hisp2k/parameters/README.md

# Параметрические изделия

Собранные разработки по параметрическим изделиям: модели SolidWorks, интерфейсы, расчётные модули, чертежи, спецификации, исходные данные, протоколы проверок и история доработок. Перенос материалов выполнен 6 октября 2026 года.

| Направление | Материалы и точка продолжения |
|---|---|
| Шнековый транспортёр «Шнек 1», 01.PT.SHT | [Рабочая параметрическая модель и интерфейс](screw-conveyors/01-PT-SHT/deliverables/Шнек%201%20—%20параметрическая%20модель/README.md), исходная сборка, восстановленный CAD, снимки изменений, аудит производственного комплекта |
| Шнековый транспортёр 25.SHT.G | [Контекст и согласованные параметры](screw-conveyors/25-SHT-G/deliverables/Параметризовать%20шнековый%20транспортер%202%20—%20контекст.md), опросный лист, программа, параметризованная копия CAD и исходные модели |
| Плоский ленточный транспортёр ЛТ500 | [Комплект и статус R11](belt-conveyors/flat-LT500/deliverables/Ленточный_транспортер/СТАТУС_КОМПЛЕКТА_ПЛОСКИЙ_R11.txt), расчёты, модели узлов, документы, история R00–R10 и программы построения |
| Желобчатый ленточный транспортёр ЛТ500 | [Точка продолжения R10](belt-conveyors/trough-LT500/deliverables/СТАТУС_ПРОЕКТА_ЖЕЛОБ.txt), отдельная ветка проекта, модель станции, расчёты и архив переноса |
| Параметрическая песколовка | [Техническое задание и журнал проектирования](grit-chambers/parametric/deliverables/Песколовка/GRIT_CHAMBER_CODEX_TASK.md), MASTER-модели, проверки и сценарии SolidWorks |
| Песколовка PT-SHT-10 | [Материалы гидравлики и Flow Simulation](grit-chambers/PT-SHT-10/deliverables), результаты, сценарии осаждения, изображения, модели и архивы |
| Решётки ГР | [Документы и сверки 58.GR](screens/58-GR/README.md), BOM, STEP/BOM-аудит, регламенты и доступные исходники серии ГР |
| Контейнеры | [Проекты 0,75 и 0,22 м³](containers/deliverables), SolidWorks, чертежи PDF, DXF раскроя и программы генерации |
| Общее расчётное ядро | [Программа проверки входов для разных сред](engineering/screw-preflight/README.md), [калькуляторы транспортёров](engineering/transporter-calculators), [SolidWorksCodex и калькулятор](engineering/SolidWorksCodex/README_RU.md) |
| Промпты и регламенты | [Материалы проектирования](docs/prompts-and-regulations), [исходные промпты задач](docs/original-prompts) |

## Как пользоваться

Для каждого изделия сначала прочитайте его README, контекст или файл статуса. В папках `deliverables` находятся сохранённые результаты, в `development` — программы построения, исправления и диагностики. Снимки `snapshots`, архивы и документы прежних ревизий сохраняют историю; актуальное исполнение указано в статусе проекта.

Интерфейс «Шнека 1» запускается командным файлом `Запустить интерфейс.cmd` рядом с его README. Нужны Windows, SolidWorks и Python с `pywin32`. Требования остальных программ указаны в их документации. Пути в исходных скриптах и старых протоколах сохранены: при работе на другом компьютере проверьте настройки путей и ссылки сборок SolidWorks.

В репозиторий перенесены фактически существующие материалы с их текущими инженерными статусами. Некоторые узлы, расчёты и чертежи являются предварительными; ограничения и следующие шаги записаны в исходных документах соответствующего изделия. Импорт не меняет статус готовности к изготовлению и не подтверждает результаты новым расчётом CAD/CFD.

## Большие архивы

Восемь крупных ZIP/RAR сохранены без изменения в папках `.parts`, частями по 16 МиБ. Такое разбиение позволяет обходить ошибки хранилища крупных объектов при загрузке. Для восстановления исходных архивов выполните из корня репозитория:

```powershell
python tools/restore_large_files.py
```

Программа проверяет размеры и SHA-256 частей и готового архива. Восстановленные архивы не нужно повторно добавлять в Git.

## Реестр переноса

[Реестр файлов](docs/import-2026-10-06/files.csv) содержит исходный путь, путь в репозитории, размер и SHA-256 каждого перенесённого файла. [Сводка](docs/import-2026-10-06/summary.json), [описание больших архивов](docs/import-2026-10-06/large-files.json) и [перечень исключённых временных файлов](docs/import-2026-10-06/excluded.json) позволяют проверить состав переноса. Подробности охвата: [примечания к импорту](docs/import-2026-10-06/NOTES.md).
