hisp2k/parameters/screens/58-GR/README.md

# 58.GR — решётка грабельная, заказ №2410 — СМП

**Состояние на 02.10.2026:** исходники и регламент собраны для передачи. Полный комплект КД и производственных документов не выпущен; разрешение к производству не оформлено.

## Навигация

- [Инструкция для следующего чата](ИНСТРУКЦИЯ_ДЛЯ_НОВОГО_ЧАТА.md)
- [Исходники, принятые решения и статус](ИСХОДНИКИ_И_СТАТУС.md)
- [Регламент чертежей и производства, редакция 2.0](Документы/Регламент_чертежи_производство_v2.md)
- [Промт по размерам, базам и сварке](Документы/Промт_размеры_базы_сварка.md)
- [Рабочий промпт STEP + BOM](Документы/Prompt_Chertezhi_STEP_BOM_ESKD.md)
- [Общий регламент ЕСКД от 25.09.2026](Документы/Drawing_AI_Base_Context_RU_20260925.md)
- [BOM(6), исходная таблица](Исходники/58.GR%20BOM%286%29.xlsx)
- [Сверка структуры STEP КТ/ТТ с BOM(6)](Проверки/СВЕРКА_STEP_BOM6_2026-10-02.md)
- [Построчная матрица сопоставления](Проверки/МАТРИЦА_BOM6_STEP_2026-10-02.csv)
- [Предварительный реестр документов](Проверки/РЕЕСТР_ДОКУМЕНТОВ_2026-10-02.csv)
- [Кандидаты для ведомости деталей без чертежей](Проверки/КАНДИДАТЫ_БЕЗ_ЧЕРТЕЖЕЙ_2026-10-02.csv)

STEP КТ, STEP ТТ и исходный RAR перечислены с идентификаторами и ссылками в реестре. Доступные локальные STEP прочитаны для структурной сверки с BOM; геометрия в CAD не проверена. Исходный RAR пока не исследован.

## Правило статуса

Каждый документ учитывать отдельно: требуется, создан, проверен, блокирован или не требуется с основанием. Служебный отчёт, ссылка на исходник и коммит репозитория не заменяют рабочий чертёж, DXF, техпроцесс или утверждение предприятия.
