hisp2k/parameters/engineering/SolidWorksCodex/CLAUDE_HANDOFF.md

# Передача Claude после аудита коннектора

## Актуальная Синхронизация, 16.09.2026

Codex получил шесть коммитов Claude до `503808f` включительно; рабочая ветка та же,
PR #1 открыт в main: https://github.com/hisp2k/SolidWorksCodex/pull/1.
Новое: `sw_set_global_variable`, исправленные Transform2/позиции компонентов,
отчёт Stage 13, шаблон опросного листа/BOM, инженерный черновик и список вопросов.
Начать с актуального раздела PROJECT_STATE.md и TASK.md, а не старых передач ниже.
Повторная автономная проверка полученного EXE: 282 + 88 (Interop) + 78 + 26 PASS.
Живые результаты новых функций взяты из отчётов Claude; здесь CAD не изменялся.
Repo EXE 4470C9A0..., установленный MCP B9570CC9...; установка не обновлялась.
Не переносить автоматически пути G:\Mine из чужого отчёта в локальное разрешение.
Инженерные формулы остаются черновиком; подтверждение и реальные входные данные нужны.

## Последняя Передача: Черновик инженерного ядра для шнекового транспортера (Stage 12)

По прямой просьбе пользователя («начать формализовать самому») составлен ЧЕРНОВОЙ,
НЕ ПРОВЕРЕННЫЙ инженером Тех-Аэро набор формул инженерного ядра для шнекового транспортера
(опросный лист → диаметр/шаг/частота вращения/мощность), поскольку Stage 11 показал, что
готового ядра нигде на связанном компьютере не найдено. Подробности:
`STAGE12_ENGINEERING_CORE_DRAFT_RU.md` в этом репозитории, полный текст с таблицами —
`status-director-pilot-stage12-screw-conveyor-engineering-core-draft.md` в claude.ai Project
`SolidWoksConnetctor`, реализация — `screw_conveyor_core_draft.py` в корне этого репозитория.
Формулы взяты из открытых инженерных источников (не собственность Тех-Аэро), со ссылками в
документе. Проверка на правдоподобие: для типового среднеабразивного случая (5 т/ч) черновик
самостоятельно выбирает диаметр 200 мм — совпадает с фактическим диаметром шнека линейки
25.SHT (реальный заказ №2377). Явно НЕ покрыто: толщина витка/корпуса (нужен прочностной
расчёт), двухвальное исполнение, угол наклона свыше 20°. Требуется подтверждение/калибровка
коэффициентов инженером Тех-Аэро, прежде чем это может стать рабочим ядром.

## Последняя Передача: Найден шаблон опросного листа (Stage 11)

На связанном компьютере в `Downloads` найдены `BOM_модели_и_опросные_листы_транспортеров.xlsx`
и одноимённый zip (созданы позже всех прежних материалов). Подробности:
`STAGE11_QUESTIONNAIRE_TEMPLATE_FOUND_RU.md` в этом репозитории и документ
`status-director-pilot-stage11-questionnaire-template-found.md` в claude.ai Project
`SolidWoksConnetctor`. Коротко: впервые найден именно «опросный лист» для шнекового
транспортера (50 полей, шаблон без заполненных значений) и обобщённая BOM-модель (20 позиций,
без ссылок на `25.SHT.G.*`), а также карта связи опросный лист → инженерное ядро → BOM →
себестоимость. Диаметр/шаг шнека в листе помечены необязательными («пусто = подобрать») —
это подтверждает, что они считаются инженерным ядром, а не задаются заказчиком напрямую.
Сами формулы инженерного ядра НЕ найдены: отдельный калькулятор `transporter_calculator.py`
на этом же компьютере целиком про ленточные/роликовые транспортеры (ГОСТ 22644-77 и др.),
упоминаний шнека там нет. Блокер «нет опросного листа» сузился до «нет формул инженерного
ядра для шнекового транспортера» — это другая по объёму задача.

## Последняя Передача: Обзор реального заказа №2377 (Stage 10)

Пользователь прислал `комплект_подготовки_производства_P1.zip` — реальный производственный
комплект чертежей, включая фактически исполненный заказ `25.SHT - Заказ №2377 Промстрой`.
Подробности: `STAGE10_ORDER_2377_PACKAGE_REVIEW_RU.md` в этом репозитории и документ
`status-director-pilot-stage10-order-2377-package-review.md` в claude.ai Project
`SolidWoksConnetctor`. Коротко: получена полная спецификация (BOM, 42 позиции) сборки
25.SHT.G.00.00.00.00 СБ; закрыты два открытых вопроса Stage 9 (вал — ступенчатый 76/65 мм,
не альтернатива; крышка — ширина 335 мм для обеих модификаций); найдена прямая зависимость
длины резиновой проставки под крышкой от общей длины транспортера (1:1); подтверждено
существование многосекционных сборок (`05.SHT.TR.00.00.00.00`, ~10.9 м) — полная
параметризация по длине потребует работы на уровне сборки (паттерн/массив), не только правки
одного размера в детали. Математическая модель/опросный лист по-прежнему не получены — это
не изменилось.

## Последняя Передача: Полный Параметрический Эксперимент

Начать с SCOPED_PARAMETRIC_EXPERIMENT.md. Сценарий
RUN_SCOPED_PARAMETRIC_EXPERIMENT.ps1 прошёл непрерывно: 4 -> 5 мм, save/reopen,
геометрия двух пластин и 6 сопряжений проверены в копии нативной подсборки.
Финальная перепроверка тем же вариантом: SCOPED_EXPERIMENT_FINAL.json.
Новые команды доступны в EXE репозитория (A7BAA31F...), но не в прежней MCP-установке.
Не перезапускать SolidWorks: коннектор подключается к существующему процессу.
Обычные запреты записи сборок сохраняются. Новое разрешение пользователя покрывает
только зарегистрированную тестовую папку; scoped-команды проверяют все зависимости.
116 исходных CAD-файлов неизменны. Варианты и бэкапы не удалять.
BUILD.cmd: 276 + 81 + 74 + 26; с Interop чтение/STDIO даёт 88 вместо 81.
Следующий шаг определяется реальным опросным листом/формулами. Чертежи, прочность,
коллизии и корневой транспортёр не считать проверенными. Ниже история передач.

## Обновление После Живого Теста Нативной Детали

Сначала читать NATIVE_PART_PILOT.md, TASK.md и PROJECT_STATE.md.
Исправлены IDimension.GetType (swDimensionParamType_e) и JSON Schema Extrusion.
Не возвращать эвристику AI_*/D1 для неизвестных типов. Углы/целые/unknown не длины.
Тесты этой итерации: 263 основных, 81 без Interop / 88 с Interop, 74 write-safety.
Пластина 09.00.00.02 в рабочей копии на Desktop прошла 4 → 5 → 4 мм с двумя save.
Итоговая конфигурация По умолчанию, 4 мм, документ чистый. Другие конфигурации
и чертежи не проверены. Отчёты сохраняют точные инструменты, пути, хэши и бэкапы.
Repo и установленный EXE теперь совпадают (B9570CC9...); старые указания ниже
о разных бинарниках относятся к предыдущей передаче. При Transport closed
переподключить MCP, прочитать новый tools/list; не запускать второй SOLIDWORKS.
Следующий шаг: реальный контракт расчёта/опросного листа, а не ещё один общий аудит.
Бэкап до правок и перед commit/push остаётся обязательным.

Дата: 15.09.2026. Ветка: claude/director-parametric-pilot.
База аудита: cb5c28cb2477e3cf5e089c5d58f8a4247317d4b1.
Точный коммит передачи определяется через git log: этот файл включён в него.

## Перед Работой

1. Прочитай CLAUDE.md, TASK.md, PROJECT_STATE.md, README_RU.md, VALIDATION.md.
2. Проверь git status и fetch. Не перезаписывай чужие изменения.
3. До изменений создай полный проверенный бэкап; перед коммитом/push ещё один.
4. Запусти BUILD.cmd. Ожидаются 262 + 79 + 47 проверок.
   TEST_ASSEMBLY_READ_REGRESSIONS.ps1 с -InteropPath даёт 82 вместо 79.
5. Используй репозиторный SolidWorksLocal.exe. Установленный в
   %LOCALAPPDATA%/SolidWorksCodex EXE остался от cb5c28c.
   Перед обновлением установки нужны её бэкап, отсутствие работающего
   worker и переподключение MCP. Одинаковая версия 2.5.0 не гарантирует
   одинаковый код.

## Закрытые Ошибки

- Неизвестный GetSaveFlag/read-only больше не допускает запись.
- Save3 после изменения не подменяет проверенный документ новым активным.
- Смена документа/конфигурации останавливает изменение и опасный откат.
- Даже явное сохранение чистого документа защищено проверенным бэкапом.
- Ошибка rebuild после изменения свойств блокирует сохранение.
- Размер эскиза/другого элемента не редактируется через выбранный boss.
- Известный угловой AI_* не принимается за миллиметры. Поддержка старого
  code=0 сохранена только для известной линейной схемы коннектора.
- Скрытые параметры варианта ищутся через общий inventory; неполный
  inventory отклоняется. Копия варианта сверяется по SHA-256.
- Таймауты включают mutex ожидание; feature edit и открытие сборки получают
  длинный бюджет. 45/75 секунд меньше текущего MCP tool_timeout_sec=90.

## Проверки

- .NET Framework x64: 262 основных assertions.
- PORTABLE_TEST: 262.
- Чтение сборок, зависимости, STDIO, установленная Interop DLL: 82.
- Write-safety: 47, включая реальные методы workflow на managed doubles:
  бэкап, изменение, сохранение и отказ при смене документа/конфигурации.
- Репозиторный EXE: SHA-256
  3063C60B39670A2D4CFE25058150FB9D00DA4067884836A535464154D2B4BFF7.
- Live нового EXE: status/document/equations, только чтение, API ошибок нет.

## Ограничения

Живое изменение/создание варианта новой сборкой ещё не проверено.
Проверять на отдельной тестовой детали/копии с бэкапом, не на транспортёре.
Проверять значения, конфигурацию, rebuild, тела, объём, файл и бэкап.
Не превращать автономный PASS в утверждение о живом результате.

Не расширять разрешения на сборки, сеть, PDM или произвольные COM-вызовы.
При GUI-смене документа/конфигурации после первого изменения исходная
модель может остаться изменённой в памяти, но не сохраняется и не
переключается обратно. Бэкап остаётся; требуется ручная проверка.
Коннектор не даёт транзакции против параллельного GUI-редактирования.

Полный read-only тест предыдущего cb5c28c: 516 экземпляров, 41 прямая
зависимость, 4 отсутствующих файла по сохранённым путям в «СБ Изм.5».
read_only=true вместе с errors=2 означает частичную, не чистую загрузку.
Не подменять ссылки одноимёнными файлами и не считать их ошибкой кода.

Воспроизведённые этим аудитом ошибки закрыты. Это не доказательство
отсутствия любых дефектов геометрического движка или внешних CAD-файлов.
