hisp2k/parameters/engineering/SolidWorksCodex/STAGE12_ENGINEERING_CORE_DRAFT_RU.md

# Stage 12 — черновик инженерного ядра для шнекового транспортера (D/S/n/N)

Дата: 16.09.2026 (ночь). Ветка: `claude/director-parametric-pilot`. Продолжение Stage 11.
Полный текст с таблицами и обоснованием — в
`status-director-pilot-stage12-screw-conveyor-engineering-core-draft.md` в claude.ai Project
`SolidWoksConnetctor`.

**Статус: черновик, НЕ проверено инженером Тех-Аэро.** Составлено по прямой просьбе
пользователя («начать формализовать самому»), поскольку Stage 11 установил, что готового
инженерного ядра для шнекового транспортера нигде на связанном компьютере не найдено, хотя
карта связи опросный лист → себестоимость помечает этот этап статусом «Готово».

## Источники

Формулы взяты из открытых, общеинженерных источников по расчёту шнековых/винтовых
конвейеров (не собственность Тех-Аэро, публикуются в отраслевых методичках и калькуляторах):

- [Расчёт шнекового транспортера: производительность и мощность](https://bigspiral.ru/raschet-shnekovogo-transportera-proizvoditelnost-diametr-moshhnost/)
- [Расчёт шнекового конвейера — методичка (studfile.net)](https://studfile.net/preview/17025552/page:3/)

## Что реализовано

Файл `screw_conveyor_core_draft.py` (в этом репозитории, без внешних зависимостей). Вход —
поля опросного листа (Stage 11): производительность+единица, насыпная плотность, макс.
размер куска, сортированность, абразивность, рабочая длина, угол наклона, опционально
принудительные диаметр/шаг. Выход — диаметр и шаг шнека (по стандартному ряду 100…800 мм),
частота вращения, мощность на валу и мощность двигателя (округлённая до стандартного
номинала), плюс явные предупреждения при выходе за границы методики (угол наклона >20° и т.п.).

Проверка на правдоподобие: для среднеабразивного продукта, 5 т/ч, без ограничения по
крупности куска, черновик самостоятельно выбирает диаметр 200 мм — совпадает с фактическим
диаметром шнека изделий линейки 25.SHT (Stage 6–10, реальный заказ №2377). Это не доказательство
точности расчёта (проверочные входные данные не взяты из реального опросного листа — он для
заказа №2377 не сохранился), но разумный признак правильного порядка величин.

## Явно НЕ покрыто

- Толщина витка и толщина корпуса (нужен прочностной расчёт: крутящий момент, материал, запас
  прочности — простой публичной формулы не найдено).
- Двухвальное исполнение.
- Угол наклона свыше 20°.
- Стоимость/масса — епархия BOM/справочника цен (Stage 11), не этого ядра.

## Что нужно от Тех-Аэро

1. Подтвердить/скорректировать коэффициенты (ψ, E, ω, A, K) — они общеотраслевые, не
   калиброваны под материалы Тех-Аэро.
2. Дать методику или проверенные значения толщины витка/корпуса.
3. Подтвердить, не существует ли уже настоящее инженерное ядро в другом месте — этот
   черновик не должен его подменять, если оно найдётся.
