hisp2k/parameters/engineering/SolidWorksCodex/calculator/STAGE14_REVIEW_RU.md

# Проверка этапа 14 — продолжение Issue #3

Проверен diff a3a85ca относительно 166221c. Исходные 243 теста проходят,
но они не проверяли связь нового списка прочностных проверок с допуском.

Исправлено корректировщиком:
- item_is_closed/release gate учитывают каждую обязательную проверку узла;
  одна старая verification не закрывает все проверки. Неопределённый каталог,
  плейсхолдер BOM и пустой реестр не считаются подтверждённой прочностью.
- BOM с отсутствующим обозначением/классом или источником «план» отклоняется
  целиком, вместо молчаливого исключения непроверенных позиций.
- VerificationRecord отклоняет NaN, бесконечность, строки и bool как числа.
- resolved=True у методики проверяется по числовым результатам и выполнению
  требований. Незавершённая методика не публикует числа. Это проверка
  программного контракта, а не подтверждение инженерной методики.
- При изменении анкеты/CAD аннулируется новый список verifications.
- Заглушка BOM сообщает «чтение не реализовано» и не заявляет, что модель
  отсутствует: она не проверяла наличие модели.

## Следующее ограниченное задание Claude

В этой же ветке связать TubeMethodology с реальным конвейером приложения.
Сейчас параметр methodology существует только у функции ядра; create_project /
recompute_and_save его не передают, Project переносит лишь часть результатов,
а release_gate безусловно пишет BLOCKED для любого трубного результата.
Отдельный опросный лист вызывается только тестами, не пользовательским потоком.

1. Добавить явное подключение методики через конфигурацию приложения и Python API;
   по умолчанию сохранить UnconfirmedTubeMethodology и девять блокеров эскиза.
2. Передавать результаты с источником/версией в Project и видимый лист/экспорт.
   Учитывать действительный статус расчёта в gate, сохранив независимые блокировки
   CAD, BOM, прочности, привода, технологии и согласований.
3. Проверить весь путь тестовой методикой: валидный результат, незавершённый,
   невалидный и изменение анкеты. Тестовые числа не сохранять в TUBE-SAND-001.

Дальнейшая очередь: фактический reader BOM вместо заглушки; привязка реестра
к конфигурации/ревизии BOM; разделение вида проверки (изгиб, ресурс и т.п.)
и режима нагружения (работа, пуск, перегрузка, транспортировка). Дополнить
каталог для креплений привода и остальных применимых узлов. Для ресурса L10
нужен явный критерий «не менее» либо документированная нормировка: нынешний
VerificationRecord поддерживает только result <= limit. Это пока открытый пункт.

Данные заказчика и подтверждённая методика нужны для реального расчёта;
они не мешают выполнить следующий программный шаг. CAD из этой среды
не проверялся. Действующая методика 35° не добавлялась. main и исходные
CAD-документы не изменять; существующий TUBE-SAND-001 не перезаписывать.
