hisp2k/parameters/grit-chambers/parametric/deliverables/Песколовка/GRIT_CHAMBER_CODEX_TASK.md

# GRIT_CHAMBER_CODEX_TASK.md

## Параметрическое проектирование песколовки через Codex + SolidWorks + Flow Simulation

---

# 0. НАЗНАЧЕНИЕ ЭТОГО ФАЙЛА

Этот Markdown-файл является одновременно:

1. техническим заданием для Codex;
2. исполняемым чек-листом;
3. журналом фактически выполненных операций;
4. журналом перестроений SolidWorks;
5. журналом Flow Simulation;
6. журналом Particle Study;
7. итоговым расчётным отчётом;
8. реестром созданных файлов;
9. реестром ошибок и ограничений;
10. точкой продолжения работы в следующих сессиях Codex.

**Codex обязан обновлять именно этот файл по мере выполнения работы.**

Не создавать отдельный текстовый отчёт вместо заполнения этого файла.

После каждого законченного этапа:

- обновлять статус этапа;
- записывать фактический результат;
- сохранять пути созданных файлов;
- фиксировать ошибки;
- фиксировать UNKNOWN;
- фиксировать CAPABILITY_GAP;
- фиксировать фактические результаты расчётов.

Сам файл должен оставаться пригодным для повторного запуска Codex.

---

# 1. ГЛАВНАЯ КОМАНДА CODEX

Используя подключённый SolidWorks-коннектор:

**фактически построить новую параметрическую модель компактной песколовки, выполнить доступные инженерные проверки и SOLIDWORKS Flow Simulation, сохранить созданные модели и результаты симуляции, а затем записать фактические результаты выполнения в этот же Markdown-файл.**

Не ограничиваться:

- рекомендациями;
- описанием действий;
- созданием нового промпта;
- созданием ещё одного TASK.md;
- псевдокодом;
- расчётом без построения модели.

Если операция поддерживается коннектором — выполнить её.

---

# 2. РАБОЧИЙ РЕЖИМ

Использовать:

`Codex -> SolidWorks Connector -> New Workspace Files`

Существующие пользовательские файлы не изменять.

Не изменять:

- существующие SLDPRT;
- существующие SLDASM;
- существующие SLDDRW;
- PDM;
- производственные проекты;
- активный пользовательский документ.

Создавать только новые файлы в отдельной рабочей папке проекта песколовки.

---

# 3. СТАТУС ПРОЕКТА

Текущий статус:

`DESIGN / PILOT`

Производственный статус:

`manufacturing_approved = false`

Не менять на `true` без отдельной команды пользователя.

---

# 4. ИСХОДНЫЕ ДАННЫЕ

## 4.1 Расход

Пиковый расход:

`Q_PEAK = 0.006 m3/s`

или:

`Q_PEAK = 6 l/s`

Исходное условие:

`60 литров за 10 секунд`

Суточное поступление:

`до 10 m3/day`

---

## 4.2 Среда

Базовая среда:

`сточная вода`

Для первого расчёта свойств жидкости принять:

`вода 20 °C`

Если фактические свойства сточной воды неизвестны:

`WASTEWATER_PROPERTIES = UNKNOWN`

---

## 4.3 Песок

Расчётная плотность минеральной частицы:

`RHO_PARTICLE = 2650 kg/m3`

Целевая фракция:

`D_TARGET = 0.20 mm`

Дополнительно проверить:

- 0.10 мм;
- 0.15 мм;
- 0.20 мм;
- 0.30 мм;
- 0.50 мм.

Целевая расчётная эффективность:

`ETA_0_20 >= 70 %`

---

# 5. БАЗОВАЯ ГЕОМЕТРИЯ

Базовая конфигурация:

`BASE_700x900`

Параметры:

`B_BATH = 700 mm`

`L_SETTLE = 900 mm`

`L_INLET = 250 mm`

`L_OUTLET = 200 mm`

`L_BATH = 1350 mm`

`H_WATER = 550 mm`

`H_FREEBOARD = 200 mm`

`H_BATH = 750 mm`

`W_WEIR = 600 mm`

Вход:

`DN100`

---

# 6. КОНТРОЛЬНЫЕ ЗНАЧЕНИЯ

Площадь осаждения:

`A_SETTLE = 0.700 x 0.900 = 0.630 m2`

Рабочий объём:

`V_SETTLE = 0.630 x 0.550 = 0.3465 m3`

Расчётное время пребывания при пиковом расходе:

`T_PEAK ~= 57.8 s`

После построения модели сравнить фактические расчётные параметры с этими значениями.

---

# 7. ТРИ ОБЯЗАТЕЛЬНЫЕ КОНФИГУРАЦИИ

## CONFIG_01

`BASE_700x900`

- B = 700 мм
- L_SETTLE = 900 мм
- A ~= 0.630 м²

## CONFIG_02

`NARROW_600x1050`

- B = 600 мм
- L_SETTLE = 1050 мм
- A ~= 0.630 м²

## CONFIG_03

`SHORT_WIDE_800x800`

- B = 800 мм
- L_SETTLE = 800 мм
- A ~= 0.640 м²

Все три конфигурации должны использовать один MASTER/Skeleton.

---

# 8. АРХИТЕКТУРА ПАРАМЕТРИЧЕСКОЙ МОДЕЛИ

Использовать:

`INPUTS`

→ `CALC`

→ `MASTER/SKELETON`

→ `BATH`

→ `INLET`

→ `HYDRAULIC BAFFLES`

→ `SEDIMENT ZONE`

→ `SCREW TROUGH`

→ `SCREW`

→ `DISCHARGE`

→ `FRAME`

→ `CONFIGURATIONS`

→ `VALIDATION`

→ `FLOW SIMULATION`

Не допускать циклических зависимостей.

Локальная геометрия не должна управлять MASTER.

---

# 9. ГЛОБАЛЬНЫЕ ПЕРЕМЕННЫЕ

Создать минимум:

`AI_Q_Peak`

`AI_B_Bath`

`AI_L_Settle`

`AI_L_Inlet`

`AI_L_Outlet`

`AI_L_Bath`

`AI_H_Water`

`AI_H_Freeboard`

`AI_H_Bath`

`AI_Shell_Thickness`

`AI_Inlet_DN`

`AI_Weir_Width`

`AI_Inlet_Baffle_Offset`

`AI_Distributor_Open_Area`

`AI_Distributor_Hole_Dia`

`AI_Distributor_Blind_Zone`

`AI_Outlet_Baffle_Depth`

`AI_Screw_Diameter`

`AI_Screw_Pitch`

`AI_Screw_Angle`

`AI_Screw_Rpm`

`AI_Screw_Clearance`

`AI_Liner_Thickness`

`AI_Discharge_Height`

`AI_Frame_Height`

При необходимости добавлять другие параметры с понятными именами.

---

# 10. МАТЕРИАЛ

Базовый корпус:

`AISI 304`

Толщина корпуса:

`2.0 mm`

Крышки:

`1.5-2.0 mm`

Толщина должна оставаться параметром.

---

# 11. ВХОД

Вход:

`DN100`

Струя не должна быть направлена:

- непосредственно в пескосборную зону;
- непосредственно на шнек;
- вдоль дна;
- прямо на перелив.

---

# 12. ВХОДНОЙ ГАСИТЕЛЬ

Создать экран/гаситель после входного патрубка.

Исходный диапазон:

`100-150 mm`

от входа.

Положение параметризовать.

---

# 13. РАСПРЕДЕЛИТЕЛЬНЫЙ ЭКРАН

Исходное положение:

приблизительно после входной зоны.

Начальный ориентир:

`X ~= 250 mm`

Экран на всю рабочую ширину.

Диаметр отверстий:

`20-25 mm`

Свободное сечение:

`25-30 %`

Нижняя неперфорированная зона:

`100-120 mm`

Рассчитывать автоматически:

- количество отверстий;
- шаг;
- свободное сечение;
- число рядов;
- число колонок.

---

# 14. ВЫХОДНАЯ ПЕРЕГОРОДКА

Перед переливом создать погружную перегородку.

Цель:

- уменьшить короткое замыкание потока;
- уменьшить вынос песка;
- сформировать равномерный выходной поток.

Глубина:

`AI_Outlet_Baffle_Depth`

---

# 15. ПЕСКОСБОРНАЯ ЗОНА

Днище должно направлять осадок к шнеку.

Не создавать:

- обратных уклонов;
- закрытых карманов;
- горизонтальных зон накопления;
- зон, недоступных для очистки.

---

# 16. ШНЕК

Использовать:

`D_SCREW = 100 mm`

`P_SCREW = 100 mm`

`ALPHA_SCREW = 30 deg`

Допустимый диапазон:

`28-32 deg`

Номинальная скорость:

`N_SCREW = 15 rpm`

Рабочий диапазон:

`10-20 rpm`

Базовый привод:

`0.75 kW`

с частотным регулированием.

Основная версия:

`shaftless screw`

Привод:

`верхний`

---

# 17. БЕЗВАЛЬНЫЙ ШНЕК

Не устанавливать нижний погружной подшипник.

Создать:

- желоб;
- сменный износостойкий вкладыш;
- рабочий зазор;
- зону демонтажа;
- переход к сухой части;
- выгрузочную горловину.

---

# 18. ГЕОМЕТРИЯ ШНЕКА

Если коннектор поддерживает:

- Helix/Spiral;
- Sweep;
- управляемую винтовую геометрию;

создать реальный шнек.

Если нет:

зафиксировать:

`CAPABILITY_GAP_SCREW_GEOMETRY`

и создать минимум:

- ось;
- наружную огибающую;
- желоб;
- технологический зазор;
- интерфейс привода;
- выгрузку.

---

# 19. ВЫГРУЗКА

Создать:

`AI_Discharge_Height`

Выгрузка должна находиться выше уровня воды.

Предусмотреть:

- дренирование;
- переход мокрой части в сухую;
- выгрузочную горловину;
- сервисный доступ.

---

# 20. РАМА

Создать параметрическую опорную раму.

Нагрузка не должна передаваться только через тонкий лист корпуса.

Предусмотреть:

- основные опоры;
- усиления;
- опору привода;
- точки крепления к основанию.

---

# 21. PHASE A — ПРОВЕРКА SOLIDWORKS

Codex обязан сначала записать ниже фактический результат.

## RESULT — SOLIDWORKS CONNECTION

`STATUS = CONNECTED`

`SOLIDWORKS_CONNECTED = true`

`ACTIVE_DOCUMENT = NONE_OBSERVED`

`WRITE_TOOLS = VERIFIED_TYPED_COM_API`

`FLOW_SIMULATION_AVAILABLE = ADDIN_AND_COM_API_VERIFIED_PROJECT_NOT_CREATED`

`PARTICLE_STUDY_AVAILABLE = API_INTERFACE_FOUND_STUDY_NOT_RUN`

Проверка 2026-10-03: среди доступных инструментов текущей сессии нет SolidWorks-коннектора. Локально установлен `C:\Program Files\SOLIDWORKS Corp\SOLIDWORKS\sldworks.exe` и зарегистрирован COM ProgID `SldWorks.Application` (SOLIDWORKS 2026). Первоначальный динамический вызов COM в PowerShell завершался `TYPE_E_ELEMENTNOTFOUND (0x8002802B)`. Повторное подключение 2026-10-03 выполнено через типизированный интерфейс `SolidWorks.Interop.sldworks.ISldWorks`: фактически получены `RevisionNumber() = 34.3.2`, `ActiveDoc = NONE`, путь шаблона детали `~BLANK_PART_TEMPLATE.prtdot`. Окно SOLIDWORKS Design Premium 2026 SP3.2 запущено. Методы создания, сохранения, построения элементов и полного перестроения проверены на новых файлах проекта. Надстройка Flow Simulation загружена (`LoadAddIn = 2`, уже загружена), но создание CFD-проекта и Particle Study не проверены. Пользовательский документ не открывался и не изменялся.

После проверки заменить UNKNOWN фактическими значениями.

---

# 22. PHASE B — СОЗДАНИЕ CAD

Выполнено в новых файлах пилотной модели:

- [x] создать новый проект;
- [x] создать MASTER/Skeleton: 25 глобальных переменных и три конфигурации;
- [x] построить ванну 2 мм;
- [x] построить два поперечных уклона пескосборной зоны;
- [x] создать входное отверстие Ø100 мм;
- [x] создать входной гаситель;
- [x] создать распределительный экран Ø22 мм с проверенным числом отверстий;
- [x] создать выходную погружную перегородку;
- [x] создать переливную стенку и выходной проём шириной 600 мм;
- [ ] создать полноценный сменный желоб шнека;
- [x] создать ось 30°, винтовой круглый профиль Ø100 мм по наружному размеру с шагом 100 мм и трубчатый кожух ID110/OD120 мм;
- [ ] создать реальную винтовую лопасть безвального шнека;
- [ ] создать разгрузочную горловину, уплотнения, привод и сервисный доступ;
- [x] создать пилотную раму: 4 стойки, продольные и поперечные балки, 4 опорные площадки;
- [x] создать три конфигурации MASTER; детальная геометрия сохранена в отдельных производных файлах для каждого выбранного размера.

Внутренние элементы производных файлов построены по размерам соответствующей конфигурации, но не связаны уравнениями с переменными MASTER. Переключение конфигурации внутри одного производного файла не является проверенным способом получить другой детальный вариант. Полноценная параметрическая сборка остаётся `NOT_CREATED`.
---

# 23. REBUILD

По каждой конфигурации выполнить полный rebuild.

Заполнить:

| Configuration | Rebuild | Errors | Warnings |
|---|---|---|---|
| BASE_700x900 | PASS для выбранной конфигурации пилотного CAD | 0 | 0 |
| NARROW_600x1050 | PASS для выбранной конфигурации пилотного CAD | 0 | 0 |
| SHORT_WIDE_800x800 | PASS для выбранной конфигурации пилотного CAD | 0 | 0 |

Допустимые статусы:

`PASS`

`FAIL`

Нельзя записывать PASS без фактического rebuild.

---

# 24. ГЕОМЕТРИЧЕСКИЕ ПРОВЕРКИ

## GEOMETRY VALIDATION RESULTS — 2026-10-03

`STATUS = PARTIAL_PASS_PILOT_GEOMETRY`

Каждый из трёх итоговых производных файлов открыт повторно, перестроен и сохранён с `Save3`: коды ошибок и предупреждений элементов равны 0. Экран имеет соответственно 255, 210 и 285 отверстий Ø22 мм; подтверждено количеством сегментов эскиза 259/214/289 и количеством граней экранного тела 261/216/291. Поперечные экраны находятся при X=0.125 и 0.250 м, выходная перегородка при X=L_BATH−0.22 м. Два уклона направлены к центральной зоне шириной 140 мм.

Объёмные пересечения наружной огибающей шнека с остальными телами проверены операцией `IBody2.Operations2(SWBODYINTERSECT)` в каждой выбранной конфигурации: 0 пересечений, суммарный объём 0 м³. Проход Ø120 мм вырезан через выходную перегородку и переливную стенку; установлен отдельный трубчатый кожух ID110/OD120 мм. Это не подтверждает герметичность стыков, зазоры при вращении, прочность, доступность демонтажа и работу реального винтового пера.

Незакрытые проверки: фактический свободный борт при течении, геометрия и доступность желоба, уплотнения и привод, анкеровка рамы, нагрузка на листовой корпус, внешние присоединения, коллизии реальной винтовой лопасти, герметичность для CFD. Производственные чертежи и сборка не создавались.
---

# 25. АНАЛИТИЧЕСКАЯ ГИДРАВЛИКА

Для каждой конфигурации рассчитать:

`A_SETTLE`

`V_WORK`

`T_THEORETICAL`

`Q/A`

Среднюю скорость в основной зоне.

Скорость:

- на входе;
- через распределительный экран;
- под выходной перегородкой;
- на переливе.

---

## ANALYTICAL HYDRAULICS — фактически рассчитано 2026-10-03

Принято: `Q = 0.006 m³/s`, прямоугольная зона шириной `B` и глубиной `H_WATER = 0.55 m`; указанные значения относятся только к идеализированной основной зоне. Для полной ванны с днищем, экранами и шнеком рабочий объём пока неизвестен.

| Конфигурация | A_SETTLE, m² | V_WORK, m³ | T_THEORETICAL, s | Q/A, m/s | Q/(B·H), m/s |
|---|---:|---:|---:|---:|---:|
| BASE_700x900 | 0.630 | 0.3465 | 57.75 | 0.009524 | 0.01558 |
| NARROW_600x1050 | 0.630 | 0.3465 | 57.75 | 0.009524 | 0.01818 |
| SHORT_WIDE_800x800 | 0.640 | 0.3520 | 58.67 | 0.009375 | 0.01364 |

При условном внутреннем диаметре входа ровно 100 мм: `V_INLET = 4Q/(πD²) = 0.764 m/s`. Обозначение DN100 не задаёт фактический внутренний диаметр, поэтому это только ориентир. Удельный расход через перелив шириной 0.6 м: `Q/W = 0.0100 m²/s`; скорость воды на переливе без глубины потока вычислить нельзя. Скорости через распределительный экран и под выходной перегородкой `UNKNOWN`, поскольку их фактические площади и нижний просвет не заданы и CAD не построен.

Контроль исходных значений раздела 6 пройден **только арифметически**: `A = 0.630 m²`, `V = 0.3465 m³`, `T = 57.75 s ≈ 57.8 s`.

### Геометрия распределительного экрана пилотного CAD

Отверстия имеют диаметр 22 мм, 15 рядов. Доля свободного сечения рассчитана относительно погруженной части экрана шириной `B−0.06` и высотой `0.55−0.002` м; это **геометрическая**, а не гидродинамическая величина.

| Конфигурация | Отверстий | Открытая площадь, м² | Доля, % | Q/открытая площадь, м/с |
|---|---:|---:|---:|---:|
| BASE_700x900 | 255 | 0.096934 | 27.64 | 0.06190 |
| NARROW_600x1050 | 210 | 0.079828 | 26.98 | 0.07516 |
| SHORT_WIDE_800x800 | 285 | 0.108338 | 26.72 | 0.05538 |

Переливной проём имеет геометрическую ширину 0.600 м и нижнюю кромку на высоте 0.550 м. Без решения свободной поверхности нельзя определить действительную скорость через него, уровень воды, время пребывания и эффективность улавливания. Пилотные уклоны занимают часть номинального объёма, поэтому значения `V_WORK` и `T_THEORETICAL` выше остаются расчётом **исходной прямоугольной зоны**, а не измерением готовой модели.

---

# 26. ПРЕДВАРИТЕЛЬНОЕ ОСАЖДЕНИЕ

Рассчитать скорость осаждения для:

- 0.10 мм;
- 0.15 мм;
- 0.20 мм;
- 0.30 мм;
- 0.50 мм.

Не применять закон Стокса за пределами его области применимости без проверки Reynolds.

Записать:

| d, mm | Re particle | Settling velocity | Analytical eta |
|---:|---:|---:|---:|
| 0.10 | | | |
| 0.15 | | | |
| 0.20 | | | |
| 0.30 | | | |
| 0.50 | | | |

---

## SETTLING CALCULATION — фактически рассчитано 2026-10-03

Исходные свойства **чистой воды 20 °C**: `ρ = 998.2 kg/m³`, `μ = 0.001002 Pa·s`; частица принята сферической, `ρp = 2650 kg/m³`, `g = 9.81 m/s²`. Скорость найдена итерационно из баланса веса с учётом плавучести и сопротивления, `Re = ρvd/μ`, `Cd = 24/Re · (1 + 0.15 Re^0.687)` при `Re < 1000`. Формула Стокса без поправки не применялась. Источники модели и свойств: [NIST — свойства жидкостей](https://webbook.nist.gov/chemistry/fluid/), [IAPWS — вязкость воды](https://www.iapws.org/relguide/viscosity.html), [публикация с корреляцией Schiller–Naumann](https://www.cambridge.org/core/journals/journal-of-fluid-mechanics/article/new-paradigm-for-computing-hydrodynamic-forces-on-particles-in-eulerlagrange-pointparticle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).

`Analytical eta = min(100%, v_settle/(Q/A)·100%)` — предельная оценка идеального отстойника по площади, **не прогноз реальной эффективности песколовки**. Турбулентность, короткий путь, форма зерна, промывка и вторичный вынос не учтены.

| d, mm | Re particle | Settling velocity, m/s | Ideal eta BASE/NARROW | Ideal eta SHORT_WIDE |
|---:|---:|---:|---:|---:|
| 0.10 | 0.793 | 0.00797 | 83.6% | 85.0% |
| 0.15 | 2.375 | 0.01590 | 100% | 100% |
| 0.20 | 4.940 | 0.02479 | 100% | 100% |
| 0.30 | 12.922 | 0.04324 | 100% | 100% |
| 0.50 | 39.096 | 0.07849 | 100% | 100% |

`ETA_0_20 >= 70%` фактически **не подтверждена**: Particle Study и CFD не запускались.

---

# 27. PHASE C — SOLIDWORKS FLOW SIMULATION

После успешного CAD выполнить реальную Flow Simulation, если модуль доступен через коннектор.

Если недоступен:

`CAPABILITY_GAP_FLOW_SIMULATION`

и не выдавать аналитический расчёт за CFD.

---

# 28. CFD ТИП РАСЧЁТА

Использовать, если технически поддерживается:

- internal flow;
- water;
- air;
- gravity;
- free surface;
- transient calculation.

Расчёт должен учитывать заполнение ванны водой с газовой зоной над поверхностью.

---

# 29. ГРАВИТАЦИЯ

Использовать:

`g = 9.81 m/s2`

Направление проверить относительно системы координат модели.

---

# 30. НАЧАЛЬНЫЙ УРОВЕНЬ

Исходно:

`H_WATER = 550 mm`

Над водой:

`air`

Начальная свободная поверхность:

горизонтальная.

---

# 31. CFD CASE 01

Постоянный расчётный расход:

`Q_IN = 6 l/s`

Выполнить нестационарный расчёт до устойчивого или квазистационарного режима.

---

# 32. CFD CASE 02

Отдельный импульсный сценарий:

`6 l/s`

продолжительностью:

`10 s`

Общий объём:

`60 l`

Если фоновый поток неизвестен:

`Q_BACKGROUND = UNKNOWN`

Не выдумывать его.

---

# 33. ВЫХОД

Использовать физически корректную открытую/атмосферную выходную границу через перелив.

Если требуется downstream level и он неизвестен:

`REQUIRED_DOWNSTREAM_LEVEL`

---

# 34. CFD MESH

Создать минимум:

`MESH_COARSE`

`MESH_MEDIUM`

`MESH_FINE`

Сгущение сетки выполнить около:

- входа;
- гасителя;
- отверстий распределительного экрана;
- днища;
- желоба;
- выходной перегородки;
- перелива.

---

# 35. СЕТОЧНАЯ НЕЗАВИСИМОСТЬ

Сравнить MEDIUM и FINE.

По возможности контролировать:

- уровень воды;
- Q_out;
- среднюю скорость;
- Vmax около днища;
- потерю напора.

Ориентировочный критерий:

`delta <= 5 %`

Если нет:

`MESH_NOT_CONVERGED`

---

# 36. МАССОВЫЙ БАЛАНС

Сравнить:

`Q_IN`

и:

`Q_OUT`

Ориентировочный критерий:

`difference <= 2 %`

Если выше:

`MASS_BALANCE_WARNING`

---

# 37. КОНТРОЛЬНЫЕ СЕЧЕНИЯ

Создать:

`S1_INLET`

`S2_AFTER_INLET_BAFFLE`

`S3_AFTER_DISTRIBUTOR`

`S4_SETTLING_ZONE`

`S5_BEFORE_OUTLET_BAFFLE`

`S6_UNDER_OUTLET_BAFFLE`

`S7_WEIR`

Для каждого записать:

- Area;
- Q;
- Vavg;
- Vmax;
- Pressure.

---

# 38. РЕЗУЛЬТАТЫ CFD

Получить:

- поле скоростей;
- векторное поле;
- давление;
- свободную поверхность;
- зоны рециркуляции;
- области высокой скорости возле днища;
- зоны малого времени пребывания;
- Flow Trajectories.

---

# 39. ПРОВЕРКА КОРОТКОГО ПУТИ

Проверить прямой путь:

`INLET -> OUTLET`

Если выражен:

`HYDRAULIC_SHORT_CIRCUIT_WARNING`

Записать описание и конфигурацию.

---

# 40. PARTICLE STUDY

Если доступно через текущий SolidWorks-коннектор — выполнить.

Плотность:

`2650 kg/m3`

Размеры:

- 0.10 мм
- 0.15 мм
- 0.20 мм
- 0.30 мм
- 0.50 мм

Частицы вводить через входное сечение распределённо.

Не выпускать все частицы из одной точки.

---

# 41. КОЛИЧЕСТВО ЧАСТИЦ

Исходно стремиться использовать:

`N >= 1000`

частиц на фракцию, если вычислительные возможности позволяют.

Для 0.20 мм проверить чувствительность результата к числу частиц.

---

# 42. КЛАССИФИКАЦИЯ PARTICLE RESULTS

Использовать:

`CAPTURED`

`ESCAPED`

`REMAINING`

Не считать любое столкновение со стенкой автоматически успешным улавливанием.

---

# 43. РАСЧЁТ CFD ЭФФЕКТИВНОСТИ

Для каждой фракции:

`ETA = N_CAPTURED / N_INJECTED * 100 %`

Целевой критерий:

`ETA_0_20 >= 70 %`

Результат обозначать:

`CFD_PARTICLE_ESTIMATE`

а не:

`PHYSICAL_TEST_CONFIRMED`

---

# 44. ОБЯЗАТЕЛЬНАЯ СИМУЛЯЦИЯ ВСЕХ КОНФИГУРАЦИЙ

Выполнить одинаковую методологию для:

- BASE_700x900
- NARROW_600x1050
- SHORT_WIDE_800x800

---

# 45. СРАВНИТЕЛЬНАЯ ТАБЛИЦА

Заполнить после расчёта:

| Parameter | BASE | NARROW | SHORT_WIDE |
|---|---:|---:|---:|
| A_settle, m2 | 0.630 analytical | 0.630 analytical | 0.640 analytical |
| V, m3 | 0.3465 analytical | 0.3465 analytical | 0.3520 analytical |
| T theoretical, s | 57.75 | 57.75 | 58.67 |
| Q/A, m/s | 0.009524 | 0.009524 | 0.009375 |
| Vavg settling zone, m/s | 0.01558 analytical | 0.01818 analytical | 0.01364 analytical |
| Vmax bottom | NOT_RUN | NOT_RUN | NOT_RUN |
| Max water level | NOT_RUN | NOT_RUN | NOT_RUN |
| Min freeboard | NOT_RUN | NOT_RUN | NOT_RUN |
| Pressure loss | NOT_RUN | NOT_RUN | NOT_RUN |
| eta 0.10 | NOT_RUN | NOT_RUN | NOT_RUN |
| eta 0.15 | NOT_RUN | NOT_RUN | NOT_RUN |
| eta 0.20 | NOT_RUN | NOT_RUN | NOT_RUN |
| eta 0.30 | NOT_RUN | NOT_RUN | NOT_RUN |
| eta 0.50 | NOT_RUN | NOT_RUN | NOT_RUN |
| Short circuit | NOT_RUN | NOT_RUN | NOT_RUN |
| Mesh convergence | NOT_RUN | NOT_RUN | NOT_RUN |
| Mass balance | NOT_RUN | NOT_RUN | NOT_RUN |

---

# 46. ОПТИМИЗАЦИЯ

Если:

`ETA_0_20 < 70 %`

или:

`HYDRAULIC_SHORT_CIRCUIT_WARNING`

проводить итерации в порядке:

1. L_SETTLE;
2. B_BATH;
3. положение входного гасителя;
4. положение распределительного экрана;
5. свободное сечение экрана;
6. диаметр отверстий;
7. глубина выходной перегородки;
8. ширина перелива;
9. форма пескосборной зоны;
10. общий объём.

После каждой итерации:

`REBUILD -> CFD -> PARTICLE STUDY -> COMPARE`

---

# 47. СОХРАНЕНИЕ СИМУЛЯЦИИ

Сохранить физические файлы проекта Flow Simulation в папке проекта.

Создать структуру, например:

`/Песколовка/01_CAD/`

`/Песколовка/02_FlowSimulation/BASE_700x900/`

`/Песколовка/02_FlowSimulation/NARROW_600x1050/`

`/Песколовка/02_FlowSimulation/SHORT_WIDE_800x800/`

`/Песколовка/03_Результаты/`

`/Песколовка/04_Анимации/`

`/Песколовка/05_Отчеты/`

---

# 48. СОХРАНЕНИЕ СИМУЛЯЦИИ В ЭТОМ MD

Бинарные файлы SOLIDWORKS/Flow Simulation физически не встраивать в Markdown.

Но **в этот файл обязательно записать полное состояние симуляции, достаточное для аудита и повторного запуска**.

Для каждой конфигурации записать:

- имя проекта;
- путь к CAD;
- путь к CFD-проекту;
- дату/версию расчёта;
- тип анализа;
- выбранные жидкости;
- гравитацию;
- начальный уровень воды;
- граничные условия;
- параметры входа;
- параметры выхода;
- mesh settings;
- local mesh settings;
- solver settings;
- физические модели;
- расчётное время;
- convergence status;
- Q_in;
- Q_out;
- mass balance;
- основные результаты;
- particle settings;
- particle count;
- particle efficiency;
- предупреждения;
- пути к изображениям;
- пути к анимациям;
- пути к экспортированным данным.

Таким образом этот `.md` является текстовым слепком симуляции.

---

# 49. CFD RECORD — BASE_700x900

Codex должен заполнить:

`STATUS = NOT_RUN_PILOT_CAD_AND_BC_INCOMPLETE`

`CAD_FILE = C:\Users\adm\Documents\Codex\2026-10-03\new-chat\outputs\grit_chamber\01_CAD\GRIT_PILOT_BASE_CAD_20261003.SLDPRT`

`CFD_PROJECT = NOT_AVAILABLE_NO_CFD_RUN`

`FLOW_TYPE = NOT_AVAILABLE_NO_CFD_RUN`

`FLUIDS = NOT_AVAILABLE_NO_CFD_RUN`

`GRAVITY = NOT_AVAILABLE_NO_CFD_RUN`

`FREE_SURFACE = NOT_AVAILABLE_NO_CFD_RUN`

`TRANSIENT = NOT_AVAILABLE_NO_CFD_RUN`

`Q_IN = NOT_AVAILABLE_NO_CFD_RUN`

`OUTLET_BC = NOT_AVAILABLE_NO_CFD_RUN`

`INITIAL_WATER_LEVEL = NOT_AVAILABLE_NO_CFD_RUN`

`MESH = NOT_AVAILABLE_NO_CFD_RUN`

`LOCAL_MESH = NOT_AVAILABLE_NO_CFD_RUN`

`SOLVER_STATUS = NOT_AVAILABLE_NO_CFD_RUN`

`Q_OUT = NOT_AVAILABLE_NO_CFD_RUN`

`MASS_BALANCE = NOT_AVAILABLE_NO_CFD_RUN`

`VAVG_SETTLING = NOT_AVAILABLE_NO_CFD_RUN`

`VMAX_BOTTOM = NOT_AVAILABLE_NO_CFD_RUN`

`MAX_WATER_LEVEL = NOT_AVAILABLE_NO_CFD_RUN`

`MIN_FREEBOARD = NOT_AVAILABLE_NO_CFD_RUN`

`PRESSURE_LOSS = NOT_AVAILABLE_NO_CFD_RUN`

`SHORT_CIRCUIT = NOT_AVAILABLE_NO_CFD_RUN`

`ETA_0_20 = NOT_AVAILABLE_NO_CFD_RUN`

`IMAGE_PATHS = NOT_AVAILABLE_NO_CFD_RUN`

`ANIMATION_PATHS = NOT_AVAILABLE_NO_CFD_RUN`

---

# 50. CFD RECORD — NARROW_600x1050

`STATUS = NOT_RUN_PILOT_CAD_AND_BC_INCOMPLETE`

`CAD_FILE = C:\Users\adm\Documents\Codex\2026-10-03\new-chat\outputs\grit_chamber\01_CAD\GRIT_PILOT_NARROW_CAD_20261003.SLDPRT`

`CFD_PROJECT = NOT_AVAILABLE_NO_CFD_RUN`

`FLOW_TYPE = NOT_AVAILABLE_NO_CFD_RUN`

`FLUIDS = NOT_AVAILABLE_NO_CFD_RUN`

`GRAVITY = NOT_AVAILABLE_NO_CFD_RUN`

`FREE_SURFACE = NOT_AVAILABLE_NO_CFD_RUN`

`TRANSIENT = NOT_AVAILABLE_NO_CFD_RUN`

`Q_IN = NOT_AVAILABLE_NO_CFD_RUN`

`OUTLET_BC = NOT_AVAILABLE_NO_CFD_RUN`

`INITIAL_WATER_LEVEL = NOT_AVAILABLE_NO_CFD_RUN`

`MESH = NOT_AVAILABLE_NO_CFD_RUN`

`LOCAL_MESH = NOT_AVAILABLE_NO_CFD_RUN`

`SOLVER_STATUS = NOT_AVAILABLE_NO_CFD_RUN`

`Q_OUT = NOT_AVAILABLE_NO_CFD_RUN`

`MASS_BALANCE = NOT_AVAILABLE_NO_CFD_RUN`

`VAVG_SETTLING = NOT_AVAILABLE_NO_CFD_RUN`

`VMAX_BOTTOM = NOT_AVAILABLE_NO_CFD_RUN`

`MAX_WATER_LEVEL = NOT_AVAILABLE_NO_CFD_RUN`

`MIN_FREEBOARD = NOT_AVAILABLE_NO_CFD_RUN`

`PRESSURE_LOSS = NOT_AVAILABLE_NO_CFD_RUN`

`SHORT_CIRCUIT = NOT_AVAILABLE_NO_CFD_RUN`

`ETA_0_20 = NOT_AVAILABLE_NO_CFD_RUN`

`IMAGE_PATHS = NOT_AVAILABLE_NO_CFD_RUN`

`ANIMATION_PATHS = NOT_AVAILABLE_NO_CFD_RUN`

---

# 51. CFD RECORD — SHORT_WIDE_800x800

`STATUS = NOT_RUN_PILOT_CAD_AND_BC_INCOMPLETE`

`CAD_FILE = C:\Users\adm\Documents\Codex\2026-10-03\new-chat\outputs\grit_chamber\01_CAD\GRIT_PILOT_SHORT_WIDE_CAD_20261003.SLDPRT`

`CFD_PROJECT = NOT_AVAILABLE_NO_CFD_RUN`

`FLOW_TYPE = NOT_AVAILABLE_NO_CFD_RUN`

`FLUIDS = NOT_AVAILABLE_NO_CFD_RUN`

`GRAVITY = NOT_AVAILABLE_NO_CFD_RUN`

`FREE_SURFACE = NOT_AVAILABLE_NO_CFD_RUN`

`TRANSIENT = NOT_AVAILABLE_NO_CFD_RUN`

`Q_IN = NOT_AVAILABLE_NO_CFD_RUN`

`OUTLET_BC = NOT_AVAILABLE_NO_CFD_RUN`

`INITIAL_WATER_LEVEL = NOT_AVAILABLE_NO_CFD_RUN`

`MESH = NOT_AVAILABLE_NO_CFD_RUN`

`LOCAL_MESH = NOT_AVAILABLE_NO_CFD_RUN`

`SOLVER_STATUS = NOT_AVAILABLE_NO_CFD_RUN`

`Q_OUT = NOT_AVAILABLE_NO_CFD_RUN`

`MASS_BALANCE = NOT_AVAILABLE_NO_CFD_RUN`

`VAVG_SETTLING = NOT_AVAILABLE_NO_CFD_RUN`

`VMAX_BOTTOM = NOT_AVAILABLE_NO_CFD_RUN`

`MAX_WATER_LEVEL = NOT_AVAILABLE_NO_CFD_RUN`

`MIN_FREEBOARD = NOT_AVAILABLE_NO_CFD_RUN`

`PRESSURE_LOSS = NOT_AVAILABLE_NO_CFD_RUN`

`SHORT_CIRCUIT = NOT_AVAILABLE_NO_CFD_RUN`

`ETA_0_20 = NOT_AVAILABLE_NO_CFD_RUN`

`IMAGE_PATHS = NOT_AVAILABLE_NO_CFD_RUN`

`ANIMATION_PATHS = NOT_AVAILABLE_NO_CFD_RUN`

---

# 52. СОХРАНЕНИЕ ИЗОБРАЖЕНИЙ

Если доступно, сохранить:

- продольный Velocity Cut Plot;
- горизонтальный Velocity Cut Plot;
- Bottom Velocity Plot;
- Flow Trajectories;
- Free Surface;
- Pressure Plot;
- Particle Trajectories 0.20 мм.

В этот MD вставить относительные Markdown-ссылки, например:

`![BASE Velocity](./03_Результаты/BASE_velocity.png)`

---

# 53. СОХРАНЕНИЕ АНИМАЦИЙ

Если Flow Simulation позволяет экспортировать анимацию через доступный инструмент:

сохранить минимум:

- free surface;
- velocity;
- flow trajectories;
- particle trajectories 0.20 мм.

В MD сохранить путь:

`ANIMATION_FLOW = ...`

`ANIMATION_PARTICLES_020 = ...`

---

# 54. UNKNOWN

Не угадывать данные.

Записывать сюда всё отсутствующее:

## UNKNOWN LIST

- `Q_BACKGROUND`
- `ACTUAL_WASTEWATER_VISCOSITY`
- `SAND_CONCENTRATION`
- `ACTUAL_GRAIN_DISTRIBUTION`
- `DOWNSTREAM_WATER_LEVEL`
- `WALL_ROUGHNESS`
- `PARTICLE_WALL_INTERACTION`
- `ACTUAL_DN100_INTERNAL_DIAMETER`
- `SOLIDWORKS_LICENSE_AND_API_HEALTH`
- `FLOW_SIMULATION_SOLVER_LICENSE`
- `DOWNSTREAM_BOUNDARY_CONDITION`
- `SCREW_FLIGHT_THICKNESS_AND_FORM`
- `SCREW_CASING_END_SEALS`
- `FRAME_ANCHOR_DETAILS`
- `REAL_WASTEWATER_PROPERTIES`
- `FLOW_SIMULATION_LICENSE_AND_API_ACCESS`

Дополнять при необходимости.

---

# 55. CAPABILITY GAP

Заполнить фактический список.

## CAPABILITY_GAP LIST

Пока:

- `CAPABILITY_GAP_SOLIDWORKS_CONNECTOR`: инструмент SolidWorks отсутствует в текущем перечне доступных инструментов.
- `WORKAROUND_SOLIDWORKS_COM`: динамический COM-вызов PowerShell даёт `0x8002802B`; типизированный C# interop успешно обращается к API.
- `FLOW_SIMULATION_ACCESS = ADDIN_AND_COM_API_VERIFIED`: `FloWorks.App.GetAPI()` вернул `IAppApi`, активный документ доступен как `IDocumentApi`; создание CFD-проекта и расчётная лицензия не проверены.
- `PARTICLE_STUDY_ACCESS = API_INTERFACE_FOUND_NOT_RUN`: установленная типобиблиотека содержит `ITracerStudyAPI`; исследование и Solver не запускались.

Если функция недоступна, записывать сюда.

---

# 56. НЕ ВЫПОЛНЯТЬ ПОКА

Без отдельной команды пользователя не создавать:

- производственные чертежи;
- DXF;
- развёртки;
- сварочные чертежи;
- EBOM;
- MBOM;
- CAM;
- программы лазерной резки;
- программы мехобработки;
- полный технологический процесс.

---

# 57. ФИНАЛЬНЫЙ РЕЕСТР ФАЙЛОВ

| Type | File | Full path | Status |
|---|---|---|---|
| MASTER | GRIT_MASTER_V10_20261003.SLDPRT | C:\Users\adm\Documents\Codex\2026-10-03\new-chat\outputs\grit_chamber\01_CAD\GRIT_MASTER_V10_20261003.SLDPRT | SAVED; 3 CONFIGURATIONS; PARAMETRIC BATH |
| Pilot BASE | GRIT_PILOT_BASE_CAD_20261003.SLDPRT | C:\Users\adm\Documents\Codex\2026-10-03\new-chat\outputs\grit_chamber\01_CAD\GRIT_PILOT_BASE_CAD_20261003.SLDPRT | SAVED; SELECTED CONFIG REBUILD PASS; PARTIAL CAD |
| Pilot NARROW | GRIT_PILOT_NARROW_CAD_20261003.SLDPRT | C:\Users\adm\Documents\Codex\2026-10-03\new-chat\outputs\grit_chamber\01_CAD\GRIT_PILOT_NARROW_CAD_20261003.SLDPRT | SAVED; SELECTED CONFIG REBUILD PASS; PARTIAL CAD |
| Pilot SHORT_WIDE | GRIT_PILOT_SHORT_WIDE_CAD_20261003.SLDPRT | C:\Users\adm\Documents\Codex\2026-10-03\new-chat\outputs\grit_chamber\01_CAD\GRIT_PILOT_SHORT_WIDE_CAD_20261003.SLDPRT | SAVED; SELECTED CONFIG REBUILD PASS; PARTIAL CAD |
| Assembly | NOT_CREATED | — | NOT_STARTED |
| BASE/NARROW/SHORT_WIDE CFD | NOT_CREATED | — | NOT_RUN |
| Particle Study | NOT_CREATED | — | NOT_RUN |
| Preview | GRIT_PILOT_BASE_preview.png | C:\Users\adm\Documents\Codex\2026-10-03\new-chat\outputs\grit_chamber\03_Результаты\GRIT_PILOT_BASE_preview.png | SAVED SOLIDWORKS VIEW; NOT CFD RESULT |
| Report | GRIT_CHAMBER_CODEX_TASK.md | C:\Users\adm\Documents\Codex\2026-10-03\new-chat\outputs\Песколовка\GRIT_CHAMBER_CODEX_TASK.md | UPDATED |
---

# 58. ФИНАЛЬНЫЙ СТАТУС

`CAD_STATUS = PILOT_PARTIAL_BATH_INTERNALS_FRAME_CASING_HELICAL_COIL`

`CONFIGURATION_STATUS = MASTER_3_CONFIGS_DERIVATIVE_CAD_PER_SELECTED_CONFIG`

`REBUILD_STATUS = PASS_SELECTED_CONFIG_OF_3_PILOT_FILES`

`GEOMETRY_INTERFERENCE_STATUS = PASS_HELICAL_COIL_VS_OTHER_BODIES_ONLY`

`ANALYTICAL_CALC_STATUS = COMPLETED_PRELIMINARY`

`FLOW_SIMULATION_STATUS = NOT_RUN_NO_VALID_CFD_PROJECT_IN_DELIVERABLE`

`PARTICLE_STUDY_STATUS = NOT_RUN_NO_CFD`

`OPTIMIZATION_STATUS = NOT_RUN_NO_CFD_RESULT`

`manufacturing_approved = false`
---

# 59. ПРАВИЛО ДОСТОВЕРНОСТИ

Не писать:

`PASS`

без фактического выполнения соответствующей операции.

Не писать:

`CFD COMPLETED`

если Solver не запускался.

Не писать:

`PARTICLE STUDY COMPLETED`

если Particle Study не запускался.

Не писать:

`ETA >= 70 %`

если значение не получено расчётом.

Не выдавать:

- аналитический расчёт за CFD;
- Flow Trajectories воды за траектории песка;
- геометрическую модель за проверенную конструкцию;
- CFD за натурное испытание.

---

# 59A. ЖУРНАЛ ПОВТОРНОГО ЗАПУСКА — 2026-10-03

- SOLIDWORKS Design Premium 2026 SP3.2 подключён через типизированный C# COM interop (`RevisionNumber = 34.3.2`).
- Новый рабочий файл: `C:\Users\adm\Documents\Codex\2026-10-03\new-chat\outputs\grit_chamber\01_CAD\GRIT_MASTER_V10_20261003.SLDPRT`. Существующие пользовательские SLDPRT/SLDASM/SLDDRW не изменялись.
- Созданы 25 глобальных переменных `AI_*` по разделу 9. Числовые значения длин заданы в единицах документа — мм; эскиз и оболочка используют внутренние метры API.
- Созданы конфигурации `BASE_700x900`, `NARROW_600x1050`, `SHORT_WIDE_800x800` в одном мастер-файле.
- `MASTER_FOOTPRINT`: прямоугольник с уравнениями `D1 = AI_L_Bath`, `D2 = AI_B_Bath`. `BATH_BASE_PLATE` вытянут на `AI_H_Bath`; `BATH_SHELL_2MM` удаляет верхнюю грань и создаёт стенки толщиной 2 мм.

| Configuration | AI_B_Bath, mm | AI_L_Settle, mm | AI_L_Bath, mm | Actual footprint B × L, m | Actual H, m | Rebuild | Feature errors | Feature warnings |
|---|---:|---:|---:|---|---:|---|---:|---:|
| BASE_700x900 | 700 | 900 | 1350 | 0.70 × 1.35 | 0.75 | PASS | 0 | 0 |
| NARROW_600x1050 | 600 | 1050 | 1500 | 0.60 × 1.50 | 0.75 | PASS | 0 | 0 |
| SHORT_WIDE_800x800 | 800 | 800 | 1250 | 0.80 × 1.25 | 0.75 | PASS | 0 | 0 |

Текущий файл содержит **только открытый прямоугольный корпус**. Вход, гаситель, распределительный экран, выходная перегородка, перелив, пескосборное днище, шнек, выгрузка, рама и сборка не созданы. `CAD_STATUS = PARTIAL_BATH_ONLY`.

Надстройка Flow Simulation зарегистрирована в SOLIDWORKS и уже загружена (`LoadAddIn = 2`, [коды API](https://help.solidworks.com/2026/english/api/swconst/SolidWorks.Interop.swconst~SolidWorks.Interop.swconst.swLoadAddinError_e.html)). CFD-проект, сетка, Solver и Particle Study **не запускались**.

Ошибки повторного запуска: первый файл в каталоге с кириллическим именем не удалось повторно сохранить (`swGenericSaveError = 1`); он не выбран итоговым. При попытке изменить несколько конфигураций через устаревшую ссылку EquationMgr возник `RPC_E_SERVERFAULT`, после чего SOLIDWORKS был повторно запущен. Значения конфигураций затем изменены последовательно с новым объектом EquationMgr и проверены перестроением. Промежуточные версии `V2`–`V9` не являются итоговыми CAD-моделями.

---

# 59B. ЖУРНАЛ ПРОДОЛЖЕНИЯ ПРОЕКТИРОВАНИЯ — 2026-10-03

Источник: исходный `GRIT_MASTER_V10_20261003.SLDPRT`; существующие пользовательские CAD/PDM не изменялись. SOLIDWORKS Design Premium 2026 SP3.2, типизированный C# COM interop.

**Важная исправленная ошибка.** В первых производных пробах оси модели были интерпретированы неправильно, а при добавлении окружностей через `SketchManager.CreateCircleByRadius` без `AddToDB=true` фактически создавалась только часть отверстий. Пробные файлы `GRIT_DETAIL_*`, `GRIT_PILOT_*_V2/V5/V6`, `GRIT_*_TEST` не считать результатом. Оси проверены по `IBody2.GetBodyBox` с инвариантным десятичным форматом: X — длина ванны, Y — высота, Z — ширина от −B до 0. Итоговые файлы построены заново от MASTER, включено `AddToDB=true`, количество отверстий проверено после сохранения.

Итоговые выбранные конфигурации:

| CAD-файл | B×L, м | Отверстий Ø22 | Открытая площадь, м² | Rebuild | Ошибки элементов | Предупреждения | Твёрдых тел | Пересечения огибающей шнека |
|---|---|---:|---:|---|---:|---:|---:|---:|
| `GRIT_PILOT_BASE_CAD_20261003.SLDPRT` | 0.70×1.35 | 255 | 0.096934 | PASS | 0 | 0 | 7 | 0 |
| `GRIT_PILOT_NARROW_CAD_20261003.SLDPRT` | 0.60×1.50 | 210 | 0.079828 | PASS | 0 | 0 | 7 | 0 |
| `GRIT_PILOT_SHORT_WIDE_CAD_20261003.SLDPRT` | 0.80×1.25 | 285 | 0.108338 | PASS | 0 | 0 | 7 | 0 |

В каждом производном файле: корпус 2 мм; входное отверстие Ø100 мм на высоте 0.42 м; входной экран X=0.125 м; распределительный экран X=0.250 м с неперфорированной нижней зоной 114 мм; выходная погружная перегородка; переливная стенка высотой 0.55 м и выходной проём 600 мм; два пескосборных уклона в поперечном сечении; опорная рама высотой 0.50 м со стойками 40×40 мм, продольными и поперечными балками и площадками 100×100 мм; ось под 30°; отверстия прохода Ø120 мм; отдельный трубчатый кожух ID110/OD120 мм; твёрдая огибающая шнека Ø100 мм. Винтовое перо шнека, разгрузочная горловина, привод, уплотнения, сервисный доступ и отдельная сборка **не выполнены**. Твёрдая огибающая является только проверочным объёмом, не работающим шнеком.

Проверка `Operations2(SWBODYINTERSECT)` по всем трём выбранным конфигурациям: пересечение тела огибающей шнека с корпусом, экранами, перегородкой, переливом и кожухом равно 0 м³. Герметичность соединения кожуха с перегородками этим не доказана. Прочность корпуса и рамы не рассчитывалась.

Flow Simulation: надстройка загружена, COM-объект `FloWorks.App.GetAPI()` вернул `IAppApi`, `IActiveDoc` вернул `IDocumentApi`, `IsDemoVersion() = false`; в установленной `floworks.tlb` присутствуют `IProjectApiHandler`, `ITracerStudyAPI`, методы создания проекта и запуска Solver. Это подтверждает доступность API, **не** подтверждает наличие расчётной лицензии или пригодность текущей геометрии/граничных условий. CFD-проект не создан; Solver, сетка и Particle Study не запускались. Тест API выполнен только на копии `work/CFD_API_TEST.SLDPRT`: `CreateTemplateProject` перенёс базовые двухфазные настройки из установленного учебного примера свободной поверхности; `AddProject2` создал проект `GRIT_PILOT_BASE_FREE_SURFACE`. Ссылки граничных условий учебного примера к геометрии песколовки неприменимы, поэтому они удалены; после задания расчётной области `Rebuild3` вернул `false`. Этот тестовый проект не является пригодным CFD-проектом песколовки и не включён в выдаваемые CAD-файлы.

Эффективность `ETA_0_20` остаётся `UNKNOWN`, целевой критерий 70% не подтверждён.

Оставшиеся инженерные задачи перед CFD: выбрать схему отвода и нижний уровень воды; закрыть/описать границы свободной поверхности; согласовать действительный проход DN100 и сброс; задать уплотнения кожуха, реальную винтовую геометрию и желоб; проверить прочность и технологичность. Затем настроить Flow Simulation, выполнить MEDIUM/FINE, массовый баланс и Particle Study для всех трёх размеров.

`manufacturing_approved = false`

---

# 59C. ВИНТОВАЯ ГЕОМЕТРИЯ — 2026-10-03

После этапа 59B во всех трёх итоговых пилотных файлах построен трёхмерный винтовой путь и круглый безвальный виток: наружный диаметр 100 мм, осевой шаг 100 мм, круглый профиль диаметром 30 мм, наклон оси 30°. Это **геометрическая пилотная аппроксимация**, не плоское винтовое перо и не рассчитанный транспортёр песка. Проверочная сплошная огибающая `SCREW_OUTER_ENVELOPE_D100` подавлена в выбранной конфигурации каждого файла. Активные новые элементы: `SHAFTLESS_HELIX_PATH_P100` и `SHAFTLESS_ROUND_COIL_D100_P100`.

| Конфигурация | Точек винтового пути | Rebuild | Ошибки/предупреждения элементов | Твёрдых тел | Пересечения витка с остальными телами |
|---|---:|---|---|---:|---:|
| BASE_700x900 | 195 | PASS | 0 / 0 | 7 | 0 м³ |
| NARROW_600x1050 | 223 | PASS | 0 / 0 | 7 | 0 м³ |
| SHORT_WIDE_800x800 | 177 | PASS | 0 / 0 | 7 | 0 м³ |

Проверено `IBody2.Operations2(SWBODYINTERSECT)` для витка против корпуса/рамы, экрана, перегородок и кожуха. Остаются `UNKNOWN`: способность такого круглого витка транспортировать расчётную массу песка, момент/мощность привода, износ и конструкция выемного вкладыша. Плоское рабочее перо, привод, разгрузочная горловина и герметизация не созданы.

`manufacturing_approved = false`

---

# 59D. ПРОДОЛЖЕНИЕ — ПОДГОТОВКА CFD, 2026-10-04

Созданы отдельные копии трёх пилотных деталей в `C:\Users\adm\Documents\Codex\2026-10-03\new-chat\outputs\grit_chamber\02_CFD`:

| Конфигурация | Файл | Входная крышка | Выходная крышка | Rebuild | Ошибки элементов | Твёрдых тел |
|---|---|---|---|---|---:|---:|
| BASE_700x900 | `GRIT_CFD_BASE_PREP_20261004.SLDPRT` | Ø100 мм | 600×170 мм | PASS | 0 | 9 |
| NARROW_600x1050 | `GRIT_CFD_NARROW_PREP_20261004.SLDPRT` | Ø100 мм | 600×170 мм | PASS | 0 | 9 |
| SHORT_WIDE_800x800 | `GRIT_CFD_SHORT_WIDE_PREP_20261004.SLDPRT` | Ø100 мм | 600×170 мм | PASS | 0 | 9 |

Крышки `CFD_INLET_LID_D100` и `CFD_OUTLET_LID_W600` создают плоские поверхности для граничных условий. Это **только подготовка геометрии**. Проход воды, герметичность всех стыков, корректность жидкостной области и сетка ещё не подтверждены. Исходные три `GRIT_PILOT_*_CAD_20261003.SLDPRT` не изменились (время изменения осталось 2026-10-03 13:56:51–55, UTC+4). Пользовательский открытый документ `ЛТ500_MASTER_исходная_геометрия_R01.SLDPRT` не сохранялся и не редактировался.

На BASE-копии создан пробный проект Flow Simulation на основе установленного учебного примера свободной поверхности `spillway.sldprt`: две среды, гравитация включена. Шесть унаследованных условий и целей удалены, так как их ссылки на грани примера неприменимы к песколовке. Расчётная область задана X=−0.15…1.65 м, Y=−0.02…0.95 м, Z=−0.80…0.10 м. `Rebuild3` вернул `false`; сообщение Flow Simulation: «Невозможно применить изменения, так как соседние ячейки в пределах контрольного интервала … существенно различаются. Пожалуйста, измените настройки на этом интервале» (внутри сообщения присутствует техническая строка `ERROR: use c_str()`). Повтор с автоматическим построением сетки и сбросом сетки также вернул `false`. Этот импортированный проект **непригоден для расчёта**; на NARROW и SHORT_WIDE проект Flow не создавался.

После попытки создать чистый проект через `CreateTemplateProject(None)` / `AddProject2` SOLIDWORKS завершил работу и запустился заново. Причинная связь не установлена; этот API-путь повторно не запускался. Сетка, Solver, проверка лицензии расчётным запуском, Particle Study и эффективность пескоулавливания **не выполнены**. `ETA_0_20 = UNKNOWN`; `REQUIRED_DOWNSTREAM_LEVEL = UNKNOWN`; действительный внутренний диаметр DN100 и свойства сточной воды также неизвестны. Для продолжения нужен устойчивый проект Flow с корректными граничными условиями и проверенной жидкостной областью.

`manufacturing_approved = false`

---

# 59E. ПРОВЕРКА ЭФФЕКТИВНОСТИ УЛАВЛИВАНИЯ — 2026-10-04

По запросу пользователя повторно рассчитан **аналитический скрининг**, включая чувствительность к характеру течения. Расчётная таблица для пяти фракций и трёх конфигураций: `C:\Users\adm\Documents\Codex\2026-10-03\new-chat\outputs\grit_chamber\03_Результаты\GRIT_CAPTURE_SCREENING_20261004.csv`; воспроизводимый скрипт: `C:\Users\adm\Documents\Codex\2026-10-03\new-chat\work\grit_capture_screening_20261004.py`. Исходные допущения: Q=0.006 м³/с; чистая вода 20 °C, ρ=998.2 кг/м³, μ=0.001002 Па·с; сферический минеральный песок ρp=2650 кг/м³. Вязкость согласуется с [IAPWS R12-08](https://www.iapws.org/relguide/viscosity.html). Скорость осаждения найдена балансом сил с поправкой Schiller–Naumann; для 0.20 мм v=0.02479 м/с, Re=4.94. Это расчёт **одиночной частицы в неподвижной воде**, не траектория в аппарате.

Сравнены две упрощённые гидравлические модели: (1) равномерный поршневой поток с идеальным осаждением `η=min(1,vₛA/Q)`; (2) одна полностью перемешанная ёмкость с необратимым захватом осевших частиц `η=vₛA/(Q+vₛA)`. Обе используют номинальную площадь A=B×L_SETTLE и не учитывают турбулентность, повторный вынос, форму реального зерна и обход потока. Они **не являются гарантированными верхней и нижней границами** реальной эффективности.

| Фракция, мм | Скорость осаждения, м/с | Поршневой поток, BASE | Полное перемешивание, BASE |
|---:|---:|---:|---:|
| 0.10 | 0.00797 | 83.6% | 45.5% |
| 0.15 | 0.01590 | 100% | 62.5% |
| 0.20 | 0.02479 | 100% | 72.2% |
| 0.30 | 0.04324 | 100% | 81.9% |
| 0.50 | 0.07849 | 100% | 89.2% |

Для целевой фракции 0.20 мм:

| Конфигурация | Номинальное время, с | Время осаждения через 0.55 м, с | Поршневая модель | Модель полного перемешивания | Доля номинальной площади для 70% при полном перемешивании |
|---|---:|---:|---:|---:|---:|
| BASE_700x900 | 57.75 | 22.18 | 100% | 72.2% | 89.6% |
| NARROW_600x1050 | 57.75 | 22.18 | 100% | 72.2% | 89.6% |
| SHORT_WIDE_800x800 | 58.67 | 22.18 | 100% | 72.6% | 88.2% |

В модели полного перемешивания запас над целевыми 70% составляет лишь 2.2–2.6 процентного пункта. Если допустить дополнительный прямой обход долей `b` без захвата, `η=(1−b)η_mixed`; уже `b > 3.1%` для BASE/NARROW или `b > 3.5%` для SHORT_WIDE опускает эту *сценарную* оценку ниже 70%. Это **не оценка фактического обходного расхода**. В CAD у распределительного экрана есть боковые просветы по 30 мм: их суммарное геометрическое сечение при уровне 0.55 м равно 0.033 м². Оно составляет 25.4%, 29.2% и 23.3% от суммы сечения боковых просветов и отверстий соответственно; доля расхода через просветы неизвестна. Требуется проверить обход и повторный вынос у днища расчётом течения.

**Итог проверки:** аналитически цель 70% для 0.20 мм достижима в указанных идеализированных сценариях, но **фактическая эффективность текущей геометрии не установлена**. `ETA_0_20 = UNKNOWN`; `ETA_0_20 >= 70% = NOT_VERIFIED`. Проект Flow Simulation BASE из 59D не перестраивается, для остальных вариантов расчётного проекта нет. Результаты Solver, сеточной независимости, массового баланса и Particle Study отсутствуют. Для доказательства критерия нужны устойчивый расчёт двухфазного течения с границами входа/перелива и распределённый ввод ≥1000 частиц фракции 0.20 мм с подсчётом `N_CAPTURED/N_INJECTED`, а затем проверка остальных фракций и размеров.

`manufacturing_approved = false`

---

# 59F. ПРЯМАЯ ПОПЫТКА ПРОВЕРКИ В SOLIDWORKS — 2026-10-04

По прямому запросу на проверку именно в SOLIDWORKS открыта **отдельная рабочая копия** `C:\Users\adm\Documents\Codex\2026-10-03\new-chat\work\GRIT_CFD_BASE_CLEAN_TEST_20261004.SLDPRT` без унаследованного проекта Flow. В SOLIDWORKS Design Premium 2026 SP3.2 выбрана конфигурация `BASE_700x900`; документ содержит 9 твёрдых тел с расчётными крышками входа и выхода. `GetAddInObject("FloWorks.App")` и `GetAPI()` доступны, `IsDemoVersion() = false`. Прямой опрос `GetDocument(own_file).Projects` вернул **0 проектов Flow Simulation**. Машиночитаемый журнал проверки: `C:\Users\adm\Documents\Codex\2026-10-03\new-chat\outputs\grit_chamber\03_Результаты\GRIT_SOLIDWORKS_EFFICIENCY_STATUS_20261004.json`.

Команды надстройки `TB_NewProject()` и `TB_MakeNewProject_WIZARD()` вызваны на этой копии; после вызовов диалог настройки не появился и число проектов осталось 0. Одновременно активный документ общего сеанса SOLIDWORKS переключился на другие пользовательские модели, поэтому дальнейшее управление интерфейсом этого сеанса остановлено. Пользовательские документы не сохранялись. Проект с входом 6 л/с, атмосферным переливом и начальными водой/воздухом **не создан**; отсутствуют сетка, решение течения, исследование частиц и таблица `N_CAPTURED/N_INJECTED`. `FLOW_SOLVER_STATUS = NOT_RUN`, `PARTICLE_STUDY_STATUS = NOT_RUN`, `ETA_0_20_SOLIDWORKS = UNKNOWN`, `ETA_0_20 >= 70% = NOT_VERIFIED`. Состояние надстройки не доказывает наличие расчётной лицензии до фактического запуска Solver.

Следующая техническая операция: в непрерывном доступе к сеансу SOLIDWORKS создать новый проект Flow через интерфейс надстройки на чистой копии, подтвердить жидкостную область и граничные условия, построить сетку, получить сходящееся поле течения и только затем запустить распределённый ввод частиц. Без этих результатов аналитические оценки раздела 59E нельзя выдавать за эффективность текущей конструкции.

`manufacturing_approved = false`

---

# 60. ТОЧКА ЗАВЕРШЕНИЯ ТЕКУЩЕЙ РАБОТЫ

Работа считается выполненной на этом этапе, если:

- создана новая CAD-модель;
- существует MASTER/Skeleton;
- созданы три конфигурации;
- выполнен rebuild;
- выполнены геометрические проверки;
- выполнена аналитическая гидравлика;
- Flow Simulation либо фактически выполнена, либо доказан конкретный CAPABILITY_GAP;
- Particle Study либо выполнен, либо доказан конкретный CAPABILITY_GAP;
- файлы симуляции сохранены;
- изображения и анимации сохранены при наличии соответствующей функции;
- этот Markdown обновлён фактическими результатами;
- все UNKNOWN перечислены;
- все ошибки перечислены;
- все пути к результатам записаны.

Финальная обязательная строка:

`manufacturing_approved = false`
