hisp2k/parameters/screw-conveyors/01-PT-SHT/deliverables/Шнек 1 — аудит производственного комплекта/00_Статус и паспорт.md

# Аудит производственного комплекта «Шнек 1»

> Дополнение от 02.10.2026: 14 отсутствовавших файлов восстановлены из твердотельного STEP, создана отдельная нативная сборка с 205/205 разрешёнными компонентами и без отсутствующих путей. После перестроения обнаружены 48 ошибочных сопряжений и 3 ошибки других элементов. Исторические числа отсутствующих ссылок ниже относятся к состоянию до восстановления. Подробности — в `11_Восстановление CAD.md`. Разрешения к производству по-прежнему нет.

**Дата:** 02.10.2026 08:29 МСК+1. **Состояние:** проектный аудит; разрешения к производству нет. Основание: приложенный пользователем регламент «Требования к чертежам и производственному комплекту», версия 2.0 от 02.10.2026. Частные приложения по изделиям 881 и 58.GR к «Шнек 1» не применялись.

## Паспорт и источники

- Изделие: шнек 1, главная сборка `PT.SHT.01.20.00.00`. Заказ, утверждённая ревизия, исполнение и количество на заказ: **не определены**. Учётный объём BOM — одно изделие; это не заказ на производство.
- Исходники: рабочая копия `CAD/`, исходная ведомость `01.PT.SHT BOM.xlsx` (58 строк), проектная правка `05_BOM — проектная правка.xlsx` (59 строк), прежние отчёты проверки и три автоматически созданных чертежа. Контрольные суммы доступных исходных файлов — в `04_Манифест исходников.csv`.
- Единицы CAD, конфигурации, точные свойства материалов, производственный парк, инструмент, технология сварки, условия работы и контролируемая ревизия: **не подтверждены данным аудитом**.
- Форматы предполагаемой выдачи по регламенту: нативные CAD и чертежи, DXF при наличии соответствующих деталей, технология, закупка, манифест и протоколы.

## Проверенный объём

- Из BOM извлечено **59 позиций**; верхняя сборка учтена отдельно. Автоматически классифицированы **33 позиции деталей** и **7 сборок**. Классификация по обозначению предварительна.
- Повторная сверка активной конфигурации «По умолчанию» показала **0 построчных расхождений** между 59 строками проектной BOM и 205 вхождениями дерева CAD после явно описанной нормализации имён. Метод и 15 неразрешённых путей — в `08_Сверка BOM и CAD.md`.
- Для 87 строк минимального реестра документов определены вид и состояние. Из 40 объектов, требующих рабочего чертежа, **3 имеют хотя бы один файл**; всего обнаружено 4 физических файла чертежей, включая дубль верхней сборки. **0** проверены как рабочие чертежи. Отсутствие файлов не закрыто объяснением.
- У 2 позиций с обозначением PT.SHT нативная модель не найдена по обозначению в каталоге CAD. Это отдельный файловый поиск; повторное открытие SolidWorks 02.10.2026 установило **87 вхождений со ссылками на 15 отсутствующих путей**. Среди них «Сбрасыватель», файл которого есть в `CAD/`, но ссылка ведёт на прежний абсолютный путь.
- `03_Детали без чертежей.csv` включает детали без найденного чертежа и стандартные/покупные позиции. Последние оставлены в составе BOM; нормативное основание исключения индивидуального чертежа требует проверки.
- Проверены существование и SHA-256 132 доступных файлов. Открываемость и содержание каждого CAD/DXF в этой проверке не оценивались.
- Сформирован предварительный перечень закупки из 20 позиций (`09_Плановая закупка.md`); он не является заказом. DXF, карты гибки, адресные сварочные схемы, управляющие программы, маршрутные карты и нормы времени **не созданы и не проверены**. Их применимость и требуемое количество определяются после проверки геометрии и маршрутов; число 87 не является числом всех документов полного комплекта.

## Блокеры и расхождения

| ID | Класс | Область | Требуемое действие |
|---|---|---|---|
| B-01 | Б1/Б2 | Главная сборка, её рабочий чертёж, спецификация и зависимые расчёты | Устранить 15 неразрешённых путей / 87 вхождений, разрешить компоненты, проверить конфигурацию, сопряжения и коллизии. Файл «Сбрасыватель» есть в CAD, но ссылка ведёт на старый путь; ещё 14 файлов в указанной папке не найдены. |
| B-02 | Б3 | BOM и состав сборки | Решение пользователя учтено в проектной правке BOM: кольцо D80 — 2 шт., «Сбрасыватель» — 1 шт., М8 — DIN 127 B A2 по имеющейся CAD-детали. Количества 59 строк сверены с деревом; видимая форма B проверена по CAD, размеры, материал и пригодность соединения ещё требуют контроля. |
| B-03 | Б2 | Рабочие чертежи деталей и сборок | Сверить геометрию, назначить определяющие размеры, допуски, базы и контроль; проверить чертежи в масштабе печати. |
| B-04 | Б1/Б2 | Шнековый вал, привод и связанные расчёты | Подтвердить физические свойства груза, нагрузки, крутящий момент и фактическую подачу при 55°; не выводить их из одного каталога. |
| B-05 | Б2 | Сварка, резка, гибка, механическая обработка, время и закупка | Установить маршруты и оборудование по каждой позиции; затем определить применимые DXF, карты гибки, сварочные требования и нормы времени. |
| B-06 | Б3 | Ревизии и выпуск | Зафиксировать согласованную ревизию, нормативный профиль и ответственного выпускающего; выполнить повторную проверку всех зависимых документов. |

Отдельно: прежняя проверка выявила сумму количеств исходной BOM **203** и число вхождений модели **205**, включая подсборки. После проектных правок BOM сумма стала **205**. Совпадение общих чисел не подтверждает построчное соответствие и не устраняет неразрешённые ссылки.

## Дальнейшая последовательность

1. Закрыть B-01 и повторить построчную сверку модели с проектной правкой BOM для текущей конфигурации; подтвердить геометрию шайбы DIN 127 B.
2. Для каждой изготовляемой детали установить материал, исходную ревизию, определяющую геометрию и маршрут. Выпускать рабочие чертежи и технологию по проверенным ветвям.
3. Проверить фактическую применимость нормативных документов и их редакций; карточки ГОСТ в этом аудите не проверялись, соответствие ЕСКД не заявлено.
4. По геометрии и маршрутам установить применимость DXF, развёрток, сварочных схем, CAM и закупочных ведомостей, затем создать и проверить каждый применимый документ.
5. После повторного открытия сохранённых файлов и проверки комплекта создать новый манифест и оформить отдельное решение уполномоченного лица о выпуске.

**Протокол фактически выполненных проверок:** чтение 59 строк проектной BOM; поиск нативных файлов по обозначению в CAD; поиск существующих чертежей; вычисление SHA-256 доступных файлов; повторное открытие верхней сборки через SolidWorks API. Это автоматическая самопроверка файлов и учёта, без независимого нормоконтроля и без нового перестроения SolidWorks.
