hisp2k/parameters/screw-conveyors/01-PT-SHT/deliverables/Шнек 1 — аудит производственного комплекта/06_Решения и проверка расчёта.md

# Уточнения по изделию «Шнек 1» и предварительный расчёт

**Дата:** 02.10.2026. **Статус:** проектное решение; производительность, комплектность CAD и пригодность к производству не подтверждены.

## Зафиксировано со слов пользователя

| Параметр | Значение | Состояние |
|---|---:|---|
| Груз | Песок с очистных сооружений | ЗАДАНО; влажность, насыпная плотность и крупность не определены |
| Требуемая объёмная подача | 10 м³/ч | ЗАДАНО; требуется подтвердить условия измерения |
| Режим | Прерывный | ЗАДАНО; длительность включения и число пусков не определены |
| Угол установки | 55° | ПОДТВЕРЖДЕНО пользователем |
| Стопорное кольцо D80 DIN 472 А2 | 2 шт. | ЗАДАНО пользователем; внесено в проектную правку BOM |
| Сбрасыватель PT.SHT.01.21.00.07 | 1 шт. | ЗАДАНО пользователем; добавлен в проектную правку BOM |
| Шайба пружинная М8 | DIN 127 B А2, 40 шт. | ПРЕДЛОЖЕНО по имеющейся CAD-детали; видимая форма B проверена, размеры и материал требуют проверки |

Исходная BOM сохранена без изменения. Проектная правка — `05_BOM — проектная правка.xlsx`: изменены только количество кольца D80, обозначение шайбы М8 и добавлена строка «Сбрасыватель» с неизвестным материалом и массой.

## Основание выбора шайбы

В рабочем каталоге имеется файл `Шайба пружинная М8 DIN127 А2.SLDPRT`; строка BOM указывала DIN 128. Эти стандарты описывают разные формы шайб: [DIN Media — DIN 127](https://www.dinmedia.de/en/standard/din-127/1787533) и [DIN Media — DIN 128](https://www.dinmedia.de/en/standard/din-128/1787811). [Bossard выпускает исполнение DIN 127 B из A2](https://www.bossard.com/sg-en/eshop/split-spring-lock-washers/split-spring-lock-washers-with-flat-end/p/672/); в каталоге стандарт отмечен как отменённый. Выбор сохраняет идентичность имеющейся детали и не означает автоматической замены на DIN 128 A. [Изометрический вид нативной модели](10_Шайба%20М8%20—%20вид%20CAD.png) показывает разрезное кольцо с плоскими торцами, что соответствует видимой форме B. Это визуальная проверка формы; размеры, упругие свойства, материал и пригодность соединения ещё требуют контроля перед закупкой.

## Частота вращения и проверка предела

Текущая сохранённая геометрия: наружный диаметр винта **130 мм**, диаметр вала **36 мм**, шаг **105 мм**, угол **55°**. Геометрический объём за оборот по кольцевому сечению:

`V₁ = π/4 × (0,130² − 0,036²) × 0,105 = 0,00128681 м³/об`.

Даже при невозможном идеальном переносе всего геометрического объёма для 10 м³/ч потребовалось бы **не менее 129,52 об/мин**. В качестве **частоты для проверки** выбрано **190 об/мин** из ряда, используемого в расчётном модуле для [ГОСТ 2037-82](https://files.stroyinf.ru/Data2/1/4294751/4294751811.pdf). При 190 об/мин геометрический предел составляет **14,67 м³/ч**. Для фактической подачи 10 м³/ч доля переноса должна быть не менее **68,17%**. Это требование к неизвестной фактической характеристике, а не прогноз производительности.

Угол 55° выходит за область наклонных конвейеров ГОСТ 2037-82 (до 20°), поэтому соответствие частоты ряду ГОСТ не подтверждает пригодность всей машины. [KWS относит установки свыше 45° к вертикальной схеме проектирования](https://www.kwsmfg.com/engineering-guides/screw-conveyor/types-of-screw-conveyors/); уменьшение подачи и рост требуемой мощности зависят от груза и угла. [Таблица KWS для вертикальных шнеков](https://www.kwsmfg.com/engineering-guides/vertical-conveyor/capacity-table-horsepower-calculation/) относится к другому типоразмеру и не может быть непосредственно принята за характеристику данного винта Ø130 мм. [Справочник KWS по песку](https://www.kwsmfg.com/engineering-guides/screw-conveyor/bulk-material-table/) приводит свойства сухого и влажного карьерного песка, но они не являются измеренными свойствами песка с этих очистных сооружений.

**Решение:** 190 об/мин оставить в интерфейсе как предварительный кандидат для проверки. Не выпускать привод, вал и утверждение о достижении 10 м³/ч по одному геометрическому расчёту. Требуются характеристики реального груза, испытание подачи при 55° и проверка момента/мощности, пусков, износа и креплений.

## Проверка исходной папки и сборки

Указанная пользователем папка содержит файл «Сбрасыватель» и кольцо D80. Повторное открытие рабочей верхней сборки через SolidWorks API показало **87 вхождений с неразрешёнными ссылками по 15 путям**. Из этих 15 файлов в указанной папке по точному имени найден только «Сбрасыватель»; его компонент в сборке всё ещё указывает на старый абсолютный путь. Остальные 14 уникальных файлов в переданной папке не найдены. Следовательно, добавление строки в BOM не восстанавливает связь компонента CAD и не делает сборку полной.

Перед попыткой перепривязки сохранена копия подсборки «Труба в сборе» в `snapshots/relink-20261002-083056/`. Операция замены ссылки остановлена до изменения CAD: SolidWorks продолжал держать подсборку открытой, а метод замены ссылки требует закрытого документа. Повторное открытие верхней сборки подтвердило прежние **87/15**; перепривязка не заявляется как выполненная.

## Данные, необходимые для следующего расчёта

1. Насыпная плотность, влажность, максимальный размер частиц и доля примесей именно транспортируемого песка; желательно по нескольким характерным состояниям.
2. Длительность одного включения, число пусков в час/сутки, условия пуска с загруженным шнеком, возможность заклинивания, требуемая температура и степень промывки.
3. Паспорт установленного мотор-редуктора либо допустимость его замены: фактическая выходная частота, момент, мощность, передаточное число и защита.
4. Отсутствующие 14 файлов компонентов либо утверждённые замены с обозначениями и геометрией.

Проверки: арифметика геометрического предела повторена отдельно от серверного модуля; API расчёта при 190 об/мин вернул статус `BLOCK` по углу, паре диаметра/шага и зазору, а фактическая подача 10 м³/ч помечена как требующая подтверждения. Чертежи и CAD-геометрия этим расчётом не перестраивались.
