hisp2k/parameters/screw-conveyors/01-PT-SHT/deliverables/Шнек 1 — аудит производственного комплекта/07_Манифест выдачи.md

# Манифест проектного аудита «Шнек 1»

Контрольные суммы относятся к байтам перечисленных файлов. Они не подтверждают пригодность CAD к производству.

| Файл | Байт | SHA-256 |
|---|---:|---|
| 00_Статус и паспорт.md | 11251 | `63119ffc38c12ced7a4dad80e5e622c17f4f118317c6ca7aeece8e4d2c16344e` |
| 01_Объекты.csv | 19863 | `5010a357b637804c71dd80953635c6c827b838970d5a440710b005bb14bddb08` |
| 02_Документы.csv | 20195 | `d77e952725745a618afdd90e0f1066ec057010f52a9a27124b242920490e7f30` |
| 03_Детали без чертежей.csv | 16038 | `3a5f72863c8c06480e72ffc342ee04d1aab79c332b36f1b4c55c36c106d4b227` |
| 04_Манифест исходников.csv | 31448 | `0a998525a04e6199f215f22dc4cc3f26adad689b0b73e67c39aa44e4d5d92c5d` |
| 05_BOM — проектная правка.xlsx | 12465 | `1919686d0b61f4a740943aad11f7a2500f1a87b166456d861d1264d6952d8549` |
| 06_Решения и проверка расчёта.md | 9893 | `aed1deba6fdacfac114a8d4495012ad92a0150ed25ef6dd73197f8fcab397808` |
| 08_Сверка BOM и CAD.md | 2853 | `00dae45d30f01ad0177dabb44eb03af98b0dddc561e22b02898127290e3ada7f` |
| 09_Плановая закупка.md | 2759 | `f44e694058dee07e75c31a5c77d80de3f78a711f5b2ea86b47c745d27c72ebca` |
| 10_Шайба М8 — вид CAD.png | 302878 | `05d8c37bf4fa324f3b3149e79c3575355c6d449cde2bb353af821366634c6a38` |
| 11_Восстановление CAD.md | 3217 | `190d89d88e5b7eebc2b5a9cd3d4790e71f1db9d861a97dd3df74804b4699a31f` |
| 12_Исходные данные песка.md | 3575 | `76ffe44a134acd88dcd32e62a0f0a37397d96f9e01c4a48780d5105b1a6a7561` |
| 13_Параметризация рабочих узлов.md | 1339 | `15dfc41f3528c0fcf461fe9a7a5228c8da35e48f1971aac2e6a85b2199717235` |

Файлов: 13.
