hisp2k/parameters/screw-conveyors/25-SHT-G/deliverables/25.SHT.G_parameterized/ПАСПОРТ_МОДЕЛИ.md

# 25.SHT.G.00.00.00.00 — параметризация шнекового транспортёра

## Статус

Создана отдельная копия исходной сборки SolidWorks и её деталей. В детали `25.SHT.G.02.00.00.01  Шнек 200 мм.SLDPRT` пять геометрических размеров связаны с именованными глобальными переменными. Проверено перестроение шнека при шаге 180, 200 и 220 мм. Для остальных узлов сохранена исходная геометрия. Полная параметризация всей сборки, BOM и чертежей ещё не выполнена.

Вставленный пользователем текст рассмотрен как техническое задание и методика. Его примеры параметров и диапазонов **не** приняты за фактические размеры изделия. Факты ниже взяты из CAD, чертежей и CSV.

## Аудит исходного комплекта

| Показатель | Установлено | Источник |
|---|---:|---|
| Файлы SolidWorks | 13 сборок, 73 детали | каталог исходного проекта |
| Компоненты первого уровня | 393 | открытая сборка SolidWorks |
| Подавленные компоненты первого уровня | 16 | открытая сборка SolidWorks |
| Внешние ссылки на файлы вне переданной папки | 4, все подавлены | открытая сборка SolidWorks |
| Исходные уравнения сборки и шнека | 0 | Equation Manager |
| Габарит по сборочному чертежу | 3861 × 500 × 1029 мм, справочные размеры | чертёж `25.SHT.G.00.00.00.00 СБ` |
| Масса по чертежу | 455,17 кг | тот же чертёж; не пересчитана CAD |
| Масса шнека с осями по чертежу | 63,16 кг | чертёж `25.SHT.G.02.00.00.00 СБ` |

Основные узлы: отсек с желобом и опорами, шнек с осями, фланцы, крышки, дополнительные опоры, съёмные перекладины, мотор-редуктор, подшипники и крепёж. Названия покупных узлов и типоразмеры взяты из исходных файлов; подбор новых покупных компонентов не выполнялся.

Четыре внешние ссылки в исходной сборке указывают на прежние рабочие места. Это подавленные компоненты: фланец наружный, резиновая прокладка к фланцам, болт М16×80 и втулка. Первые два одноимённых файла присутствуют в копии, но связь на уровне компонента сохранила старый путь; два последних файла в переданном комплекте не найдены. Для текущей конфигурации подавление сохранено.

## Реализованные параметры шнека

| ID | Глобальная переменная SolidWorks | Номинал | Связанный размер | Факт/ограничение |
|---|---|---:|---|---|
| P01 | `SCREW_PITCH` | 200 мм | `D4@HELIX_MASTER` | шаг винтовой линии; проверено 180/200/220 мм |
| P02 | `SCREW_FLIGHT_LENGTH` | 2885 мм | `D3@HELIX_MASTER` | длина винтовой линии по CAD |
| P03 | `SCREW_OD` | 200 мм | `D2@FLIGHT_SECTION` | наружный диаметр по CAD и чертежу |
| P04 | `SCREW_CORE_OD` | 76 мм | `D1@FLIGHT_SECTION` | внутренний диаметр профиля по CAD |
| P05 | `FLIGHT_THK` | 12 мм | `D3@FLIGHT_SECTION` | толщина витка по CAD |

В чертеже шнека с осями указаны: общая длина 3165,5 мм, шаг 200 мм, наружный диаметр 200 мм и размер 2873 мм между торцами. Размер винтовой линии 2885 мм получен из параметра CAD; он отличается от чертёжного размера 2873 мм, поскольку это разные размерные привязки. Точное соответствие торцов при изменении длины требует отдельной проверки.

`HELIX_MASTER` и `FLIGHT_SECTION` — переименованные элементы исходной детали. Геометрия при номинальных параметрах сохранена. Управляющие переменные находятся в **Сервис → Уравнения** детали шнека. Скрипт `set_pitch.py` меняет `SCREW_PITCH`, перестраивает модель, сверяет фактический размер и сохраняет деталь.

## Архитектура полной системы

Планируемая цепочка: параметры изделия → общая геометрия оси, габаритов и опор → правила выбора сечений и покупных компонентов → отсек/шнек/опоры/крышки/привод → сопряжения → BOM и чертежи. Источник геометрического размера должен быть один; зависимость в обратную сторону запрещена.

| Параметр верхнего уровня | Зависимые узлы | Текущее состояние |
|---|---|---|
| Длина транспортирования | отсек, шнек, валы, футеровка, крышки, опоры, крепёж | не связаны |
| Диаметр шнека | шнек, желоб, зазор, торцы, фланцы | связан только со шнеком |
| Шаг шнека | винтовая линия, число витков | связан со шнеком; геометрически проверен |
| Высота установки | опоры, положение оси, загрузка/выгрузка | не связаны |
| Производительность и материал | частота вращения, мощность, вал, подшипники, привод | исходных расчётных данных нет |

Изменяемые изготовляемые детали: шнек, валы, желоба, крышки, футеровка, опоры, перекладины и часть фланцев. Покупные мотор-редуктор, подшипники, муфта, манжеты и крепёж должны выбираться из каталога как дискретные типоразмеры после расчёта. Для текущей копии они сохранены как в исходной сборке.

## Проверка и границы применимости

| Шаг | Перестроение детали | Измеренный `D4@HELIX_MASTER` |
|---:|---|---:|
| 180 мм | успешно | 180 мм |
| 200 мм | успешно | 200 мм |
| 220 мм | успешно | 220 мм |

Эти три значения — испытания перестроения, **не** согласованный допустимый инженерный диапазон. Не проверялись производительность, момент, мощность, прочность, зазоры при ином диаметре, столкновения полной сборки, развёртки листовых деталей, обновление BOM и привязки чертежей. Для этих задач нужны свойства перемещаемого материала, требуемая производительность, допустимые размеры и правила выбора привода/опор. Менять длину и диаметр через параметры шнека до параметризации соседних узлов нельзя считать проверенным исполнением всего транспортёра.

## Открытие и изменение шага

1. Распаковать каталог целиком с сохранением вложенной папки `Покупное`.
2. Открыть файл `25.SHT.G.00.00.00.00 СБ  Транспортер.SLDASM` в SolidWorks.
3. Для изменения шага открыть деталь `25.SHT.G.02.00.00.01  Шнек 200 мм.SLDPRT` и изменить `SCREW_PITCH` в уравнениях либо запустить `python set_pitch.py 220` из этого каталога. Скрипт требует установленный SolidWorks и пакет `pywin32`. Если рядом лежит папка `transport_questionnaire`, можно заполнить анкету и нажать в программе **Связать с моделью**. Программа передаст числовой шаг только для D=200 мм, проверит фактический размер и запишет `СВЯЗЬ_С_ОПРОСНЫМ_ЛИСТОМ.json` с полным набором данных и перечнем параметров без геометрической связи.
4. Перестроить сборку и проверить зазоры, BOM и чертежи перед использованием нового исполнения.

## Предварительный расчёт Simulation

Программа в соседней папке `transport_questionnaire` содержит вкладку **6. Прочность**. После ввода расчётного момента, осевой силы и свойств материала она создаёт статическое исследование в детали `25.SHT.G.02.00.00.03  Вал.SLDPRT`, сохраняет результаты в её пользовательских свойствах `FEA_*` и рядом с моделью — в файле `РАСЧЁТ_ПРОЧНОСТИ_ВАЛА.json`. Одновременно числовой шаг передаётся в параметр шнека `SCREW_PITCH`.

Условная схема расчёта вала: торец z=0 закреплён, на торце z=−363 мм действуют осевая сила и крутящий момент. Эти условия должны быть проверены инженером по реальному узлу. Расчёт одного вала не подтверждает прочность шнека в сборе, желоба, опор, сварных швов и других компонентов. Значения в модели по умолчанию не являются результатами пользовательского расчёта: исследование создаётся только после ввода нагрузок и команды запуска.
