hisp2k/parameters/engineering/SolidWorksCodex/README_RU.md

# SolidWorks ↔ Codex: локальный коннектор 2.5.0

## Текущая Сборка, 16.09.2026

Получены обновления Claude до `503808f`, контракт содержит 35 инструментов.
Новый EXE репозитория (SHA-256 `4470C9A0...`) проверен автономно:
282 + 88 с Interop + 78 + 26 = 474 PASS. PR: https://github.com/hisp2k/SolidWorksCodex/pull/1.
Установленный MCP остаётся прежним (`B9570CC9...`), новые инструменты пока доступны
через EXE репозитория, а не автоматически через старое подключение чата.
Сводка возможностей, источников живых результатов и ограничений: PROJECT_STATE.md.
Расчётное ядро шнекового транспортёра в Python является неподтверждённым черновиком.

## Именованные Параметрические Переменные (sw_set_global_variable)

По прямой формулировке Дмитрия Александровича («подменить числовые значения на
параметрические... не будет 2, а будет переменная») добавлен `sw_set_global_variable`:
берёт тот же точно выбранный элемент/размер, что и `sw_set_feature_dimensions`
(`sw_features` → `feature_name`/`expected_feature_type`/`full_name`/`expected_current_mm`),
и вместо прямой записи числа через `IDimension.SetSystemValue3` добавляет через
`IEquationMgr.Add3` два уравнения: именованную глобальную переменную
(`"variable_name" = value_mm`) и уравнение самого размера, ссылающееся на неё
(`"D1@Элемент@Файл" = "variable_name"`). Значение может совпадать с текущим —
смысл не обязательно менять число, а сделать его именованной переменной.
Новое имя переменной не должно совпадать с уже существующим уравнением;
уже управляемый уравнением размер этим инструментом не перезаписывается.
После перестроения обе добавленные записи и итоговое значение размера
перечитываются заново из `IEquationMgr`/`IDimension`, как отдельная проверка,
а не только предполагаются успешными по факту отсутствия ошибки. При любом
сбое после добавления обе записи удаляются и размеру возвращается прежнее
буквальное значение перед повторным перестроением. Обычные ограничения
(только локальный фиксированный диск, только `SLDPRT`, резервная копия,
неподдерживаемые типы элементов и подавленные элементы запрещены) сохранены
без изменений. Офлайн-покрытие: валидация аргументов в `Tests.cs` и те же
generic-проверки "неизвестное состояние сохранения"/"только для чтения", что и
у `sw_set_feature_dimensions`, в `TEST_WRITE_SAFETY_REGRESSIONS.ps1`.

Проверено вживую на реальной установке SOLIDWORKS (узел 09, тестовая копия
`Experiment_ebc977a34242`): размер 228.8 мм успешно превращён в именованную
глобальную переменную `crossbar_length_mm` с полным подтверждением через
повторное чтение `IEquationMgr`, неизменной геометрией/объёмом и сохранением
файла (SHA-256 изменился). Также подтверждён безопасный отказ при повторном
вызове на уже управляемом уравнением размере (`FEATURE_DIMENSION_NOT_DRIVING`,
без побочных эффектов) и чистая перестройка/сохранение родительской сборки.
Практический нюанс `Add3`: рабочее значение `WhichConfigurations` —
`swInConfigurationOpts_e.swAllConfiguration` (в единственном числе); на
документе с одной конфигурацией `swThisConfiguration` приводит к молчаливому
отказу (`Add3` возвращает `-1` без исключения).

## Проверенный Параметрический Эксперимент

В разрешённой тестовой папке создан штатный вариант узла 09: пластина 4 -> 5 мм,
перестроение, сохранение и реальное повторное открытие. Проверены один solid,
рост объёма на 25%, оба экземпляра пластины и 6 сопряжений нативной подсборки.
Сценарий и границы: SCOPED_PARAMETRIC_EXPERIMENT.md.
Добавлены sw_test_pack_and_go/sw_test_document с локальным opt-in TestScope.local.json;
обычные инструменты по-прежнему не сохраняют сборки. Внешняя запись, PDM и сеть запрещены.
Новые команды и сценарий проверены EXE репозитория; MCP-установка автоматически не заменялась.
Исходные файлы транспортёра не изменены; производственный допуск не выдан.

## Нативный Параметрический Пилот

Первое управляемое изменение существующей детали подтверждено live:
Пластина узла 09, толщина вытягивания 4 → 5 → 4 мм, с перестроением,
проверкой одного тела, объёма, бэкапа и сохранения. См. NATIVE_PART_PILOT.md.
Исправлены типы IDimension.GetType (swDimensionParamType_e) и JSON Schema
для Extrusion. Размеры эскизов читаются в миллиметрах, но не разрешены к записи.
Формулы опросного листа ещё не заданы; испытание не означает готовность к производству.

## Что добавлено в 2.5.0

- `ProfilePartPlan` v3 добавляет продольные овальные пазы на плоских гранях
  уголка и прямоугольной/квадратной трубы.
- Паз задаётся общей длиной, шириной, отступом центра от края и осевыми
  позициями: явным списком либо линейным массивом с шагом.
- На уголке паз вырезает одну полку; на `face_a`/`face_b` трубы — обе
  противоположные стенки. Это учитывается в независимом расчёте объёма.
- До SOLIDWORKS отклоняются пазы за границей детали, пазы без прямого участка,
  пересечения пазов друг с другом и пересечения с круглыми отверстиями.
- После построения проверяются объём, одно твёрдое тело и цилиндрические
  поверхности всех полукруглых концов пазов.
- Живой контроль: `CREATE_TEST_PROFILE_PARTS_2_5.cmd` создаёт три новые детали:
  квадратную трубу с отверстиями, круглую трубу и квадратную трубу с пазами.
- Пока не поддержаны косые торцы, торцевые фаски и боковые вырезы круглой трубы.

## Что добавлено в 2.4.0

- `ProfilePartPlan` v2 расширяет построение деталей по размерам из PDF:
  кроме равнополочного уголка поддержаны `rectangular_tube` и `round_tube`.
- Прямоугольная/квадратная труба задаётся шириной, высотой и толщиной стенки.
  Допускаются либо острые углы, либо явно указанные радиусы постоянной стенки:
  `inner_corner_radius_mm = outer_corner_radius_mm - wall_thickness_mm`.
- Для прямоугольной трубы отверстия на `face_a` или `face_b` выполняются
  сразу через две противоположные стенки. В аналитическом объёме и проверке
  цилиндрических граней учитываются обе стенки.
- Круглая труба задаётся наружным диаметром и толщиной стенки; внутренний
  диаметр и объём рассчитываются и проверяются коннектором.
- Plan v1 уголка полностью сохранён. Новые типы требуют `plan_version: "2"`.
- В 2.4.0 ещё не поддерживались пазы; они добавлены в Plan v3 версии 2.5.0.

## Что добавлено в 2.2.2

- Объединены наш контурный движок 2.1 и полезные изменения из архива Claude.
- Prismatic Plan v6 поддерживает выборочные фаски и истинные радиусные
  скругления на выпуклых вершинах многоугольного наружного профиля.
- Добавлен `CREATE_TEST_POLYGON_CORNERS.cmd` для живой проверки Plan v6.
- Добавлен необязательный файловый `ClaudeBridge` 1.1. Он не обходит защиту
  коннектора и не содержит активного запроса на создание модели.

- Новый `sw_create_sheet_from_contours` строит одну новую плоскую деталь
  постоянной толщины по строгому замкнутому контуру из настоящих отрезков и дуг.
- Поддержаны внутренние фигурные вырезы, отдельные отверстия и линейные массивы.
- До создания проверяются связность, замкнутость, самопересечения, вложенность и
  наложения; после создания — объём, одно твёрдое тело и цилиндрическая B-rep
  топология дуг и отверстий.
- Плоская схема по-прежнему отклоняет уголки, трубы, профили и гнутые детали:
  для уголка и труб теперь используется отдельный `ProfilePartPlan`.
- `CREATE_TEST_SHEET_CONTOUR.cmd` — живой тест нового класса геометрии.
- `PROMPT_PDF_TO_SOLIDWORKS_RU.txt` — готовый запрос для Codex, который сначала
  читает и классифицирует PDF, а потом создаёт модель только при полной
  определённости размеров.

- Исправлено расхождение между `sw_parameters` и `sw_features`: обе команды
  теперь используют один и тот же список размеров модели.
- Живой тест после создания повторно открывает именно созданную SLDPRT по
  возвращённому полному пути, поэтому не зависит от активного окна SOLIDWORKS.

- `sw_features` читает дерево элементов активной SLDPRT: точное имя, тип API,
  подавление и непосредственно принадлежащие элементу размеры.
- `sw_set_feature_dimensions` меняет до 16 линейных управляющих размеров одного
  точно выбранного элемента `Extrusion`, `Boss`, `Cut`, `HoleWzd`, `Chamfer` или `Fillet`.
- Перед изменением создаётся проверенная резервная копия. После изменения
  проверяются точное имя и тип элемента, отсутствие подавления, значения всех
  размеров, перестроение, количество твёрдых тел, объём и сохранение.
- Эскизы, угловые размеры, справочные размеры, подавленные элементы,
  неподдерживаемые типы и неоднозначные имена изменять запрещено.
- Добавлен живой тест `CREATE_TEST_FEATURE_EDIT.cmd`: он создаёт тестовую
  пластину и через дерево элемента меняет толщину вытягивания с 6 до 9 мм.

Сохранены исправления 1.8.2: SHA-256 открытого SLDPRT читается с совместным
доступом, даже когда файл удерживается SOLIDWORKS.

- Существующие SLDPRT и SLDDRW теперь можно изменять не только в Workspace, но
  и на любом готовом локальном фиксированном диске компьютера: `C:`, `D:`, `E:`
  и т. п.
- Добавлен `sw_open_local_file`: Codex может сам открыть SLDPRT или SLDDRW по
  точному абсолютному локальному пути.
- UNC-пути, подключённые сетевые диски, съёмные/оптические/RAM-диски,
  символические ссылки и переходы жёстко блокируются. Если установленный PDM API
  распознаёт путь как локальное представление хранилища, этот путь также блокируется.
- Перед сохранением грязного документа, изменением свойств или изменением
  `AI_*` создаётся проверенная SHA-256 резервная копия рядом с исходным файлом.
- `sw_create_parameter_variant`, `sw_create_drawing` и
  `sw_export_workspace_pdf` создают уникальные файлы рядом с локальным
  источником. Исходный файл проверяется по SHA-256 до и после операций, которые
  не должны его менять.
- Новые детали по Plan v1-v6, Contour Plan v1 и токарным Plan v2/v3 создаются в
  защищённой Workspace. Произвольные макросы и COM-команды не разрешены.
- Добавлен живой тест `CREATE_TEST_LOCAL_DISK_EDIT.cmd`, который проверяет весь
  новый путь вне Workspace на локальном диске.

## Что добавлено в 1.7.0

- Добавлен `sw_create_parameter_variant`: Codex сам открывает указанную исходную
  SLDPRT из Workspace, проверяет точные текущие значения `AI_*` и создаёт рядом
  новую деталь с уникальным именем.
- Исходная деталь не изменяется и не сохраняется. Новые размеры применяются
  только к созданному варианту; SHA-256 исходного файла проверяется до и после.
- В скопированной детали параметры находятся заново по уникальным именам
  `AI_*`; старые полные имена из исходного документа не используются вслепую.
- Вариант сохраняется только после одного перестроения, проверки всех новых
  значений, одного твёрдого тела и положительного объёма. При ошибке
  незавершённый вариант закрывается и удаляется.
- Контрольный тест теперь создаёт исходную пластину 120×80×6, затем отдельный
  вариант 140×90×8 и строит чертёж именно для варианта.

## Что исправлено в 1.6.1

- Исправлен живой вызов `IModelDoc2.Parameter`: SOLIDWORKS 2026 предоставляет
  его как метод API, а не как индексируемое свойство .NET.
- Устранена ошибка `API_PROPERTY_MISSING: IModelDoc2.Parameter` при выполнении
  `sw_set_parameter` и `sw_set_parameters`.

## Что добавлено в 1.6

- Добавлен `sw_set_parameters`: Codex может изменить за один вызов от одного до
  шестнадцати управляющих размеров `AI_*`.
- Для всей группы создаётся одна резервная копия SLDPRT, значения проверяются до
  изменения, затем выполняется одно перестроение и одна итоговая проверка.
- При любой ошибке коннектор пытается вернуть все исходные значения в активной
  модели; резервная копия остаётся в Workspace.
- Контрольный тест явно повторно активирует созданную деталь. Ранее открытый
  чертёж больше не должен становиться случайной целью команды изменения.
- Сообщение об ошибке теста теперь содержит точные `code` и `message` в последней
  строке, а не только общее `Connector worker failed`.
- Одиночное изменение через `sw_set_parameter`, аудит SLDDRW и экспорт PDF
  сохранены.
- Допуски, технические требования и отсутствующие размеры по-прежнему не
  додумываются.

Версия 2.2.2 сохраняет защищённую локальную рабочую папку
`%LOCALAPPDATA%\SolidWorksCodex\Workspace` для создания новых моделей. Кроме
того, она разрешает проверяемые изменения уже сохранённых SLDPRT и SLDDRW на
обычном локальном фиксированном диске. Сеть и съёмные диски не разрешены.

Призматические Plan v1-v6, Contour Plan v1 и токарные Plan v2/v3 сохранены. Plan v5 собирает
фасонные выступы из простых объединяемых областей и проверяет объём, одно
цельное тело и аналитические цилиндрические поверхности. Plan v6 добавляет
обработку отдельных выпуклых вершин многоугольника. Произвольные макросы,
команды оболочки, COM-вызовы, сетевые пути, сборки и PDM не разрешены.

**ВНИМАНИЕ. Комплект предназначен только для локального пилота. Не устанавливать
его на сервер, PDM-сервер или производственную рабочую станцию без отдельного
решения ответственного специалиста. Любая модель и любой чертёж требуют проверки
конструктором до изготовления.**

## Быстрая установка

1. Сохраните архив на рабочий стол или в «Загрузки» на диске C и выберите «Извлечь всё». Другой диск не требуется.
2. Запустите `INSTALL.cmd` двойным щелчком. Он сам закроет Codex/ChatGPT и их служебные процессы; повторно запускать установщик не потребуется. Права администратора не нужны.
3. Установщик скопирует рабочие файлы в `%LOCALAPPDATA%\SolidWorksCodex`, сохранит резервную копию `%USERPROFILE%\.codex\config.toml` и добавит сервер `solidworks-local`.
4. Запустите один SOLIDWORKS 2026 от того же пользователя, откройте небольшую сохранённую деталь и запустите установленный `CHECK.cmd`.
5. Запустите `CREATE_TEST_SHEET_CONTOUR.cmd`: он проверит истинные дуги, внутренний контур, массив отверстий, объём и топологию.
6. При необходимости запустите `CREATE_TEST_WORKSPACE_DRAWING.cmd`: он проверит безопасный вариант внутри Workspace.
7. При необходимости запустите `CREATE_TEST_LOCAL_DISK_EDIT.cmd`: он проверит открытие, резервную копию, изменение детали, свойства, чертёж и PDF вне Workspace, но на локальном диске.
8. Запустите Codex заново и проверьте `/mcp`: сервер `solidworks-local` должен быть включён.

Установщик не требует STEP-файл для теста. Нужна работающая SOLIDWORKS 2026 с
доступными шаблонами детали `*.prtdot` и чертежа `*.drwdot`. Если шаблоны по
умолчанию не настроены, коннектор ищет установленные шаблоны автоматически.

Если Codex после установки не открывает новые чаты, полностью закройте его и
пришлите `%LOCALAPPDATA%\SolidWorksCodex\Reports\mcp_transport.log` и текст окна
`CHECK.cmd`. Не запускайте несколько экземпляров коннектора вручную.

Целевая среда: Windows 11/10 x64, SOLIDWORKS 2026 SP03.2, Codex desktop.
Поставляемый `SolidWorksLocal.exe` собран под .NET Framework 4.8; Python, Node.js,
Visual Studio и .NET SDK для обычного запуска не требуются.

## Проверка подключения

Откройте SOLIDWORKS и оставьте одну небольшую тестовую деталь активной. Запустите
`CHECK.cmd` из установленной папки. Успешное окно содержит две строки:

```text
PASS: ... offline protocol assertions. Live SOLIDWORKS COM is NOT tested by this command.
PASS: connection and active document read successfully.
```

Первая строка проверяет протокол без CAD. Вторая подтверждает живое подключение,
загрузку SOLIDWORKS Interop и чтение активного документа. В `Reports` создаётся
новый JSON; исходная модель не изменяется.

## Запрос в Codex для чтения детали

```text
Используй solidworks-local. Сначала вызови sw_status, затем sw_document,
sw_properties и sw_part. Покажи имя файла, конфигурацию, материал, массу в кг,
объём, приблизительные габариты в мм и пользовательские свойства. Для каждого
значения укажи статус VERIFIED, CALCULATED или UNKNOWN. Модель не изменяй.
```

## Безопасная работа с копией

Откройте сохранённую SLDPRT и попросите Codex:

```text
Используй solidworks-local. Вызови sw_status и sw_document. Исходный файл не
изменяй. Вызови sw_copy_active_to_workspace и покажи путь созданной копии.
Дальше работай только с активной копией в Workspace.
```

Чтобы изменить обозначение, наименование или назначить AISI 304:

```text
Убедись через sw_document, что активная сохранённая SLDPRT находится на локальном
фиксированном диске, connector_write_allowed=true и документ не имеет
несохранённых изменений. Затем вызови sw_set_workspace_properties: обозначение
TEST.001, наименование Контрольная деталь, материал AISI 304. Покажи путь
автоматической резервной копии и результат сохранения. Сетевые пути не используй.
```

Чтобы создать новую версию детали с другими размерами, не меняя исходник:

```text
Используй solidworks-local. Сначала вызови sw_document и sw_parameters. Ничего
не делай, если исходная деталь не находится на локальном фиксированном диске,
имеет несохранённые изменения или нужный размер не помечен
editable_by_connector=true. Покажи
текущие значения нужных AI_* размеров. После моего подтверждения вызови
sw_create_parameter_variant: для Workspace передай имя исходного SLDPRT без
пути, а для другого локального диска передай точный source_path из sw_document.
Для каждого размера передай точный full_name, текущий expected_current_mm и
новый new_value_mm. Исходную деталь не изменяй. Покажи путь нового варианта,
совпадение SHA-256 исходника и результат проверки.
```

`sw_set_parameter` и `sw_set_parameters` изменяют существующий локальный файл на
месте и создают резервную копию рядом. Используйте их только по явному
требованию; для обычной работы безопаснее `sw_create_parameter_variant`.

Чтобы создать чертёж-заготовку:

```text
Убедись через sw_document, что активна сохранённая SLDPRT на локальном
фиксированном диске и connector_write_allowed=true. Вызови sw_create_drawing с
projection=first_angle. Новый SLDDRW должен появиться рядом с деталью. Покажи
путь и число проверенных видов. Не утверждай, что чертёж готов к изготовлению.
```

Чтобы проверить активный чертёж и получить PDF:

```text
Используй solidworks-local. Вызови sw_document и sw_drawing. Если активный
SLDDRW чистый, находится на локальном фиксированном диске и аудит обнаружил связанные виды модели,
вызови sw_export_workspace_pdf. Покажи путь к PDF и результаты проверки.
Не утверждай, что чертёж готов к изготовлению.
```

Для сборки добавьте `sw_components`. Это перечень экземпляров, а не готовая
спецификация: выгружаются первые 50 компонентов, подавленные и облегчённые
компоненты отдельно не раскрываются.

## Инструменты

| Инструмент | Назначение |
|---|---|
| `sw_status` | Подключение, версия API, Interop и список разрешённых операций |
| `sw_workspace_status` | Путь и содержимое защищённой локальной Workspace |
| `sw_document` | Имя, путь, тип, конфигурация и признак несохранённых изменений |
| `sw_properties` | Свойства документа и активной конфигурации раздельно |
| `sw_part` | Материал, CAD-масса, объём, площадь и приблизительный габарит детали |
| `sw_parameters` | Размеры активной SLDPRT; точные имена и отметка изменяемых `AI_*` параметров |
| `sw_features` | Дерево элементов, их типы, подавление и непосредственно принадлежащие размеры |
| `sw_set_feature_dimensions` | Защищённое изменение линейных размеров одного точного элемента с резервной копией |
| `sw_set_global_variable` | Замена числового значения одного размера новой именованной глобальной переменной (IEquationMgr), а не просто новым числом |
| `sw_components` | Страницы компонентов верхнего уровня сборки |
| `sw_drawing` | Листы, связанные виды, модели и число отображаемых размеров активного SLDDRW |
| `sw_export_snapshot` | Новый JSON-снимок текущего документа в папке `Reports` |
| `sw_copy_active_to_workspace` | Копия чистой активной SLDPRT в Workspace и её открытие |
| `sw_open_workspace_file` | Открытие SLDPRT или SLDDRW по одному имени файла в Workspace |
| `sw_open_local_file` | Открытие SLDPRT или SLDDRW по полному пути только на локальном фиксированном диске |
| `sw_save_workspace_document` | Сохранение активной локальной SLDPRT/SLDDRW с резервной копией; старое имя команды сохранено для совместимости |
| `sw_set_workspace_properties` | Обозначение, наименование и AISI 304 для локальной SLDPRT с резервной копией |
| `sw_set_parameter` | Изменение одного локального `AI_*` с резервной копией и проверкой |
| `sw_set_parameters` | Групповое изменение 1–16 локальных `AI_*` с одной копией и одним перестроением |
| `sw_create_parameter_variant` | Новая уникальная SLDPRT рядом с локальным источником; исходник остаётся неизменным |
| `sw_create_plate` | Новая тестовая пластина 100×60×5 с четырьмя D8 |
| `sw_create_part_from_plan` | Новая призматическая деталь по Plan v1-v6 с пооперационной проверкой геометрии |
| `sw_create_turned_part_from_plan` | Новая токарная деталь по Plan v2 или v3 |
| `sw_create_drawing` | Новый уникальный SLDDRW рядом с активной локальной деталью |
| `sw_export_workspace_pdf` | Новый проверенный PDF рядом с активным локальным SLDDRW; старое имя команды сохранено для совместимости |

Через MCP доступны только эти двадцать пять имён. Полный путь принимается только
командой `sw_open_local_file` и локальным режимом `sw_create_parameter_variant`;
он обязательно проверяется как путь на фиксированном диске. Нельзя передавать
скрипты, макросы, COM-методы или команды оболочки.

## Что создаёт Plan v1

`sw_create_part_from_plan` принимает числовой план с одним внешним прямоугольным,
круглым или простым многоугольным контуром, толщиной и максимум 32 круглыми
сквозными отверстиями. Коннектор проверяет диапазоны, замкнутость,
самопересечения, пересечения отверстий, объём CAD и цилиндрические поверхности
B-rep до сохранения. Для круглого наружного профиля подтверждается его точный
радиус; для каждого отверстия — наличие точной цилиндрической поверхности.

При успехе результат содержит `verification.topology.status=PASS`, список
`verification.topology.actual_diameters_mm` и для круглой детали
`verification.topology.outer_circle.analytic_cylindrical_surface_confirmed=true`.
При несовпадении возвращается `GEOMETRY_TOPOLOGY_MISMATCH`, а файл не
сохраняется.

Карманы, глухие пазы, резьба, материал, произвольные фаски и скругления в Plan v1
не поддерживаются.

## Что добавляет призматический Plan v2

Plan v2 принимает те же внешние профили и явные отверстия, а также один
равномерный круговой ряд:

```json
{
  "plan_version": "2",
  "outer_profile": { "type": "circle", "diameter_mm": 220 },
  "thickness_mm": 3,
  "circular_hole_pattern": {
    "pitch_circle_diameter_mm": 178,
    "hole_diameter_mm": 17,
    "hole_count": 3,
    "start_angle_deg": 90
  },
  "properties": {
    "designation": "25.SHT.G.00.00.00.05",
    "name": "Фланец наружний"
  },
  "material": "AISI 304"
}
```

Угол считается против часовой стрелки от оси `+X`; `90` ставит первое отверстие
сверху. Для примера коннектор получает центры `(0; 89)`,
`(-77,076260937; -44,5)` и `(77,076260937; -44,5)` мм. Он проверяет, что все
отверстия помещаются в контур и не пересекаются, затем проверяет итоговый объём,
один цилиндр Ø220 и три цилиндра Ø17.

Материал в этой версии ограничен значением `AISI 304`. Коннектор назначает его
через API SOLIDWORKS и сразу читает обратно; без подтверждения файл не
сохраняется. В активную конфигурацию нового файла записываются `Обозначение`,
`Наименование` и свойства `AI_*` с исходными параметрами. Эти свойства позволяют
проверить, по каким числам построена деталь; они не означают, что эскиз полностью
определён управляющими размерами.

`CREATE_TEST_PARAMETRIC_FLANGE.cmd` проверяет весь этот путь автоматически.

## Что добавляет призматический Plan v3

Plan v3 сохраняет все возможности v2 и принимает три списка дополнительных
вырезов:

```json
{
  "plan_version": "3",
  "outer_profile": { "type": "rectangle", "width_mm": 160, "height_mm": 100 },
  "thickness_mm": 12,
  "rectangular_pockets": [
    { "x_mm": -45, "y_mm": 22, "width_mm": 36, "height_mm": 22, "depth_mm": 4 }
  ],
  "circular_pockets": [
    { "x_mm": 45, "y_mm": 22, "diameter_mm": 24, "depth_mm": 6 }
  ],
  "straight_slots": [
    { "x1_mm": -25, "y1_mm": -25, "x2_mm": 25, "y2_mm": -25,
      "width_mm": 12, "cut_type": "through" }
  ],
  "properties": {
    "designation": "AI.TEST.070",
    "name": "Контрольная плита с карманами"
  },
  "material": "AISI 304"
}
```

`x_mm/y_mm` у кармана задают его центр. У паза две точки задают центры
полукруглых торцов, `width_mm` — полную ширину. Для `cut_type=blind` требуется
`depth_mm`; для `through` глубина не передаётся. Все вырезы выполняются с той
стороны базовой плоскости, от которой вытянуто тело.

В одном плане разрешено до восьми вырезов каждого вида и до шестнадцати всего.
Сейчас они должны находиться на прямоугольной или круглой основе, полностью
помещаться внутри и не пересекаться между собой или со сквозными отверстиями.
Коннектор сверяет снятый объём после каждого выреза с аналитическим расчётом с
допуском 0,1%. Затем он отдельно сверяет итоговый объём и цилиндрические стенки
круглого кармана и торцов паза. При расхождении новый файл не сохраняется.

`CREATE_TEST_POCKETS_SLOTS.cmd` проверяет Plan v3 на плите 160×100×12 мм:
прямоугольный карман 36×22 глубиной 4 мм, круглый карман Ø24 глубиной 6 мм и
сквозной прямой паз длиной между центрами 50 мм, шириной 12 мм.

## Что добавляет призматический Plan v4

Plan v4 сохраняет отверстия, свойства, материал, карманы и пазы предыдущих
версий и добавляет два списка выступов:

```json
{
  "plan_version": "4",
  "outer_profile": { "type": "rectangle", "width_mm": 180, "height_mm": 110 },
  "thickness_mm": 12,
  "rectangular_bosses": [
    { "x_mm": 45, "y_mm": 25, "width_mm": 46, "height_mm": 24,
      "extrusion_mm": 10 }
  ],
  "circular_bosses": [
    { "x_mm": -50, "y_mm": 25, "diameter_mm": 36,
      "extrusion_mm": 18 }
  ]
}
```

`x_mm/y_mm` задают центр выступа, `extrusion_mm` — его высоту наружу от
базовой плоскости. В одном плане разрешено до восьми выступов каждого вида и до
двенадцати всего. Сейчас выступы одноуровневые: каждый начинается на поверхности
основы, полностью находится внутри неё и не пересекается с отверстиями,
карманами, пазами или другим выступом. Вложенные и установленные друг на друга
выступы пока запрещены, чтобы объём и слияние тел проверялись однозначно.

Коннектор сверяет объём после каждого выступа с аналитическим расчётом с
допуском 0,1%, затем проверяет общий объём после всех выступов. Перед сохранением
он требует ровно одно твёрдое тело и подтверждает цилиндрическую стенку каждого
круглого выступа.

`CREATE_TEST_STEPPED_PART.cmd` создаёт основу 180×110×12 мм, прямоугольный
выступ 46×24×10, круглый выступ Ø36×18, два глухих кармана и один сквозной паз.
Это единый контроль совместной работы Plan v3 и Plan v4.

## Что добавляет призматический Plan v5

Plan v5 сохраняет все возможности v4 и разрешает задать обработку четырёх
вертикальных углов прямоугольного выступа:

```json
{
  "plan_version": "5",
  "outer_profile": { "type": "rectangle", "width_mm": 200, "height_mm": 120 },
  "thickness_mm": 12,
  "rectangular_bosses": [
    { "x_mm": -55, "y_mm": 25, "width_mm": 54, "height_mm": 34,
      "extrusion_mm": 12, "corner_style": "chamfer", "corner_size_mm": 5 },
    { "x_mm": 55, "y_mm": 25, "width_mm": 54, "height_mm": 34,
      "extrusion_mm": 16, "corner_style": "round", "corner_size_mm": 7 }
  ]
}
```

`corner_style=chamfer` задаёт четыре одинаковых прямых фаски в плане;
`corner_style=round` — четыре точные дуги заданного радиуса. `corner_size_mm` —
длина катета фаски либо радиус скругления. Размер должен быть меньше половины
меньшей стороны выступа. Это обработка вертикальных углов профиля, а не скос
верхней кромки. Верхние и нижние кромки, произвольный выбор рёбер и разные
размеры четырёх углов пока не поддерживаются.

`CREATE_TEST_FINISHED_BOSSES.cmd` создаёт основу 200×120×12 мм, левый выступ
54×34×12 с четырьмя фасками 5 мм, правый выступ 54×34×16 со скруглениями R7,
глухой карман Ø20 и сквозной паз шириной 10 мм.

## Что создаёт токарный Plan v2

Plan v2 сохраняет прежнюю совместимость и принимает:

- монотонный внешний профиль `x_mm + diameter_mm`;
- необязательный глухой ступенчатый осевой канал, открытый с правого торца;
- до 16 радиальных сквозных отверстий;
- до 8 поперечных плоских выборок;
- необязательный контрольный объём `reference_volume_mm3`.

Профиль сначала проверяется аналитически, затем создаётся тело вращения и
выполняются вырезы. Эталонный объём допускает расхождение не более 0,05%.

## Что добавляет токарный Plan v3

Plan v3 сохраняет все поля v2 и обязательно содержит один объект `spline_zone`:

```json
{
  "start_x_mm": 197,
  "tip_end_x_mm": 384,
  "end_x_mm": 390,
  "root_diameter_mm": 180,
  "tip_diameter_mm": 192,
  "tooth_count": 12,
  "tooth_width_mm": 25,
  "phase_angle_deg": 0
}
```

Зона задаёт прямые продольные зубья: постоянный наружный диаметр до
`tip_end_x_mm`, затем осевое сужение к корневому диаметру до `end_x_mm`.
Ширина зуба тангенциальная, число зубьев — от 2 до 64. Коннектор создаёт
внешний профиль вращением и вырезает валидированные продольные канавки.

Дополнительно можно передать только безопасные текстовые свойства новой детали:

```json
"properties": {
  "designation": "WRM.02.02.00.003",
  "name": "Конец вала"
}
```

Они записываются только в активную конфигурацию **нового** файла. Материал,
резьба, посадки, допуски, шероховатость и произвольные операции выбора граней
Plan v3 пока не задаёт.

### Контрольный пример из STEP

`CREATE_TEST_SHAFT_END.cmd` создаёт новую деталь по числовому описанию
`WRM.02.02.00.003 «Конец вала»`:

- длина 560 мм, максимальный диаметр 200 мм;
- ступени и фаски внешнего профиля;
- внешняя шлицевая зона 12 зубьев, Ø192/Ø180, x=197…390 мм;
- осевой профиль шлицев с переходом к корню;
- свойства `Обозначение=WRM.02.02.00.003`, `Наименование=Конец вала`;
- контрольный объём STEP `13 312 804,6798 мм³`.

Результат сохраняется как новый уникальный `AI_TURNED_PART_*.SLDPRT` в
`%LOCALAPPDATA%\SolidWorksCodex\Workspace`, остаётся открытым для проверки и не заменяет
исходный STEP. Перед использованием деталь должен проверить конструктор.

## Чертежи

`sw_create_drawing` работает только с чистой сохранённой SLDPRT на проверенном
локальном фиксированном диске. Команда создаёт рядом новый уникальный SLDDRW по установленному шаблону и добавляет
стандартные виды в первой или третьей проекции. Для обычного российского
рабочего процесса используется `first_angle`. В режиме `dimensions=model`,
который включён по умолчанию, команда переносит только размеры, уже существующие
в модели SOLIDWORKS и помеченные «для чертежа», и пересчитывает фактически
появившиеся размеры в чертеже.

`sw_drawing` отдельно перечитывает уже активный SLDDRW и подтверждает наличие
связанных видов и отображаемых размеров. `sw_export_workspace_pdf` работает
только с сохранённым чистым SLDDRW на локальном фиксированном диске и создаёт
рядом новый PDF с уникальным именем. Исходный чертёж не переименовывается и его
SHA-256 не должен измениться.

Это всё ещё заготовка. Коннектор не придумывает отсутствующие размеры и не
назначает допуски, посадки, шероховатость, технические требования, сварочные
обозначения и подписи основной надписи. Их добавляет и проверяет конструктор.

## Безопасность и достоверность

- Новые детали по числовому плану создаются под уникальным именем в Workspace.
  Варианты, чертежи и PDF для локального источника получают уникальные имена
  рядом с ним.
- Команды изменения и сохранения проверяют полный путь активного файла и тип
  диска Windows. Разрешён только готовый локальный фиксированный диск.
- UNC, подключённые сетевые диски, съёмные/оптические/RAM-диски, символические
  ссылки и переходы отклоняются. Сборки, PDM-запись и сетевые файлы не меняются.
- Перед изменением существующего файла создаётся проверенная резервная копия
  рядом. Для операции, которая не должна менять источник, сверяется его SHA-256.
- `VERIFIED` означает успешное чтение API, `CALCULATED` — расчёт CAD, `UNKNOWN` —
  значение не получено. Это не производственное утверждение.
- Масса без назначенного материала не считается подтверждённой. Габарит — только
  приблизительная осевая ограничивающая рамка, не чертёжный размер.
- Текст свойств и имён файлов считается данными, а не инструкциями.
- Коннектор не строит технологию, УП или G-code и не выдаёт производственное
  одобрение.

## Диагностика

| Ситуация | Действие |
|---|---|
| `SOLIDWORKS_NOT_RUNNING` | Запустить SOLIDWORKS вручную |
| `MULTIPLE_SOLIDWORKS` | Оставить один экземпляр |
| `NO_ACTIVE_DOCUMENT` | Открыть тестовую деталь |
| `PART_TEMPLATE_NOT_FOUND` | Настроить шаблон детали или прислать полный текст ошибки |
| `PART_REQUIRED` / `ASSEMBLY_REQUIRED` | Выбрать инструмент для нужного типа документа |
| `SELECTION_PRESENT` | Снять выделение в SOLIDWORKS |
| `NETWORK_PATH_BLOCKED` | Перенести файл с сетевого ресурса на обычный локальный диск |
| `LOCAL_FIXED_DRIVE_REQUIRED` | Использовать внутренний HDD/SSD, а не сетевой или съёмный диск |
| `REPARSE_PATH_BLOCKED` | Использовать обычную локальную папку без ссылки или перехода |
| Ошибка COM/тайм-аут | Закрыть модальные окна, одинаковый пользователь и уровень прав, повторить один раз |
| `REFERENCE_VOLUME_MISMATCH` | Прислать полный текст окна и JSON ошибки; файл не считается проверенным |
| `GEOMETRY_TOPOLOGY_MISMATCH` | Прислать полный текст окна; коннектор сам отменил сохранение неверной геометрии |
| `BOSS_FAILED` / `BOSS_VERIFICATION_FAILED` | Прислать полный текст окна; неверный выступ не сохраняется |
| `MATERIAL_ASSIGNMENT_FAILED` | Прислать полный текст окна; файл без подтверждённого материала не сохранён |

При сбое `CREATE_TEST_FINISHED_BOSSES.cmd` пришлите скриншот и полный текст окна.
Не повторяйте создание много раз подряд, пока не разобрана первая ошибка.

## Разработка и тесты

Главный новый живой тест версии 2.2.2 — `CREATE_TEST_SHEET_CONTOUR.cmd`. Он
создаёт листовую деталь с истинными дугами, внутренним фигурным вырезом и линейным
массивом отверстий, затем проверяет объём и B-rep топологию. Подтверждённый тест
`CREATE_TEST_GROUPED_PARAMETERS.cmd` сохранён: он меняет 15 управляющих параметров,
проверяет резервную копию, габариты, объём, чертёж и PDF.

Исходники находятся в `src`. `BUILD.cmd` пересобирает Windows x64 EXE и запускает
офлайн-тесты. Перед сборкой закройте подключение коннектора в Codex.

В версии 2.2.2 проверено 208 офлайн-утверждений и реальный STDIO-процесс: двадцать пять
схемы инструментов, проверка фиксированного локального диска, отказ UNC и
сетевым/съёмным дискам, открытие локального файла, создание параметрического варианта,
одиночная и групповая схема изменения `AI_*`, аудит
чертежа, проверка PDF-сигнатуры, ограничения локальных путей и Workspace,
призматические Plan v1-v6, Contour Plan v1, токарные Plan v2/v3 со шлицами,
точные площади фасонных выступов, карманы и пазы, строгие правила пересечений,
безопасные свойства, ограничение материала, проверка полного набора радиусов
аналитических цилиндров, отказ от путей/лишних полей и восстановление после
плохого JSON. Живой путь контурных линий и дуг должен быть подтверждён запуском
`CREATE_TEST_SHEET_CONTOUR.cmd` на целевом компьютере.

Исправление 2.2.2: размеры `AI_*`, которые SOLIDWORKS перестаёт перечислять через
`IFeature.GetFirstDisplayDimension` после сохранения и повторного открытия, дополнительно
читаются напрямую через `IFeature.Parameter`. Учтено, что после переименования
`AI_Thickness` внутренний ключ Boss может остаться `D1`; проверяется ограниченный набор
`D1`–`D16`. Изменение по-прежнему разрешается только
после точного совпадения полного имени размера, владельца-элемента, текущего значения,
типа размера и состояния Driving/ReadOnly.

По живому отчёту SOLIDWORKS 2026 обычный Boss имеет API-тип `Extrusion`, а
`IDimension.GetType` возвращает `swDimensionTypeUnknown` даже для созданных коннектором
линейных размеров. Поэтому `Extrusion` включён в разрешённые типы, а линейность
`AI_Thickness`, `AI_Length`, `AI_Width` и размеров отверстий подтверждается их известной
схемой создания; произвольные неизвестные размеры линейными не считаются.

Если живой тест изменения элемента не находит глубину Boss, версия 2.2.2 сохраняет
`%LOCALAPPDATA%\SolidWorksCodex\Reports\feature_edit_diagnostic_*.json`. Отчёт содержит
точное имя созданного размера, ожидаемый элемент, полный ответ `sw_features` и результаты
диагностических запросов `IFeature.Parameter("D1")`/`("AI_Thickness")` и
`IModelDoc2.Parameter("D1@элемент")`/`("AI_Thickness@элемент")`.

Производственная готовность не заявляется: созданную деталь требуется открыть и
проверить в SOLIDWORKS человеком.
