hisp2k/parameters/containers/deliverables/0_22/README.txt

КМ.022 — открытый контейнер для мусора с сужением к днищу
Дата: 30.09.2026

Исходные требования
  Наружные габариты корпуса: 600 × 600 × 620 мм (Д × Ш × В).
  Высота 620 мм не включает колеса.
  Материал металлических деталей: 09Г2С.
  Два неповоротных и два поворотных колеса.
  Номинальная емкость: 0,22 м³.

Принятые параметры
  Верх корпуса: 600 × 600 мм; низ: 590 × 590 мм.
  Корпус и днище: лист 1,5 мм. Пластины колес: лист 4 мм.
  Колеса: Ø125 мм, ширина в модели 35 мм, показаны упрощенно.
  Монтажные пластины: 100 × 100 × 4 мм, 4 отверстия Ø11 мм
  с шагом 70 × 70 мм. Перед изготовлением сверить с фланцем
  выбранной модели колес.
  Расчетный внутренний геометрический объем: 0,2168 м³.
  Обозначение 0,22 м³ является номинальным округлением.

Состав комплекта
  bin_022m3.SLDASM — сборка SolidWorks 2026.
  bin_022_body.SLDPRT — корпус.
  wheel_fixed_D125.SLDPRT — упрощенное неповоротное колесо.
  wheel_swivel_D125.SLDPRT — упрощенное поворотное колесо.
  mount_plate_100x100x4.SLDPRT — пластина крепления.
  *.SLDDRW — три редактируемых чертежа SolidWorks с видами.
  Комплект_чертежей_КМ022_ЕСКД.pdf — семь размерных листов А3:
    сборка, корпус, две стенки, днище, пластина, состав изделия.
  01_front_back_t1p5.dxf — передняя и задняя стенка, по 2 шт.
  02_left_right_t1p5.dxf — левая и правая стенка, по 2 шт.
  03_bottom_t1p5.dxf — днище, 1 шт.
  04_wheel_mount_t4.dxf — пластина, 4 шт.
  nest_*.dxf — пример размещения на листе 1500 × 1000 мм.
  model_preview.png — изображение сборки.
  build_*.py — программы построения SolidWorks, PDF и DXF.

DXF
  Единицы — миллиметры. Слой CUT — контуры реза.
  В файлах размещения: SHEET — граница листа, INFO — надписи.
  Контуры не содержат припусков на сварку, компенсации ширины реза
  и технологических перемычек. Параметры станка задаются в CAM.

Статус
  Комплект предназначен для согласования и нормоконтроля.
  Тип колес, допустимая нагрузка, исполнение вилок, схема сварных
  швов и антикоррозионное покрытие уточняются перед производством.
  Модель колес упрощена, вилки и подшипники не моделировались.
