hisp2k/parameters/screw-conveyors/01-PT-SHT/deliverables/Шнек 1 — параметрическая модель/README.md

# Шнек 1 — параметрическая модель

Сохранена копия существующей сборки SolidWorks. Веб-панель управляет 18 геометрическими параметрами трубы, шнекового вала и двух балок опоры. Исходная папка на рабочем столе не изменена.

## Последняя проверка — 05.10.2026

Сохранена и проверена рабочая сборка: **длина 2510 мм, труба Ø133×4 мм, винт Ø121 мм, наклон 55° от горизонтали**. 204 компонента, 0 подавленных компонентов, 0 ошибок элементов и сопряжений, 0 объёмных пересечений более 0,001 мм³ в представлении с условной резьбой. Целевой угол проекта достигнут. Исходная CAD-переменная задаёт угол от вертикали; интерфейс записывает `90° − угол формы`.

Высота ушей и их седло зависят от диаметра трубы; ось верхнего патрубка, его базовая плоскость и профиль выреза — от длины и угла корпуса. Нижний шарнир опоры связан с углом корпуса. По указанию пользователя оба подкоса возвращены к исходной прямой полой трубе: операции обхода корпуса и местной выборки подавлены. Зеркальный подкос следует исходному; каждый имеет одно тело. Сопряжения со втулкой и ушами 3/4 сохранены. Геометрия проверена при 35° и 55°; полный диапазон параметров и прочность конструкции не подтверждены.

| Параметр | Проверенный цикл | Результат |
|---|---|---|
| Рабочая длина | 2510 → 2610 → 2510 мм | Ошибок и пересечений нет |
| Диаметр трубы | 133 → 141 → 133 мм | Ошибок и пересечений нет |
| Наклон | 55 → 35 → 55° | Ошибок и пересечений нет |

Испытание длины и диаметра, включая одновременное изменение до 2610 мм, Ø141 мм и 35°, проведено до возврата подкосов к прямой форме. После восстановления прямых подкосов повторно проверен угол 35° → 55° с сохранением всех пользовательских параметров. Сопоставлены 18 параметров операций и 55 связанных размеров. Отверстие Ø110 мм сохранено, деталь сбрасывателя отсутствует. M8 задаёт отверстия Ø8,8 мм. Длина вытягивания патрубка и его физический габарит проверяются отдельно.

Текущие протоколы: `straight_brace_restore_20261005.json`, `pin_joint_angle_test_20261005.json`, `parameter_correspondence_20261005.json`. Протоколы `brace_clearance_fix_20261005.json`, `brace_transition_fix_20261005.json`, `pin_joint_angle_test_before_straight_20261005.json` и `geometry_rebuild_latest.json` относятся к прежней форме подкосов с обходом. Подробности восстановления: [Прямые подкосы — восстановление 05.10.2026](Прямые%20подкосы%20—%20восстановление%2005.10.2026.md).

Результат кнопки **Применить к модели** показан постоянно: фактически сохранённые размеры, запрошенные размеры при отказе, ошибки операций или пересечения и результат проверенного отката. Сообщение сохраняется после обновления страницы. При недоступной кнопке рядом показана причина: пустое поле, несовместимые размеры или ограничение угла. Во время применения повторный запуск блокируется.

## Запуск

1. Запустите SolidWorks.
2. Дважды щёлкните `Запустить интерфейс.cmd` в этой папке. Нужен установленный Python с модулем `pywin32`.
3. Измените размеры в панели и нажмите **Применить к модели**.

## Выбор по ГОСТ

- **Труба:** небольшой набор размеров из сортамента электросварных прямошовных труб [ГОСТ 10704-91](https://protect.gost.ru/gost/details/9d92e82e-d057-436a-abd4-5a56a7e07e96). Выбор одновременно меняет наружный диаметр и толщину стенки.
- **Шаг винта:** пары диаметра и шага из таблицы 1 [ГОСТ 2037-82](https://files.stroyinf.ru/Data2/1/4294751/4294751811.pdf). Выбор одновременно меняет оба размера. Стандарт относится к наклонным конвейерам с углом до 20°; текущие 55° выходят за эту область. Поэтому совпадение размерной пары не является подтверждением соответствия всей машины ГОСТ.
- **Угол наклона:** отдельный блок «Угол наклона» содержит ручной ввод от горизонтали, включая дробные значения. Рядом постоянно показаны диапазон **0–20°** и ссылка на п. 1.1 ГОСТ 2037-82; подсказка меняется сразу при вводе. «По ГОСТ · 0–20°» блокирует применение значения выше 20°, а сервер независимо повторяет эту проверку перед обращением к SolidWorks. «Ручной ввод» для специального исполнения допускает угол от 0° до значения меньше 90° и предупреждает при превышении 20°; специальные конвейеры исключены из области применения этого ГОСТ. Пустое поле, отрицательные значения и угол 90° или больше блокируют применение в обоих режимах. Переключение режима сохраняет введённое число, схема и сводка параметров обновляются сразу. Режим и значение записываются в `state.json` после успешного применения; изменения отражаются в журнале. Проверка диапазона угла сама по себе не подтверждает соответствие изделия всему стандарту или возможность перестроения CAD. Фактический угол 55° теперь совпадает с целевым. Допустимый ввод не означает, что весь диапазон геометрии проверен. Проверка интерфейса: 19 вариантов, результаты в `ui_angle_check_20261005.json`.
- **Материал:** марки стали из [ГОСТ 5632-2014](https://protect.gost.ru/gost/details/d6ac3954-d07e-4a10-a038-f3ab9b1d5b7b). Выбранная марка сохраняется в `state.json` как проектная спецификация. Физический материал детали в SolidWorks пока не назначается: библиотека свойств и соответствие существующим материалам модели не проверены.

Исходные Ø141×5 трубы и Ø130/шаг 105 винта сохранены в архивных протоколах. Текущие пользовательские размеры — труба Ø133×4, винт Ø121/шаг 105 мм. Каталог намеренно ограничен типоразмерами, близкими к текущей модели. При ручном изменении размера соответствующий переключатель возвращается в режим «Свой размер». Сервер повторно проверяет выбранную позицию перед записью в CAD.

## Расчётный модуль

Для текущего проектного сценария сохранены: песок с очистных сооружений, 10 м³/ч, прерывный режим и целевой угол 55°; сохранённая CAD-сборка имеет 55° от горизонтали. В поле частоты установлен **190 об/мин как кандидат для испытаний**. Модуль теперь дополнительно показывает теоретический минимум частоты и долю фактической подачи, необходимую для достижения заявки. Текущий геометрический предел и требуемая доля фактической подачи рассчитываются в интерфейсе при изменении геометрии; фактическая подача не подтверждена. Решения по составу и ограничения приведены в соседнем каталоге `Шнек 1 — аудит производственного комплекта/06_Решения и проверка расчёта.md`.

Уточнение от 03.10.2026: крупность песка 0,2–2 мм, максимум 2 мм внесён в расчёт. Пользователь сообщил влажность 90% и периодические пуски; число пусков и возможность пуска с загруженным винтом пока не определены. Плотность и мощность из этих сведений не выводятся. Подробности — в `12_Исходные данные песка.md` соседнего каталога аудита.

Последующее уточнение: **вода составляет 90% общей массы смеси**. В разделе «Опросные данные для подбора привода» запрашиваются пуски в час, длительность включения, пуск с заполненным винтом и измеренная плотность смеси. Ответы сохраняются в `operation_questionnaire.json` и журнале, но пока не используются для автоматического назначения мотор-редуктора. Справочник сыпучих грузов и проверки ГОСТ 2037-82 не подтверждают работу с такой водной смесью при 55°.

Раздел **Расчёт и подбор** отправляет текущую геометрию и введённые данные в `POST /api/calculate`; расчёт выполняется серверным модулем `calculation.py`. Входные данные расчёта сохраняются в `calculation_inputs.json`. Модуль проверяет область применения [ГОСТ 2037-82](https://files.stroyinf.ru/Data2/1/4294751/4294751811.pdf), пару диаметра и шага (п. 2.1), ряд частот (п. 2.2), ряд заявленной подачи (п. 2.3), номинальный зазор (п. 3.5), а также ограничения по плотности, крупности и температуре груза. По массе и времени контрольного испытания определяет массовую подачу; объёмную подачу выводит только при наличии измеренной насыпной плотности (п. 7.4). Все результаты и проверки возвращаются с единицами измерения и ссылкой на пункт стандарта.

Справочник грузов содержит 27 позиций в группах «Зерно и семена», «Пищевые порошки и корма», «Минеральные и строительные», «Древесные и полимерные», «Химические продукты». Есть поиск и фильтр по группе. Диапазоны плотности, исходное обозначение крупности и отметка `V` перенесены из [KWS Screw Conveyor Bulk Material Table](https://www.kwsmfg.com/engineering-guides/screw-conveyor/bulk-material-table/). `V` означает возможность вертикальной подачи в справочнике, а не пригодность данной модели. Если отметки нет, программа сообщает именно об отсутствии отметки, не делая вывода о непригодности. Справочные величины не подставляются как свойства конкретной партии и не считаются требованиями ГОСТ. Для угла 55° данную модель следует рассматривать как специальное крутонаклонное исполнение: [KWS относит углы выше 45° к вертикальной схеме проектирования](https://www.kwsmfg.com/wp-content/uploads/Screw-Conveyor-Engineering-Guide.pdf). При этом ГОСТ 2037-82 допускает наклон до 20°.

Условный геометрический объём вычисляется из кольцевого сечения, шага и частоты вращения; он **не является прогнозом подачи** и не используется для выбора привода. Модуль не подставляет непроверенные коэффициенты заполнения, снижения подачи на наклоне, трения или КПД. Статус `BLOCK` показывает нарушения проверенных требований, `REQUIRED` — недостающие данные; итоговое соответствие всей машины стандарту не устанавливается автоматически. Расчёт не меняет CAD-файлы.

Панель работает только на `127.0.0.1`. Она записывает значения в связанные глобальные переменные и размеры операций SolidWorks, перестраивает изменённые узлы и общую сборку, проверяет реальные размеры, сопряжения и пересечения, затем сохраняет подсборки и детали. Неудачный вариант откатывается и проверяется повторно. Перед каждым изменением связанные CAD-файлы копируются в `snapshots/`.

Кнопка **Открыть CAD** открывает восстановленную общую сборку из `CAD_восстановленный/` через SolidWorks API и проверяет её состояние. Все ранее найденные ошибочные сопряжения исправлены. Последняя проверка от 05.10.2026: 204 компонента, без потерянных файлов, ошибок элементов и сопряжений, без объёмных пересечений более 0,001 мм³ в условном резьбовом представлении.

Раздел **Проверки модели** показывает последний сохранённый результат CAD и протокол изменения длины, диаметра и угла. Список узлов содержит архивный аудит от 04.10.2026; дата контрольной проверки указана отдельно. Это результаты сохранённых проверок, а не непрерывный контроль SolidWorks.

## Чертежи и журнал

В верхней части формы указано наименование проекта из `project.json`. Кнопка **Построить чертежи** создаёт три связанных с моделями файла `.SLDDRW`: общую сборку, трубу в сборе и шнековый вал. Для каждого файла SolidWorks строит три ортогональных вида в проекции первого угла на установленном шаблоне `gost-assly drw.drwdot`. Каждый запуск помещает новый набор в отдельную папку `Чертежи/` и не перезаписывает исходный чертёж в `CAD/`.

Это предварительные чертежи с автоматическими видами. Нанесение размеров, оформление основной надписи и проверка комплектности требуются перед выпуском. Программа отмечает набор как неполный при ошибках модели, включая ошибочные сопряжения.

Журнал в нижней части формы показывает наименование проекта, число применений модели, число изменённых полей и число построенных чертежей. Каждая успешная правка параметров сохраняется с прежним и новым значением в `journal.json`; создание чертежей записывается отдельным событием. Повторное применение тех же значений не увеличивает счётчик изменений. Журнал начинается с момента добавления этой функции; предыдущая история правок не восстановлена.

## Что управляется

Результаты проверки записи и ограничения описаны в [«Параметризации рабочих узлов»](Параметризация%20рабочих%20узлов.md).

- Общая рабочая длина трубы и вала, диаметр и стенка трубы, угол наклона.
- Схема на главном экране поворачивается сразу при вводе угла и показывает его значение у линии отсчёта. Это предварительный двумерный эскиз; изменение CAD происходит после нажатия «Применить к модели».
- На схеме указаны рабочая и полная длина, наружный диаметр корпуса, угол наклона, диаметр и количество входов и выходов. По уточнению пользователя нижний боковой патрубок — один вход, верхний боковой патрубок — один выход; оба выполнены одинаковой деталью «Патрубок шнека» с параметром диаметра входного патрубка. Стрелки показывают направление движения груза. В текущей CAD-сборке оси этих патрубков при наклоне 55° образуют с осью корпуса острый угол 35°; при вертикальных патрубках схема показывает угол `90° − наклон корпуса`. Два патрубка промывки не являются входами груза. Деталь «Сбрасыватель» удалена по указанию пользователя; отверстие Ø110 мм в корпусе сохранено. Прокручиваемая панель рядом со схемой повторяет все 18 геометрических параметров, выбранные позиции по стандартам, груз, исходные данные расчёта и ответы опроса. Значения обновляются по мере ввода; несохранённые изменения остаются только в форме до применения к модели или сохранения опроса.
- Диаметр, длина и стенка входного патрубка.
- Диаметр винта, шаг, толщина лопасти, диаметр и стенка вала, число витков.
- Толщина фланца, размер отверстия крепления, диаметр проёма сбрасывателя и его положение в подсборке трубы.
- Полные длины двух балок опоры: размеры вытягивания изменяются симметрично в обе стороны.

Полная длина трубы и вала в исходных уравнениях равна рабочей длине плюс 270 мм. Номинальный радиальный зазор в панели вычисляется как `(диаметр трубы − 2 × стенка трубы − диаметр винта) / 2`. Эти зависимости описывают исходную геометрию модели, а не расчётный норматив.

## Ограничение

Это геометрическая параметризация существующего осевого шнека. Производительность, прочность, привод, ресурс и соответствие нормативам не подтверждены. Автоматические чертежи не являются конструкторской документацией, готовой к выпуску. Перед производством нужно проверить полный диапазон параметров, рассчитать прямые подкосы и их соединения, проверить точные размеры и стандарты восстановленных деталей, провести расчёт привода и испытать подачу влажного песка при 55°.

## Нижний шарнир — 05.10.2026

Втулка №2 сопряжена с ушами 3/4; подкос соосен втулке. Нижняя ось опоры следует углу корпуса. Проверены 35° → 55° с восстановлением исходного задания; ошибки и пересечения отсутствуют. Подробности: [отчёт](Втулка%20и%20подкос%20—%20сопряжения%2005.10.2026.md).

## Стыки труб опоры — 05.10.2026

Оба прямых подкоса соединены со стойками. Шесть стыков труб проверяются по фактическим зазорам перед сохранением. Проверены 35° → 55°, повторное открытие сборки, 18 параметров и 57 связанных размеров. Ошибок и объёмных пересечений более 0,001 мм³ не выявлено. [Отчёт](Стыки%20труб%20опоры%20—%20восстановление%2005.10.2026.md).
