hisp2k/parameters/docs/import-2026-10-06/NOTES.md

# Охват переноса — 06.10.2026

Перенесены доступные на этом компьютере результаты работ по шнековым транспортёрам 01.PT.SHT и 25.SHT.G, плоской и желобчатой веткам ЛТ500, песколовкам, решёткам ГР и контейнерам. Добавлены связанные расчётные модули, исходный код SolidWorksCodex, калькуляторы, технические задания и промпты из локальных материалов.

Доступные исходные модели с рабочего стола сохранены отдельно от результатов параметризации. Файлы серии ГР находятся в `screens/original-GR-series`; принадлежность к 57.GR, 58.GR и 59.GR сохраняется в их исходных названиях. Они не считаются автоматически согласованными с BOM(6) изделия 58.GR. Ссылки Library и прежние исходные пути в исторических документах сохранены.

Все обычные импортированные файлы скопированы побайтно и проверены по SHA-256. Резервные снимки модели «Шнек 1», протоколы промежуточных исправлений и архивы ревизий сохранены. Информация в старых статусах может относиться к прежней версии: для стыков труб опоры «Шнека 1» последняя завершённая работа описана в документе `Стыки труб опоры — восстановление 05.10.2026.md` и протоколе `support_pipe_joint_saved_verification_20261005.json`. Запрос об исправлении патрубков в следующем ходе чата был прерван; перенос не означает завершения этой новой работы.

Восемь крупных ZIP/RAR сохранены частями по 16 МиБ после отказа GitHub принять крупные объекты. Их исходные имена, размеры и SHA-256 записаны в `large-files.json`; программа `tools/restore_large_files.py` восстанавливает и проверяет исходные архивы.

Не включены Python-кэш, файлы блокировок SolidWorks, временные файлы, установленные сторонние зависимости, локальная конфигурация TestScope и промежуточные бинарные эксперименты из папок `work`. Программы, текстовые протоколы и результаты из папок `outputs` перенесены. Причины исключения отдельных файлов указаны в `excluded.json`. Сохранены действующий `SolidWorksLocal.exe` и его конфигурация; коннектор также собирается из перенесённых исходников согласно `BUILD.cmd`. Старые резервные EXE и бинарные экспериментальные сборки не копировались.

Перенос охватывает найденные локальные файлы и сохранённые контексты. Полная история облачных разговоров ChatGPT не экспортировалась: при попытке её загрузки сервис вернул тайм-аут. Файлы, существующие только в облачной Library и отсутствующие локально, представлены прежними ссылками в документах. Поэтому реестр фиксирует проверяемый состав, а не утверждает наличие каждой облачной вложенной версии.

После переноса заново не выполнялись инженерные расчёты, перестроение сборок и CFD. Инженерные ограничения и статусы исходных проектов сохранены.
