hisp2k/parameters/screens/58-GR/ИНСТРУКЦИЯ_ДЛЯ_НОВОГО_ЧАТА.md

# Инструкция для следующего чата: выполнить проект 58.GR

Дата передачи: 02.10.2026. Изделие: решётка грабельная 58.GR, заказ №2410 — СМП.

## Команда исполнителю

Продолжи проект 58.GR по актуальным STEP КТ, STEP ТТ и BOM(6), используя документы этой папки. Сначала прочитай регламент версии 2.0 полностью, затем рабочий промпт STEP/BOM и модуль размеров, баз и сварки. Проверь открываемость исходников, их единицы, ревизии, конфигурации, структуру и соответствие BOM. Заполни паспорт задания и реестр обязательных документов. Выполняй полный производственный комплект по группам, сохраняй проверяемое состояние и переходи к следующей незавершённой операции. Не объявляй частичный пакет готовым к производству.

## Полный объём

1. Сверка модели, 3D-тел, структуры сборок, обозначений, материалов и количеств с BOM(6); фиксация расхождений и неизвестных данных.
2. Рабочие чертежи всех изготовляемых деталей и сборочные чертежи со спецификациями всех требуемых сборок.
3. Размерные схемы, реальные функциональные базы, разрезы и сечения, применимые допуски, посадки, шероховатости, адресные сварные соединения и контроль их полноты.
4. DXF для резки по материалам и толщинам; для гнутых деталей — фактические развёртки, DXF, чертежи и карты гибки.
5. Технологические маршруты, операции, оборудование, наладка и плановое время по каждой детали и сборке без двойного учёта.
6. Ведомости материалов, покупных изделий и расходников; перечень деталей без чертежей с основаниями.
7. Реестры элементов и размеров, баз, швов, обязательных документов, замечаний, проверок и открытых вопросов.
8. Проверенный на открываемость итоговый архив с манифестом, версиями и итоговой сводкой.

## Первые действия

1. Открой [реестр исходников](ИСХОДНИКИ_И_СТАТУС.md). Используй BOM из `Исходники/58.GR BOM(6).xlsx` и два STEP из Library. Архив RAR является дополнительным исходником; его ревизию и состав нужно проверить.
2. Не принимай исторические цифры и решения за свойства текущей модели. Сначала сопоставь КТ, ТТ, BOM(6) и архив; установи, что означают КТ и ТТ по содержимому или сопровождающим данным.
3. Зафиксируй состояние AS-IS как отдельный неизменяемый снимок с источником и датой. Храни отдельно требования TARGET, ограничения, нормативный профиль, расчёты, справочные покупные компоненты, производственные ограничения и проектную модель. Для неизвестного используй явный статус, не ноль.
4. Составь дерево сборки и матрицу сопоставления позиций. Для каждого расхождения укажи источник, влияние и требуемое решение. Сформируй счётчики документов: требуется / создано / проверено / блокировано / осталось.
5. Подтверди на рабочей копии операции CAD и их результат до массового выпуска. Если SolidWorks или импорт недоступны, продолжай независимую сверку BOM, реестры и анализ STEP; точно обозначай технический блокер.

## Контроль выпуска

- H12/f12 назначай только установленным сопряжениям решётки; k6 — только соответствующим шейкам валов под подшипники.
- Не переносить материалы, швы, геометрию и правила изделия 881 или других решёток на 58.GR.
- Развёртки включать. Расчёт K-фактора сам по себе не подтверждает SolidWorks Flat-Pattern и применимость к инструменту.
- Для сварки адресовать каждое соединение и сторону. Не считать любой контакт тел швом.
- Проверять DXF повторным открытием, а чертежи — визуально при масштабе печати.
- Не объявлять собственную проверку нормоконтролем предприятия и не имитировать подписи или разрешение к производству.

## Итоговый ответ по каждой группе

Укажи фактически созданные и проверенные файлы, исходники и ревизии, количество требуемых/созданных/проверенных/блокированных документов, незакрытые решения и первую следующую операцию. Если часть работы заблокирована, оставь остальную выполненную часть и реестр в репозитории с ясным статусом.
