hisp2k/parameters/screens/58-GR/ИСХОДНИКИ_И_СТАТУС.md

# Исходники, решения и состояние 58.GR

Снимок на 02.10.2026. Источники перечислены без утверждения об их взаимном соответствии. Ссылки на Library сохраняют доступ к крупным файлам вне Git.

## Исходники

| Роль | Файл / идентификатор | Ссылка | Проверка в этой передаче |
|---|---|---|---|
| STEP КТ | `.58.GR.00.00.00.00 СБ  Решетка грабельная (STEP 214 КТ)(2).STEP`; `libfile_44402bbeebc48191ab04056e4f70f126` | [Получить](https://chatgpt.com/api/library/files/libfile_44402bbeebc48191ab04056e4f70f126/download) | Найден в Library, 16 770 533 байт; геометрия не проверена |
| STEP ТТ | `.58.GR.00.00.00.00 СБ  Решетка грабельная (STEP 214 ТТ)(2).STEP`; `libfile_061f4a9b2d6881919e327113cf8de9db` | [Получить](https://chatgpt.com/api/library/files/libfile_061f4a9b2d6881919e327113cf8de9db/download) | Найден в Library, 33 185 838 байт; геометрия не проверена |
| BOM(6) | `Исходники/58.GR BOM(6).xlsx`; оригинал `libfile_4840805f6e088191b40cd8d29fc72c2e` | [Оригинал](https://chatgpt.com/api/library/files/libfile_4840805f6e088191b40cd8d29fc72c2e/download) | Файл открыт; лист «Лист1», 179 строк × 7 столбцов, включая заголовок. Полная сверка не выполнена |
| Архив | `58.GR (Заказ №2410 - СМП) бом(2).rar`; `libfile_0bdcc2e214b88191a530f7cfbf7497c7` | [Получить](https://chatgpt.com/api/library/files/libfile_0bdcc2e214b88191a530f7cfbf7497c7/download) | Локально найден RAR v5, 76 550 852 байта; содержимое не распаковано и не сопоставлено |
| Регламент v2 | `Документы/Регламент_чертежи_производство_v2.md`; `libfile_2d2f5f2cce248191badb42fe032d56fc` | [Оригинал](https://chatgpt.com/api/library/files/libfile_2d2f5f2cce248191badb42fe032d56fc/download) | Текст помещён в репозиторий |
| Промт по размерам, базам и сварке | `Документы/Промт_размеры_базы_сварка.md`; `libfile_5c754f385c7081918e273e025d7e7dc6` | [Оригинал](https://chatgpt.com/api/library/files/libfile_5c754f385c7081918e273e025d7e7dc6/download) | Текст помещён в репозиторий |

BOM(6) загружена последней из известных таблиц, но актуальность по отношению к STEP определяется сверкой ревизий и состава. Повторные имена STEP с суффиксами `(1)`, `(2)` сами по себе не доказывают различие или тождество геометрии.

## Исторические решения, требующие проверки применимости

- Привод ранее принят 1,5 кВт; крутящий момент по восстановленной истории не определён.
- Ламель, позиция 105, ранее указывалась в количестве 33 шт. из AISI 316. Размеры, толщина и масса по одной истории не подтверждаются.
- Детали из Ст3 ранее назначено покрывать серой грунт-эмалью «Престиж»; точный состав и расход требуют подтверждения.
- Развёртки включать; прежнее решение «без развёрток» отменено.
- Для отдельных профилей в прежнем расчёте: S = 5 мм, внутренний R = 2 мм, K = 0,290, два гиба 90°, заготовки 432,838 × 1300 и 432,838 × 1335 мм. Косой торец нижнего профиля предполагалось обрезать после гибки. Фактический Flat-Pattern тогда не подтверждён.
- Ранее встречались резка 3 ч 12 мин, наладка 1 ч и снятие заусенцев 1 м за 1 мин 30 с. Область и ревизия этих норм не установлены.
- Исторический этап A-005: 17 составов, BOM на 178 строк, 118 индивидуальных совпадений, четыре строки в двух зеркальных группах, 56 несопоставленных строк. Это не сверка BOM(6).
- Исторический снимок нативной сборки SolidWorks: 394 вхождения, 51 уникальный файл, в том числе 16 SLDASM и 35 SLDPRT. Это не установленный состав текущих STEP.
- H12/f12 для установленных сопряжений; k6 исключительно для соответствующих шеек вала под подшипники. Не назначать по шаблону всем деталям.
- Материал «стакана» ранее уточнялся как Ст3; ТМКЩ сохранялась; твёрдость без основания не указывать. Установить позиции и ревизию.
- Согласования О01–О24 переносить только после установления конкретного изделия, ревизии и проверенного требования.

## Фактический статус передачи

| Направление | Статус |
|---|---|
| Доступ к GitHub и создание документации | Подтверждён |
| Чтение BOM(6) | Открыта, структура листа проверена; предметная сверка не проведена |
| STEP КТ и ТТ | Локальные файлы прочитаны: КТ содержит контурные представления, ТТ — объёмные BREP; единица длины мм, дерево сборки структурно разобрано. CAD-импорт, валидность геометрии и применимость не проверены; см. [сверку](Проверки/СВЕРКА_STEP_BOM6_2026-10-02.md) |
| RAR | Найден локально; состав не извлечён |
| SolidWorks | API версии 2026 доступен, но отдельная COM-проба присоединилась к пользовательской сессии с 54 открытыми документами другого проекта; STEP в ней не импортировался |
| Чертежи, DXF, развёртки, технология, времена, ведомости закупки | В этой передаче не создавались |
| Допуск к производству | Не оформлен |

Не переносить сведения изделия 881, 57.GR или 59.GR в 58.GR без явного подтверждённого основания.
