hisp2k/parameters/engineering/SolidWorksCodex/CLAUDE_MERGE_ANALYSIS_RU.md

# Анализ и объединение архива Claude с SolidWorksCodex 2.1

## Что было в архиве Claude

Архив основан на SolidWorksCodex 2.0.0 и содержит два самостоятельных изменения:

1. Prismatic Plan v6 — фаска или радиус на выбранных выпуклых вершинах
   многоугольного наружного профиля.
2. ClaudeBridge — файловый вызов существующего режима `--worker` через
   `ClaudeBridge/request.json` и `response.json`.

В архиве также находились старые вложенные исходники 2.0.0, три PDF, PNG,
рабочие логи, сохранённый ответ моста и резервный EXE. Это не код новой функции
и в объединённую поставку не включено.

## Что принято

| Изменение | Решение |
|---|---|
| Фаски/скругления вершин многоугольника | Перенесено как Prismatic Plan v6 |
| Расчёт касательных точек, центра дуги и снятой площади | Перенесён и покрыт тестами |
| Построение настоящей дуги через `ISketchManager.CreateArc` | Перенесено |
| ClaudeBridge | Включён как необязательный локальный мост версии 1.1 |
| Защита основного worker | Сохранена без ослабления |

## Что пришлось исправить

- Код Claude был сделан поверх 2.0.0 и не содержал контурный инструмент 2.1;
  выполнено ручное объединение, а не замена файлов.
- В архиве не было офлайн-тестов Plan v6.
- Радиусы наружных скруглений учитывались в базовой B-rep проверке, но не
  передавались в финальную проверку после всех операций.
- Отверстия в Plan v6 проверялись по исходному острому многоугольнику. Теперь
  проверка выполняется по фактической границе после фасок и скруглений.
- `response.json` создавался PowerShell 5.1 с BOM. Версия 1.1 пишет UTF-8 без BOM.
- В архиве лежал активный `request.json` на создание детали. В поставке есть
  только безопасный `request.example.json` с вызовом `sw_status`.

## Итоговая версия 2.2.2

- 25 MCP-инструментов.
- Prismatic Plan v1–v6.
- Contour Plan v1: наружные/внутренние контуры из линий и истинных дуг,
  отверстия и линейные массивы.
- Turned Plan v2/v3.
- 208 офлайн-проверок и реальный STDIO smoke-test.
- Два новых живых теста: `CREATE_TEST_SHEET_CONTOUR.cmd` и
  `CREATE_TEST_POLYGON_CORNERS.cmd`.

ClaudeBridge не является прямым облачным подключением к компьютеру и не
«объединяет нейросети». Это ручной файловый транспорт: модель записывает JSON,
пользователь или компьютерное управление запускает CMD, затем модель читает
ответ. Все реальные ограничения остаются внутри `SolidWorksLocal.exe`.

Живой COM-путь Plan v6 и Contour Plan необходимо подтвердить на SOLIDWORKS 2026.
`manufacturing_approved=false`.
