hisp2k/parameters/engineering/SolidWorksCodex/DRAWING_DATASET_ANALYSIS_RU.md

# Анализ архива «Детали.zip» для SolidWorksCodex 2.2

## Результат

Просмотрено 60 одностраничных PDF. Это не один универсальный тип геометрии,
поэтому безопасное построение разбито на классы. Версия 2.2 закрывает первый
класс — плоские детали постоянной толщины с произвольным контуром из отрезков и
дуг, внутренними вырезами и отверстиями.

| Класс | Что найдено | Действие версии 2.2 |
|---|---|---|
| Карты лазерной резки | 3 сводных листа раскладки | Не строить как отдельную деталь |
| Плоские листовые детали | панели, пластины, щиты, косынки, рёбра, уши, листы, ламель, расчёска, рычаг, звезда, стенка и другие | Строить через `sw_create_sheet_from_contours`, если все размеры однозначны |
| Уголки | серия деталей с названием «Уголок» | Остановиться: нужен отдельный план профиля |
| Трубы и профильная труба | несколько труб и одна профильная труба | Остановиться: нужен отдельный план труб/профилей |
| Гнутые/формованные детали | бортик и детали, форма которых зависит от гибов | Остановиться: нужен отдельный sheet-metal план |

## Что добавлено в коннектор

- Строгие упорядоченные контуры из настоящих линий и дуг.
- До 32 внутренних контуров.
- До 256 отверстий, включая линейные массивы.
- Контроль замкнутости, связности, самопересечений, вложенности и наложений.
- Аналитический расчёт площади дуговых контуров и ожидаемого объёма.
- После построения: одно твёрдое тело, объём и цилиндрические поверхности.
- Назначение поддерживаемого материала и заполнение обозначения/наименования.
- Явный отказ вместо приблизительной модели неподдерживаемого класса.

## Контрольные сложные плоские детали из архива

На следующих чертежах особенно важна поддержка настоящих дуг и топологии:

- `03-04.GR.V.02.00.00.01 Клык.pdf`
- `03-04.GR.V.02.01.00.02 Боковина.pdf`
- `03-04.GR.V.04.00.00.01 Расчёска.pdf`
- `03-04.GR.V.04.01.00.01 Рычаг.pdf`
- `03-04.GR.V.05.00.00.03 Звезда.pdf`
- `03-04.GR.V.05.03.00.02 Стенка.pdf`

Они не должны строиться по пикселям или приближённым вершинам. Codex обязан
получить из PDF полный набор размеров и связей; при нехватке данных создание
останавливается с перечнем конкретных недостающих привязок.

## Конвейер PDF → SolidWorks

1. Codex визуально читает PDF и классифицирует деталь.
2. Размеры и топология переводятся в строгий числовой план.
3. Коннектор проверяет план без вызова SOLIDWORKS.
4. Создаётся новая SLDPRT только в локальной Workspace.
5. Объём и B-rep топология сверяются с планом.
6. Только после PASS разрешено создавать отдельный SLDDRW/PDF.

Полный текст запроса для Codex находится в `PROMPT_PDF_TO_SOLIDWORKS_RU.txt`.

## Что делать в следующей версии

Следующий независимый класс — прямые уголки и трубы: профиль поперечного сечения,
длина, торцевые резы и отверстия на выбранных гранях. После него — гнутый лист с
линиями гиба, радиусами, направлением и развёрткой. Эти классы нельзя смешивать
с плоским контурным планом.

`manufacturing_approved=false`: любая созданная модель требует проверки конструктора.
