hisp2k/parameters/engineering/SolidWorksCodex/NATIVE_PART_PILOT.md

# Нативная деталь: первый живой параметрический тест

15.09.2026. База e6a607f, ветка claude/director-parametric-pilot.
Пользователь разрешил менять отдельную рабочую копию на рабочем столе.
Старое ограничение исследования без изменений относится к исходному каталогу.

## Подтверждённая Карта

Рабочий каталог: `C:\Users\adm\Desktop\25.SHT.G.00.00.00.00 СБ`.
Узел: `25.SHT.G.09.00.00.00 СБ  Перекладина съемная.SLDASM`.
Деталь: `25.SHT.G.09.00.00.02  Пластина.SLDPRT`.
Конфигурация испытания: `По умолчанию`.

| Звено | Подтверждено |
| --- | --- |
| Опросный лист / расчётная формула | Не предоставлены; связь с CAD ещё не определена |
| CAD-параметр | Толщина, точный FullName: `D1@Бобышка-Вытянуть1@25.SHT.G.09.00.00.02  Пластина.Part` |
| Элемент | `Бобышка-Вытянуть1`, тип `Extrusion`, не подавлен |
| API / единицы | IDimension.GetType: swDimensionParamTypeDoubleLinear=0; GetSystemValue3: метры; 0.004 м = 4 мм |
| Право изменения | driving=true, read_only=false, editable_by_feature_tool=true; sw_set_feature_dimensions |
| Геометрическое действие | Габарит X 4 → 5 → 4 мм, Y/Z остались примерно 30/80 мм; объём +25%, затем исходный |
| Ограничения | Инженерный диапазон не определён; эскизы не редактируются; остальные конфигурации не испытаны |

sw_open_local_file: OPENED_CLEAN, errors=0, warnings=0. Прочитаны 21 элемент,
11 линейных размеров, 0 уравнений/глобальных переменных, 3 конфигурации:
`По умолчанию`, `Упрощен`, `Чертеж`. Порядок дерева не доказывает причинную
зависимость всех вырезов/сопряжений. Новые пути ссылок сборки не переоценивались.
Это карта первого проверенного параметра, не автоматический каталог деталей.

## Исправления Коннектора

- IDimension.GetType ошибочно расшифровывался через swDimensionType_e.
  Теперь используется swDimensionParamType_e: 0=линейный, 1=угловой,
  2=целочисленный, -1=неизвестный. Удалена подмена типа по имени AI_*/D1.
  Неизвестные и угловые параметры не допускаются к записи в миллиметрах.
- Extrusion добавлен в опубликованную JSON Schema sw_set_feature_dimensions;
  исполнитель уже поддерживал его, но клиентский контракт скрывал этот тип.
- Двойники API и регрессии исправлены; проверяются также реальные enum DLL.

Основание: [IDimension.GetType](https://help.solidworks.com/2020/English/api/sldworksapi/SolidWorks.Interop.sldworks~SolidWorks.Interop.sldworks.IDimension~GetType.html),
[swDimensionParamType_e](https://help.solidworks.com/2025/english/api/swconst/SolidWorks.Interop.swconst~SolidWorks.Interop.swconst.swDimensionParamType_e.html).

## Результаты

OFFLINE_PASS: 263 основных + 81 чтение/STDIO + 74 write-safety.
С установленной Interop DLL: 88 вместо 81. Переносимая сборка этой итерацией NOT_RUN.

LIVE_PASS: 4 → 5 мм, затем 5 → 4 мм, обе операции через штатный STDIO коннектора.
Оба перестроения успешны; 1 тело до/после; Save3 errors=0/warnings=0;
повторное чтение подтверждает размер и чистый документ. Это не проверка
сохранения через закрытие/повторное открытие: такой тест NOT_RUN.
Сырые ответы: NATIVE_PART_LIVE_RESULT.json и NATIVE_PART_LIVE_RETURN.json.
Итоговая толщина 4 мм; объём 8.55623013704666e-6 м3, исходный геометрический объём.
Побайтово файл после двух сохранений не равен исходному; исходные байты в бэкапе.
Сверены 114 существовавших CAD-файлов рабочей копии: изменён только файл пластины.
Сборки не сохранялись, документы не закрывались, чертежи не создавались.
Допуск к производству отсутствует. Контракт опросного листа остаётся следующим шагом.

## Бинарники И Бэкапы

Первый live write: EXE 3641E5C883C2238F5E0D5DF2E6FB899A391C05D9BF1B8A1DEF1EFB1965AC2681.
Обратный live write и окончательный EXE:
`B9570CC918CB5D4D341C85BCE8328037A84D3D43F78BBBE372FAEE9AF2C93425`.
Этот же EXE установлен в `%LOCALAPPDATA%\SolidWorksCodex`, SHA-256 совпадает,
self-test и прямой STDIO tools/list + sw_document прошли.
Старый MCP-процесс остановлен; канал текущего чата вернул Transport closed.
Для инструментов чата нужно переподключить MCP и перечитать tools/list.
SOLIDWORKS PID 24564 не закрывался; случайно запущенный второй PID 8496 убран.

Бэкапы под `C:\Users\adm\Documents\ChatGPT\Коннекторы\_backups\SolidWorksCodex`:
- `pilot-copy-before-live-20260915-062915`: 172 файла рабочей копии, SHA-256 проверены.
- `before-native-dimension-fix-20260915-063223`: 387 файлов repo, проверены SHA-256 и git bundle.
- `before-installed-native-dimension-fix-20260915-064154`: 39 файлов установки, SHA-256 проверены.
Каждая запись CAD дополнительно создала проверенный sibling-бэкап; точные пути в JSON.
