hisp2k/parameters/engineering/SolidWorksCodex/PARAMETRIC_PILOT_RESEARCH.md

# Параметрический пилот: исследование 15.09.2026

**Исторический снимок до открытия детали.** Блокер снят в последующей сессии:
см. NATIVE_PART_PILOT.md. Пользователь разрешил изменения отдельной рабочей копии;
подтверждён точный размер и выполнен живой цикл 4 → 5 → 4 мм. Данные ниже
относятся к прежнему каталогу и не заменяют новые доказательства.

Статус на момент снимка: **кандидат предварительный; точный управляющий размер NOT_RUN**.
База: 6730e03, ветка claude/director-parametric-pilot; status чистый, fetch успешен,
origin совпадал. Код/EXE не менялись, main/merge/PR/релиз не затронуты.
Машинные доказательства, полные пути, SHA-256 и связи: [JSON](PARAMETRIC_PILOT_RESEARCH.json).

## Фактический Пилот

Каталог:
`C:\Users\adm\Desktop\25.SHT.G.00.00.00.00\25.SHT - Заказ №2377 Промстрой\25.SHT.G.00.00.00.00 СБ Изм.5\25.SHT.G.00.00.00.00 СБ`.
Корень: `25.SHT.G.00.00.00.00 СБ  Транспортер.SLDASM`.
Конфигурация: `По умолчанию`.
SHA-256: `39C1A499FCE24D5AE5BC9E0EA287EAC65F6CE0C950041EE6D7A94A60CD017393`.

LIVE_PASS: sw_status, sw_document, sw_equations, sw_configurations:
API 34.3.2, активна сборка, has_unsaved_changes=true, запись сборки запрещена,
0 корневых уравнений и 1 конфигурация. Дерево сообщает total=516; прочитаны
только целевые страницы 0/50/100, 150 строк, не полный обход этого запуска.
Файл совпадает по SHA с известным снимком «СБ Изм.5», не со снимком 495/38.

Свежий OpenDoc6 для корня не выполнялся. errors=2/read_only=true относятся
к предыдущему live-отчёту, не выдаются за повторное измерение этого запуска.
Текущие 41 уникальная прямая зависимость и 4 отсутствующих пути проверены
заново через sw_document_dependencies и файловую систему.

## Сравнение Узлов

Источник прямых связей: ISldWorks.GetDocumentDependencies2(false,false,false),
пары имя/полный путь; совпадения проверены по полным путям, не по названиям.

| Узел | Уникальных прямых файлов | Не найдены по сохранённым путям |
| --- | ---: | ---: |
| 01 Отсек | 12 | 0 |
| 02 Шнек с осями | 4 | 0 |
| 03 Фланец | 4 | 2 |
| 06 Крышка | 5 | 0 |
| 09 Перекладина съёмная | 2 | 0 |

Все пять sw_open_assembly_readonly дали ASSEMBLY_ALREADY_OPEN_NOT_READONLY.
Их уравнения, глобальные переменные и список конфигураций **NOT_RUN**.
Документы не закрывались/переоткрывались. Отсутствующие 2 ссылки узла 03
дополняют 4 отсутствующие прямые ссылки корня; это не один и тот же список.

## Предварительный Выбор

Узел `25.SHT.G.09.00.00.00 СБ  Перекладина съемная.SLDASM`.
Деталь `25.SHT.G.09.00.00.02  Пластина.SLDPRT`, конфигурация `По умолчанию`.
SHA-256 детали: `5837DE9047414F187B0E47407816147C33A915FBD3A08230AAE3FF679B5313B9`.

LIVE_PASS, sw_assembly_tree: 4 верхнеуровневых экземпляра узла, в каждом
1 перекладина и 2 пластины. Все выбранные экземпляры несупрессированы.
parent_instance_id подтверждает принадлежность; файловый API независимо
подтверждает ссылки корень → узел 09 → обе детали. Это связи файлов/экземпляров,
не доказанная причинная зависимость размеров, сопряжений или геометрии.

LIVE_PASS, sw_component_details: обе детали загружены, AISI 304.
Пластина: масса 0.06844984109637328 кг; свойство Материал_Таблица =
«Лист 4 304 ASTM 240 M-15». Перекладина: 0.5005694747404823 кг,
свойство материала «Труба 30х30х3». Это свойства, не измеренные driving dimensions.
Для обеих деталей исходящие зависимости вернулись UNKNOWN, raw_count=0,
issues=[]; отсутствие внешних ссылок **не доказано**.

## Карта Параметра

| Звено | Доказанное состояние |
| --- | --- |
| Вход опросного листа → формула | Опросный лист и контракт формул не предоставлены; целевой поиск в repo их не нашёл |
| CAD-кандидат | Возможная толщина пластины узла 09; пока гипотеза по свойству материала |
| Файл/конфигурация | Пластина выше / По умолчанию, подтверждено деревом и component_details |
| Точное имя размера/переменной | NOT_RUN; не присваивать выдуманное D1 или AI_Thickness |
| Зависимые элементы | NOT_RUN; дерево файла и сопряжения не прочитаны |
| Единицы размера и новое значение | Не подтверждены; «Лист 4» не заменяет API-чтение единиц/значения |
| Ожидаемое изменение | Только гипотеза: изменение толщины; направление вытягивания и связи ещё неизвестны |
| Изменение текущим коннектором | Для этой детали NOT_VERIFIED; нужно editable_by_feature_tool=true и точное FullName |

Теоретически текущий sw_set_feature_dimensions поддерживает проверенные
линейные размеры Extrusion/Boss/Cut/HoleWzd/Chamfer/Fillet, но не произвольные
размеры эскизов, уравнения или параметры сборки. sw_create_parameter_variant
принимает AI_*; принадлежность этой детали к такой схеме не подтверждена.

## Блокер И Продолжение

На актуальном репозиторном EXE sw_features и sw_parameters реально вернули
PART_REQUIRED: активна сборка. sw_component_details читает свойства/массу,
но не размеры и элементы вложенного документа. Автоматическое открытие
детали не использовано: OpenLocalPath вызывает ActivateDoc2 с
UseUserPreferences=true, то есть код не гарантирует режим без перестроения
при активации. При текущем запрете перестроения этого недостаточно.

Запрошено одно ручное действие: активировать Пластину отдельным окном,
не в режиме редактирования сборки, без сохранения/перестроения/закрытия.
После этого штатными sw_features/sw_parameters/sw_equations/sw_configurations
можно завершить выбор точного размера. До этого испытание изменения на копии
преждевременно. Следующее испытание: на отдельной копии подтвердить точный
редактируемый размер и его геометрическое действие; новое значение сначала
согласовать с расчётным контрактом, не придумывать из названия детали.

Если ручная активация недоступна, минимальное расширение: read-only inventory
одного уже загруженного компонента по instance_id через GetModelDoc2, без
открытия/активации/перестроения, с проверкой referenced/loaded configuration.
Нужны размеры, элементы и уравнения этого документа; не общий рефакторинг.

OFFLINE_PASS: 262 self-test репозиторного EXE. Новый live write **NOT_RUN**.
MCP использовал EXE B9A5DB07... от cb5c28c; проверка PART_REQUIRED выполнена
новым EXE 3063C60B... от 6730e03. Полные хэши в JSON. MCP не переустанавливался.
Исходные CAD не изменялись, не сохранялись, не перестраивались и не закрывались.
