hisp2k/parameters/engineering/SolidWorksCodex/PROJECT_STATE.md

# SolidWorksCodex 2.5.0 — состояние для совместной разработки

## Актуально: Обновления Claude Получены, 16.09.2026

Рабочая копия синхронизирована fast-forward с `503808f`: получены шесть коммитов
после `0aafc74`. Открытый PR: https://github.com/hisp2k/SolidWorksCodex/pull/1.
Ниже результаты старых этапов; приоритет имеют этот раздел и начало TASK.md.

- Контракт содержит 35 инструментов, включая новый `sw_set_global_variable`:
  создание именованной переменной и привязка ранее буквального линейного размера.
- Исправлено чтение Transform2; аудит возвращает позиции компонентов и issues.
- По отчёту Claude, перекладина изменена 208 -> 228.8 мм, обе пластины сдвинулись
  на 10.4 мм к новым торцам; проверены сохранение/reopen, 6 сопряжений и новый
  проверочный чертёж/PDF. См. STAGE13_CROSSBAR_LENGTH_EXPERIMENT_RU.md.
- По TASK.md Claude проверил привязку размера к `crossbar_length_mm=228.8`
  на своём варианте Experiment_ebc977a34242; это не новая CAD-проверка этой сессии.
- Найден шаблон опросного листа/BOM. `screw_conveyor_core_draft.py` является
  инженерным черновиком без подтверждения инженера, не готовым расчётным ядром.
  Открытые вопросы: QUESTIONS_FOR_DMITRY_ALEXANDROVICH_RU.md.

В этой сессии повторены только автономные тесты полученного EXE:
282 core + 88 assembly/STDIO/Interop + 78 write-safety + 26 scoped = 474 PASS.
CAD не открывался и не изменялся. Новый общий аудит кода не выполнялся.

Репозиторный EXE: `4470C9A0E1A63623C50D8FB212853155CE6FEE1D6877F1DBA6297B997E295F20`.
Установленный MCP: `B9570CC918CB5D4D341C85BCE8328037A84D3D43F78BBBE372FAEE9AF2C93425`.
Установка не обновлялась; новые возможности использовать через EXE репозитория.
Пути G:\Mine из отчётов Claude относятся к его окружению: локальный разрешённый
комплект на C:\Users\adm\Desktop не переносился, TestScope.local.json не подменялся.
Перед обновлением проверен полный бэкап 508 файлов и Git bundle:
`..\_backups\SolidWorksCodex\before-claude-update-20260916-140745`.

## Параметрический Эксперимент Завершён, 15.09.2026

SCOPED_PARAMETRIC_EXPERIMENT.md и три SCOPED_*.json фиксируют полный живой цикл:
штатная копия узла 09, толщина 4 -> 5 мм, rebuild/save, реальная выгрузка/reopen,
один solid, +25% объёма, две пластины в подсборке, 6 чистых сопряжений.
Итоговый вариант Experiment_26333854d6ac; исходные 116 CAD-файлов не изменены.
Новое разрешение пользователя действует только внутри тестовой папки; не для внешних ссылок.
Расширение: sw_test_pack_and_go, sw_test_document, локальный opt-in TestScope.local.json.
Обычные команды сборки не сохраняют; PDM/сеть/произвольный COM не добавлены.
OFFLINE_PASS: 276 + 81/88 + 74 + 26; полный LIVE_PASS и финальная перепроверка записаны.
EXE repo A7BAA31F...; установленный MCP остался B9570CC9..., не обновлялся автоматически.
Корневой транспортёр, другие конфигурации, коллизии и чертежи не валидированы этим тестом.
Следующий этап: заданный пользователем расчётный контракт, не выдуманные формулы.
Исторические результаты ниже не заменяют актуальный отчёт.

## Нативная Пластина, 15.09.2026

Первый реальный параметр проверен: Пластина узла 09, Extrusion,
`D1@Бобышка-Вытянуть1@25.SHT.G.09.00.00.02  Пластина.Part`.
Рабочая копия `C:\Users\adm\Desktop\25.SHT.G.00.00.00.00 СБ` разрешена к изменению.
LIVE_PASS: толщина 4 → 5 → 4 мм, два rebuild/save, проверенные бэкапы,
одно тело, восстановленный исходный объём. Итог 4 мм, документ чистый.
Исправлены enum параметров и JSON Schema Extrusion. OFFLINE_PASS: 263 + 81/88 + 74.
EXE repo и установки: B9570CC918CB5D4D341C85BCE8328037A84D3D43F78BBBE372FAEE9AF2C93425.
Прямой STDIO установки работает; старое подключение MCP чата закрыто при обновлении,
нужно переподключение. Подробности и границы: NATIVE_PART_PILOT.md.
Связь с опросным листом пока не задана. Сведения ниже исторические.

## Исследование существующей модели, 15.09.2026

Текущий приоритет: опросный лист → расчёт → параметры существующей
нативной модели → вариант → чертежи и технологические данные.
PDF-to-CAD временно не является приоритетом.

Сохранены PARAMETRIC_PILOT_RESEARCH.md и .json. Предварительный кандидат:
узел 09 «Перекладина съёмная», деталь 09.00.00.02 «Пластина».
Файловые связи и свойства подтверждены live; точный driving dimension
не подтверждён: все пять подсборок отказали ASSEMBLY_ALREADY_OPEN_NOT_READONLY,
а sw_features/sw_parameters на активной сборке вернули PART_REQUIRED.
Запрошена ручная активация Пластины без перестроения; CAD не изменять.
Не выдавать свойство «Лист 4» за управляющий размер и не изобретать формулу.

## Аудит перед продолжением Claude, 15.09.2026

- Закрыты воспроизведённые ошибки записи: неизвестный dirty/read-only,
  смена цели сохранения/отката, чужой размер элемента, угловой AI_*,
  потеря скрытых параметров при создании варианта.
- Явное сохранение всегда делает проверенный бэкап. Ошибка rebuild свойств
  останавливает Save3. Копия варианта проверяется по SHA-256.
- Таймаут worker учитывает ожидание mutex; пределы 45/75 секунд ниже MCP 90 секунд.
- PASS: 262 Framework + 82 assembly/STDIO/Interop + 47 write-safety.
  PORTABLE_TEST: 262. BUILD.cmd запускает обе группы регрессий
  (без Interop: 79 вместо 82).
- Новый EXE в репозитории: SHA-256
  `3063C60B39670A2D4CFE25058150FB9D00DA4067884836A535464154D2B4BFF7`.
  Установленный MCP EXE остался от cb5c28c: одинаковый номер 2.5.0
  не означает одинаковую сборку.
- Новый EXE прошёл live status/document/equations, только чтение.
  Новые операции записи проверены на автономных двойниках, не живым изменением CAD.
- Перед правками выполнен полный бэкап: 353 файла и Git проверены.
  Перед коммитом выполняется дополнительный бэкап.
- Перед продолжением читать CLAUDE_HANDOFF.md. Исторические результаты
  ниже не заменяют этот статус.

## Ветка claude/director-parametric-pilot: ревью чтения сборок (OpenDoc6 + Stage 3)

- Исправлен `OpenDoc6` в `sw_open_assembly_readonly` (`src/SolidWorksReader.cs`):
  отсутствие документа (`OPEN_FAILED`) больше не путается со случаем, когда
  документ реально открылся, но SOLIDWORKS вернул `errors != 0`. Второй случай
  разрешен только при подтвержденном read-only. Обычное открытие детали
  с ошибками останавливается. Предупреждения получают отдельный статус
  `OPENED_WITH_WARNINGS`; чистая загрузка требует errors=0 и warnings=0.
  Создание варианта требует чистой загрузки исходника и копии, иначе
  изменение параметров не начинается. Фактический тип документа проверяется
  через `GetType`, неподтвержденный read-only приводит к ошибке.
- Проверки: 258 assertions на .NET Framework x64, 258 в PORTABLE_TEST;
  `TEST_ASSEMBLY_READ_REGRESSIONS.ps1`: 79 без `-InteropPath`, 82 с ним.
  Проверен настоящий STDIO-процесс. EXE в репозитории пересобран;
  установленный коннектор не заменялся. Нового live-запуска в этом исправлении
  не было. До правок выполнен полный бэкап файлов и истории Git с SHA-256.
- Живая read-only проверка на пилотной сборке `25.SHT.G.00.00.00.00 СБ`
  (без изменения/сохранения/закрытия документов): полное дерево 495
  компонентов без `IsVirtual=true`; 0 уравнений на корневой сборке; 38
  уникальных прямых зависимостей корня — все присутствуют на диске (сырой
  `dependency_count=76` — это те же 38 файлов, каждый дважды: неразрешённое
  имя + разрешённый путь). Проверка 5 кандидатов-подсборок на
  уравнения/конфигурации осталась LIVE_NOT_RUN — они уже открыты не-readonly
  в текущей сессии SOLIDWORKS, и коннектор корректно отказался их трогать
  (`ASSEMBLY_ALREADY_OPEN_NOT_READONLY`), не закрывая чужие документы.
- Этот live-отчет Claude не заменяет отдельный отчет Codex по каталогу
  «СБ Изм.5»: там 516 экземпляров, 41 зависимость и 4 отсутствующих файла.
  Для сравнения нужны совпадающие полный путь, конфигурация и SHA-256.
- `truncated` описывает неполноту отдельного ответа относительно всего
  списка; это не признак наличия следующей страницы. Конец обхода:
  `next_offset == null`. Поведение сохранено.
- Подробности: `TASK.md`, раздел «Исправления после ревью директорского
  пилота» и «Живая проверка на пилотной сборке».

## Новое в 2.5.0 (продольные пазы профилей)

- `ProfilePartPlan` v3 добавляет осевые овальные пазы на `leg_a`, `leg_b`,
  `face_a` и `face_b`.
- Пазы поддерживают явные позиции и линейные массивы. Значения — общая длина,
  ширина, отступ от края и осевая позиция центра.
- Пазы уголка проходят через одну стенку, пазы прямоугольной трубы — через две
  противоположные стенки. Круглая труба по-прежнему отклоняется без угловой базы.
- Добавлены проверки границ, перекрытий, аналитического объёма, одного тела и
  цилиндрической топологии полукруглых концов.
- Исходники и MCP-схема обновлены. Windows-бинарник ещё нужно пересобрать;
  живой тест `CREATE_TEST_PROFILE_PARTS_2_5.cmd` ещё не выполнен.
- Следующий приоритет: косые торцы и торцевые фаски профилей.

## Новое в 2.4.0 (профильные трубы)

- `ProfilePartPlan` v2 поддерживает три сечения: `equal_angle`,
  `rectangular_tube`, `round_tube`; v1 уголка остаётся совместимым.
- Прямоугольная труба строится одним вытягиванием наружного и внутреннего
  контура. Доступны острые углы либо явно заданные постоянные радиусы стенки.
- `face_a` и `face_b` означают круглый вырез через обе противоположные стенки
  прямоугольной трубы. Объём выреза и две цилиндрические поверхности на каждое
  отверстие учитываются независимо.
- Круглая труба строится двумя концентрическими окружностями; внутренний диаметр
  вычисляется из наружного диаметра и толщины стенки.
- После создания проверяются аналитический объём, одно твёрдое тело и полный
  набор цилиндрических поверхностей сечения и отверстий.
- Исходники и MCP-схема обновлены. Windows-бинарник должен быть пересобран
  `BUILD.cmd`; живой тест SOLIDWORKS 2026 для двух новых сечений ещё не выполнен.
- Ограничения: обычные перпендикулярные торцы; нет торцевых фасок, косых резов,
  пазов и боковых отверстий круглой трубы без угловой базы.

## Назначение

Локальный MCP-коннектор Codex ↔ SOLIDWORKS 2026 SP03.2. Работает в пользовательской
Windows-сессии через официальный COM API и runtime-loaded Interop установленного
SOLIDWORKS. Это пилотный стенд, не производственный выпуск.

## Проверенный базовый уровень

- 25 MCP-инструментов со строгими схемами.
- Чтение документа, детали, свойств, параметров, элементов, сборки и чертежа.
- Создание деталей по Prismatic Plan v1–v6, Contour Plan v1 и Turned Plan v2/v3.
- Изменение `AI_*` группой до 16 значений с одной резервной копией.
- Защищённое изменение размеров выбранного `Extrusion`/поддерживаемого элемента.
- Создание SLDDRW, аудит и экспорт PDF.
- Запись только на локальный фиксированный диск; сеть, PDM-write и сборки запрещены.
- 208 офлайн-проверок и STDIO smoke-test.
- Пользователем подтверждён живой тест 15 параметров + backup + rebuild + volume + drawing + PDF.

## Новое в 2.2

- `sw_create_sheet_from_contours` создаёт новую листовую деталь постоянной толщины.
- Наружный и внутренние контуры задаются упорядоченными отрезками и истинными дугами.
- Поддержаны отдельные круглые отверстия и линейные массивы отверстий.
- До запуска SOLIDWORKS отклоняются незамкнутые, несвязные, самопересекающиеся
  и накладывающиеся контуры. После построения проверяются объём и B-rep топология.
- Уголки, трубы, профили, гибы, резьбы и зенковки этой схемой не создаются.
- Живой тест: `CREATE_TEST_SHEET_CONTOUR.cmd`.
- Анализ исходной подборки: `DRAWING_DATASET_ANALYSIS_RU.md`.
- Рабочий промпт PDF → SLDPRT: `PROMPT_PDF_TO_SOLIDWORKS_RU.txt`.
- Plan v6 добавляет фаски и скругления на отдельных выпуклых вершинах
  многоугольного профиля; проверяются площадь, отверстия и цилиндрические грани.
- Необязательный `ClaudeBridge` вызывает тот же защищённый worker через JSON-файл.
- Подробности объединения: `CLAUDE_MERGE_ANALYSIS_RU.md`.

## Новое в 2.3.0 (профильная деталь / равнополочный уголок)

- Анализ производственного комплекта чертежей (`drawing-dataset/`) выявил, что
  наиболее часто повторяющийся неподдерживаемый класс — профильная деталь
  (уголок постоянного сечения с осевыми отверстиями на полках).
- Добавлен `ProfilePartPlan` v1 (`src/ProfilePartPlan.cs`) и
  `sw_create_profile_part_from_plan` (`src/SolidWorksReader.cs`): равнополочный
  уголок (leg_a × leg_b × thickness, острый внутренний угол), сквозные отверстия
  на одной из полок — явным списком позиций или линейным массивом.
- Построение: базовое вытягивание по многоугольнику сечения на первой плоскости,
  затем эскиз-вырез на боковой плоскости каждой полки (`BeginCutSketchOnPlane`).
- **Важная находка**: `swEndCondThroughAll` на очень длинной тонкой детали
  (например 4000×50×50×4 мм, соотношение 80:1) нестабилен и может расколоть
  тело на два. Исправлено переходом на `swEndCondBlind` с глубиной, равной
  проверенной толщине полки (`thicknessMm`) — переиспользует уже проверенный
  путь `FinishCutSketch(..., through=false, depthMm, ...)`.
- **Вторая находка**: направление глухого выреза (`Dir`) зависит от того, с какой
  стороны опорной плоскости лежит тело, и не всегда совпадает с ожидаемым по
  умолчанию. Добавлен параметр `allowDirectionFallback` в `FinishCutSketch`:
  при `cut == null` для `Dir=true` выполняется одна повторная попытка с
  `Dir=false` перед тем, как вернуть `CUT_FAILED`.
- После каждого выреза добавлена постоянная проверка `IPartDoc.GetBodies2`
  (ровно 1 тело), иначе `Fault("CUT_SPLIT_BODY", ...)` и файл не сохраняется.
- Проверка объёма, количества и диаметров цилиндрических граней переиспользует
  уже проверенный `VerifyPrismaticCylinders` (поле `expected_cylindrical_face_count`,
  а не отдельное `expected_hole_count`).
- Живые тесты: `CREATE_TEST_PROFILE_PART_CAPTURE.cmd` (контрольный уголок
  40×40×3×200 мм) — **PASS**, все проверки без исключений (объём, топология,
  1 тело, диаметры, конверт, материал, свойства, сохранение).
- `CREATE_TEST_PROFILE_PART_REALPDF_CAPTURE.cmd` (реальный уголок
  05.SHT.TR.11.00.00.05, 50×50×4×4000 мм, 28 отверстий Ø9) — **FAIL**:
  `CUT_FAILED` на первом же отверстии полки leg_a, несмотря на исправление
  направления выреза. Диагностический тест (`DIAG_PROFILE_LENGTH_TEST.ps1`,
  тот же профиль/толщина/диаметр/отступ кромки, но длина 500 мм вместо
  4000 мм) прошёл полностью успешно — значит, проблема не в параметрах
  отверстия, а именно в экстремальном соотношении длины к сечению (≥80:1).
  При этом после неудачной попытки на реальном плане (4000 мм) сам процесс
  SOLIDWORKS 2026 закрылся (краш) и потребовал повторного запуска — реального
  открытого документа пользователя при этом не было, риска потери данных не
  возникло, но это значит, что построение очень длинных тонких профилей в
  текущем виде **небезопасно повторять** без дальнейшего расследования.
  `manufacturing_approved` для этого плана остаётся `false`, статус плана —
  требует дополнительной инженерной работы перед повторной живой попыткой.
- **Инцидент с потерей несохранённого кода**: в одной из предыдущих сессий
  вся реализация `sw_create_profile_part_from_plan` в `src/SolidWorksReader.cs`
  была случайно стёрта (вероятно, `git checkout --`/`git restore` по одному
  файлу) до того, как была закоммичена — код не был потерян в истории git,
  потому что там его никогда не было. Обнаружено через `sw_status` (инструмент
  пропал из `write_tools_available`) и `git status`/`git diff --stat HEAD`.
  Код полностью восстановлен по образцу проверенных соседних методов
  (`CreateTurnedPartFromPlan`, `VerifyPrismaticCylinders`, `ApplyAndVerifyMaterial`
  и др.) с сохранением точных формул привязки осей и исправления направления
  выреза. **Вывод на будущее**: коммитить каждое существенное изменение сразу
  после успешной автономной сборки, не дожидаясь завершения всей функции.

## Важные особенности SOLIDWORKS 2026

- «Бобышка-Вытянуть» возвращается как `IFeature.GetTypeName2() = Extrusion`.
- `IDimension.GetType()` может вернуть `swDimensionTypeUnknown` для реального
  линейного управляющего размера. Исключение разрешено только известным `AI_*`,
  созданным коннектором по фиксированной схеме.
- Полное имя размера содержит имя документа и после повторного открытия должно
  читаться заново; старое имя не используется вслепую.

## Ключевые исходники

- `src/Protocol.cs` — MCP-протокол и строгие схемы.
- `src/SolidWorksReader.cs` — COM-чтение, запись, проверки и безопасность.
- `src/PartPlan.cs` — призматические планы.
- `src/TurnedPartPlan.cs` — токарные планы.
- `src/Tests.cs` — автономные проверки.
- `CREATE_TEST_GROUPED_PARAMETERS.ps1` — главный живой регрессионный тест.
- `CREATE_TEST_SHEET_CONTOUR.ps1` и `CREATE_TEST_POLYGON_CORNERS.ps1` — новые
  живые геометрические тесты 2.2.
- `src/ProfilePartPlan.cs` — план профильной детали (равнополочный уголок).
- `CREATE_TEST_PROFILE_PART_CAPTURE.ps1` — живой контрольный тест 2.3.0 (PASS).
- `CREATE_TEST_PROFILE_PART_REALPDF_CAPTURE.ps1` — живой тест по реальному PDF
  (пока FAIL на экстремальной длине 4000 мм, см. раздел «Новое в 2.3.0»).
- `DIAG_PROFILE_LENGTH_TEST.ps1` — диагностический скрипт, изолировавший причину
  сбоя (длина/соотношение сторон, а не параметры отверстия).

## Правило работы двух моделей после 2.0

- Claude: крупная реализация, рефакторинг, PowerShell, тесты и документация.
- GPT/Sol High: архитектура, сложные COM/PDM-блокеры, безопасность и компактный review.
- Перед передачей задачи читать этот файл и `VALIDATION.md`; не пересылать всю историю чата.
- Каждое изменение Claude перед живым запуском должно пройти сборку .NET Framework x64,
  portable self-test и STDIO smoke-test. GPT проверяет diff и границы записи.

## Следующая отдельная ветка после 2.0

Рекурсивное дерево сборки: группировка по файл + конфигурация + обозначение,
количество экземпляров, свойства/материал/масса уникальных позиций, статусы
«покупное», «изготавливаемое», «путь отсутствует», «подавлено» и сводная спецификация.
Запись в PDM в эту ветку не добавлять.
