hisp2k/parameters/engineering/SolidWorksCodex/QUESTIONS_FOR_DMITRY_ALEXANDROVICH_RU.md

# Вопросы к Дмитрию Александровичу по параметризации 25.SHT (шнековый транспортёр)

Дата: 16.09.2026. Собрано по всем стадиям `claude/director-parametric-pilot` (Stage 3–13).
Каждый пункт — то, что честно нельзя ни подтвердить, ни продвинуть дальше без ответа
самого Дмитрия Александровича (правило проекта: не изобретать и не додумывать
отсутствующие данные). Технически параметризация уже доказана рабочей (Stage 7/8/13:
живое изменение размера на копии узла 09, включая связанный чертёж, — подтверждено).
Дальше упирается именно в эти вопросы.

## Блок A — критично блокирует переход от «карты параметров» к рабочей автоматической параметризации

1. **Опросный лист + математическая модель (Excel-расчёт) по 25-му Транспортёру** —
   по словам Дмитрия Александровича (см. стратегический брифинг), они уже существуют,
   но файл(ы) пока не переданы/не найдены. Без них связка «поле опросного листа →
   размер в CAD» (Stage 9) остаётся только ручной справочной таблицей, а не рабочим
   автоматическим пайплайном.
2. **«Правильная BOM-версия» сборки Транспортёра** — по словам Дмитрия Александровича,
   существует отдельная версия сборки, пересобранная с явной пометкой, какие детали
   покупные, а какие изготавливаемые. Сейчас доступна только обычная (не BOM-размеченная)
   версия. Где физически находится эта версия?
3. **Инженерное ядро для шнекового транспортера** (опросный лист → диаметр шнека, шаг,
   частота вращения, мощность). В карте связи себестоимости этот этап отмечен «Готово»,
   но нигде на связанном компьютере/в архивах реальный файл/скрипт с этой математикой не
   найден (Stage 11). Как временную меру я сам формализовал черновик по открытым
   инженерным источникам (Stage 12, `screw_conveyor_core_draft.py`) — на контрольном
   примере он даёт диаметр 200 мм, что совпадает с пилотом, но это не доказательство
   точности, а лишь правдоподобный порядок величин. Три под-вопроса:
   - Существует ли всё же готовое инженерное ядро (Excel/скрипт/таблица) отдельно от
     калькулятора ленточных/роликовых транспортеров (тот найден, он не про шнеки)?
   - Если ядра ещё нет — подтвердить или скорректировать коэффициенты черновика
     (заполнение жёлоба ψ, отношение шага к диаметру E, сопротивление ω, ограничение по
     частоте вращения A, коэффициент крупности куска K) под реальные грузы Тех-Аэро,
     а не общеотраслевые.
   - Дать методику или проверенные значения для толщины витка шнека и толщины корпуса —
     это обычно прочностной расчёт (момент, материал, запас), публичной простой формулы
     для него нет, черновик его не покрывает.
4. **Алгоритм «ИИ-технолог»** (трудоёмкость по лазеру/сварке/зачистке/сборке) — по словам
   Дмитрия Александровича уже существует отдельно, но не привязан к параметризированной
   модели. В каком виде он сейчас существует (Excel, отдельная программа, что-то ещё)?
   Это нужно, чтобы понять формат интеграции с коннектором.

## Блок B — точечные уточнения по CAD (не блокируют старт, но нужны для точности карты параметров)

5. **Диаметр вала шнека** — на валу два характерных диаметра: 76 мм (основной) и 65 мм
   (посадочная ступень под подшипник). По реальному чертежу и стандартному размеру
   подшипника похоже, что это просто ступенчатый вал, а не выбор «какой из двух» —
   но финальное подтверждение у Дмитрия Александровича имеет смысл: правильно ли понята
   эта ступенчатая геометрия?
6. **Расшифровка кода `PV2`** в обозначении `SHT-PV2-L3000` (лист согласования заказа
   №2377, где `L3000` явно кодирует длину 3000 мм). Предположительно `PV2` — серия или
   диаметр шнека, либо код комплектации — не гадать, спросить напрямую.

## Блок C — вопросы масштаба и объёма дальнейшей работы (влияют на планирование, не на текущий пилот)

7. **Многосекционные сборки.** Найдена отдельная сборка `05.SHT.TR.00.00.00.00`
   (трёхсекционный вариант, ≈10897 мм, три «Отсека» через муфты) — то есть линейка Тех-Аэро
   определённо не сводится к односекционному пилоту. Полная параметризация длины
   потребует управления количеством экземпляров «Отсек+Шнек+Опора» на уровне сборки
   (паттерн/массив), а не только правки размера внутри одной детали, как в уже
   проведённом пилоте (Stage 7/13). Нужно ли это делать сейчас, в рамках текущего этапа,
   или это следующий этап после того, как заработает односекционный случай?
8. **Двухвальное исполнение** — в структуре опросного листа есть поле «Исполнение
   (одновальный/двухвальный)», но ни один из просмотренных CAD-файлов и заказов не
   двухвальный. Есть ли готовая модель двухвального исполнения, и стоит ли сейчас
   расширять карту параметров на него, или пока рано?
9. **Представительность пилота.** Пилотная модель 25.SHT (1 секция, найденные реальные
   заказы №2377 и №20214/№20210) — насколько это типичный случай для всей линейки
   Тех-Аэро, или есть существенно другие конфигурации, которые стоит сразу учитывать
   в архитектуре параметризации, чтобы не переделывать её потом?

## Для справки — что уже закрыто и спрашивать не нужно

Чтобы не тратить время Дмитрия Александровича на уже решённые пункты:
- Диаметр шнека 200 мм — подтверждён тремя независимыми источниками (пилот, заказ
  №2377, заказ №20214), это типовой размер стандартного ряда.
- Ширина крышки — раньше выглядело как открытый выбор между 268 и 323 мм; по реальным
  чертежам заказа №2377 обе величины оказались не шириной, а внутренними размерами
  эскиза (положение отверстий); настоящая ширина — 335 мм, одна и та же для обеих
  крышек. Вопрос закрыт.
- Толщина пластины перекладины (узел 09) — 4 мм по реальному чертежу заказа №2377,
  совпадает с базой уже проведённого параметрического эксперимента.
- Связь «резиновая проставка под крышкой = длина транспортера» (позиция 12 спецификации,
  3000×40×2 мм при заказанной длине 3000 мм) — первый подтверждённый образец связи
  «длина транспортера → длина конкретной детали» 1:1.
