hisp2k/parameters/engineering/SolidWorksCodex/TASK.md

# Текущая задача

## Синхронизация Codex После Обновлений Claude, 16.09.2026

Получены все шесть коммитов до `503808f` без конфликтов и перезаписи локальных файлов.
Изучены актуальный контракт переменных, Stage 13 и документы Stage 10-12.
На полученном EXE повторены 282 + 88 (с Interop) + 78 + 26 автономных проверок: PASS.
Живые CAD-операции в этой сессии NOT_RUN; результаты ниже принадлежат отчётам Claude.
Обновлена только информация: PROJECT_STATE.md, CLAUDE_HANDOFF.md, README_RU.md,
VALIDATION.md, TASK.md и описание существующего PR #1. Код и EXE не изменялись.
MCP-установка не заменялась. Бэкапы перед обновлением и перед commit/push обязательны.

## Актуально: Новый Инструмент sw_set_global_variable (Именованные Переменные)

По прямому указанию пользователя («продолжай дорабатывать задания Дмитрия Александровича»,
после свода вопросов ниже) начата реализация САМОЙ явной прямой формулировки Дмитрия
Александровича из стратегического брифинга: «нам нужно подменить числовые значения на
параметрические значения... не будет 2 стоять, а будет переменная». Это не эксперимент на
конкретном заказе, а системное расширение коннектора, работающее независимо от блока A
свода вопросов (не требует опросного листа/матмодели/BOM-версии/техно-калькулятора —
это инфраструктура, которая понадобится, когда те данные придут).

Добавлен новый write-инструмент `sw_set_global_variable` (`src/Protocol.cs`,
`src/SolidWorksReader.cs`): берёт тот же явно выбранный элемент/размер, что и уже
проверенный `sw_set_feature_dimensions` (`feature_name`/`expected_feature_type` из
`sw_features`, точный `full_name`/`expected_current_mm`), но вместо прямой записи числа
через `IDimension.SetSystemValue3` добавляет через `IEquationMgr.Add3` два уравнения:
именованную глобальную переменную (`"variable_name" = value_mm`, новое имя) и уравнение
самого размера, ссылающееся на неё (`"D1@Элемент@Файл" = "variable_name"`). Значение может
совпадать с текущим — смысл не обязательно менять число, а сделать его именованной
переменной, как прямо сказал Дмитрий Александрович. Уже управляемый уравнением размер и
уже занятое имя переменной — отклоняются явно (не перезаписываются молча). После
перестроения обе добавленные записи и итоговое значение размера перечитываются заново из
`IEquationMgr`/`IDimension` как отдельная проверка. При любом сбое после добавления обе
записи удаляются и размеру возвращается прежнее буквальное значение перед повторным
перестроением (тот же принцип отката, что и у `sw_set_feature_dimensions`). Подробности
и обоснование выбора API — см. новый раздел README_RU.md «Именованные Параметрические
Переменные (sw_set_global_variable)».

Офлайн-покрытие уже обновлено и находится в исходниках (числа тестов в файлах ещё не
пересчитаны сборкой на устройстве в этой сессии): валидация аргументов добавлена в
`src/Tests.cs` (нестандартный тип элемента, имя переменной с цифры/пробелом, лишний
аргумент, счётчик инструментов 34→35), `sw_set_global_variable` добавлен в обе generic-
проверки «неизвестное состояние сохранения»/«только для чтения» в
`TEST_WRITE_SAFETY_REGRESSIONS.ps1` (та же логика гейтинга, что у `sw_set_feature_dimensions`,
поэтому пустые аргументы там допустимы — ошибка выбрасывается раньше разбора аргументов),
и счётчик схем 34→35 в `TEST_ASSEMBLY_READ_REGRESSIONS.ps1`. `WorkerTimeoutMilliseconds`
получил тот же расширенный таймаут, что и `sw_set_feature_dimensions`.

**Обновление — живая проверка пройдена (этот шаг)**: код пересобран на Windows-устройстве
(`_claude_build_v4.cmd`, реальный `csc.exe`) и `sw_set_global_variable` проверен вживую на
реальной установке SOLIDWORKS, на уже существующей тестовой копии узла 09
(`Experiment_ebc977a34242`). Размер `D1@Бобышка-Вытянуть1@...01 Перекладина.Part` (228.8 мм)
превращён в настоящую именованную глобальную переменную SolidWorks `crossbar_length_mm`:
результат `ADDED_GLOBAL_VARIABLE_AND_LINKED_DIMENSION`, обе добавленные записи уравнений
перечитаны заново из `IEquationMgr` и подтверждены, тип/подавление элемента не изменились,
значение размера сохранилось (228.8 мм), число тел и объём геометрии не изменились, файл
сохранён с подтверждённым изменением SHA-256 (резервная копия создана заранее). Также
проверен безопасный путь отказа: повторный вызов на уже управляемом уравнением размере
корректно и безопасно отклоняется с `FEATURE_DIMENSION_NOT_DRIVING` ещё до создания
резервной копии/какой-либо мутации (без побочных эффектов при повторе). Дополнительно
родительская сборка (`...09.00.00.00 СБ  Перекладина съемная.SLDASM`) перестроена и
сохранена через `sw_test_document operation:"rebuild_save"`: `has_unsaved_changes:false`,
здоровье PASS (0 ошибок, 0 предупреждений, 6 сопряжений), объёмы и позиции обеих пластин
(`z=±0.1184 м`) не изменились — превращение буквального числа в переменную полностью
прозрачно для сборки.

В процессе живой проверки найдены и исправлены три реальных технических дефекта:
1. **`Protocol.cs`**: массив `Names` в `Catalog.Tools()` — новый инструмент был вставлен
   не в конец, что при позиционном сопоставлении с массивом `descriptions` вызывало
   `IndexOutOfRangeException` при любом запуске самотеста. Исправлено переупорядочиванием
   массива (`sw_set_global_variable` теперь стоит перед двумя специально обрабатываемыми
   завершающими инструментами `sw_test_pack_and_go`/`sw_test_document`).
2. **`SolidWorksReader.cs`**: реальная сигнатура `IEquationMgr.Add3` — 5 параметров
   (`Int32 Index, String Equation, Boolean Solve, Int32 WhichConfigurations, Object ConfigNames`),
   а не 3, как предполагалось по устаревшей памяти документации API. Найдено через
   диагностическое улучшение `Call()` (теперь при `TargetParameterCountException` сообщает
   реальный список параметров метода) — полезно для любых будущих reflection-вызовов COM.
3. **`SolidWorksReader.cs`**: `Add3` молча возвращал `-1` (отказ без исключения) при
   `WhichConfigurations = swThisConfiguration` на документе с одной конфигурацией; правильное
   значение для этого случая — `swAllConfiguration` (в единственном числе; `swAllConfigurations`
   во множественном не существует в этом enum и выбрасывает `API_ENUM_VALUE_MISSING`).

Офлайн-тесты пересчитаны и пройдены на пересобранном коннекторе: PASS 282+81+78+26
(protocol/assembly-read/write-safety/scoped-experiment), exit code 0.

**Статус**: `sw_set_global_variable` — рабочий, проверенный вживую write-инструмент.
Следующий системный шаг по-прежнему упирается в блок A свода вопросов (см. ниже) — без
реальных данных заказчика (опросный лист/матмодель/BOM) дальше переводить конкретные
числа сборок в переменные означает либо ждать ответа Дмитрия Александровича, либо
самостоятельно изобретать данные, что запрещено правилами проекта.

## Свод Вопросов К Дмитрию Александровичу (предыдущий шаг)

По прямому указанию пользователя («продолжай с учётом желаний Дмитрия Александровича»)
собран единый список открытых вопросов по всем стадиям Stage 3–13 — см.
`QUESTIONS_FOR_DMITRY_ALEXANDROVICH_RU.md`. Это не новое CAD-исследование, а свод уже
накопленных, ранее разрозненных по разным статус-файлам открытых пунктов, готовый к
пересылке Дмитрию Александровичу. Технически параметризация уже доказана рабочей
(Stage 7/8/13); дальнейшее системное продвижение (по формулировке Дмитрия Александровича
— «заменить числа на именованные переменные») упирается именно в блок A этого списка
(опросный лист+матмодель, BOM-версия сборки, инженерное ядро шнекового расчёта,
алгоритм «ИИ-технолог») — без реальных данных это либо ожидание ответа, либо
самостоятельное изобретение того, что явно запрещено правилами проекта.

## Изменение Длины Перекладины Узла 09 И Проверочный Чертёж (предыдущий шаг, исторический)

См. STAGE13_CROSSBAR_LENGTH_EXPERIMENT_RU.md. Тестовый комплект на этой машине
физически находится по адресу `G:\Mine\Desktop\SolidWorksCodex-Git\25.SHT.G.00.00.00.00 СБ`
(старый путь `C:\Users\adm\...` из более ранних сессий на этой машине не существует).
`TestScope.local.json` пересоздан с верным `test_root`.

Управляющий размер `D1@Бобышка-Вытянуть1@...Перекладина.Part` изменён 208 -> 228.8 мм
(+10%, тестовое значение; вход эксперимента назван `crossbar_length_mm`, НЕ равен
длине транспортёра из опросного листа D25). После rebuild_save обе пластины сдвинулись
симметрично на ±10.4 мм (ровно половина прироста длины) — существующая геометрическая
зависимость подтверждена корректной, отдельно чинить её не потребовалось. 6 сопряжений,
0 ошибок/предупреждений, до и после. Изменение подтверждено после закрытия и чистой
перезагрузки сборки с диска (`fresh_open: OPENED_CLEAN`).

Критичное исправление коннектора в этой сессии: `assembly_position_xyz_m` в `TestAudit`
раньше ВСЕГДА возвращал null (баг Call/Get для COM-свойства `Transform2`) — без этой
правки проверить позицию пластин, как того явно требовало задание, было невозможно.
Добавлено поле `issues` в ответ `TestAudit` для видимости будущих подобных сбоев.

Оригинальный чертёж `Чертежи\Детали\25.SHT.G.09.00.00.01  Перекладина.SLDDRW` найден,
но Pack and Go с `include_drawings=true` не скопировал чертёж дочернего компонента
(похоже, копирует чертёж только самого пакуемого верхнеуровневого документа).
Применён предусмотренный заданием запасной путь: создан новый проверочный чертёж
через `sw_create_drawing` на изменённой копии детали (3 вида, 5 размеров, среди них
228.80 мм), экспортирован в PDF и визуально проверен — размер виден верно, наложений
и обрывов выносных линий нет.

OFFLINE_PASS после пересборки: 276 + 81 + 74 + 26 = 457, exit code 0.
Не выдавать этот эксперимент за допуск к производству и не путать
`crossbar_length_mm` с длиной транспортёра. Ниже — предыдущий актуальный статус
(эксперимент по толщине пластины), теперь исторический.

## Полный Эксперимент На Копии Узла 09 (Толщина Пластины, Исторический)

Новое явное разрешение пользователя отменило режим «только исследование» внутри
Desktop\25.SHT.G.00.00.00.00 СБ, не для внешних ссылок. См. SCOPED_PARAMETRIC_EXPERIMENT.md.
Вариант Experiment_26333854d6ac: пластина 4 -> 5 мм, один solid, объём +25%,
оба экземпляра в нативной подсборке обновлены; 6 сопряжений без ошибок/предупреждений.
Сохранение и настоящая выгрузка/повторная загрузка подтверждены LIVE_PASS.
Корневой транспортёр не перестраивался; 116 исходных CAD-файлов не изменены.
Добавлены только scoped Pack and Go и lifecycle/audit для разрешённого комплекта.
Обычные запреты записи сборок/сети/PDM сохранены; исключение требует TestScope.local.json.
OFFLINE_PASS: 276 + 81/88 + 74 + 26. Использовать EXE репозитория, не старую MCP-установку.
Доказательства: SCOPED_EXPERIMENT_FULL_RUN.json, SCOPED_EXPERIMENT_FINAL.json,
SCOPED_ORIGINAL_FILES_VERIFIED.json. Сценарий: RUN_SCOPED_PARAMETRIC_EXPERIMENT.ps1.
Изменены .gitignore, BUILD.cmd, src/{Protocol,Program,SolidWorksReader,TestExperiment,Tests}.cs,
tests/AssemblyReadFixtures.cs, TEST_ASSEMBLY_READ_REGRESSIONS.ps1,
TEST_SCOPED_EXPERIMENT.ps1, сценарий, EXE, отчёт и документы передачи.
Следующая содержательная задача требует реальных входных данных/формул опросного листа;
не выдумывать их и не начинать сторонний аудит. Ниже исторические сведения.

## Первый Нативный Параметр Проверен

См. NATIVE_PART_PILOT.md и NATIVE_PART_LIVE_RESULT.json / NATIVE_PART_LIVE_RETURN.json.
На разрешённой пользователем копии `Desktop\25.SHT.G.00.00.00.00 СБ` выполнен
живой цикл толщины Пластины узла 09: 4 → 5 → 4 мм, перестроение, бэкап и сохранение.
Итог 4 мм, 1 тело, исходный объём; остальные 113 проверенных CAD-файлов не изменены.
Исправлены enum IDimension.GetType и отсутствие Extrusion в MCP JSON Schema.
OFFLINE_PASS: 263 + 81 (88 с Interop) + 74. LIVE_PASS: обе записи; reopen NOT_RUN.
Установленный EXE обновлён, SHA совпадает с repo. MCP чата требует переподключения.
Следующий шаг: определить контракт опросного листа/расчёта для найденного CAD-параметра.
Не выдумывать формулы и не разрешать запись сборок, PDM, сети или эскизов.
Изменены: src/Protocol.cs, src/SolidWorksReader.cs, src/Tests.cs,
tests/AssemblyReadFixtures.cs, TEST_ASSEMBLY_READ_REGRESSIONS.ps1,
TEST_WRITE_SAFETY_REGRESSIONS.ps1, SolidWorksLocal.exe, NATIVE_PART_PILOT.md,
NATIVE_PART_LIVE_RESULT.json, NATIVE_PART_LIVE_RETURN.json, TASK.md,
PROJECT_STATE.md, CLAUDE_HANDOFF.md, CHANGELOG.md, VALIDATION.md, README_RU.md,
PARAMETRIC_PILOT_RESEARCH.md. Исторические сведения ниже не заменяют этот статус.

## Исследование существующей модели, 15.09.2026

Текущий приоритет: опросный лист → расчёт → параметры существующей
нативной модели → вариант → чертежи и технологические данные.
PDF-to-CAD временно не является приоритетом.

Сохранены PARAMETRIC_PILOT_RESEARCH.md и .json. Предварительный кандидат:
узел 09 «Перекладина съёмная», деталь 09.00.00.02 «Пластина».
Файловые связи и свойства подтверждены live; точный driving dimension
не подтверждён: все пять подсборок отказали ASSEMBLY_ALREADY_OPEN_NOT_READONLY,
а sw_features/sw_parameters на активной сборке вернули PART_REQUIRED.
Запрошена ручная активация Пластины без перестроения; CAD не изменять.
Не выдавать свойство «Лист 4» за управляющий размер и не изобретать формулу.

## Аудит перед передачей Claude, 15.09.2026

Исправлены ошибки коннектора, не CAD-ссылки. Подробности: CLAUDE_HANDOFF.md.
Первый запуск новых регрессий на cb5c28c воспроизвёл 23 нарушения.
Итог: 262 основных + 82 чтение/STDIO/Interop + 47 write-safety, PASS.
Переносимая сборка: 262 PASS. BUILD.cmd включает обе группы регрессий.

Основные исправления:
- UNKNOWN dirty/read-only/подавление не разрешает изменение.
- Внутреннее сохранение не выбирает новый IActiveDoc2; объект, путь, имя,
  тип и конфигурация проверяются. Смена цели блокирует и опасный откат.
- Явное сохранение всегда с бэкапом; failed rebuild свойств не сохраняется.
- Размер по FullName должен принадлежать выбранному элементу.
- Известный угловой AI_* отклоняется; fallback известной линейной схемы
  допускается только при dimension_type_code=0.
- Варианты используют общий inventory скрытых размеров и SHA-256 копии.
- Ожидание mutex не сокращает COM-бюджет; feature edit получает длинный лимит.

Новый EXE проверен live только на status/document/equations.
Живое изменение деталей этой итерацией не подтверждено.
Установленный MCP EXE не заменялся; Claude должен использовать EXE репозитория.

Изменённые файлы: BUILD.cmd, src/Program.cs, src/SolidWorksReader.cs,
src/Tests.cs, tests/AssemblyReadFixtures.cs, TEST_WRITE_SAFETY_REGRESSIONS.ps1,
SolidWorksLocal.exe, TASK.md, PROJECT_STATE.md, CHANGELOG.md, CLAUDE_HANDOFF.md.

Версия исходников: 2.5.0
Ветка разработки: claude/director-parametric-pilot
Цель: связать опросный лист и расчёт с управляющими параметрами существующей
нативной модели, вариантами, чертежами и технологическими данными.

## Исправления после ревью директорского пилота

- `sw_component_details`: масса, объём и площадь возвращаются только при
  совпадении активной конфигурации документа с конфигурацией экземпляра до и
  после чтения. Иначе `mass_properties=null`, статус `UNKNOWN`, причина в
  `issues`; переключения конфигураций нет.
- `sw_component_details` и `sw_assembly_tree`: `IsVirtual` читается как свойство.
- `sw_equations`: область действия читается методом `GetConfigurationOption`.
  Имена конфигураций остаются явно `UNKNOWN`: соответствующего getter в API нет.
- Проверка корня сборки сопоставляет полные нормализованные пути из пар
  имя/путь API. Одноимённые файлы из других каталогов не создают ложных связей.
  Неполные ответы отклоняются; сценарий использует собственный каталог и
  возвращает ненулевой exit code при FAIL.
- **`OpenDoc6` (открытие read-only, `sw_open_assembly_readonly`)**: разделены
  два разных исхода. Если `OpenDoc6` не вернул документ — это настоящий
  `OPEN_FAILED`. Если документ реально открылся, но SOLIDWORKS сообщил
  `errors != 0`, результат доступен только при подтвержденном read-only:
  `OPENED_WITH_LOAD_ERRORS`, сырые `errors`/`warnings` сохранены. Обычное
  открытие детали с ошибками останавливается с `OPEN_LOAD_ERRORS`.
  При `errors=0`, `warnings!=0` чтение возвращает `OPENED_WITH_WARNINGS`;
  `OPENED_CLEAN` означает строго оба нулевых кода.
- Создание варианта требует чистой загрузки как исходника, так и копии:
  ошибки и предупреждения блокируют продолжение до изменения параметров.
  Проверяется фактический тип через `IModelDoc2.GetType`; read-only операция
  завершается ошибкой, если `IsOpenedReadOnly` вернул false или недоступен.
- Проверено: сборка .NET Framework x64 и 258 offline-проверок; portable-сборка
  `PORTABLE_TEST` через встроенный Roslyn PowerShell и те же 258 проверок;
  79 проверок чтения сборки, зависимостей, исхода `OpenDoc6`, блокировки
  создания варианта и реального STDIO-процесса; с `-InteropPath` выполняются
  ещё 3 проверки установленной DLL, всего 82
  (`TEST_ASSEMBLY_READ_REGRESSIONS.ps1`).
- Регрессионный сценарий принимает `-ConnectorPath` и необязательный
  `-InteropPath`. Без параметров проверяет `SolidWorksLocal.exe` рядом со скриптом.
- LIVE_NOT_RUN (сборка/юнит-тесты): реальные документы SOLIDWORKS не
  открывались и не изменялись в рамках `BUILD.cmd` /
  `TEST_ASSEMBLY_READ_REGRESSIONS.ps1`. Тестовые сборки находятся в
  `bin/load-safety`; EXE в репозитории пересобран и проверен. Установленный
  коннектор Codex не заменялся. Новые ограничения проверены offline;
  создание геометрии этим запуском не подтверждено. Полный локальный бэкап
  файлов и Git выполнен и проверен до правок.

### Живая проверка на пилотной сборке (`25.SHT.G.00.00.00.00 СБ  Транспортер.SLDASM`)

Только чтение, без изменения документов; ничего не сохранялось и не закрывалось.

Ниже сохранены результаты сессии Claude (495 экземпляров, 38 зависимостей).
Отдельный локальный отчет Codex по сборке из каталога «СБ Изм.5» содержит
516 экземпляров, 41 прямую зависимость и 4 отсутствующих файла по полным
путям. Эти снимки нельзя объединять или считать опровержением друг друга
без совпадающих полного пути, конфигурации и SHA-256 файла.

- **LIVE_PASS** — полное рекурсивное дерево компонентов активной корневой
  сборки (`sw_assembly_tree`, постранично, 495 экземпляров всего): ни одного
  `IsVirtual=true` компонента не найдено.
- **LIVE_PASS** — уравнения корневой сборки (`sw_equations`): count=0
  (реальный результат, не ошибка).
- **LIVE_PASS** — прямые зависимости корневой сборки (`sw_document_dependencies`,
  `GetDocumentDependencies2`): сырой `dependency_count=76`, но это **не** 76
  разных файлов — API возвращает каждую зависимость дважды подряд (сначала
  как короткое неразрешённое имя ссылки без пути и расширения, затем как
  полностью разрешённый путь), т.е. **38 уникальных прямых зависимостей**.
  Все 38 подтверждены присутствующими на диске (`Test-Path`) — **пропавших
  файлов нет**. (Предыдущая формулировка «38 отсутствующих файлов» неверна —
  это дубликаты тех же 38 присутствующих файлов в неразрешённом виде.)
- **LIVE_NOT_RUN** (честно не выполнено, не «PASS» и не «FAIL») — проверка
  уравнений/конфигураций для 5 кандидатов-подсборок
  (`25.SHT.G.02.00.00.00 СБ`, `01`, `03`, `06`, `09`): все 5 уже открыты в
  текущей сессии SOLIDWORKS как часть дерева корневой сборки, но не
  подтверждены read-only, поэтому `sw_open_assembly_readonly` корректно и
  безопасно отказал (`ASSEMBLY_ALREADY_OPEN_NOT_READONLY`) вместо того чтобы
  закрывать/переоткрывать чужой документ — это ожидаемое, правильное
  поведение по правилу «не закрывать документы пользователя», а не дефект.
- Семантика пагинации сохранена: `truncated` означает, что отдельный ответ
  не содержит весь список, поэтому допустим true и на последней странице.
  Окончание обхода определяется только `next_offset == null`.

## Выполнено в геометрической итерации

- Добавлен ProfilePartPlan v2 для прямоугольной/квадратной и круглой трубы.
- Сохранена обратная совместимость ProfilePartPlan v1 для уголка.
- Для прямоугольной трубы добавлены явные радиусы с постоянной толщиной стенки.
- Добавлены отверстия через две противоположные стенки face_a/face_b.
- Добавлены аналитические проверки площади сечения, объёма вырезов и цилиндров.
- Добавлен ProfilePartPlan v3: продольные овальные пазы на полках уголка и
  плоских гранях прямоугольной трубы, явным списком либо линейным массивом.
- Добавлены проверки границ и пересечений отверстий/пазов, объёма и
  цилиндрических поверхностей концов пазов.
- Обновлены MCP JSON Schema, offline-тесты, версия исходников и документация.

## Что проверить на Windows

1. Выполнить BUILD.cmd.
2. При одном открытом SOLIDWORKS 2026 выполнить offline self-test.
3. Выполнить CREATE_TEST_PROFILE_PARTS_2_5.cmd: создать rectangular_tube
   40x40x4x260 с двумя D18, round_tube D33.7x3x262 и rectangular_tube
   40x40x4x500 с двумя пазами 90x13.
4. Сверить объём, одно тело, цилиндрические грани и внешний вид.
5. Только после PASS заменить устанавливаемый SolidWorksLocal.exe.

## Следующий геометрический приоритет

- косой/угловой рез торца;
- торцевые фаски круглой и прямоугольной трубы;
- поперечные пазы и боковые отверстия круглой трубы с угловой базой;
- затем швеллер и гнутые листовые детали.

Нельзя считать созданную модель производственно одобренной без проверки
человеком. manufacturing_approved=false.
