hisp2k/parameters/engineering/transporter-calculators/SCREW_SOURCE_NOTES.md

# Шнековый транспортер — сведения для интеграции

Источник: чат «Шнековый транспортер проектирование», ID 6a8820ac-e80c-83eb-af11-73a94230d785. Извлечено 06.09.2026.

**Статус: сведения из переписки. Вложения, формулы Excel, чертежи и STEP в этой задаче не получены и независимо не проверены. Эти данные не включены в действующий расчёт.**

## Два самостоятельных семейства

| Показатель | 25.SHT.G | 24.SHT.G |
|---|---:|---:|
| Диаметр шнека | 200 мм | 300 мм |
| Шаг | 200 мм | 300 мм |
| Длина | винтовая часть 2873 мм; шнек с осями 3165,5 мм | изделие около 6100 мм; трубчатый вал около 5994 мм |
| Конструкция | модуль корпуса 3000 мм | отдельное длинномерное семейство; вал Ø121×8 |
| Витки | требуется исходная деталировка | 20 полных + 1 подрезанный, толщина 4 мм |
| Строк состава | 85 = 12 сборок + 46 MAKE + 27 BUY | 118 = 1 изделие + 11 сборок + 74 MAKE + 32 BUY |
| Трудоёмкость, чел·ч | 143,233 | 312,907 |
| Работа оборудования, станко-ч | 80,648 | 152,74 |

Все числа выше сообщены в чате; для активного эталона нужны исходные таблицы. У типа 24 указаны 23 уникальные закупочные позиции при 32 BUY-строках. Тип 05 (~10000 мм) упомянут как следующий эталон, но не как завершённая модель.

## Что уже было проработано

В переписке описаны опросный лист, инженерные зависимости, параметрический состав, материалы и закупки, операционный труд, работа оборудования, себестоимость и калибровка. Последняя описанная версия — v11, с импортом КД/ERP, проверкой материалов и масс и использованием утверждённых ставок.

Для 24.SHT.G перечислены 12 групп операций: лазер, лентопил, зачистка, сварка, РТИ, сверление/резьбы, сборка, токарная, фрезерная, формирование витков, подготовка к окраске, окраска. Полной построчной таблицы времён в доступных сообщениях нет.

Норма формования 0,084 ч/перо относится только к D300 / P300 / S4 / AISI 316. При иной геометрии или материале она не становится автоматически производственной нормой.

## Расхождения и ограничения

- 24 нельзя считать одним коэффициентом длины от 25: конструкция и распределение труда различаются.
- Для 25 в чате перечислены пять расхождений крепежа между BOM и STEP. Подробности сохранены в JSON; автоматически исправлять спецификацию по модели нельзя.
- 63,16 кг относится к сборке шнека 25, а не ко всему транспортеру; 62,76 кг — оценка STEP при плотности стали 7850 кг/м³.
- Для 24 значения 294,087 кг, 338,200 кг с отходами и около 111 916 ₽ относятся к известной части массы/материалов из v10. Это не полная масса и не себестоимость готового изделия.
- В последнем сообщении v11 заявлены 2/10 пройденных проверок, то есть готовность промышленного эталона не подтверждена.
- AISI 316, 316L и 316Ti не взаимозаменяются автоматически. Подтверждение материала должно относиться к конкретной детали и ревизии КД.
- Историческое правило цен «Металлсервис ×1,25» не подтверждает актуальность старых цен и налоговый базис. Его нельзя складывать с повторной наценкой на тот же источник.
- Необходимо разделять подачу с контролируемым расходом и работу шнека-питателя под бункером.
- Нормативные ссылки переписки требуют отдельной проверки до использования как актуальных требований.

## Следующий шаг интеграции

Получить XLSX v11 (или фактическую последнюю редакцию) и исходный состав. Сначала восстановить два эталона и воспроизвести построчные затраты, затем добавлять параметрический пересчёт в веб-приложение. Человеко-часы и станко-часы учитывать отдельно, проверив, не входит ли труд оператора уже в машинную ставку.

Вложения чата инструмент чтения не предоставил. В локальной папке sources/ файлов нет; в D:/CodexProjects найден только пакет ленточного/роликового калькулятора и калькуляция ЛК 7000×500. Шнековый XLSX/BOM/STEP там не найдены.

Машиночитаемая запись: screw_reference_profiles.json. История сообщений сама по себе не заменяет 85/118 строк исходного состава и формул v11.
