hisp2k/parameters/grit-chambers/PT-SHT-10/deliverables/PT-SHT-10_актуальный_гидравлический_режим.md

# PT-SHT-10 — актуальный гидравлический режим

3 октября 2026 г. Актуальные исходные данные пользователя: **10 м³/сут**, равномерный приток в расчётный пиковый час **2,09 м³/ч**, максимальный расход за отдельную секунду **2 л/с**, целевая средняя скорость на входе Ø51 мм **около 1,36 м/с во время работы песколовки**. Ранее обсуждавшийся 40-минутный режим исключён из расчёта. Пиковый секундный расход трактуется как кратковременное отклонение от ровной подачи в часе; длительность и частота таких отклонений не заданы.

## Проверка входа Ø51 мм

Площадь сечения `A = π × 0,051² / 4 = 0,00204282 м²`; скорость `v = Q/A`.

| Режим | Расход | Скорость в Ø51 мм при прямой подаче |
|---|---:|---:|
| Средний за сутки | 0,4167 м³/ч = 0,1157 л/с | 0,0567 м/с |
| Равномерный приток в пиковый час | 2,09 м³/ч = 0,5806 л/с | 0,2842 м/с |
| Максимум за одну секунду | 7,2 м³/ч = 2 л/с | 0,9790 м/с |
| Требуемая регулируемая подача в существующий вход | 10 м³/ч = 2,7778 л/с | 1,3598 м/с |

Прямой приток во всех трёх режимах ниже заданной скорости. Чтобы сохранять около 1,36 м/с на существующем входе во время работы, нужен **приёмный буфер и регулируемая подача около 10 м³/ч**. Насос должен обеспечивать этот расход при фактическом напоре, включая потери в трубопроводе и песколовке. При суточном объёме 10 м³ суммарное идеальное время такой подачи равно **1 часу в сутки**; в расчётный пиковый час с 2,09 м³ — **12,54 минуты**, если уровень буфера в начале и конце часа одинаков.

Подача 2,7778 л/с больше заданного секундного максимума входа 2 л/с. Поэтому при работающем насосе объём буфера уменьшается даже в секунду максимального притока: разница составляет **0,7778 л/с**. Во время остановки он наполняется; автоматика и свободный борт должны учитывать задержку включения и кратковременные пики.

## Рабочий объём буфера и число пусков

Окончательный рабочий объём **не определяется** только по суточному и часовому расходам: нужны допустимое число пусков насоса за час, минимальное время включения и задержка автоматики. При демонстрационной схеме «включить на верхнем уровне, выключить на нижнем», непрерывном притоке 2,09 м³/ч и подаче насоса 10 м³/ч расчётная частота пусков зависит от рабочего перепада объёма `V`:

`N = 1 / [V/2,09 + V/(10−2,09)]`, где `V` в м³, `N` в пусках/ч.

| Рабочий перепад уровня | Расчётная частота при ровных 2,09 м³/ч |
|---:|---:|
| 0,20 м³ | 8,27 пуска/ч |
| 0,30 м³ | 5,51 пуска/ч |
| 0,50 м³ | 3,31 пуска/ч |

Это **полезный перепад между уставками**, а не геометрический объём бака: к нему добавляют недоступный остаток, объём осадка и свободный борт. Таблица не учитывает секундные пики из-за отсутствия их длительности и расписания. Число допустимых пусков и рабочий напор нужно взять из характеристик выбранного насоса.

### Предварительный выбор объёма ёмкости

Паспорт насоса пока отсутствует. Для предварительной компоновки принято **не более 4 пусков за расчётный пиковый час** при непрерывном притоке 2,09 м³/ч. По формуле выше требуемый рабочий перепад между уставками `V ≥ 2,09 × (10−2,09) / (10 × 4) = 0,4133 м³`. Рабочий перепад округлён до **0,50 м³**, что даёт 3,31 пуска/ч в установившемся цикле. Наполнение от нижней уставки до верхней занимает 14,35 мин, откачка при продолжающемся притоке — 3,79 мин. При полном прекращении притока 0,50 м³ обеспечивают 3,00 мин работы насоса 10 м³/ч.

Предлагаемый **предварительный геометрический объём отдельной приёмной ёмкости — 0,70 м³ (700 л)**:

| Зона | Принятый объём |
|---|---:|
| Нижний остаток ниже уровня выключения, включая резерв для всасывания и осадка | 0,10 м³ |
| Рабочий перепад между включением и выключением | 0,50 м³ |
| Верхний запас над уровнем включения | 0,10 м³ |
| **Итого до конструктивного верха ёмкости** | **0,70 м³** |

При верхнем запасе 100 л и притоке 2 л/с без откачки остаётся **50 с до заполнения этого запаса** после достижения уровня включения. Это проверка реакции автоматики, а не запас на отключение электричества. Если требуется удерживать стоки при аварии насоса, нужен отдельный расчёт по допустимому времени простоя и притоку. Нижние и верхние 100 л являются принятыми компоновочными резервами, а не измеренными объёмами существующего бункера.

После выбора насоса проверить допустимое число пусков, минимальный уровень для устойчивого всасывания, фактическую подачу **10 м³/ч при рабочем напоре** и объём осадка. Если паспортные ограничения строже принятых, ёмкость увеличить. Для пескосодержащих стоков предусмотреть очистку или перемешивание приёмной ёмкости, иначе частицы могут осесть до песколовки. Подход к расчёту полезного объёма через частоту пусков и отделение объёма ниже нижнего уровня описан в [руководстве Grundfos по насосным станциям](https://api.grundfos.com/literature/Grundfosliterature-5564777.pdf); учёт отложений и перемешивания в усреднителе описан в [руководстве EPA](https://nepis.epa.gov/Exe/ZyPURL.cgi?Dockey=9400AA3C.TXT).

## Связь с CAD и CFD

Вход Ø51 мм существующего бункерного узла можно оставить для исследования с подачей 10 м³/ч. Приёмный буфер находится **перед песколовкой**; объём жидкостной полости CAD-модели 0,162543 м³ нельзя считать его полезным объёмом. [Привязка существующего расчёта к CAD](PT-SHT-10_привязка_расчёта_к_модели.md).

Это пересчёт расходов и скоростей, **не результат нового решения Flow Simulation**. Сохранение входной скорости не подтверждает удержание песка или цель 60% для частиц до 0,25 мм. Для проверки нужны расчёт воды и частиц на рабочей точке 10 м³/ч, анализ пусков/остановов и сеточная сходимость.
