hisp2k/parameters/grit-chambers/PT-SHT-10/deliverables/PT-SHT-10_аудит_и_карта_расчёта.md

# PT-SHT-10, заказ № 2418: аудит модели и карта гидравлического расчёта

**Статус на 29.09.2026:** расчёт в SOLIDWORKS Flow Simulation не выполнен. Представленные ниже размеры сняты с рабочей копии сборки через SOLIDWORKS API; скорости в таблице вычислены только как расход, делённый на геометрическое сечение. Полей скорости и давления, сетки, траекторий песка и подтверждённой эффективности нет.

## 1. Источники и целостность модели

- Из заказа № 2418.1 от 15.09.2026: один аппарат, 10 м³/ч, DN50 на входе, DN65 на выходе, корпус и шнек AISI 304, двигатель 1,1 кВт, габариты 4000 × 1500 × 3000 мм. Частота вращения шнека отсутствует.
- Лист согласования «ЛС.pdf» содержит справочные размеры 2265 × 750 × 2720 мм и высоту выгрузки 1500 мм. Это изображение полной установки со шнеком и приводом, а не рабочие размеры камеры. Расхождение с заказом требует уточнения актуальной ревизии.
- Доступная главная модель — только сборка «Бункер в сборе», без полной сборки шнека, мотор-редуктора и подводящей/отводящей сети.
- Создана отдельная рабочая копия модели и двух документов. В сборке разрешены все 85 вхождений компонентов: 0 отсутствующих и 0 подавленных. Активная конфигурация — «По умолчанию»; все найденные компоненты ссылаются на файлы рабочей копии. Проверены 33 файла SOLIDWORKS: ошибок открытия и перестроения верхнеуровневых элементов не выявлено. Предупреждение открытия 128 при повторном вызове означает, что файл уже открыт, согласно перечислению SOLIDWORKS API.
- Габаритный параллелепипед доступной сборки: **913 × 1379 × 913 мм** по осям X × Y × Z, включая крышку и опоры. Он не сопоставим напрямую с габаритами всей установки.

## 2. Измеренная геометрия, не заменяемая пустой ёмкостью

Координаты Y ниже даны в системе главной сборки, мм. Это модельные отметки, а не высоты над уровнем пола. Диаметры внутренних проходов сняты с цилиндрических поверхностей деталей; номинальные DN сами по себе для расчёта не использовались.

| Узел | Геометрия по модели | Площадь прохода / замечание |
|---|---:|---:|
| Входная труба | наружный Ø57, внутренний **Ø51**; ось примерно Y=720; диапазон детали X=223…280, Z=99…330 | **0,002043 м²** |
| Внешний цилиндр камеры | наружный Ø600, внутренний **Ø594**; Y=383…833 | Площадь круга 0,2771 м², до вычета внутренних тел |
| Внутренний цилиндр | наружный **Ø400**, внутренний Ø394; Y=383…813 | Кольцо между радиусами 297 и 200 мм: **0,15145 м²**, лишь номинальное поперечное сечение |
| Верхняя область внутреннего цилиндра | верх Y=813; низ крышки примерно Y=836 | 23 мм вертикального разнесения; гидравлический проход требуется проверить с прокладкой и соседними деталями |
| Обратный конус | габарит Ø300 × 140 мм; Y=243…383 | Внутреннее препятствие/направляющий элемент; форму и действующий зазор нельзя заменить конусом идеальной формы |
| Нижний конус | габарит до Ø600; Y≈33…385 | Сложная фактическая поверхность, объём приёмка и минимальные проходы ещё не измерены |
| Нижний отвод | наружный Ø108, внутренний **Ø102**; Y=3…33 | **0,008171 м²**; связь со шнеком не представлена |
| Выходной патрубок | наружный Ø76, внутренний **Ø70**; вертикальная внутренняя труба Y=558…788, затем колено и внешняя труба до Z≈350 | **0,003848 м²**; выпуск погружён внутрь цилиндра, а не просто отверстие в стенке |

Внешний цилиндр, внутренний цилиндр, обратный конус, входная труба и два участка выходной трубы присутствуют в сборке. Расположение задаёт кольцевое движение и возможность короткого пути к погружённому выпуску. Герметичность жидкостной области, изолированные полости, объёмы воды и пескового приёмка пока **не проверены** средствами Flow Simulation. Отметки не доказывают, что все видимые зазоры реально открыты потоку.

## 3. Проверяемые арифметические величины, не CFD

В таблице использованы Ø51 и Ø70 мм, измеренные на деталях, и неизменные проходы. Средняя скорость Q/A не показывает локальные скорости, закрутку, подпор или потери напора. Масса песка вычислена **только для демонстрационного сценария** 100 мг/л.

| Q, м³/ч | Q, л/с | Q/A входа, м/с | Q/A выхода, м/с | Q/A номинального кольца, м/с | Песок на входе, кг/ч |
|---:|---:|---:|---:|---:|---:|
| 2 | 0,556 | 0,272 | 0,144 | 0,00367 | 0,2 |
| 5 | 1,389 | 0,680 | 0,361 | 0,00917 | 0,5 |
| 10 | 2,778 | 1,360 | 0,722 | 0,01834 | 1,0 |
| 15 | 4,167 | 2,040 | 1,083 | 0,02751 | 1,5 |

Для демонстрации при 10 м³/ч и долях фракций 0,15/0,30/0,60 мм = 20/50/30 % входные массы составляют соответственно 0,2/0,5/0,3 кг/ч. Плотность частиц 2650 кг/м³ также является допущением, а не характеристикой стока.

## 4. Причина остановки вычислительного этапа

На компьютере установлены SOLIDWORKS 2026 и Flow Simulation. Главная сборка открывается через API без ошибки. Загрузка зарегистрированной `FW03.dll` **после открытия сборки** дважды дала COM HRESULT **0x80010105** («ошибка на сервере»). Журнал Windows `Application Error`, событие 1000 от 29.09.2026 19:49:33, зафиксировал сбой `sldworks.exe` в `FW03.dll` с кодом **0xC0000005** и смещением `0x2385D6`. Путь регистрации DLL существует, цифровые подписи `sldworks.exe` и `FW03.dll` действительны.

Повторная проверка в новом экземпляре установила зависимость от последовательности действий: **сначала загрузить Flow Simulation, затем открыть рабочую копию сборки** — `LoadAddIn` вернул 0 (успех), модель открылась с кодом ошибки 0, надстройка сохранила активность. Она также успешно загрузилась в пустом экземпляре без модели. Следовательно, Windows 10 нельзя считать установленной причиной именно этого COM-сбоя. Загрузка после открытой сборки или состояние прежнего сеанса остаются возможными факторами; точный дефект внутри `FW03.dll` не установлен.

Система — **Windows 10 Pro 22H2, build 19045**, SOLIDWORKS — **2026, 34.3.2.3**. По [официальным системным требованиям SOLIDWORKS](https://www.solidworks.com/support/system-requirements) последняя версия с поддержкой Windows 10 — SOLIDWORKS 2025 SP5. Это отдельный риск поддержки и воспроизводимости, но успешная загрузка Flow в той же системе показывает, что он не является достаточным объяснением наблюдённой ошибки.

В открытой сборке API Flow Simulation вернул `Projects = None`: сохранённого проекта исследования нет. Проект, сетка и решение в ходе проверки не создавались и не запускались. Для новой физически обоснованной постановки требуются условия подпора/уровня на выходе и режим заполнения. Доступность лицензии для полного вычисления и совместимость свободной поверхности, нестационарного режима и Particle Study остаются непроверенными.

## 5. Карта настройки исследования после восстановления Flow Simulation

1. **Проверка области.** Открыть рабочую копию. Создать конфигурацию для CFD, сохранив все контактирующие с жидкостью внутренние элементы. Закрыть только реальные присоединительные плоскости крышками Flow Simulation. Проверить клапанные/вентиляционные отверстия, прокладку крышки, контакт нижнего отвода со шнеком и изолированные полости через проверку герметичности. Назначить материалы и исключить из сетки лишь внешние крепежи и опоры, не влияющие на жидкость. Измерить объём жидкости и объём нижнего приёмка.
2. **Режим заполнения.** По схеме фактического подключения выяснить, есть ли вентиляция, открытая нижняя ветвь и гарантированный подпор. При свободной поверхности — двухфазная постановка вода/воздух с гравитацией по −Y, фактическим начальным уровнем и физической границей воздуха. Если аппарат всегда полностью затоплен, обосновать однофазную напорную постановку. Одна лишь глухая крышка не доказывает напорный режим.
3. **Границы.** Вода 20 °C для первого приближения; реальные температура, плотность и вязкость стока должны быть получены отдельно. На входе задавать 2, 5, 10, 15 м³/ч по отдельным исследованиям. На выходе задавать давление/гидравлический уровень из условия отводящей сети. Не задавать атмосферное давление всем отверстиям. Нижнюю границу сначала закрыть для режима накопления; отдельный вариант с отводом пульпы допускается только при известном расходе, давлении и геометрии узла. Вращение всему бункеру не назначать.
4. **Течение.** Включить гравитацию и модель турбулентности, доступную в Flow Simulation; зафиксировать её параметры. Проверить стационарное установление и, если требуется свободная поверхность или колебания закрутки, нестационарный расчёт. При несовместимости функций выполнить гидравлику с расчётом уровня отдельно и Particle Study на выбранном поле потока, указав, что односторонний перенос не учитывает обратное влияние частиц и изменение уровня.
5. **Сетка.** Построить минимум три сетки M1/M2/M3 с усилением в зоне входа, около обоих цилиндров и обратного конуса, в минимальных зазорах, в погружённом выпуске и в нижнем приёмке. Размер ячейки в каждом зазоре выбирать по фактической минимальной ширине, сначала не менее 5/8/12 ячеек поперёк для M1/M2/M3; подтвердить фактическое число ячеек и разрешение поверхностей. Проверить наличие всех сообщающихся объёмов до запуска.
6. **Цели и контроль.** Сохранять Qвх, Qвых, поток через нижнюю границу, массовый дисбаланс воды, средние полные давления на входе/выходе, разность полных напоров, объёмные и поверхностные цели в кольце и приёмке. Предложенный критерий: водный баланс не хуже 1 %, устойчивость целевых величин на конце расчёта, различие потерь полного напора между M2/M3 менее 5 %, изменение фракционного удержания менее 5 процентных пунктов. Эти допуски нужно пересмотреть по требуемой точности проекта; достигнутых значений пока нет. В нестационарном варианте отдельно проверить уменьшение шага времени вдвое и длительность не менее нескольких измеренных времён пребывания.
7. **Частицы.** Запустить отдельные серии для 0,15/0,30/0,60 мм с равномерным по **потоку массы** вводом на входной плоскости. Задать плотность 2650 кг/м³ и доли 20/50/30 % только как сценарий. Зафиксировать модель сопротивления, турбулентное рассеивание и отскок/захват на каждой группе стенок. Залипание разрешать лишь на обоснованных улавливающих поверхностях. Удваивать число стартовых частиц, пока фракционные доли исходов перестанут существенно меняться.
8. **Баланс песка.** Для каждой фракции записывать массу: выход через DN65, вход в приёмок, удаление через заданную нижнюю границу, осаждение на прочих стенках и незавершённые траектории. Сумма должна совпадать с введённой массой с явной численной погрешностью. Отдельно считать удержание в приёмке и реальное удаление через нижнюю границу. Вход частицы в соединение со шнеком не подтверждает её механическую выгрузку. Неизвестные исходы дают диапазон эффективности: нижняя граница = подтверждённо удалённая масса / входная масса, верхняя = (подтверждённо удалённая + масса с неизвестным исходом) / входная масса. Для общей величины суммировать массы фракций с весами 20/50/30 %.
9. **Выдача после решения.** Для каждого расхода сохранить результаты сеток, разрезы скорости и давления, траектории по фракциям, анимацию, таблицу масс и показателей, карту коротких путей и застойных зон. Остаточная концентрация песка: масса песка через DN65, делённая на фактический расход воды через DN65. Этот показатель не характеризует БПК, ХПК или все взвешенные вещества. Варианты внутренних элементов сравнивать при одинаковых граничных условиях.

## 6. Данные, необходимые для завершения

- Подтвердить актуальную ревизию полной установки и расхождение габаритов заказа и листа согласования.
- Схема подводящей и отводящей сети: отметки осей, уровни воды и подпора для четырёх расходов, вентиляция, режим пуска и остановки.
- Анализ стока: температура, вязкость, плотность, концентрация и гранулометрия минеральных частиц, формы зёрен, возможные органические включения.
- Полная 3D-сборка шнека и кожуха, положение открытой зоны приёмка, шаг/диаметр шнека, зазор, частота вращения, режим работы, расход удаляемой пульпы.
- Исправная надстройка и доступная лицензия Flow Simulation. После этого проверить её фактическую поддержку требуемого сочетания свободной поверхности, нестационарности и Particle Study.

## Источники по возможностям ПО

- [SOLIDWORKS: возможности Flow Simulation, включая граничные условия, сетку и Particle Study](https://help.solidworks.com/2020/english/SolidWorks/floxpress/r_what_do_flow_simulation.htm).
- [SOLIDWORKS: свободная поверхность и метод VOF](https://help.solidworks.com/2018/english/WhatsNew/c_free_surface.htm).
- [SOLIDWORKS API: код предупреждения 128 означает повторное открытие файла](https://help.solidworks.com/2024/english/api/swconst/SolidWorks.Interop.swconst~SolidWorks.Interop.swconst.swFileLoadWarning_e.html).
