hisp2k/parameters/grit-chambers/PT-SHT-10/deliverables/PT-SHT-10_гидравлика_тангенциальной_емкости.md

# PT-SHT-10 — гидравлика тангенциальной ёмкости

3 октября 2026 г. Предварительный расчёт рабочего режима на основе заданных расходов, размеров присоединений CAD-модели и ранее решённой задачи воды. Предлагаемый объём 210 л ещё не построен и не рассчитан в Flow Simulation.

## Расчётный режим

| Параметр | Значение |
|---|---:|
| Суточный объём стоков | 10 м³/сут |
| Максимальный средний приток в течение часа | 2,09 м³/ч |
| Максимальный секундный приток перед приёмной ёмкостью | 2 л/с |
| Подача насоса из отдельной приёмной ёмкости через песколовку | 10 м³/ч = 2,778 л/с |
| Внутренний диаметр входа по расчётной крышке | 51 мм |
| Диаметр основного выхода по расчётной крышке | 78 мм |
| Нижнее отверстие в режиме накопления осадка | Ø102 мм, закрыто; расход воды 0 |

Расход 10 м³/ч через песколовку выбран для сохранения требуемых примерно 1,36 м/с во входе. При суточном объёме 10 м³ это соответствует суммарно **1 ч работы насоса в сутки**. Реальное распределение пусков зависит от автоматики и приёмной ёмкости; 700 л для неё были назначены предварительно, до выбора насоса. Пиковые 2 л/с относятся к притоку в систему, а не к постоянному расходу через песколовку.

## Скорости и режим течения

Использованы `A = πD²/4`, `v = Q/A`, `Q = 10/3600 м³/с`. Для оценок свойств воды при 20 °C взяты `ρ = 997,574 кг/м³` из предыдущего решения Flow и `μ = 0,001002 Па·с` как расчётное допущение.

| Сечение | Площадь | Расход в рабочем цикле | Средняя скорость | Число Рейнольдса по диаметру |
|---|---:|---:|---:|---:|
| Тангенциальный вход Ø51 мм | 0,002043 м² | 10 м³/ч | **1,360 м/с** | ≈69 000 |
| Основной выход Ø78 мм | 0,004778 м² | 10 м³/ч | **0,581 м/с** | ≈45 000 |
| Нижний Ø102 мм | 0,008171 м² | 0 | **0** | — |

Скорости — средние по круглым сечениям крышек. Они не являются скоростями внутри кольцевой камеры: внутренний цилиндр и обратный конус уменьшают живое сечение и изменяют распределение потока. Числа Рейнольдса характеризуют присоединения; картину вихря определяет геометрия и расчёт поля течения.

Скоростной напор на входе `v²/(2g) = 0,0942 м`, на основном выходе `0,0172 м`; соответствующие динамические давления — около 922 и 169 Па. Это не потери напора: вычитать их и принимать разность за сопротивление аппарата нельзя.

Если подать воду **напрямую, без выравнивания и насоса**, при 2,09 м³/ч входная скорость составит 0,284 м/с, а при секундном пике 2 л/с — 0,979 м/с. Поэтому заданная скорость 1,36 м/с достигается именно при регулируемой подаче 10 м³/ч из приёмной ёмкости. Для неё нужны известные уровни включения и отключения после выбора насоса.

## Объём и номинальное пребывание

| Состояние | Объём воды, участвующий в делении `V/Q` | `V/Q` при 10 м³/ч |
|---|---:|---:|
| Существующая герметизированная CAD-полость, пустой накопитель | 162,543 л | 58,5 с |
| Та же полость при вытеснении 10 л воды осадком | не более 152,543 л | не более 54,9 с |
| Предлагаемая активная проточная зона | 200 л | **72,0 с** |

Исследовательский вариант аппарата предполагает **210 л общей пустой полости: 200 л проточной зоны и 10 л резерва под осадок**. Требуемое увеличение пустой полости относительно проверенной CAD-копии — **47,457 л**. Разделение объёма на проточную и накопительную зоны пока проектное допущение: новая геометрия должна подтвердить, что 200 л действительно работают в потоке, а нижний резерв не промывается вихрем. `V/Q` — номинальное время, не фактическое время пребывания каждой частицы и не показатель эффективности осаждения.

## Сопротивление существующей CAD-геометрии

Ранее SOLIDWORKS Flow Simulation решил **другой демонстрационный режим** для существующей полости 162,543 л: вход 10 м³/ч, основной выход 9,900045 м³/ч и непрерывный нижний отток 0,10 м³/ч. На подробной сетке 274 398 жидкостных ячеек получена потеря **полного напора с учётом разности отметок 0,184125 м вод. ст.**, что эквивалентно около **1,80 кПа энергетических потерь** при принятой плотности. Невязка расходов составила 0,000451% входа; изменение этого показателя потерь между двумя последними сетками — 1,766%.

Эти 0,184 м — **контрольное значение существующей модели с открытым нижним оттоком**, а не вычисленное сопротивление предлагаемой ёмкости 210 л. В режиме накопления нижний выход должен быть закрыт и вся вода должна выходить через основной Ø78 мм. Изменение объёма, внутренних зазоров и нижнего граничного условия может изменить потерю напора и локальные скорости. Масштабировать 0,184 м пропорционально объёму нельзя.

Для подбора насоса нужно определить полный требуемый напор как сумму разности уровней, противодавления в отводящей сети, потерь в трубопроводах и **нового** сопротивления аппарата. Уровни, подпор, трасса труб и характеристика насоса пока неизвестны; по одному значению 0,184 м насос выбирать нельзя.

## Следующая проверка на модели

1. Перестроить герметизированную CAD-копию до измеренной полости 210 л, отдельно проверить объём и форму 10-литрового накопителя. Сохранить тангенциальный вход и присоединения либо заново пересчитать скорости при изменении диаметров.
2. В Flow проверить жидкостную полость и контакт с внутренними гранями входной, основной выходной и нижней крышек. Уточнить фактическое заполнение, вентиляцию и подпор; при полностью затопленной постановке нижний выход закрыть, задать 10 м³/ч на входе и реальное давление на основном выходе.
3. Получить водяной баланс, потерю полного напора и поля скоростей в кольце, у обратного конуса и у нижнего накопителя. Проверить сходимость по сетке и отсутствие устойчивого промывания зоны осадка.
4. После водяного расчёта оценить траектории частиц по размерам и массовый баланс. Цель 60% для частиц `d ≤ 0,25 мм` данным гидравлическим расчётом **не подтверждается**.

Основание: [предыдущий расчёт воды](PT-SHT-10_повторный_расчёт_воды.md), [объём и накопление осадка](PT-SHT-10_объём_песколовки_и_осадок.md), [привязка расчёта к CAD-модели](PT-SHT-10_привязка_расчёта_к_модели.md).
