hisp2k/parameters/grit-chambers/PT-SHT-10/deliverables/PT-SHT-10_демонстрационный_сценарий_Flow.md

> **Обновлено после повторного запуска 30.09.2026:** вода решена на трёх сетках, финальные потери напора 0,1841 м. Particle Study не выполнен. Ниже сохранён предыдущий протокол/план; прежние сообщения об отсутствии сетки и решения устарели. Актуальные результаты и ограничения: [повторный расчёт воды](PT-SHT-10_повторный_расчёт_воды.md).

# PT-SHT-10 — демонстрационная постановка гидравлики и осаждения песка

**Статус на 30.09.2026:** в отдельной копии исправлены открытые продольные швы, зазоры врезок патрубков, контакт нижнего отвода с конусом и отверстия креплений верхней крышки. Геометрическое ядро SOLIDWORKS выделило одну замкнутую внутреннюю полость **0,1625431054 м³**. Подтверждено её соприкосновение со всеми тремя активными крышками; ошибки тел и булевых операций отсутствуют.

**Штатная проверка Check Geometry в Flow пока не завершена из-за ошибки управления интерфейсом. Сетка, решение воды и Particle Study не получены.** Подробности, исправления и точный следующий шаг приведены в [протоколе исправления геометрии](PT-SHT-10_исправление_геометрии.md). Число 60% остаётся целевым показателем.

Активный проект: `PT-SHT-10-demo-Q10-sealed`. Однофазная вода 20 °C, гравитация (0; −9,81; 0) м/с². Исходная модель заказа на рабочем столе не изменялась. В архиве находятся обновлённая демонстрационная сборка, её зависимости и файлы постановки, без результатов решателя.

## Цель и показатель

Для реальной геометрии бункера проверить расходы 2, 5, 10 и 15 м³/ч. При 10 м³/ч целевой показатель — не менее **60% массы поступающего песка с диаметром d ≤ 0,25 мм** должно пересечь нижнюю выходную границу. Расчётный показатель:

`η≤0,25 = Σ m(частицы d≤0,25, пересекшие нижний выход) / Σ m(введённые частицы d≤0,25) × 100%`.

Процент от объёма загрязнённых стоков для эффективности осаждения физически некорректен: вода и песок имеют разные потоки. Пересечение нижней границы означает выведение из расчётной области; оно не подтверждает работу шнека, поскольку шнек отсутствует в модели.

## Пробные условия для параметризации после проверки геометрии

| Параметр | Значение | Происхождение |
|---|---|---|
| Геометрия | Отдельная копия фактической сборки с внутренним цилиндром, обратным конусом и внутренней выходной трубой | Из CAD |
| Заполнение | Полностью затопленная камера, без свободной поверхности | Демонстрационное допущение |
| Вода | 20 °C | Демонстрационное допущение |
| Гравитация | (0; −9,81; 0) м/с² | Ориентация CAD |
| Вход Ø51 мм | 10 м³/ч; дополнительно 2, 5 и 15 м³/ч | 10 м³/ч по заказу; остальные проверочные |
| Основной выход Ø70 мм | 0 Па избыточного статического давления | Условная опора, реальный подпор неизвестен |
| Нижний выход Ø102 мм | Отток пульпы 0,10 м³/ч при входе 10 м³/ч; отдельно 0,05 и 0,20 м³/ч | Демонстрационное допущение, не характеристика шнека |
| Стенки | Непроницаемые, неподвижные | Демонстрационное допущение |
| Концентрация песка | 100 мг/л; при 10 м³/ч это 1,0 кг/ч на входе | Демонстрационное допущение |
| Плотность песка | 2650 кг/м³ | Демонстрационное допущение |
| Диаметры частиц | 0,10; 0,15; 0,20; 0,25; 0,30; 0,60 мм | Проверочные фракции; действительный состав неизвестен |

Неизвестные массовые доли фракций не заменять вымышленным анализом стока. Сначала выдавать эффективность по каждой фракции. Для одного суммарного показателя нужны реальные доли. Отдельный иллюстративный вариант допускает доли 10/15/15/20/20/20% соответственно, но вывод о фактической установке по нему делать нельзя. Тогда входная масса фракций d≤0,25 составляет 0,60 кг/ч, а порог 60% равен **0,36 кг/ч через нижний выход**. Это целевой порог, а не полученный результат.

## Что необходимо выполнить в Flow Simulation

1. Проверить добавленные виртуальные крышки и кольца в демонстрационной копии, устранить обнаруженную ошибку границы жидкостной области. Затем выбрать внутренние поверхности отверстий и подтвердить связность всех трёх сечений со внутренней проточной областью.
2. Назначить входной расход, выходное давление и нижний расход на соответствующих трёх границах. При 10 м³/ч ожидаемый водный баланс: вход 10,0, основной выход около 9,9, нижний выход 0,1 м³/ч. Для остальных расходов сохранять один явно описанный закон нижнего отвода, например 1% входного расхода.
3. Проверить герметичность, общую связность жидкостной области и направление нормалей. Построить минимум три сетки с локальным сгущением у входа, внутреннего цилиндра, обратного конуса, узких зазоров и двух выходов.
4. Решить воду. Критерии принятия: дисбаланс воды <1%, установившиеся цели, изменение потери полного напора между двумя наиболее подробными сетками <5%. Зафиксировать фактически достигнутые значения.
5. По рассчитанному полю воды запустить Particle Study для каждого диаметра. Распределить начальные позиции по массовому потоку; проверить число траекторий, модель сопротивления, турбулентное рассеивание и взаимодействие со стенками. Не назначать автоматическое прилипание ко всем стенкам.
6. Для каждой фракции отчитаться отдельно: нижний выход, основной выход, удержание в песковом приёмке, осаждение на прочих стенках, незавершённые траектории. Проверить массовый баланс. Незавершённые траектории не прибавлять к уловленным. Сравнить η≤0,25 с 60% только после расчёта.

## Ограничения демонстрационного сценария

Уровень и подпор отводящей сети, вентиляция, фактическое заполнение, характеристики песка и режим шнека неизвестны. Выбранные 0 Па и 0,10 м³/ч имеют статус пробных граничных условий. Если геометрия открыта к воздуху или работает со свободной поверхностью, эта однофазная постановка не описывает реальную работу. Даже при выполнении целевого показателя в пробной модели потребуется уточнение граничных условий и проверка полного узла выгрузки.
