hisp2k/parameters/grit-chambers/PT-SHT-10/deliverables/PT-SHT-10_исправление_геометрии.md

> **Обновлено после повторного запуска 30.09.2026:** вода решена на трёх сетках, финальные потери напора 0,1841 м. Particle Study не выполнен. Ниже сохранён предыдущий протокол/план; прежние сообщения об отсутствии сетки и решения устарели. Актуальные результаты и ограничения: [повторный расчёт воды](PT-SHT-10_повторный_расчёт_воды.md).

# PT-SHT-10 — исправление геометрии, 30.09.2026

## Фактический результат

В демонстрационной копии создана замкнутая проточная полость объёмом **0,1625431054 м³ (162,543 л)**. Результат получен булевым вычитанием действительных тел сборки средствами геометрического ядра SOLIDWORKS. Все 21 активное тело и выделенная полость прошли проверку `IBody2.Check3`: 0 ошибок. Булево вычитание после исправления завершилось без ошибок.

Это независимая геометрическая проверка. Штатная проверка **Flow Simulation → Check Geometry → Check** пока не завершена. **Сетка, решение воды и Particle Study не получены; эффективность 60% не подтверждена.**

## Обнаруженные дефекты и исправления

| Узел | Подтверждённая проблема | Исправление в демонстрационной копии |
|---|---|---|
| Наружный цилиндр | Открытый продольный шов около 0,5 мм | Добавлен узкий замыкающий объём сварного шва |
| Нижний конус | Открытый продольный шов от 0,5 до примерно 2,8 мм | Замкнут шов по конической поверхности |
| Нижний отвод и конус | Булева операция возвращала 547, non-manifold; торец отвода соприкасается с наружной кромкой конуса | Верх отвода продлён с Y=0,033 до 0,036 м, с сохранением внутреннего диаметра 102 мм; создано объёмное перекрытие |
| Врезки входа и основного выхода | После закрытия продольных швов сечения на высоте патрубков оставались связаны с внешним объёмом; отверстия оболочки больше наружных поверхностей труб | Локальные участки оболочки замкнуты до наружной поверхности каждой трубы, внутренние диаметры труб сохранены |
| Верхняя крышка | Четыре сквозных отверстия Ø6,8 мм внутри уплотняемого контура | Принято демонстрационное допущение герметичного крепления ручек; отверстия закрыты |
| Внешний крепёж и опоры | Множество касательных контактов деталей, не образующих проточный тракт | Детали подавлены в расчётной копии |

Для замены четырёх исходных деталей добавлены `CFD_cylinder_welded`, `CFD_cone_welded`, `CFD_bottom_pipe_extended`, `CFD_top_cover_sealed`. Они зафиксированы в исходной системе координат сборки. Исходные четыре компонента подавлены только в копии. Внутренний цилиндр, обратный конус и погружённая выходная труба сохранены.

Ранее добавленные три активные расчётные крышки и уплотнения фланцев сохранены. Эти изменения описывают условно герметично сваренное и собранное изделие. Это не подтверждение фактического качества сварки, герметичности креплений или технологии изготовления.

## Проверка трёх граничных сечений

У выделенной связной полости найдены плоские грани, совпадающие с внутренними поверхностями трёх крышек. Расстояние от контрольной точки до соответствующей грани во всех случаях равно 0 м.

| Сечение | Центр в координатах сборки, м | Площадь контакта жидкости, м² | Эквивалентный диаметр |
|---|---|---|---|
| Вход | (0,2515; 0,7195; 0,329) | 0,002042820623 | 51 мм |
| Основной выход | (0; 0,458; 0,353) | 0,004778362426 | 78 мм |
| Нижний выход | (0; 0,004; 0) | 0,008171282492 | 102 мм |

Основная выходная крышка находится в расточке фланца Ø78 мм; примыкающая труба имеет внутренний диаметр 70 мм. Это разные сечения. Полный машинный протокол: `PT-SHT-10_проверка_полости.json`.

## Что блокирует решение

Открыта страница «Проверка геометрии». SOLIDWORKS показал запрос: «Геометрия модели или настройки проекта были изменены. Вы хотите сбросить размеры расчетной области к автоматическим?». Автоматическое нажатие кнопок не выполняется: интерфейс управления возвращает `coordinate input geometry is unavailable` или недоступный индекс элемента. Отдельная ошибка снимка окна — `SetIsBorderRequired`, код 0x80004002.

В соответствии с заданной пользователем последовательностью граничные условия и решатель после исправления ещё не запускались. Открытие команды через COM и её возврат `None` не засчитаны как проверка. Отсутствие ошибок ядра не заменяет отчёт Flow об Invalid Contacts.

## Продолжение

1. В запросе сброса области выбрать «Нет». На странице «Проверка геометрии» снять «Исключить полости без условий», если флажок установлен, поскольку граничные условия ещё не назначены.
2. Нажать «Проверить», записать Fluid Volume, Solid Volume и Invalid Contacts. Нажать «Показать проточную область». Сопоставить её с независимым объёмом 0,1625431054 м³. Если объём нулевой, разобрать именно сообщение Flow.
3. После положительной проверки прочитать расчётную область обратно и проверить, что она охватывает все крышки: плановые границы X [−0,38; 0,38], Y [−0,02; 0,90], Z [−0,38; 0,40] м.
4. В демонстрационном проекте `PT-SHT-10-demo-Q10-sealed` назначить 10 м³/ч на входе, 0 Па избыточного давления на основном выходе, отток 0,10 м³/ч на нижнем выходе. Проверить тип давления: при абсолютном вводе использовать согласованную опору, а не 0 Па абсолютного давления.
5. Получить решение воды, проверить фактический баланс расходов и сеточную сходимость. Только затем рассчитывать частицы 0,10; 0,15; 0,20; 0,25; 0,30; 0,60 мм.
6. Процент удаления определять по массе песка, пересёкшего нижнюю границу, относительно введённой массы соответствующей фракции. Целевые 60% для d≤0,25 мм не подставлять в результат. Без гранулометрического состава суммарный процент неизвестен.

Методический порядок проверки подтверждён руководствами [SOLIDWORKS Fundamentals 2023](https://files.solidworks.com/education/curriculum/subscription-curriculum/Fundamentals3DDesign_SIM_ENG_LV_2023_final.pdf) и [Flow Simulation Instructor Workbook](https://www.solidworks.com/sw/docs/flow_sim_instructorwb_2011_eng.pdf).
