hisp2k/parameters/grit-chambers/PT-SHT-10/deliverables/PT-SHT-10_повторный_расчёт_воды.md

# PT-SHT-10 — повторный расчёт воды

30 сентября 2026 г. SOLIDWORKS Flow Simulation 2026.

## Полученный результат

**Три расчёта воды завершены решателем. Последний: 315 итераций, 274 398 жидкостных ячеек, потери полного напора вход → основной выход 0,1841 м.** Последний журнал содержит `Execution succeeded`. В файле предупреждений на последней итерации сообщений нет. Файл решения `2.fld` загружен обратно в Flow; поля ниже получены из этого файла через штатный интерполятор постпроцессора.

**Эффективность удаления песка пока не рассчитана. Требование 60% для d ≤ 0,25 мм не подтверждено.**

## Постановка и исправления

Расчёт выполнен в отдельной копии сборки, проект `PT-SHT-10-demo-Q10-sealed`, конфигурация `По умолчанию`, каталог проекта `Модель/2`. Исходная сборка заказа на рабочем столе не изменялась.

Ранее в копии заделаны продольные разрывы корпуса и конуса, зазоры врезок, исправлено соединение нижнего отвода и закрыты четыре отверстия крепления верхней крышки. Геометрическое ядро выделило одну полость **0,1625431054 м³** и подтвердило контакт со всеми тремя внутренними гранями крышек; проверка 21 смоченного тела и извлечённой полости не показала ошибок. Эти изменения — допущения демонстрационной модели, их соответствие изготовленной конструкции требует проверки.

В этом запуске устранена отдельная ошибка привязки граничных условий: ручные UUID-ссылки заменены ссылками, полученными после выбора реальной грани через `UpdateFeatureTopolReferenciesFromSelection` и сохранения шаблона Flow. После этого препроцессор принял условия, построил сетки и запустил решатель.

**Оговорка по Check Geometry:** кнопка Check и визуализация Fluid Volume в интерфейсе не были подтверждены из-за неисправности управления окнами. Выполнены проверка геометрическим ядром, проверка контактов крышек и построение жидкостной сетки Flow. Поэтому запрошенный протокол штатной проверки интерфейсом остаётся незакрытым; численный результат не заменяет этот протокол. Возврат `None` нигде не используется как доказательство проверки.

| Параметр | Принято |
|---|---|
| Заполнение | Полностью затопленный бункер, однофазная вода, без свободной поверхности |
| Температура | 293,15 К ≈ 20 °C |
| Гравитация | (0; −9,81; 0) м/с² |
| Течение | Ламинарное и турбулентное |
| Вход | 10 м³/ч, внутренняя грань крышки Ø51 мм |
| Основной выход | Около 0 Па избыточного статического давления на отметке y=0,458 м |
| Нижний выход | Заданный отток 0,10 м³/ч, Ø102 мм |
| Сетка | Три последовательных уровня глобального разрешения: 2, 3, 4 |

Давление в Flow задаётся с гидростатической опорой. Для сеток 2 и 3 параметр опорного абсолютного давления равен **105806,7805 Па**, чтобы на основном выходе получить около 101325 Па абсолютного. Получено 101324,8609 Па, то есть −0,1391 Па относительно 101325 Па. На первой сетке опора была 101325 Па; затем изменена только опора давления. Для данной жидкостной постановки это учитывается при сравнении потерь напора.

## Баланс воды на подробной сетке

| Поток | Значение, м³/ч |
|---|---:|
| Вход | 10,000000 |
| Основной выход | 9,900045 |
| Нижний выход | 0,100000 |
| Абсолютная невязка | 0,0000451 |

Относительная невязка: **0,0004511%** входного расхода. Отток через нижнее отверстие составляет 1% воды и задан граничным условием; он не является результатом расчёта осаждения песка или подтверждением производительности шнека.

## Сетки и сходимость

| Сетка | Жидкостные ячейки | Итерации | Потери напора, м | Невязка расходов, % |
|---|---:|---:|---:|---:|
| 1 | 51,323 | 211 | 0.190598 | 0.00075499 |
| 2 | 109,088 | 268 | 0.180873 | 0.00003362 |
| 3 | 274,398 | 315 | 0.184125 | 0.00045113 |

Изменение потерь между второй и третьей сетками: **1.766%** относительно третьей. Условие демонстрационного сравнения <5% выполнено для этого интегрального показателя. Сходимость немонотонна; оценка GCI и независимость локальных скоростей/траекторий частиц от сетки не установлены.

Активные цели остановки — максимальная скорость и полное давление на входе — достигли заданных критериев. На подробной сетке диапазон изменения давления на входе 21,990 Па при критерии 22,083 Па; максимальной скорости — 0,00672 м/с при критерии 0,03231 м/с. Это выполнение численных критериев, а не «100% точности».

Цели давления на основном и нижнем выходах сохранялись для наблюдения, но не участвовали в остановке; некоторые их собственные критерии не выполнены. Для окончательного инженерного подтверждения и чувствительных расчётов частиц рекомендуется включить в остановку потерю полного напора и давление нижнего выхода и проверить более строгую сходимость. Максимальная скорость текущего решения — **1,5792 м/с**.

Полные давления, усреднённые по массовому потоку: вход 100798,2284 Па, основной выход 101555,4314 Па. Учитывалась разность отметок 0,7195−0,458=0,2615 м:

`ΔH = (Pt_in − Pt_out)/(ρg) + y_in − y_out = 0,184125 м`,

где плотность из решения ρ=997,574425 кг/м³. Разность только давлений без высотной поправки не является потерей напора этого узла.

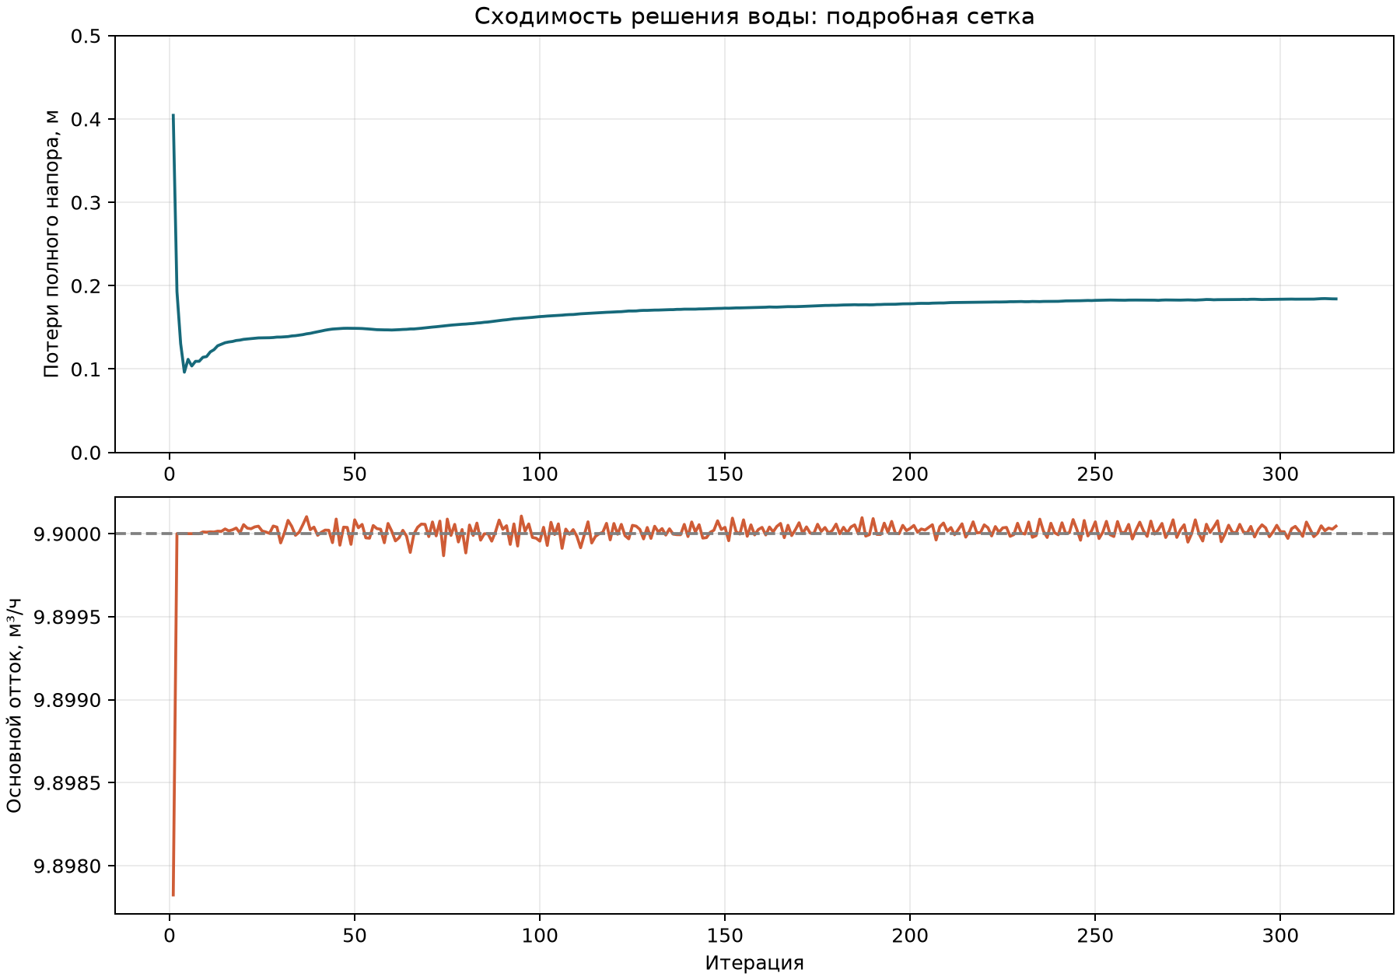
[picture p6: grit-chambers/PT-SHT-10/deliverables/PT-SHT-10_сходимость.png]
Сходимость


## Поля течения

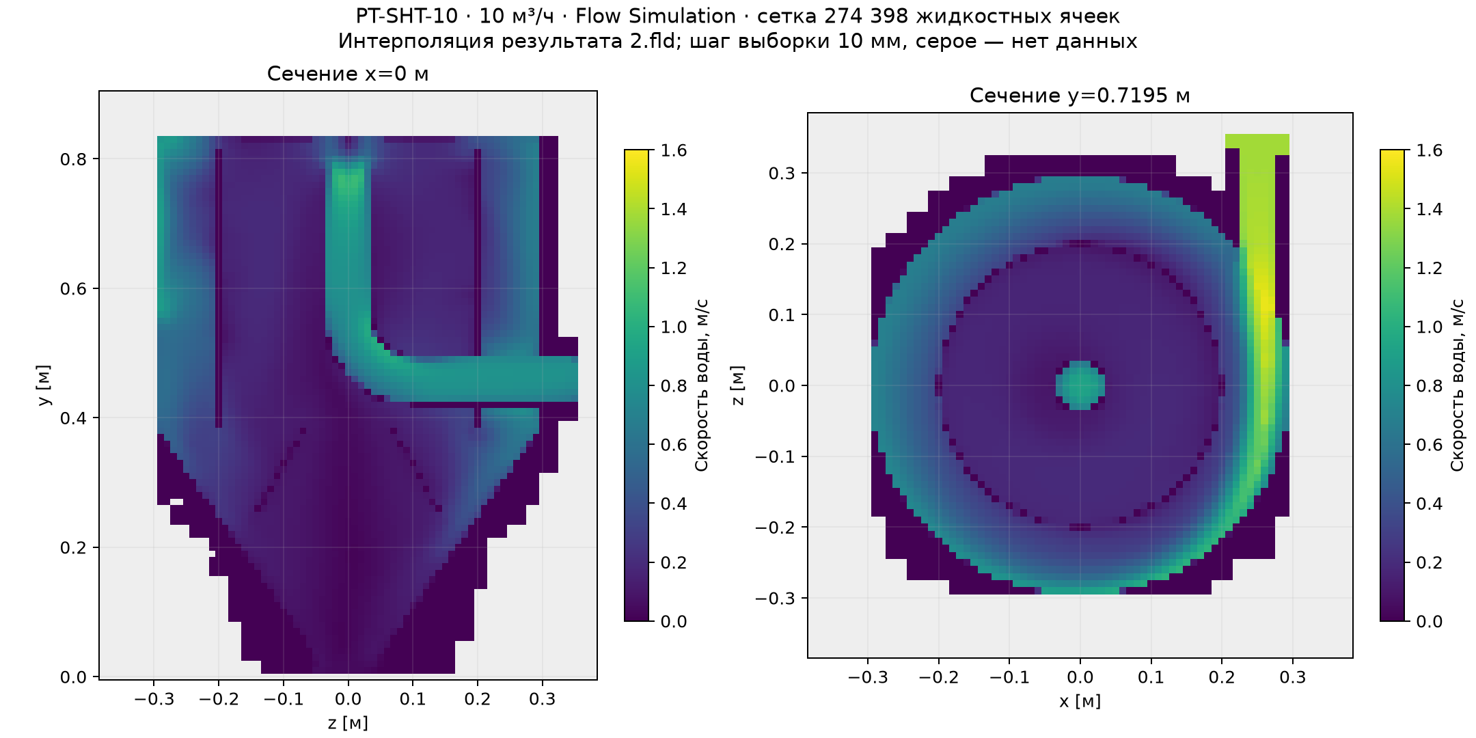
[picture p7: grit-chambers/PT-SHT-10/deliverables/PT-SHT-10_скорость_воды.png]
Скорость воды


Сечения x=0 и y=0,7195 м, выборка с шагом 10 мм: 12 936 запросов, 8 053 успешные интерполяции. CSV содержит скорость, три её компоненты и абсолютное давление. Серые участки означают отсутствие результата интерполяции; они не являются самостоятельной классификацией твёрдых тел. Нулевая/малая интерполированная скорость у стенок не доказывает наличие жидкой полости. Изображение не заменяет штатную Fluid Volume. Шаг изображения отличается от размера расчётных ячеек.

Внешнее кольцо и основной отвод имеют заметные скорости, в нижней части они существенно меньше. По такому изображению нельзя определить процент удаления песка: для этого нужны траектории, взаимодействие со стенками и массовый баланс частиц.

## Что блокирует песок

При создании Particle Study API выдаёт объект инжекции, но после `AddInjection` и повторного `AddUpdateFeature` список `GetInjections(True)` остаётся пустым. Доступные интерфейсы инжекции не предоставили точки запуска. Пустое исследование удалено из передаваемой модели. Попытка дополнительного XML-экспорта дала ошибку загрузки `xtxmla_converter.dll`, Error 126; это не помешало решателю воды, но не позволило использовать экспорт для диагностики источника.

Для завершения: восстановить доступ к интерфейсу Particle Study/компоненту экспорта, создать источник на внутренней входной грани, проверить сохранение его точек и весов и только затем запускать частицы. Начальный демонстрационный состав: плотность 2650 кг/м³, диаметры 0,10; 0,15; 0,20; 0,25; 0,30; 0,60 мм. Реальные массовые доли неизвестны. Для каждого размера отдельно учитывать нижний выход, основной выход, осаждение на стенках и незавершённые траектории, проверить баланс и чувствительность к числу траекторий.

Целевой показатель: `η≤0,25 = масса песка d≤0,25 через нижний выход / введённая масса песка d≤0,25 × 100%`. Для суммарного результата нужны массовые доли фракций. Ни одна эффективность пескоудаления в этом отчёте не рассчитана.

## Файлы и воспроизведение

- `PT-SHT-10_демо_проект_Flow.zip`: демонстрационная сборка с зависимостями, проект `Модель/2`, финальные `2.fld`, `2.cpt`, геометрия, сетка, журналы и история целей. Каталог `verification` содержит сводки трёх сеток и диагностические материалы.
- `PT-SHT-10_результаты_воды.json`: значения целей и сравнительная сводка.
- `PT-SHT-10_поля_воды.csv`: выборка полей окончательного решения.
- PNG: поле скорости и сходимость, построенные из фактических данных Flow.

Распаковать архив целиком, открыть сборку из каталога `Модель`, выбрать проект `PT-SHT-10-demo-Q10-sealed` и загрузить результаты из `Модель/2/2.fld`. Другой, ранний проект не использовать для этих результатов.

Фактические уровень/подпор, вентиляция, заполнение и режим удаления осадка неизвестны. Результат относится к принятому демонстрационному режиму 10 м³/ч. Расходы 2, 5 и 15 м³/ч в этом повторном запуске не решались. Полное подтверждение конструкции и требуемой эффективности остаётся незавершённым.
