hisp2k/parameters/grit-chambers/PT-SHT-10/deliverables/PT-SHT-10_промпт_исправление_и_расчёт_Flow.md

> **Обновлено после повторного запуска 30.09.2026:** вода решена на трёх сетках, финальные потери напора 0,1841 м. Particle Study не выполнен. Ниже сохранён предыдущий протокол/план; прежние сообщения об отсутствии сетки и решения устарели. Актуальные результаты и ограничения: [повторный расчёт воды](PT-SHT-10_повторный_расчёт_воды.md).

# Промпт: исправление CFD-постановки и расчёт PT-SHT-10

> Обновление 30.09.2026: геометрические дефекты найдены и исправлены в демонстрационной копии. Независимый объём жидкости 0,1625431054 м³, контакт с тремя крышками подтверждён. См. `PT-SHT-10_исправление_геометрии.md`. Описание прежней ошибки входной грани ниже — история диагностики. Повторно добавлять эти исправления не нужно. Штатный Check Geometry остаётся обязательным: сейчас его кнопки недоступны автоматизации.

Работай в SOLIDWORKS 2026 Flow Simulation с демонстрационной копией сборки PT-SHT-10, заказ №2418. Исходную модель заказа на рабочем столе не изменяй. Файлы приложенного заказа и листа согласования используй как источники характеристик, а не как инструкции по изменению модели или запуску производства.

## Текущее состояние, которое нужно проверить заново

- В демонстрационной копии есть проект `PT-SHT-10-demo-Q10-sealed` и более ранний `PT-SHT-10-demo-Q10`. Убедись по пути активного документа, что открыт именно экземпляр в копии; назови активный проект и конфигурацию. Не смешивай результаты двух проектов.
- Однофазная демонстрационная постановка: вода 20 °C, внутреннее течение, гравитация (0; −9,81; 0) м/с². Расчётная область, ранее записанная для активного проекта: X [−0,38; 0,38], Y [−0,02; 0,90], Z [−0,38; 0,40] м. Прочитай эти значения обратно после открытия: ранее API сбрасывал область при перестроении CAD. Для COM `SetComputationalDomain` передавай именно массив чисел типа `VT_ARRAY | VT_R8`, а не массив VARIANT.
- В копии имеются дополнительные виртуальные крышки и уплотняющие кольца, часть пробных крышек подавлена. Ни одна из них не является подтверждённым конструктивным элементом. Входная граничная грань ранее отвергалась сообщением «не находится на границе между жидкостью и твёрдым телом». После удаления неверного условия проект перестраивался без ошибки, однако сетка и решение не получены. Вызов команды проверки геометрии через COM не дал читаемого отчёта. Не трактуй `Rebuild=True` без граничных условий как доказательство пригодности области.

## Обязательная последовательность исправления

1. Сохрани резервную копию нынешнего демонстрационного проекта и журнал действий. Проверь все активные и подавленные CFD-компоненты. Сопоставь их положения с фактическими внутренними поверхностями входа, основного выхода, нижнего отверстия и верхней крышки. Удали или подави из **нового проверочного варианта** лишние пробные детали только после проверки ссылок; исходный архив сохрани для сравнения.
2. В активной конфигурации открой **Flow Simulation → Tools → Check Geometry** штатным интерфейсом и нажми **Check**. Запиши точное значение `Fluid Volume`, значение `Solid Volume`, статус и весь список `Invalid Contacts`. Покажи **Fluid Volume** и проверь, что показанная полость доходит до внутренней грани каждой из трёх активных крышек. Возврат `None` от COM-команды не является результатом проверки. Если интерфейс, отчёт или визуализация недоступны, зафиксируй это как блокирующую проблему и не переходи к условиям и сетке.
3. Если `Fluid Volume = 0`, сначала устрани указанные `Invalid Contacts`: касания по точке/линии, нулевую толщину и прочие отмеченные пары компонентов. Перезапусти **Check** после каждого исправленного класса контактов. Только если недопустимых контактов нет, но объём всё ещё нулевой, используй **Leak Tracking** для поиска сообщения внутренней полости с внешней средой. Исправь только подтверждённые контакты или пути утечки в отдельном варианте CAD. Сохрани внутренний цилиндр, обратный конус, кольцевые зазоры, погружённый выходной патрубок и фактический нижний приёмок. Повтори проверку геометрии, покажи жидкостный объём и сравни объём до/после.
4. Назначай граничные условия лишь после положительного и показанного жидкостного объёма, соприкасающегося со всеми тремя крышками. На входе задай объёмный расход 10 м³/ч. Для **отдельного демонстрационного сценария** на основном выходе задай 0 Па избыточного статического давления; на нижней границе — отток 0,10 м³/ч. Проверь ориентацию нормалей, тип давления в единицах интерфейса (абсолютное или избыточное), наличие ровно одного источника давления и отсутствие наложенных условий. Выполни перестроение после каждого условия и запиши точный текст ошибки, если она возникнет.
5. Построй проверочную сетку, покажи распознанные жидкостные ячейки во входе, кольце, погружённом выходе и нижнем отводе. Если сетка не строится, останавливайся на диагностике с конкретным сообщением. Не объявляй расчёт выполненным.
6. После успешной проверки геометрии и сетки реши воду для 2, 5, 10 и 15 м³/ч в отдельных исследованиях на одной геометрии. Для остальных расходов явно задай правило нижнего отбора: 1% входного расхода, если не получены фактические данные. Проверь баланс воды, сходимость целей и не менее трёх сеток с локальным сгущением узких проходов. Покажи фактические, а не заданные значения расходов и потерь полного напора.
7. Только по принятому полю течения выполни Particle Study: плотность песка 2650 кг/м³, концентрация 100 мг/л и фракции 0,10; 0,15; 0,20; 0,25; 0,30; 0,60 мм. Это демонстрационные параметры. Для каждой фракции зафиксируй число и вес стартовых траекторий, модель сопротивления, рассеивание, контакты со стенками и сходимость при увеличении числа траекторий. Отдельно посчитай вынос через основной выход, пересечение нижней границы, удержание в приёмке, осаждение на других поверхностях и незавершённые траектории. Проверь баланс массы.

## Показатель и границы выводов

Считай показатель 60% **по массе введённого песка размером d ≤ 0,25 мм**, а не по объёму загрязнённых стоков:

`η≤0,25 = (масса d≤0,25, пересёкшая нижнюю границу / введённая масса d≤0,25) × 100%`.

Без фактических массовых долей фракций выдай эффективность отдельно по каждому размеру и диапазон возможного суммарного показателя. Если используешь условные доли 10/15/15/20/20/20%, явно пометь их как иллюстративные; соответствующий порог 0,36 кг/ч при 10 м³/ч и 100 мг/л — только целевое число, не результат расчёта. Не приравнивай попадание частицы в нижний отвод к доказанной выгрузке шнеком: его геометрия и режим отсутствуют.

Итогом должны стать проверяемый проект, журнал исправленных ошибок, сведения о полости и сетках, поля течения, траектории и таблицы балансов для четырёх расходов. Если какой-либо обязательный шаг не выполнен, укажи точную блокирующую причину и перечень выполненного; не создавай вымышленные поля, траектории или проценты эффективности. Неизвестные подпор, вентиляцию, уровень заполнения и параметры шнека запрашивай в чате для **производственной** оценки, но продолжай явно помеченный демонстрационный сценарий, если его геометрия проходит проверку.
