hisp2k/parameters/grit-chambers/PT-SHT-10/deliverables/PT-SHT-10_протокол_подтверждения_60процентов.md

# PT-SHT-10 — протокол подтверждения 60% улавливания песка

3 октября 2026 г. Этот документ задаёт проверку **массовой доли песка**, а не доли объёма воды. Для данной установки 60% пока является целью; существующий CFD-расчёт частиц зависит от сетки и не подтверждает её.

## 1. Зафиксировать, что означает «до 0,25 мм»

До испытаний выбрать и записать один основной критерий:

- **Вариант A — класс около 0,25 мм**, например 0,20–0,25 мм: `ηA = Mудержано,A / Mвход,A`.
- **Вариант B — вся измеряемая фракция ≤0,25 мм**: `ηB = ΣMудержано,i / ΣMвход,i` для всех классов от заданного лабораторного нижнего предела до 0,25 мм. Нужны реальные массовые доли классов; высокий результат для 0,25 мм не доказывает результат для 0,05 или 0,10 мм.
- Если требование относится к **каждому** классу ≤0,25 мм, проверять `ηi ≥60%` отдельно для каждого класса. Это существенно более строгое условие.

Критерий записывать как «не менее 60% **массы минерального песка выбранной фракции**», а не «60% объёма загрязнённых стоков».

## 2. Проверить расчётную модель до вывода об эффективности

1. Подтвердить связанную жидкостную полость в Flow Simulation (`Check Geometry`, её объём, `Fluid Volume`, отсутствие паразитных контактов и утечек). Сверить модель с фактическим уровнем воды, внутренними деталями, нижним выпуском и отводящей сетью. Доступная сборка — узел бункера, не полная установка со шнеком.
2. Решить воду при **10 м³/ч через Ø51 мм** на минимум трёх последовательно сгущаемых сетках. Основной отвод задать по измеренному давлению/уровню; нижний выпуск закрыть в режиме накопления, а выгрузку считать отдельным режимом. Предлагаемый технический критерий: дисбаланс расходов ≤1%, изменение потери напора и характерных скоростей между двумя последними сетками ≤5%.
3. Для 0,05/0,10/0,15/0,20/0,25/0,30 мм ввести частицы по площади и расходу входного сечения с фактической плотностью, формой и распределением. Учесть гравитацию, сопротивление, турбулентное рассеивание, отражение/отскок и возможный повторный унос. Не объявлять прилипание к любой стенке «уловленным песком».
4. Раздельно учитывать массы: `Mвход = Mосновной выход + Mнакопитель + Mфактическая выгрузка + Mпрочие поверхности + Mнезавершённые/неучтённые`. Для доказательства **удаления** считать только фактически выгруженную массу и устойчивый остаток в накопителе после испытания пуском/остановом. Попадание частицы в отверстие Ø102 само по себе не доказывает удаление шнеком.
5. Удваивать число траекторий и сгущать сетку до устойчивости результата. Предлагаемый критерий: между двумя последними сетками и двумя последними наборами траекторий изменение `η` не более **5 процентных пунктов** для целевой фракции, неизвестная масса не более 5% и полное замыкание песчаного баланса не хуже 95%. Это заранее выбранные критерии приёмки расчёта, не опубликованные паспортные допуски изделия.
6. Повторить проверку при пустом накопителе и заполнении **5 и 10 л**, после пуска и перед остановом. Подача в песколовку во время работы — 10 м³/ч; изменчивый приток 2,09 м³/ч в пиковый час и секундный максимум 2 л/с относятся к **приёмной ёмкости** до насоса. Проверить, что она поддерживает заданный режим песколовки без перелива и подсоса воздуха.

Ранее показанный диапазон 77,20–99,22% прохода через нижнюю границу при смене шага выборки результатов **не проходит** критерий сходимости и не является доказанной `η`.

## 3. Провести натурные или пилотные испытания

1. Установить измерение расхода до и после аппарата, исключить обходные потоки. На входе и основном выходе отбирать синхронизированные **пропорциональные объёму** пробы на протяжении полного цикла наполнения, работы, остановки и выгрузки. Время доставки воды от входа до выхода учитывать задержкой проб или испытывать на достаточно длинном интегральном интервале.
2. Определить в пробах **массу минерального песка по ситовым/размерным классам**, отдельно от органики и общей взвеси. Схема отбора должна учитывать распределение песка по глубине и сечению потока: точечная проба из верхней части трубы может не представить тяжёлые частицы. Рекомендации по представительной пробе и размерному анализу изложены в [факте WEF о grit removal](https://www.wef.org/globalassets/assets-wef/direct-download-library/public/03---resources/wsec-2017-fs-021-mrrdc-lsf-grit-removal_final.pdf). При малой естественной нагрузке допускается контролируемое внесение **заранее взвешенного кварцевого песка заданной фракции**; подобные испытания 0,25 мм описаны в [исследовании EPA](https://nepis.epa.gov/Exe/ZyPURL.cgi?Dockey=20006DMD.TXT).
3. Взвесить сухую минеральную массу из шнека/нижней выгрузки и измерить изменение массы в накопителе. Проверить песок на прочих поверхностях, а также возврат промывной воды. Повторить испытания при накопителе пустом и у отметок 5/10 л; включить пуски и остановы. Записывать частоту и длительность выгрузки. [Руководство EPA для инспекции](https://nepis.epa.gov/Exe/ZyPURL.cgi?Dockey=00000J8X.TXT) предусматривает учёт расхода, количества собранного песка, влажности и содержания органики.
4. Для каждого прогона и размерного класса считать `Mвход = ∫Qвход Cпесок,вход dt`, `Mвыход = ∫Qвыход Cпесок,выход dt`; `ηудаления = (Mвыгружено + ΔMустойчиво_в_накопителе)/Mвход`. Параллельно проверять `ηпо_выходу = 1 − Mвыход/Mвход`; расхождение с первым показателем должно объясняться измеренным изменением запаса песка в аппарате и на стенках. При известном начальном и конечном пустом накопителе формула упрощается до `ηудаления = Mвыгружено/Mвход`.
5. Выполнить повторные независимые прогоны при рабочем расходе. **Принимать требование только если нижняя односторонняя 95% доверительная граница для заранее выбранного показателя не ниже 60%**, а водный и песчаный балансы замкнуты в заранее установленной погрешности. Число повторов назначить по пилотной вариации результатов, а не произвольно по числу траекторий CFD.

## 4. Пример баланса для проверки протокола

Для предварительного сценария **мойки грязных автомобилей** принята, но не измерена, концентрация всего минерального песка **1,0 г/л**. При 10 м³ обработанной воды за сутки это **10 кг/сут всего песка на входе**. Если доля выбранной фракции ≤0,25 мм по лабораторному анализу окажется `f`, то её входная масса равна `10f кг/сут`, а для 60% её удаления потребуется подтвердить не менее `6f кг/сут` удержанной/выгруженной сухой минеральной массы этой фракции и около `4f кг/сут` на выходе с поправкой на накопление. До измерения `f` нельзя писать «6 кг/сут фракции ≤0,25 мм». Для объёма накопителя отдельно проверяется верхний случай до 100% удержания **всего** песка, поскольку крупные частицы могут задерживаться лучше целевой мелкой фракции.

Для дополнительной проверки по предоставленной декларации берётся **190 мг/л общей взвеси** как *условный аналог*, а не измеренная концентрация песка на входе этой автомойки. Если искусственно считать всю такую взвесь песком, при 10 м³/сут получится 1,90 кг/сут всего песка. При неизвестной доле выбранной фракции `f` её масса на входе не более `1,90f кг/сут` при этом допущении, а целевые 60% соответствовали бы `1,14f кг/сут` удержанной массы. Анализ размера частиц и отдельная проба перед песколовкой всё равно обязательны.

## Критерий результата

**CFD** даёт обоснованный прогноз при подтверждённых границах, сеточной и статистической сходимости. **Фактическое «не менее 60%»** подтверждают представительные испытания по массе выбранной фракции с полным учётом входа, выхода, накопления и выгрузки. Пока этих данных нет, в документации указывать «целевая эффективность 60%; не подтверждена испытаниями».
