hisp2k/parameters/screw-conveyors/01-PT-SHT/deliverables/Переписка — Шнек 1.md

# Переписка по проекту «Шнек 1»

Экспорт видимых сообщений этого чата в хронологическом порядке. Время указано для Самары.
Автоматические блоки состояния приложения, служебные вызовы инструментов и скрытые инструкции не входят в переписку.

## 1. Пользователь — 01.10.2026 23:39:17

> # Files mentioned by the user:
>
> ## 01.PT.SHT.01.20.00.00 СБ 'Шнек 1': C:/Users/adm/Desktop/РАЗРАБОТКА/01.PT.SHT.01.20.00.00 СБ 'Шнек 1'/
>
>
> # Files pasted by the user:
>
> ## "# ИСПОЛНЯЕМЫЙ ПРОМТ ДЛЯ CODEX Ты работаешь с **существующей SolidWorks-моделью …": C:\Users\adm\.codex/attachments/3934b4eb-94ee-44f4-aa66-f44491236a24/Вставленный текст.txt
>
> параметризировать модель, сделать красивый интерфейс

---

## 2. Ассистент · ход работы — 01.10.2026 23:39:21

Сначала изучу структуру модели и приложенный текст, затем внесу параметризацию и подготовлю удобный интерфейс управления. Отдельно проверю, какие действия текст предлагает выполнять автоматически, чтобы не принять его за прямую команду от вас.

---

## 3. Ассистент · ход работы — 01.10.2026 23:39:38

В папке есть исходная сборка SolidWorks, детали, узлы привода и спецификация; SolidWorks сейчас запущен. Проверяю дерево сборки и текущие зависимости, чтобы определить, какие размеры можно безопасно вынести в параметры без перестройки геометрии с нуля.

---

## 4. Ассистент · ход работы — 01.10.2026 23:40:44

Предварительно видно, что это осевой шнек с готовыми подсборками трубы, вала, опор и привода. Дальше извлекаю из SolidWorks реальные компоненты, конфигурации, уравнения и управляющие элементы — по одним именам файлов нельзя надёжно выбрать параметры.

---

## 5. Ассистент · ход работы — 01.10.2026 23:42:12

Аудит всех деталей через API SolidWorks ещё выполняется. Уже подтверждено, что исходную сборку удалось открыть только для чтения; изменения буду делать в отдельной копии проекта, чтобы оригинал остался доступен для сравнения.

---

## 6. Ассистент · ход работы — 01.10.2026 23:43:57

Аудит выявил важную вещь: часть параметризации уже заложена в двух подсборках — у трубы и шнекового вала есть глобальные переменные и уравнения. Я сохраню эту логику и сделаю единый интерфейс для согласованного изменения размеров. В сборке также есть 88 экземпляров ссылок на отсутствующие файлы (16 уникальных путей), поэтому проверка всей сборки после изменения сейчас ограничена.

---

## 7. Ассистент · ход работы — 01.10.2026 23:45:51

Копия CAD подготовлена. При закрытии документов аудита SolidWorks завершил текущий процесс; исходные файлы не изменялись. Запускаю отдельный экземпляр для проверки копии и продолжу работу только с ней.

---

## 8. Ассистент · ход работы — 01.10.2026 23:49:00

Основные подсборки в копии открываются с локальными ссылками на их детали. Проверил запись уравнений через API: значения можно менять и возвращать обратно. Сейчас объединяю эти переменные в панель с проверками геометрии и сохранением в CAD.

---

## 9. Ассистент · ход работы — 01.10.2026 23:53:21

Интерфейс готов и запущен локально: он показывает геометрию, вычисляет зазор, проверяет ввод и применяет значения к двум подсборкам. Начальные значения уже записаны в копию и проверены: обе подсборки перестроились и сохранились без ошибок. Сейчас проверяю отображение панели и сценарий повторного открытия.

---

## 10. Ассистент · ход работы — 01.10.2026 23:53:22

Для визуальной проверки интерфейса использую навык computer-use.

---

## 11. Ассистент · ход работы — 01.10.2026 23:54:27

Проверка выявила ошибку передачи ответа между сервером и браузером на русской кодировке: SolidWorks сохранил изменённый диаметр и успешно перестроил подсборки, но кнопка в панели не получила сообщение об успехе. Исправляю кодировку, затем повторно проверю интерфейс и верну тестовый размер к исходным 140 мм.

---

## 12. Ассистент · ход работы — 01.10.2026 23:56:17

Повторная проверка прошла через саму панель: тестовое изменение диаметра записалось в SolidWorks, затем я вернул 140 мм; обе подсборки перестроились и сохранились без ошибок. Осталось проверить, что общая сборка в копии ссылается на скопированные детали, и оформить краткий аудит с ограничениями.

---

## 13. Ассистент · ход работы — 02.10.2026 00:00:48

Проверка общей копии завершена: 117 вхождений теперь разрешаются внутри пакета, 88 по 16 путям остаются без файлов. Я также добавил найденную шайбу в пакет, чтобы копия не зависела от сторонней рабочей папки. Оформил аудит и инструкцию запуска.

---

## 14. Ассистент · итоговый ответ — 02.10.2026 00:01:20

Сделал параметризацию **существующей модели осевого шнека** в отдельной копии. Исходная папка на рабочем столе не изменена. Локальная панель управления открыта; позже её можно запустить через [Запустить интерфейс.cmd](<C:\Users\adm\Documents\Codex\2026-10-01\x20\outputs\Шнек 1 — параметрическая модель\Запустить интерфейс.cmd>).

Панель управляет 13 размерами трубы, патрубка, винта и вала. Проверил изменение диаметра трубы с 140 до 141 мм и возврат к 140 мм: обе подсборки перестроились и сохранились без ошибок.

[Копия сборки SolidWorks](<C:\Users\adm\Documents\Codex\2026-10-01\x20\outputs\Шнек 1 — параметрическая модель\CAD\PT.SHT.01.20.00.00 СБ 'Шнек 1'.SLDASM>) · [Инструкция](<C:\Users\adm\Documents\Codex\2026-10-01\x20\outputs\Шнек 1 — параметрическая модель\README.md>) · [Аудит модели](<C:\Users\adm\Documents\Codex\2026-10-01\x20\outputs\Шнек 1 — параметрическая модель\Аудит модели.md>)

**Ограничение:** у общей сборки остаются 88 вхождений с отсутствующими файлами по 16 путям. Поэтому полная сборка и производственные чертежи пока не подтверждены; расчёты производительности и прочности в эту геометрическую панель не включены.

Автоматическая проверка заблокировала удаление лишних тестовых снимков по политике операций удаления. Они оставлены в `snapshots/` и не влияют на текущие CAD-файлы.

---

## 15. Пользователь — 02.10.2026 00:37:11

> проверить модель на изменение параметров и правильность работы калькулятора

---

## 16. Ассистент · ход работы — 02.10.2026 00:37:19

Проверю весь путь от ввода в панели до сохранённого размера в SolidWorks. Отдельно проверю вычисляемые значения и ограничения ввода. Под «калькулятором» в текущей версии понимаю расчёт геометрии в панели: зазор и полную длину.

---

## 17. Ассистент · ход работы — 02.10.2026 00:37:45

Нашёл вероятную ошибку в показателе зазора: панель вычитает диаметр винта из «диаметра трубы», но не учитывает стенку 5 мм. Проверю по геометрии детали, какой именно диаметр хранит переменная, и исправлю расчёт при подтверждении. Текущее значение диаметра трубы в рабочей копии — 141 мм; сохраню его после испытаний.

---

## 18. Ассистент · ход работы — 02.10.2026 00:39:27

Геометрия подтвердила ошибку: у трубы наружный радиус 70 мм, внутренний 65 мм. Значит исходный зазор при диаметре винта 125 мм равен **2,5 мм**, а не 7,5 мм. Нашёл и второй дефект: после перестроения подсборки SolidWorks меняет дочерние детали в памяти, но прежняя кнопка сохраняла только файл подсборки. Исправлю оба пункта и проверю сохранение после повторного открытия файлов.

---

## 19. Ассистент · ход работы — 02.10.2026 00:42:49

Сохранение дочерних деталей теперь проверено на изменённых значениях: после изменения длины, диаметра трубы, диаметра винта и шага я открыл файлы в отдельном экземпляре SolidWorks и увидел новые размеры на диске. Тестовые значения возвращены к тем, что были в рабочей копии перед проверкой. Теперь прогоняю остальные поля на отдельной испытательной копии и проверяю отклонение недопустимых сочетаний.

---

## 20. Ассистент · ход работы — 02.10.2026 00:45:19

Остальные 13 параметров проверены на отдельной копии: оба набора изменений перестроились, а уравнения и геометрия сохранились после закрытия и повторного открытия SolidWorks. Проверки ввода также отклоняют пересечение винта с трубой, недопустимые толщины, нецелое число витков и другие ошибочные значения. Завершаю проверку самой формулы в коде панели и зафиксирую результаты.

---

## 21. Ассистент · итоговый ответ — 02.10.2026 00:48:40

Проверил изменение всех **13 параметров** на отдельной копии модели. Обе подсборки перестроились; после закрытия и повторного открытия SolidWorks новые уравнения и геометрия сохранились в деталях.

Исправил две ошибки:

- Зазор теперь считается по **внутреннему** диаметру трубы, с учётом толщины стенки. При текущих размерах он составляет **0,5 мм**, полная длина — **2780 мм**.
- При применении параметров теперь сохраняются изменённые детали вместе с подсборками.

Проверки ввода отклоняют пересечение винта с трубой и другие недопустимые значения. Рабочие размеры, бывшие в модели до испытаний, восстановлены. Подробности — в [отчёте о проверке](<C:\Users\adm\Documents\Codex\2026-10-01\x20\outputs\Шнек 1 — параметрическая модель\Проверка параметров.md>).

Открытая вкладка на порту `59374` относится к старому запуску; используйте [запуск интерфейса](<C:\Users\adm\Documents\Codex\2026-10-01\x20\outputs\Шнек 1 — параметрическая модель\Запустить интерфейс.cmd>). Калькулятор пока считает геометрию. Рабочий зазор под нагрузкой, производительность и прочность не рассчитаны; общая сборка всё ещё имеет 88 вхождений с отсутствующими ссылками.

---

## 22. Пользователь — 02.10.2026 00:49:45

> Добавить в программе выбор трубы по ГОСТ, выбор шага по ГОСТ, выбор материала по ГОСТ

---

## 23. Ассистент · ход работы — 02.10.2026 00:49:56

Добавлю справочники в интерфейс и свяжу выбор с моделью. Сначала проверю применимые ГОСТ и доступные типоразмеры: для трубы, материала и шага могут действовать разные документы, поэтому выбор будет показывать источник и не подменять непроверенные данные «стандартными».

---

## 24. Ассистент · ход работы — 02.10.2026 00:51:29

Нашёл таблицу пар «диаметр винта — шаг» в ГОСТ 2037-82. Текущий винт Ø130 мм в этот ряд не входит, поэтому сохраню существующий размер как пользовательский; при выборе стандартного шага программа предложит соответствующий стандартный диаметр и проверит зазор с трубой.

---

## 25. Ассистент · ход работы — 02.10.2026 00:54:29

Сверил область применения ГОСТ 2037-82: для наклонного конвейера он указывает угол до 20°, а в текущей модели 55°. Поэтому список будет обозначен как выбор **размерной пары из таблицы ГОСТ**, без заявления, что вся сборка соответствует стандарту. Для материала добавлю выбор марки с сохранением в проекте; назначение физических свойств в SolidWorks требует отдельной проверенной библиотеки материалов.

---

## 26. Ассистент · ход работы — 02.10.2026 00:55:51

Справочники и проверку соответствия выбранных размеров уже связал с формой. Сейчас проверяю два уровня: корректность данных на сервере и реальное перестроение копии SolidWorks при выборе пары Ø140×5 / Ø125, шаг 100, после чего верну исходные параметры модели.

---

## 27. Ассистент · итоговый ответ — 02.10.2026 00:57:06

Добавил в программу выбор трубы по ГОСТ 10704-91, пары «диаметр винта — шаг» по таблице ГОСТ 2037-82 и марки стали по ГОСТ 5632-2014. Выбранные размеры переходят в параметры модели; сервер проверяет, что они совпадают с позицией каталога. Исходные размеры сохранены как пользовательские.

Проверил выбор Ø140×5 и винта Ø125 с шагом 100: обе подсборки SolidWorks перестроились и сохранились. Затем вернул исходные параметры. Обновлённый интерфейс можно открыть через [Запустить интерфейс.cmd](<C:/Users/adm/Documents/Codex/2026-10-01/x20/outputs/Шнек 1 — параметрическая модель/Запустить интерфейс.cmd>).

**Ограничения:** марка стали пока сохраняется как выбор проекта, но физический материал детали в SolidWorks не назначается. Кроме того, угол исходной модели 55° превышает предел 20° для наклонных конвейеров по ГОСТ 2037-82; выбор пары размеров не подтверждает соответствие всей сборки стандарту. Это пояснено в [README.md](<C:/Users/adm/Documents/Codex/2026-10-01/x20/outputs/Шнек 1 — параметрическая модель/README.md>). Источники: [ГОСТ 10704-91](https://protect.gost.ru/gost/details/9d92e82e-d057-436a-abd4-5a56a7e07e96), [текст ГОСТ 2037-82](https://files.stroyinf.ru/Data2/1/4294751/4294751811.pdf), [ГОСТ 5632-2014](https://protect.gost.ru/gost/details/d6ac3954-d07e-4a10-a038-f3ab9b1d5b7b).

---

## 28. Пользователь — 02.10.2026 00:59:42

> проверить соединение прог8раммы расчета и расчетного модуля

---

## 29. Ассистент · ход работы — 02.10.2026 00:59:48

Проверю, как интерфейс передаёт данные расчётному модулю, какие результаты получает обратно и сохраняются ли они при применении параметров. Сначала найду точку подключения и сам модуль в файлах проекта.

---

## 30. Ассистент · ход работы — 02.10.2026 01:00:20

В текущем проекте отдельного расчётного модуля пока не обнаружил: интерфейс считает только геометрические показатели в браузере, а сервер передаёт параметры в мост SolidWorks. Проверю этот фактический маршрут по API и отдельно зафиксирую, какие расчётные функции к нему не подключены.

---

## 31. Ассистент · итоговый ответ — 02.10.2026 01:01:28

Проверил соединение. **Интерфейс ↔ сервер ↔ SolidWorks работает:** запрос с текущими параметрами прошёл, обе подсборки перестроились; ошибочный выбор типоразмера сервер отклонил. Исходные параметры сохранены. Проверка геометрических показателей в интерфейсе тоже прошла: зазор 0,5 мм, полная длина 2780 мм.

**Отдельный расчётный модуль сейчас не подключён.** В [программе](<C:/Users/adm/Documents/Codex/2026-10-01/x20/outputs/Шнек 1 — параметрическая модель/index.html>) раздел «Расчёт и подбор» отключён; расчёта производительности, мощности и нагрузок в доступных файлах нет. Поэтому соединение именно с ним подтвердить нельзя.

Открытая вкладка на порту `59374` устарела — сервер там не работает. Текущий интерфейс: [открыть программу](http://127.0.0.1:64489/). Если расчётный модуль существует отдельно, укажите его файл или папку, и я проверю подключение к нему.

---

## 32. Пользователь — 02.10.2026 01:04:51

> сделать и подключить расчетный модуль, расчеты производить в соответсвии с ГОСТ

---

## 33. Ассистент · ход работы — 02.10.2026 01:05:04

Сделаю отдельный расчётный модуль и подключу его к интерфейсу. Сначала сверю нормативные формулы и область применения: у исходной модели угол 55°, а ГОСТ 2037-82 для наклонных конвейеров охватывает угол до 20°, поэтому расчёт не должен выдавать ложное «соответствует ГОСТ» для текущего исполнения.

---

## 34. Ассистент · ход работы — 02.10.2026 01:05:59

Нормативная часть определилась: ГОСТ 2037-82 задаёт ряд диаметров и шагов, частоты вращения, ряд расчётной объёмной производительности, зазор 8–10 мм и способ стендовой проверки подачи. Он не даёт универсальной формулы, по которой можно достоверно предсказать подачу этой 55° модели без свойств груза и испытаний. Модуль разделит нормативные проверки, геометрический расчёт и результат по измеренной подаче.

---

## 35. Пользователь — 02.10.2026 01:06:35

> Вопрос: Какой груз транспортирует шнек и каковы его насыпная плотность (кг/м³), требуемая производительность (м³/ч или т/ч) и частота вращения винта (об/мин), если они известны?
>
> Ответ: взять из справочников и предложить область применения транспортеров

---

## 36. Ассистент · ход работы — 02.10.2026 01:07:56

Из справочника производителя подобрал возможную область применения: перегрузка сухого зерна и семян. Добавлю в модуль справочные диапазоны плотности для пшеницы, льняного семени и пшеничной муки с указанием источника. Эти диапазоны будут подсказкой для предварительной оценки, а фактическую плотность и режим работы программа оставит отдельными входными данными.

---

## 37. Ассистент · ход работы — 02.10.2026 01:11:40

Расчётный API и раздел интерфейса подключены. Сейчас запускаю обновлённый сервер на постоянном адресе `127.0.0.1:59374`, который уже открыт у вас во вкладке, и проверяю полный путь «форма → модуль → результат», включая отказ при некорректных данных.

---

## 38. Ассистент · итоговый ответ — 02.10.2026 01:12:29

Сделал и подключил [расчётный модуль](<C:/Users/adm/Documents/Codex/2026-10-01/x20/outputs/Шнек 1 — параметрическая модель/calculation.py>) к [интерфейсу](http://127.0.0.1:59374/). Он получает текущие размеры модели, проверяет параметры по [ГОСТ 2037-82](https://files.stroyinf.ru/Data2/1/4294751/4294751811.pdf), подбирает значение из нормативного ряда заявленной подачи и рассчитывает фактическую подачу по массе и времени испытания. Соединение проверено через API: расчёт возвращает результат, ошибочные данные отклоняются, введённые данные сохраняются.

По просьбе использовать справочники предложил применение для **перегрузки сухого зерна и семян**. В программе доступны справочные диапазоны плотности пшеницы, льняного семени и пшеничной муки из [руководства KWS](https://www.kwsmfg.com/engineering-guides/screw-conveyor/bulk-material-table/); они не подменяют измерение конкретного груза.

Для **текущей модели результат — `BLOCK`**: угол 55° превышает предел 20° по ГОСТ, зазор 0,5 мм меньше требуемых 8–10 мм, а пара Ø130/шаг 105 отсутствует в таблице стандарта. При таком угле [KWS рекомендует рассматривать вертикальную схему проектирования](https://www.kwsmfg.com/wp-content/uploads/Screw-Conveyor-Engineering-Guide.pdf). Достоверную производительность и мощность привода модуль пока не выдаёт без данных о грузе, режиме и испытаниях; условный геометрический объём в интерфейсе явно отделён от фактической подачи. Подробности — в [README.md](<C:/Users/adm/Documents/Codex/2026-10-01/x20/outputs/Шнек 1 — параметрическая модель/README.md>).

---

## 39. Пользователь — 02.10.2026 01:17:06

> добавить расширенный список материала для транспортировки

---

## 40. Ассистент · ход работы — 02.10.2026 01:17:11

Расширю справочник грузов в расчётном разделе и добавлю поиск по нему. Для каждой позиции сверю диапазон насыпной плотности и крупность с источником, а для угла 55° отдельно покажу, где справочник допускает применение в вертикальном шнеке.

---

## 41. Пользователь — 02.10.2026 01:18:10

> проверить правильность и комплектность изделий в модели сборки и её отображение

---

## 42. Ассистент · ход работы — 02.10.2026 01:18:19

Добавляю расширенный справочник грузов. Одновременно проверю главную сборку: состав деталей и подсборок, отсутствующие ссылки, подавленные и скрытые компоненты, а затем то, что SolidWorks действительно может отобразить. Сопоставлю результаты с имеющейся ведомостью и отмечу расхождения.

---

## 43. Ассистент · ход работы — 02.10.2026 01:21:53

Сверю состав сборки со спецификацией и проверю, какие компоненты SolidWorks реально находит и отображает. Параллельно завершу проверку расширенного справочника грузов в калькуляторе.

---

## 44. Ассистент · ход работы — 02.10.2026 01:22:08

Для сверки с `BOM.xlsx` применю навык Spreadsheets. Сначала прочитаю ведомость и дерево сборки, затем сравню позиции и количество без изменения исходной таблицы.

---

## 45. Ассистент · ход работы — 02.10.2026 01:22:47

По предварительной сверке нашёл расхождения между ведомостью и составом сборки: отдельная деталь отсутствует в BOM, а для части крепежа и стопорного кольца обозначения или количество отличаются. Проверю их на текущей копии сборки и отдельно зафиксирую, какие файлы доступны для отображения.

---

## 46. Ассистент · ход работы — 02.10.2026 01:25:08

Текущая сборка открывается и общий вид шнека отображается, но проверка дерева показывает 88 подавленных вхождений с отсутствующими файлами. Это в основном крепёж, а также несколько деталей. В ведомости 58 позиций; по количествам есть одно лишнее стопорное кольцо в модели, плюс несовпадение стандарта шайб и одна деталь вне BOM. Сейчас оформлю точный перечень и проверю, что новый справочник доступен через сервер и расчёт.

---

## 47. Ассистент · итоговый ответ — 02.10.2026 01:27:00

Проверил рабочую сборку SolidWorks и сравнил её с BOM. **Сборка отображается, но комплектность не подтверждена:** из 205 вхождений 117 разрешены, а 88 подавлены и ссылаются на 16 отсутствующих файлов. Внешний вид корпуса, опоры и привода выводится; по нему нельзя проверить подавленные детали.

Обнаружены три расхождения с BOM: в модели два кольца D80 вместо одного, 40 шайб М8 обозначены DIN 127 вместо DIN 128, а «Сбрасыватель» присутствует в дереве, но отсутствует в ведомости. [Полный отчёт и перечень файлов](</C:/Users/adm/Documents/Codex/2026-10-01/x20/outputs/Шнек 1 — параметрическая модель/Проверка комплектности и отображения.md>).

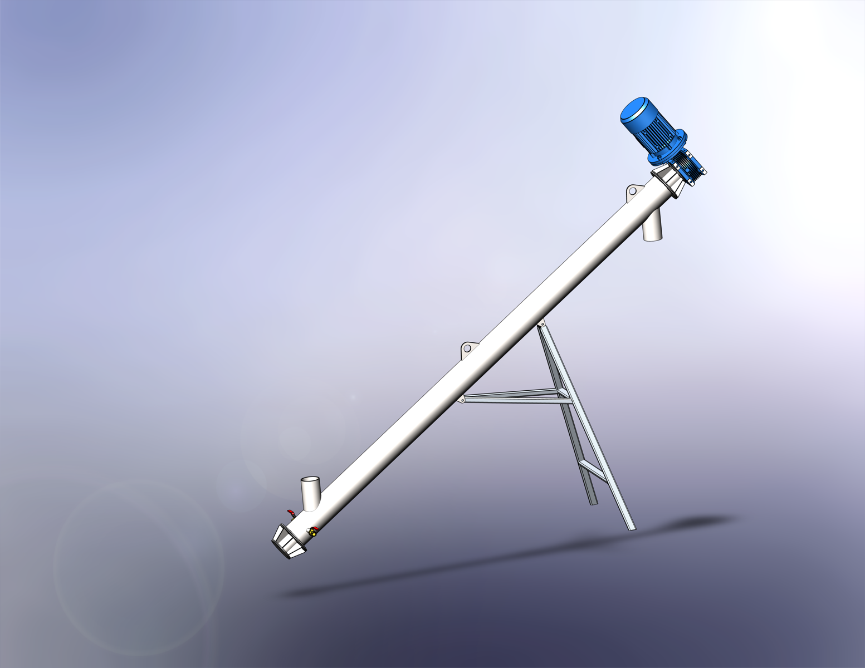
[picture p16: screw-conveyors/01-PT-SHT/deliverables/Шнек 1 — параметрическая модель/Вид сборки.png]
Текущий вид сборки


Расширенный справочник содержит **27 грузов** с поиском и группами. Все 27 позиций проходят вызов расчётного модуля; обновлённый сервер выдаёт их через интерфейс. Справочные свойства грузов взяты из [таблицы KWS](https://www.kwsmfg.com/engineering-guides/screw-conveyor/bulk-material-table/), а не обозначены как значения ГОСТ.

---

## 48. Пользователь — 02.10.2026 05:16:15

> исправить ошибку при открытии

---

## 49. Ассистент · ход работы — 02.10.2026 05:16:21

Проверю запуск интерфейса и открытие сборки по текущим файлам и журналам, затем воспроизведу ошибку и исправлю её причину.

---

## 50. Пользователь — 02.10.2026 05:16:56

> Вопрос: Что именно не открывается: кнопка «Открыть сборку» в интерфейсе, файл SolidWorks или сам интерфейс? Пришлите текст ошибки либо снимок экрана.
>
> Ответ: Кнопка «Открыть сборку»

---

## 51. Ассистент · ход работы — 02.10.2026 05:17:10

Кнопка сейчас использует Windows `os.startfile()` и сразу сообщает об успехе, не проверяя, открыл ли SolidWorks сборку. Заменю это на открытие через SolidWorks API с проверкой результата и понятным сообщением о недостающих ссылках.

---

## 52. Ассистент · ход работы — 02.10.2026 05:19:08

Причину удалось воспроизвести: SolidWorks открывает саму сборку, но сообщает код загрузки `2` из-за отсутствующих файлов компонентов. Кнопка теперь проверяет открытие через SolidWorks и показывает, что сборка открыта частично, вместо молчаливого «успеха». Проверяю обновлённый маршрут интерфейса.

---

## 53. Ассистент · итоговый ответ — 02.10.2026 05:20:07

Исправил кнопку **«Открыть CAD»**: она теперь открывает сборку через SolidWorks, проверяет результат и показывает причину неполной загрузки. Проверил вызов из интерфейса — сборка открывается.

Остаётся проблема исходной модели: **88 вхождений ссылаются на 16 отсутствующих файлов**. SolidWorks сообщает о таких ссылках при загрузке; их перечень есть в [отчёте о комплектности](</C:/Users/adm/Documents/Codex/2026-10-01/x20/outputs/Шнек 1 — параметрическая модель/Проверка комплектности и отображения.md>). Обновите страницу интерфейса и нажмите кнопку ещё раз.

---

## 54. Пользователь — 02.10.2026 05:54:32

> добавить кнопку построение чертежей с модели, Вести журнал учета и наименований и количества изменений в проектов, данные сведения отображать в журнале, добавить в визуальную форму наименование проекта.

---

## 55. Ассистент · ход работы — 02.10.2026 05:54:44

Добавлю в форму название проекта, кнопку создания чертежей и журнал применённых изменений. Сначала проверю текущую запись параметров в CAD и доступные шаблоны SolidWorks, чтобы чертежи создавались из сохранённой модели и журнал отражал реальные изменения.

---

## 56. Ассистент · ход работы — 02.10.2026 05:55:29

Нашёл установленный шаблон чертежа ГОСТ и существующий исходный чертёж сборки. Новые чертежи буду сохранять отдельно, чтобы не перезаписать исходник. В журнал внесу успешные применения параметров с именами полей и количеством изменений; создание чертежей запишу отдельным событием.

---

## 57. Ассистент · ход работы — 02.10.2026 06:00:37

Пробный чертёж строится из сборки: SolidWorks создал три ортогональных вида, связал их с моделью и сохранил `.SLDDRW`. Перехожу к кнопке и журналу в интерфейсе. Для повторного построения будет создаваться отдельный набор файлов, чтобы прежние версии сохранялись.

---

## 58. Ассистент · ход работы — 02.10.2026 06:03:08

Журнал готов: он записывает только успешные изменения CAD и показывает прежнее и новое значение каждого поля. Повторное применение без новых значений не увеличивает счётчик. Генератор создал три чертежа на пробном запуске; теперь проверю запуск кнопкой через сервер и запись набора в журнал.

---

## 59. Ассистент · ход работы — 02.10.2026 06:07:49

Кнопка через сервер построила и сохранила три чертежа; журнал отобразил один набор из трёх файлов. Просмотрел чертёж сборки: все три вида присутствуют. Он остаётся предварительным — в сборке есть отсутствующие ссылки, а размеры и оформление для выпуска требуют проверки.

---

## 60. Ассистент · итоговый ответ — 02.10.2026 06:08:29

В форме появилось **наименование проекта «Шнек 1»**, кнопка **«Построить чертежи»** и журнал. Журнал показывает количество применений, изменённых параметров и чертежей, а для каждой правки — прежнее и новое значение. Более ранняя история правок в него не перенесена.

Кнопку проверил: SolidWorks создал по три связанных с моделью вида в каждом из трёх файлов — [сборка шнека](<C:/Users/adm/Documents/Codex/2026-10-01/x20/outputs/Шнек 1 — параметрическая модель/Чертежи/20261002-060318-973921/Сборка шнека.SLDDRW>), [труба в сборе](<C:/Users/adm/Documents/Codex/2026-10-01/x20/outputs/Шнек 1 — параметрическая модель/Чертежи/20261002-060318-973921/Труба в сборе.SLDDRW>) и [шнековый вал](<C:/Users/adm/Documents/Codex/2026-10-01/x20/outputs/Шнек 1 — параметрическая модель/Чертежи/20261002-060318-973921/Шнековый вал.SLDDRW>). Создание записано в [журнал](<C:/Users/adm/Documents/Codex/2026-10-01/x20/outputs/Шнек 1 — параметрическая модель/journal.json>).

Чертежи **предварительные**: в сборке остаются отсутствующие ссылки; размеры и оформление нужно проверить перед выпуском. Обновите страницу интерфейса, чтобы увидеть новые элементы.

---

## 61. Пользователь — 02.10.2026 06:17:16

> выгрузить в Md всю конву разговора

---

## 62. Ассистент · ход работы — 02.10.2026 06:17:24

Сохраню разговор в Markdown. Проверю доступную историю чата и отмечу в файле любые фрагменты, которые нельзя восстановить дословно.

---

## 63. Ассистент · ход работы — 02.10.2026 06:18:48

Нашёл локальную историю чата. В выгрузку войдут все доступные сообщения пользователя и видимые ответы ассистента, включая промежуточные обновления. Автоматические блоки состояния интерфейса и служебные вызовы инструментов исключу; ответы на уточняющие вопросы сохраню с текстом вопроса.

---

Всего сообщений: 63. Сообщений пользователя: 12; ассистента: 51.
