hisp2k/parameters/screw-conveyors/01-PT-SHT/development/tube_trial_info.txt

0 "Толщина стенки трубы"= 5мм
1 "Диаметр трубы"= 141мм
2 "Длина трубы"= 2510мм + 270
3 "Угол наклона"= 55градусов
4 "Диаметр патрубка"= 100мм
5 "Длина патрубка"= 200мм
6 "Толщина стенки патрубка"= 3мм
7 "D1@Вытянуть-Тонкостенный1@PT.SHT.01.21.00.05 'Патрубок шнека'_TCR04<1>.Part" = "Длина патрубка"
8 "D5@Вытянуть-Тонкостенный1@PT.SHT.01.21.00.05 'Патрубок шнека'_TCR04<1>.Part" = "Толщина стенки патрубка"
9 "D1@Эскиз1@PT.SHT.01.21.00.05 'Патрубок шнека'_TCR04<1>.Part" = "Диаметр патрубка"
10 "D1@Эскиз2@PT.SHT.01.21.00.05 'Патрубок шнека'_TCR04<1>.Part" = "Диаметр трубы" - "Толщина стенки трубы" * 2
11 "Толщина фланца"= 5мм
12 "D1@Эскиз1@PT.SHT.01.21.00.13 'Фланец трубы шнека'_TCR04<1>.Part" = "Диаметр трубы"
13 "D3@Эскиз1@PT.SHT.01.21.00.13 'Фланец трубы шнека'_TCR04<1>.Part" = "Диаметр трубы" + 60мм
14 "D2@Эскиз1@PT.SHT.01.21.00.13 'Фланец трубы шнека'_TCR04<1>.Part" = "Диаметр трубы" + 30мм
15 "D1@Бобышка-Вытянуть1@PT.SHT.01.21.00.13 'Фланец трубы шнека'_TCR04<1>.Part" = "Толщина фланца"
16 "Отверстие М8"= 8мм
17 "D4@Эскиз1@PT.SHT.01.21.00.13 'Фланец трубы шнека'_TCR04<1>.Part" = "Отверстие М8" + 0.8мм
18 "D1@Эскиз2@PT.SHT.01.21.00.09 'Труба шнека'_TCR04<1>.Part" = "Диаметр трубы"
19 "D5@Вытянуть-Тонкостенный1@PT.SHT.01.21.00.09 'Труба шнека'_TCR04<1>.Part" = "Толщина стенки трубы"
20 "D1@Вытянуть-Тонкостенный1@PT.SHT.01.21.00.09 'Труба шнека'_TCR04<1>.Part" = "Длина трубы"
21 "D1@Эскиз7@PT.SHT.01.21.00.09 'Труба шнека'_TCR04<1>.Part" = "Диаметр патрубка"
22 "D1@Расстояние7"="Длина трубы" - "Толщина фланца"
23 "Диаметр сбрасывателя"= 110мм
24 "Толщина стенки сбрасывателя"= 3мм
25 "D1@Эскиз10@PT.SHT.01.21.00.09 'Труба шнека'_TCR04<1>.Part" = "Диаметр сбрасывателя"
26 "D2@Эскиз10@PT.SHT.01.21.00.09 'Труба шнека'_TCR04<1>.Part" = "Длина трубы" - 150мм
27 "D1@Расстояние27" = "Длина трубы" - 150мм - 280мм
28 "Длина сбрасывателя"= 200мм
29 "D1@Расстояние26"="Длина сбрасывателя" + 180мм
30 "D1@Плоскость1@PT.SHT.01.21.00.05 'Патрубок шнека'_TCR04<1>.Part" = "Угол наклона"
31 "D1@Плоскость5@PT.SHT.01.21.00.09 'Труба шнека'_TCR04<1>.Part" = "Угол наклона" + 90градусов
32 "D1@ПЛОСКОСТЬ1"="Угол наклона"
33 "D1@ПЛОСКОСТЬ3"="Угол наклона" + 90градусов
34 "D1@Эскиз2@PT.SHT.01.21.00.03 'Патрубок промывки'_TCR04<1>.Part" = "Диаметр трубы" - "Толщина стенки трубы" * 2
35 "D2@Эскиз2@PT.SHT.01.21.00.03 'Патрубок промывки'_TCR04<1>.Part" = "Диаметр трубы" / 2 + 66мм
36 "D1@Расстояние22"="Диаметр трубы"/2 + 66мм
37 "D1@Расстояние24"="Диаметр трубы"/2 + 66мм
38 "D1@Угол1"=90градусов - "Угол наклона"
39 "D1@Угол2"="Угол наклона"
40 "D1@Расстояние21"="Длина трубы"/2 - 280мм
41 "D1@Расстояние20"=180мм - "Диаметр трубы"/2
42 "D1@Расстояние28"=180мм - "Диаметр трубы"/2
43 "D1@Расстояние29"="Длина трубы" - 150мм - 280мм
COMP PT.SHT.01.21.00.05 'Патрубок шнека'_TCR04-1 C:\Users\adm\Documents\Codex\2026-10-01\x20\work\tube_collision_trial\PT.SHT.01.21.00.05 'Патрубок шнека'_TCR04.SLDPRT [-1.0000000000000002, 0.0, 0.0, 0.0, -1.0, 0.0, 0.0, 0.0, 1.0000000000000002, 0.0, 0.0, 0.0, 1.0, 0.0, 0.0, 0.0]
COMP PT.SHT.01.21.00.05 'Патрубок шнека'_TCR04-2 C:\Users\adm\Documents\Codex\2026-10-01\x20\work\tube_collision_trial\PT.SHT.01.21.00.05 'Патрубок шнека'_TCR04.SLDPRT [-1.0000000000000002, 0.0, 0.0, 0.0, 1.0, 0.0, 0.0, 0.0, -1.0000000000000002, 0.0, 1.0, -2.06, 1.0, 0.0, 0.0, 0.0]
COMP PT.SHT.01.21.00.09 'Труба шнека'_TCR04-1 C:\Users\adm\Documents\Codex\2026-10-01\x20\work\tube_collision_trial\PT.SHT.01.21.00.09 'Труба шнека'_TCR04.SLDPRT [1.0, 0.0, 0.0, 0.0, 0.5735764363510446, -0.8191520442889929, 0.0, 0.8191520442889929, 0.5735764363510446, 0.0, -0.3080487701503116, 0.12611881385773058, 1.0, 0.0, 0.0, 0.0]
COMP PT.SHT.01.21.00.11 'Ухо'_TCR04-1 C:\Users\adm\Documents\Codex\2026-10-01\x20\work\tube_collision_trial\PT.SHT.01.21.00.11 'Ухо'_TCR04.SLDPRT [0.0, -0.5735764363510446, 0.8191520442889929, 0.0, 0.8191520442889929, 0.5735764363510446, -1.0, 0.0, 0.0, -0.03, 0.6424702107456941, -1.381299398502866, 1.0, 0.0, 0.0, 0.0]
COMP PT.SHT.01.21.00.11 'Ухо'_TCR04-2 C:\Users\adm\Documents\Codex\2026-10-01\x20\work\tube_collision_trial\PT.SHT.01.21.00.11 'Ухо'_TCR04.SLDPRT [1.9278820503002185e-17, 0.5735764363510445, -0.8191520442889929, -1.0933562422235106e-16, 0.8191520442889929, 0.5735764363510445, 1.0, 7.850462293418855e-17, 7.850462293418785e-17, 0.029999999999999947, 0.6424702107456941, -1.381299398502866, 1.0, 0.0, 0.0, 0.0]
COMP PT.SHT.01.21.00.07 'Сбрасыватель'_TCR04-1 C:\Users\adm\Documents\Codex\2026-10-01\x20\work\tube_collision_trial\PT.SHT.01.21.00.07 'Сбрасыватель'_TCR04.SLDPRT [1.0, 0.0, 0.0, 0.0, 0.819152044288993, 0.5735764363510446, 0.0, -0.5735764363510446, 0.819152044288993, 0.0, 1.0366268485951364, -2.1429663498925295, 1.0, 0.0, 0.0, 0.0]
COMP PT.SHT.01.21.00.11 'Ухо'_TCR04-4 C:\Users\adm\Documents\Codex\2026-10-01\x20\work\tube_collision_trial\PT.SHT.01.21.00.11 'Ухо'_TCR04.SLDPRT [0.0, 0.5735764363510446, -0.8191520442889929, 0.0, 0.8191520442889929, 0.5735764363510446, 1.0, 0.0, 0.0, 0.03, 0.2983243489350676, -0.8898081719294706, 1.0, 0.0, 0.0, 0.0]
COMP PT.SHT.01.21.00.11 'Ухо'_TCR04-3 C:\Users\adm\Documents\Codex\2026-10-01\x20\work\tube_collision_trial\PT.SHT.01.21.00.11 'Ухо'_TCR04.SLDPRT [0.0, -0.5735764363510446, 0.8191520442889929, 0.0, 0.8191520442889929, 0.5735764363510446, -1.0, 0.0, 0.0, -0.03, 0.2983243489350676, -0.8898081719294706, 1.0, 0.0, 0.0, 0.0]
