hisp2k/parameters/screw-conveyors/25-SHT-G/deliverables/Опросный_лист_шнекового_транспортера.md

# Опросный лист: параметрический шнековый транспортёр

Заполняются только основные поля. Вопросы о материале, нескольких загрузках и нестандартном шнеке появляются по условию. Размеры — в миллиметрах, если не указана другая единица. Разделы 1–4 достаточны для постановки задачи и предварительной компоновки; перед окончательным расчётом прочности нужны данные разделов 5–7 либо подтверждённые справочные карточки и расчётные допущения.

## 1. Основные параметры

| № | Вопрос | Ответ |
|---|---|---|
| 1 | Длина **рабочей части желоба**, 500–25 000 мм | ______ мм |
| 2 | Угол наклона к горизонту, 0–20° | ______ ° |
| 3 | Требуемая суммарная производительность | ______ м³/ч |
| 4 | Общий объём одной загрузки | ______ м³ |
| 5 | Транспортируемый материал: название или код из справочника | ______ |

Объём разовой загрузки общий для транспортёра. Производительность вводится отдельно; время перемещения объёма можно рассчитать как `V / Q`, если режим работы это допускает.

## 2. Шнек

| Вопрос | Ответ |
|---|---|
| Наружный диаметр, допустимый диапазон 50–600 мм | ☐ подобрать автоматически  ☐ задать ______ мм |
| Шаг винта | ☐ выбрать из пары по ГОСТ для стандартного диаметра  ☐ задать ______ мм |

Для стандартных диаметров в заданном диапазоне [ГОСТ 2037-82, табл. 1](https://files.stroyinf.ru/Data2/1/4294751/4294751811.pdf) задаёт пары `D/S`: 100/80 или 100; 125/100 или 125; 160/125 или 160; 200/160 или 200; 250/200 или 250; 320/250 или 320; 400/320 или 400; 500/400 или 500. Диаметры вне этого ряда оформляются как нестандартные исполнения; для них шаг указывается отдельно в миллиметрах. Выбор диаметра и шага должен пройти расчёт и проверку применимости для материала.

## 3. Загрузка

**Количество загрузочных горловин:** ______ шт. (1–7).

После ввода количества заполнить по одной строке на каждую горловину:

| № | Центр от начала рабочей части желоба, мм | Форма | Размер, мм |
|---:|---:|---|---|
| 1 | ______ | ☐ круглая ☐ прямоугольная | Ø______ или длина ______ × ширина ______ |
| 2 | ______ | ☐ круглая ☐ прямоугольная | Ø______ или длина ______ × ширина ______ |
| 3 | ______ | ☐ круглая ☐ прямоугольная | Ø______ или длина ______ × ширина ______ |
| 4 | ______ | ☐ круглая ☐ прямоугольная | Ø______ или длина ______ × ширина ______ |
| 5 | ______ | ☐ круглая ☐ прямоугольная | Ø______ или длина ______ × ширина ______ |
| 6 | ______ | ☐ круглая ☐ прямоугольная | Ø______ или длина ______ × ширина ______ |
| 7 | ______ | ☐ круглая ☐ прямоугольная | Ø______ или длина ______ × ширина ______ |

**Если горловин больше одной:** могут ли они подавать материал одновременно? ☐ да ☐ нет. Если да, укажите расход по каждой действующей горловине, м³/ч: ______. Сумма расходов должна соответствовать требуемой суммарной производительности.

## 4. Выгрузка

**Количество точек выгрузки:** ______ шт. (1–2).

| № | Центр от начала рабочей части желоба, мм | Направление | Форма | Размер, мм |
|---:|---:|---|---|---|
| 1 | ______ | ☐ вниз ☐ вбок: ☐ влево ☐ вправо | ☐ круглая ☐ прямоугольная | Ø______ или длина ______ × ширина ______ |
| 2 | заполнить при наличии | ☐ вниз ☐ вбок: ☐ влево ☐ вправо | ☐ круглая ☐ прямоугольная | Ø______ или длина ______ × ширина ______ |

«Влево» и «вправо» определяются при взгляде **по направлению движения материала**. Торцевая выгрузка не предусмотрена.

## 5. Свойства материала — если нет проверенной карточки в справочнике

Эти свойства нужны для расчёта и выбора конструкции; их нельзя надёжно получить из одного названия материала.

| Свойство | Ответ |
|---|---|
| Насыпная плотность | ______ кг/м³ |
| Максимальный размер частицы или куска | ______ мм |
| Абразивность | ☐ низкая ☐ средняя ☐ высокая |
| Сыпучесть/склонность к налипанию | ☐ свободносыпучий ☐ слёживается/налипает |
| Рабочая температура материала | ______ °C |
| Коррозионное воздействие на контактные детали | ☐ нет ☐ есть, указать ______ |

Если справочника с проверенными свойствами нет, этот раздел обязателен. Для материала с меняющимися свойствами указываются наиболее тяжёлые рабочие состояния, в том числе наибольшая насыпная плотность и влажность. При отсутствии этих данных подбор привода, вала, футеровки и контактных материалов остаётся предварительным.

## 6. Монтаж и условия площадки

| Вопрос | Ответ |
|---|---|
| Высота оси шнека у начала желоба от опорной поверхности | ______ мм; ☐ принять существующую установку после обмера |
| Можно ли располагать промежуточные опоры по расчёту? | ☐ да ☐ нет, разрешённые места ______ |
| Размещение и среда | ☐ в помещении ☐ снаружи; особые требования к мойке, взрывозащите, агрессивной среде ______ |

## 7. Расчётные режимы — для окончательного расчёта прочности

| Вопрос | Ответ |
|---|---|
| Режим работы | ☐ непрерывный ☐ периодический; ______ ч/сутки; ______ пусков/час |
| Пуск с заполненным желобом | ☐ возможен ☐ исключён технологией |
| Реверс вращения | ☐ нужен ☐ не нужен |
| Возможна закупорка выгрузки | ☐ да ☐ нет; предусмотрена ли защита привода от перегрузки ______ |
| Загрузка непосредственно из бункера | ☐ нет ☐ да; если да — максимальная высота столба материала над входом ______ мм |
| Две точки выгрузки | ☐ работают одновременно ☐ поочерёдно; распределение расхода при одновременной работе ______ м³/ч |
| Требуемый ресурс | ______ ч; ☐ принять требование применимого стандарта после проверки области его действия |

Инженер дополнительно назначает и документирует материал и толщины деталей, характеристики сварных соединений, расчётные коэффициенты, расположение и тип подшипников, параметры привода, допускаемые прогибы и нагрузки на опоры/крепления. Для расчёта нужны проверяемые источники свойств материала и каталогов; эти решения нельзя вывести только из геометрии.

[ГОСТ 2037-82](https://files.stroyinf.ru/Data2/1/4294751/4294751811.pdf) относится к стационарным конвейерам общего назначения с насыпной плотностью груза до 2600 кг/м³, размером куска до 20 мм и температурой до 80 °C; он исключает указанные в документе специальные и агрессивные условия. При выходе за область действия требуется отдельное техническое задание и проверка применимых норм.

## Вычисляется системой и не запрашивается как вход

После заполнения исходных данных и утверждения инженерных правил система должна вычислять число секций винта и желоба, координаты опор, длины валов и крышек, число витков, габариты, массу, спецификацию, зазоры, требуемую скорость и мощность, выбирать привод и подшипники, обновлять чертежи. Для секций винта учитывать ограничение длины не более 4 м по [ГОСТ 2037-82, п. 3.6](https://files.stroyinf.ru/Data2/1/4294751/4294751811.pdf). Эти функции описывают требуемую будущую модель; в текущей копии SolidWorks реализована параметризация только шнека.
