hisp2k/parameters/screw-conveyors/25-SHT-G/deliverables/Сведения_по_шнековому_транспортеру_из_чата.md

# Шнековый транспортёр — сведения и решения из чата

Дата сводки: 29.09.2026. Исходный чат: «Параметризовать шнековый транспортер».

## 1. Назначение и статус

Пользователь запросил параметрическую модель шнекового транспортёра на основе переданной сборки SolidWorks, минимальный опросный лист, Python-программу ввода, связь анкеты с CAD, расчёт в SolidWorks Simulation, подбор привода и подшипников по нагрузкам, перестроение сопряжённых деталей и перечень покупных изделий для спецификации. Просил задавать проверочные вопросы по частям и показывать их при запущенной программе.

**Текущее состояние:** реализованы анкета, выбор покупных изделий, подсчёт числа опор корпуса по длине, передача шага шнека D=200 мм в CAD и предварительный статический расчёт одного вала. Полная параметризация сборки, расчёт всего транспортёра, подбор привода и подшипников, перестроение вала/обойм и автоматический пересчёт всего покупного крепежа не завершены.

Переданный пользователем файл «Вставленный текст.txt» содержит техническое задание и предлагаемые инженерные инструкции. Он использовался как источник требований, **не как подтверждение фактических размеров**. Фактические данные ниже отделены от пожеланий пользователя, справочных данных и программных допущений.

## 2. Источники и рабочие файлы

| Объект | Путь / источник | Содержание |
|---|---|---|
| Исходная CAD-модель | `C:\Users\adm\Desktop\25.SHT.G.00.00.00.00\` | Переданные файлы SolidWorks, чертежи, CSV-спецификация |
| Вставленное ТЗ | `C:\Users\adm\.codex\attachments\0a1200b3-2f07-4240-9d88-77489ac8a8f7\Вставленный текст.txt` | Пожелания к параметрической системе |
| Копия CAD | `C:\Users\adm\Documents\Codex\2026-09-28\new-chat\outputs\25.SHT.G_parameterized\` | Копия для параметризации, паспорт модели и `set_pitch.py` |
| Python-программа | `C:\Users\adm\Documents\Codex\2026-09-28\new-chat\outputs\transport_questionnaire\` | Tkinter-интерфейс, проверка, связь с CAD, Simulation, каталоги |
| Архив программы | `C:\Users\adm\Documents\Codex\2026-09-28\new-chat\outputs\transport_questionnaire.zip` | Упакованная версия программы |
| Архив копии CAD | `C:\Users\adm\Documents\Codex\2026-09-28\new-chat\outputs\25.SHT.G_parameterized.zip` | Упакованная копия модели |
| Исходный черновик | `outputs\transport_questionnaire\исходный_транспортер_черновик.json` | Подтверждённые значения и незаполненные поля |
| Опросный лист | `outputs\Опросный_лист_шнекового_транспортера.md` | Подробная версия вопросов |

## 3. Последние действующие решения пользователя

| Тема | Решение | Основание / статус |
|---|---|---|
| Длина | **2885 мм** — длина рабочей части желоба исходного транспортёра | Прямое исправление пользователя; прежние 3004 мм отменены |
| Диаметр/шаг исходного шнека | D=200 мм, S=200 мм | Исходная CAD-модель и чертёж |
| Диапазон рабочей длины новых исполнений | 500–25 000 мм | Ответы пользователя |
| Диаметр новых исполнений | 50–600 мм, размеры в миллиметрах | Ответы пользователя |
| Нестандартные диаметры | Оформлять как нестандартные исполнения | Ответ пользователя |
| Стандартные пары D/S | По ГОСТ для шнеков; стандартная пара выбирается из таблицы, для нестандартного диаметра шаг вводится вручную | Требование пользователя; реализовано в проверке анкеты |
| Наклон | Наклонные исполнения допустимы | Ответ пользователя; диапазон 0–20° установлен текущей программой, но конкретный угол исходной сборки не подтверждён |
| Загрузки | Сначала количество, максимум 7; параметры каждой задаются отдельно | Ответы пользователя |
| Выгрузки | Может быть несколько, максимум 2; форма круглая или прямоугольная; направление вниз или вбок, для бокового — влево/вправо | Ответы пользователя и текущая анкета |
| Материал | Разный для разных исполнений; выбор материала вынесен в анкету; в одной конфигурации один материал | Ответы пользователя |
| Покупные изделия | Позиции 63–85 исходной спецификации — **редактируемый начальный перечень**, а не обязательный неизменный состав | Ответ пользователя |
| Количество покупных изделий | Должно пересчитываться автоматически при изменении длины и числа опор | Требование пользователя; **реализовано частично**, см. раздел 7 |
| Опоры вала | Промежуточные опоры вала применяются только для трубных транспортёров | Ответ пользователя; текущая модель желобная |
| Опоры корпуса | Обе исходные позиции опор относятся к корпусу и должны учитываться; количества обоих исполнений равны | Ответы пользователя |
| Правило опор корпуса | **Не более 3000 мм между соседними опорами**. Число опор каждого исполнения: `ceil(L / 3000) + 1` | Последнее решение пользователя, заменившее подбор по прогибу |

### Следствия правила 3000 мм

| Рабочая длина L | Интервалов | Опор `01.01` | Опор `08.00` |
|---:|---:|---:|---:|
| 2885 мм | 1 | 2 | 2 |
| 3000 мм | 1 | 2 | 2 |
| 3001 мм | 2 | 3 | 3 |
| 6000 мм | 2 | 3 | 3 |
| 25 000 мм | 9 | 10 | 10 |

Формула рассчитывает **количество** по длине рабочей части желоба. Фактические координаты опор в сборке и их соединения с корпусом ещё не параметризованы.

## 4. Решения, которые были заменены или отложены

- Значение длины **3004 мм** отменено и заменено **2885 мм**.
- Во время проверки обсуждался подбор числа опор по прогибу при полном весе конструкции и материала, с пределом 0,25 толщины самого тонкого металлического элемента. Пользователь остановил эту ветку словами «мы ушли не туда» и установил правило шага **каждые 3 м**. Подбор по прогибу **не является действующим правилом количества опор**.
- Для пробной проверки тяжёлого материала обсуждалась мелкая свинцовая руда. Эти данные сохранены в черновике, но дальнейшие вопросы о материале пользователь прервал, вернув разговор к шагу опор. Их нельзя считать согласованным расчётным заданием для всего транспортёра.
- По просьбе пользователя создавался новый чат с суффиксом «2», затем пользователь попросил отменить действие. Работа продолжена в исходном чате. Это не изменило CAD или программу.

## 5. Опросный лист и Python-программа

Программа `app.py` использует Tkinter и содержит вкладки: основные параметры/шнек, загрузки, выгрузки, материал, монтаж/режим, прочность и покупные изделия. Есть сохранение черновика JSON, проверка и сохранение проверенных данных, открытие JSON, связь с CAD и запуск предварительного исследования Simulation. Программа запускается через `Запустить.bat` или `python app.py`; для открытия подготовленного файла поддерживается `python app.py --open <файл.json>`.

Проверка включает диапазоны размеров, число отверстий, положение отверстий внутри рабочей длины, пары диаметра/шага, согласованность расходов при одновременной работе точек и отдельные предупреждения о неполных инженерных данных. Общий объём разовой загрузки задаётся один раз для транспортёра; расход через каждую точку вводится отдельно, когда требуется проверить одновременную работу.

В исходном черновике заполнены L=2885 мм, D=200 мм, S=200 мм, справочная карточка тестового материала и каталог покупных изделий. **Угол, производительность, объём партии, положения и размеры горловин, режим работы и расчётные нагрузки остаются незаполненными.** Черновик не является полностью проверенным проектом.

## 6. Исходная модель и связь с SolidWorks

По выполненному аудиту переданного комплекта: 13 сборок, 73 детали; в верхней сборке 393 компонента первого уровня, 16 подавленных. Четыре внешние ссылки указывают на прежние места хранения; они относятся к подавленным компонентам. На сборочном чертеже указан справочный габарит 3861 × 500 × 1029 мм и масса 455,17 кг; это не подменяет подтверждённую рабочую длину желоба 2885 мм.

В детали `25.SHT.G.02.00.00.01  Шнек 200 мм.SLDPRT` создано пять управляющих переменных:

| Переменная | Номинал CAD | Смысл |
|---|---:|---|
| `SCREW_PITCH` | 200 мм | Шаг |
| `SCREW_FLIGHT_LENGTH` | 2885 мм | Длина винтовой линии CAD |
| `SCREW_OD` | 200 мм | Наружный диаметр |
| `SCREW_CORE_OD` | 76 мм | Внутренний диаметр профиля |
| `FLIGHT_THK` | 12 мм | Толщина витка |

Изменение шага проверено на 180, 200 и 220 мм в отдельной копии детали. `cad_bridge.py` передаёт из анкеты в CAD **только шаг** шнека D=200 мм, выполняет перестроение и пишет отчёт. Длина желоба, диаметр всего транспортёра, наклон, патрубки, опоры, привод, BOM и чертежи геометрически ещё не связаны. Упоминание длины 2885 мм как параметра винтовой линии CAD и как подтверждённой рабочей длины желоба не доказывает, что соответствующие торцы автоматически совпадают при изменении длины.

## 7. Покупные изделия и спецификация

В переданном CSV-списке обнаружены покупные позиции **41–44 и 63–85**, всего 27. Позиции 41–44 относятся к узлу крышки; первоначально были просмотрены только 63–85, затем перечень расширен. Текущая программа позволяет включать/исключать строки, менять обозначение, группу, количество и примечание, добавлять свои строки, сохранять выбор в JSON и выгружать выбранные позиции в CSV (UTF-8 BOM, разделитель `;`). Повторяющиеся строки исходной спецификации не объединяются автоматически.

| Поз. | Группа | Обозначение исходной спецификации | Количество исходное |
|---:|---|---|---:|
| 41 | Ручки | Ручка скоба с втулками пластиковая-12 | 4 |
| 42 | Крепёж и стандартные изделия | DIN 7984 - M6 x 20 --- 17C | 8 |
| 43 | Крепёж и стандартные изделия | Шайба М6 DIN 125 А2 | 44 |
| 44 | Крепёж и стандартные изделия | Гайка М6 DIN 934 | 44 |
| 63 | Крепёж и стандартные изделия | Стопорное кольцо D65 ГОСТ 13942-86 | 2 |
| 64 | Подшипники | Подшипник NSK 7213BEA | 4 |
| 65 | Крепёж и стандартные изделия | Стопорное кольцо D100 ГОСТ 13943-86 | 2 |
| 66 | Крепёж и стандартные изделия | Стопорное кольцо D120 ГОСТ 13943-86 | 2 |
| 67 | Привод | Мотор-редуктор UD-FA87-88.01 (PAM60) М1 3Кв | 1 |
| 68 | Уплотнения | Манжета 2 -75х100-5 ГОСТ 8752-79 | 2 |
| 69 | Крепёж и стандартные изделия | Шпонка 18х11х110 ГОСТ 23360-78 | 1 |
| 70 | Крепёж и стандартные изделия | Шпонка 16х10х40 ГОСТ 23360-78 | 1 |
| 71 | Крепёж и стандартные изделия | Шпонка 14х9х40 ГОСТ 23360-78 | 1 |
| 72 | Крепёж и стандартные изделия | Шайба М16 DIN 125 ОЦ | 33 |
| 73 | Крепёж и стандартные изделия | M16x50 | 20 |
| 74 | Крепёж и стандартные изделия | Шайба М16 DIN 127 А2 | 34 |
| 75 | Крепёж и стандартные изделия | M16x45 | 7 |
| 76 | Крепёж и стандартные изделия | DIN 7984 - M16 x 40 --- 34C | 6 |
| 77 | Крепёж и стандартные изделия | Болт М8 DIN 931 A2 | 16 |
| 78 | Крепёж и стандартные изделия | Шайба М8 DIN125 А2 | 32 |
| 79 | Крепёж и стандартные изделия | DIN 7991 - M6 x 20 --- 13.7C | 36 |
| 80 | Муфты | Муфта BM 42-55 B-B Red (Сталь 45) | 1 |
| 81 | Крепёж и стандартные изделия | Болт М16x35 DIN 933 ОЦ | 1 |
| 82 | Крепёж и стандартные изделия | Болт М8 DIN 931 A2 | 16 |
| 83 | Крепёж и стандартные изделия | Шайба М8 DIN 127 А2 | 16 |
| 84 | Крепёж и стандартные изделия | Hexagon Flange Nut DIN 6923 - M8 - C | 32 |
| 85 | Крепёж и стандартные изделия | Hexagon Flange Nut DIN 6923 - M16 - C | 27 |

Исходная сборка содержит 4 подшипника NSK 7213BEA, один мотор-редуктор UD-FA87-88.01 (PAM60) 3 кВт и муфту BM 42-55 B-B Red. По предварительному осмотру посадка вала под подшипник Ø65 мм, посадка обоймы Ø120 мм. Программа предупреждает, если выбранный подшипник/количество расходятся с исходной CAD-сборкой.

**Граница автоматизации спецификации:** число опор корпуса теперь пересчитывается по L/3000. Покупные крепёж, манжеты, кольца и другие строки пока сохраняют отредактированные количества; их привязка к числу опор и длине по структуре сборки ещё не выполнена. Поэтому автоматически пересчитанная полная спецификация **пока не готова**.

## 8. Материал как отложенный расчётный пример

Пользователь предложил для проверки «максимально тяжёлый» материал и согласился на **мелкую свинцовую руду**. Таблица [KWS Screw Conveyor Bulk Material Table](https://www.kwsmfg.com/engineering-guides/screw-conveyor/bulk-material-table/) даёт для Lead Ore с частицей менее 1/8 дюйма диапазон насыпной плотности **200–270 lb/ft³**. В карточку `KWS_LEAD_ORE_FINE` записана верхняя граница приблизительно **4325 кг/м³**, расчётная крупность **3,2 мм**. Это **справочная насыпная плотность руды**, не измеренная плотность фактической партии.

Позднее пользователь указал влажность **80 % по массе влажной смеси**. Для такой смеси справочная плотность руды не подтверждена. Программа ставит статус `requires_wet_material_confirmation` и не выводит массу партии/массовый расход по этому значению в предварительном отчёте. Состояние смеси, её фактическая плотность, абразивность, сыпучесть и температура не установлены. После решения о шаге опор 3 м эти данные **не используются для подсчёта опор** и дальнейшие вопросы о них не требуются для текущего правила.

Программа предупреждает, что введённая плотность 4325 кг/м³ выходит за область применения заложенной проверки по [ГОСТ 2037-82](https://files.stroyinf.ru/Data2/1/4294751/4294751811.pdf); проектирование с таким материалом потребует отдельной проверки условий применимости и нагрузок.

## 9. Расчёт прочности и привод

SolidWorks Simulation на компьютере был обнаружен и загружен. `strength.py` создаёт **предварительное линейное статическое исследование одной детали вала** `25.SHT.G.02.00.00.03  Вал.SLDPRT`: торец z=0 мм жёстко закреплён, на торце z=−363 мм заданы введённые пользователем осевая сила и крутящий момент. Материал берётся из библиотеки SolidWorks; результатом служат максимальные напряжение Мизеса, перемещение и коэффициент по пределу текучести. Данные записываются в отчёт и свойства `FEA_*` детали в расчётной копии.

Пробный расчёт на отдельной копии с **искусственными** нагрузками 100 Н·м и 1000 Н дал: при элементе сетки 11,34 мм — 8,572 МПа и 0,00643 мм; при 5,7 мм — 9,0845 МПа и 0,00612 мм. Это проверка работоспособности блока, **не результат для подтверждённого режима транспортёра**. Контакты сборки, сварка, желоб, опоры, реальные реакции подшипников, динамика, усталость и достаточная сходимость сетки этим исследованием не подтверждены.

`load_cases.py` создаёт документированный паспорт нормальной работы, пуска, закупорки и реверса при наличии соответствующих входных данных. Момент двигателя вычисляется из мощности и выходной частоты: `T = 60000·P/(2πn)` Н·м (P в кВт, n в об/мин). Осевые/радиальные силы, защита, опирание и источники нагрузок вводятся отдельно. Этот блок не запускает FEA и не перестраивает вал.

Желаемый пользователем автоматический подбор усилий/момента двигателя и подшипника по прочности, а также перестроение вала и «стакана» (в исходной модели обнаружены детали с названием «обойма») **не реализованы**. Для достоверного подбора нужны выходная частота и характеристика редуктора, действительные нагрузки/реакции опор, схема установки пары угловых подшипников и преднатяг, ресурс, статическая проверка, посадки и совместимость стопорных колец/манжет/муфты. Исходный `NSK 7213BEA` имеет по [каталогу NSK](https://www.nsk.com/content/dam/nsk/am/en_us/documents/bearings-americas/HCapacity_%20ACBB.pdf) d=65 мм, D=120 мм, B=23 мм, C=70 кН, C₀=53,5 кН; это исходная позиция, а не подтверждённый подбор.

## 10. Что ещё не подтверждено и не связано

- Исходные технологические данные: фактический угол, производительность, объём загрузки, координаты/размеры горловин и патрубков, режимы пуска, реверса и закупорки.
- Свойства рабочего материала каждого исполнения и действительные расчётные нагрузки. Тестовая карточка руды с 80 % воды не даёт плотности смеси.
- Геометрическое перестроение полной сборки по длине, диаметру и наклону, размещение опор и проверка зазоров.
- Полный прочностной расчёт сборки, ресурс/статика подшипников, привод, вал, обоймы и сопряжённые стандартные изделия.
- Правила количества покупного крепежа и других компонентов при изменении длины/числа опор, автоматическое обновление полной BOM и чертежей.

## 11. Порядок продолжения работы

Сохранять последнее решение пользователя о **шаге опор корпуса не более 3 м**. Не возвращаться к отменённому подбору числа опор по прогибу и не продолжать вопросы о тестовой руде без отдельного запроса. При дальнейшей автоматизации отделять подтверждённые входные данные, справочные значения, инженерные расчёты и фактически связанные параметры CAD. Перед заявлением о готовности параметрической системы проверять сборку, спецификацию и чертежи для каждого типоразмера.
