hisp2k/parameters/engineering/screw-preflight/outputs/01_CALCULATION_PASSPORT_v0.1.md

# Паспорт расчёта горизонтального трубного шнекового транспортёра v0.1

**Идентификатор:** CP-SCREW-TUBE-H-001  
**Статус:** DRAFT — постановка задачи; инженерные формулы и коэффициенты не утверждены.  
**Назначение:** подготовить проверяемую расчётную модель первого семейства для дальнейшей реализации независимого расчётного ядра.

## 1. Область задачи

Профиль `SCREW_TUBE_H_BULK_V1`: горизонтальный трубный шнековый транспортёр с одним приводом, одним валом, постоянным шагом, контролируемой подачей на входе и одним базовым типом корпуса. Среда — конкретный сыпучий материал, для которого утверждены паспорт свойств и применимость расчётной методики. Шнековый питатель под затопленным входом, наклонное/вертикальное исполнение, безвальный шнек, свободная жидкость и осадок с неподтверждённой реологией требуют отдельных профилей.

Первый выпуск должен **генерировать несколько допустимых кандидатов**, показывать результаты проверок и причины отклонения. Критерий единственного «оптимального» варианта пока не задан.

## 2. Входные сущности

| Сущность | Обязательные данные | Примечание |
|---|---|---|
| TARGET | требуемая массовая или объёмная производительность с единицей; режим работы; ресурс; требуемые точки загрузки и выгрузки | При массовой подаче преобразование в объёмную выполняется по диапазону насыпной плотности |
| AS-IS | расстояние между входом и выходом; существующие патрубки и отметки; присоединительные размеры; доступное место | Каждое фактическое значение хранит источник, дату, погрешность и статус подтверждения |
| CONSTRAINTS | предельные габариты, питание, температура, запреты по материалам, ограничения эксплуатации | Твёрдые ограничения нельзя обходить предупреждением |
| MATERIAL PROFILE | идентификатор материала и состояния; диапазон насыпной плотности; размер и доля крупных включений; сыпучесть; абразивность; коррозионность; влажность; температура; склонность к налипанию/слеживанию | Значения и коэффициенты имеют источник, диапазон, достоверность и версию |
| DUTY | часов в сутки, пусков в час, пуск с заполненным корпусом, возможная перегрузка, режим заклинивания | Отсутствующий режим не означает, что его можно исключить из проверок |
| NORMATIVE PROFILE | допускаемые напряжения, коэффициенты запаса, принятые методы расчёта и стандартные ряды | Версионируется отдельно от расчётной модели |
| REFERENCE COMPONENTS | приводы, опоры, муфты, уплотнения с паспортными пределами | Каталожный компонент выбирается только после расчёта требуемых параметров |
| PRODUCTION PROFILE | доступные трубы, листы, валы, процессы и допуски | Производственная замена фиксируется как отдельное решение |
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
