hisp2k/parameters/belt-conveyors/flat-LT500/deliverables/Ленточный_транспортер/03_Модели_SolidWorks/ЛТ500_Желобчатый_узел_вид_R10.png

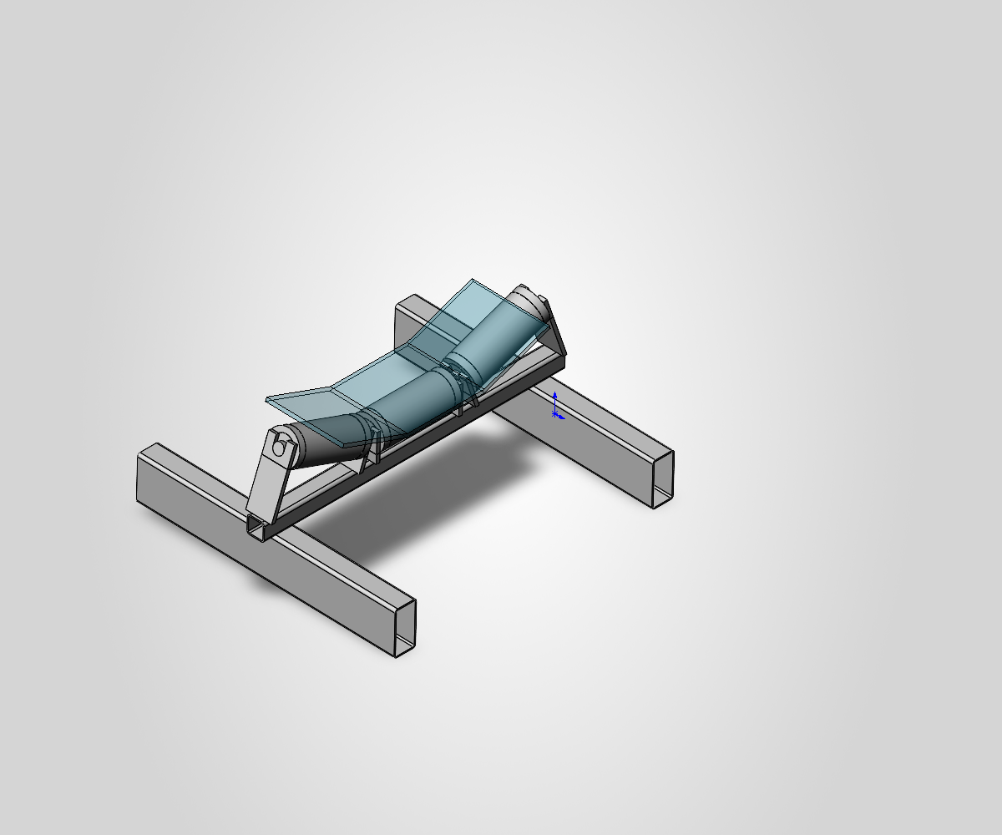
belt-conveyors/flat-LT500/deliverables/Ленточный_транспортер/03_Модели_SolidWorks/ЛТ500_Желобчатый_узел_вид_R10.png
