hisp2k/parameters/belt-conveyors/flat-LT500/deliverables/Ленточный_транспортер/03_Модели_SolidWorks/ЛТ500_Крепление_и_стык_вид_R07.png

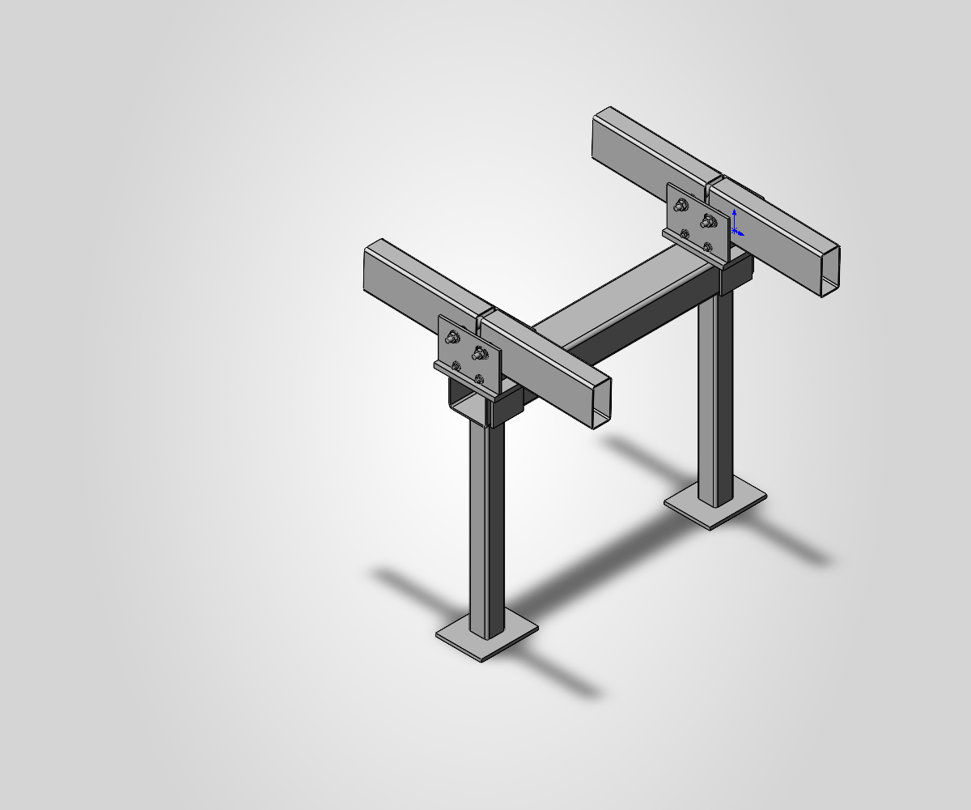
belt-conveyors/flat-LT500/deliverables/Ленточный_транспортер/03_Модели_SolidWorks/ЛТ500_Крепление_и_стык_вид_R07.png
