hisp2k/parameters/belt-conveyors/flat-LT500/deliverables/Ленточный_транспортер/03_Модели_SolidWorks/ЛТ500_Плоский_ролик_вид_R11.png

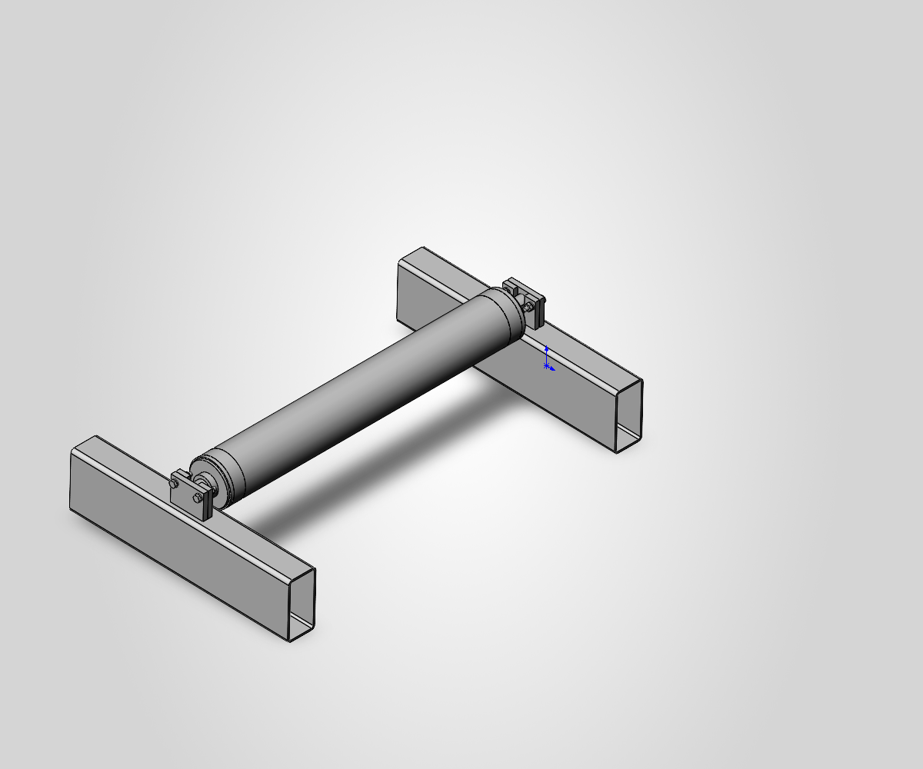
belt-conveyors/flat-LT500/deliverables/Ленточный_транспортер/03_Модели_SolidWorks/ЛТ500_Плоский_ролик_вид_R11.png
