hisp2k/parameters/belt-conveyors/flat-LT500/deliverables/Ленточный_транспортер/03_Модели_SolidWorks/ЛТ500_Поперечная_опора_вид_R04.png

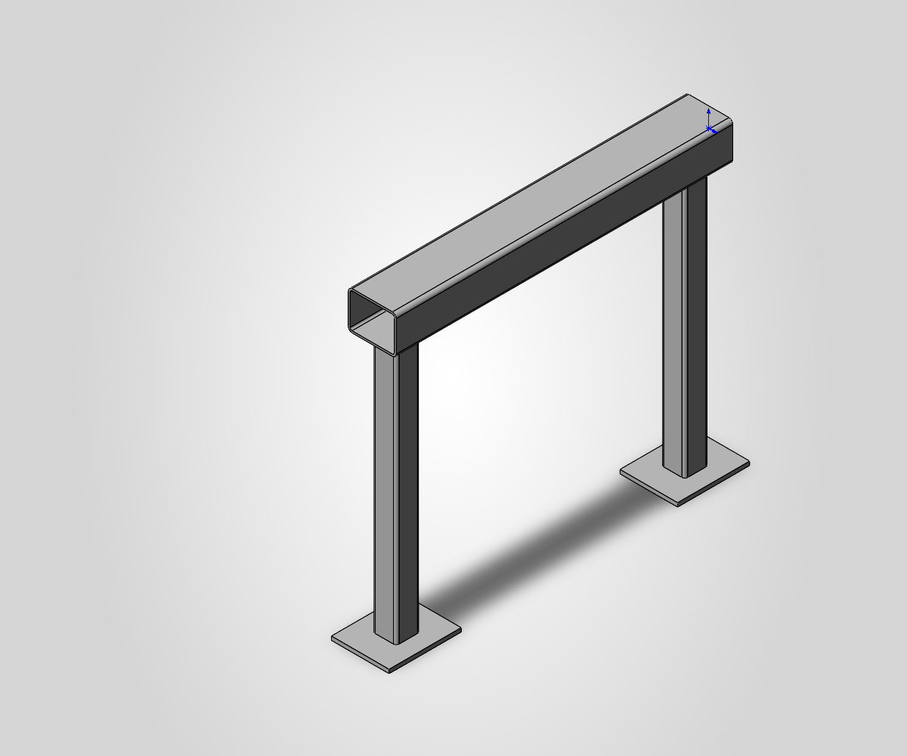
belt-conveyors/flat-LT500/deliverables/Ленточный_транспортер/03_Модели_SolidWorks/ЛТ500_Поперечная_опора_вид_R04.png
