hisp2k/parameters/belt-conveyors/flat-LT500/deliverables/Ленточный_транспортер/03_Модели_SolidWorks/ЛТ500_Ролики_загрузки_вид_R09.png

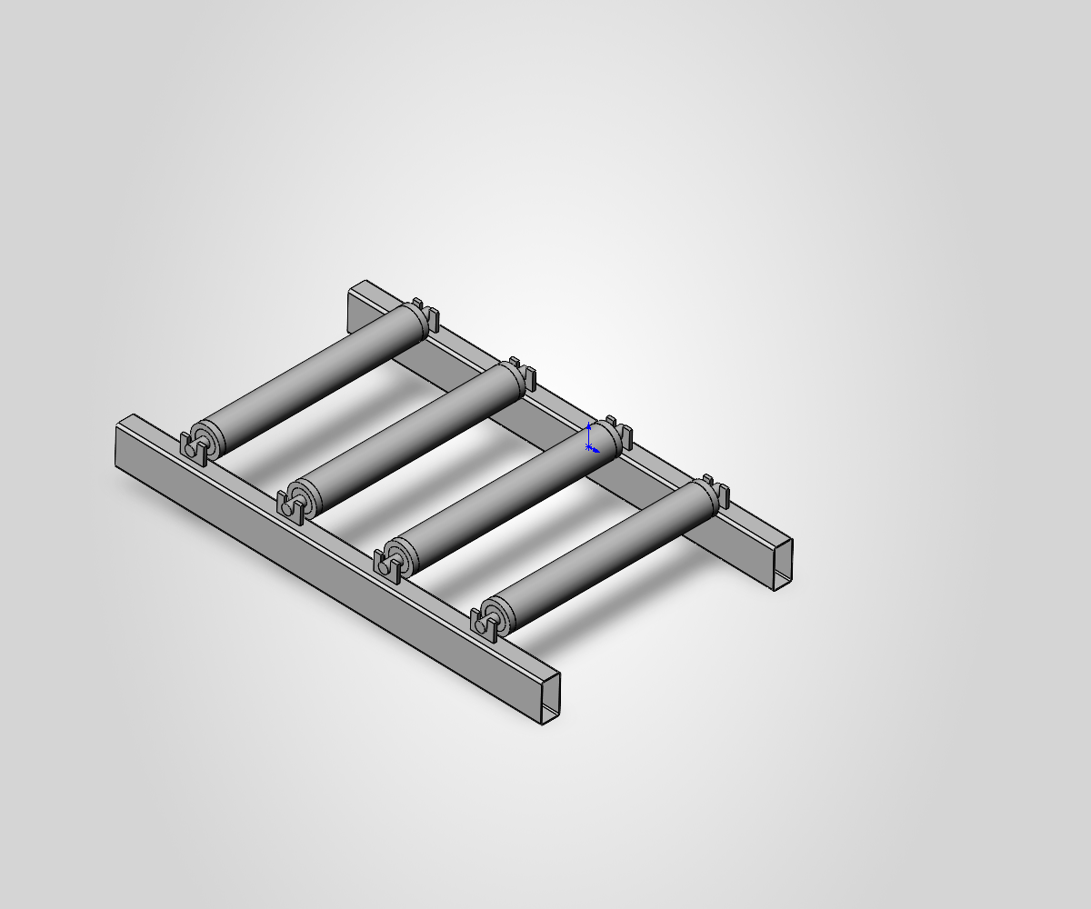
belt-conveyors/flat-LT500/deliverables/Ленточный_транспортер/03_Модели_SolidWorks/ЛТ500_Ролики_загрузки_вид_R09.png
