hisp2k/parameters/containers/deliverables/0_22/model_preview.png

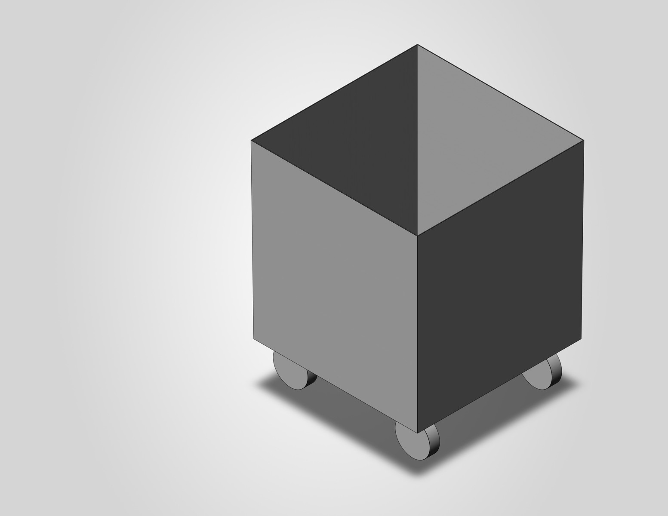
containers/deliverables/0_22/model_preview.png
