hisp2k/parameters/engineering/transporter-calculators/chain_28m_20tph/spec_image1.png

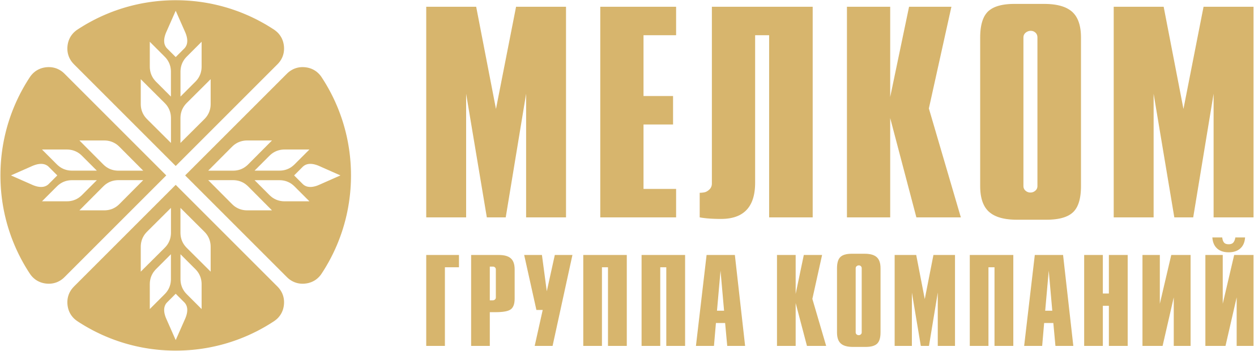
engineering/transporter-calculators/chain_28m_20tph/spec_image1.png
