hisp2k/parameters/grit-chambers/PT-SHT-10/deliverables/PT-SHT-10_210л_частицы_Q10.png

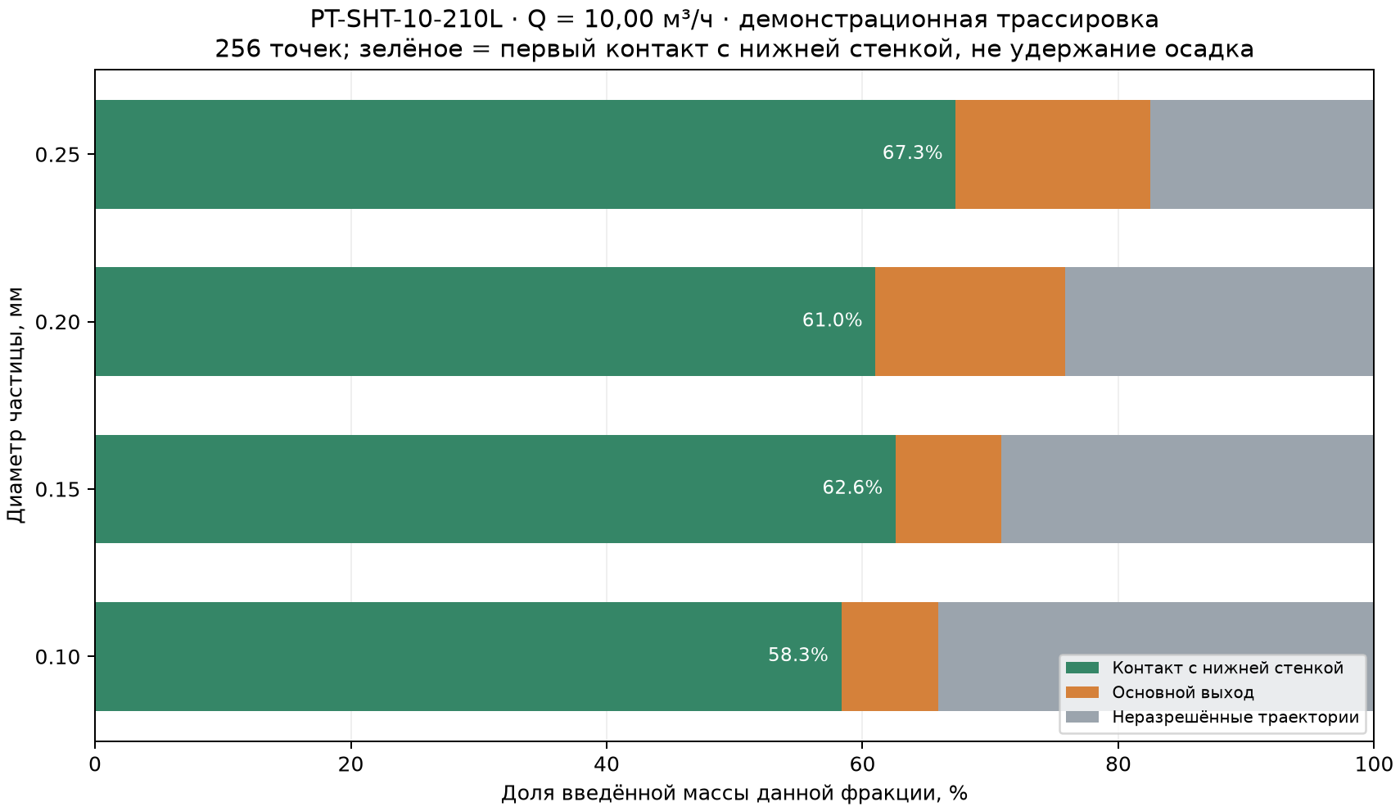
grit-chambers/PT-SHT-10/deliverables/PT-SHT-10_210л_частицы_Q10.png
