hisp2k/parameters/grit-chambers/PT-SHT-10/deliverables/PT-SHT-10_полость_210л.png

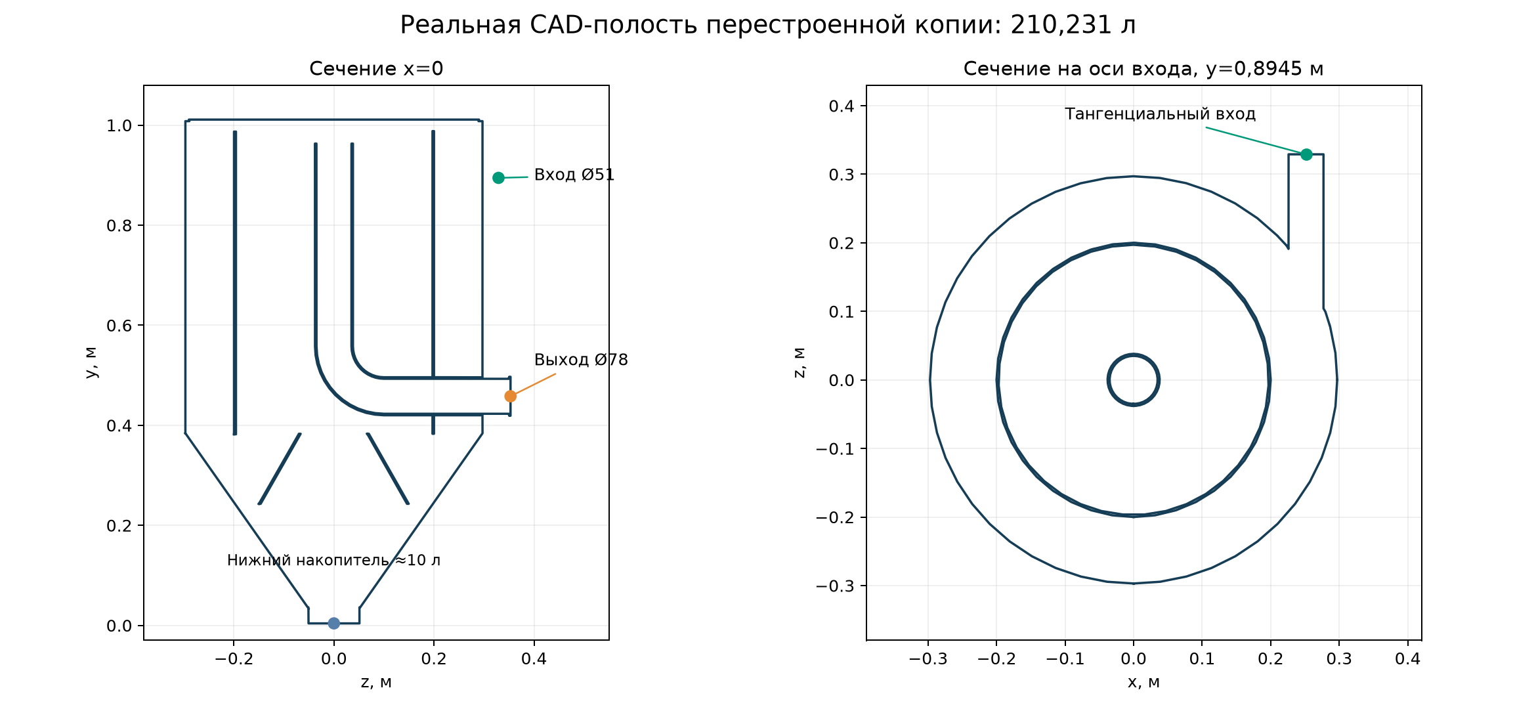
grit-chambers/PT-SHT-10/deliverables/PT-SHT-10_полость_210л.png
