hisp2k/parameters/screw-conveyors/01-PT-SHT/deliverables/Шнек 1 — аудит производственного комплекта/10_Шайба М8 — вид CAD.png

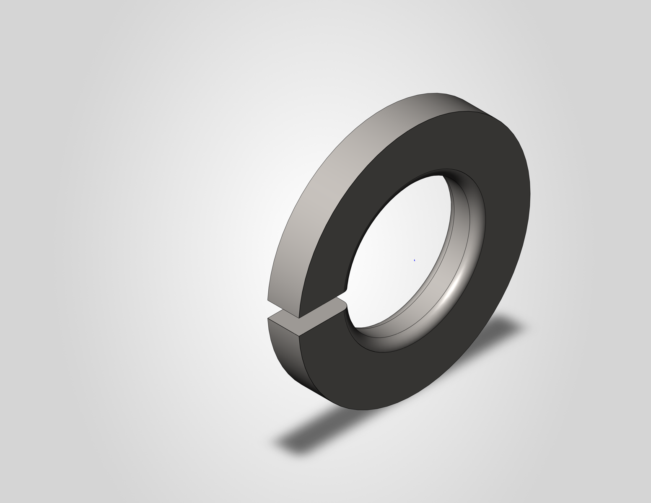
screw-conveyors/01-PT-SHT/deliverables/Шнек 1 — аудит производственного комплекта/10_Шайба М8 — вид CAD.png
