hisp2k/parameters/screw-conveyors/01-PT-SHT/deliverables/Шнек 1 — параметрическая модель/angle-preview.png

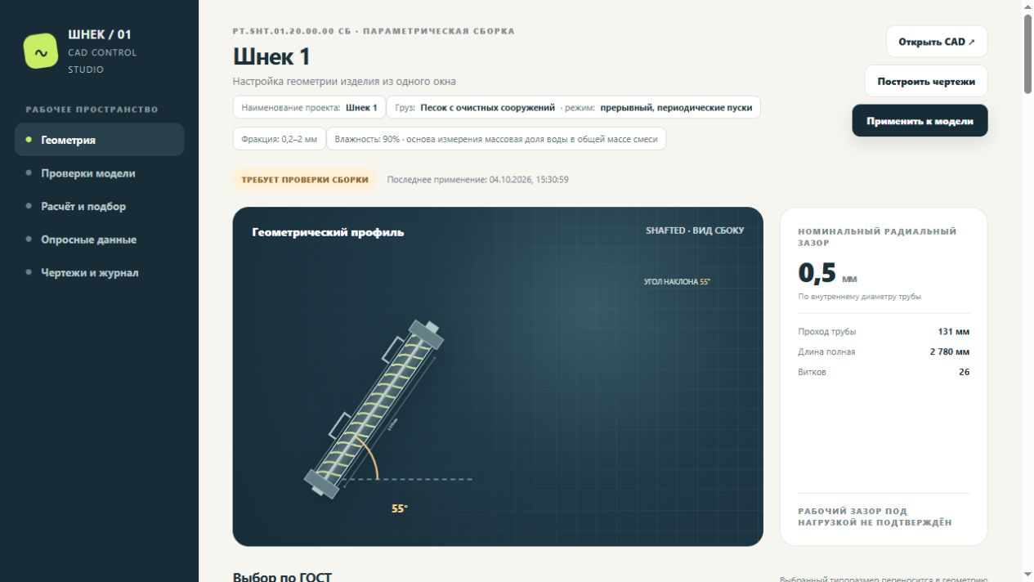
screw-conveyors/01-PT-SHT/deliverables/Шнек 1 — параметрическая модель/angle-preview.png
