hisp2k/parameters/screw-conveyors/01-PT-SHT/deliverables/Шнек 1 — параметрическая модель/Втулка и подкос — проверка 05.10.2026.png

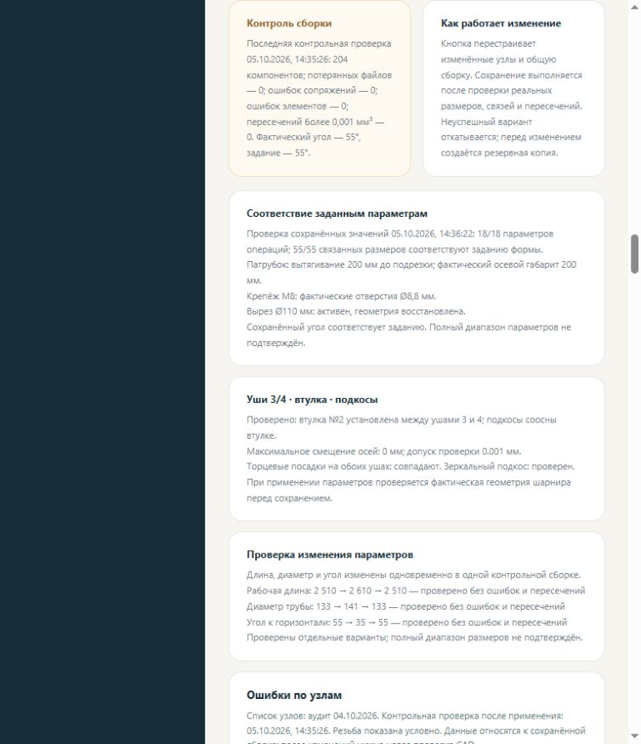
screw-conveyors/01-PT-SHT/deliverables/Шнек 1 — параметрическая модель/Втулка и подкос — проверка 05.10.2026.png
