hisp2k/parameters/screw-conveyors/01-PT-SHT/deliverables/Шнек 1 — параметрическая модель/Параметрические уши — проверка.png

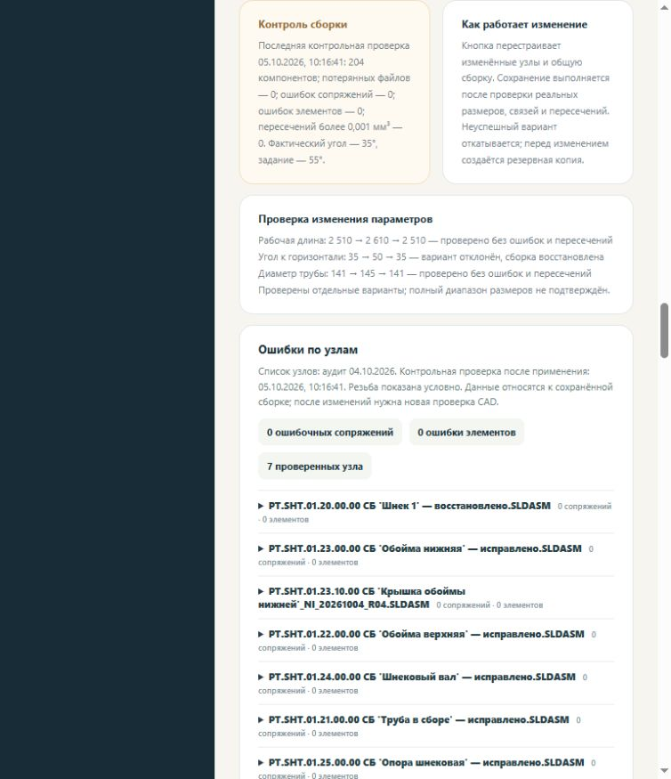
screw-conveyors/01-PT-SHT/deliverables/Шнек 1 — параметрическая модель/Параметрические уши — проверка.png
