hisp2k/parameters/screw-conveyors/01-PT-SHT/deliverables/Шнек 1 — параметрическая модель/Проверка CAD — интерфейс.png

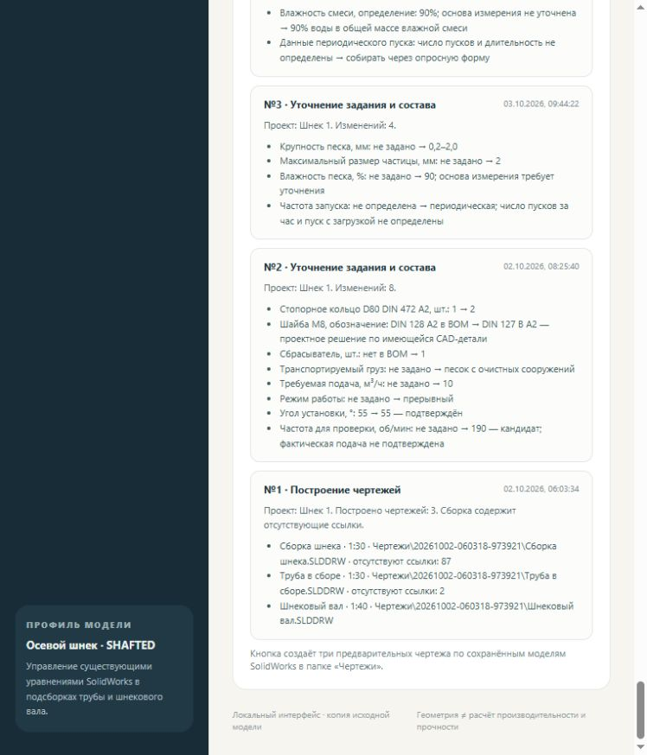
screw-conveyors/01-PT-SHT/deliverables/Шнек 1 — параметрическая модель/Проверка CAD — интерфейс.png
