hisp2k/parameters/screw-conveyors/01-PT-SHT/deliverables/Шнек 1 — параметрическая модель/Соответствие параметрам — интерфейс.png

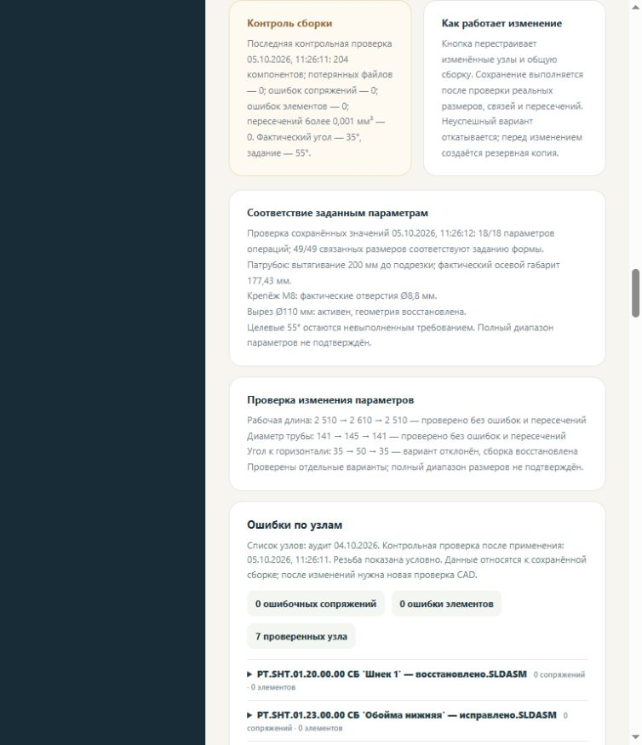
screw-conveyors/01-PT-SHT/deliverables/Шнек 1 — параметрическая модель/Соответствие параметрам — интерфейс.png
