hisp2k/parameters/screw-conveyors/01-PT-SHT/deliverables/Шнек 1 — параметрическая модель/Стыки труб — опора 05.10.2026 — просмотр.png

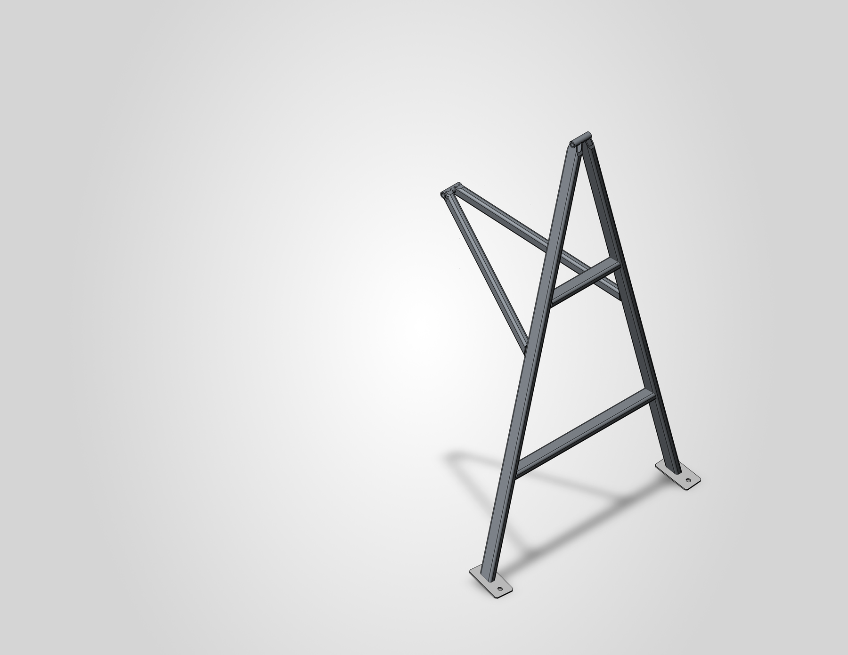
screw-conveyors/01-PT-SHT/deliverables/Шнек 1 — параметрическая модель/Стыки труб — опора 05.10.2026 — просмотр.png
