hisp2k/parameters/screens/58-GR/СВЕРКА_BOM6_2026-10-02.md

# 58.GR — первичная сверка BOM(6) с регламентом v2

Дата проверки: 02.10.2026. Статус: промежуточный аналитический результат, не выпуск КД и не разрешение к производству.

## Проверенные источники

- [BOM(6)](Исходники/58.GR%20BOM%286%29.xlsx), Git blob `e0f2b195c09c0557554601aba563af3b52287308`, SHA-256 скачанной копии `FD38E2BBC840E8360C724B6AF6394699F0A30EE3B65C77D41CFC0B89F2D91A6F`.
- [Регламент v2](Документы/Регламент_чертежи_производство_v2.md), Git blob `82ca893808bd969015e7f69b943fe9827171f818`, редакция 02.10.2026.
- [Реестр исходников и исторических решений](ИСХОДНИКИ_И_СТАТУС.md).

STEP КТ, STEP ТТ и RAR отсутствуют в репозитории; геометрия и структура сборки не проверены. Ссылки Library из реестра не дали доступной локальной копии в этой среде.

## Фактическая арифметика BOM

Лист «Лист1»: 179 строк × 7 столбцов, из них 1 строка заголовка и 178 строк позиций. В свойствах файла: создание 17.09.2026, изменение 21.09.2026; явная редакция изделия в таблице не указана. Формул нет.

| Показатель | Результат | Ограничение |
|---|---:|---|
| Строки позиций | 178 | Строки, не уникальные детали |
| Позиции с пометой «СБ» | 31 | 40 шт. по колонке К-ВО; дерево сборки не подтверждено |
| Прочие строки | 147 | 651 шт. по колонке К-ВО; включают детали и покупные изделия |
| Сумма К-ВО всех строк | 691 | Нельзя считать количеством деталей изделия: сборки и компоненты вложены |
| Позиции от 1 до 189 | 178 заняты | 124–134 отсутствуют; причина неизвестна |
| Дубли полного обозначения | 2 пары | Поз. 1/2: `00.GR.01.00.00.09`; поз. 109/110: `58.GR.01.00.00.06`. Одинаковость геометрии не проверена |
| Строки без материала | 35 | 29 сборок и 6 прочих строк |
| Пустая «Заготовка» | 178 | Нет сортамента, толщин и размеров заготовок |
| Пустое «Производство ДСЕ» | 178 | Маршрут изготовления из BOM не определён |
| Нулевая масса | 7 строк | Поз. 163, 169, 176, 177, 180, 181, 182; нуль нельзя считать подтверждённой массой |
| Сумма «Масса × К-ВО» всех строк | 1214,31 | Только арифметика поля без указанной единицы, содержит двойной учёт сборок |
| Та же сумма по строкам «СБ» | 725,37 | Включена в предыдущую сумму |
| Та же сумма без строк «СБ» | 488,94 | Не подтверждена как масса изделия: состав и смысл количеств не сверены со STEP |

По материалам среди 147 строк без пометы «СБ»: AISI 316 — 110 строк, 545 шт., арифметическая масса 372,361; PE1000 — 11 строк, 21 шт., 6,21; Сталь 3 — 4 строки, 10 шт., 41,96; остальные материалы и покупные позиции требуют отдельной классификации. Все массы здесь в неуказанных единицах колонки BOM, это не ведомость закупки.

## Сверка конкретных решений

- Поз. 105 «Ламель» `58.GR.00.00.00.02`: BOM указывает 33 шт., AISI 316, масса 2 на штуку. Арифметически 33 × 2 = 66 в единицах колонки «Масса». Толщина, габариты и геометрия не проверены. Количество и материал совпадают с исторической записью регламента; это не подтверждает соответствие STEP.
- Поз. 170: мотор-редуктор `PCRV090.130-121-7.4-1,1кВт-6P-380-50`, 1 шт. В историческом решении указан привод 1,5 кВт. Требуется определить действующую спецификацию привода и ревизию, а затем момент и зависящие расчёты. Нельзя подменять 1,1 на 1,5 без решения.
- Поз. 29 «Стакан» обозначена как сборка без материала. Поз. 21, 30–33, относящиеся по обозначениям к этой группе, в BOM указаны из AISI 316. Историческое указание «стакан — Ст3» не подтверждается данной BOM; требуется проверить состав и назначение материала по модели и КД.
- Поз. 115/121 и 116/122, 117/123 показывают варианты боковых профилей с суффиксом `-01`. Их геометрическая идентичность и взаимозаменяемость не определены.
- Четыре строки покупных цепных звеньев имеют AISI 304; это не основание менять материал ламели AISI 316.

## Что требуется для расчёта и выпуска

1. Доступные STEP КТ и ТТ (либо нативная CAD-сборка) с единицами, конфигурациями и ревизиями — для дерева вхождений, проверки BOM, размеров, развёрток и DXF.
2. Определение действующей ревизии BOM и того, что означает К-ВО: на изделие, на подсборку или на заказ. Список позиций 124–134 и причина пропуска.
3. Решение по мощности и конкретному мотор-редуктору: BOM 1,1 кВт против исторических 1,5 кВт; нагрузки, режим, передаточное число/КПД для расчёта момента.
4. Материалы, толщины, сортамент и заготовки; в BOM колонка «Заготовка» пустая полностью. Уточнить материал и состав «стакана».
5. Производственный профиль: станки, инструмент, гибочный инструмент, параметры лазера, оснастка и подтверждённые нормы времени. Нельзя вычислить время всего изделия из исторических норм без маршрутов и геометрии.
6. Функциональные сопряжения, требования к точности, базы, сварные соединения, покрытие и контроль — с источником для каждого назначения.
7. Исходный RAR, если в нём находятся чертежи, параметры или ревизии, нужные для закрытия вопросов.

Согласно регламенту, точное количество обязательных рабочих чертежей, DXF, карт гибки и операций определяется после сверки дерева сборки и маршрутов. По одной BOM это число не подтверждено. Выполнена только проверка структуры и арифметики BOM; рабочие документы не созданы и к производству не разрешены.
