hisp2k/parameters/engineering/SolidWorksCodex/STAGE10_ORDER_2377_PACKAGE_REVIEW_RU.md

# Stage 10 — обзор комплекта_подготовки_производства_P1.zip (реальный заказ №2377)

Дата: 15.09.2026. Ветка: `claude/director-parametric-pilot`. Продолжение Stage 8/9
(мат-часть остаётся в переписке Claude ↔ пользователь / claude.ai Project
`SolidWoksConnetctor`, документ `status-director-pilot-stage10-order-2377-package-review.md`
— там же полный текст с таблицами и путями внутри архива).

## Источник и что это

`комплект_подготовки_производства_P1.zip` (109 МБ) — реальный производственный комплект
чертежей ООО "Тех-Аэро", НЕ математическая модель и не опросный лист. Внутри — эталонный
комплект чертежей `25.SHT.G.00.00.00.00 СБ` (полностью совпадает со структурой, уже изученной
в Stage 4-9) и фактически исполненный заказ `25.SHT - Заказ №2377 Промстрой` с реальными
значениями. Отдельно найдена сборка `05.SHT.TR.00.00.00.00` — трёхсекционный вариант
транспортера (~10.9 м), подтверждающий, что линейка не ограничена односекционной моделью.

## Ключевые находки (подробности — в документе Stage 10 в claude.ai Project)

1. Лист согласования `SHT-PV2-L3000 изм 1.pdf` — компактный чертёж для утверждения клиентом
   до расчёта. Код `L3000` = длина в мм (уже используемая у Тех-Аэро мини-нотация параметра
   длины). Шнек D200, корпус — материал заказной (в этом случае AISI 304), мотор-редуктор —
   тоже заказная опция.
2. Впервые получена полная спецификация (BOM) сборки `25.SHT.G.00.00.00.00 СБ` — 42 позиции,
   покупные (подшипник NSK 7213BEA, мотор-редуктор, крепёж ГОСТ/DIN) и непокупные
   (все `25.SHT.G.*`).
3. Вал шнека: подтверждено, что 65 мм и 76 мм — не альтернативные кандидаты, а ступенчатый
   вал (76 мм основной диаметр, 65 мм — посадка под подшипник 7213, это его стандартный
   посадочный диаметр). Открытый вопрос Stage 9 закрыт с высокой уверенностью.
4. Крышка: ширина 335 мм подтверждена для обеих модификаций (`06.01.00.01` и `07.01.00.01`);
   размеры 268/323 мм из дампа CAD — это внутренние размеры отверстий, а не ширина. Открытый
   вопрос Stage 9 по ширине снят.
5. Пластина `09.00.00.02`: реальная толщина S=4 мм подтверждена — совпадает с исходным
   значением уже проведённого параметрического эксперимента (4→5 мм).
6. Новая параметрическая связь: резиновая проставка под крышкой = 3000×40×2 мм — длина
   точно равна длине заказа (L3000). Первая найденная прямая зависимость «длина
   транспортера → длина конкретной детали» 1:1.
7. Многосекционные варианты подтверждены (см. `05.SHT.TR.00.00.00.00`) — полная
   параметризация по длине потребует работы на уровне сборки (массив/паттерн
   «Отсек+Шнек+Опора»), не только правки одного размера в детали.

## Что не изменилось

Формулы/математическая модель, связывающая опросный лист с размерами, в этом архиве
отсутствуют — по-прежнему главный блокер для автоматической параметризации.
