hisp2k/parameters/screens/58-GR/Проверки/СВЕРКА_STEP_BOM6_2026-10-02.md

# 58.GR — сверка структуры STEP КТ/ТТ с BOM(6)

**Дата:** 02.10.2026. **Статус:** промежуточная проверка состава; не рабочий выпуск КД и не разрешение к производству.

## Исходники и метод

| Источник | SHA-256 | Проверено |
|---|---|---|
| `58.GR BOM(6).xlsx` | `FD38E2BBC840E8360C724B6AF6394699F0A30EE3B65C77D41CFC0B89F2D91A6F` | Открыта таблица, разобраны 178 строк позиций |
| `58.GR.00.00.00.00 СБ  Решетка грабельная (STEP 214 КТ)(2).STEP` | `18470407768FB87A66DD818DF710B058CE9211CE95BDA041C3329F09D970B082` | Прочитана текстовая структура AP214 |
| `58.GR.00.00.00.00 СБ  Решетка грабельная (STEP 214 КТ)(2) (1).STEP` | тот же | Побайтно идентичен предыдущему; не отдельная ревизия |
| `58.GR.00.00.00.00 СБ  Решетка грабельная (STEP 214 ТТ)(2).STEP` | `3F0D679C15C2D81972175AE59EAC016CED285BEDD0CE722E65929B211817D16D` | Прочитана текстовая структура AP214 |

Разобраны записи `PRODUCT`, `PRODUCT_DEFINITION`, `NEXT_ASSEMBLY_USAGE_OCCURRENCE`, единицы и типы геометрических сущностей. Дерево посчитано рекурсивно от корневого изделия. Это **не** CAD-импорт: замкнутость и валидность тел, реальные размеры, объёмы, интерференции, развёртки, сварные соединения и пригодность DXF не проверены. Совпадение текста обозначения не доказывает тождество геометрии и конфигурации.

SOLIDWORKS 2026 доступен через API, но проба отдельного COM-экземпляра подключилась к уже открытой пользовательской сессии с 54 документами другого проекта. Импорт ТТ в эту сессию не выполнялся, чтобы не изменять её состояние. Это техническое ограничение текущей CAD-проверки, а не признак неисправности STEP.

## Факты по STEP

| Показатель | КТ | ТТ |
|---|---:|---:|
| Продуктов `PRODUCT` | 190 | 190 |
| Узлов сборки по связям | 33, включая корень и покупные узлы | 33, включая корень и покупные узлы |
| Конечных продуктов | 157 | 157 |
| Связей `NEXT_ASSEMBLY_USAGE_OCCURRENCE` | 929 | 929 |
| Вхождений конечных продуктов от корня | 949 | 949 |
| `GEOMETRIC_CURVE_SET` | 157 | 0 |
| `MANIFOLD_SOLID_BREP` / `CLOSED_SHELL` | 0 / 0 | 169 / 169 |
| `ADVANCED_FACE` | 0 | 8718 |

В обоих STEP указана единица длины `SI_UNIT(.MILLI., .METRE.)`, то есть миллиметр. По 121 различимому кодовому обозначению множества и суммарные количества в КТ и ТТ совпадают. ТТ содержит дополнительные суффиксы имён конфигураций; одинаковая структура не доказывает одинаковую геометрию.

КТ содержит 157 наборов геометрических кривых и не содержит объёмных BREP. Использовать его как источник объёмной геометрии или действительной развёртки нельзя. ТТ содержит объёмные BREP, но их топологическая валидность и привязка к каждому изделию не проверены CAD-ядром.

## Сопоставление с BOM

Полная построчная [матрица сопоставления](МАТРИЦА_BOM6_STEP_2026-10-02.csv) содержит позиции, обозначения, материалы и количества BOM, соответствующие имена STEP и числа вхождений от корня. Сопоставление выполнено по точному обозначению либо по нормализованному имени для строк без обозначения; без геометрического доказательства.

| Исход из 178 строк BOM | Строк |
|---|---:|
| Единственное текстовое соответствие и совпадающее количество | 170 |
| Несколько возможных продуктов STEP | 6 |
| Единственное соответствие, но разное количество | 2 |
| Нет текстового соответствия | 0 |

**Неоднозначные позиции:** 1/2 (`00.GR.01.00.00.09`) и 109/110 (`58.GR.01.00.00.06`) — в STEP по два отдельных узла `PRODUCT` с одинаковым обозначением и по одному вхождению каждого. BOM также содержит по две строки. Нельзя определить, это зеркальные исполнения или ошибочные дубли, пока не сопоставлена геометрия. Поз. 180/181 — две записи шайбы М8 DIN 125 А4, которые после нормализации имени неразличимы; в STEP два продукта с 1 и 14 вхождениями. Количества двух строк BOM тоже 1 и 14, но адресное соответствие и необходимость двух позиций не доказаны.

**Расхождение количества:** поз. 165 «Звено 1 HP38.1F10» и 166 «Звено 2 HP38.1F10» — BOM указывает по 1, дерево STEP — по 126 вхождений каждого. Возможно, BOM использует иное правило учёта цепи, но это требует явного подтверждения. Суммы по столбцу BOM и по дереву STEP из-за этого и вложенных сборок нельзя прямо сравнивать как количество деталей изделия.

**Конфигурации ТТ:** в имени `Шайба М10 DIN 127 А4_Шайба М10 DIN 125 А2` сочетаются разные стандарты и материалы; в имени `Гайка М8 ГОСТ 5916-70 А4_Hexagon Flange Nut DIN 6923 - M10 - C` — разные размеры и стандарты. Необходимо проверить фактически выбранные конфигурации и геометрию крепежа в CAD. Текст после подчёркивания может быть экспортным именем конфигурации; он сам по себе не устанавливает характеристику изделия.

**Статус сборки:** среди 31 строки BOM с пометой «СБ» две позиции представлены в STEP конечным продуктом без дочерних связей: поз. 58 `00.GR.12.00.00.02-01` «Втулка вварная», 3 вхождения, и поз. 104 `58-59.GR.12.00.00.01-01` «Проф труба», 1 вхождение. Нужно установить, являются ли это многотельные сварные единицы, единые детали или результат уплощения экспорта. Напротив, поз. 171–173 «Подшипник 208 2Z», «Подшипник UCF 308», «Подшипник UCP 204» имеют дочерние связи в STEP, хотя в BOM не обозначены «СБ». Их закупочный статус не следует определять только по структуре STEP.

**Привод:** BOM поз. 170 и ТТ называют мотор-редуктор `PCRV090.130-121-7.4-1,1кВт-6P-380-50`, 1 шт. Историческое решение из реестра указывает 1,5 кВт. Действующую комплектацию нужно определить по ревизии заказа; момент и связанные расчёты пока не подтверждены.

## Состояние выпуска и следующая операция

- Аналитические документы данной проверки: 2 созданы и проверены на читаемость (этот протокол и CSV-матрица). Производственных чертежей, DXF, карт гибки и технологических документов по этой проверке: 0 создано и 0 проверено.
- В BOM 31 строка с пометой «СБ» и 92 строки с индивидуальными обозначениями деталей. [Предварительный реестр](РЕЕСТР_ДОКУМЕНТОВ_2026-10-02.csv) содержит 154 документных слота: 31 сборочный чертёж, 31 спецификацию и 92 чертежа деталей, все пока блокированы. Это учёт по строкам BOM, не окончательное число разных файлов: две «СБ» не имеют дочерних связей в STEP, а две пары обозначений деталей повторяются. Чертёж и спецификация корневого изделия, DXF, карты гибки, технология и закупочные ведомости в эти 154 слота не включены. Их точное число определяется после классификации всех 178 позиций и проверки геометрии ТТ в CAD.
- [Перечень 55 позиций без индивидуального обозначения](КАНДИДАТЫ_БЕЗ_ЧЕРТЕЖЕЙ_2026-10-02.csv) выделяет 45 предположительно стандартных, 5 предположительно покупных и 5 неклассифицированных строк. Это кандидаты для ведомости «Детали без чертежей», а не окончательное освобождение от чертежей: закупочный статус, доработки и наличие исходных КД не проверены.
- Следующая операция: открыть ТТ в CAD-ядре, проверить импорт и 169 BREP, установить связь каждого тела с продуктом, конфигурацией и материалом; затем разрешить восемь строк матрицы со статусом, отличным от «quantity matches», и составить реестр обязательных документов.
- Недостающие исходные решения: действующая ревизия, правило количества цепных звеньев, конфигурации дублированных и противоречивых крепёжных позиций, мощность привода, технологические параметры и нормы времени. Исходный RAR в этой проверке не исследован.

Проверку выполнил автоматизированный текстовый разбор STEP и BOM. Нормоконтроль предприятия и допуск к производству не проводились.
