hisp2k/parameters/engineering/SolidWorksCodex/drawing-dataset/inventory.csv

rel_path | sha256 | page_count | has_text_layer | designation | name | material | material_status | scale | mass_kg | document_type | provisional_class | class_confidence | class_reason | processing_status
1) ААА Тех.отдел/1. ДЛЯ ДИРЕКТОРА (18.08)/В работу/05.SHT.TR.00.00.00.00/05.SHT.TR.00.00.00.00 чертежи/00.SHU.P.05.00.001 'Ось'.pdf | 932a3dd81fda51b973bda1a30e30f723fbb72a547ebf1d798c8aff06c3617412 | 1 | True | 00.SHU.P.05.00.001 | Ось | 09Г2С | CONFIRMED_IN_TEXT |  |  | part_drawing_candidate | вал | MEDIUM | name_keyword:ось | INVENTORIED_TEXT_ONLY
1) ААА Тех.отдел/1. ДЛЯ ДИРЕКТОРА (18.08)/В работу/05.SHT.TR.00.00.00.00/05.SHT.TR.00.00.00.00 чертежи/05.SHT.TR.00.00.00.00 СБ Транспортер Изм1.PDF | fc6873a6f299cb9650674ebe787a4b165a3a9eaa6edceb9872e93be0b0876c1d | 3 | True | 05.SHT.TR.00.00.00.00 | СБ Транспортер Изм1 | Сталь 45 | CONFIRMED_IN_TEXT |  |  | assembly_drawing | сборочная единица | MEDIUM | doc_type:assembly | INVENTORIED_TEXT_ONLY
1) ААА Тех.отдел/1. ДЛЯ ДИРЕКТОРА (18.08)/В работу/05.SHT.TR.00.00.00.00/05.SHT.TR.00.00.00.00 чертежи/05.SHT.TR.00.00.00.00 СБ Транспортер.pdf | 3c15e36076e95bae5929f6e15cee34202929fd0a7735df7bcd762be01918b600 | 3 | True | 05.SHT.TR.00.00.00.00 | СБ Транспортер | Сталь 45 | CONFIRMED_IN_TEXT |  |  | assembly_drawing | сборочная единица | MEDIUM | doc_type:assembly | INVENTORIED_TEXT_ONLY
1) ААА Тех.отдел/1. ДЛЯ ДИРЕКТОРА (18.08)/В работу/05.SHT.TR.00.00.00.00/05.SHT.TR.00.00.00.00 чертежи/05.SHT.TR.00.00.00.04 Резина проставка под крышкой.pdf | 23e24adfaa46d60cf16ba1852514d1f71eeb05da2c9ce8ce8970e7c6761362f2 | 1 | True | 05.SHT.TR.00.00.00.04 | Резина проставка под крышкой | Резина | CONFIRMED_IN_TEXT |  |  | part_drawing_candidate | покупное изделие | MEDIUM | name_keyword:резина | INVENTORIED_TEXT_ONLY
1) ААА Тех.отдел/1. ДЛЯ ДИРЕКТОРА (18.08)/В работу/05.SHT.TR.00.00.00.00/05.SHT.TR.00.00.00.00 чертежи/05.SHT.TR.01.00.00.01 Желоб выгрузки.pdf | 425a0d7927e68a25f91b4a046cec1f107bd4fe75ec63d3331af164de809869aa | 1 | True | 05.SHT.TR.01.00.00.01 | Желоб выгрузки | AISI 304 | CONFIRMED_IN_TEXT |  |  | part_drawing_candidate | гнутая листовая деталь | MEDIUM | bent_sheet_signal | INVENTORIED_TEXT_ONLY
1) ААА Тех.отдел/1. ДЛЯ ДИРЕКТОРА (18.08)/В работу/05.SHT.TR.00.00.00.00/05.SHT.TR.00.00.00.00 чертежи/05.SHT.TR.01.00.00.02 Желоб.pdf | 0ff0ffc7e4d2f4941d49a177a2b850d1bf6213456f26d52230b5c9321cbbf9d8 | 1 | True | 05.SHT.TR.01.00.00.02 | Желоб | AISI 304 | CONFIRMED_IN_TEXT |  |  | part_drawing_candidate | гнутая листовая деталь | MEDIUM | bent_sheet_signal | INVENTORIED_TEXT_ONLY
1) ААА Тех.отдел/1. ДЛЯ ДИРЕКТОРА (18.08)/В работу/05.SHT.TR.00.00.00.00/05.SHT.TR.00.00.00.00 чертежи/05.SHT.TR.01.00.00.03 Желоб.pdf | 22d379957332086f92c37acc4894550cc14f5322cc0498a72ca81b3226fdba47 | 1 | True | 05.SHT.TR.01.00.00.03 | Желоб | AISI 304 | CONFIRMED_IN_TEXT |  |  | part_drawing_candidate | гнутая листовая деталь | MEDIUM | bent_sheet_signal | INVENTORIED_TEXT_ONLY
1) ААА Тех.отдел/1. ДЛЯ ДИРЕКТОРА (18.08)/В работу/05.SHT.TR.00.00.00.00/05.SHT.TR.00.00.00.00 чертежи/05.SHT.TR.02.00.00.00 СБ Шнек с осями.pdf | e8996284c166570da92aa53920ec673631be7d47a33e2e48422c9a17d06494c0 | 1 | True | 05.SHT.TR.02.00.00.00 | СБ Шнек с осями |  | UNKNOWN |  |  | assembly_drawing | сборочная единица | MEDIUM | doc_type:assembly | INVENTORIED_TEXT_ONLY
1) ААА Тех.отдел/1. ДЛЯ ДИРЕКТОРА (18.08)/В работу/05.SHT.TR.00.00.00.00/05.SHT.TR.00.00.00.00 чертежи/05.SHT.TR.02.00.00.01 Шнек 200 мм.pdf | df68c4326558f4837aa4be45150dc14c0ec972c2ead3a51a16dcf34758e8c010 | 1 | True | 05.SHT.TR.02.00.00.01 | Шнек 200 мм | 09Г2С | CONFIRMED_IN_TEXT |  |  | part_drawing_candidate | плоская листовая деталь | MEDIUM | text_keyword:лист | INVENTORIED_TEXT_ONLY
1) ААА Тех.отдел/1. ДЛЯ ДИРЕКТОРА (18.08)/В работу/05.SHT.TR.00.00.00.00/05.SHT.TR.00.00.00.00 чертежи/05.SHT.TR.03.00.00.01 Желоб.pdf | ed4b20f410aec1ab63ffb27cebc5f21ebb2d6e11260bcfaa6f4c0fe96b25e97a | 1 | True | 05.SHT.TR.03.00.00.01 | Желоб | AISI 304 | CONFIRMED_IN_TEXT |  |  | part_drawing_candidate | гнутая листовая деталь | MEDIUM | bent_sheet_signal | INVENTORIED_TEXT_ONLY
1) ААА Тех.отдел/1. ДЛЯ ДИРЕКТОРА (18.08)/В работу/05.SHT.TR.00.00.00.00/05.SHT.TR.00.00.00.00 чертежи/05.SHT.TR.03.00.00.02 Желоб.pdf | a3410bf73e2a2f9f19a167bbecaa8dd2a68bc99f2312dc3c8366be424a5ea3b0 | 1 | True | 05.SHT.TR.03.00.00.02 | Желоб | AISI 304 | CONFIRMED_IN_TEXT |  |  | part_drawing_candidate | гнутая листовая деталь | MEDIUM | bent_sheet_signal | INVENTORIED_TEXT_ONLY
1) ААА Тех.отдел/1. ДЛЯ ДИРЕКТОРА (18.08)/В работу/05.SHT.TR.00.00.00.00/05.SHT.TR.00.00.00.00 чертежи/05.SHT.TR.03.00.00.03 Желоб.pdf | 2ed134f2fb9427692a5873f746d05682092481653175e806dec2e80d0e0fe447 | 1 | True | 05.SHT.TR.03.00.00.03 | Желоб | AISI 304 | CONFIRMED_IN_TEXT |  |  | part_drawing_candidate | гнутая листовая деталь | MEDIUM | bent_sheet_signal | INVENTORIED_TEXT_ONLY
1) ААА Тех.отдел/1. ДЛЯ ДИРЕКТОРА (18.08)/В работу/05.SHT.TR.00.00.00.00/05.SHT.TR.00.00.00.00 чертежи/05.SHT.TR.06.01.00.00 СБ Крышка с горловиной.pdf | e5926af9062145025b8add9453107279545d2d172afcb072818c055b67043f01 | 1 | True | 05.SHT.TR.06.01.00.00 | СБ Крышка с горловиной | AISI 304 | CONFIRMED_IN_TEXT |  |  | assembly_drawing | сборочная единица | MEDIUM | doc_type:assembly | INVENTORIED_TEXT_ONLY
1) ААА Тех.отдел/1. ДЛЯ ДИРЕКТОРА (18.08)/В работу/05.SHT.TR.00.00.00.00/05.SHT.TR.00.00.00.00 чертежи/05.SHT.TR.06.01.00.01 Пластина.pdf | 633b97940b55b673059948b10947aaebf878e2561f69fad73fc88a275bb73015 | 1 | True | 05.SHT.TR.06.01.00.01 | Пластина | AISI 304 | CONFIRMED_IN_TEXT |  |  | part_drawing_candidate | гнутая листовая деталь | MEDIUM | bent_sheet_signal | INVENTORIED_TEXT_ONLY
1) ААА Тех.отдел/1. ДЛЯ ДИРЕКТОРА (18.08)/В работу/05.SHT.TR.00.00.00.00/05.SHT.TR.00.00.00.00 чертежи/05.SHT.TR.07.00.00.00 СБ Крышка.pdf | 3cf18a605ce68c1ce1f5688ba83ba76d97dd520e19d63045a06b4e9885303f6c | 1 | True | 05.SHT.TR.07.00.00.00 | СБ Крышка |  | UNKNOWN |  |  | assembly_drawing | сборочная единица | MEDIUM | doc_type:assembly | INVENTORIED_TEXT_ONLY
1) ААА Тех.отдел/1. ДЛЯ ДИРЕКТОРА (18.08)/В работу/05.SHT.TR.00.00.00.00/05.SHT.TR.00.00.00.00 чертежи/05.SHT.TR.07.00.00.01 Пластина крышки.pdf | 572d65a702c0c7456881d617d0a6dcade0308d391d37052c59fe28e036269e60 | 1 | True | 05.SHT.TR.07.00.00.01 | Пластина крышки | AISI 304 | CONFIRMED_IN_TEXT |  |  | part_drawing_candidate | гнутая листовая деталь | MEDIUM | bent_sheet_signal | INVENTORIED_TEXT_ONLY
1) ААА Тех.отдел/1. ДЛЯ ДИРЕКТОРА (18.08)/В работу/05.SHT.TR.00.00.00.00/05.SHT.TR.00.00.00.00 чертежи/05.SHT.TR.11.00.00.00 СБ Отсек.pdf | d117b03fbfddc5a444e6d53f00694b5834d51ec1798c5be086358896e9928c05 | 2 | True | 05.SHT.TR.11.00.00.00 | СБ Отсек | AISI 304 | CONFIRMED_IN_TEXT |  |  | assembly_drawing | сборочная единица | MEDIUM | doc_type:assembly | INVENTORIED_TEXT_ONLY
1) ААА Тех.отдел/1. ДЛЯ ДИРЕКТОРА (18.08)/В работу/05.SHT.TR.00.00.00.00/05.SHT.TR.00.00.00.00 чертежи/05.SHT.TR.11.00.00.01 Желоб.pdf | 1916c55fb3721d8d07c408b9f78b4133fb87c8d27e81dd787e8e64b8f76f7c6f | 1 | True | 05.SHT.TR.11.00.00.01 | Желоб | AISI 304 | CONFIRMED_IN_TEXT |  |  | part_drawing_candidate | гнутая листовая деталь | MEDIUM | bent_sheet_signal | INVENTORIED_TEXT_ONLY
1) ААА Тех.отдел/1. ДЛЯ ДИРЕКТОРА (18.08)/В работу/05.SHT.TR.00.00.00.00/05.SHT.TR.00.00.00.00 чертежи/05.SHT.TR.11.00.00.02 Желоб.pdf | 51e64e061be40384d348fbd778fcd1dde25dbf6bc9587c0672e4b9ff5a8e1d29 | 1 | True | 05.SHT.TR.11.00.00.02 | Желоб | AISI 304 | CONFIRMED_IN_TEXT |  |  | part_drawing_candidate | гнутая листовая деталь | MEDIUM | bent_sheet_signal | INVENTORIED_TEXT_ONLY
1) ААА Тех.отдел/1. ДЛЯ ДИРЕКТОРА (18.08)/В работу/05.SHT.TR.00.00.00.00/05.SHT.TR.00.00.00.00 чертежи/05.SHT.TR.11.00.00.03 Желоб.pdf | 7c30e78094eca44da464a199c86f25b34da8729643a2f6032c80a48d02cba4b9 | 1 | True | 05.SHT.TR.11.00.00.03 | Желоб | AISI 304 | CONFIRMED_IN_TEXT |  |  | part_drawing_candidate | гнутая листовая деталь | MEDIUM | bent_sheet_signal | INVENTORIED_TEXT_ONLY
1) ААА Тех.отдел/1. ДЛЯ ДИРЕКТОРА (18.08)/В работу/05.SHT.TR.00.00.00.00/05.SHT.TR.00.00.00.00 чертежи/05.SHT.TR.11.00.00.04 Желоб.pdf | 7a2e8249b210a386109062f2395e5cd373749b7cb1c16782d8bff38e2eea2cbd | 1 | True | 05.SHT.TR.11.00.00.04 | Желоб | AISI 304 | CONFIRMED_IN_TEXT |  |  | part_drawing_candidate | гнутая листовая деталь | MEDIUM | bent_sheet_signal | INVENTORIED_TEXT_ONLY
1) ААА Тех.отдел/1. ДЛЯ ДИРЕКТОРА (18.08)/В работу/05.SHT.TR.00.00.00.00/05.SHT.TR.00.00.00.00 чертежи/05.SHT.TR.11.00.00.05 Уголок.pdf | 4b9ea093c3275dec6d1eab9275eef8e63047ba5848b05308450a8849dd03bb08 | 1 | True | 05.SHT.TR.11.00.00.05 | Уголок | AISI 304 | CONFIRMED_IN_TEXT |  |  | part_drawing_candidate | профильная деталь | MEDIUM | name_keyword:уголок | INVENTORIED_TEXT_ONLY
1) ААА Тех.отдел/1. ДЛЯ ДИРЕКТОРА (18.08)/В работу/05.SHT.TR.00.00.00.00/05.SHT.TR.00.00.00.00 чертежи/05.SHT.TR.12.00.00.00 СБ Крышка.pdf | e1604b185e9f2be3bff5f837cce3928704d1289a9e75af06ae2620da355624d1 | 1 | True | 05.SHT.TR.12.00.00.00 | СБ Крышка |  | UNKNOWN |  |  | assembly_drawing | сборочная единица | MEDIUM | doc_type:assembly | INVENTORIED_TEXT_ONLY
1) ААА Тех.отдел/1. ДЛЯ ДИРЕКТОРА (18.08)/В работу/05.SHT.TR.00.00.00.00/05.SHT.TR.00.00.00.00 чертежи/05.SHT.TR.12.00.00.01 Пластина крышки.pdf | e7b936c6e8e1b6226d40cc76225031414c5eba7538744422fb790f7522617787 | 1 | True | 05.SHT.TR.12.00.00.01 | Пластина крышки | AISI 304 | CONFIRMED_IN_TEXT |  |  | part_drawing_candidate | гнутая листовая деталь | MEDIUM | bent_sheet_signal | INVENTORIED_TEXT_ONLY
1) ААА Тех.отдел/1. ДЛЯ ДИРЕКТОРА (18.08)/В работу/05.SHT.TR.00.00.00.00/05.SHT.TR.00.00.00.00 чертежи/05.SHT.TR.13.01.00.00 СБ Крышка с горловиной.pdf | 3b0bf64b156f08e9ea9ca633aa8335a7f5dff6e91f51c590ab57744d0ffd155a | 1 | True | 05.SHT.TR.13.01.00.00 | СБ Крышка с горловиной | AISI 304 | CONFIRMED_IN_TEXT |  |  | assembly_drawing | сборочная единица | MEDIUM | doc_type:assembly | INVENTORIED_TEXT_ONLY
1) ААА Тех.отдел/1. ДЛЯ ДИРЕКТОРА (18.08)/В работу/05.SHT.TR.00.00.00.00/05.SHT.TR.00.00.00.00 чертежи/05.SHT.TR.13.01.00.01 Пластина.pdf | 1529938f5e2b2897338d26f6df57f07388e620ccc5b38223f669cd9c2b5ce329 | 1 | True | 05.SHT.TR.13.01.00.01 | Пластина | AISI 304 | CONFIRMED_IN_TEXT |  |  | part_drawing_candidate | гнутая листовая деталь | MEDIUM | bent_sheet_signal | INVENTORIED_TEXT_ONLY
1) ААА Тех.отдел/1. ДЛЯ ДИРЕКТОРА (18.08)/В работу/05.SHT.TR.00.00.00.00/05.SHT.TR.00.00.00.00 чертежи/Перо шнека 200 мм.pdf | 58b6818049db306daba310c7f2441bab66f2995c00111ded873f406b3b2dacbd | 1 | True | Перо | шнека 200 мм | 09Г2С | CONFIRMED_IN_TEXT |  |  | part_drawing_candidate | плоская листовая деталь | MEDIUM | text_keyword:лист | INVENTORIED_TEXT_ONLY
1) ААА Тех.отдел/1. ДЛЯ ДИРЕКТОРА (18.08)/В работу/1.0 Проект Шнековый транспортер/25.SHT - Заказ №2377 Промстрой/25.SHT.G.00.00.00.00 СБ Изм.5/25.SHT.G.00.00.00.00 СБ/SHT-PV2-L3000 изм 1.pdf | e579abb4af61838042f2f83e57f7f2d6909da6b248c88dd4a00fa7b7d292dbcc | 1 | True | SHT-PV2-L3000 | изм 1 | 09Г2С | CONFIRMED_IN_TEXT |  |  | assembly_drawing | сборочная единица | MEDIUM | doc_type:assembly | INVENTORIED_TEXT_ONLY
1) ААА Тех.отдел/1. ДЛЯ ДИРЕКТОРА (18.08)/В работу/1.0 Проект Шнековый транспортер/25.SHT - Заказ №2377 Промстрой/25.SHT.G.00.00.00.00 СБ Изм.5/25.SHT.G.00.00.00.00 СБ/Чертежи/25.SHT.G.02.00.00.00 СБ Шнек с осями.pdf | 726ed7b4a8b476a9d6a349f6ab698c8233acf006457a97c9dcd97961c3cb2dcd | 1 | True | 25.SHT.G.02.00.00.00 | СБ Шнек с осями | 09Г2С | CONFIRMED_IN_TEXT |  |  | assembly_drawing | сборочная единица | MEDIUM | doc_type:assembly | INVENTORIED_TEXT_ONLY
1) ААА Тех.отдел/1. ДЛЯ ДИРЕКТОРА (18.08)/В работу/1.0 Проект Шнековый транспортер/25.SHT - Заказ №2377 Промстрой/25.SHT.G.00.00.00.00 СБ Изм.5/25.SHT.G.00.00.00.00 СБ/Чертежи/Вальцовка/25.SHT.G.00.00.00.00/25.SHT.G.00.00.00.01 Футеровка.pdf | 23a0b1c390b7bc06dca77e082a6ac0e56851a7b205f44c5409020c34c6d82441 | 1 | True | 25.SHT.G.00.00.00.01 | Футеровка |  | UNKNOWN |  |  | assembly_drawing | сборочная единица | MEDIUM | doc_type:assembly | INVENTORIED_TEXT_ONLY
1) ААА Тех.отдел/1. ДЛЯ ДИРЕКТОРА (18.08)/В работу/1.0 Проект Шнековый транспортер/25.SHT - Заказ №2377 Промстрой/25.SHT.G.00.00.00.00 СБ Изм.5/25.SHT.G.00.00.00.00 СБ/Чертежи/Вальцовка/25.SHT.G.00.00.00.00/25.SHT.G.00.00.00.02 Футеровка.pdf | 1f84cf13d1aa5e3011e64d9d0b5ab592eaa325c3eb01cf00076076c21ff27d40 | 1 | True | 25.SHT.G.00.00.00.02 | Футеровка |  | UNKNOWN |  |  | assembly_drawing | сборочная единица | MEDIUM | doc_type:assembly | INVENTORIED_TEXT_ONLY
1) ААА Тех.отдел/1. ДЛЯ ДИРЕКТОРА (18.08)/В работу/1.0 Проект Шнековый транспортер/25.SHT - Заказ №2377 Промстрой/25.SHT.G.00.00.00.00 СБ Изм.5/25.SHT.G.00.00.00.00 СБ/Чертежи/Вальцовка/25.SHT.G.00.00.00.00/25.SHT.G.01.00.00.01 Желоб выгрузки.pdf | 1641cb47f1e8be50cc5f3dc156834efbd0de8c153c1bc0e249d65afa3946525c | 1 | True | 25.SHT.G.01.00.00.01 | Желоб выгрузки |  | UNKNOWN |  |  | assembly_drawing | сборочная единица | MEDIUM | doc_type:assembly | INVENTORIED_TEXT_ONLY
1) ААА Тех.отдел/1. ДЛЯ ДИРЕКТОРА (18.08)/В работу/1.0 Проект Шнековый транспортер/25.SHT - Заказ №2377 Промстрой/25.SHT.G.00.00.00.00 СБ Изм.5/25.SHT.G.00.00.00.00 СБ/Чертежи/Вальцовка/25.SHT.G.00.00.00.00/25.SHT.G.01.00.00.02, 25.SHT.G.01.00.00.03 Желоб.pdf | 8f1aba6a774604ab53e534474422c1c3a639b7c813b1a783a37132b7b65f8546 | 1 | True | 25.SHT.G.01.00.00.02, 25.SHT.G.01.00.00.03 Желоб |  |  | UNKNOWN |  |  | assembly_drawing | сборочная единица | MEDIUM | doc_type:assembly | INVENTORIED_TEXT_ONLY
1) ААА Тех.отдел/1. ДЛЯ ДИРЕКТОРА (18.08)/В работу/1.0 Проект Шнековый транспортер/25.SHT - Заказ №2377 Промстрой/25.SHT.G.00.00.00.00 СБ Изм.5/25.SHT.G.00.00.00.00 СБ/Чертежи/Вальцовка/25.SHT.G.00.00.00.01 Футеровка.pdf | 23a0b1c390b7bc06dca77e082a6ac0e56851a7b205f44c5409020c34c6d82441 | 1 | True | 25.SHT.G.00.00.00.01 | Футеровка |  | UNKNOWN |  |  | assembly_drawing | сборочная единица | MEDIUM | doc_type:assembly | INVENTORIED_TEXT_ONLY
1) ААА Тех.отдел/1. ДЛЯ ДИРЕКТОРА (18.08)/В работу/1.0 Проект Шнековый транспортер/25.SHT - Заказ №2377 Промстрой/25.SHT.G.00.00.00.00 СБ Изм.5/25.SHT.G.00.00.00.00 СБ/Чертежи/Вальцовка/25.SHT.G.00.00.00.02 Футеровка.pdf | 1f84cf13d1aa5e3011e64d9d0b5ab592eaa325c3eb01cf00076076c21ff27d40 | 1 | True | 25.SHT.G.00.00.00.02 | Футеровка |  | UNKNOWN |  |  | assembly_drawing | сборочная единица | MEDIUM | doc_type:assembly | INVENTORIED_TEXT_ONLY
1) ААА Тех.отдел/1. ДЛЯ ДИРЕКТОРА (18.08)/В работу/1.0 Проект Шнековый транспортер/25.SHT - Заказ №2377 Промстрой/25.SHT.G.00.00.00.00 СБ Изм.5/25.SHT.G.00.00.00.00 СБ/Чертежи/Вальцовка/25.SHT.G.01.00.00.01 Желоб выгрузки.pdf | 1641cb47f1e8be50cc5f3dc156834efbd0de8c153c1bc0e249d65afa3946525c | 1 | True | 25.SHT.G.01.00.00.01 | Желоб выгрузки |  | UNKNOWN |  |  | assembly_drawing | сборочная единица | MEDIUM | doc_type:assembly | INVENTORIED_TEXT_ONLY
1) ААА Тех.отдел/1. ДЛЯ ДИРЕКТОРА (18.08)/В работу/1.0 Проект Шнековый транспортер/25.SHT - Заказ №2377 Промстрой/25.SHT.G.00.00.00.00 СБ Изм.5/25.SHT.G.00.00.00.00 СБ/Чертежи/Вальцовка/25.SHT.G.01.00.00.02, 25.SHT.G.01.00.00.03 Желоб.pdf | 8f1aba6a774604ab53e534474422c1c3a639b7c813b1a783a37132b7b65f8546 | 1 | True | 25.SHT.G.01.00.00.02, 25.SHT.G.01.00.00.03 Желоб |  |  | UNKNOWN |  |  | assembly_drawing | сборочная единица | MEDIUM | doc_type:assembly | INVENTORIED_TEXT_ONLY
1) ААА Тех.отдел/1. ДЛЯ ДИРЕКТОРА (18.08)/В работу/1.0 Проект Шнековый транспортер/25.SHT - Заказ №2377 Промстрой/25.SHT.G.00.00.00.00 СБ Изм.5/25.SHT.G.00.00.00.00 СБ/Чертежи/Гибка/25.SHT.G.00.00.00.00 Гибка/25.SHT.G.06.01.00.01 Пластина крышки.pdf | 06ad59c3d5793c8ff55cca90501b321961eef5a53be96ce3bec35bd4d002e41d | 1 | True | 25.SHT.G.06.01.00.01 | Пластина крышки |  | UNKNOWN |  |  | assembly_drawing | сборочная единица | MEDIUM | doc_type:assembly | INVENTORIED_TEXT_ONLY
1) ААА Тех.отдел/1. ДЛЯ ДИРЕКТОРА (18.08)/В работу/1.0 Проект Шнековый транспортер/25.SHT - Заказ №2377 Промстрой/25.SHT.G.00.00.00.00 СБ Изм.5/25.SHT.G.00.00.00.00 СБ/Чертежи/Гибка/25.SHT.G.00.00.00.00 Гибка/25.SHT.G.07.01.00.01 Пластина крышки.pdf | 0815eba6f5da7d11b85a95aed28d1c9963cca37e731f6f8a2b8691fd4001a24d | 1 | True | 25.SHT.G.07.01.00.01 | Пластина крышки |  | UNKNOWN |  |  | assembly_drawing | сборочная единица | MEDIUM | doc_type:assembly | INVENTORIED_TEXT_ONLY
1) ААА Тех.отдел/1. ДЛЯ ДИРЕКТОРА (18.08)/В работу/1.0 Проект Шнековый транспортер/25.SHT - Заказ №2377 Промстрой/25.SHT.G.00.00.00.00 СБ Изм.5/25.SHT.G.00.00.00.00 СБ/Чертежи/Гибка/25.SHT.G.06.01.00.01 Пластина крышки.pdf | 06ad59c3d5793c8ff55cca90501b321961eef5a53be96ce3bec35bd4d002e41d | 1 | True | 25.SHT.G.06.01.00.01 | Пластина крышки |  | UNKNOWN |  |  | assembly_drawing | сборочная единица | MEDIUM | doc_type:assembly | INVENTORIED_TEXT_ONLY
1) ААА Тех.отдел/1. ДЛЯ ДИРЕКТОРА (18.08)/В работу/1.0 Проект Шнековый транспортер/25.SHT - Заказ №2377 Промстрой/25.SHT.G.00.00.00.00 СБ Изм.5/25.SHT.G.00.00.00.00 СБ/Чертежи/Гибка/25.SHT.G.07.01.00.01 Пластина крышки.pdf | 0815eba6f5da7d11b85a95aed28d1c9963cca37e731f6f8a2b8691fd4001a24d | 1 | True | 25.SHT.G.07.01.00.01 | Пластина крышки |  | UNKNOWN |  |  | assembly_drawing | сборочная единица | MEDIUM | doc_type:assembly | INVENTORIED_TEXT_ONLY
1) ААА Тех.отдел/1. ДЛЯ ДИРЕКТОРА (18.08)/В работу/1.0 Проект Шнековый транспортер/25.SHT - Заказ №2377 Промстрой/25.SHT.G.00.00.00.00 СБ Изм.5/25.SHT.G.00.00.00.00 СБ/Чертежи/Детали/25.SHT.G.00.00.00.00 Фланцы.pdf | 696efadd6d126a78eb38c7630d00b46b030e3592b66445218e7831a96f2efb4c | 1 | True | 25.SHT.G.00.00.00.00 | Фланцы |  | UNKNOWN |  |  | assembly_drawing | сборочная единица | MEDIUM | doc_type:assembly | INVENTORIED_TEXT_ONLY
1) ААА Тех.отдел/1. ДЛЯ ДИРЕКТОРА (18.08)/В работу/1.0 Проект Шнековый транспортер/25.SHT - Заказ №2377 Промстрой/25.SHT.G.00.00.00.00 СБ Изм.5/25.SHT.G.00.00.00.00 СБ/Чертежи/Детали/25.SHT.G.00.00.00.03 Резиновая прокладка к фланцам.pdf | a3a2423b717d5d99045948faab2a562eb8fe2ef3089f03a8c0cc8d47c8986f05 | 1 | True | 25.SHT.G.00.00.00.03 | Резиновая прокладка к фланцам |  | UNKNOWN |  |  | assembly_drawing | сборочная единица | MEDIUM | doc_type:assembly | INVENTORIED_TEXT_ONLY
1) ААА Тех.отдел/1. ДЛЯ ДИРЕКТОРА (18.08)/В работу/1.0 Проект Шнековый транспортер/25.SHT - Заказ №2377 Промстрой/25.SHT.G.00.00.00.00 СБ Изм.5/25.SHT.G.00.00.00.00 СБ/Чертежи/Детали/25.SHT.G.00.00.00.04 Резина проставка под крышкой.pdf | cda8db95ee453a43373d8eba39d3ee66ae16956bc5ba3619abb8aac0dafc7ed5 | 1 | True | 25.SHT.G.00.00.00.04 | Резина проставка под крышкой | Резина | CONFIRMED_IN_TEXT |  |  | assembly_drawing | сборочная единица | MEDIUM | doc_type:assembly | INVENTORIED_TEXT_ONLY
1) ААА Тех.отдел/1. ДЛЯ ДИРЕКТОРА (18.08)/В работу/1.0 Проект Шнековый транспортер/25.SHT - Заказ №2377 Промстрой/25.SHT.G.00.00.00.00 СБ Изм.5/25.SHT.G.00.00.00.00 СБ/Чертежи/Детали/25.SHT.G.00.00.00.05 Фланец наружний.pdf | 16076c1e44e3c1b0ae032d0a5eb7a7cf30494cdc9d8283eceb298c2a2169adee | 1 | True | 25.SHT.G.00.00.00.05 | Фланец наружний |  | UNKNOWN |  |  | assembly_drawing | сборочная единица | MEDIUM | doc_type:assembly | INVENTORIED_TEXT_ONLY
1) ААА Тех.отдел/1. ДЛЯ ДИРЕКТОРА (18.08)/В работу/1.0 Проект Шнековый транспортер/25.SHT - Заказ №2377 Промстрой/25.SHT.G.00.00.00.00 СБ Изм.5/25.SHT.G.00.00.00.00 СБ/Чертежи/Детали/25.SHT.G.01.00.00.04 Уголок.pdf | d8963b0233cf9a7b729d9b9099c569caca3826e8f8f235978f6b8e24c06d203b | 1 | True | 25.SHT.G.01.00.00.04 | Уголок |  | UNKNOWN |  |  | assembly_drawing | сборочная единица | MEDIUM | doc_type:assembly | INVENTORIED_TEXT_ONLY
1) ААА Тех.отдел/1. ДЛЯ ДИРЕКТОРА (18.08)/В работу/1.0 Проект Шнековый транспортер/25.SHT - Заказ №2377 Промстрой/25.SHT.G.00.00.00.00 СБ Изм.5/25.SHT.G.00.00.00.00 СБ/Чертежи/Детали/25.SHT.G.01.00.00.10 Труба.pdf | e3750a142d9571d5ad1ae990fd110b0b572285c7aab3eefd0e7c9ff0cd3c6665 | 1 | True | 25.SHT.G.01.00.00.10 | Труба |  | UNKNOWN |  |  | assembly_drawing | сборочная единица | MEDIUM | doc_type:assembly | INVENTORIED_TEXT_ONLY
1) ААА Тех.отдел/1. ДЛЯ ДИРЕКТОРА (18.08)/В работу/1.0 Проект Шнековый транспортер/25.SHT - Заказ №2377 Промстрой/25.SHT.G.00.00.00.00 СБ Изм.5/25.SHT.G.00.00.00.00 СБ/Чертежи/Детали/25.SHT.G.01.00.00.11 Труба.pdf | 909fa8dd10d2695da36a72c61a64b3ee130a0795defdce8df60c48577c36f61b | 1 | True | 25.SHT.G.01.00.00.11 | Труба |  | UNKNOWN |  |  | assembly_drawing | сборочная единица | MEDIUM | doc_type:assembly | INVENTORIED_TEXT_ONLY
1) ААА Тех.отдел/1. ДЛЯ ДИРЕКТОРА (18.08)/В работу/1.0 Проект Шнековый транспортер/25.SHT - Заказ №2377 Промстрой/25.SHT.G.00.00.00.00 СБ Изм.5/25.SHT.G.00.00.00.00 СБ/Чертежи/Детали/25.SHT.G.02.00.00.04 Торец.pdf | 47e43877ce12ce5c9d4cc57e6d6bd371fba37160ec946663304760d664d2d0fc | 1 | True | 25.SHT.G.02.00.00.04 | Торец | 09Г2С | CONFIRMED_IN_TEXT |  |  | assembly_drawing | сборочная единица | MEDIUM | doc_type:assembly | INVENTORIED_TEXT_ONLY
1) ААА Тех.отдел/1. ДЛЯ ДИРЕКТОРА (18.08)/В работу/1.0 Проект Шнековый транспортер/25.SHT - Заказ №2377 Промстрой/25.SHT.G.00.00.00.00 СБ Изм.5/25.SHT.G.00.00.00.00 СБ/Чертежи/Детали/25.SHT.G.03.00.00.04 Косынка.pdf | 7c33550c683862bd5fdedf0bdab4bca3bd33e9f623128183e3cfdc5f19c05a95 | 1 | True | 25.SHT.G.03.00.00.04 | Косынка |  | UNKNOWN |  |  | assembly_drawing | сборочная единица | MEDIUM | doc_type:assembly | INVENTORIED_TEXT_ONLY
1) ААА Тех.отдел/1. ДЛЯ ДИРЕКТОРА (18.08)/В работу/1.0 Проект Шнековый транспортер/25.SHT - Заказ №2377 Промстрой/25.SHT.G.00.00.00.00 СБ Изм.5/25.SHT.G.00.00.00.00 СБ/Чертежи/Детали/25.SHT.G.04.00.00.02 Труба фланца.pdf | 8a6d6faa308bb658281cc5c0bad4cc685e883aeef17b444f3b3498b3bfe656d6 | 1 | True | 25.SHT.G.04.00.00.02 | Труба фланца |  | UNKNOWN |  |  | assembly_drawing | сборочная единица | MEDIUM | doc_type:assembly | INVENTORIED_TEXT_ONLY
1) ААА Тех.отдел/1. ДЛЯ ДИРЕКТОРА (18.08)/В работу/1.0 Проект Шнековый транспортер/25.SHT - Заказ №2377 Промстрой/25.SHT.G.00.00.00.00 СБ Изм.5/25.SHT.G.00.00.00.00 СБ/Чертежи/Детали/25.SHT.G.05.00.00.01 Труба фланца.pdf | 5cf2333f7ab354d1aab2de3bb290fef86105cbbb7522923932d2b23527638400 | 1 | True | 25.SHT.G.05.00.00.01 | Труба фланца |  | UNKNOWN |  |  | assembly_drawing | сборочная единица | MEDIUM | doc_type:assembly | INVENTORIED_TEXT_ONLY
1) ААА Тех.отдел/1. ДЛЯ ДИРЕКТОРА (18.08)/В работу/1.0 Проект Шнековый транспортер/25.SHT - Заказ №2377 Промстрой/25.SHT.G.00.00.00.00 СБ Изм.5/25.SHT.G.00.00.00.00 СБ/Чертежи/Детали/25.SHT.G.08.00.00.01 Уголок.pdf | c38b7583aeead0e024bb9a800644a1f471117e77f58c99b7d720a4740abc9e29 | 1 | True | 25.SHT.G.08.00.00.01 | Уголок |  | UNKNOWN |  |  | assembly_drawing | сборочная единица | MEDIUM | doc_type:assembly | INVENTORIED_TEXT_ONLY
1) ААА Тех.отдел/1. ДЛЯ ДИРЕКТОРА (18.08)/В работу/1.0 Проект Шнековый транспортер/25.SHT - Заказ №2377 Промстрой/25.SHT.G.00.00.00.00 СБ Изм.5/25.SHT.G.00.00.00.00 СБ/Чертежи/Детали/25.SHT.G.08.00.00.02 Уголок.pdf | 1faede4f36db5175e2fe17d95e1215e8b93f0c48c1cde15ef84152ce68a31abb | 1 | True | 25.SHT.G.08.00.00.02 | Уголок |  | UNKNOWN |  |  | assembly_drawing | сборочная единица | MEDIUM | doc_type:assembly | INVENTORIED_TEXT_ONLY
1) ААА Тех.отдел/1. ДЛЯ ДИРЕКТОРА (18.08)/В работу/1.0 Проект Шнековый транспортер/25.SHT - Заказ №2377 Промстрой/25.SHT.G.00.00.00.00 СБ Изм.5/25.SHT.G.00.00.00.00 СБ/Чертежи/Детали/25.SHT.G.09.00.00.01 Перекладина.pdf | 31e9f8fed80cf88e1faccd1621cd73513a1a1f620de7c1230dd75b298e5d5eff | 1 | True | 25.SHT.G.09.00.00.01 | Перекладина |  | UNKNOWN |  |  | assembly_drawing | сборочная единица | MEDIUM | doc_type:assembly | INVENTORIED_TEXT_ONLY
1) ААА Тех.отдел/1. ДЛЯ ДИРЕКТОРА (18.08)/В работу/1.0 Проект Шнековый транспортер/25.SHT - Заказ №2377 Промстрой/25.SHT.G.00.00.00.00 СБ Изм.5/25.SHT.G.00.00.00.00 СБ/Чертежи/Детали/25.SHT.G.09.00.00.02 Пластина.pdf | 5ed8dffb443a8c58c3a8a19ed5b116c90ce2b562790bf166ab79caa429b82fc4 | 1 | True | 25.SHT.G.09.00.00.02 | Пластина |  | UNKNOWN |  |  | assembly_drawing | сборочная единица | MEDIUM | doc_type:assembly | INVENTORIED_TEXT_ONLY
1) ААА Тех.отдел/1. ДЛЯ ДИРЕКТОРА (18.08)/В работу/1.0 Проект Шнековый транспортер/25.SHT - Заказ №2377 Промстрой/25.SHT.G.00.00.00.00 СБ Изм.5/25.SHT.G.00.00.00.00 СБ/Чертежи/Детали/Лазерная резка 10 мм..pdf | 7730f92a74c9be8825d43a337555a92f18f86c74c133f4084071e4de05ae2551 | 1 | True | Лазерная | резка 10 мм. |  | UNKNOWN |  |  | assembly_drawing | сборочная единица | MEDIUM | doc_type:assembly | INVENTORIED_TEXT_ONLY
1) ААА Тех.отдел/1. ДЛЯ ДИРЕКТОРА (18.08)/В работу/1.0 Проект Шнековый транспортер/25.SHT - Заказ №2377 Промстрой/25.SHT.G.00.00.00.00 СБ Изм.5/25.SHT.G.00.00.00.00 СБ/Чертежи/Детали/Лазерная резка 3 мм..pdf | 86c701d19c35e1929c125bafe212e420e15b6932e9ea5d895ab672f6a022ec2d | 1 | True | Лазерная | резка 3 мм. | AISI 304 | CONFIRMED_IN_TEXT |  |  | assembly_drawing | сборочная единица | MEDIUM | doc_type:assembly | INVENTORIED_TEXT_ONLY
1) ААА Тех.отдел/1. ДЛЯ ДИРЕКТОРА (18.08)/В работу/1.0 Проект Шнековый транспортер/25.SHT - Заказ №2377 Промстрой/25.SHT.G.00.00.00.00 СБ Изм.5/25.SHT.G.00.00.00.00 СБ/Чертежи/Детали/Лазерная резка 6 мм. 2.pdf | 0c465435ffb2915636cf869e288e51c2ef423364361eb6e93a67885793118478 | 1 | True | Лазерная | резка 6 мм. 2 |  | UNKNOWN |  |  | assembly_drawing | сборочная единица | MEDIUM | doc_type:assembly | INVENTORIED_TEXT_ONLY
1) ААА Тех.отдел/1. ДЛЯ ДИРЕКТОРА (18.08)/В работу/1.0 Проект Шнековый транспортер/25.SHT - Заказ №2377 Промстрой/25.SHT.G.00.00.00.00 СБ Изм.5/25.SHT.G.00.00.00.00 СБ/Чертежи/Детали/Лазерная резка 6 мм. лист1.PDF | 2e34939c87dff80eb59723f41f55524b9cd7f533fe7ad1f2ca25ecc5427eb0e9 | 1 | True | Лазерная | резка 6 мм. лист1 |  | UNKNOWN |  |  | assembly_drawing | сборочная единица | MEDIUM | doc_type:assembly | INVENTORIED_TEXT_ONLY
1) ААА Тех.отдел/1. ДЛЯ ДИРЕКТОРА (18.08)/В работу/1.0 Проект Шнековый транспортер/25.SHT - Заказ №2377 Промстрой/25.SHT.G.00.00.00.00 СБ Изм.5/25.SHT.G.00.00.00.00 СБ/Чертежи/Детали/Лазерная резка 6 мм. лист2.PDF | 30d97e055a6e1c1febe347d650081dba862bfa9c1868b4c34bd13aea24bda7ba | 1 | True | Лазерная | резка 6 мм. лист2 |  | UNKNOWN |  |  | assembly_drawing | сборочная единица | MEDIUM | doc_type:assembly | INVENTORIED_TEXT_ONLY
1) ААА Тех.отдел/1. ДЛЯ ДИРЕКТОРА (18.08)/В работу/1.0 Проект Шнековый транспортер/25.SHT - Заказ №2377 Промстрой/25.SHT.G.00.00.00.00 СБ Изм.5/25.SHT.G.00.00.00.00 СБ/Чертежи/Заглушка.pdf | 4d771ad8e2ded35eb130638af04f172a076e277fb039a7b79c0c9ea55d8da43c | 1 | True | Заглушка |  |  | UNKNOWN |  |  | assembly_drawing | сборочная единица | MEDIUM | doc_type:assembly | INVENTORIED_TEXT_ONLY
1) ААА Тех.отдел/1. ДЛЯ ДИРЕКТОРА (18.08)/В работу/1.0 Проект Шнековый транспортер/25.SHT.G.00.00.00.00 СБ/25.SHT.G.02.00.00.00 СБ Шнек с осями.pdf | 726ed7b4a8b476a9d6a349f6ab698c8233acf006457a97c9dcd97961c3cb2dcd | 1 | True | 25.SHT.G.02.00.00.00 | СБ Шнек с осями | 09Г2С | CONFIRMED_IN_TEXT |  |  | assembly_drawing | сборочная единица | MEDIUM | doc_type:assembly | INVENTORIED_TEXT_ONLY
1) ААА Тех.отдел/1. ДЛЯ ДИРЕКТОРА (18.08)/В работу/1.0 Проект Шнековый транспортер/25.SHT.G.00.00.00.00 СБ/Вальцовка/25.SHT.G.00.00.00.00/25.SHT.G.00.00.00.01 Футеровка.pdf | 23a0b1c390b7bc06dca77e082a6ac0e56851a7b205f44c5409020c34c6d82441 | 1 | True | 25.SHT.G.00.00.00.01 | Футеровка |  | UNKNOWN |  |  | assembly_drawing | сборочная единица | MEDIUM | doc_type:assembly | INVENTORIED_TEXT_ONLY
1) ААА Тех.отдел/1. ДЛЯ ДИРЕКТОРА (18.08)/В работу/1.0 Проект Шнековый транспортер/25.SHT.G.00.00.00.00 СБ/Вальцовка/25.SHT.G.00.00.00.00/25.SHT.G.00.00.00.02 Футеровка.pdf | 1f84cf13d1aa5e3011e64d9d0b5ab592eaa325c3eb01cf00076076c21ff27d40 | 1 | True | 25.SHT.G.00.00.00.02 | Футеровка |  | UNKNOWN |  |  | assembly_drawing | сборочная единица | MEDIUM | doc_type:assembly | INVENTORIED_TEXT_ONLY
1) ААА Тех.отдел/1. ДЛЯ ДИРЕКТОРА (18.08)/В работу/1.0 Проект Шнековый транспортер/25.SHT.G.00.00.00.00 СБ/Вальцовка/25.SHT.G.00.00.00.00/25.SHT.G.01.00.00.01 Желоб выгрузки.pdf | 1641cb47f1e8be50cc5f3dc156834efbd0de8c153c1bc0e249d65afa3946525c | 1 | True | 25.SHT.G.01.00.00.01 | Желоб выгрузки |  | UNKNOWN |  |  | assembly_drawing | сборочная единица | MEDIUM | doc_type:assembly | INVENTORIED_TEXT_ONLY
1) ААА Тех.отдел/1. ДЛЯ ДИРЕКТОРА (18.08)/В работу/1.0 Проект Шнековый транспортер/25.SHT.G.00.00.00.00 СБ/Вальцовка/25.SHT.G.00.00.00.00/25.SHT.G.01.00.00.02, 25.SHT.G.01.00.00.03 Желоб.pdf | 8f1aba6a774604ab53e534474422c1c3a639b7c813b1a783a37132b7b65f8546 | 1 | True | 25.SHT.G.01.00.00.02, 25.SHT.G.01.00.00.03 Желоб |  |  | UNKNOWN |  |  | assembly_drawing | сборочная единица | MEDIUM | doc_type:assembly | INVENTORIED_TEXT_ONLY
1) ААА Тех.отдел/1. ДЛЯ ДИРЕКТОРА (18.08)/В работу/1.0 Проект Шнековый транспортер/25.SHT.G.00.00.00.00 СБ/Вальцовка/25.SHT.G.00.00.00.01 Футеровка.pdf | 23a0b1c390b7bc06dca77e082a6ac0e56851a7b205f44c5409020c34c6d82441 | 1 | True | 25.SHT.G.00.00.00.01 | Футеровка |  | UNKNOWN |  |  | assembly_drawing | сборочная единица | MEDIUM | doc_type:assembly | INVENTORIED_TEXT_ONLY
1) ААА Тех.отдел/1. ДЛЯ ДИРЕКТОРА (18.08)/В работу/1.0 Проект Шнековый транспортер/25.SHT.G.00.00.00.00 СБ/Вальцовка/25.SHT.G.00.00.00.02 Футеровка.pdf | 1f84cf13d1aa5e3011e64d9d0b5ab592eaa325c3eb01cf00076076c21ff27d40 | 1 | True | 25.SHT.G.00.00.00.02 | Футеровка |  | UNKNOWN |  |  | assembly_drawing | сборочная единица | MEDIUM | doc_type:assembly | INVENTORIED_TEXT_ONLY
1) ААА Тех.отдел/1. ДЛЯ ДИРЕКТОРА (18.08)/В работу/1.0 Проект Шнековый транспортер/25.SHT.G.00.00.00.00 СБ/Вальцовка/25.SHT.G.01.00.00.01 Желоб выгрузки.pdf | 1641cb47f1e8be50cc5f3dc156834efbd0de8c153c1bc0e249d65afa3946525c | 1 | True | 25.SHT.G.01.00.00.01 | Желоб выгрузки |  | UNKNOWN |  |  | assembly_drawing | сборочная единица | MEDIUM | doc_type:assembly | INVENTORIED_TEXT_ONLY
1) ААА Тех.отдел/1. ДЛЯ ДИРЕКТОРА (18.08)/В работу/1.0 Проект Шнековый транспортер/25.SHT.G.00.00.00.00 СБ/Вальцовка/25.SHT.G.01.00.00.02, 25.SHT.G.01.00.00.03 Желоб.pdf | 8f1aba6a774604ab53e534474422c1c3a639b7c813b1a783a37132b7b65f8546 | 1 | True | 25.SHT.G.01.00.00.02, 25.SHT.G.01.00.00.03 Желоб |  |  | UNKNOWN |  |  | assembly_drawing | сборочная единица | MEDIUM | doc_type:assembly | INVENTORIED_TEXT_ONLY
1) ААА Тех.отдел/1. ДЛЯ ДИРЕКТОРА (18.08)/В работу/1.0 Проект Шнековый транспортер/25.SHT.G.00.00.00.00 СБ/Гибка/25.SHT.G.00.00.00.00 Гибка/25.SHT.G.06.01.00.01 Пластина крышки.pdf | 06ad59c3d5793c8ff55cca90501b321961eef5a53be96ce3bec35bd4d002e41d | 1 | True | 25.SHT.G.06.01.00.01 | Пластина крышки |  | UNKNOWN |  |  | assembly_drawing | сборочная единица | MEDIUM | doc_type:assembly | INVENTORIED_TEXT_ONLY
1) ААА Тех.отдел/1. ДЛЯ ДИРЕКТОРА (18.08)/В работу/1.0 Проект Шнековый транспортер/25.SHT.G.00.00.00.00 СБ/Гибка/25.SHT.G.00.00.00.00 Гибка/25.SHT.G.07.01.00.01 Пластина крышки.pdf | 0815eba6f5da7d11b85a95aed28d1c9963cca37e731f6f8a2b8691fd4001a24d | 1 | True | 25.SHT.G.07.01.00.01 | Пластина крышки |  | UNKNOWN |  |  | assembly_drawing | сборочная единица | MEDIUM | doc_type:assembly | INVENTORIED_TEXT_ONLY
1) ААА Тех.отдел/1. ДЛЯ ДИРЕКТОРА (18.08)/В работу/1.0 Проект Шнековый транспортер/25.SHT.G.00.00.00.00 СБ/Гибка/25.SHT.G.06.01.00.01 Пластина крышки.pdf | 06ad59c3d5793c8ff55cca90501b321961eef5a53be96ce3bec35bd4d002e41d | 1 | True | 25.SHT.G.06.01.00.01 | Пластина крышки |  | UNKNOWN |  |  | assembly_drawing | сборочная единица | MEDIUM | doc_type:assembly | INVENTORIED_TEXT_ONLY
1) ААА Тех.отдел/1. ДЛЯ ДИРЕКТОРА (18.08)/В работу/1.0 Проект Шнековый транспортер/25.SHT.G.00.00.00.00 СБ/Гибка/25.SHT.G.07.01.00.01 Пластина крышки.pdf | 0815eba6f5da7d11b85a95aed28d1c9963cca37e731f6f8a2b8691fd4001a24d | 1 | True | 25.SHT.G.07.01.00.01 | Пластина крышки |  | UNKNOWN |  |  | assembly_drawing | сборочная единица | MEDIUM | doc_type:assembly | INVENTORIED_TEXT_ONLY
1) ААА Тех.отдел/1. ДЛЯ ДИРЕКТОРА (18.08)/В работу/1.0 Проект Шнековый транспортер/25.SHT.G.00.00.00.00 СБ/Детали/25.SHT.G.00.00.00.00 Фланцы.pdf | 696efadd6d126a78eb38c7630d00b46b030e3592b66445218e7831a96f2efb4c | 1 | True | 25.SHT.G.00.00.00.00 | Фланцы |  | UNKNOWN |  |  | assembly_drawing | сборочная единица | MEDIUM | doc_type:assembly | INVENTORIED_TEXT_ONLY
1) ААА Тех.отдел/1. ДЛЯ ДИРЕКТОРА (18.08)/В работу/1.0 Проект Шнековый транспортер/25.SHT.G.00.00.00.00 СБ/Детали/25.SHT.G.00.00.00.03 Резиновая прокладка к фланцам.pdf | a3a2423b717d5d99045948faab2a562eb8fe2ef3089f03a8c0cc8d47c8986f05 | 1 | True | 25.SHT.G.00.00.00.03 | Резиновая прокладка к фланцам |  | UNKNOWN |  |  | assembly_drawing | сборочная единица | MEDIUM | doc_type:assembly | INVENTORIED_TEXT_ONLY
1) ААА Тех.отдел/1. ДЛЯ ДИРЕКТОРА (18.08)/В работу/1.0 Проект Шнековый транспортер/25.SHT.G.00.00.00.00 СБ/Детали/25.SHT.G.00.00.00.04 Резина проставка под крышкой.pdf | cda8db95ee453a43373d8eba39d3ee66ae16956bc5ba3619abb8aac0dafc7ed5 | 1 | True | 25.SHT.G.00.00.00.04 | Резина проставка под крышкой | Резина | CONFIRMED_IN_TEXT |  |  | assembly_drawing | сборочная единица | MEDIUM | doc_type:assembly | INVENTORIED_TEXT_ONLY
1) ААА Тех.отдел/1. ДЛЯ ДИРЕКТОРА (18.08)/В работу/1.0 Проект Шнековый транспортер/25.SHT.G.00.00.00.00 СБ/Детали/25.SHT.G.00.00.00.05 Фланец наружний.pdf | 16076c1e44e3c1b0ae032d0a5eb7a7cf30494cdc9d8283eceb298c2a2169adee | 1 | True | 25.SHT.G.00.00.00.05 | Фланец наружний |  | UNKNOWN |  |  | assembly_drawing | сборочная единица | MEDIUM | doc_type:assembly | INVENTORIED_TEXT_ONLY
1) ААА Тех.отдел/1. ДЛЯ ДИРЕКТОРА (18.08)/В работу/1.0 Проект Шнековый транспортер/25.SHT.G.00.00.00.00 СБ/Детали/25.SHT.G.00.00.00.09 Резиновая проставка отсеков.pdf | 319d7b9cac83c68393b5997c7687bfd9598d22c8be71be8ee1d0551363f65f00 | 1 | True | 25.SHT.G.00.00.00.09 | Резиновая проставка отсеков | Резина | CONFIRMED_IN_TEXT |  |  | assembly_drawing | сборочная единица | MEDIUM | doc_type:assembly | INVENTORIED_TEXT_ONLY
1) ААА Тех.отдел/1. ДЛЯ ДИРЕКТОРА (18.08)/В работу/1.0 Проект Шнековый транспортер/25.SHT.G.00.00.00.00 СБ/Детали/25.SHT.G.01.00.00.04 Уголок.pdf | d8963b0233cf9a7b729d9b9099c569caca3826e8f8f235978f6b8e24c06d203b | 1 | True | 25.SHT.G.01.00.00.04 | Уголок |  | UNKNOWN |  |  | assembly_drawing | сборочная единица | MEDIUM | doc_type:assembly | INVENTORIED_TEXT_ONLY
1) ААА Тех.отдел/1. ДЛЯ ДИРЕКТОРА (18.08)/В работу/1.0 Проект Шнековый транспортер/25.SHT.G.00.00.00.00 СБ/Детали/25.SHT.G.01.00.00.10 Труба.pdf | e3750a142d9571d5ad1ae990fd110b0b572285c7aab3eefd0e7c9ff0cd3c6665 | 1 | True | 25.SHT.G.01.00.00.10 | Труба |  | UNKNOWN |  |  | assembly_drawing | сборочная единица | MEDIUM | doc_type:assembly | INVENTORIED_TEXT_ONLY
1) ААА Тех.отдел/1. ДЛЯ ДИРЕКТОРА (18.08)/В работу/1.0 Проект Шнековый транспортер/25.SHT.G.00.00.00.00 СБ/Детали/25.SHT.G.01.00.00.11 Труба.pdf | 909fa8dd10d2695da36a72c61a64b3ee130a0795defdce8df60c48577c36f61b | 1 | True | 25.SHT.G.01.00.00.11 | Труба |  | UNKNOWN |  |  | assembly_drawing | сборочная единица | MEDIUM | doc_type:assembly | INVENTORIED_TEXT_ONLY
1) ААА Тех.отдел/1. ДЛЯ ДИРЕКТОРА (18.08)/В работу/1.0 Проект Шнековый транспортер/25.SHT.G.00.00.00.00 СБ/Детали/25.SHT.G.02.00.00.04 Торец.pdf | 47e43877ce12ce5c9d4cc57e6d6bd371fba37160ec946663304760d664d2d0fc | 1 | True | 25.SHT.G.02.00.00.04 | Торец | 09Г2С | CONFIRMED_IN_TEXT |  |  | assembly_drawing | сборочная единица | MEDIUM | doc_type:assembly | INVENTORIED_TEXT_ONLY
1) ААА Тех.отдел/1. ДЛЯ ДИРЕКТОРА (18.08)/В работу/1.0 Проект Шнековый транспортер/25.SHT.G.00.00.00.00 СБ/Детали/25.SHT.G.03.00.00.04 Косынка.pdf | 7c33550c683862bd5fdedf0bdab4bca3bd33e9f623128183e3cfdc5f19c05a95 | 1 | True | 25.SHT.G.03.00.00.04 | Косынка |  | UNKNOWN |  |  | assembly_drawing | сборочная единица | MEDIUM | doc_type:assembly | INVENTORIED_TEXT_ONLY
1) ААА Тех.отдел/1. ДЛЯ ДИРЕКТОРА (18.08)/В работу/1.0 Проект Шнековый транспортер/25.SHT.G.00.00.00.00 СБ/Детали/25.SHT.G.04.00.00.02 Труба фланца.pdf | 8a6d6faa308bb658281cc5c0bad4cc685e883aeef17b444f3b3498b3bfe656d6 | 1 | True | 25.SHT.G.04.00.00.02 | Труба фланца |  | UNKNOWN |  |  | assembly_drawing | сборочная единица | MEDIUM | doc_type:assembly | INVENTORIED_TEXT_ONLY
1) ААА Тех.отдел/1. ДЛЯ ДИРЕКТОРА (18.08)/В работу/1.0 Проект Шнековый транспортер/25.SHT.G.00.00.00.00 СБ/Детали/25.SHT.G.05.00.00.01 Труба фланца.pdf | 5cf2333f7ab354d1aab2de3bb290fef86105cbbb7522923932d2b23527638400 | 1 | True | 25.SHT.G.05.00.00.01 | Труба фланца |  | UNKNOWN |  |  | assembly_drawing | сборочная единица | MEDIUM | doc_type:assembly | INVENTORIED_TEXT_ONLY
1) ААА Тех.отдел/1. ДЛЯ ДИРЕКТОРА (18.08)/В работу/1.0 Проект Шнековый транспортер/25.SHT.G.00.00.00.00 СБ/Детали/25.SHT.G.08.00.00.01 Уголок.pdf | c38b7583aeead0e024bb9a800644a1f471117e77f58c99b7d720a4740abc9e29 | 1 | True | 25.SHT.G.08.00.00.01 | Уголок |  | UNKNOWN |  |  | assembly_drawing | сборочная единица | MEDIUM | doc_type:assembly | INVENTORIED_TEXT_ONLY
1) ААА Тех.отдел/1. ДЛЯ ДИРЕКТОРА (18.08)/В работу/1.0 Проект Шнековый транспортер/25.SHT.G.00.00.00.00 СБ/Детали/25.SHT.G.08.00.00.02 Уголок.pdf | 1faede4f36db5175e2fe17d95e1215e8b93f0c48c1cde15ef84152ce68a31abb | 1 | True | 25.SHT.G.08.00.00.02 | Уголок |  | UNKNOWN |  |  | assembly_drawing | сборочная единица | MEDIUM | doc_type:assembly | INVENTORIED_TEXT_ONLY
1) ААА Тех.отдел/1. ДЛЯ ДИРЕКТОРА (18.08)/В работу/1.0 Проект Шнековый транспортер/25.SHT.G.00.00.00.00 СБ/Детали/25.SHT.G.09.00.00.01 Перекладина.pdf | 31e9f8fed80cf88e1faccd1621cd73513a1a1f620de7c1230dd75b298e5d5eff | 1 | True | 25.SHT.G.09.00.00.01 | Перекладина |  | UNKNOWN |  |  | assembly_drawing | сборочная единица | MEDIUM | doc_type:assembly | INVENTORIED_TEXT_ONLY
1) ААА Тех.отдел/1. ДЛЯ ДИРЕКТОРА (18.08)/В работу/1.0 Проект Шнековый транспортер/25.SHT.G.00.00.00.00 СБ/Детали/25.SHT.G.09.00.00.02 Пластина.pdf | 5ed8dffb443a8c58c3a8a19ed5b116c90ce2b562790bf166ab79caa429b82fc4 | 1 | True | 25.SHT.G.09.00.00.02 | Пластина |  | UNKNOWN |  |  | assembly_drawing | сборочная единица | MEDIUM | doc_type:assembly | INVENTORIED_TEXT_ONLY
1) ААА Тех.отдел/1. ДЛЯ ДИРЕКТОРА (18.08)/В работу/1.0 Проект Шнековый транспортер/25.SHT.G.00.00.00.00 СБ/Детали/Вальцовка/25.SHT.G.00.00.00.01 Футеровка.pdf | 23a0b1c390b7bc06dca77e082a6ac0e56851a7b205f44c5409020c34c6d82441 | 1 | True | 25.SHT.G.00.00.00.01 | Футеровка |  | UNKNOWN |  |  | assembly_drawing | сборочная единица | MEDIUM | doc_type:assembly | INVENTORIED_TEXT_ONLY
1) ААА Тех.отдел/1. ДЛЯ ДИРЕКТОРА (18.08)/В работу/1.0 Проект Шнековый транспортер/25.SHT.G.00.00.00.00 СБ/Детали/Вальцовка/25.SHT.G.00.00.00.02 Футеровка.pdf | 1f84cf13d1aa5e3011e64d9d0b5ab592eaa325c3eb01cf00076076c21ff27d40 | 1 | True | 25.SHT.G.00.00.00.02 | Футеровка |  | UNKNOWN |  |  | assembly_drawing | сборочная единица | MEDIUM | doc_type:assembly | INVENTORIED_TEXT_ONLY
1) ААА Тех.отдел/1. ДЛЯ ДИРЕКТОРА (18.08)/В работу/1.0 Проект Шнековый транспортер/25.SHT.G.00.00.00.00 СБ/Детали/Вальцовка/25.SHT.G.01.00.00.01 Желоб выгрузки.pdf | 1641cb47f1e8be50cc5f3dc156834efbd0de8c153c1bc0e249d65afa3946525c | 1 | True | 25.SHT.G.01.00.00.01 | Желоб выгрузки |  | UNKNOWN |  |  | assembly_drawing | сборочная единица | MEDIUM | doc_type:assembly | INVENTORIED_TEXT_ONLY
1) ААА Тех.отдел/1. ДЛЯ ДИРЕКТОРА (18.08)/В работу/1.0 Проект Шнековый транспортер/25.SHT.G.00.00.00.00 СБ/Детали/Вальцовка/25.SHT.G.01.00.00.02, 25.SHT.G.01.00.00.03 Желоб.pdf | 8f1aba6a774604ab53e534474422c1c3a639b7c813b1a783a37132b7b65f8546 | 1 | True | 25.SHT.G.01.00.00.02, 25.SHT.G.01.00.00.03 Желоб |  |  | UNKNOWN |  |  | assembly_drawing | сборочная единица | MEDIUM | doc_type:assembly | INVENTORIED_TEXT_ONLY
1) ААА Тех.отдел/1. ДЛЯ ДИРЕКТОРА (18.08)/В работу/1.0 Проект Шнековый транспортер/25.SHT.G.00.00.00.00 СБ/Детали/Гибка/25.SHT.G.06.01.00.01 Пластина крышки.pdf | 06ad59c3d5793c8ff55cca90501b321961eef5a53be96ce3bec35bd4d002e41d | 1 | True | 25.SHT.G.06.01.00.01 | Пластина крышки |  | UNKNOWN |  |  | assembly_drawing | сборочная единица | MEDIUM | doc_type:assembly | INVENTORIED_TEXT_ONLY
1) ААА Тех.отдел/1. ДЛЯ ДИРЕКТОРА (18.08)/В работу/1.0 Проект Шнековый транспортер/25.SHT.G.00.00.00.00 СБ/Детали/Гибка/25.SHT.G.07.01.00.01 Пластина крышки.pdf | 0815eba6f5da7d11b85a95aed28d1c9963cca37e731f6f8a2b8691fd4001a24d | 1 | True | 25.SHT.G.07.01.00.01 | Пластина крышки |  | UNKNOWN |  |  | assembly_drawing | сборочная единица | MEDIUM | doc_type:assembly | INVENTORIED_TEXT_ONLY
1) ААА Тех.отдел/1. ДЛЯ ДИРЕКТОРА (18.08)/В работу/1.0 Проект Шнековый транспортер/25.SHT.G.00.00.00.00 СБ/Детали/Лазерная резка 10 мм..pdf | 7730f92a74c9be8825d43a337555a92f18f86c74c133f4084071e4de05ae2551 | 1 | True | Лазерная | резка 10 мм. |  | UNKNOWN |  |  | assembly_drawing | сборочная единица | MEDIUM | doc_type:assembly | INVENTORIED_TEXT_ONLY
1) ААА Тех.отдел/1. ДЛЯ ДИРЕКТОРА (18.08)/В работу/1.0 Проект Шнековый транспортер/25.SHT.G.00.00.00.00 СБ/Детали/Лазерная резка 3 мм..pdf | 86c701d19c35e1929c125bafe212e420e15b6932e9ea5d895ab672f6a022ec2d | 1 | True | Лазерная | резка 3 мм. | AISI 304 | CONFIRMED_IN_TEXT |  |  | assembly_drawing | сборочная единица | MEDIUM | doc_type:assembly | INVENTORIED_TEXT_ONLY
1) ААА Тех.отдел/1. ДЛЯ ДИРЕКТОРА (18.08)/В работу/1.0 Проект Шнековый транспортер/25.SHT.G.00.00.00.00 СБ/Детали/Лазерная резка 6 мм. 2.pdf | 0c465435ffb2915636cf869e288e51c2ef423364361eb6e93a67885793118478 | 1 | True | Лазерная | резка 6 мм. 2 |  | UNKNOWN |  |  | assembly_drawing | сборочная единица | MEDIUM | doc_type:assembly | INVENTORIED_TEXT_ONLY
1) ААА Тех.отдел/1. ДЛЯ ДИРЕКТОРА (18.08)/В работу/1.0 Проект Шнековый транспортер/25.SHT.G.00.00.00.00 СБ/Детали/Лазерная резка 6 мм. лист1.PDF | 2e34939c87dff80eb59723f41f55524b9cd7f533fe7ad1f2ca25ecc5427eb0e9 | 1 | True | Лазерная | резка 6 мм. лист1 |  | UNKNOWN |  |  | assembly_drawing | сборочная единица | MEDIUM | doc_type:assembly | INVENTORIED_TEXT_ONLY
1) ААА Тех.отдел/1. ДЛЯ ДИРЕКТОРА (18.08)/В работу/1.0 Проект Шнековый транспортер/25.SHT.G.00.00.00.00 СБ/Детали/Лазерная резка 6 мм. лист2.PDF | 30d97e055a6e1c1febe347d650081dba862bfa9c1868b4c34bd13aea24bda7ba | 1 | True | Лазерная | резка 6 мм. лист2 |  | UNKNOWN |  |  | assembly_drawing | сборочная единица | MEDIUM | doc_type:assembly | INVENTORIED_TEXT_ONLY
1) ААА Тех.отдел/1. ДЛЯ ДИРЕКТОРА (18.08)/В работу/1.0 Проект Шнековый транспортер/25.SHT.G.00.00.00.00 СБ/Заглушка.pdf | 4d771ad8e2ded35eb130638af04f172a076e277fb039a7b79c0c9ea55d8da43c | 1 | True | Заглушка |  |  | UNKNOWN |  |  | assembly_drawing | сборочная единица | MEDIUM | doc_type:assembly | INVENTORIED_TEXT_ONLY
1) ААА Тех.отдел/1. ДЛЯ ДИРЕКТОРА (18.08)/В работу/1.0 Проект Шнековый транспортер/25.SHT.G.00.00.00.00 СБ/Сборки/25.SHT.G.00.00.00.00 СБ Транспортер.pdf | e846591cb097e4049e33366c3bb24fa612e88654e606288638fc15a6cbe9eec0 | 3 | True | 25.SHT.G.00.00.00.00 | СБ Транспортер | Сталь 45 | CONFIRMED_IN_TEXT |  |  | assembly_drawing | сборочная единица | MEDIUM | doc_type:assembly | INVENTORIED_TEXT_ONLY
1) ААА Тех.отдел/1. ДЛЯ ДИРЕКТОРА (18.08)/В работу/1.0 Проект Шнековый транспортер/25.SHT.G.00.00.00.00 СБ/Сборки/25.SHT.G.01.00.00.00 СБ Отсек (сварка).PDF | 1818ad45865a67531e9a695a133a1fd5b12a700f1f6c94e7b7bc9c0ef7601877 | 2 | True | 25.SHT.G.01.00.00.00 | СБ Отсек (сварка) | AISI 304 | CONFIRMED_IN_TEXT |  |  | assembly_drawing | сборочная единица | MEDIUM | doc_type:assembly | INVENTORIED_TEXT_ONLY
1) ААА Тех.отдел/1. ДЛЯ ДИРЕКТОРА (18.08)/В работу/1.0 Проект Шнековый транспортер/25.SHT.G.00.00.00.00 СБ/Сборки/25.SHT.G.01.00.00.00 СБ Отсек.pdf | d0f227986fac0fb3aaa531463e10e798443dd2e4b82163cbec87fec1df5151be | 1 | True | 25.SHT.G.01.00.00.00 | СБ Отсек | AISI 304 | CONFIRMED_IN_TEXT |  |  | assembly_drawing | сборочная единица | MEDIUM | doc_type:assembly | INVENTORIED_TEXT_ONLY
1) ААА Тех.отдел/1. ДЛЯ ДИРЕКТОРА (18.08)/В работу/1.0 Проект Шнековый транспортер/25.SHT.G.00.00.00.00 СБ/Сборки/25.SHT.G.01.01.00.00 СБ Опора.pdf | a6ffb7bc7fb51eb298decd8a9ce064f50c11c35f08c7706aabc936e51e5e037c | 1 | True | 25.SHT.G.01.01.00.00 | СБ Опора | AISI 304 | CONFIRMED_IN_TEXT |  |  | assembly_drawing | сборочная единица | MEDIUM | doc_type:assembly | INVENTORIED_TEXT_ONLY
1) ААА Тех.отдел/1. ДЛЯ ДИРЕКТОРА (18.08)/В работу/1.0 Проект Шнековый транспортер/25.SHT.G.00.00.00.00 СБ/Сборки/25.SHT.G.02.00.00.00 СБ Шнек с осями.pdf | 726ed7b4a8b476a9d6a349f6ab698c8233acf006457a97c9dcd97961c3cb2dcd | 1 | True | 25.SHT.G.02.00.00.00 | СБ Шнек с осями | 09Г2С | CONFIRMED_IN_TEXT |  |  | assembly_drawing | сборочная единица | MEDIUM | doc_type:assembly | INVENTORIED_TEXT_ONLY
1) ААА Тех.отдел/1. ДЛЯ ДИРЕКТОРА (18.08)/В работу/1.0 Проект Шнековый транспортер/25.SHT.G.00.00.00.00 СБ/Сборки/25.SHT.G.03.00.00.00 СБ Фланец.pdf | 48dc27d7a0ab7a036ce8f2e147e8ac5429f1f4fe4689dd30cf8f0fa4af36b63f | 1 | True | 25.SHT.G.03.00.00.00 | СБ Фланец | AISI 304 | CONFIRMED_IN_TEXT |  |  | assembly_drawing | сборочная единица | MEDIUM | doc_type:assembly | INVENTORIED_TEXT_ONLY
1) ААА Тех.отдел/1. ДЛЯ ДИРЕКТОРА (18.08)/В работу/1.0 Проект Шнековый транспортер/25.SHT.G.00.00.00.00 СБ/Сборки/25.SHT.G.04.00.00.00 СБ Фланец изм.1.pdf | 86f4219e59ff0812acd496aad9b9878668cd72d42afbd81091931f0be3080f7b | 1 | True | 25.SHT.G.04.00.00.00 | СБ Фланец изм.1 | AISI 304 | CONFIRMED_IN_TEXT |  |  | assembly_drawing | сборочная единица | MEDIUM | doc_type:assembly | INVENTORIED_TEXT_ONLY
1) ААА Тех.отдел/1. ДЛЯ ДИРЕКТОРА (18.08)/В работу/1.0 Проект Шнековый транспортер/25.SHT.G.00.00.00.00 СБ/Сборки/25.SHT.G.04.00.00.00 СБ Фланец.pdf | 6dc534ce71966e10c5f043fd5819ae683d69690bb63387612620d521781ace9e | 1 | True | 25.SHT.G.04.00.00.00 | СБ Фланец | AISI 304 | CONFIRMED_IN_TEXT |  |  | assembly_drawing | сборочная единица | MEDIUM | doc_type:assembly | INVENTORIED_TEXT_ONLY
1) ААА Тех.отдел/1. ДЛЯ ДИРЕКТОРА (18.08)/В работу/1.0 Проект Шнековый транспортер/25.SHT.G.00.00.00.00 СБ/Сборки/25.SHT.G.05.00.00.00 СБ Фланец соединительный.pdf | e48c03956c8f8cadc80b2468beab807384b41e286aed6e41717d69849fbd1996 | 1 | True | 25.SHT.G.05.00.00.00 | СБ Фланец соединительный | AISI 304 | CONFIRMED_IN_TEXT |  |  | assembly_drawing | сборочная единица | MEDIUM | doc_type:assembly | INVENTORIED_TEXT_ONLY
1) ААА Тех.отдел/1. ДЛЯ ДИРЕКТОРА (18.08)/В работу/1.0 Проект Шнековый транспортер/25.SHT.G.00.00.00.00 СБ/Сборки/25.SHT.G.06.00.00.00 СБ Крышка.pdf | c5e193ee5119ac25dfd5d6cace872d5654dcecf0059ea807b0e7bb72ed4b4133 | 1 | True | 25.SHT.G.06.00.00.00 | СБ Крышка |  | UNKNOWN |  |  | assembly_drawing | сборочная единица | MEDIUM | doc_type:assembly | INVENTORIED_TEXT_ONLY
1) ААА Тех.отдел/1. ДЛЯ ДИРЕКТОРА (18.08)/В работу/1.0 Проект Шнековый транспортер/25.SHT.G.00.00.00.00 СБ/Сборки/25.SHT.G.06.01.00.00 СБ Крышка.pdf | b7fbcd1f8bce7b14565ef0484b68cf62c96b9c8a45ce355e817692c45314e856 | 1 | True | 25.SHT.G.06.01.00.00 | СБ Крышка | AISI 304 | CONFIRMED_IN_TEXT |  |  | assembly_drawing | сборочная единица | MEDIUM | doc_type:assembly | INVENTORIED_TEXT_ONLY
1) ААА Тех.отдел/1. ДЛЯ ДИРЕКТОРА (18.08)/В работу/1.0 Проект Шнековый транспортер/25.SHT.G.00.00.00.00 СБ/Сборки/25.SHT.G.07.01.00.00 СБ Крышка.pdf | b3f04eead900b75a3e61a53015e075b6beed9fea38383b0cdf06fdbf472e2b21 | 1 | True | 25.SHT.G.07.01.00.00 | СБ Крышка | AISI 304 | CONFIRMED_IN_TEXT |  |  | assembly_drawing | сборочная единица | MEDIUM | doc_type:assembly | INVENTORIED_TEXT_ONLY
1) ААА Тех.отдел/1. ДЛЯ ДИРЕКТОРА (18.08)/В работу/1.0 Проект Шнековый транспортер/25.SHT.G.00.00.00.00 СБ/Сборки/25.SHT.G.08.00.00.00 СБ Опора.pdf | 9520b6a5aeb1859084c7dde19ce8b834dcc2237b9b0b64f74fb4fb58f760aeaf | 1 | True | 25.SHT.G.08.00.00.00 | СБ Опора | AISI 304 | CONFIRMED_IN_TEXT |  |  | assembly_drawing | сборочная единица | MEDIUM | doc_type:assembly | INVENTORIED_TEXT_ONLY
1) ААА Тех.отдел/1. ДЛЯ ДИРЕКТОРА (18.08)/В работу/1.0 Проект Шнековый транспортер/25.SHT.G.00.00.00.00 СБ/Сборки/25.SHT.G.09.00.00.00 СБ Перекладина съемная.pdf | 77f01d126d30745abf3ab121ed63e8fefb707cdd658e46852086a2d84e5252bb | 1 | True | 25.SHT.G.09.00.00.00 | СБ Перекладина съемная | AISI 304 | CONFIRMED_IN_TEXT |  |  | assembly_drawing | сборочная единица | MEDIUM | doc_type:assembly | INVENTORIED_TEXT_ONLY
1) ААА Тех.отдел/1. ДЛЯ ДИРЕКТОРА (18.08)/В работу/24.SHT.G.00.00.00.00/24.SHT.G.00.00.00.00 СБ/24.SHT.G.00.00.00.00 СБ/324011 - 00 - 03-01-1.14-24066-01078-ОТР.А71(SRC-702).pdf | 9222864ae138c92ddf56cf485a91348798ffb115a3deef5fcf3fc1f9aa5b3598 | 7 | True | 324011 | - 00 - 03-01-1.14-24066-01078-ОТР.А71(SRC-702) |  | UNKNOWN |  |  | assembly_drawing | сборочная единица | MEDIUM | doc_type:assembly | INVENTORIED_TEXT_ONLY
1) ААА Тех.отдел/1. ДЛЯ ДИРЕКТОРА (18.08)/В работу/24.SHT.G.00.00.00.00/24.SHT.G.00.00.00.00 СБ/24.SHT.G.00.00.00.00 СБ/SHT-G-12.4-L3710 СБ 'Лист согласования'.pdf | 8621ea646a9c32fdac999f9344fbcccbfb9e7e1b3042779a83122e66121cab4b | 1 | True | SHT-G-12.4-L3710 | СБ 'Лист согласования | Ст3 | CONFIRMED_IN_TEXT |  |  | service_document | служебный документ | MEDIUM | doc_type:service | INVENTORIED_TEXT_ONLY
1) ААА Тех.отдел/1. ДЛЯ ДИРЕКТОРА (18.08)/В работу/24.SHT.G.00.00.00.00/24.SHT.G.00.00.00.00 СБ/24.SHT.G.00.00.00.00 СБ/SHT-G-PV12.4-L4810/SHT-G-12.4-L4810 - 2 СБ.PDF | dd2fdb002876c5121e30a8edbff681f9a6d162d17399f0decba7a175dd6cf40b | 1 | True | SHT-G-12.4-L4810 | - 2 СБ | Ст3 | CONFIRMED_IN_TEXT |  |  | assembly_drawing | сборочная единица | MEDIUM | doc_type:assembly | INVENTORIED_TEXT_ONLY
1) ААА Тех.отдел/1. ДЛЯ ДИРЕКТОРА (18.08)/В работу/24.SHT.G.00.00.00.00/24.SHT.G.00.00.00.00 СБ/24.SHT.G.00.00.00.00 СБ/SHT-G-PV12.4-L4810/SHT-G-12.4-L4810 - 3 СБ.PDF | 6e323299adb1cf718aa0af66f537ab4d47a5e4fadd0f86a7350238d34d26e7c7 | 1 | True | SHT-G-12.4-L4810 | - 3 СБ | Ст3 | CONFIRMED_IN_TEXT |  |  | assembly_drawing | сборочная единица | MEDIUM | doc_type:assembly | INVENTORIED_TEXT_ONLY
1) ААА Тех.отдел/1. ДЛЯ ДИРЕКТОРА (18.08)/В работу/24.SHT.G.00.00.00.00/24.SHT.G.00.00.00.00 СБ/24.SHT.G.00.00.00.00 СБ/SHT-G-PV12.4-L4810/SHT-G-12.4-L4810 СБ 'Лист согласования'.PDF | 90beb236cd3bec8faeef6f9b7c9697d982e4297b8429f2ac355c20746c42704c | 1 | True | SHT-G-12.4-L4810 | СБ 'Лист согласования | Ст3 | CONFIRMED_IN_TEXT |  |  | service_document | служебный документ | MEDIUM | doc_type:service | INVENTORIED_TEXT_ONLY
1) ААА Тех.отдел/1. ДЛЯ ДИРЕКТОРА (18.08)/В работу/24.SHT.G.00.00.00.00/24.SHT.G.00.00.00.00 СБ/24.SHT.G.00.00.00.00 СБ/Доработка 02.07.2025/SHT-G-12.4-L3710 СБ 'Лист согласования'.pdf | d57f62a10685b4338f6877576973dba45832c5fb692a2b2f9a8743a1db10b640 | 1 | True | SHT-G-12.4-L3710 | СБ 'Лист согласования | Ст3 | CONFIRMED_IN_TEXT |  |  | service_document | служебный документ | MEDIUM | doc_type:service | INVENTORIED_TEXT_ONLY
1) ААА Тех.отдел/1. ДЛЯ ДИРЕКТОРА (18.08)/В работу/24.SHT.G.00.00.00.00/24.SHT.G.00.00.00.00 СБ/24.SHT.G.00.00.00.00 СБ/спец/24.SHT.G.00.00.00.00 СБ - 1.pdf | b632d79ee586962374a51991aa1db610f47b4b4a0fcff44ad98b01e08589e59f | 1 | True | 24.SHT.G.00.00.00.00 | СБ - 1 |  | UNKNOWN |  |  | assembly_drawing | сборочная единица | MEDIUM | doc_type:assembly | INVENTORIED_TEXT_ONLY
1) ААА Тех.отдел/1. ДЛЯ ДИРЕКТОРА (18.08)/В работу/24.SHT.G.00.00.00.00/24.SHT.G.00.00.00.00 СБ/24.SHT.G.00.00.00.00 СБ/спец/24.SHT.G.00.00.00.00 СБ - 2.PDF | 32cebc887a9b31884e1a1b06312150067c4bd943ac136c0ec4ffba1bccc7fe4d | 1 | True | 24.SHT.G.00.00.00.00 | СБ - 2 | Ст3 | CONFIRMED_IN_TEXT |  |  | assembly_drawing | сборочная единица | MEDIUM | doc_type:assembly | INVENTORIED_TEXT_ONLY
1) ААА Тех.отдел/1. ДЛЯ ДИРЕКТОРА (18.08)/В работу/24.SHT.G.00.00.00.00/24.SHT.G.00.00.00.00 СБ/324011 - 00 - 03-01-1.14-24066-01078-ОТР.А71(SRC-702).pdf | 9222864ae138c92ddf56cf485a91348798ffb115a3deef5fcf3fc1f9aa5b3598 | 7 | True | 324011 | - 00 - 03-01-1.14-24066-01078-ОТР.А71(SRC-702) |  | UNKNOWN |  |  | assembly_drawing | сборочная единица | MEDIUM | doc_type:assembly | INVENTORIED_TEXT_ONLY
1) ААА Тех.отдел/1. ДЛЯ ДИРЕКТОРА (18.08)/В работу/24.SHT.G.00.00.00.00/24.SHT.G.00.00.00.00 СБ/SHT-G-12.4-L3710 СБ 'Лист согласования'.pdf | 8621ea646a9c32fdac999f9344fbcccbfb9e7e1b3042779a83122e66121cab4b | 1 | True | SHT-G-12.4-L3710 | СБ 'Лист согласования | Ст3 | CONFIRMED_IN_TEXT |  |  | service_document | служебный документ | MEDIUM | doc_type:service | INVENTORIED_TEXT_ONLY
1) ААА Тех.отдел/1. ДЛЯ ДИРЕКТОРА (18.08)/В работу/24.SHT.G.00.00.00.00/24.SHT.G.00.00.00.00 СБ/SHT-G-PV12.4-L4810/SHT-G-12.4-L4810 - 2 СБ.PDF | dd2fdb002876c5121e30a8edbff681f9a6d162d17399f0decba7a175dd6cf40b | 1 | True | SHT-G-12.4-L4810 | - 2 СБ | Ст3 | CONFIRMED_IN_TEXT |  |  | assembly_drawing | сборочная единица | MEDIUM | doc_type:assembly | INVENTORIED_TEXT_ONLY
1) ААА Тех.отдел/1. ДЛЯ ДИРЕКТОРА (18.08)/В работу/24.SHT.G.00.00.00.00/24.SHT.G.00.00.00.00 СБ/SHT-G-PV12.4-L4810/SHT-G-12.4-L4810 - 3 СБ.PDF | 6e323299adb1cf718aa0af66f537ab4d47a5e4fadd0f86a7350238d34d26e7c7 | 1 | True | SHT-G-12.4-L4810 | - 3 СБ | Ст3 | CONFIRMED_IN_TEXT |  |  | assembly_drawing | сборочная единица | MEDIUM | doc_type:assembly | INVENTORIED_TEXT_ONLY
1) ААА Тех.отдел/1. ДЛЯ ДИРЕКТОРА (18.08)/В работу/24.SHT.G.00.00.00.00/24.SHT.G.00.00.00.00 СБ/SHT-G-PV12.4-L4810/SHT-G-12.4-L4810 СБ 'Лист согласования'.PDF | 90beb236cd3bec8faeef6f9b7c9697d982e4297b8429f2ac355c20746c42704c | 1 | True | SHT-G-12.4-L4810 | СБ 'Лист согласования | Ст3 | CONFIRMED_IN_TEXT |  |  | service_document | служебный документ | MEDIUM | doc_type:service | INVENTORIED_TEXT_ONLY
1) ААА Тех.отдел/1. ДЛЯ ДИРЕКТОРА (18.08)/В работу/24.SHT.G.00.00.00.00/24.SHT.G.00.00.00.00 СБ/Доработка 02.07.2025/SHT-G-12.4-L3710 СБ 'Лист согласования'.pdf | d57f62a10685b4338f6877576973dba45832c5fb692a2b2f9a8743a1db10b640 | 1 | True | SHT-G-12.4-L3710 | СБ 'Лист согласования | Ст3 | CONFIRMED_IN_TEXT |  |  | service_document | служебный документ | MEDIUM | doc_type:service | INVENTORIED_TEXT_ONLY
1) ААА Тех.отдел/1. ДЛЯ ДИРЕКТОРА (18.08)/В работу/25.SHT.G.00.00.00.00/25.SHT - Заказ №2377 Промстрой/25.SHT.G.00.00.00.00 СБ Изм.5/25.SHT.G.00.00.00.00 СБ/SHT-PV2-L3000 изм 1.pdf | e579abb4af61838042f2f83e57f7f2d6909da6b248c88dd4a00fa7b7d292dbcc | 1 | True | SHT-PV2-L3000 | изм 1 | 09Г2С | CONFIRMED_IN_TEXT |  |  | assembly_drawing | сборочная единица | MEDIUM | doc_type:assembly | INVENTORIED_TEXT_ONLY
1) ААА Тех.отдел/1. ДЛЯ ДИРЕКТОРА (18.08)/В работу/25.SHT.G.00.00.00.00/25.SHT - Заказ №2377 Промстрой/25.SHT.G.00.00.00.00 СБ Изм.5/25.SHT.G.00.00.00.00 СБ/Чертежи/25.SHT.G.02.00.00.00 СБ Шнек с осями.pdf | 726ed7b4a8b476a9d6a349f6ab698c8233acf006457a97c9dcd97961c3cb2dcd | 1 | True | 25.SHT.G.02.00.00.00 | СБ Шнек с осями | 09Г2С | CONFIRMED_IN_TEXT |  |  | assembly_drawing | сборочная единица | MEDIUM | doc_type:assembly | INVENTORIED_TEXT_ONLY
1) ААА Тех.отдел/1. ДЛЯ ДИРЕКТОРА (18.08)/В работу/25.SHT.G.00.00.00.00/25.SHT - Заказ №2377 Промстрой/25.SHT.G.00.00.00.00 СБ Изм.5/25.SHT.G.00.00.00.00 СБ/Чертежи/Вальцовка/25.SHT.G.00.00.00.00/25.SHT.G.00.00.00.01 Футеровка.pdf | 23a0b1c390b7bc06dca77e082a6ac0e56851a7b205f44c5409020c34c6d82441 | 1 | True | 25.SHT.G.00.00.00.01 | Футеровка |  | UNKNOWN |  |  | assembly_drawing | сборочная единица | MEDIUM | doc_type:assembly | INVENTORIED_TEXT_ONLY
1) ААА Тех.отдел/1. ДЛЯ ДИРЕКТОРА (18.08)/В работу/25.SHT.G.00.00.00.00/25.SHT - Заказ №2377 Промстрой/25.SHT.G.00.00.00.00 СБ Изм.5/25.SHT.G.00.00.00.00 СБ/Чертежи/Вальцовка/25.SHT.G.00.00.00.00/25.SHT.G.00.00.00.02 Футеровка.pdf | 1f84cf13d1aa5e3011e64d9d0b5ab592eaa325c3eb01cf00076076c21ff27d40 | 1 | True | 25.SHT.G.00.00.00.02 | Футеровка |  | UNKNOWN |  |  | assembly_drawing | сборочная единица | MEDIUM | doc_type:assembly | INVENTORIED_TEXT_ONLY
1) ААА Тех.отдел/1. ДЛЯ ДИРЕКТОРА (18.08)/В работу/25.SHT.G.00.00.00.00/25.SHT - Заказ №2377 Промстрой/25.SHT.G.00.00.00.00 СБ Изм.5/25.SHT.G.00.00.00.00 СБ/Чертежи/Вальцовка/25.SHT.G.00.00.00.00/25.SHT.G.01.00.00.01 Желоб выгрузки.pdf | 1641cb47f1e8be50cc5f3dc156834efbd0de8c153c1bc0e249d65afa3946525c | 1 | True | 25.SHT.G.01.00.00.01 | Желоб выгрузки |  | UNKNOWN |  |  | assembly_drawing | сборочная единица | MEDIUM | doc_type:assembly | INVENTORIED_TEXT_ONLY
1) ААА Тех.отдел/1. ДЛЯ ДИРЕКТОРА (18.08)/В работу/25.SHT.G.00.00.00.00/25.SHT - Заказ №2377 Промстрой/25.SHT.G.00.00.00.00 СБ Изм.5/25.SHT.G.00.00.00.00 СБ/Чертежи/Вальцовка/25.SHT.G.00.00.00.00/25.SHT.G.01.00.00.02, 25.SHT.G.01.00.00.03 Желоб.pdf | 8f1aba6a774604ab53e534474422c1c3a639b7c813b1a783a37132b7b65f8546 | 1 | True | 25.SHT.G.01.00.00.02, 25.SHT.G.01.00.00.03 Желоб |  |  | UNKNOWN |  |  | assembly_drawing | сборочная единица | MEDIUM | doc_type:assembly | INVENTORIED_TEXT_ONLY
1) ААА Тех.отдел/1. ДЛЯ ДИРЕКТОРА (18.08)/В работу/25.SHT.G.00.00.00.00/25.SHT - Заказ №2377 Промстрой/25.SHT.G.00.00.00.00 СБ Изм.5/25.SHT.G.00.00.00.00 СБ/Чертежи/Вальцовка/25.SHT.G.00.00.00.01 Футеровка.pdf | 23a0b1c390b7bc06dca77e082a6ac0e56851a7b205f44c5409020c34c6d82441 | 1 | True | 25.SHT.G.00.00.00.01 | Футеровка |  | UNKNOWN |  |  | assembly_drawing | сборочная единица | MEDIUM | doc_type:assembly | INVENTORIED_TEXT_ONLY
1) ААА Тех.отдел/1. ДЛЯ ДИРЕКТОРА (18.08)/В работу/25.SHT.G.00.00.00.00/25.SHT - Заказ №2377 Промстрой/25.SHT.G.00.00.00.00 СБ Изм.5/25.SHT.G.00.00.00.00 СБ/Чертежи/Вальцовка/25.SHT.G.00.00.00.02 Футеровка.pdf | 1f84cf13d1aa5e3011e64d9d0b5ab592eaa325c3eb01cf00076076c21ff27d40 | 1 | True | 25.SHT.G.00.00.00.02 | Футеровка |  | UNKNOWN |  |  | assembly_drawing | сборочная единица | MEDIUM | doc_type:assembly | INVENTORIED_TEXT_ONLY
1) ААА Тех.отдел/1. ДЛЯ ДИРЕКТОРА (18.08)/В работу/25.SHT.G.00.00.00.00/25.SHT - Заказ №2377 Промстрой/25.SHT.G.00.00.00.00 СБ Изм.5/25.SHT.G.00.00.00.00 СБ/Чертежи/Вальцовка/25.SHT.G.01.00.00.01 Желоб выгрузки.pdf | 1641cb47f1e8be50cc5f3dc156834efbd0de8c153c1bc0e249d65afa3946525c | 1 | True | 25.SHT.G.01.00.00.01 | Желоб выгрузки |  | UNKNOWN |  |  | assembly_drawing | сборочная единица | MEDIUM | doc_type:assembly | INVENTORIED_TEXT_ONLY
1) ААА Тех.отдел/1. ДЛЯ ДИРЕКТОРА (18.08)/В работу/25.SHT.G.00.00.00.00/25.SHT - Заказ №2377 Промстрой/25.SHT.G.00.00.00.00 СБ Изм.5/25.SHT.G.00.00.00.00 СБ/Чертежи/Вальцовка/25.SHT.G.01.00.00.02, 25.SHT.G.01.00.00.03 Желоб.pdf | 8f1aba6a774604ab53e534474422c1c3a639b7c813b1a783a37132b7b65f8546 | 1 | True | 25.SHT.G.01.00.00.02, 25.SHT.G.01.00.00.03 Желоб |  |  | UNKNOWN |  |  | assembly_drawing | сборочная единица | MEDIUM | doc_type:assembly | INVENTORIED_TEXT_ONLY
1) ААА Тех.отдел/1. ДЛЯ ДИРЕКТОРА (18.08)/В работу/25.SHT.G.00.00.00.00/25.SHT - Заказ №2377 Промстрой/25.SHT.G.00.00.00.00 СБ Изм.5/25.SHT.G.00.00.00.00 СБ/Чертежи/Гибка/25.SHT.G.00.00.00.00 Гибка/25.SHT.G.06.01.00.01 Пластина крышки.pdf | 06ad59c3d5793c8ff55cca90501b321961eef5a53be96ce3bec35bd4d002e41d | 1 | True | 25.SHT.G.06.01.00.01 | Пластина крышки |  | UNKNOWN |  |  | assembly_drawing | сборочная единица | MEDIUM | doc_type:assembly | INVENTORIED_TEXT_ONLY
1) ААА Тех.отдел/1. ДЛЯ ДИРЕКТОРА (18.08)/В работу/25.SHT.G.00.00.00.00/25.SHT - Заказ №2377 Промстрой/25.SHT.G.00.00.00.00 СБ Изм.5/25.SHT.G.00.00.00.00 СБ/Чертежи/Гибка/25.SHT.G.00.00.00.00 Гибка/25.SHT.G.07.01.00.01 Пластина крышки.pdf | 0815eba6f5da7d11b85a95aed28d1c9963cca37e731f6f8a2b8691fd4001a24d | 1 | True | 25.SHT.G.07.01.00.01 | Пластина крышки |  | UNKNOWN |  |  | assembly_drawing | сборочная единица | MEDIUM | doc_type:assembly | INVENTORIED_TEXT_ONLY
1) ААА Тех.отдел/1. ДЛЯ ДИРЕКТОРА (18.08)/В работу/25.SHT.G.00.00.00.00/25.SHT - Заказ №2377 Промстрой/25.SHT.G.00.00.00.00 СБ Изм.5/25.SHT.G.00.00.00.00 СБ/Чертежи/Гибка/25.SHT.G.06.01.00.01 Пластина крышки.pdf | 06ad59c3d5793c8ff55cca90501b321961eef5a53be96ce3bec35bd4d002e41d | 1 | True | 25.SHT.G.06.01.00.01 | Пластина крышки |  | UNKNOWN |  |  | assembly_drawing | сборочная единица | MEDIUM | doc_type:assembly | INVENTORIED_TEXT_ONLY
1) ААА Тех.отдел/1. ДЛЯ ДИРЕКТОРА (18.08)/В работу/25.SHT.G.00.00.00.00/25.SHT - Заказ №2377 Промстрой/25.SHT.G.00.00.00.00 СБ Изм.5/25.SHT.G.00.00.00.00 СБ/Чертежи/Гибка/25.SHT.G.07.01.00.01 Пластина крышки.pdf | 0815eba6f5da7d11b85a95aed28d1c9963cca37e731f6f8a2b8691fd4001a24d | 1 | True | 25.SHT.G.07.01.00.01 | Пластина крышки |  | UNKNOWN |  |  | assembly_drawing | сборочная единица | MEDIUM | doc_type:assembly | INVENTORIED_TEXT_ONLY
1) ААА Тех.отдел/1. ДЛЯ ДИРЕКТОРА (18.08)/В работу/25.SHT.G.00.00.00.00/25.SHT - Заказ №2377 Промстрой/25.SHT.G.00.00.00.00 СБ Изм.5/25.SHT.G.00.00.00.00 СБ/Чертежи/Детали/25.SHT.G.00.00.00.00 Фланцы.pdf | 696efadd6d126a78eb38c7630d00b46b030e3592b66445218e7831a96f2efb4c | 1 | True | 25.SHT.G.00.00.00.00 | Фланцы |  | UNKNOWN |  |  | assembly_drawing | сборочная единица | MEDIUM | doc_type:assembly | INVENTORIED_TEXT_ONLY
1) ААА Тех.отдел/1. ДЛЯ ДИРЕКТОРА (18.08)/В работу/25.SHT.G.00.00.00.00/25.SHT - Заказ №2377 Промстрой/25.SHT.G.00.00.00.00 СБ Изм.5/25.SHT.G.00.00.00.00 СБ/Чертежи/Детали/25.SHT.G.00.00.00.03 Резиновая прокладка к фланцам.pdf | a3a2423b717d5d99045948faab2a562eb8fe2ef3089f03a8c0cc8d47c8986f05 | 1 | True | 25.SHT.G.00.00.00.03 | Резиновая прокладка к фланцам |  | UNKNOWN |  |  | assembly_drawing | сборочная единица | MEDIUM | doc_type:assembly | INVENTORIED_TEXT_ONLY
1) ААА Тех.отдел/1. ДЛЯ ДИРЕКТОРА (18.08)/В работу/25.SHT.G.00.00.00.00/25.SHT - Заказ №2377 Промстрой/25.SHT.G.00.00.00.00 СБ Изм.5/25.SHT.G.00.00.00.00 СБ/Чертежи/Детали/25.SHT.G.00.00.00.04 Резина проставка под крышкой.pdf | cda8db95ee453a43373d8eba39d3ee66ae16956bc5ba3619abb8aac0dafc7ed5 | 1 | True | 25.SHT.G.00.00.00.04 | Резина проставка под крышкой | Резина | CONFIRMED_IN_TEXT |  |  | assembly_drawing | сборочная единица | MEDIUM | doc_type:assembly | INVENTORIED_TEXT_ONLY
1) ААА Тех.отдел/1. ДЛЯ ДИРЕКТОРА (18.08)/В работу/25.SHT.G.00.00.00.00/25.SHT - Заказ №2377 Промстрой/25.SHT.G.00.00.00.00 СБ Изм.5/25.SHT.G.00.00.00.00 СБ/Чертежи/Детали/25.SHT.G.00.00.00.05 Фланец наружний.pdf | 16076c1e44e3c1b0ae032d0a5eb7a7cf30494cdc9d8283eceb298c2a2169adee | 1 | True | 25.SHT.G.00.00.00.05 | Фланец наружний |  | UNKNOWN |  |  | assembly_drawing | сборочная единица | MEDIUM | doc_type:assembly | INVENTORIED_TEXT_ONLY
1) ААА Тех.отдел/1. ДЛЯ ДИРЕКТОРА (18.08)/В работу/25.SHT.G.00.00.00.00/25.SHT - Заказ №2377 Промстрой/25.SHT.G.00.00.00.00 СБ Изм.5/25.SHT.G.00.00.00.00 СБ/Чертежи/Детали/25.SHT.G.01.00.00.04 Уголок.pdf | d8963b0233cf9a7b729d9b9099c569caca3826e8f8f235978f6b8e24c06d203b | 1 | True | 25.SHT.G.01.00.00.04 | Уголок |  | UNKNOWN |  |  | assembly_drawing | сборочная единица | MEDIUM | doc_type:assembly | INVENTORIED_TEXT_ONLY
1) ААА Тех.отдел/1. ДЛЯ ДИРЕКТОРА (18.08)/В работу/25.SHT.G.00.00.00.00/25.SHT - Заказ №2377 Промстрой/25.SHT.G.00.00.00.00 СБ Изм.5/25.SHT.G.00.00.00.00 СБ/Чертежи/Детали/25.SHT.G.01.00.00.10 Труба.pdf | e3750a142d9571d5ad1ae990fd110b0b572285c7aab3eefd0e7c9ff0cd3c6665 | 1 | True | 25.SHT.G.01.00.00.10 | Труба |  | UNKNOWN |  |  | assembly_drawing | сборочная единица | MEDIUM | doc_type:assembly | INVENTORIED_TEXT_ONLY
1) ААА Тех.отдел/1. ДЛЯ ДИРЕКТОРА (18.08)/В работу/25.SHT.G.00.00.00.00/25.SHT - Заказ №2377 Промстрой/25.SHT.G.00.00.00.00 СБ Изм.5/25.SHT.G.00.00.00.00 СБ/Чертежи/Детали/25.SHT.G.01.00.00.11 Труба.pdf | 909fa8dd10d2695da36a72c61a64b3ee130a0795defdce8df60c48577c36f61b | 1 | True | 25.SHT.G.01.00.00.11 | Труба |  | UNKNOWN |  |  | assembly_drawing | сборочная единица | MEDIUM | doc_type:assembly | INVENTORIED_TEXT_ONLY
1) ААА Тех.отдел/1. ДЛЯ ДИРЕКТОРА (18.08)/В работу/25.SHT.G.00.00.00.00/25.SHT - Заказ №2377 Промстрой/25.SHT.G.00.00.00.00 СБ Изм.5/25.SHT.G.00.00.00.00 СБ/Чертежи/Детали/25.SHT.G.02.00.00.04 Торец.pdf | 47e43877ce12ce5c9d4cc57e6d6bd371fba37160ec946663304760d664d2d0fc | 1 | True | 25.SHT.G.02.00.00.04 | Торец | 09Г2С | CONFIRMED_IN_TEXT |  |  | assembly_drawing | сборочная единица | MEDIUM | doc_type:assembly | INVENTORIED_TEXT_ONLY
1) ААА Тех.отдел/1. ДЛЯ ДИРЕКТОРА (18.08)/В работу/25.SHT.G.00.00.00.00/25.SHT - Заказ №2377 Промстрой/25.SHT.G.00.00.00.00 СБ Изм.5/25.SHT.G.00.00.00.00 СБ/Чертежи/Детали/25.SHT.G.03.00.00.04 Косынка.pdf | 7c33550c683862bd5fdedf0bdab4bca3bd33e9f623128183e3cfdc5f19c05a95 | 1 | True | 25.SHT.G.03.00.00.04 | Косынка |  | UNKNOWN |  |  | assembly_drawing | сборочная единица | MEDIUM | doc_type:assembly | INVENTORIED_TEXT_ONLY
1) ААА Тех.отдел/1. ДЛЯ ДИРЕКТОРА (18.08)/В работу/25.SHT.G.00.00.00.00/25.SHT - Заказ №2377 Промстрой/25.SHT.G.00.00.00.00 СБ Изм.5/25.SHT.G.00.00.00.00 СБ/Чертежи/Детали/25.SHT.G.04.00.00.02 Труба фланца.pdf | 8a6d6faa308bb658281cc5c0bad4cc685e883aeef17b444f3b3498b3bfe656d6 | 1 | True | 25.SHT.G.04.00.00.02 | Труба фланца |  | UNKNOWN |  |  | assembly_drawing | сборочная единица | MEDIUM | doc_type:assembly | INVENTORIED_TEXT_ONLY
1) ААА Тех.отдел/1. ДЛЯ ДИРЕКТОРА (18.08)/В работу/25.SHT.G.00.00.00.00/25.SHT - Заказ №2377 Промстрой/25.SHT.G.00.00.00.00 СБ Изм.5/25.SHT.G.00.00.00.00 СБ/Чертежи/Детали/25.SHT.G.05.00.00.01 Труба фланца.pdf | 5cf2333f7ab354d1aab2de3bb290fef86105cbbb7522923932d2b23527638400 | 1 | True | 25.SHT.G.05.00.00.01 | Труба фланца |  | UNKNOWN |  |  | assembly_drawing | сборочная единица | MEDIUM | doc_type:assembly | INVENTORIED_TEXT_ONLY
1) ААА Тех.отдел/1. ДЛЯ ДИРЕКТОРА (18.08)/В работу/25.SHT.G.00.00.00.00/25.SHT - Заказ №2377 Промстрой/25.SHT.G.00.00.00.00 СБ Изм.5/25.SHT.G.00.00.00.00 СБ/Чертежи/Детали/25.SHT.G.08.00.00.01 Уголок.pdf | c38b7583aeead0e024bb9a800644a1f471117e77f58c99b7d720a4740abc9e29 | 1 | True | 25.SHT.G.08.00.00.01 | Уголок |  | UNKNOWN |  |  | assembly_drawing | сборочная единица | MEDIUM | doc_type:assembly | INVENTORIED_TEXT_ONLY
1) ААА Тех.отдел/1. ДЛЯ ДИРЕКТОРА (18.08)/В работу/25.SHT.G.00.00.00.00/25.SHT - Заказ №2377 Промстрой/25.SHT.G.00.00.00.00 СБ Изм.5/25.SHT.G.00.00.00.00 СБ/Чертежи/Детали/25.SHT.G.08.00.00.02 Уголок.pdf | 1faede4f36db5175e2fe17d95e1215e8b93f0c48c1cde15ef84152ce68a31abb | 1 | True | 25.SHT.G.08.00.00.02 | Уголок |  | UNKNOWN |  |  | assembly_drawing | сборочная единица | MEDIUM | doc_type:assembly | INVENTORIED_TEXT_ONLY
1) ААА Тех.отдел/1. ДЛЯ ДИРЕКТОРА (18.08)/В работу/25.SHT.G.00.00.00.00/25.SHT - Заказ №2377 Промстрой/25.SHT.G.00.00.00.00 СБ Изм.5/25.SHT.G.00.00.00.00 СБ/Чертежи/Детали/25.SHT.G.09.00.00.01 Перекладина.pdf | 31e9f8fed80cf88e1faccd1621cd73513a1a1f620de7c1230dd75b298e5d5eff | 1 | True | 25.SHT.G.09.00.00.01 | Перекладина |  | UNKNOWN |  |  | assembly_drawing | сборочная единица | MEDIUM | doc_type:assembly | INVENTORIED_TEXT_ONLY
1) ААА Тех.отдел/1. ДЛЯ ДИРЕКТОРА (18.08)/В работу/25.SHT.G.00.00.00.00/25.SHT - Заказ №2377 Промстрой/25.SHT.G.00.00.00.00 СБ Изм.5/25.SHT.G.00.00.00.00 СБ/Чертежи/Детали/25.SHT.G.09.00.00.02 Пластина.pdf | 5ed8dffb443a8c58c3a8a19ed5b116c90ce2b562790bf166ab79caa429b82fc4 | 1 | True | 25.SHT.G.09.00.00.02 | Пластина |  | UNKNOWN |  |  | assembly_drawing | сборочная единица | MEDIUM | doc_type:assembly | INVENTORIED_TEXT_ONLY
1) ААА Тех.отдел/1. ДЛЯ ДИРЕКТОРА (18.08)/В работу/25.SHT.G.00.00.00.00/25.SHT - Заказ №2377 Промстрой/25.SHT.G.00.00.00.00 СБ Изм.5/25.SHT.G.00.00.00.00 СБ/Чертежи/Детали/Лазерная резка 10 мм..pdf | 7730f92a74c9be8825d43a337555a92f18f86c74c133f4084071e4de05ae2551 | 1 | True | Лазерная | резка 10 мм. |  | UNKNOWN |  |  | assembly_drawing | сборочная единица | MEDIUM | doc_type:assembly | INVENTORIED_TEXT_ONLY
1) ААА Тех.отдел/1. ДЛЯ ДИРЕКТОРА (18.08)/В работу/25.SHT.G.00.00.00.00/25.SHT - Заказ №2377 Промстрой/25.SHT.G.00.00.00.00 СБ Изм.5/25.SHT.G.00.00.00.00 СБ/Чертежи/Детали/Лазерная резка 3 мм..pdf | 86c701d19c35e1929c125bafe212e420e15b6932e9ea5d895ab672f6a022ec2d | 1 | True | Лазерная | резка 3 мм. | AISI 304 | CONFIRMED_IN_TEXT |  |  | assembly_drawing | сборочная единица | MEDIUM | doc_type:assembly | INVENTORIED_TEXT_ONLY
1) ААА Тех.отдел/1. ДЛЯ ДИРЕКТОРА (18.08)/В работу/25.SHT.G.00.00.00.00/25.SHT - Заказ №2377 Промстрой/25.SHT.G.00.00.00.00 СБ Изм.5/25.SHT.G.00.00.00.00 СБ/Чертежи/Детали/Лазерная резка 6 мм. 2.pdf | 0c465435ffb2915636cf869e288e51c2ef423364361eb6e93a67885793118478 | 1 | True | Лазерная | резка 6 мм. 2 |  | UNKNOWN |  |  | assembly_drawing | сборочная единица | MEDIUM | doc_type:assembly | INVENTORIED_TEXT_ONLY
1) ААА Тех.отдел/1. ДЛЯ ДИРЕКТОРА (18.08)/В работу/25.SHT.G.00.00.00.00/25.SHT - Заказ №2377 Промстрой/25.SHT.G.00.00.00.00 СБ Изм.5/25.SHT.G.00.00.00.00 СБ/Чертежи/Детали/Лазерная резка 6 мм. лист1.PDF | 2e34939c87dff80eb59723f41f55524b9cd7f533fe7ad1f2ca25ecc5427eb0e9 | 1 | True | Лазерная | резка 6 мм. лист1 |  | UNKNOWN |  |  | assembly_drawing | сборочная единица | MEDIUM | doc_type:assembly | INVENTORIED_TEXT_ONLY
1) ААА Тех.отдел/1. ДЛЯ ДИРЕКТОРА (18.08)/В работу/25.SHT.G.00.00.00.00/25.SHT - Заказ №2377 Промстрой/25.SHT.G.00.00.00.00 СБ Изм.5/25.SHT.G.00.00.00.00 СБ/Чертежи/Детали/Лазерная резка 6 мм. лист2.PDF | 30d97e055a6e1c1febe347d650081dba862bfa9c1868b4c34bd13aea24bda7ba | 1 | True | Лазерная | резка 6 мм. лист2 |  | UNKNOWN |  |  | assembly_drawing | сборочная единица | MEDIUM | doc_type:assembly | INVENTORIED_TEXT_ONLY
1) ААА Тех.отдел/1. ДЛЯ ДИРЕКТОРА (18.08)/В работу/25.SHT.G.00.00.00.00/25.SHT - Заказ №2377 Промстрой/25.SHT.G.00.00.00.00 СБ Изм.5/25.SHT.G.00.00.00.00 СБ/Чертежи/Заглушка.pdf | 4d771ad8e2ded35eb130638af04f172a076e277fb039a7b79c0c9ea55d8da43c | 1 | True | Заглушка |  |  | UNKNOWN |  |  | assembly_drawing | сборочная единица | MEDIUM | doc_type:assembly | INVENTORIED_TEXT_ONLY
1) ААА Тех.отдел/1. ДЛЯ ДИРЕКТОРА (18.08)/В работу/25.SHT.G.00.00.00.00/25.SHT.G.00.00.00.00 СБ/25.SHT.G.02.00.00.00 СБ Шнек с осями.pdf | 726ed7b4a8b476a9d6a349f6ab698c8233acf006457a97c9dcd97961c3cb2dcd | 1 | True | 25.SHT.G.02.00.00.00 | СБ Шнек с осями | 09Г2С | CONFIRMED_IN_TEXT |  |  | assembly_drawing | сборочная единица | MEDIUM | doc_type:assembly | INVENTORIED_TEXT_ONLY
1) ААА Тех.отдел/1. ДЛЯ ДИРЕКТОРА (18.08)/В работу/25.SHT.G.00.00.00.00/25.SHT.G.00.00.00.00 СБ/SHT-PV2-L3000 изм 1.pdf | e579abb4af61838042f2f83e57f7f2d6909da6b248c88dd4a00fa7b7d292dbcc | 1 | True | SHT-PV2-L3000 | изм 1 | 09Г2С | CONFIRMED_IN_TEXT |  |  | assembly_drawing | сборочная единица | MEDIUM | doc_type:assembly | INVENTORIED_TEXT_ONLY
1) ААА Тех.отдел/1. ДЛЯ ДИРЕКТОРА (18.08)/В работу/25.SHT.G.00.00.00.00/25.SHT.G.00.00.00.00 СБ/Вальцовка/25.SHT.G.00.00.00.00/25.SHT.G.00.00.00.01 Футеровка.pdf | 23a0b1c390b7bc06dca77e082a6ac0e56851a7b205f44c5409020c34c6d82441 | 1 | True | 25.SHT.G.00.00.00.01 | Футеровка |  | UNKNOWN |  |  | assembly_drawing | сборочная единица | MEDIUM | doc_type:assembly | INVENTORIED_TEXT_ONLY
1) ААА Тех.отдел/1. ДЛЯ ДИРЕКТОРА (18.08)/В работу/25.SHT.G.00.00.00.00/25.SHT.G.00.00.00.00 СБ/Вальцовка/25.SHT.G.00.00.00.00/25.SHT.G.00.00.00.02 Футеровка.pdf | 1f84cf13d1aa5e3011e64d9d0b5ab592eaa325c3eb01cf00076076c21ff27d40 | 1 | True | 25.SHT.G.00.00.00.02 | Футеровка |  | UNKNOWN |  |  | assembly_drawing | сборочная единица | MEDIUM | doc_type:assembly | INVENTORIED_TEXT_ONLY
1) ААА Тех.отдел/1. ДЛЯ ДИРЕКТОРА (18.08)/В работу/25.SHT.G.00.00.00.00/25.SHT.G.00.00.00.00 СБ/Вальцовка/25.SHT.G.00.00.00.00/25.SHT.G.01.00.00.01 Желоб выгрузки.pdf | 1641cb47f1e8be50cc5f3dc156834efbd0de8c153c1bc0e249d65afa3946525c | 1 | True | 25.SHT.G.01.00.00.01 | Желоб выгрузки |  | UNKNOWN |  |  | assembly_drawing | сборочная единица | MEDIUM | doc_type:assembly | INVENTORIED_TEXT_ONLY
1) ААА Тех.отдел/1. ДЛЯ ДИРЕКТОРА (18.08)/В работу/25.SHT.G.00.00.00.00/25.SHT.G.00.00.00.00 СБ/Вальцовка/25.SHT.G.00.00.00.00/25.SHT.G.01.00.00.02, 25.SHT.G.01.00.00.03 Желоб.pdf | 8f1aba6a774604ab53e534474422c1c3a639b7c813b1a783a37132b7b65f8546 | 1 | True | 25.SHT.G.01.00.00.02, 25.SHT.G.01.00.00.03 Желоб |  |  | UNKNOWN |  |  | assembly_drawing | сборочная единица | MEDIUM | doc_type:assembly | INVENTORIED_TEXT_ONLY
1) ААА Тех.отдел/1. ДЛЯ ДИРЕКТОРА (18.08)/В работу/25.SHT.G.00.00.00.00/25.SHT.G.00.00.00.00 СБ/Вальцовка/25.SHT.G.00.00.00.01 Футеровка.pdf | 23a0b1c390b7bc06dca77e082a6ac0e56851a7b205f44c5409020c34c6d82441 | 1 | True | 25.SHT.G.00.00.00.01 | Футеровка |  | UNKNOWN |  |  | assembly_drawing | сборочная единица | MEDIUM | doc_type:assembly | INVENTORIED_TEXT_ONLY
1) ААА Тех.отдел/1. ДЛЯ ДИРЕКТОРА (18.08)/В работу/25.SHT.G.00.00.00.00/25.SHT.G.00.00.00.00 СБ/Вальцовка/25.SHT.G.00.00.00.02 Футеровка.pdf | 1f84cf13d1aa5e3011e64d9d0b5ab592eaa325c3eb01cf00076076c21ff27d40 | 1 | True | 25.SHT.G.00.00.00.02 | Футеровка |  | UNKNOWN |  |  | assembly_drawing | сборочная единица | MEDIUM | doc_type:assembly | INVENTORIED_TEXT_ONLY
1) ААА Тех.отдел/1. ДЛЯ ДИРЕКТОРА (18.08)/В работу/25.SHT.G.00.00.00.00/25.SHT.G.00.00.00.00 СБ/Вальцовка/25.SHT.G.01.00.00.01 Желоб выгрузки.pdf | 1641cb47f1e8be50cc5f3dc156834efbd0de8c153c1bc0e249d65afa3946525c | 1 | True | 25.SHT.G.01.00.00.01 | Желоб выгрузки |  | UNKNOWN |  |  | assembly_drawing | сборочная единица | MEDIUM | doc_type:assembly | INVENTORIED_TEXT_ONLY
1) ААА Тех.отдел/1. ДЛЯ ДИРЕКТОРА (18.08)/В работу/25.SHT.G.00.00.00.00/25.SHT.G.00.00.00.00 СБ/Вальцовка/25.SHT.G.01.00.00.02, 25.SHT.G.01.00.00.03 Желоб.pdf | 8f1aba6a774604ab53e534474422c1c3a639b7c813b1a783a37132b7b65f8546 | 1 | True | 25.SHT.G.01.00.00.02, 25.SHT.G.01.00.00.03 Желоб |  |  | UNKNOWN |  |  | assembly_drawing | сборочная единица | MEDIUM | doc_type:assembly | INVENTORIED_TEXT_ONLY
1) ААА Тех.отдел/1. ДЛЯ ДИРЕКТОРА (18.08)/В работу/25.SHT.G.00.00.00.00/25.SHT.G.00.00.00.00 СБ/Гибка/25.SHT.G.00.00.00.00 Гибка/25.SHT.G.06.01.00.01 Пластина крышки.pdf | 06ad59c3d5793c8ff55cca90501b321961eef5a53be96ce3bec35bd4d002e41d | 1 | True | 25.SHT.G.06.01.00.01 | Пластина крышки |  | UNKNOWN |  |  | assembly_drawing | сборочная единица | MEDIUM | doc_type:assembly | INVENTORIED_TEXT_ONLY
1) ААА Тех.отдел/1. ДЛЯ ДИРЕКТОРА (18.08)/В работу/25.SHT.G.00.00.00.00/25.SHT.G.00.00.00.00 СБ/Гибка/25.SHT.G.00.00.00.00 Гибка/25.SHT.G.07.01.00.01 Пластина крышки.pdf | 0815eba6f5da7d11b85a95aed28d1c9963cca37e731f6f8a2b8691fd4001a24d | 1 | True | 25.SHT.G.07.01.00.01 | Пластина крышки |  | UNKNOWN |  |  | assembly_drawing | сборочная единица | MEDIUM | doc_type:assembly | INVENTORIED_TEXT_ONLY
1) ААА Тех.отдел/1. ДЛЯ ДИРЕКТОРА (18.08)/В работу/25.SHT.G.00.00.00.00/25.SHT.G.00.00.00.00 СБ/Гибка/25.SHT.G.06.01.00.01 Пластина крышки.pdf | 06ad59c3d5793c8ff55cca90501b321961eef5a53be96ce3bec35bd4d002e41d | 1 | True | 25.SHT.G.06.01.00.01 | Пластина крышки |  | UNKNOWN |  |  | assembly_drawing | сборочная единица | MEDIUM | doc_type:assembly | INVENTORIED_TEXT_ONLY
1) ААА Тех.отдел/1. ДЛЯ ДИРЕКТОРА (18.08)/В работу/25.SHT.G.00.00.00.00/25.SHT.G.00.00.00.00 СБ/Гибка/25.SHT.G.07.01.00.01 Пластина крышки.pdf | 0815eba6f5da7d11b85a95aed28d1c9963cca37e731f6f8a2b8691fd4001a24d | 1 | True | 25.SHT.G.07.01.00.01 | Пластина крышки |  | UNKNOWN |  |  | assembly_drawing | сборочная единица | MEDIUM | doc_type:assembly | INVENTORIED_TEXT_ONLY
1) ААА Тех.отдел/1. ДЛЯ ДИРЕКТОРА (18.08)/В работу/25.SHT.G.00.00.00.00/25.SHT.G.00.00.00.00 СБ/Детали/25.SHT.G.00.00.00.00 Фланцы.pdf | 696efadd6d126a78eb38c7630d00b46b030e3592b66445218e7831a96f2efb4c | 1 | True | 25.SHT.G.00.00.00.00 | Фланцы |  | UNKNOWN |  |  | assembly_drawing | сборочная единица | MEDIUM | doc_type:assembly | INVENTORIED_TEXT_ONLY
1) ААА Тех.отдел/1. ДЛЯ ДИРЕКТОРА (18.08)/В работу/25.SHT.G.00.00.00.00/25.SHT.G.00.00.00.00 СБ/Детали/25.SHT.G.00.00.00.03 Резиновая прокладка к фланцам.pdf | a3a2423b717d5d99045948faab2a562eb8fe2ef3089f03a8c0cc8d47c8986f05 | 1 | True | 25.SHT.G.00.00.00.03 | Резиновая прокладка к фланцам |  | UNKNOWN |  |  | assembly_drawing | сборочная единица | MEDIUM | doc_type:assembly | INVENTORIED_TEXT_ONLY
1) ААА Тех.отдел/1. ДЛЯ ДИРЕКТОРА (18.08)/В работу/25.SHT.G.00.00.00.00/25.SHT.G.00.00.00.00 СБ/Детали/25.SHT.G.00.00.00.04 Резина проставка под крышкой.pdf | cda8db95ee453a43373d8eba39d3ee66ae16956bc5ba3619abb8aac0dafc7ed5 | 1 | True | 25.SHT.G.00.00.00.04 | Резина проставка под крышкой | Резина | CONFIRMED_IN_TEXT |  |  | assembly_drawing | сборочная единица | MEDIUM | doc_type:assembly | INVENTORIED_TEXT_ONLY
1) ААА Тех.отдел/1. ДЛЯ ДИРЕКТОРА (18.08)/В работу/25.SHT.G.00.00.00.00/25.SHT.G.00.00.00.00 СБ/Детали/25.SHT.G.00.00.00.05 Фланец наружний.pdf | 16076c1e44e3c1b0ae032d0a5eb7a7cf30494cdc9d8283eceb298c2a2169adee | 1 | True | 25.SHT.G.00.00.00.05 | Фланец наружний |  | UNKNOWN |  |  | assembly_drawing | сборочная единица | MEDIUM | doc_type:assembly | INVENTORIED_TEXT_ONLY
1) ААА Тех.отдел/1. ДЛЯ ДИРЕКТОРА (18.08)/В работу/25.SHT.G.00.00.00.00/25.SHT.G.00.00.00.00 СБ/Детали/25.SHT.G.00.00.00.09 Резиновая проставка отсеков.pdf | 319d7b9cac83c68393b5997c7687bfd9598d22c8be71be8ee1d0551363f65f00 | 1 | True | 25.SHT.G.00.00.00.09 | Резиновая проставка отсеков | Резина | CONFIRMED_IN_TEXT |  |  | assembly_drawing | сборочная единица | MEDIUM | doc_type:assembly | INVENTORIED_TEXT_ONLY
1) ААА Тех.отдел/1. ДЛЯ ДИРЕКТОРА (18.08)/В работу/25.SHT.G.00.00.00.00/25.SHT.G.00.00.00.00 СБ/Детали/25.SHT.G.01.00.00.04 Уголок.pdf | d8963b0233cf9a7b729d9b9099c569caca3826e8f8f235978f6b8e24c06d203b | 1 | True | 25.SHT.G.01.00.00.04 | Уголок |  | UNKNOWN |  |  | assembly_drawing | сборочная единица | MEDIUM | doc_type:assembly | INVENTORIED_TEXT_ONLY
1) ААА Тех.отдел/1. ДЛЯ ДИРЕКТОРА (18.08)/В работу/25.SHT.G.00.00.00.00/25.SHT.G.00.00.00.00 СБ/Детали/25.SHT.G.01.00.00.10 Труба.pdf | e3750a142d9571d5ad1ae990fd110b0b572285c7aab3eefd0e7c9ff0cd3c6665 | 1 | True | 25.SHT.G.01.00.00.10 | Труба |  | UNKNOWN |  |  | assembly_drawing | сборочная единица | MEDIUM | doc_type:assembly | INVENTORIED_TEXT_ONLY
1) ААА Тех.отдел/1. ДЛЯ ДИРЕКТОРА (18.08)/В работу/25.SHT.G.00.00.00.00/25.SHT.G.00.00.00.00 СБ/Детали/25.SHT.G.01.00.00.11 Труба.pdf | 909fa8dd10d2695da36a72c61a64b3ee130a0795defdce8df60c48577c36f61b | 1 | True | 25.SHT.G.01.00.00.11 | Труба |  | UNKNOWN |  |  | assembly_drawing | сборочная единица | MEDIUM | doc_type:assembly | INVENTORIED_TEXT_ONLY
1) ААА Тех.отдел/1. ДЛЯ ДИРЕКТОРА (18.08)/В работу/25.SHT.G.00.00.00.00/25.SHT.G.00.00.00.00 СБ/Детали/25.SHT.G.02.00.00.04 Торец.pdf | 47e43877ce12ce5c9d4cc57e6d6bd371fba37160ec946663304760d664d2d0fc | 1 | True | 25.SHT.G.02.00.00.04 | Торец | 09Г2С | CONFIRMED_IN_TEXT |  |  | assembly_drawing | сборочная единица | MEDIUM | doc_type:assembly | INVENTORIED_TEXT_ONLY
1) ААА Тех.отдел/1. ДЛЯ ДИРЕКТОРА (18.08)/В работу/25.SHT.G.00.00.00.00/25.SHT.G.00.00.00.00 СБ/Детали/25.SHT.G.03.00.00.04 Косынка.pdf | 7c33550c683862bd5fdedf0bdab4bca3bd33e9f623128183e3cfdc5f19c05a95 | 1 | True | 25.SHT.G.03.00.00.04 | Косынка |  | UNKNOWN |  |  | assembly_drawing | сборочная единица | MEDIUM | doc_type:assembly | INVENTORIED_TEXT_ONLY
1) ААА Тех.отдел/1. ДЛЯ ДИРЕКТОРА (18.08)/В работу/25.SHT.G.00.00.00.00/25.SHT.G.00.00.00.00 СБ/Детали/25.SHT.G.04.00.00.02 Труба фланца.pdf | 8a6d6faa308bb658281cc5c0bad4cc685e883aeef17b444f3b3498b3bfe656d6 | 1 | True | 25.SHT.G.04.00.00.02 | Труба фланца |  | UNKNOWN |  |  | assembly_drawing | сборочная единица | MEDIUM | doc_type:assembly | INVENTORIED_TEXT_ONLY
1) ААА Тех.отдел/1. ДЛЯ ДИРЕКТОРА (18.08)/В работу/25.SHT.G.00.00.00.00/25.SHT.G.00.00.00.00 СБ/Детали/25.SHT.G.05.00.00.01 Труба фланца.pdf | 5cf2333f7ab354d1aab2de3bb290fef86105cbbb7522923932d2b23527638400 | 1 | True | 25.SHT.G.05.00.00.01 | Труба фланца |  | UNKNOWN |  |  | assembly_drawing | сборочная единица | MEDIUM | doc_type:assembly | INVENTORIED_TEXT_ONLY
1) ААА Тех.отдел/1. ДЛЯ ДИРЕКТОРА (18.08)/В работу/25.SHT.G.00.00.00.00/25.SHT.G.00.00.00.00 СБ/Детали/25.SHT.G.08.00.00.01 Уголок.pdf | c38b7583aeead0e024bb9a800644a1f471117e77f58c99b7d720a4740abc9e29 | 1 | True | 25.SHT.G.08.00.00.01 | Уголок |  | UNKNOWN |  |  | assembly_drawing | сборочная единица | MEDIUM | doc_type:assembly | INVENTORIED_TEXT_ONLY
1) ААА Тех.отдел/1. ДЛЯ ДИРЕКТОРА (18.08)/В работу/25.SHT.G.00.00.00.00/25.SHT.G.00.00.00.00 СБ/Детали/25.SHT.G.08.00.00.02 Уголок.pdf | 1faede4f36db5175e2fe17d95e1215e8b93f0c48c1cde15ef84152ce68a31abb | 1 | True | 25.SHT.G.08.00.00.02 | Уголок |  | UNKNOWN |  |  | assembly_drawing | сборочная единица | MEDIUM | doc_type:assembly | INVENTORIED_TEXT_ONLY
1) ААА Тех.отдел/1. ДЛЯ ДИРЕКТОРА (18.08)/В работу/25.SHT.G.00.00.00.00/25.SHT.G.00.00.00.00 СБ/Детали/25.SHT.G.09.00.00.01 Перекладина.pdf | 31e9f8fed80cf88e1faccd1621cd73513a1a1f620de7c1230dd75b298e5d5eff | 1 | True | 25.SHT.G.09.00.00.01 | Перекладина |  | UNKNOWN |  |  | assembly_drawing | сборочная единица | MEDIUM | doc_type:assembly | INVENTORIED_TEXT_ONLY
1) ААА Тех.отдел/1. ДЛЯ ДИРЕКТОРА (18.08)/В работу/25.SHT.G.00.00.00.00/25.SHT.G.00.00.00.00 СБ/Детали/25.SHT.G.09.00.00.02 Пластина.pdf | 5ed8dffb443a8c58c3a8a19ed5b116c90ce2b562790bf166ab79caa429b82fc4 | 1 | True | 25.SHT.G.09.00.00.02 | Пластина |  | UNKNOWN |  |  | assembly_drawing | сборочная единица | MEDIUM | doc_type:assembly | INVENTORIED_TEXT_ONLY
1) ААА Тех.отдел/1. ДЛЯ ДИРЕКТОРА (18.08)/В работу/25.SHT.G.00.00.00.00/25.SHT.G.00.00.00.00 СБ/Детали/Вальцовка/25.SHT.G.00.00.00.01 Футеровка.pdf | 23a0b1c390b7bc06dca77e082a6ac0e56851a7b205f44c5409020c34c6d82441 | 1 | True | 25.SHT.G.00.00.00.01 | Футеровка |  | UNKNOWN |  |  | assembly_drawing | сборочная единица | MEDIUM | doc_type:assembly | INVENTORIED_TEXT_ONLY
1) ААА Тех.отдел/1. ДЛЯ ДИРЕКТОРА (18.08)/В работу/25.SHT.G.00.00.00.00/25.SHT.G.00.00.00.00 СБ/Детали/Вальцовка/25.SHT.G.00.00.00.02 Футеровка.pdf | 1f84cf13d1aa5e3011e64d9d0b5ab592eaa325c3eb01cf00076076c21ff27d40 | 1 | True | 25.SHT.G.00.00.00.02 | Футеровка |  | UNKNOWN |  |  | assembly_drawing | сборочная единица | MEDIUM | doc_type:assembly | INVENTORIED_TEXT_ONLY
1) ААА Тех.отдел/1. ДЛЯ ДИРЕКТОРА (18.08)/В работу/25.SHT.G.00.00.00.00/25.SHT.G.00.00.00.00 СБ/Детали/Вальцовка/25.SHT.G.01.00.00.01 Желоб выгрузки.pdf | 1641cb47f1e8be50cc5f3dc156834efbd0de8c153c1bc0e249d65afa3946525c | 1 | True | 25.SHT.G.01.00.00.01 | Желоб выгрузки |  | UNKNOWN |  |  | assembly_drawing | сборочная единица | MEDIUM | doc_type:assembly | INVENTORIED_TEXT_ONLY
1) ААА Тех.отдел/1. ДЛЯ ДИРЕКТОРА (18.08)/В работу/25.SHT.G.00.00.00.00/25.SHT.G.00.00.00.00 СБ/Детали/Вальцовка/25.SHT.G.01.00.00.02, 25.SHT.G.01.00.00.03 Желоб.pdf | 8f1aba6a774604ab53e534474422c1c3a639b7c813b1a783a37132b7b65f8546 | 1 | True | 25.SHT.G.01.00.00.02, 25.SHT.G.01.00.00.03 Желоб |  |  | UNKNOWN |  |  | assembly_drawing | сборочная единица | MEDIUM | doc_type:assembly | INVENTORIED_TEXT_ONLY
1) ААА Тех.отдел/1. ДЛЯ ДИРЕКТОРА (18.08)/В работу/25.SHT.G.00.00.00.00/25.SHT.G.00.00.00.00 СБ/Детали/Гибка/25.SHT.G.06.01.00.01 Пластина крышки.pdf | 06ad59c3d5793c8ff55cca90501b321961eef5a53be96ce3bec35bd4d002e41d | 1 | True | 25.SHT.G.06.01.00.01 | Пластина крышки |  | UNKNOWN |  |  | assembly_drawing | сборочная единица | MEDIUM | doc_type:assembly | INVENTORIED_TEXT_ONLY
1) ААА Тех.отдел/1. ДЛЯ ДИРЕКТОРА (18.08)/В работу/25.SHT.G.00.00.00.00/25.SHT.G.00.00.00.00 СБ/Детали/Гибка/25.SHT.G.07.01.00.01 Пластина крышки.pdf | 0815eba6f5da7d11b85a95aed28d1c9963cca37e731f6f8a2b8691fd4001a24d | 1 | True | 25.SHT.G.07.01.00.01 | Пластина крышки |  | UNKNOWN |  |  | assembly_drawing | сборочная единица | MEDIUM | doc_type:assembly | INVENTORIED_TEXT_ONLY
1) ААА Тех.отдел/1. ДЛЯ ДИРЕКТОРА (18.08)/В работу/25.SHT.G.00.00.00.00/25.SHT.G.00.00.00.00 СБ/Детали/Лазерная резка 10 мм..pdf | 7730f92a74c9be8825d43a337555a92f18f86c74c133f4084071e4de05ae2551 | 1 | True | Лазерная | резка 10 мм. |  | UNKNOWN |  |  | assembly_drawing | сборочная единица | MEDIUM | doc_type:assembly | INVENTORIED_TEXT_ONLY
1) ААА Тех.отдел/1. ДЛЯ ДИРЕКТОРА (18.08)/В работу/25.SHT.G.00.00.00.00/25.SHT.G.00.00.00.00 СБ/Детали/Лазерная резка 3 мм..pdf | 86c701d19c35e1929c125bafe212e420e15b6932e9ea5d895ab672f6a022ec2d | 1 | True | Лазерная | резка 3 мм. | AISI 304 | CONFIRMED_IN_TEXT |  |  | assembly_drawing | сборочная единица | MEDIUM | doc_type:assembly | INVENTORIED_TEXT_ONLY
1) ААА Тех.отдел/1. ДЛЯ ДИРЕКТОРА (18.08)/В работу/25.SHT.G.00.00.00.00/25.SHT.G.00.00.00.00 СБ/Детали/Лазерная резка 6 мм. 2.pdf | 0c465435ffb2915636cf869e288e51c2ef423364361eb6e93a67885793118478 | 1 | True | Лазерная | резка 6 мм. 2 |  | UNKNOWN |  |  | assembly_drawing | сборочная единица | MEDIUM | doc_type:assembly | INVENTORIED_TEXT_ONLY
1) ААА Тех.отдел/1. ДЛЯ ДИРЕКТОРА (18.08)/В работу/25.SHT.G.00.00.00.00/25.SHT.G.00.00.00.00 СБ/Детали/Лазерная резка 6 мм. лист1.PDF | 2e34939c87dff80eb59723f41f55524b9cd7f533fe7ad1f2ca25ecc5427eb0e9 | 1 | True | Лазерная | резка 6 мм. лист1 |  | UNKNOWN |  |  | assembly_drawing | сборочная единица | MEDIUM | doc_type:assembly | INVENTORIED_TEXT_ONLY
1) ААА Тех.отдел/1. ДЛЯ ДИРЕКТОРА (18.08)/В работу/25.SHT.G.00.00.00.00/25.SHT.G.00.00.00.00 СБ/Детали/Лазерная резка 6 мм. лист2.PDF | 30d97e055a6e1c1febe347d650081dba862bfa9c1868b4c34bd13aea24bda7ba | 1 | True | Лазерная | резка 6 мм. лист2 |  | UNKNOWN |  |  | assembly_drawing | сборочная единица | MEDIUM | doc_type:assembly | INVENTORIED_TEXT_ONLY
1) ААА Тех.отдел/1. ДЛЯ ДИРЕКТОРА (18.08)/В работу/25.SHT.G.00.00.00.00/25.SHT.G.00.00.00.00 СБ/Заглушка.pdf | 4d771ad8e2ded35eb130638af04f172a076e277fb039a7b79c0c9ea55d8da43c | 1 | True | Заглушка |  |  | UNKNOWN |  |  | assembly_drawing | сборочная единица | MEDIUM | doc_type:assembly | INVENTORIED_TEXT_ONLY
1) ААА Тех.отдел/1. ДЛЯ ДИРЕКТОРА (18.08)/В работу/25.SHT.G.00.00.00.00/25.SHT.G.00.00.00.00 СБ/Сборки/25.SHT.G.00.00.00.00 СБ Транспортер.pdf | e846591cb097e4049e33366c3bb24fa612e88654e606288638fc15a6cbe9eec0 | 3 | True | 25.SHT.G.00.00.00.00 | СБ Транспортер | Сталь 45 | CONFIRMED_IN_TEXT |  |  | assembly_drawing | сборочная единица | MEDIUM | doc_type:assembly | INVENTORIED_TEXT_ONLY
1) ААА Тех.отдел/1. ДЛЯ ДИРЕКТОРА (18.08)/В работу/25.SHT.G.00.00.00.00/25.SHT.G.00.00.00.00 СБ/Сборки/25.SHT.G.01.00.00.00 СБ Отсек (сварка).PDF | 1818ad45865a67531e9a695a133a1fd5b12a700f1f6c94e7b7bc9c0ef7601877 | 2 | True | 25.SHT.G.01.00.00.00 | СБ Отсек (сварка) | AISI 304 | CONFIRMED_IN_TEXT |  |  | assembly_drawing | сборочная единица | MEDIUM | doc_type:assembly | INVENTORIED_TEXT_ONLY
1) ААА Тех.отдел/1. ДЛЯ ДИРЕКТОРА (18.08)/В работу/25.SHT.G.00.00.00.00/25.SHT.G.00.00.00.00 СБ/Сборки/25.SHT.G.01.00.00.00 СБ Отсек.pdf | d0f227986fac0fb3aaa531463e10e798443dd2e4b82163cbec87fec1df5151be | 1 | True | 25.SHT.G.01.00.00.00 | СБ Отсек | AISI 304 | CONFIRMED_IN_TEXT |  |  | assembly_drawing | сборочная единица | MEDIUM | doc_type:assembly | INVENTORIED_TEXT_ONLY
1) ААА Тех.отдел/1. ДЛЯ ДИРЕКТОРА (18.08)/В работу/25.SHT.G.00.00.00.00/25.SHT.G.00.00.00.00 СБ/Сборки/25.SHT.G.01.01.00.00 СБ Опора.pdf | a6ffb7bc7fb51eb298decd8a9ce064f50c11c35f08c7706aabc936e51e5e037c | 1 | True | 25.SHT.G.01.01.00.00 | СБ Опора | AISI 304 | CONFIRMED_IN_TEXT |  |  | assembly_drawing | сборочная единица | MEDIUM | doc_type:assembly | INVENTORIED_TEXT_ONLY
1) ААА Тех.отдел/1. ДЛЯ ДИРЕКТОРА (18.08)/В работу/25.SHT.G.00.00.00.00/25.SHT.G.00.00.00.00 СБ/Сборки/25.SHT.G.02.00.00.00 СБ Шнек с осями.pdf | 726ed7b4a8b476a9d6a349f6ab698c8233acf006457a97c9dcd97961c3cb2dcd | 1 | True | 25.SHT.G.02.00.00.00 | СБ Шнек с осями | 09Г2С | CONFIRMED_IN_TEXT |  |  | assembly_drawing | сборочная единица | MEDIUM | doc_type:assembly | INVENTORIED_TEXT_ONLY
1) ААА Тех.отдел/1. ДЛЯ ДИРЕКТОРА (18.08)/В работу/25.SHT.G.00.00.00.00/25.SHT.G.00.00.00.00 СБ/Сборки/25.SHT.G.03.00.00.00 СБ Фланец.pdf | 48dc27d7a0ab7a036ce8f2e147e8ac5429f1f4fe4689dd30cf8f0fa4af36b63f | 1 | True | 25.SHT.G.03.00.00.00 | СБ Фланец | AISI 304 | CONFIRMED_IN_TEXT |  |  | assembly_drawing | сборочная единица | MEDIUM | doc_type:assembly | INVENTORIED_TEXT_ONLY
1) ААА Тех.отдел/1. ДЛЯ ДИРЕКТОРА (18.08)/В работу/25.SHT.G.00.00.00.00/25.SHT.G.00.00.00.00 СБ/Сборки/25.SHT.G.04.00.00.00 СБ Фланец изм.1.pdf | 86f4219e59ff0812acd496aad9b9878668cd72d42afbd81091931f0be3080f7b | 1 | True | 25.SHT.G.04.00.00.00 | СБ Фланец изм.1 | AISI 304 | CONFIRMED_IN_TEXT |  |  | assembly_drawing | сборочная единица | MEDIUM | doc_type:assembly | INVENTORIED_TEXT_ONLY
1) ААА Тех.отдел/1. ДЛЯ ДИРЕКТОРА (18.08)/В работу/25.SHT.G.00.00.00.00/25.SHT.G.00.00.00.00 СБ/Сборки/25.SHT.G.04.00.00.00 СБ Фланец.pdf | 6dc534ce71966e10c5f043fd5819ae683d69690bb63387612620d521781ace9e | 1 | True | 25.SHT.G.04.00.00.00 | СБ Фланец | AISI 304 | CONFIRMED_IN_TEXT |  |  | assembly_drawing | сборочная единица | MEDIUM | doc_type:assembly | INVENTORIED_TEXT_ONLY
1) ААА Тех.отдел/1. ДЛЯ ДИРЕКТОРА (18.08)/В работу/25.SHT.G.00.00.00.00/25.SHT.G.00.00.00.00 СБ/Сборки/25.SHT.G.05.00.00.00 СБ Фланец соединительный.pdf | e48c03956c8f8cadc80b2468beab807384b41e286aed6e41717d69849fbd1996 | 1 | True | 25.SHT.G.05.00.00.00 | СБ Фланец соединительный | AISI 304 | CONFIRMED_IN_TEXT |  |  | assembly_drawing | сборочная единица | MEDIUM | doc_type:assembly | INVENTORIED_TEXT_ONLY
1) ААА Тех.отдел/1. ДЛЯ ДИРЕКТОРА (18.08)/В работу/25.SHT.G.00.00.00.00/25.SHT.G.00.00.00.00 СБ/Сборки/25.SHT.G.06.00.00.00 СБ Крышка.pdf | c5e193ee5119ac25dfd5d6cace872d5654dcecf0059ea807b0e7bb72ed4b4133 | 1 | True | 25.SHT.G.06.00.00.00 | СБ Крышка |  | UNKNOWN |  |  | assembly_drawing | сборочная единица | MEDIUM | doc_type:assembly | INVENTORIED_TEXT_ONLY
1) ААА Тех.отдел/1. ДЛЯ ДИРЕКТОРА (18.08)/В работу/25.SHT.G.00.00.00.00/25.SHT.G.00.00.00.00 СБ/Сборки/25.SHT.G.06.01.00.00 СБ Крышка.pdf | b7fbcd1f8bce7b14565ef0484b68cf62c96b9c8a45ce355e817692c45314e856 | 1 | True | 25.SHT.G.06.01.00.00 | СБ Крышка | AISI 304 | CONFIRMED_IN_TEXT |  |  | assembly_drawing | сборочная единица | MEDIUM | doc_type:assembly | INVENTORIED_TEXT_ONLY
1) ААА Тех.отдел/1. ДЛЯ ДИРЕКТОРА (18.08)/В работу/25.SHT.G.00.00.00.00/25.SHT.G.00.00.00.00 СБ/Сборки/25.SHT.G.07.01.00.00 СБ Крышка.pdf | b3f04eead900b75a3e61a53015e075b6beed9fea38383b0cdf06fdbf472e2b21 | 1 | True | 25.SHT.G.07.01.00.00 | СБ Крышка | AISI 304 | CONFIRMED_IN_TEXT |  |  | assembly_drawing | сборочная единица | MEDIUM | doc_type:assembly | INVENTORIED_TEXT_ONLY
1) ААА Тех.отдел/1. ДЛЯ ДИРЕКТОРА (18.08)/В работу/25.SHT.G.00.00.00.00/25.SHT.G.00.00.00.00 СБ/Сборки/25.SHT.G.08.00.00.00 СБ Опора.pdf | 9520b6a5aeb1859084c7dde19ce8b834dcc2237b9b0b64f74fb4fb58f760aeaf | 1 | True | 25.SHT.G.08.00.00.00 | СБ Опора | AISI 304 | CONFIRMED_IN_TEXT |  |  | assembly_drawing | сборочная единица | MEDIUM | doc_type:assembly | INVENTORIED_TEXT_ONLY
1) ААА Тех.отдел/1. ДЛЯ ДИРЕКТОРА (18.08)/В работу/25.SHT.G.00.00.00.00/25.SHT.G.00.00.00.00 СБ/Сборки/25.SHT.G.09.00.00.00 СБ Перекладина съемная.pdf | 77f01d126d30745abf3ab121ed63e8fefb707cdd658e46852086a2d84e5252bb | 1 | True | 25.SHT.G.09.00.00.00 | СБ Перекладина съемная | AISI 304 | CONFIRMED_IN_TEXT |  |  | assembly_drawing | сборочная единица | MEDIUM | doc_type:assembly | INVENTORIED_TEXT_ONLY
1) ААА Тех.отдел/1. ДЛЯ ДИРЕКТОРА (18.08)/В работу/25.SHT.G.00.00.00.00/25.SHT.G.00.00.00.00 СБ/Чертежи/25.SHT.G.02.00.00.00 СБ Шнек с осями.pdf | 726ed7b4a8b476a9d6a349f6ab698c8233acf006457a97c9dcd97961c3cb2dcd | 1 | True | 25.SHT.G.02.00.00.00 | СБ Шнек с осями | 09Г2С | CONFIRMED_IN_TEXT |  |  | assembly_drawing | сборочная единица | MEDIUM | doc_type:assembly | INVENTORIED_TEXT_ONLY
1) ААА Тех.отдел/1. ДЛЯ ДИРЕКТОРА (18.08)/В работу/25.SHT.G.00.00.00.00/25.SHT.G.00.00.00.00 СБ/Чертежи/Вальцовка/25.SHT.G.00.00.00.00/25.SHT.G.00.00.00.01 Футеровка.pdf | 23a0b1c390b7bc06dca77e082a6ac0e56851a7b205f44c5409020c34c6d82441 | 1 | True | 25.SHT.G.00.00.00.01 | Футеровка |  | UNKNOWN |  |  | assembly_drawing | сборочная единица | MEDIUM | doc_type:assembly | INVENTORIED_TEXT_ONLY
1) ААА Тех.отдел/1. ДЛЯ ДИРЕКТОРА (18.08)/В работу/25.SHT.G.00.00.00.00/25.SHT.G.00.00.00.00 СБ/Чертежи/Вальцовка/25.SHT.G.00.00.00.00/25.SHT.G.00.00.00.02 Футеровка.pdf | 1f84cf13d1aa5e3011e64d9d0b5ab592eaa325c3eb01cf00076076c21ff27d40 | 1 | True | 25.SHT.G.00.00.00.02 | Футеровка |  | UNKNOWN |  |  | assembly_drawing | сборочная единица | MEDIUM | doc_type:assembly | INVENTORIED_TEXT_ONLY
1) ААА Тех.отдел/1. ДЛЯ ДИРЕКТОРА (18.08)/В работу/25.SHT.G.00.00.00.00/25.SHT.G.00.00.00.00 СБ/Чертежи/Вальцовка/25.SHT.G.00.00.00.00/25.SHT.G.01.00.00.01 Желоб выгрузки.pdf | 1641cb47f1e8be50cc5f3dc156834efbd0de8c153c1bc0e249d65afa3946525c | 1 | True | 25.SHT.G.01.00.00.01 | Желоб выгрузки |  | UNKNOWN |  |  | assembly_drawing | сборочная единица | MEDIUM | doc_type:assembly | INVENTORIED_TEXT_ONLY
1) ААА Тех.отдел/1. ДЛЯ ДИРЕКТОРА (18.08)/В работу/25.SHT.G.00.00.00.00/25.SHT.G.00.00.00.00 СБ/Чертежи/Вальцовка/25.SHT.G.00.00.00.00/25.SHT.G.01.00.00.02, 25.SHT.G.01.00.00.03 Желоб.pdf | 8f1aba6a774604ab53e534474422c1c3a639b7c813b1a783a37132b7b65f8546 | 1 | True | 25.SHT.G.01.00.00.02, 25.SHT.G.01.00.00.03 Желоб |  |  | UNKNOWN |  |  | assembly_drawing | сборочная единица | MEDIUM | doc_type:assembly | INVENTORIED_TEXT_ONLY
1) ААА Тех.отдел/1. ДЛЯ ДИРЕКТОРА (18.08)/В работу/25.SHT.G.00.00.00.00/25.SHT.G.00.00.00.00 СБ/Чертежи/Вальцовка/25.SHT.G.00.00.00.01 Футеровка.pdf | 23a0b1c390b7bc06dca77e082a6ac0e56851a7b205f44c5409020c34c6d82441 | 1 | True | 25.SHT.G.00.00.00.01 | Футеровка |  | UNKNOWN |  |  | assembly_drawing | сборочная единица | MEDIUM | doc_type:assembly | INVENTORIED_TEXT_ONLY
1) ААА Тех.отдел/1. ДЛЯ ДИРЕКТОРА (18.08)/В работу/25.SHT.G.00.00.00.00/25.SHT.G.00.00.00.00 СБ/Чертежи/Вальцовка/25.SHT.G.00.00.00.02 Футеровка.pdf | 1f84cf13d1aa5e3011e64d9d0b5ab592eaa325c3eb01cf00076076c21ff27d40 | 1 | True | 25.SHT.G.00.00.00.02 | Футеровка |  | UNKNOWN |  |  | assembly_drawing | сборочная единица | MEDIUM | doc_type:assembly | INVENTORIED_TEXT_ONLY
1) ААА Тех.отдел/1. ДЛЯ ДИРЕКТОРА (18.08)/В работу/25.SHT.G.00.00.00.00/25.SHT.G.00.00.00.00 СБ/Чертежи/Вальцовка/25.SHT.G.01.00.00.01 Желоб выгрузки.pdf | 1641cb47f1e8be50cc5f3dc156834efbd0de8c153c1bc0e249d65afa3946525c | 1 | True | 25.SHT.G.01.00.00.01 | Желоб выгрузки |  | UNKNOWN |  |  | assembly_drawing | сборочная единица | MEDIUM | doc_type:assembly | INVENTORIED_TEXT_ONLY
1) ААА Тех.отдел/1. ДЛЯ ДИРЕКТОРА (18.08)/В работу/25.SHT.G.00.00.00.00/25.SHT.G.00.00.00.00 СБ/Чертежи/Вальцовка/25.SHT.G.01.00.00.02, 25.SHT.G.01.00.00.03 Желоб.pdf | 8f1aba6a774604ab53e534474422c1c3a639b7c813b1a783a37132b7b65f8546 | 1 | True | 25.SHT.G.01.00.00.02, 25.SHT.G.01.00.00.03 Желоб |  |  | UNKNOWN |  |  | assembly_drawing | сборочная единица | MEDIUM | doc_type:assembly | INVENTORIED_TEXT_ONLY
1) ААА Тех.отдел/1. ДЛЯ ДИРЕКТОРА (18.08)/В работу/25.SHT.G.00.00.00.00/25.SHT.G.00.00.00.00 СБ/Чертежи/Гибка/25.SHT.G.00.00.00.00 Гибка/25.SHT.G.06.01.00.01 Пластина крышки.pdf | 06ad59c3d5793c8ff55cca90501b321961eef5a53be96ce3bec35bd4d002e41d | 1 | True | 25.SHT.G.06.01.00.01 | Пластина крышки |  | UNKNOWN |  |  | assembly_drawing | сборочная единица | MEDIUM | doc_type:assembly | INVENTORIED_TEXT_ONLY
1) ААА Тех.отдел/1. ДЛЯ ДИРЕКТОРА (18.08)/В работу/25.SHT.G.00.00.00.00/25.SHT.G.00.00.00.00 СБ/Чертежи/Гибка/25.SHT.G.00.00.00.00 Гибка/25.SHT.G.07.01.00.01 Пластина крышки.pdf | 0815eba6f5da7d11b85a95aed28d1c9963cca37e731f6f8a2b8691fd4001a24d | 1 | True | 25.SHT.G.07.01.00.01 | Пластина крышки |  | UNKNOWN |  |  | assembly_drawing | сборочная единица | MEDIUM | doc_type:assembly | INVENTORIED_TEXT_ONLY
1) ААА Тех.отдел/1. ДЛЯ ДИРЕКТОРА (18.08)/В работу/25.SHT.G.00.00.00.00/25.SHT.G.00.00.00.00 СБ/Чертежи/Гибка/25.SHT.G.06.01.00.01 Пластина крышки.pdf | 06ad59c3d5793c8ff55cca90501b321961eef5a53be96ce3bec35bd4d002e41d | 1 | True | 25.SHT.G.06.01.00.01 | Пластина крышки |  | UNKNOWN |  |  | assembly_drawing | сборочная единица | MEDIUM | doc_type:assembly | INVENTORIED_TEXT_ONLY
1) ААА Тех.отдел/1. ДЛЯ ДИРЕКТОРА (18.08)/В работу/25.SHT.G.00.00.00.00/25.SHT.G.00.00.00.00 СБ/Чертежи/Гибка/25.SHT.G.07.01.00.01 Пластина крышки.pdf | 0815eba6f5da7d11b85a95aed28d1c9963cca37e731f6f8a2b8691fd4001a24d | 1 | True | 25.SHT.G.07.01.00.01 | Пластина крышки |  | UNKNOWN |  |  | assembly_drawing | сборочная единица | MEDIUM | doc_type:assembly | INVENTORIED_TEXT_ONLY
1) ААА Тех.отдел/1. ДЛЯ ДИРЕКТОРА (18.08)/В работу/25.SHT.G.00.00.00.00/25.SHT.G.00.00.00.00 СБ/Чертежи/Детали/25.SHT.G.00.00.00.00 Фланцы.pdf | 696efadd6d126a78eb38c7630d00b46b030e3592b66445218e7831a96f2efb4c | 1 | True | 25.SHT.G.00.00.00.00 | Фланцы |  | UNKNOWN |  |  | assembly_drawing | сборочная единица | MEDIUM | doc_type:assembly | INVENTORIED_TEXT_ONLY
1) ААА Тех.отдел/1. ДЛЯ ДИРЕКТОРА (18.08)/В работу/25.SHT.G.00.00.00.00/25.SHT.G.00.00.00.00 СБ/Чертежи/Детали/25.SHT.G.00.00.00.03 Резиновая прокладка к фланцам.pdf | a3a2423b717d5d99045948faab2a562eb8fe2ef3089f03a8c0cc8d47c8986f05 | 1 | True | 25.SHT.G.00.00.00.03 | Резиновая прокладка к фланцам |  | UNKNOWN |  |  | assembly_drawing | сборочная единица | MEDIUM | doc_type:assembly | INVENTORIED_TEXT_ONLY
1) ААА Тех.отдел/1. ДЛЯ ДИРЕКТОРА (18.08)/В работу/25.SHT.G.00.00.00.00/25.SHT.G.00.00.00.00 СБ/Чертежи/Детали/25.SHT.G.00.00.00.04 Резина проставка под крышкой.pdf | cda8db95ee453a43373d8eba39d3ee66ae16956bc5ba3619abb8aac0dafc7ed5 | 1 | True | 25.SHT.G.00.00.00.04 | Резина проставка под крышкой | Резина | CONFIRMED_IN_TEXT |  |  | assembly_drawing | сборочная единица | MEDIUM | doc_type:assembly | INVENTORIED_TEXT_ONLY
1) ААА Тех.отдел/1. ДЛЯ ДИРЕКТОРА (18.08)/В работу/25.SHT.G.00.00.00.00/25.SHT.G.00.00.00.00 СБ/Чертежи/Детали/25.SHT.G.00.00.00.05 Фланец наружний.pdf | 16076c1e44e3c1b0ae032d0a5eb7a7cf30494cdc9d8283eceb298c2a2169adee | 1 | True | 25.SHT.G.00.00.00.05 | Фланец наружний |  | UNKNOWN |  |  | assembly_drawing | сборочная единица | MEDIUM | doc_type:assembly | INVENTORIED_TEXT_ONLY
1) ААА Тех.отдел/1. ДЛЯ ДИРЕКТОРА (18.08)/В работу/25.SHT.G.00.00.00.00/25.SHT.G.00.00.00.00 СБ/Чертежи/Детали/25.SHT.G.01.00.00.04 Уголок.pdf | d8963b0233cf9a7b729d9b9099c569caca3826e8f8f235978f6b8e24c06d203b | 1 | True | 25.SHT.G.01.00.00.04 | Уголок |  | UNKNOWN |  |  | assembly_drawing | сборочная единица | MEDIUM | doc_type:assembly | INVENTORIED_TEXT_ONLY
1) ААА Тех.отдел/1. ДЛЯ ДИРЕКТОРА (18.08)/В работу/25.SHT.G.00.00.00.00/25.SHT.G.00.00.00.00 СБ/Чертежи/Детали/25.SHT.G.01.00.00.10 Труба.pdf | e3750a142d9571d5ad1ae990fd110b0b572285c7aab3eefd0e7c9ff0cd3c6665 | 1 | True | 25.SHT.G.01.00.00.10 | Труба |  | UNKNOWN |  |  | assembly_drawing | сборочная единица | MEDIUM | doc_type:assembly | INVENTORIED_TEXT_ONLY
1) ААА Тех.отдел/1. ДЛЯ ДИРЕКТОРА (18.08)/В работу/25.SHT.G.00.00.00.00/25.SHT.G.00.00.00.00 СБ/Чертежи/Детали/25.SHT.G.01.00.00.11 Труба.pdf | 909fa8dd10d2695da36a72c61a64b3ee130a0795defdce8df60c48577c36f61b | 1 | True | 25.SHT.G.01.00.00.11 | Труба |  | UNKNOWN |  |  | assembly_drawing | сборочная единица | MEDIUM | doc_type:assembly | INVENTORIED_TEXT_ONLY
1) ААА Тех.отдел/1. ДЛЯ ДИРЕКТОРА (18.08)/В работу/25.SHT.G.00.00.00.00/25.SHT.G.00.00.00.00 СБ/Чертежи/Детали/25.SHT.G.02.00.00.04 Торец.pdf | 47e43877ce12ce5c9d4cc57e6d6bd371fba37160ec946663304760d664d2d0fc | 1 | True | 25.SHT.G.02.00.00.04 | Торец | 09Г2С | CONFIRMED_IN_TEXT |  |  | assembly_drawing | сборочная единица | MEDIUM | doc_type:assembly | INVENTORIED_TEXT_ONLY
1) ААА Тех.отдел/1. ДЛЯ ДИРЕКТОРА (18.08)/В работу/25.SHT.G.00.00.00.00/25.SHT.G.00.00.00.00 СБ/Чертежи/Детали/25.SHT.G.03.00.00.04 Косынка.pdf | 7c33550c683862bd5fdedf0bdab4bca3bd33e9f623128183e3cfdc5f19c05a95 | 1 | True | 25.SHT.G.03.00.00.04 | Косынка |  | UNKNOWN |  |  | assembly_drawing | сборочная единица | MEDIUM | doc_type:assembly | INVENTORIED_TEXT_ONLY
1) ААА Тех.отдел/1. ДЛЯ ДИРЕКТОРА (18.08)/В работу/25.SHT.G.00.00.00.00/25.SHT.G.00.00.00.00 СБ/Чертежи/Детали/25.SHT.G.04.00.00.02 Труба фланца.pdf | 8a6d6faa308bb658281cc5c0bad4cc685e883aeef17b444f3b3498b3bfe656d6 | 1 | True | 25.SHT.G.04.00.00.02 | Труба фланца |  | UNKNOWN |  |  | assembly_drawing | сборочная единица | MEDIUM | doc_type:assembly | INVENTORIED_TEXT_ONLY
1) ААА Тех.отдел/1. ДЛЯ ДИРЕКТОРА (18.08)/В работу/25.SHT.G.00.00.00.00/25.SHT.G.00.00.00.00 СБ/Чертежи/Детали/25.SHT.G.05.00.00.01 Труба фланца.pdf | 5cf2333f7ab354d1aab2de3bb290fef86105cbbb7522923932d2b23527638400 | 1 | True | 25.SHT.G.05.00.00.01 | Труба фланца |  | UNKNOWN |  |  | assembly_drawing | сборочная единица | MEDIUM | doc_type:assembly | INVENTORIED_TEXT_ONLY
1) ААА Тех.отдел/1. ДЛЯ ДИРЕКТОРА (18.08)/В работу/25.SHT.G.00.00.00.00/25.SHT.G.00.00.00.00 СБ/Чертежи/Детали/25.SHT.G.08.00.00.01 Уголок.pdf | c38b7583aeead0e024bb9a800644a1f471117e77f58c99b7d720a4740abc9e29 | 1 | True | 25.SHT.G.08.00.00.01 | Уголок |  | UNKNOWN |  |  | assembly_drawing | сборочная единица | MEDIUM | doc_type:assembly | INVENTORIED_TEXT_ONLY
1) ААА Тех.отдел/1. ДЛЯ ДИРЕКТОРА (18.08)/В работу/25.SHT.G.00.00.00.00/25.SHT.G.00.00.00.00 СБ/Чертежи/Детали/25.SHT.G.08.00.00.02 Уголок.pdf | 1faede4f36db5175e2fe17d95e1215e8b93f0c48c1cde15ef84152ce68a31abb | 1 | True | 25.SHT.G.08.00.00.02 | Уголок |  | UNKNOWN |  |  | assembly_drawing | сборочная единица | MEDIUM | doc_type:assembly | INVENTORIED_TEXT_ONLY
1) ААА Тех.отдел/1. ДЛЯ ДИРЕКТОРА (18.08)/В работу/25.SHT.G.00.00.00.00/25.SHT.G.00.00.00.00 СБ/Чертежи/Детали/25.SHT.G.09.00.00.01 Перекладина.pdf | 31e9f8fed80cf88e1faccd1621cd73513a1a1f620de7c1230dd75b298e5d5eff | 1 | True | 25.SHT.G.09.00.00.01 | Перекладина |  | UNKNOWN |  |  | assembly_drawing | сборочная единица | MEDIUM | doc_type:assembly | INVENTORIED_TEXT_ONLY
1) ААА Тех.отдел/1. ДЛЯ ДИРЕКТОРА (18.08)/В работу/25.SHT.G.00.00.00.00/25.SHT.G.00.00.00.00 СБ/Чертежи/Детали/25.SHT.G.09.00.00.02 Пластина.pdf | 5ed8dffb443a8c58c3a8a19ed5b116c90ce2b562790bf166ab79caa429b82fc4 | 1 | True | 25.SHT.G.09.00.00.02 | Пластина |  | UNKNOWN |  |  | assembly_drawing | сборочная единица | MEDIUM | doc_type:assembly | INVENTORIED_TEXT_ONLY
1) ААА Тех.отдел/1. ДЛЯ ДИРЕКТОРА (18.08)/В работу/25.SHT.G.00.00.00.00/25.SHT.G.00.00.00.00 СБ/Чертежи/Детали/Лазерная резка 10 мм..pdf | 7730f92a74c9be8825d43a337555a92f18f86c74c133f4084071e4de05ae2551 | 1 | True | Лазерная | резка 10 мм. |  | UNKNOWN |  |  | assembly_drawing | сборочная единица | MEDIUM | doc_type:assembly | INVENTORIED_TEXT_ONLY
1) ААА Тех.отдел/1. ДЛЯ ДИРЕКТОРА (18.08)/В работу/25.SHT.G.00.00.00.00/25.SHT.G.00.00.00.00 СБ/Чертежи/Детали/Лазерная резка 3 мм..pdf | 86c701d19c35e1929c125bafe212e420e15b6932e9ea5d895ab672f6a022ec2d | 1 | True | Лазерная | резка 3 мм. | AISI 304 | CONFIRMED_IN_TEXT |  |  | assembly_drawing | сборочная единица | MEDIUM | doc_type:assembly | INVENTORIED_TEXT_ONLY
1) ААА Тех.отдел/1. ДЛЯ ДИРЕКТОРА (18.08)/В работу/25.SHT.G.00.00.00.00/25.SHT.G.00.00.00.00 СБ/Чертежи/Детали/Лазерная резка 6 мм. 2.pdf | 0c465435ffb2915636cf869e288e51c2ef423364361eb6e93a67885793118478 | 1 | True | Лазерная | резка 6 мм. 2 |  | UNKNOWN |  |  | assembly_drawing | сборочная единица | MEDIUM | doc_type:assembly | INVENTORIED_TEXT_ONLY
1) ААА Тех.отдел/1. ДЛЯ ДИРЕКТОРА (18.08)/В работу/25.SHT.G.00.00.00.00/25.SHT.G.00.00.00.00 СБ/Чертежи/Детали/Лазерная резка 6 мм. лист1.PDF | 2e34939c87dff80eb59723f41f55524b9cd7f533fe7ad1f2ca25ecc5427eb0e9 | 1 | True | Лазерная | резка 6 мм. лист1 |  | UNKNOWN |  |  | assembly_drawing | сборочная единица | MEDIUM | doc_type:assembly | INVENTORIED_TEXT_ONLY
1) ААА Тех.отдел/1. ДЛЯ ДИРЕКТОРА (18.08)/В работу/25.SHT.G.00.00.00.00/25.SHT.G.00.00.00.00 СБ/Чертежи/Детали/Лазерная резка 6 мм. лист2.PDF | 30d97e055a6e1c1febe347d650081dba862bfa9c1868b4c34bd13aea24bda7ba | 1 | True | Лазерная | резка 6 мм. лист2 |  | UNKNOWN |  |  | assembly_drawing | сборочная единица | MEDIUM | doc_type:assembly | INVENTORIED_TEXT_ONLY
1) ААА Тех.отдел/1. ДЛЯ ДИРЕКТОРА (18.08)/В работу/25.SHT.G.00.00.00.00/25.SHT.G.00.00.00.00 СБ/Чертежи/Заглушка.pdf | 4d771ad8e2ded35eb130638af04f172a076e277fb039a7b79c0c9ea55d8da43c | 1 | True | Заглушка |  |  | UNKNOWN |  |  | assembly_drawing | сборочная единица | MEDIUM | doc_type:assembly | INVENTORIED_TEXT_ONLY
1) ААА Тех.отдел/1. ДЛЯ ДИРЕКТОРА (18.08)/В работу/877 затвор как нулевой/877 Чертежи/.877.STP.00.00.00.00, 18.SK.00.00.00.00 Упаковочный чертеж.pdf | ca8eda9015e5062f8f6b9336d4304c2f16b57e352c8e80113d54a3d4dd8ae9ea | 2 | True | .877.STP.00.00.00.00, 18.SK.00.00.00.00 Упаковочный чертеж |  |  | UNKNOWN |  |  | part_drawing_candidate | плоская листовая деталь | MEDIUM | text_keyword:лист | INVENTORIED_TEXT_ONLY
1) ААА Тех.отдел/1. ДЛЯ ДИРЕКТОРА (18.08)/В работу/877 затвор как нулевой/877 Чертежи/877 Крепление шильда.pdf | c84efc3954ce49039f48d08d8dc71531e33fa07c1a6053cba9d2f5a766619aff | 1 | True | 877 Крепление шильда |  |  | UNKNOWN |  |  | part_drawing_candidate | плоская листовая деталь | MEDIUM | text_keyword:лист | INVENTORIED_TEXT_ONLY
1) ААА Тех.отдел/1. ДЛЯ ДИРЕКТОРА (18.08)/В работу/877 затвор как нулевой/877 Чертежи/Гибка/PDF/877.STP.01.01.01.01 Профиль боковой.pdf | c75c4f178b67082f4a440eb1158ceb9e106a1ac88114980269427164e0506c3d | 1 | True | 877.STP.01.01.01.01 | Профиль боковой |  | UNKNOWN |  |  | part_drawing_candidate | гнутая листовая деталь | MEDIUM | bent_sheet_signal | INVENTORIED_TEXT_ONLY
1) ААА Тех.отдел/1. ДЛЯ ДИРЕКТОРА (18.08)/В работу/877 затвор как нулевой/877 Чертежи/Гибка/PDF/877.STP.01.01.01.01-01 Профиль боковой.pdf | 0abf4aeab7ac0d9f49dd0d6c76e0d2e3d190f08899f9333d8df5d3ee4ded968c | 1 | True | 877.STP.01.01.01.01-01 | Профиль боковой |  | UNKNOWN |  |  | part_drawing_candidate | гнутая листовая деталь | MEDIUM | bent_sheet_signal | INVENTORIED_TEXT_ONLY
1) ААА Тех.отдел/1. ДЛЯ ДИРЕКТОРА (18.08)/В работу/877 затвор как нулевой/877 Чертежи/Гибка/PDF/877.STP.01.01.01.02 Профиль боковой.pdf | b61b91cd03c2802579218b6211163a9c8a562a84f40f06ef2f6217b7a97f92e6 | 1 | True | 877.STP.01.01.01.02 | Профиль боковой |  | UNKNOWN |  |  | part_drawing_candidate | гнутая листовая деталь | MEDIUM | bent_sheet_signal | INVENTORIED_TEXT_ONLY
1) ААА Тех.отдел/1. ДЛЯ ДИРЕКТОРА (18.08)/В работу/877 затвор как нулевой/877 Чертежи/Детали/PDF/877.ST.04.02.00.02 Удлинитель вала.pdf | cb8bccd2ad1c0a9b1ff6dcb1d92d137901d4324b3f09d19d05c975d8800ad82b | 1 | True | 877.ST.04.02.00.02 | Удлинитель вала |  | UNKNOWN |  |  | part_drawing_candidate | вал | MEDIUM | name_keyword:удлинитель | INVENTORIED_TEXT_ONLY
1) ААА Тех.отдел/1. ДЛЯ ДИРЕКТОРА (18.08)/В работу/877 затвор как нулевой/877 Чертежи/Детали/PDF/877.ST.06.00.00.01 Фторопласт.pdf | ac4666b826a7c6502f38bb787811dd15166d72fc04403d2d5a6d238e07224de6 | 1 | True | 877.ST.06.00.00.01 | Фторопласт | Фторопласт | CONFIRMED_IN_TEXT |  |  | part_drawing_candidate | покупное изделие | MEDIUM | name_keyword:фторопласт | INVENTORIED_TEXT_ONLY
1) ААА Тех.отдел/1. ДЛЯ ДИРЕКТОРА (18.08)/В работу/877 затвор как нулевой/877 Чертежи/Детали/PDF/877.ST.06.01.00.01 Вилка.pdf | ff1c7ac2a5504e6430c002fe3a243ded64e9b82e66ee8d0e09a2f1e5b748803a | 1 | True | 877.ST.06.01.00.01 | Вилка |  | UNKNOWN |  |  | part_drawing_candidate | вал | MEDIUM | name_keyword:вилка | INVENTORIED_TEXT_ONLY
1) ААА Тех.отдел/1. ДЛЯ ДИРЕКТОРА (18.08)/В работу/877 затвор как нулевой/877 Чертежи/Детали/PDF/877.ST.06.01.00.02 Пластина.pdf | 9f50f1795f107234b5a633149a6751745f7d9ea118c3ae1f061f6eeb194ee346 | 1 | True | 877.ST.06.01.00.02 | Пластина |  | UNKNOWN |  |  | part_drawing_candidate | плоская листовая деталь | MEDIUM | name_keyword:пластина | INVENTORIED_TEXT_ONLY
1) ААА Тех.отдел/1. ДЛЯ ДИРЕКТОРА (18.08)/В работу/877 затвор как нулевой/877 Чертежи/Детали/PDF/877.STP.01.01.00.07 Профиль средний.pdf | e4e2114b804c14bde0ec71546449d42c23d779417b5a164207d4962de070171e | 1 | True | 877.STP.01.01.00.07 | Профиль средний |  | UNKNOWN |  |  | part_drawing_candidate | плоская листовая деталь | MEDIUM | name_keyword:профиль | INVENTORIED_TEXT_ONLY
1) ААА Тех.отдел/1. ДЛЯ ДИРЕКТОРА (18.08)/В работу/877 затвор как нулевой/877 Чертежи/Детали/PDF/877.STP.01.01.02.01 Пластина передняя.pdf | 460452382a527e01878b52a4506870709a57c7bee9eaa89d94f0e7ee7390763a | 1 | True | 877.STP.01.01.02.01 | Пластина передняя |  | UNKNOWN |  |  | part_drawing_candidate | плоская листовая деталь | MEDIUM | name_keyword:пластина | INVENTORIED_TEXT_ONLY
1) ААА Тех.отдел/1. ДЛЯ ДИРЕКТОРА (18.08)/В работу/877 затвор как нулевой/877 Чертежи/Детали/PDF/877.STP.01.01.02.02 Пояс силовой.pdf | e19b47608fd2185f088a5b9c37c020fa12e43e0eb3fe6f2f53dc3b30a33e028d | 1 | True | 877.STP.01.01.02.02 | Пояс силовой |  | UNKNOWN |  |  | part_drawing_candidate | плоская листовая деталь | MEDIUM | text_keyword:лист | INVENTORIED_TEXT_ONLY
1) ААА Тех.отдел/1. ДЛЯ ДИРЕКТОРА (18.08)/В работу/877 затвор как нулевой/877 Чертежи/Детали/PDF/877.STP.02.00.00.05 Планка вертикальная.pdf | f9c98ce99cd627e3429f8022b26d3067ea0e42d2e00366f13ca55be3927995d7 | 1 | True | 877.STP.02.00.00.05 | Планка вертикальная |  | UNKNOWN |  |  | part_drawing_candidate | плоская листовая деталь | MEDIUM | name_keyword:планка | INVENTORIED_TEXT_ONLY
1) ААА Тех.отдел/1. ДЛЯ ДИРЕКТОРА (18.08)/В работу/877 затвор как нулевой/877 Чертежи/Детали/PDF/877.STP.02.00.00.06 Планка горизонтальная.pdf | 7415a50ec03b4e49d4f5ae8f97c391d7c4b1799fe46eb2fbfda8677a328f5581 | 1 | True | 877.STP.02.00.00.06 | Планка горизонтальная |  | UNKNOWN |  |  | part_drawing_candidate | плоская листовая деталь | MEDIUM | name_keyword:планка | INVENTORIED_TEXT_ONLY
1) ААА Тех.отдел/1. ДЛЯ ДИРЕКТОРА (18.08)/В работу/877 затвор как нулевой/877 Чертежи/Детали/PDF/877.STP.02.01.00.01 Лист щита.pdf | e27955ddfaa74f7c0aa931581cb05822c49aa3a3abc988762a39b47f21b45b3b | 1 | True | 877.STP.02.01.00.01 | Лист щита |  | UNKNOWN |  |  | part_drawing_candidate | плоская листовая деталь | MEDIUM | name_keyword:лист | INVENTORIED_TEXT_ONLY
1) ААА Тех.отдел/1. ДЛЯ ДИРЕКТОРА (18.08)/В работу/877 затвор как нулевой/877 Чертежи/Детали/PDF/877.STP.02.01.00.02 Ребро боковое.pdf | 5d927308aab767897de020f9c448a3e73d521801bfc05f9dfd98313358307d49 | 1 | True | 877.STP.02.01.00.02 | Ребро боковое |  | UNKNOWN |  |  | part_drawing_candidate | плоская листовая деталь | MEDIUM | name_keyword:ребро | INVENTORIED_TEXT_ONLY
1) ААА Тех.отдел/1. ДЛЯ ДИРЕКТОРА (18.08)/В работу/877 затвор как нулевой/877 Чертежи/Детали/PDF/877.STP.02.01.05.01 Косынка.pdf | 2e8fe379c57343ec129a3a8cf73a5defd6d35ee5f2487e40f28a5933ebaaa4ff | 1 | True | 877.STP.02.01.05.01 | Косынка |  | UNKNOWN |  |  | part_drawing_candidate | плоская листовая деталь | MEDIUM | name_keyword:косынка | INVENTORIED_TEXT_ONLY
1) ААА Тех.отдел/1. ДЛЯ ДИРЕКТОРА (18.08)/В работу/877 затвор как нулевой/877 Чертежи/Детали/PDF/Лазерная резка 2 877.STP.Щит капля.pdf | b8584d4fa16fbac1c16ac67e44e4061b26254e8dafaba62d19ca547ef7991a32 | 1 | True | Лазерная | резка 2 877.STP.Щит капля | AISI 304 | CONFIRMED_IN_TEXT |  |  | part_drawing_candidate | плоская листовая деталь | MEDIUM | name_keyword:щит | INVENTORIED_TEXT_ONLY
1) ААА Тех.отдел/1. ДЛЯ ДИРЕКТОРА (18.08)/В работу/877 затвор как нулевой/877 Чертежи/Детали/PDF/Лазерная резка 877.STP.Щит капля.pdf | e7ca720520576bdaa053abec7cca3d1663f36cca3bb51dfb80d6faa5bb8399f4 | 1 | True | Лазерная | резка 877.STP.Щит капля | AISI 304 | CONFIRMED_IN_TEXT |  |  | part_drawing_candidate | плоская листовая деталь | MEDIUM | name_keyword:щит | INVENTORIED_TEXT_ONLY
1) ААА Тех.отдел/1. ДЛЯ ДИРЕКТОРА (18.08)/В работу/877 затвор как нулевой/877 Чертежи/Нулевые элементы/00.ST.01.01.00.04 Ухо монтажное.pdf | 471238de9dde0e9438e7380e165c3e2271f2badfd28d5d1a32ab4653696bc5db | 1 | True | 00.ST.01.01.00.04 | Ухо монтажное |  | UNKNOWN |  |  | part_drawing_candidate | плоская листовая деталь | MEDIUM | name_keyword:ухо | INVENTORIED_TEXT_ONLY
1) ААА Тех.отдел/1. ДЛЯ ДИРЕКТОРА (18.08)/В работу/877 затвор как нулевой/877 Чертежи/Нулевые элементы/00.ST.06.00.00.01 Шайба.pdf | 93f30041d075c32dc1b250e31557838ef4c467919f40ff02530c4423018d741c | 1 | True | 00.ST.06.00.00.01 | Шайба |  | UNKNOWN |  |  | part_drawing_candidate | плоская листовая деталь | MEDIUM | name_keyword:шайба | INVENTORIED_TEXT_ONLY
1) ААА Тех.отдел/1. ДЛЯ ДИРЕКТОРА (18.08)/В работу/877 затвор как нулевой/877 Чертежи/Нулевые элементы/00.STP.01.01.02.03 Косынка.pdf | 17d20b2086530d83b935520a0a94bc79d38091b53a9b56a4f3279a151d757937 | 1 | True | 00.STP.01.01.02.03 | Косынка |  | UNKNOWN |  |  | part_drawing_candidate | плоская листовая деталь | MEDIUM | name_keyword:косынка | INVENTORIED_TEXT_ONLY
1) ААА Тех.отдел/1. ДЛЯ ДИРЕКТОРА (18.08)/В работу/877 затвор как нулевой/877 Чертежи/Нулевые элементы/STP.01.00.00.00 СБ Рама (установка подклинов).pdf | 0bc3d0133ffec020da35e8ce8a1bce6aab0bb8f29c320be0dc5f12a53d2184d5 | 1 | True | STP.01.00.00.00 | СБ Рама (установка подклинов) | Фторопласт | CONFIRMED_IN_TEXT |  |  | assembly_drawing | сборочная единица | MEDIUM | doc_type:assembly | INVENTORIED_TEXT_ONLY
1) ААА Тех.отдел/1. ДЛЯ ДИРЕКТОРА (18.08)/В работу/877 затвор как нулевой/877 Чертежи/Нулевые элементы/Колонка прямая/PDF/00.ST.03.04.00.01 Основание колонки.pdf | c2c77b705e39e6a72e59bc255be57eef5d66a107614487058ddfff1941d66ea7 | 1 | True | 00.ST.03.04.00.01 | Основание колонки | Ст3 | CONFIRMED_IN_TEXT |  |  | part_drawing_candidate | плоская деталь со сложным контуром | MEDIUM | name_keyword:основание | INVENTORIED_TEXT_ONLY
1) ААА Тех.отдел/1. ДЛЯ ДИРЕКТОРА (18.08)/В работу/877 затвор как нулевой/877 Чертежи/Нулевые элементы/Колонка прямая/PDF/00.ST.03.04.00.04 Косынка.pdf | 05f18f16870f2d26ed8b9c086c34a94ec12447e75d5576d34836aff1270f9cb6 | 1 | True | 00.ST.03.04.00.04 | Косынка | Ст3 | CONFIRMED_IN_TEXT |  |  | part_drawing_candidate | плоская листовая деталь | MEDIUM | name_keyword:косынка | INVENTORIED_TEXT_ONLY
1) ААА Тех.отдел/1. ДЛЯ ДИРЕКТОРА (18.08)/В работу/877 затвор как нулевой/877 Чертежи/Нулевые элементы/Колонка прямая/PDF/866.ST.03.04.00.03 Пластина верхняя.pdf | 062f380c2c849c5d1d1d4fe2914b20abaf6bc5a8fd96f59f80c7420f0cdb0807 | 1 | True | 866.ST.03.04.00.03 | Пластина верхняя | Ст3 | CONFIRMED_IN_TEXT |  |  | part_drawing_candidate | плоская листовая деталь | MEDIUM | name_keyword:пластина | INVENTORIED_TEXT_ONLY
1) ААА Тех.отдел/1. ДЛЯ ДИРЕКТОРА (18.08)/В работу/877 затвор как нулевой/877 Чертежи/Нулевые элементы/Колонка прямая/PDF/ST.03.04.00.00 СБ Колонка прямая.pdf | 9a2e87581104623e4b024750bff7d96711ebcf514d20457e7fb275f464f6e0ce | 1 | True | ST.03.04.00.00 | СБ Колонка прямая | Сталь 3 | CONFIRMED_IN_TEXT |  |  | assembly_drawing | сборочная единица | MEDIUM | doc_type:assembly | INVENTORIED_TEXT_ONLY
1) ААА Тех.отдел/1. ДЛЯ ДИРЕКТОРА (18.08)/В работу/877 затвор как нулевой/877 Чертежи/Нулевые элементы/Кронштейны NK/STP.01.01.03.00 СБ Кронштейн NK.PDF | e61466df3da3b6cd68fc29ce30a3d8059f2ac067f71c29415c2330ecfdc5c46f | 1 | True | STP.01.01.03.00 | СБ Кронштейн NK |  | UNKNOWN |  |  | assembly_drawing | сборочная единица | MEDIUM | doc_type:assembly | INVENTORIED_TEXT_ONLY
1) ААА Тех.отдел/1. ДЛЯ ДИРЕКТОРА (18.08)/В работу/877 затвор как нулевой/877 Чертежи/Нулевые элементы/Кронштейны NK/STP.01.01.04.00 СБ Кронштейн NK.PDF | bdb9c4e2b2fdf88a3a525f43cc56b3f21532d81fd7ba8de83a8afd7012b6ca4e | 1 | True | STP.01.01.04.00 | СБ Кронштейн NK |  | UNKNOWN |  |  | assembly_drawing | сборочная единица | MEDIUM | doc_type:assembly | INVENTORIED_TEXT_ONLY
1) ААА Тех.отдел/1. ДЛЯ ДИРЕКТОРА (18.08)/В работу/877 затвор как нулевой/877 Чертежи/Нулевые элементы/Кронштейны NK/Лазерная резка. 00.STP. Кронштейн NK.pdf | 7f8007b11b83f48ed695d6236e705a380c452b3837cebda289faed3be0e4853f | 1 | True | Лазерная | резка. 00.STP. Кронштейн NK |  | UNKNOWN |  |  | part_drawing_candidate | плоская деталь со сложным контуром | MEDIUM | name_keyword:кронштейн | INVENTORIED_TEXT_ONLY
1) ААА Тех.отдел/1. ДЛЯ ДИРЕКТОРА (18.08)/В работу/877 затвор как нулевой/877 Чертежи/Нулевые элементы/Кронштейны NK/Лазерная резка. 00.STP.Кронштейн NK.pdf | 226f25e35cb9051a943a34769e15bcda612a33a7c8981b89825b8627b63947c9 | 1 | True | Лазерная | резка. 00.STP.Кронштейн NK |  | UNKNOWN |  |  | part_drawing_candidate | плоская деталь со сложным контуром | MEDIUM | name_keyword:кронштейн | INVENTORIED_TEXT_ONLY
1) ААА Тех.отдел/1. ДЛЯ ДИРЕКТОРА (18.08)/В работу/877 затвор как нулевой/877 Чертежи/Нулевые элементы/Подклины рамы/PDF/00.STP. Подклин рамный центральный. Лазерная резка.pdf | 8328b9555cd678018d48bf5937f791cf2cc2c510b67a0e7c28036e68725ace94 | 1 | True | 00.STP. | Подклин рамный центральный. Лазерная резка |  | UNKNOWN |  |  | part_drawing_candidate | плоская деталь со сложным контуром | MEDIUM | name_keyword:подклин | INVENTORIED_TEXT_ONLY
1) ААА Тех.отдел/1. ДЛЯ ДИРЕКТОРА (18.08)/В работу/877 затвор как нулевой/877 Чертежи/Нулевые элементы/Подклины рамы/PDF/00.STP.01.01.06.00 СБ Подклин рамный центральный.pdf | c8c1b3e4453a2edf67f6a52c60747c8a58e9da6f94d12b4e546796001408e1ed | 1 | True | 00.STP.01.01.06.00 | СБ Подклин рамный центральный |  | UNKNOWN |  |  | assembly_drawing | сборочная единица | MEDIUM | doc_type:assembly | INVENTORIED_TEXT_ONLY
1) ААА Тех.отдел/1. ДЛЯ ДИРЕКТОРА (18.08)/В работу/877 затвор как нулевой/877 Чертежи/Нулевые элементы/Подклины рамы/PDF/00.STP.01.05.00.00 СБ Подклин рамный верхний.pdf | 3d72c6977dd5a044a19849baf6a12a546deea5a6a38ea41f85e1b11397818a50 | 1 | True | 00.STP.01.05.00.00 | СБ Подклин рамный верхний |  | UNKNOWN |  |  | assembly_drawing | сборочная единица | MEDIUM | doc_type:assembly | INVENTORIED_TEXT_ONLY
1) ААА Тех.отдел/1. ДЛЯ ДИРЕКТОРА (18.08)/В работу/877 затвор как нулевой/877 Чертежи/Нулевые элементы/Подклины рамы/PDF/00.STP.01.06.00.00 СБ Подклин рамный нижний.pdf | ebfa3f34ddbfe46c5fe0ab8b2776ccfc6ed7071c860f43f1c9c5131fdef7ca2a | 1 | True | 00.STP.01.06.00.00 | СБ Подклин рамный нижний |  | UNKNOWN |  |  | assembly_drawing | сборочная единица | MEDIUM | doc_type:assembly | INVENTORIED_TEXT_ONLY
1) ААА Тех.отдел/1. ДЛЯ ДИРЕКТОРА (18.08)/В работу/877 затвор как нулевой/877 Чертежи/Нулевые элементы/Подклины рамы/PDF/00.STP.02.01.02.00 СБ Подклин щита верхний.pdf | 0972a73bc82a833df18b96ca709b075788a1d58d232177e96e778b96e49888a6 | 1 | True | 00.STP.02.01.02.00 | СБ Подклин щита верхний |  | UNKNOWN |  |  | assembly_drawing | сборочная единица | MEDIUM | doc_type:assembly | INVENTORIED_TEXT_ONLY
1) ААА Тех.отдел/1. ДЛЯ ДИРЕКТОРА (18.08)/В работу/877 затвор как нулевой/877 Чертежи/Нулевые элементы/Подклины рамы/PDF/00.STP.02.01.04.00 СБ Подклин щита нижний.pdf | e68612eaa6a05135d81b3ac98cee0a7337e45a529ec158f7ec6d88fce2425354 | 1 | True | 00.STP.02.01.04.00 | СБ Подклин щита нижний |  | UNKNOWN |  |  | assembly_drawing | сборочная единица | MEDIUM | doc_type:assembly | INVENTORIED_TEXT_ONLY
1) ААА Тех.отдел/1. ДЛЯ ДИРЕКТОРА (18.08)/В работу/877 затвор как нулевой/877 Чертежи/Нулевые элементы/Подклины рамы/PDF/00.STP.02.01.05.00 СБ Подклин щита центральный.pdf | 5dfa40b79a567ab5ef54791f54cba34b933d4ce49f6e238faccf2a7c33df86ed | 1 | True | 00.STP.02.01.05.00 | СБ Подклин щита центральный | AISI 304 | CONFIRMED_IN_TEXT |  |  | assembly_drawing | сборочная единица | MEDIUM | doc_type:assembly | INVENTORIED_TEXT_ONLY
1) ААА Тех.отдел/1. ДЛЯ ДИРЕКТОРА (18.08)/В работу/877 затвор как нулевой/877 Чертежи/Нулевые элементы/Подклины рамы/PDF/STP.01.00.00.01 Фторопласт подклина.pdf | ead7c68b6a59e5566ff2e0bbc84bda094ef6180625f3ce3c7785ddb066840e25 | 1 | True | STP.01.00.00.01 | Фторопласт подклина | Фторопласт | CONFIRMED_IN_TEXT |  |  | part_drawing_candidate | покупное изделие | MEDIUM | name_keyword:фторопласт | INVENTORIED_TEXT_ONLY
1) ААА Тех.отдел/1. ДЛЯ ДИРЕКТОРА (18.08)/В работу/877 затвор как нулевой/877 Чертежи/Нулевые элементы/Подклины рамы/PDF/STP.02.00.00.07 Фторопласт подклина.pdf | be023fc85e039a41ed4905d747aa6397644aab6dabeeeec0044ba4d3dfd172fd | 1 | True | STP.02.00.00.07 | Фторопласт подклина | Фторопласт | CONFIRMED_IN_TEXT |  |  | part_drawing_candidate | покупное изделие | MEDIUM | name_keyword:фторопласт | INVENTORIED_TEXT_ONLY
1) ААА Тех.отдел/1. ДЛЯ ДИРЕКТОРА (18.08)/В работу/877 затвор как нулевой/877 Чертежи/Нулевые элементы/Подклины рамы/PDF/STP.02.00.00.08 Фторопласт.pdf | 1cac1a75e175988165e676b8a7d5a476fb90469adab49f3e79a592a289cb9310 | 1 | True | STP.02.00.00.08 | Фторопласт | Фторопласт | CONFIRMED_IN_TEXT |  |  | part_drawing_candidate | покупное изделие | MEDIUM | name_keyword:фторопласт | INVENTORIED_TEXT_ONLY
1) ААА Тех.отдел/1. ДЛЯ ДИРЕКТОРА (18.08)/В работу/877 затвор как нулевой/877 Чертежи/Нулевые элементы/Подклины рамы/PDF/Лазерная резка. 00.STP.Подклин щита верхний.pdf | fe84b3fac2dc8ba4272e84fd2e64115d69928265ff455d32cea22ccf5e4077f3 | 1 | True | Лазерная | резка. 00.STP.Подклин щита верхний |  | UNKNOWN |  |  | part_drawing_candidate | плоская деталь со сложным контуром | MEDIUM | name_keyword:подклин | INVENTORIED_TEXT_ONLY
1) ААА Тех.отдел/1. ДЛЯ ДИРЕКТОРА (18.08)/В работу/877 затвор как нулевой/877 Чертежи/Нулевые элементы/Подклины щита/00.STP.02.01.02.00 СБ Подклин щита верхний.pdf | 2a1fdc621f79ceaf066e78b715de3d829d344fc8f3612ac1f7bbd9af4f8d8a22 | 1 | True | 00.STP.02.01.02.00 | СБ Подклин щита верхний |  | UNKNOWN |  |  | assembly_drawing | сборочная единица | MEDIUM | doc_type:assembly | INVENTORIED_TEXT_ONLY
1) ААА Тех.отдел/1. ДЛЯ ДИРЕКТОРА (18.08)/В работу/877 затвор как нулевой/877 Чертежи/Нулевые элементы/Подклины щита/00.STP.02.01.04.00 СБ Подклин щита нижний.pdf | 2c55898f01760a0bfc4803dbf7f95dfda3e180c69c3b1ce8aba74807ca10be6e | 1 | True | 00.STP.02.01.04.00 | СБ Подклин щита нижний |  | UNKNOWN |  |  | assembly_drawing | сборочная единица | MEDIUM | doc_type:assembly | INVENTORIED_TEXT_ONLY
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
