hisp2k/parameters/engineering/transporter-calculators/screw_integration/cost_master_transporters_v4.xlsx

Sheet: Настройки
Ключ | Значение | Ед. | Статус / источник | Описание
vat_pct | 22 | % | Корпоративная настройка | НДС для расчета цены
target_margin_pct | 20 | % | Предварительное значение — редактировать | Рентабельность в цене: Цена = Себестоимость / (1 - r)
contingency_pct | 8 | % | Предварительное допущение | Резерв на неопределенность ранней стадии
procurement_overhead_pct | 3 | % | Предварительное допущение | Закупочные расходы от стоимости материалов/комплектующих
production_overhead_pct | 15 | % | Предварительное допущение | Производственные накладные от прямого труда
packaging_pct | 1.5 | % | Предварительное допущение | Упаковка от производственного подытога
warranty_risk_pct | 2 | % | Предварительное допущение | Гарантийный резерв
commissioning_reserve_pct | 2 | % | Предварительное допущение | Резерв ПНР
minimum_price_coverage_pct | 75 | % | Системное правило | Минимальное покрытие BOM ценами для ориентировочного КП
frame_steel_waste_pct | 8 | % | Предварительное допущение | Отход металла при расчете рамы
belt_length_reserve_pct | 3 | % | Предварительное допущение | Резерв длины ленты

Sheet: Ставки
Операция | Ставка, руб/нормо-ч | Источник | Примечание
Общая производственная | 0 | ЗАПОЛНИТЬ | Нулевая ставка не участвует в расчете
Заготовительные работы | 0 | ЗАПОЛНИТЬ | Нулевая ставка не участвует в расчете
Сварка рамы | 0 | ЗАПОЛНИТЬ | Нулевая ставка не участвует в расчете
Слесарная сборка | 0 | ЗАПОЛНИТЬ | Нулевая ставка не участвует в расчете
Установка роликов | 0 | ЗАПОЛНИТЬ | Нулевая ставка не участвует в расчете
Приводная станция | 0 | ЗАПОЛНИТЬ | Нулевая ставка не участвует в расчете
Натяжная станция | 0 | ЗАПОЛНИТЬ | Нулевая ставка не участвует в расчете
Монтаж и центровка ленты | 0 | ЗАПОЛНИТЬ | Нулевая ставка не участвует в расчете
Монтаж привода | 0 | ЗАПОЛНИТЬ | Нулевая ставка не участвует в расчете
Покраска | 0 | ЗАПОЛНИТЬ | Нулевая ставка не участвует в расчете
Электромонтаж | 0 | ЗАПОЛНИТЬ | Нулевая ставка не участвует в расчете
Пусконаладка | 0 | ЗАПОЛНИТЬ | Нулевая ставка не участвует в расчете
Регулировка/испытание | 0 | ЗАПОЛНИТЬ | Нулевая ставка не участвует в расчете

Sheet: Цены
Категория | Описание / типоразмер | Ед. | Цена, руб | Тип источника | Источник | URL | Дата цены | Примечание
steel_kg | Сталь конструкционная / 09Г2С или Ст3 | кг | 0 | missing | ЗАПОЛНИТЬ |  |  | База для расчетной стоимости рамы
belt | Лента конвейерная B=400 мм | м | 0 | missing | ЗАПОЛНИТЬ / онлайн
belt | Лента конвейерная B=500 мм | м | 0 | missing | ЗАПОЛНИТЬ / онлайн
belt | Лента конвейерная B=650 мм | м | 0 | missing | ЗАПОЛНИТЬ / онлайн
belt | Лента конвейерная B=800 мм | м | 0 | missing | ЗАПОЛНИТЬ / онлайн
idler_set | Роликоопора грузовая 3-роликовая | компл. | 0 | missing | ЗАПОЛНИТЬ / онлайн
roller | Ролик конвейерный типовой | шт | 0 | missing | ЗАПОЛНИТЬ / онлайн
drum | Барабан приводной | шт | 0 | missing | ЗАПОЛНИТЬ / онлайн
drum | Барабан хвостовой/натяжной | шт | 0 | missing | ЗАПОЛНИТЬ / онлайн
motor | Электродвигатель | шт | 0 | missing | ЗАПОЛНИТЬ / онлайн
gearbox | Редуктор | шт | 0 | missing | ЗАПОЛНИТЬ / онлайн
gearmotor | Электродвигатель/мотор-редуктор | шт | 0 | missing | ЗАПОЛНИТЬ / онлайн

Sheet: Нормы
Ключ нормы | Значение | Ед. | Основание / статус
belt_cut_h_m | 0.22 | нормо-ч/м | Предварительная модель v4; калибровать хронометражем
belt_weld_h_m | 0.45 | нормо-ч/м | Предварительная модель v4; калибровать хронометражем
belt_assembly_h_m | 0.35 | нормо-ч/м | Предварительная модель v4; калибровать хронометражем
belt_roller_h_pc | 0.1 | нормо-ч/шт | Предварительная модель v2/v3
belt_drive_h | 6 | нормо-ч | Предварительная модель v2/v3
belt_tension_h | 4 | нормо-ч | Предварительная модель v2/v3
belt_install_h_m | 0.12 | нормо-ч/м ленты | Предварительная модель v2/v3
belt_paint_h_m | 0.12 | нормо-ч/м | Предварительная модель v4
belt_electrical_base_h | 2 | нормо-ч | Предварительная модель v4
belt_electrical_h_m | 0.05 | нормо-ч/м | Предварительная модель v4
belt_commission_base_h | 2 | нормо-ч | Предварительная модель v4
belt_commission_h_m | 0.08 | нормо-ч/м | Предварительная модель v4
roller_cut_h_m | 0.2 | нормо-ч/м | Предварительная модель v4
roller_weld_h_m | 0.35 | нормо-ч/м | Предварительная модель v4
roller_assembly_h_m | 0.3 | нормо-ч/м | Предварительная модель v4
roller_install_h_pc | 0.12 | нормо-ч/шт | Предварительная модель v2/v3
roller_drive_h | 4 | нормо-ч | Предварительная модель v2/v3
roller_paint_h_m | 0.1 | нормо-ч/м | Предварительная модель v4
roller_electrical_h | 1.5 | нормо-ч | Предварительная модель v4
roller_adjustment_h_m | 0.15 | нормо-ч/м | Предварительная модель v2/v3

Sheet: Методика
Приоритет | Тип источника | Доверие | Правило
1 | corporate | Высокое | Корпоративный справочник предприятия — использовать первым
2 | supplier_quote | Высокое | Актуальное коммерческое предложение поставщика
3 | last_purchase | Высокое/среднее | Последняя фактическая закупка с контролем даты
4 | online_market | Среднее | Публичная онлайн-цена; сохранять URL и дату
5 | formula_estimate | Низкое/среднее | Расчетная оценка — использовать только для раннего ТКП
6 | missing | Нет | Цена отсутствует — строка снижает покрытие BOM
Важно |  |  | Старая производственная ставка не подставляется автоматически. Заполните ставки предприятия или используйте явную временную ставку в интерфейсе.
