hisp2k/parameters/screw-conveyors/01-PT-SHT/deliverables/Шнек 1 — аудит производственного комплекта/08_Сверка BOM и CAD.md

# Сверка проектной BOM и дерева CAD

**Проверка:** 02.10.2026 17:06 UTC+4. **Конфигурация:** `По умолчанию`. **Объект:** `PT.SHT.01.20.00.00 СБ 'Шнек 1'.SLDASM`.

- Строк проектной BOM: **59**; сумма количеств: **205**.
- Вхождений в дереве SolidWorks: **205**; разных нормализованных ключей: **59**.
- Построчных расхождений обозначения/количества после нормализации: **0**.
- Неразрешённых ссылок: **87 вхождений / 15 имён файлов**.

Метод: для обозначенных деталей и сборок сравнивался код `PT.SHT...`; для стандартных изделий — имя без пробелов, суффикса A2 и различий написания `DIN 127 B`/`DIN127` для одной выбранной шайбы. Нормализация не проверяет форму, материал, конфигурацию детали или пригодность замен. Совпадение общей суммы не подменяет эту построчную проверку.

## Неразрешённые пути

| Файл из ссылки сборки | Вхождений | Совпадающее имя в рабочем CAD | В указанной папке |
|---|---:|---|---|
| PT.SHT.01.01.00.11  Фланец присоединительный.SLDPRT | 1 | нет | нет |
| PT.SHT.01.01.02.03  Опора.SLDPRT | 2 | нет | нет |
| PT.SHT.01.21.00.07 'Сбрасыватель'.SLDPRT | 1 | да | да |
| Болт М10х90 DIN 933.SLDPRT | 2 | нет | нет |
| Болт М6х20 DIN 933 А2.SLDPRT | 8 | нет | нет |
| Болт М8х25 DIN 933.SLDPRT | 16 | нет | нет |
| Винт М12х30 DIN 931.SLDPRT | 1 | нет | нет |
| Винт М8х20 DIN 931.SLDPRT | 8 | нет | нет |
| Гайка М10 DIN 934.SLDPRT | 2 | нет | нет |
| Гайка М6 DIN 934.SLDPRT | 8 | нет | нет |
| Гайка М8 DIN 934.SLDPRT | 16 | нет | нет |
| Шайба пружинная М10 DIN128.SLDPRT | 4 | нет | нет |
| Шайба пружинная М12 DIN 128.SLDPRT | 1 | нет | нет |
| Шайба пружинная М6 DIN128.SLDPRT | 16 | нет | нет |
| Шпонка 8x7x63 ГОСТ 23360-78 DIN 6885.SLDPRT | 1 | нет | нет |

Сборка остаётся частичной. Внешний путь к «Сбрасывателю» пока не перепривязан; наличие файла с тем же именем не доказывает геометрическую идентичность без отдельной проверки.
