hisp2k/parameters/screw-conveyors/25-SHT-G/original-sources/source-order/25.SHT - Заказ №2377 Промстрой/25.SHT.G.00.00.00.00 СБ Изм.5/25.SHT.G.00.00.00.00 СБ/Описание конструкции шнекового транспортера.docx

1. Вальцованный PE высокой плотности с фрезерованными полосами. Крепление на метизы. При транспортировке волокнистого мусора. (расходный заменяемый материал)
2. Футеровка может быть из наваренной вальцованной металлической пластины. В вальцованных листах желоба не будет отверстий под футеровку.
3. Металлические полоски крепление на метизах, при грубых материалах транспортировки. (расходный заменяемый материал)

При изменении параметра, как будут меняться остальные

Толщина футеровки | Диаметр шнека | Диаметр вальцовки корпуса | Ширина крышки
увеличивается | стандартный | увеличивается | Увеличивается
уменьшается | стандартный | уменьшается | уменьшается

1. Отверстия для съемных перекладин в вальцованных листах делаются по месту после изготовления отсека (приварки вальцованных листов к уголкам).
2. Максимальная длина листа вальцовки корпуса 1000 мм. Толщина желоба от 3 мм (коррозия).
3. Лазерная резка вальцованных листов желоба: полки с запасом.
4. При изготовлении отсеков сначала изготавливается каркас, только потом вальцованные листы привариваются.
5. Отверстия в уголках для крепления крышки делаются по месту (по крышке). Отверстия для крепления перекладин вырезаются на лазере.
6. Толщина витка шнека зависит от того осевой или без осевой шнек.

Без осевой от 8 до 12 мм (гибочный станок для витков позволяет гнуть AISI 304 12 мм толщиной). Осевой от 3-4 мм.

7. Толщина листа крышки 2 мм.

Вопросы

1. Опоры, крепление на вертикальном участке, несколько шт
2. Редуктор крепится без фланца, то без проточки на ответном фланце. Вариант с фланцевым редуктором?
3. Узел с обоймой подшипниковой
4. Обслуживание подшипников, смазывание
