hisp2k/parameters/screw-conveyors/25-SHT-G/original-sources/source-order/25 транспортер.xlsx

Дерево спецификации
Наименование | Характеристика | Спецификация | Количество | Ед. изм.
25.SHT.G Шнековый транспортер SHT-G-PV2-L3000 |  | 25.SHT.G Шнековый транспортер SHT-G-PV2-L3000 | 1 | шт
25.SHT.G.01.00.00.00 Отсек |  | 25.SHT.G.01.00.00.00 Отсек | 1 | шт
25.SHT.G.01.01.00.00 Опора |  | 25.SHT.G.01.01.00.00 Опора | 2 | шт
25.SHT.G.01.01.00.01 Пластина |  | Лр № 2125|S=6мм|М= Aisi 304 | 2 | шт
Азот газообразный особой чистоты 2 сорт ГОСТ9293-74 (с изм.№1,2,3) 99,996% 40л |  |  | 22.1 | шт
Лист 6х1010х1330 Aisi 304 |  |  | 1 | шт
Лист 6х770х1550 Aisi 304 |  |  | 1 | шт
Лист 6х1500х1440 Aisi 304 |  |  | 1 | шт
Лазерный раскрой |  |  | 2.433 | ч
Отбивка окалин/кисловка/зачистка/резка |  |  | 3.317 | ч
25.SHT.G.01.01.00.02 Косынка |  | Лр № 2125|S=6мм|М= Aisi 304 | 4 | шт
Азот газообразный особой чистоты 2 сорт ГОСТ9293-74 (с изм.№1,2,3) 99,996% 40л |  |  | 22.1 | шт
Лист 6х1010х1330 Aisi 304 |  |  | 1 | шт
Лист 6х770х1550 Aisi 304 |  |  | 1 | шт
Лист 6х1500х1440 Aisi 304 |  |  | 1 | шт
Лазерный раскрой |  |  | 2.433 | ч
Отбивка окалин/кисловка/зачистка/резка |  |  | 3.317 | ч
25.SHT.G.01.01.00.03 Пластина крепления |  | Лр № 2125|S=6мм|М= Aisi 304 | 4 | шт
Азот газообразный особой чистоты 2 сорт ГОСТ9293-74 (с изм.№1,2,3) 99,996% 40л |  |  | 7.367 | шт
Лист 6х1010х1330 Aisi 304 |  |  | 0.333 | шт
Лист 6х770х1550 Aisi 304 |  |  | 0.333 | шт
Лист 6х1500х1440 Aisi 304 |  |  | 0.333 | шт
Лазерный раскрой |  |  | 0.811 | ч
Отбивка окалин/кисловка/зачистка/резка |  |  | 1.106 | ч
Сварочные работы |  |  | 0.734 | ч
Отбивка окалин/кисловка/зачистка/резка |  |  | 0.24 | ч
25.SHT.G.01.00.00.01 Желоб выгрузки |  |  | 1 | шт
25.SHT.G.01.00.00.02 Желоб |  |  | 1 | шт
25.SHT.G.01.00.00.03 Желоб |  |  | 1 | шт
25.SHT.G.01.00.00.04 Уголок |  | Уголок 50х50х4 на 25.SHT. | 1 | шт
Уголок 50х50х4 L=3300мм, Aisi 304, равнополочный ГОСТ 8509-93 |  |  | 2 | шт
Уголок 50х50х4 L=2710мм, Aisi 304, равнополочный ГОСТ 8509-93 |  |  | 1 | шт
Лентопил |  |  | 0.7 | ч
Отбивка окалин/кисловка/зачистка/резка |  |  | 0.283 | ч
25.SHT.G.01.00.00.04-01 Уголок |  | Уголок 50х50х4 на 25.SHT. | 1 | шт
Уголок 50х50х4 L=3300мм, Aisi 304, равнополочный ГОСТ 8509-93 |  |  | 2 | шт
Уголок 50х50х4 L=2710мм, Aisi 304, равнополочный ГОСТ 8509-93 |  |  | 1 | шт
Лентопил |  |  | 0.7 | ч
Отбивка окалин/кисловка/зачистка/резка |  |  | 0.283 | ч
25.SHT.G.01.00.00.05 Пластина |  | Лр № 2124|S=3мм|М= Aisi 304 | 2 | шт
Азот газообразный особой чистоты 2 сорт ГОСТ9293-74 (с изм.№1,2,3) 99,996% 40л |  |  | 2.4 | шт
Лист 3х850х1080 Aisi 304 |  |  | 1 | шт
Лист 3х800х1140 Aisi 304 |  |  | 1 | шт
Лист 3х1500х3000 Aisi 304 |  |  | 1 | шт
Лазерный раскрой |  |  | 0.767 | ч
Отбивка окалин/кисловка/зачистка/резка |  |  | 0.983 | ч
25.SHT.G.01.00.00.06 Пластина |  | Лр № 2124|S=3мм|М= Aisi 304 | 2 | шт
Азот газообразный особой чистоты 2 сорт ГОСТ9293-74 (с изм.№1,2,3) 99,996% 40л |  |  | 2.4 | шт
Лист 3х850х1080 Aisi 304 |  |  | 1 | шт
Лист 3х800х1140 Aisi 304 |  |  | 1 | шт
Лист 3х1500х3000 Aisi 304 |  |  | 1 | шт
Лазерный раскрой |  |  | 0.767 | ч
Отбивка окалин/кисловка/зачистка/резка |  |  | 0.983 | ч
25.SHT.G.01.00.00.08 Шпангоут |  | Лр № 2125|S=6мм|М= Aisi 304 | 3 | шт
Азот газообразный особой чистоты 2 сорт ГОСТ9293-74 (с изм.№1,2,3) 99,996% 40л |  |  | 22.1 | шт
Лист 6х1010х1330 Aisi 304 |  |  | 1 | шт
Лист 6х770х1550 Aisi 304 |  |  | 1 | шт
Лист 6х1500х1440 Aisi 304 |  |  | 1 | шт
Лазерный раскрой |  |  | 2.433 | ч
Отбивка окалин/кисловка/зачистка/резка |  |  | 3.317 | ч
25.SHT.G.01.00.00.09 Шпангоут |  | Лр № 2125|S=6мм|М= Aisi 304 | 1 | шт
Азот газообразный особой чистоты 2 сорт ГОСТ9293-74 (с изм.№1,2,3) 99,996% 40л |  |  | 22.1 | шт
Лист 6х1010х1330 Aisi 304 |  |  | 1 | шт
Лист 6х770х1550 Aisi 304 |  |  | 1 | шт
Лист 6х1500х1440 Aisi 304 |  |  | 1 | шт
Лазерный раскрой |  |  | 2.433 | ч
Отбивка окалин/кисловка/зачистка/резка |  |  | 3.317 | ч
25.SHT.G.01.00.00.10 Труба |  | 25.SHT.G.01.00.00.10 (11) Труба | 2 | шт
Труба 40х40х3, L=6000мм, Aisi 304, ГОСТ 32931-2015 |  |  | 1 | шт
Труба 40х40х3, L=1596мм, Aisi 304, ГОСТ 32931-2015 |  |  | 1 | шт
Лентопил |  |  | 0.35 | ч
25.SHT.G.01.00.00.11 Труба |  | 25.SHT.G.01.00.00.10 (11) Труба | 2 | шт
Труба 40х40х3, L=6000мм, Aisi 304, ГОСТ 32931-2015 |  |  | 1 | шт
Труба 40х40х3, L=1596мм, Aisi 304, ГОСТ 32931-2015 |  |  | 1 | шт
Лентопил |  |  | 0.35 | ч
Сварочные работы |  |  | 6.693 | ч
Отбивка окалин/кисловка/зачистка/резка |  |  | 1.819 | ч
25.SHT.G.02.00.00.00 Шнек с осями |  | 25.SHT.G.02.00.00.00 Шнек с осями | 1 | шт
25.SHT.G.02.00.00.02 Вал |  | 25.SHT.G.02.00.00.02 Вал | 1 | шт
Круг D80 L=310 09Г2С |  | Раскрой круга на 25.SHT | 1 | шт
Круг D80 L=3080 09Г2С |  |  | 1 | шт
Лентопил |  |  | 0.3 | ч
Токарная обработка |  |  | 0.736 | ч
25.SHT.G.02.00.00.03 Вал |  | 25.SHT.G.02.00.00.03 Вал | 1 | шт
Круг D80 L=365 09Г2С |  | Раскрой круга на 25.SHT | 1 | шт
Круг D80 L=3080 09Г2С |  |  | 1 | шт
Лентопил |  |  | 0.3 | ч
Токарная обработка |  |  | 1.02 | ч
Фрезерная обработка |  |  | 0.367 | ч
25.SHT.G.02.00.00.04 Торец |  | Лр № 2085|S=12мм|М=09Г2С | 2 | шт
Кислород газообразный технический 2сорт ГОСТ5583-78 (с изм.№ 1,2,3) 99,5% 40л |  |  | 0.2 | шт
Лист 12х240х860 09Г2С |  |  | 1 | шт
Лазерный раскрой |  |  | 0.233 | ч
Отбивка окалин/кисловка/зачистка/резка |  |  | 0.217 | ч
SHT.02.00.00.01 Перо D200 шаг 200 S12 Ст3 (пробное) |  | SHT.02.00.00.01 Перо D200 шаг 200 S12 09Г2С (пробное) | 2 | шт
SHT.02.00.00.01 Перо D200 шаг 200 S12 09Г2С (пробное) (заготовка) |  | Лр № 2074S=12мм|М=09Г2С | 2 | шт
Кислород газообразный технический 2сорт ГОСТ5583-78 (с изм.№ 1,2,3) 99,5% 40л |  |  | 2.2 | шт
Лист 12х1500х3000 09Г2С |  |  | 2 | шт
Лазерный раскрой |  |  | 0.066 | ч
Отбивка окалин/кисловка/зачистка/резка |  |  | 0.118 | ч
Гибка слесарная |  |  | 0.65 | ч
SHT.02.00.00.01 Перо D200 шаг 200 S12 09Г2С |  | SHT.02.00.00.01 Перо D200 шаг 200 S12 09Г2С | 14 | шт
SHT.02.00.00.01 Перо D200 шаг 200 S12 09Г2С (заготовка) |  |  | 14 | шт
Гибка слесарная |  |  | 4.55 | ч
Отбивка окалин/кисловка/зачистка/резка |  |  | 3.038 | ч
Сварочные работы |  |  | 18.03 | ч
Отбивка окалин/кисловка/зачистка/резка |  |  | 0.167 | ч
25.SHT.G.03.00.00.00 Фланец |  | 25.SHT.G.03.00.00.00 Фланец | 1 | шт
25.SHT.G.03.00.00.01 Пластина |  | Лр № 2125|S=6мм|М= Aisi 304 | 1 | шт
Азот газообразный особой чистоты 2 сорт ГОСТ9293-74 (с изм.№1,2,3) 99,996% 40л |  |  | 11.05 | шт
Лист 6х1010х1330 Aisi 304 |  |  | 0.5 | шт
Лист 6х770х1550 Aisi 304 |  |  | 0.5 | шт
Лист 6х1500х1440 Aisi 304 |  |  | 0.5 | шт
Лазерный раскрой |  |  | 1.217 | ч
Отбивка окалин/кисловка/зачистка/резка |  |  | 1.659 | ч
25.SHT.G.03.00.00.02 Фланец |  |  | 1 | шт
25.SHT.G.03.00.00.03 Обойма |  |  | 1 | шт
25.SHT.G.03.00.00.04 Косынка |  |  | 3 | шт
Сварочные работы |  |  | 1.23 | ч
Отбивка окалин/кисловка/зачистка/резка |  |  | 0.827 | ч
25.SHT.G.04.00.00.00 Фланец |  | 25.SHT.G.04.00.00.00 Фланец | 1 | шт
25.SHT.G.03.00.00.01 Пластина |  | Лр № 2125|S=6мм|М= Aisi 304 | 1 | шт
Азот газообразный особой чистоты 2 сорт ГОСТ9293-74 (с изм.№1,2,3) 99,996% 40л |  |  | 11.05 | шт
Лист 6х1010х1330 Aisi 304 |  |  | 0.5 | шт
Лист 6х770х1550 Aisi 304 |  |  | 0.5 | шт
Лист 6х1500х1440 Aisi 304 |  |  | 0.5 | шт
Лазерный раскрой |  |  | 1.217 | ч
Отбивка окалин/кисловка/зачистка/резка |  |  | 1.659 | ч
25.SHT.G.04.00.00.01 Фланец |  | Лр № 2125|S=6мм|М= Aisi 304 | 1 | шт
Азот газообразный особой чистоты 2 сорт ГОСТ9293-74 (с изм.№1,2,3) 99,996% 40л |  |  | 11.05 | шт
Лист 6х1010х1330 Aisi 304 |  |  | 0.5 | шт
Лист 6х770х1550 Aisi 304 |  |  | 0.5 | шт
Лист 6х1500х1440 Aisi 304 |  |  | 0.5 | шт
Лазерный раскрой |  |  | 1.217 | ч
Отбивка окалин/кисловка/зачистка/резка |  |  | 1.659 | ч
25.SHT.G.04.00.00.02 Труба фланца |  | Раскрой труб D219 на 25.SHT | 1 | шт
Труба D219, t=3мм, L=160, Aisi 304, ГОСТ 32528-2013 |  |  | 1 | шт
Труба D219, t=3мм, L=90, Aisi 304, ГОСТ 32528-2013 |  |  | 1 | шт
Лентопил |  |  | 0.3 | ч
25.SHT.G.04.00.00.03 Косынка |  | Лр № 2116|S=10мм|М= Aisi 304 | 4 | шт
Азот газообразный особой чистоты 2 сорт ГОСТ9293-74 (с изм.№1,2,3) 99,996% 40л |  |  | 5.3 | шт
Лист 10х370х1040 Aisi 304 |  |  | 1 | шт
Лазерный раскрой |  |  | 0.667 | ч
Отбивка окалин/кисловка/зачистка/резка |  |  | 0.333 | ч
25.SHT.G.04.00.00.04 Обойма |  |  | 1 | шт
Сварочные работы |  |  | 1.23 | ч
Отбивка окалин/кисловка/зачистка/резка |  |  | 0.827 | ч
25.SHT.G.05.00.00.00 Фланец соединительный |  | 25.SHT.G.05.00.00.00 Фланец соединительный | 1 | шт
25.SHT.G.05.00.00.01 Труба фланца |  | Раскрой труб D219 на 25.SHT | 1 | шт
Труба D219, t=3мм, L=160, Aisi 304, ГОСТ 32528-2013 |  |  | 1 | шт
Труба D219, t=3мм, L=90, Aisi 304, ГОСТ 32528-2013 |  |  | 1 | шт
Лентопил |  |  | 0.3 | ч
25.SHT.G.04.00.00.01 Фланец |  | Лр № 2125|S=6мм|М= Aisi 304 | 1 | шт
Азот газообразный особой чистоты 2 сорт ГОСТ9293-74 (с изм.№1,2,3) 99,996% 40л |  |  | 11.05 | шт
Лист 6х1010х1330 Aisi 304 |  |  | 0.5 | шт
Лист 6х770х1550 Aisi 304 |  |  | 0.5 | шт
Лист 6х1500х1440 Aisi 304 |  |  | 0.5 | шт
Лазерный раскрой |  |  | 1.217 | ч
Отбивка окалин/кисловка/зачистка/резка |  |  | 1.659 | ч
25.SHT.G.05.00.00.02 Фланец редуктора |  | Лр № 2125|S=6мм|М= Aisi 304 | 1 | шт
Азот газообразный особой чистоты 2 сорт ГОСТ9293-74 (с изм.№1,2,3) 99,996% 40л |  |  | 22.1 | шт
Лист 6х1010х1330 Aisi 304 |  |  | 1 | шт
Лист 6х770х1550 Aisi 304 |  |  | 1 | шт
Лист 6х1500х1440 Aisi 304 |  |  | 1 | шт
Лазерный раскрой |  |  | 2.433 | ч
Отбивка окалин/кисловка/зачистка/резка |  |  | 3.317 | ч
25.SHT.G.05.00.00.03 Косынка |  | Лр № 2116|S=10мм|М= Aisi 304 | 6 | шт
Азот газообразный особой чистоты 2 сорт ГОСТ9293-74 (с изм.№1,2,3) 99,996% 40л |  |  | 5.3 | шт
Лист 10х370х1040 Aisi 304 |  |  | 1 | шт
Лазерный раскрой |  |  | 0.667 | ч
Отбивка окалин/кисловка/зачистка/резка |  |  | 0.333 | ч
Сварочные работы |  |  | 1.186 | ч
Отбивка окалин/кисловка/зачистка/резка |  |  | 0.35 | ч
25.SHT.G.06.00.00.00 Крышка |  | 25.SHT.G.06.00.00.00 Крышка | 1 | шт
25.SHT.G.06.01.00.00 Крышка |  | 25.SHT.G.06.01.00.00 Крышка | 1 | шт
25.SHT.G.06.01.00.01 Пластина крышки |  |  | 1 | шт
25.SHT.G.06.01.00.02 Пластина горловины |  | Лр № 2124|S=3мм|М= Aisi 304 | 2 | шт
Азот газообразный особой чистоты 2 сорт ГОСТ9293-74 (с изм.№1,2,3) 99,996% 40л |  |  | 1.2 | шт
Лист 3х850х1080 Aisi 304 |  |  | 0.5 | шт
Лист 3х800х1140 Aisi 304 |  |  | 0.5 | шт
Лист 3х1500х3000 Aisi 304 |  |  | 0.5 | шт
Лазерный раскрой |  |  | 0.384 | ч
Отбивка окалин/кисловка/зачистка/резка |  |  | 0.492 | ч
25.SHT.G.06.01.00.03 Пластина горловины |  | Лр № 2124|S=3мм|М= Aisi 304 | 2 | шт
Азот газообразный особой чистоты 2 сорт ГОСТ9293-74 (с изм.№1,2,3) 99,996% 40л |  |  | 1.2 | шт
Лист 3х850х1080 Aisi 304 |  |  | 0.5 | шт
Лист 3х800х1140 Aisi 304 |  |  | 0.5 | шт
Лист 3х1500х3000 Aisi 304 |  |  | 0.5 | шт
Лазерный раскрой |  |  | 0.384 | ч
Отбивка окалин/кисловка/зачистка/резка |  |  | 0.492 | ч
Сварочные работы |  |  | 1.01 | ч
Отбивка окалин/кисловка/зачистка/резка |  |  | 0.255 | ч
Ручка РП-01-100 (черная) |  |  | 2 | шт
Винт М6х20 А2 с потайной головкой с крестообразным шлицем с полной резьбой ГОСТ 17475-80, ISO 7046, |  |  | 4 | шт
Гайка М6 А2 ГОСТ 5915-70, ISO 4032, ISO 4033, DIN 934 |  |  | 4 | шт
Шайба М6 А2 плоская ГОСТ 11371-78, ISO 7089, DIN 125 |  |  | 4 | шт
Слесарные работы (сборка) |  |  | 0.16 | ч
25.SHT.G.07.00.00.00 Крышка |  | 25.SHT.G.07.00.00.00 Крышка | 1 | шт
25.SHT.G.07.01.00.00 Крышка |  | 25.SHT.G.07.01.00.00 Крышка | 1 | шт
25.SHT.G.07.01.00.01 Пластина крышки |  |  | 1 | шт
25.SHT.G.06.01.00.02 Пластина горловины |  | Лр № 2124|S=3мм|М= Aisi 304 | 2 | шт
Азот газообразный особой чистоты 2 сорт ГОСТ9293-74 (с изм.№1,2,3) 99,996% 40л |  |  | 1.2 | шт
Лист 3х850х1080 Aisi 304 |  |  | 0.5 | шт
Лист 3х800х1140 Aisi 304 |  |  | 0.5 | шт
Лист 3х1500х3000 Aisi 304 |  |  | 0.5 | шт
Лазерный раскрой |  |  | 0.384 | ч
Отбивка окалин/кисловка/зачистка/резка |  |  | 0.492 | ч
25.SHT.G.06.01.00.03 Пластина горловины |  | Лр № 2124|S=3мм|М= Aisi 304 | 2 | шт
Азот газообразный особой чистоты 2 сорт ГОСТ9293-74 (с изм.№1,2,3) 99,996% 40л |  |  | 1.2 | шт
Лист 3х850х1080 Aisi 304 |  |  | 0.5 | шт
Лист 3х800х1140 Aisi 304 |  |  | 0.5 | шт
Лист 3х1500х3000 Aisi 304 |  |  | 0.5 | шт
Лазерный раскрой |  |  | 0.384 | ч
Отбивка окалин/кисловка/зачистка/резка |  |  | 0.492 | ч
Сварочные работы |  |  | 1.01 | ч
Отбивка окалин/кисловка/зачистка/резка |  |  | 0.255 | ч
Ручка РП-01-100 (черная) |  |  | 2 | шт
Винт М6х20 А2 с потайной головкой с крестообразным шлицем с полной резьбой ГОСТ 17475-80, ISO 7046, |  |  | 4 | шт
Гайка М6 А2 ГОСТ 5915-70, ISO 4032, ISO 4033, DIN 934 |  |  | 4 | шт
Шайба М6 А2 плоская ГОСТ 11371-78, ISO 7089, DIN 125 |  |  | 4 | шт
Слесарные работы (сборка) |  |  | 0.16 | ч
25.SHT.G.08.00.00.00 Опора |  | 25.SHT.G.08.00.00.00 Опора | 2 | шт
25.SHT.G.08.00.00.01 Уголок |  | Уголок 50х50х4 на 25.SHT. | 4 | шт
Уголок 50х50х4 L=3300мм, Aisi 304, равнополочный ГОСТ 8509-93 |  |  | 2 | шт
Уголок 50х50х4 L=2710мм, Aisi 304, равнополочный ГОСТ 8509-93 |  |  | 1 | шт
Лентопил |  |  | 0.7 | ч
Отбивка окалин/кисловка/зачистка/резка |  |  | 0.283 | ч
25.SHT.G.08.00.00.02 Уголок |  | Уголок 50х50х4 на 25.SHT. | 2 | шт
Уголок 50х50х4 L=3300мм, Aisi 304, равнополочный ГОСТ 8509-93 |  |  | 2 | шт
Уголок 50х50х4 L=2710мм, Aisi 304, равнополочный ГОСТ 8509-93 |  |  | 1 | шт
Лентопил |  |  | 0.7 | ч
Отбивка окалин/кисловка/зачистка/резка |  |  | 0.283 | ч
25.SHT.G.01.01.00.03 Пластина крепления |  | Лр № 2125|S=6мм|М= Aisi 304 | 8 | шт
Азот газообразный особой чистоты 2 сорт ГОСТ9293-74 (с изм.№1,2,3) 99,996% 40л |  |  | 14.733 | шт
Лист 6х1010х1330 Aisi 304 |  |  | 0.667 | шт
Лист 6х770х1550 Aisi 304 |  |  | 0.667 | шт
Лист 6х1500х1440 Aisi 304 |  |  | 0.667 | шт
Лазерный раскрой |  |  | 1.622 | ч
Отбивка окалин/кисловка/зачистка/резка |  |  | 2.211 | ч
Сварочные работы |  |  | 1.34 | ч
Отбивка окалин/кисловка/зачистка/резка |  |  | 0.46 | ч
25.SHT.G.09.00.00.00 Перекладина съемная |  | 25.SHT.G.09.00.00.00 Перекладина съемная | 4 | шт
25.SHT.G.09.00.00.01 Перекладина |  | 25.SHT.G.09.00.00.01 Перекладина | 4 | шт
Труба 30х30х3, L=3390мм, Aisi 304, ГОСТ 32931-2015 |  |  | 1 | шт
Лентопил |  |  | 0.2 | ч
25.SHT.G.09.00.00.02 Пластина |  | Лр № 2117|S=4мм|М= Aisi 304 | 8 | шт
Азот газообразный особой чистоты 2 сорт ГОСТ9293-74 (с изм.№1,2,3) 99,996% 40л |  |  | 12.7 | шт
Лист 4х1500х6000 Aisi 304 |  |  | 1 | шт
Лазерный раскрой |  |  | 1.368 | ч
Отбивка окалин/кисловка/зачистка/резка |  |  | 3.25 | ч
Сварочные работы |  |  | 1.4 | ч
Отбивка окалин/кисловка/зачистка/резка |  |  | 0.88 | ч
25.SHT.G.00.00.00.01 Футеровка - заготовка |  |  | 2 | шт
25.SHT.G.00.00.00.02 Футеровка - заготовка |  |  | 1 | шт
25.SHT.G.00.00.00.03 Резиновая прокладка к фланцам |  | Раскрой ТМКЩ на 25.SHT | 1 | шт
Тех. пластина ТМКЩ-С 2х990х3040 |  |  | 1 | шт
Раскрой РТИ |  |  | 1.167 | ч
Сверловка/зенкование/нарезание резьбы |  |  | 0.99 | ч
25.SHT.G.00.00.00.04 Резина проставка под крышкой |  | Раскрой ТМКЩ на 25.SHT | 2 | шт
Тех. пластина ТМКЩ-С 2х990х3040 |  |  | 1 | шт
Раскрой РТИ |  |  | 1.167 | ч
Сверловка/зенкование/нарезание резьбы |  |  | 0.99 | ч
25.SHT.G.00.00.00.05 Фланец наружний |  |  | 1 | шт
25.SHT.G.00.00.00.06 Вал редуктора |  | 25.SHT.G.00.00.00.06 Вал редуктора | 1 | шт
Круг D80 L=305 09Г2С |  | Раскрой круга на 25.SHT | 1 | шт
Круг D80 L=3080 09Г2С |  |  | 1 | шт
Лентопил |  |  | 0.3 | ч
Токарная обработка |  |  | 1.434 | ч
Фрезерная обработка |  |  | 0.917 | ч
25.SHT.G.00.00.00.07 Стопорная шайба редутора |  | Лр № 2124|S=3мм|М= Aisi 304 | 1 | шт
Азот газообразный особой чистоты 2 сорт ГОСТ9293-74 (с изм.№1,2,3) 99,996% 40л |  |  | 2.4 | шт
Лист 3х850х1080 Aisi 304 |  |  | 1 | шт
Лист 3х800х1140 Aisi 304 |  |  | 1 | шт
Лист 3х1500х3000 Aisi 304 |  |  | 1 | шт
Лазерный раскрой |  |  | 0.767 | ч
Отбивка окалин/кисловка/зачистка/резка |  |  | 0.983 | ч
25.SHT.G.00.00.00.08 Проставочное кольцо подшипника |  | 25.SHT.G.00.00.00.08 Проставочное кольцо подшипника | 2 | шт
25.SHT.G.00.00.00.08 Проставочное кольцо подшипника (заготовка) |  | Лр № 2124|S=3мм|М= Aisi 304 | 2 | шт
Азот газообразный особой чистоты 2 сорт ГОСТ9293-74 (с изм.№1,2,3) 99,996% 40л |  |  | 2.4 | шт
Лист 3х850х1080 Aisi 304 |  |  | 1 | шт
Лист 3х800х1140 Aisi 304 |  |  | 1 | шт
Лист 3х1500х3000 Aisi 304 |  |  | 1 | шт
Лазерный раскрой |  |  | 0.767 | ч
Отбивка окалин/кисловка/зачистка/резка |  |  | 0.983 | ч
Отбивка окалин/кисловка/зачистка/резка |  |  | 0.134 | ч
25.SHT.G.00.00.00.09 Резиновая проставка отсеков |  | Раскрой ТМКЩ на 25.SHT | 2 | шт
Тех. пластина ТМКЩ-С 2х990х3040 |  |  | 1 | шт
Раскрой РТИ |  |  | 1.167 | ч
Сверловка/зенкование/нарезание резьбы |  |  | 0.99 | ч
Кольцо стопорное D=120 ГОСТ 13943-86, DIN 472, внутреннее |  |  | 2 | шт
Кольцо стопорное D=100 ГОСТ 13943-86, DIN 472, внутреннее |  |  | 2 | шт
Кольцо стопорное D=65 ГОСТ 13942-86, DIN 471, наружное |  |  | 2 | шт
Подшипник 46213 ГОСТ 831-75 (7213-АСМ)(7213-ACD) |  |  | 4 | шт
Мотор-редуктор FA87-88.01-16-3.0-М1 |  |  | 1 | шт
Манжета 2.2 75х100 ГОСТ 8752-79, резиновая армированная |  |  | 2 | шт
Шпонка 18х11х110 призматическая тип А со скругленными торцами без отверстий ГОСТ 23360-78, ISO 2491, |  | Шпонка 18х11х110 призматическая тип А со скругленными торцами без отверстий ГОСТ 23360-78, ISO 2491, | 1 | шт
Сталь шпоночная 18х11 L=150 Ст45 ГОСТ 8787-68 |  |  | 1 | шт
Отбивка окалин/кисловка/зачистка/резка |  |  | 0.2 | ч
Шпонка 16х10х40 призматическая тип А со скругленными торцами без отверстий ГОСТ 23360-78, ISO 2491, |  | Шпонка 16х10х40 призматическая тип А со скругленными торцами без отверстий ГОСТ 23360-78, ISO 2491, | 1 | шт
Шпонка 18х11х63 призматическая тип А со скругленными торцами без отверстий ГОСТ 23360-78, ISO 2491, |  |  | 1 | шт
Фрезерная обработка |  |  | 0.417 | ч
Шпонка 14х9х40 призматическая тип А со скругленными торцами без отверстий ГОСТ 23360-78, ISO 2491, D |  | Шпонка 14х9х40 призматическая тип А со скругленными торцами без отверстий ГОСТ 23360-78, ISO 2491, D | 1 | шт
Шпонка 14х9х56 призматическая тип А со скругленными торцами без отверстий ГОСТ 23360-78, ISO 2491, D |  |  | 1 | шт
Отбивка окалин/кисловка/зачистка/резка |  |  | 0.283 | ч
Гайка М16 ОЦ с фланцем ГОСТ Р 50592-93, ISO 10663, EN 1661, DIN 6923 |  |  | 27 | шт
Шайба М16 ОЦ плоская ГОСТ 11371-78, ISO 7089, DIN 125 |  | Лр № 1788|S=3мм|М=AISI 304 04-05.SHT | 33 | шт
Лист 3х100х150 Aisi 304 |  |  | 4.125 | шт
Азот газообразный особой чистоты 2 сорт ГОСТ9293-74 (с изм.№1,2,3) 99,996% 40л |  |  | 2.475 | шт
Лазерный раскрой |  |  | 0.689 | ч
Отбивка окалин/кисловка/зачистка/резка |  |  | 1.992 | ч
Болт М16х50 ОЦ с неполной резьбой ГОСТ 7798-70, ISO 4014, DIN 931 5.8 |  |  | 27 | шт
Шайба М16 ОЦ пружинная гровер ГОСТ 6402-70, DIN 127 |  |  | 34 | шт
Винт М16х40 ОЦ высокопрочный с цилиндрической головкой и внутрен шестигранником полн/р ГОСТ 11738-84 |  |  | 6 | шт
Болт М8х25 А2 с полной резьбой ГОСТ 7798-70, ISO 4017, DIN 933 |  |  | 16 | шт
Шайба М8 А2 плоская ГОСТ 11371-78, ISO 7089, DIN 125 |  | Лр № 1787|S=1,5мм|М=AISI 304 04-05.SHT | 32 | шт
Лист 1,5х260х380 Aisi 304 |  |  | 0.188 | шт
Азот газообразный особой чистоты 2 сорт ГОСТ9293-74 (с изм.№1,2,3) 99,996% 40л |  |  | 0.056 | шт
Лазерный раскрой |  |  | 0.031 | ч
Отбивка окалин/кисловка/зачистка/резка |  |  | 0.166 | ч
Гайка М8 А2 с фланцем ГОСТ Р 50592-93, ISO 10663, EN 1661, DIN 6923 |  |  | 32 | шт
Гайка М6 А2 ГОСТ 5915-70, ISO 4032, ISO 4033, DIN 934 |  |  | 36 | шт
Шайба М6 А2 плоская ГОСТ 11371-78, ISO 7089, DIN 125 |  |  | 36 | шт
Винт М6х20 А2 с потайной головкой и внутренним шестигранником ISO 10642, DIN 7991 |  |  | 36 | шт
Муфта кулачковая GE42-1а диаметр отверстия 12 мм |  |  | 1 | шт
Болт М8х30 А2 с полной резьбой ГОСТ 7798-70, ISO 4017, DIN 933 |  |  | 16 | шт
Шайба М8 А2 пружинная гровер ГОСТ 6402-70, DIN 127 |  |  | 16 | шт
Сверловка/зенкование/нарезание резьбы |  |  | 0.733 | ч
Слесарные работы (сборка) |  |  | 9.05 | ч
Ответственный
