hisp2k/parameters/containers/deliverables/bin_075m3.SLDASM

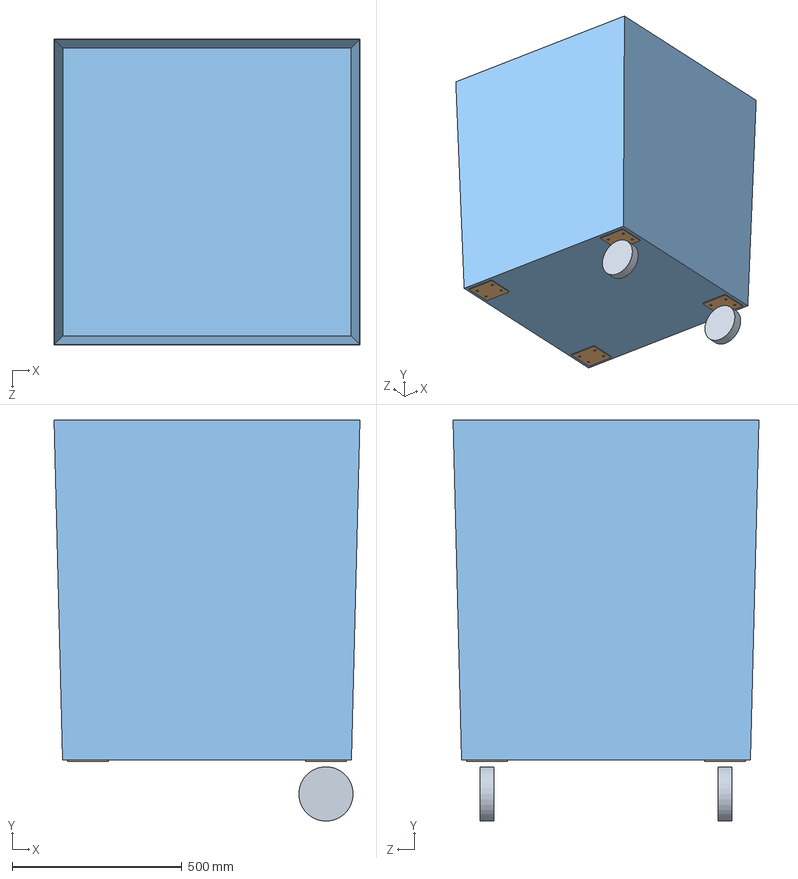
[picture p43: CAD file, 2026-10-06]
containers/deliverables/bin_075m3.SLDASM
900.0 x 1179.6 x 900.0 mm
bin_body
mount_plate_120x120x4 x 4
wheel_swivel_D160 x 2
