hisp2k/parameters/grit-chambers/parametric/deliverables/grit_chamber/01_CAD/GRIT_PILOT_BASE_FULL_TEST.SLDPRT

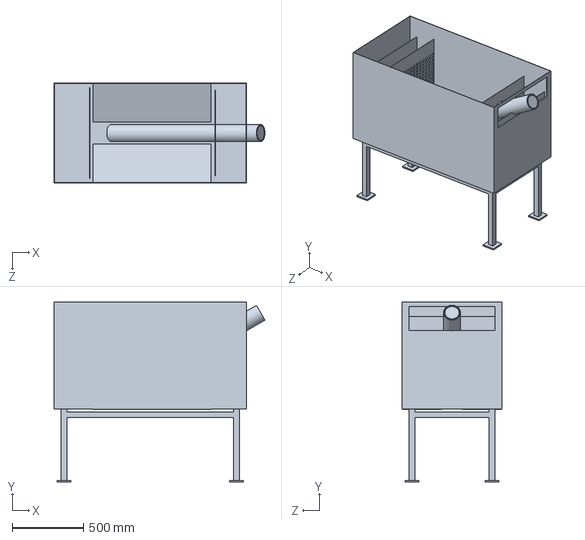
[picture p44: CAD file, 2026-10-06]
grit-chambers/parametric/deliverables/grit_chamber/01_CAD/GRIT_PILOT_BASE_FULL_TEST.SLDPRT
1480.0 x 1260.0 x 700.0 mm
