hisp2k/parameters/belt-conveyors/flat-LT500/deliverables/Ленточный_транспортер/03_Модели_SolidWorks/ЛТ500_Наклонные_седла_узел_стыка_R05.SLDPRT

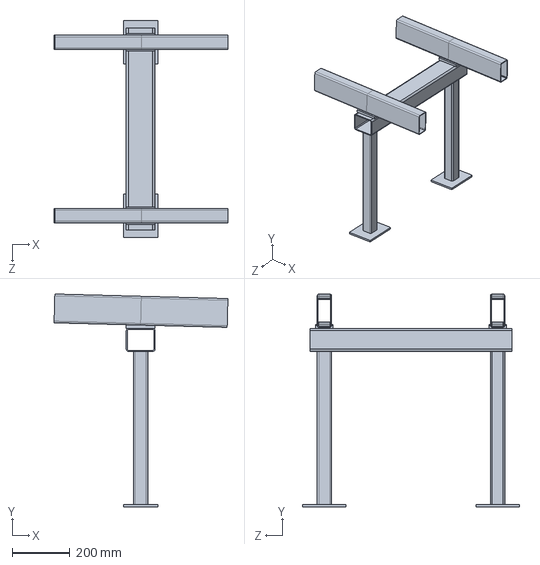
[picture p45: CAD file, 2026-10-06]
belt-conveyors/flat-LT500/deliverables/Ленточный_транспортер/03_Модели_SolidWorks/ЛТ500_Наклонные_седла_узел_стыка_R05.SLDPRT
602.4 x 737.8 x 750.0 mm
