hisp2k/parameters/belt-conveyors/trough-LT500/deliverables/История_R10/Ленточный_транспортер/03_Модели_SolidWorks/ЛТ500_Ролики_зоны_загрузки_R09.SLDPRT

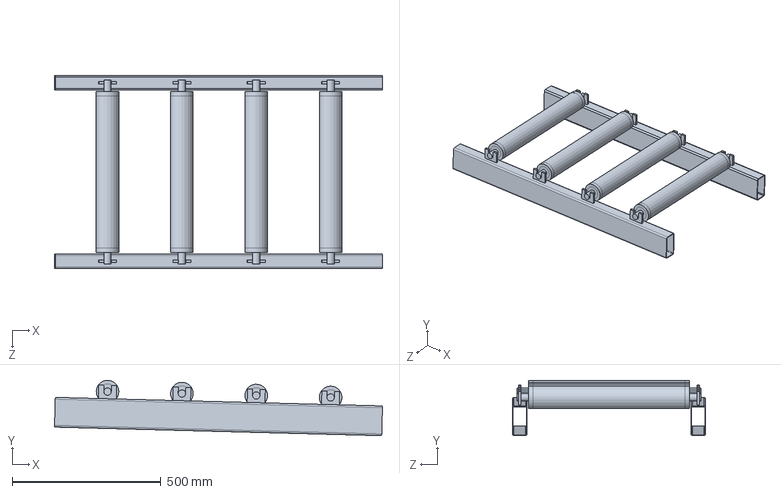
[picture p46: CAD file, 2026-10-06]
belt-conveyors/trough-LT500/deliverables/История_R10/Ленточный_транспортер/03_Модели_SolidWorks/ЛТ500_Ролики_зоны_загрузки_R09.SLDPRT
1102.2 x 186.1 x 650.0 mm
