hisp2k/parameters/containers/deliverables/0_22/wheel_fixed_D125.SLDPRT

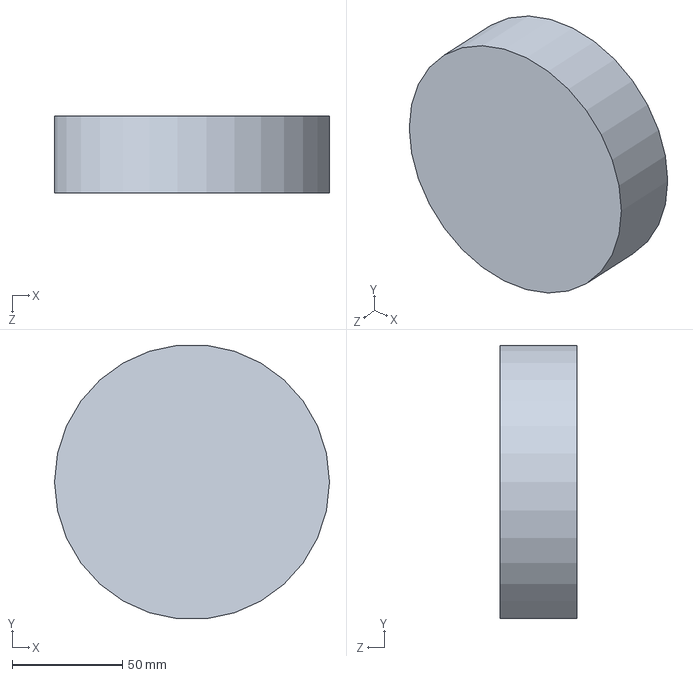
[picture p47: CAD file, 2026-10-06]
containers/deliverables/0_22/wheel_fixed_D125.SLDPRT
125.0 x 124.3 x 35.0 mm
