hisp2k/parameters/containers/deliverables/cut_front_back_2mm.dxf

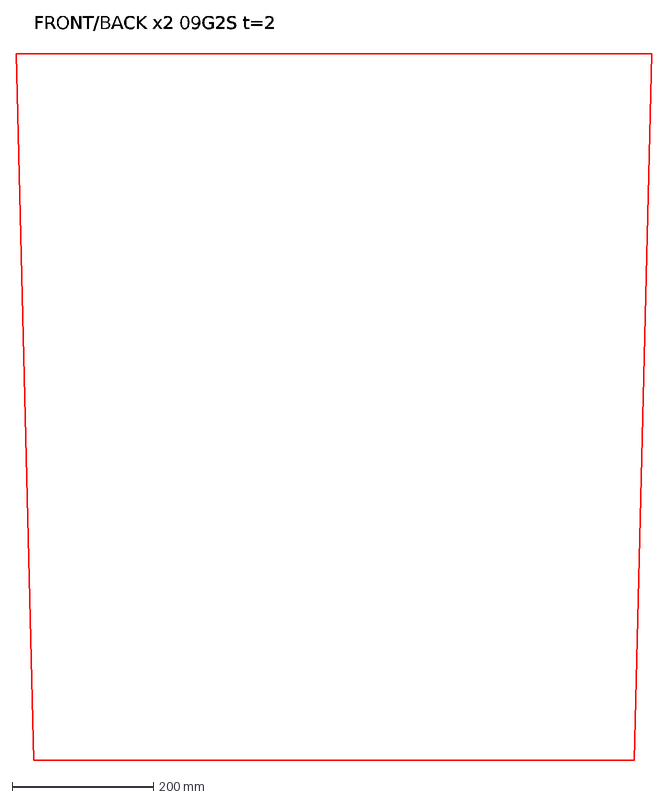
[picture p48: CAD file, 2026-10-06]
containers/deliverables/cut_front_back_2mm.dxf
FRONT/BACK x2 09G2S t=2
