hisp2k/parameters/screens/original-GR-series/57.GR (Заказ №2410 - СМП) бом/57.GR (Заказ №2410 - СМП) бом/57/57.GR.10.03.00.00  Расческа.SLDPRT

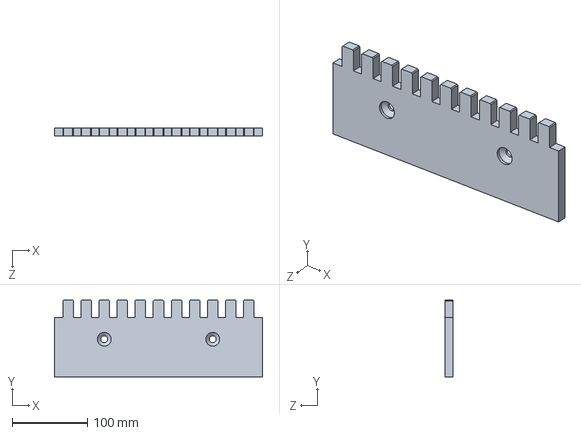
[picture p49: CAD file, 2026-10-06]
screens/original-GR-series/57.GR (Заказ №2410 - СМП) бом/57.GR (Заказ №2410 - СМП) бом/57/57.GR.10.03.00.00 Расческа.SLDPRT
276.0 x 102.0 x 10.0 mm
