hisp2k/parameters/belt-conveyors/flat-LT500/deliverables/Ленточный_транспортер/03_Модели_SolidWorks/ЛТ500_Плоский_ролик_фиксация_и_защита_R11.SLDPRT

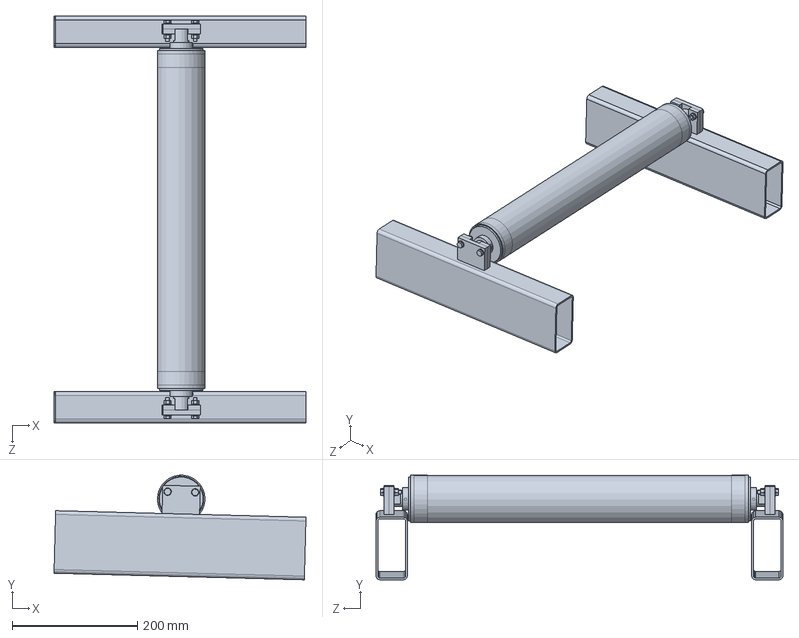
[picture p50: CAD file, 2026-10-06]
belt-conveyors/flat-LT500/deliverables/Ленточный_транспортер/03_Модели_SolidWorks/ЛТ500_Плоский_ролик_фиксация_и_защита_R11.SLDPRT
402.5 x 167.1 x 650.0 mm
