hisp2k/parameters/belt-conveyors/trough-LT500/deliverables/История_R10/Ленточный_транспортер/03_Модели_SolidWorks/ЛТ500_Продольные_балки_модуля_прототип_R03.SLDPRT

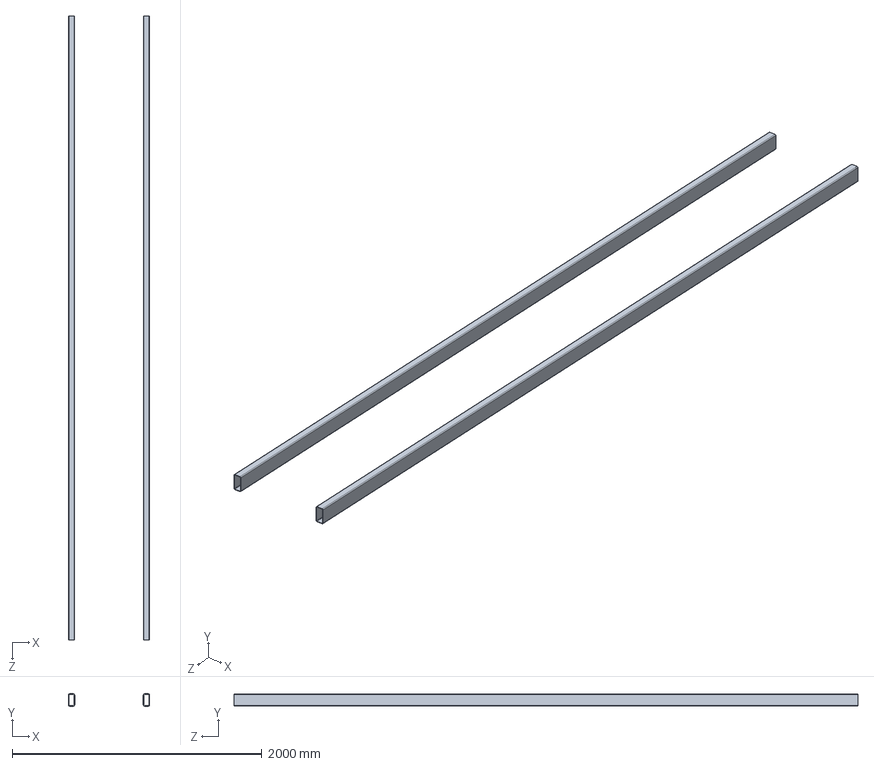
[picture p51: CAD file, 2026-10-06]
belt-conveyors/trough-LT500/deliverables/История_R10/Ленточный_транспортер/03_Модели_SolidWorks/ЛТ500_Продольные_балки_модуля_прототип_R03.SLDPRT
650.0 x 100.0 x 5000.0 mm
