hisp2k/parameters/containers/deliverables/nest_mounts_sheet_2500x1250.dxf

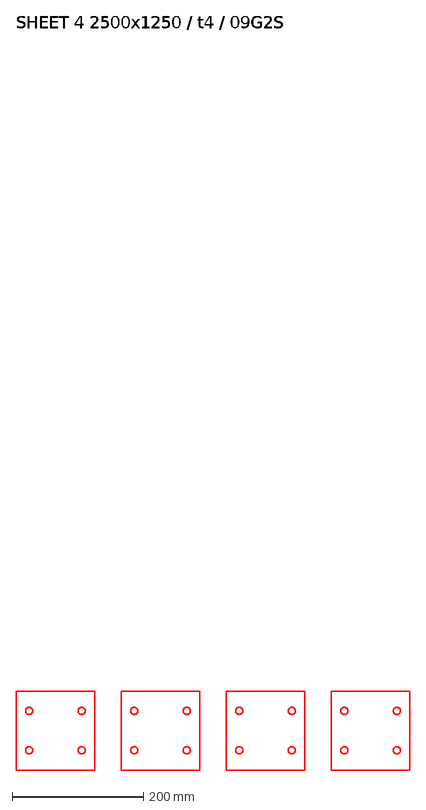
[picture p52: CAD file, 2026-10-06]
containers/deliverables/nest_mounts_sheet_2500x1250.dxf
SHEET 4 2500x1250 / t4 / 09G2S
