hisp2k/parameters/grit-chambers/parametric/deliverables/grit_chamber/01_CAD/GRIT_DETAIL_BASE_V7_20261003.SLDPRT

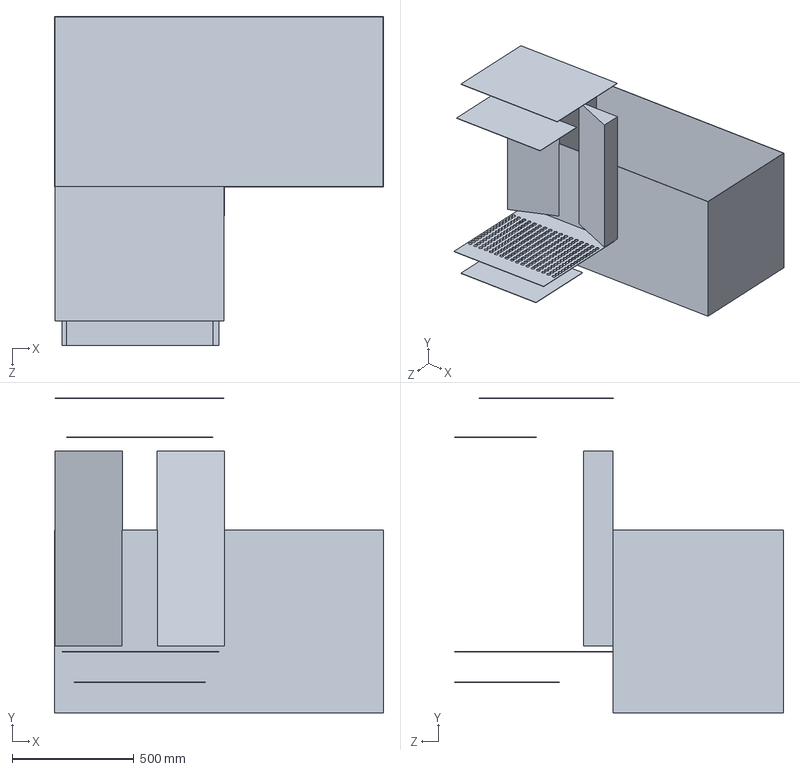
[picture p53: CAD file, 2026-10-06]
grit-chambers/parametric/deliverables/grit_chamber/01_CAD/GRIT_DETAIL_BASE_V7_20261003.SLDPRT
1350.0 x 1292.0 x 1350.0 mm
