hisp2k/parameters/grit-chambers/parametric/deliverables/grit_chamber/02_CFD/GRIT_CFD_SHORT_WIDE_PREP_20261004.SLDPRT

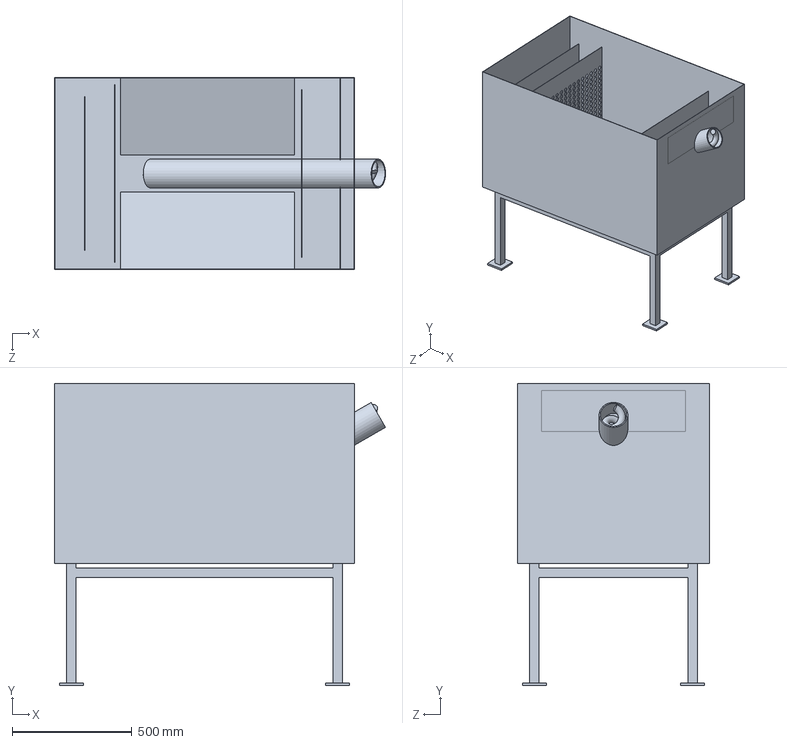
[picture p54: CAD file, 2026-10-06]
grit-chambers/parametric/deliverables/grit_chamber/02_CFD/GRIT_CFD_SHORT_WIDE_PREP_20261004.SLDPRT
1379.8 x 1260.0 x 800.0 mm
