hisp2k/parameters/belt-conveyors/trough-LT500/deliverables/История_R10/Ленточный_транспортер/03_Модели_SolidWorks/ЛТ500_Желобчатая_роликоопора_R10.SLDPRT

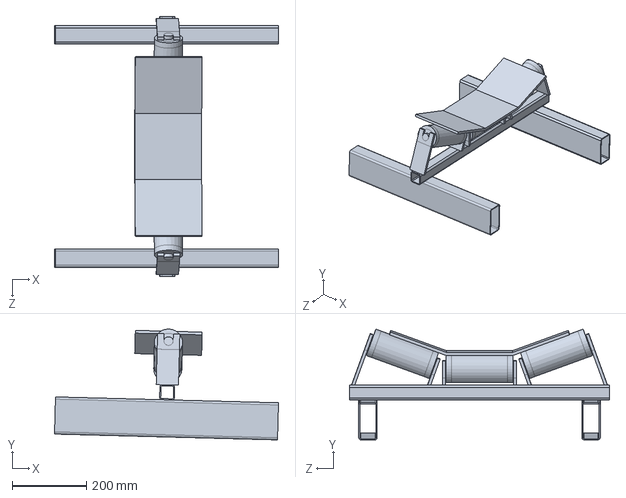
[picture p55: CAD file, 2026-10-06]
belt-conveyors/trough-LT500/deliverables/История_R10/Ленточный_транспортер/03_Модели_SolidWorks/ЛТ500_Желобчатая_роликоопора_R10.SLDPRT
602.4 x 298.1 x 700.0 mm
