hisp2k/parameters/containers/deliverables/0_22/nest_4_mounts_1500x1000.dxf

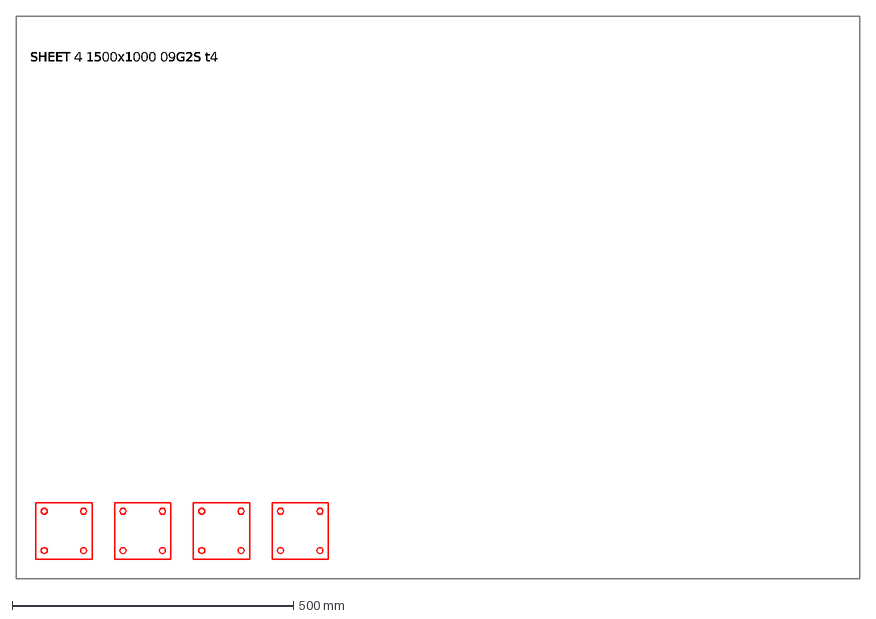
[picture p56: CAD file, 2026-10-06]
containers/deliverables/0_22/nest_4_mounts_1500x1000.dxf
SHEET 4 1500x1000 09G2S t4
