hisp2k/parameters/containers/deliverables/cut_mount_plate_4mm.dxf

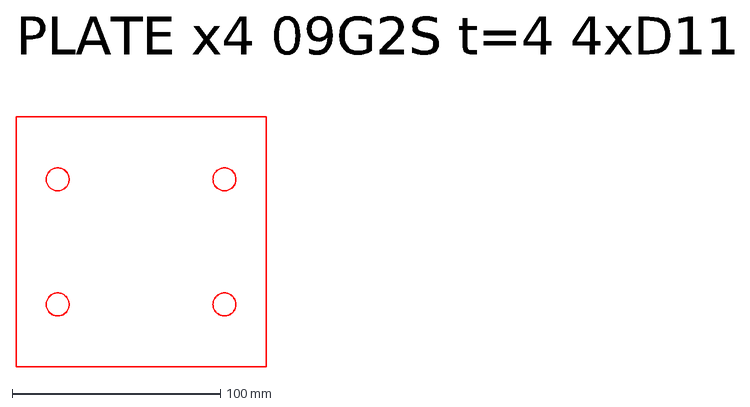
[picture p57: CAD file, 2026-10-06]
containers/deliverables/cut_mount_plate_4mm.dxf
PLATE x4 09G2S t=4 4xD11
