hisp2k/parameters/grit-chambers/parametric/deliverables/grit_chamber/02_CFD/GRIT_CFD_NARROW_PREP_20261004.SLDPRT

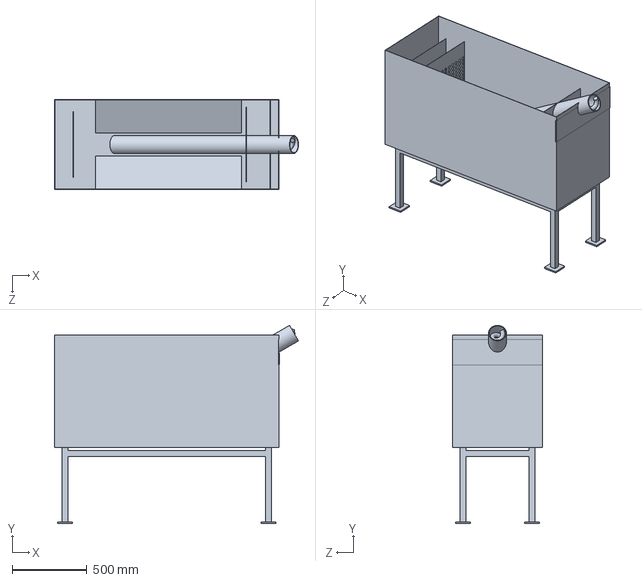
[picture p58: CAD file, 2026-10-06]
grit-chambers/parametric/deliverables/grit_chamber/02_CFD/GRIT_CFD_NARROW_PREP_20261004.SLDPRT
1630.0 x 1324.8 x 600.0 mm
