hisp2k/parameters/screens/original-GR-series/57.GR (Заказ №2410 - СМП) бом/57.GR (Заказ №2410 - СМП) бом/57/SKF_208_2Z_31.SLDPRT

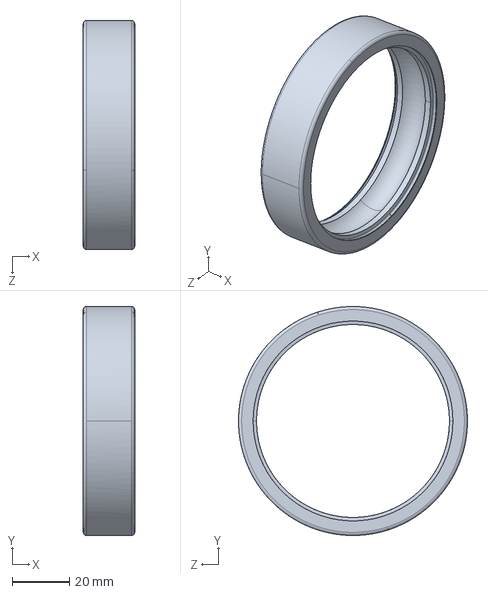
[picture p59: CAD file, 2026-10-06]
screens/original-GR-series/57.GR (Заказ №2410 - СМП) бом/57.GR (Заказ №2410 - СМП) бом/57/SKF_208_2Z_31.SLDPRT
18.0 x 80.0 x 80.0 mm
