hisp2k/parameters/belt-conveyors/trough-LT500/deliverables/История_R10/Ленточный_транспортер/03_Модели_SolidWorks/ЛТ500_Поперечная_опора_прототип_R04.SLDPRT

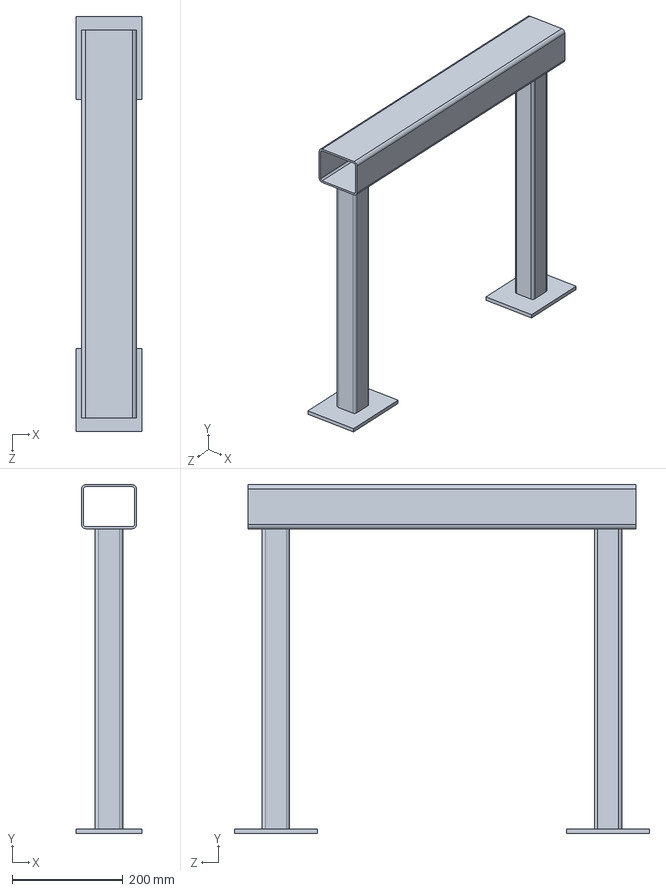
[picture p60: CAD file, 2026-10-06]
belt-conveyors/trough-LT500/deliverables/История_R10/Ленточный_транспортер/03_Модели_SolidWorks/ЛТ500_Поперечная_опора_прототип_R04.SLDPRT
120.0 x 630.0 x 750.0 mm
