hisp2k/parameters/containers/deliverables/0_22/04_wheel_mount_t4.dxf

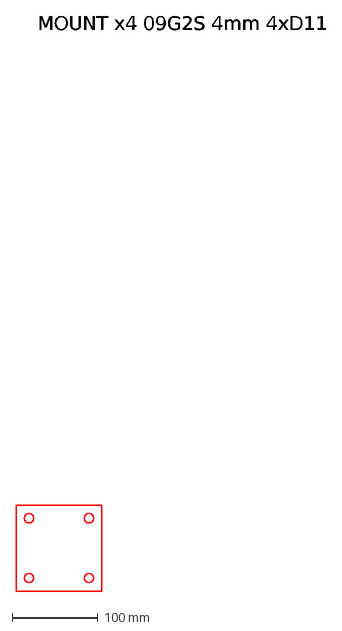
[picture p61: CAD file, 2026-10-06]
containers/deliverables/0_22/04_wheel_mount_t4.dxf
MOUNT x4 09G2S 4mm 4xD11
