hisp2k/parameters/containers/deliverables/bin_body.SLDPRT

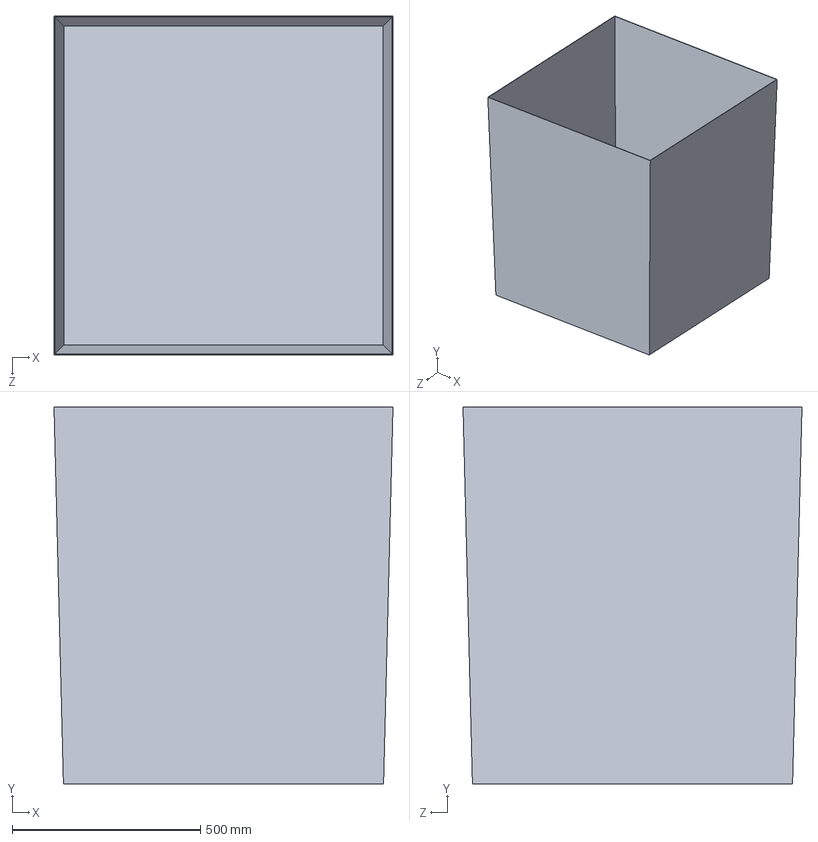
[picture p62: CAD file, 2026-10-06]
containers/deliverables/bin_body.SLDPRT
900.0 x 1000.0 x 900.0 mm
