hisp2k/parameters/containers/deliverables/0_22/bin_022_body.SLDPRT

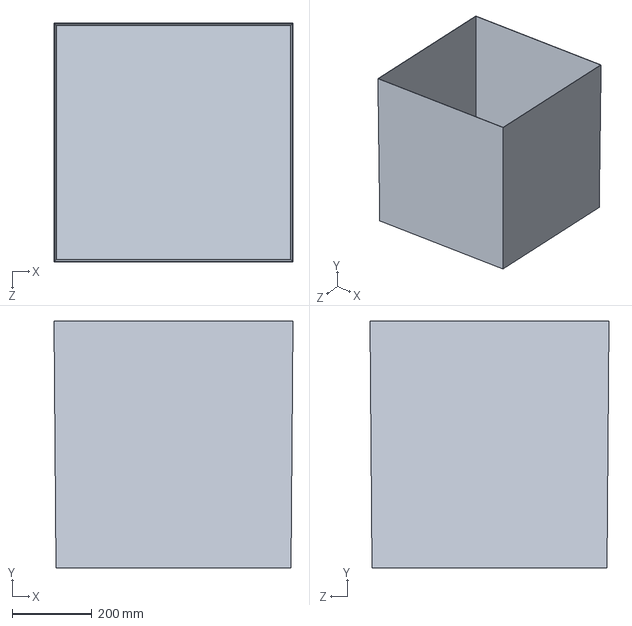
[picture p63: CAD file, 2026-10-06]
containers/deliverables/0_22/bin_022_body.SLDPRT
600.0 x 620.0 x 600.0 mm
