hisp2k/parameters/screens/original-GR-series/57.GR (Заказ №2410 - СМП) бом/57.GR (Заказ №2410 - СМП) бом/57/00.GR.04.01.00.02  Обойма.SLDPRT

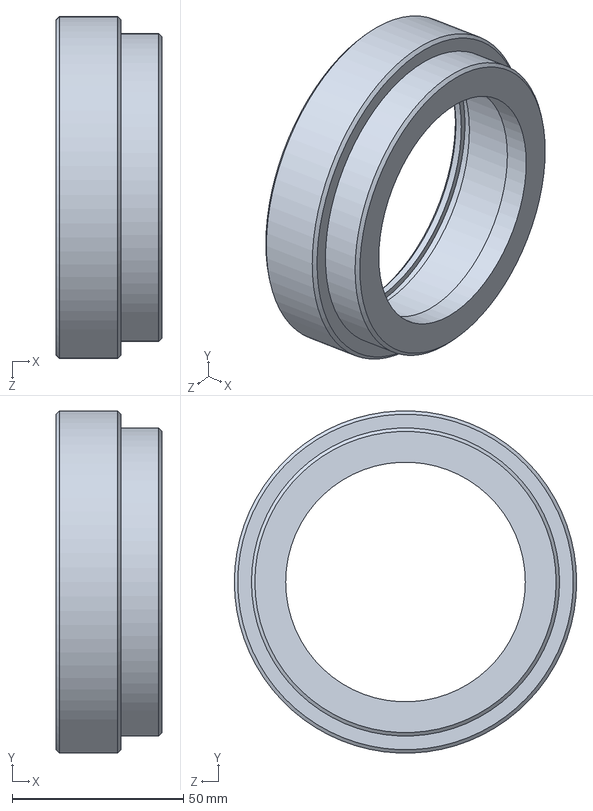
[picture p64: CAD file, 2026-10-06]
screens/original-GR-series/57.GR (Заказ №2410 - СМП) бом/57.GR (Заказ №2410 - СМП) бом/57/00.GR.04.01.00.02 Обойма.SLDPRT
31.0 x 99.9 x 100.0 mm
