hisp2k/parameters/containers/deliverables/0_22/nest_2_walls_1500x1000.dxf

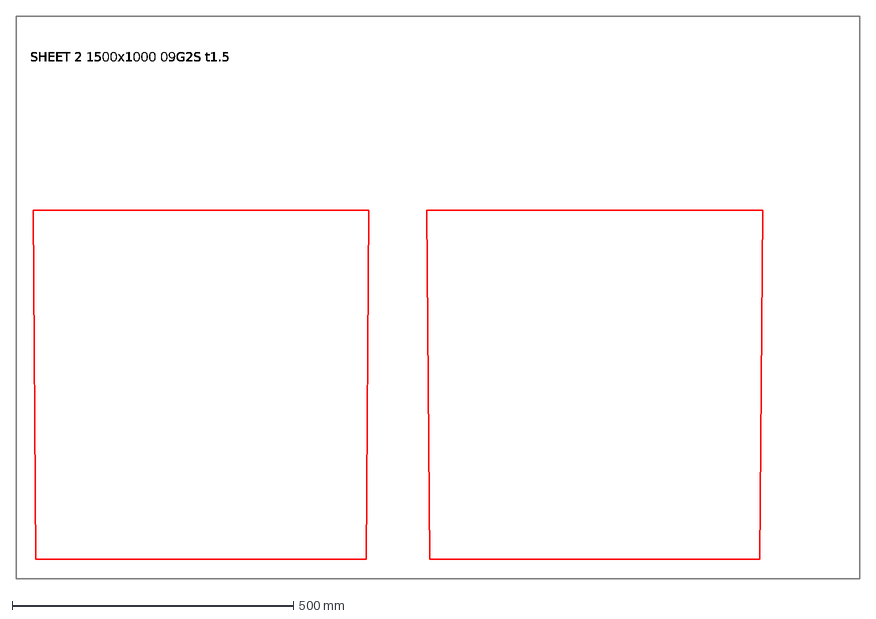
[picture p66: CAD file, 2026-10-06]
containers/deliverables/0_22/nest_2_walls_1500x1000.dxf
SHEET 2 1500x1000 09G2S t1.5
