hisp2k/parameters/containers/deliverables/wheel_swivel_D160.SLDPRT

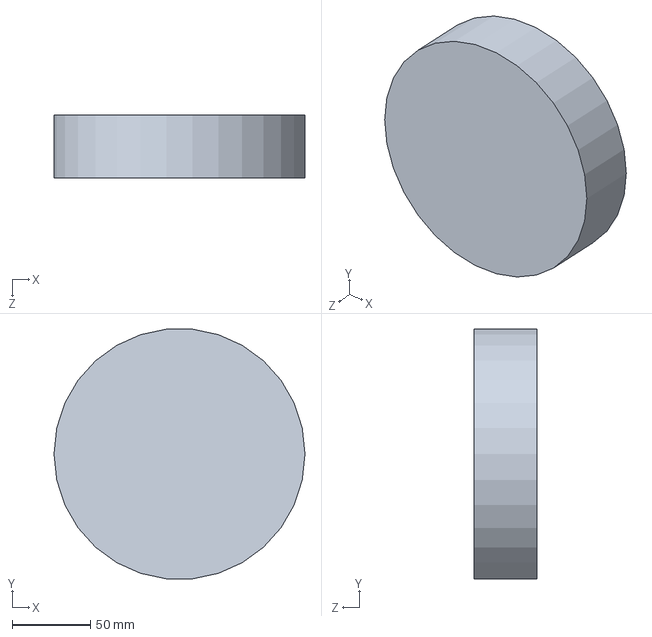
[picture p67: CAD file, 2026-10-06]
containers/deliverables/wheel_swivel_D160.SLDPRT
160.0 x 159.1 x 40.0 mm
