hisp2k/parameters/grit-chambers/parametric/deliverables/grit_chamber/01_CAD/GRIT_PILOT_BASE_20261003.SLDPRT

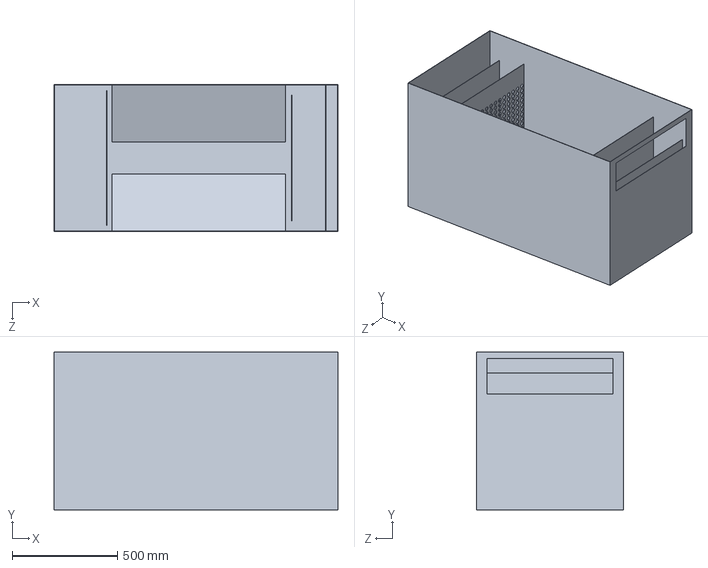
[picture p68: CAD file, 2026-10-06]
grit-chambers/parametric/deliverables/grit_chamber/01_CAD/GRIT_PILOT_BASE_20261003.SLDPRT
1350.0 x 751.0 x 700.0 mm
