hisp2k/parameters/screens/original-GR-series/57.GR (Заказ №2410 - СМП) бом/57.GR (Заказ №2410 - СМП) бом/57/Шпилька М8x20 DIN 975 А4.SLDPRT

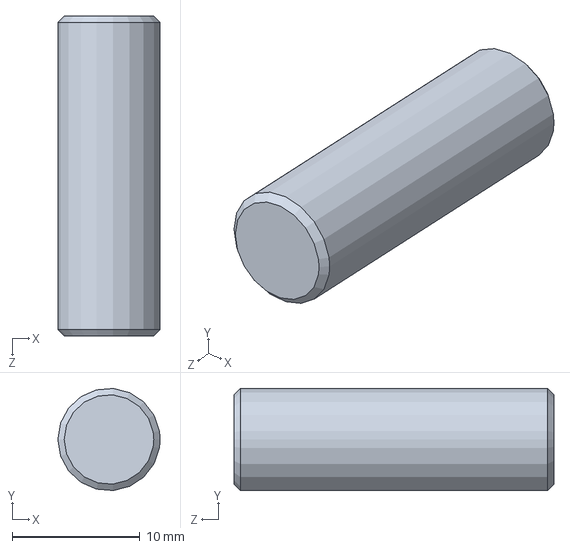
[picture p69: CAD file, 2026-10-06]
screens/original-GR-series/57.GR (Заказ №2410 - СМП) бом/57.GR (Заказ №2410 - СМП) бом/57/Шпилька М8x20 DIN 975 А4.SLDPRT
8.00 x 7.97 x 25.0 mm
