hisp2k/parameters/belt-conveyors/flat-LT500/deliverables/Ленточный_транспортер/03_Модели_SolidWorks/ЛТ500_Крепление_седел_и_стык_R07.SLDPRT

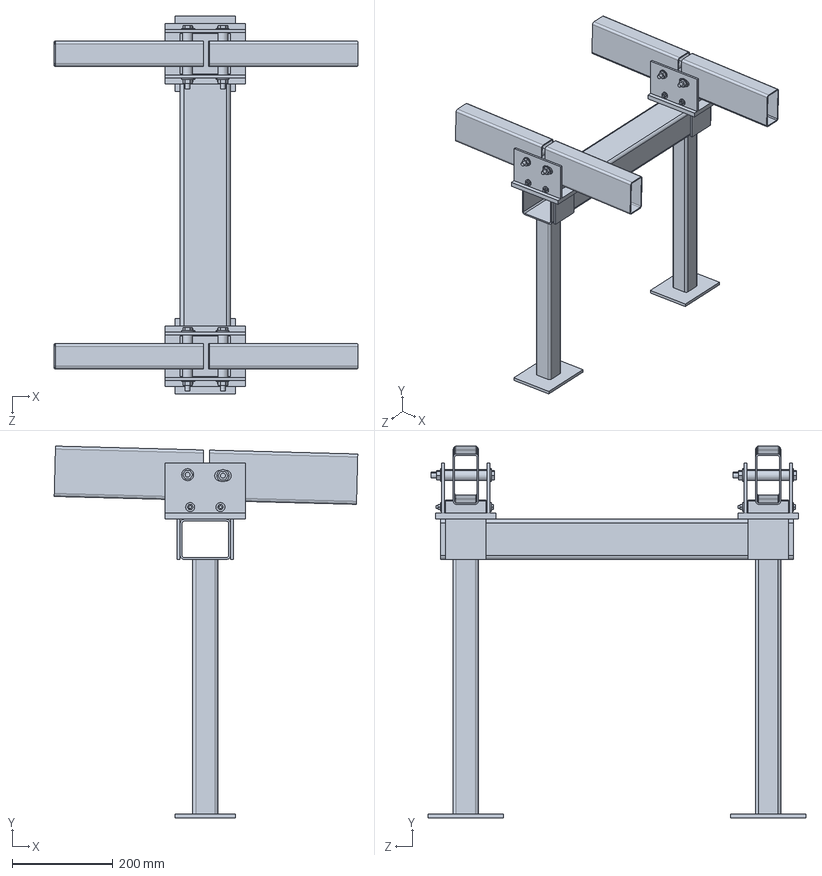
[picture p70: CAD file, 2026-10-06]
belt-conveyors/flat-LT500/deliverables/Ленточный_транспортер/03_Модели_SolidWorks/ЛТ500_Крепление_седел_и_стык_R07.SLDPRT
602.4 x 737.8 x 750.0 mm
