hisp2k/parameters/containers/deliverables/0_22/03_bottom_t1p5.dxf

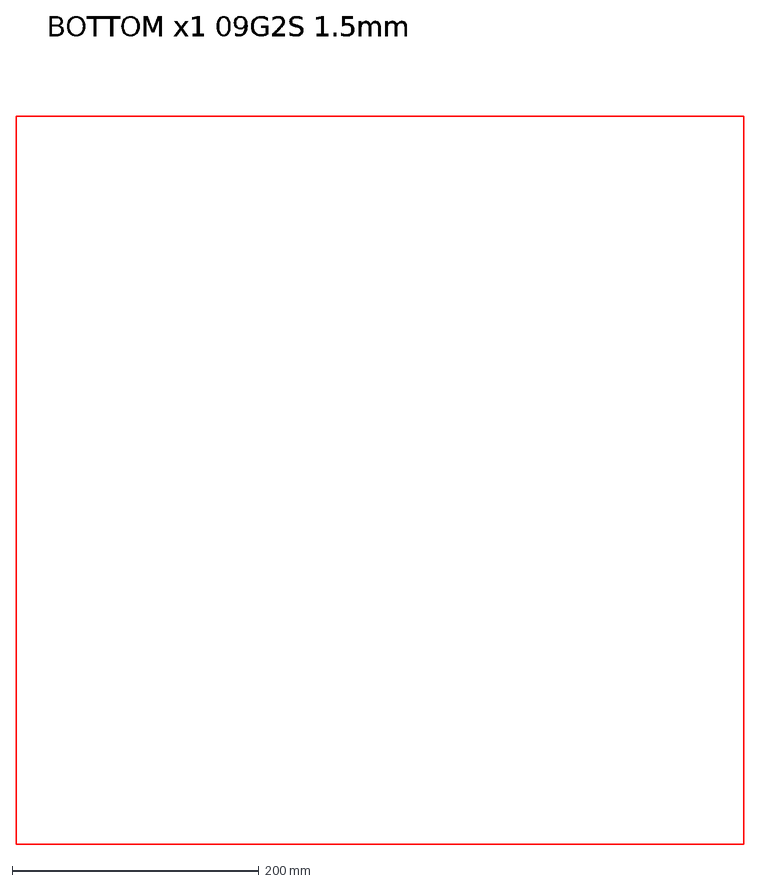
[picture p71: CAD file, 2026-10-06]
containers/deliverables/0_22/03_bottom_t1p5.dxf
BOTTOM x1 09G2S 1.5mm
