hisp2k/parameters/containers/deliverables/cut_bottom_2mm.dxf

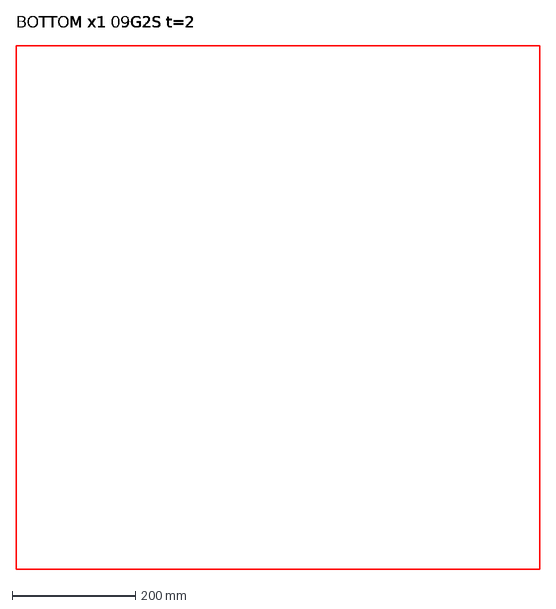
[picture p72: CAD file, 2026-10-06]
containers/deliverables/cut_bottom_2mm.dxf
BOTTOM x1 09G2S t=2
