hisp2k/parameters/screens/original-GR-series/57.GR (Заказ №2410 - СМП) бом/57.GR (Заказ №2410 - СМП) бом/57/00.GR.01.00.00.12  Направляющая верхняя.SLDPRT

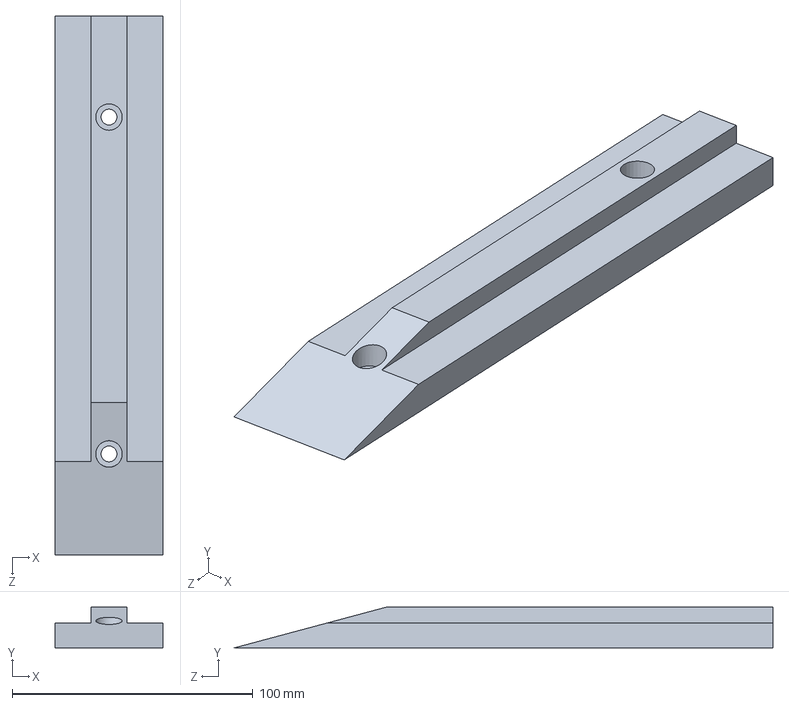
[picture p73: CAD file, 2026-10-06]
screens/original-GR-series/57.GR (Заказ №2410 - СМП) бом/57.GR (Заказ №2410 - СМП) бом/57/00.GR.01.00.00.12 Направляющая верхняя.SLDPRT
45.0 x 17.0 x 224.0 mm
