hisp2k/parameters/containers/deliverables/0_22/nest_1_walls_1500x1000.dxf

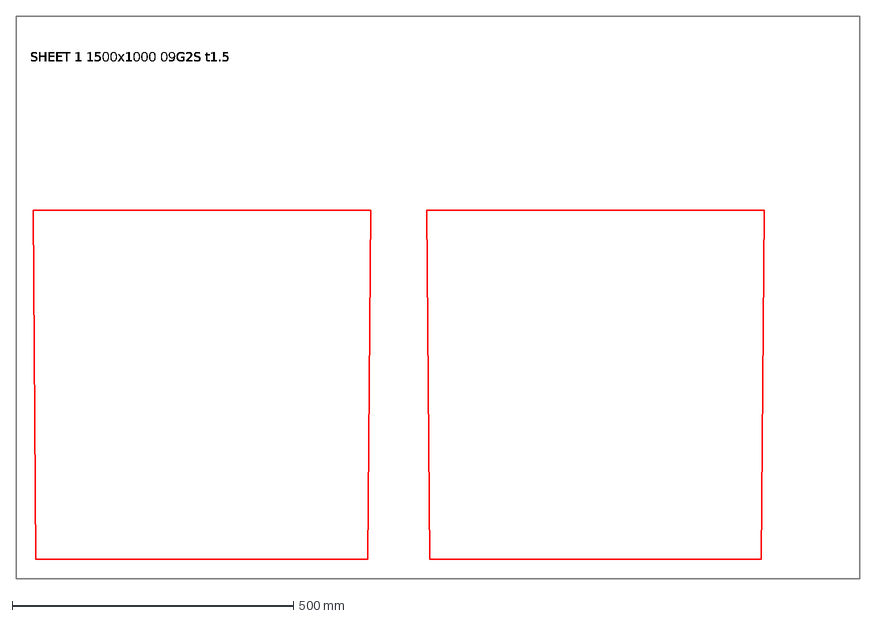
[picture p74: CAD file, 2026-10-06]
containers/deliverables/0_22/nest_1_walls_1500x1000.dxf
SHEET 1 1500x1000 09G2S t1.5
