hisp2k/parameters/containers/deliverables/nest_bottom_sheet_2500x1250.dxf

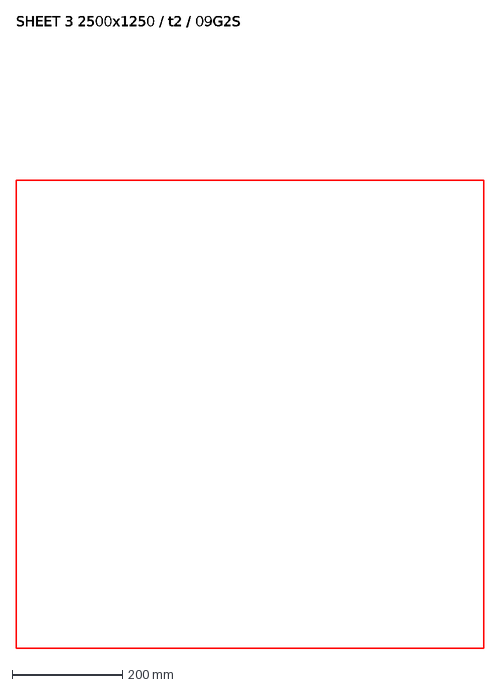
[picture p75: CAD file, 2026-10-06]
containers/deliverables/nest_bottom_sheet_2500x1250.dxf
SHEET 3 2500x1250 / t2 / 09G2S
