hisp2k/parameters/containers/deliverables/nest_walls_sheet_2_2500x1250.dxf

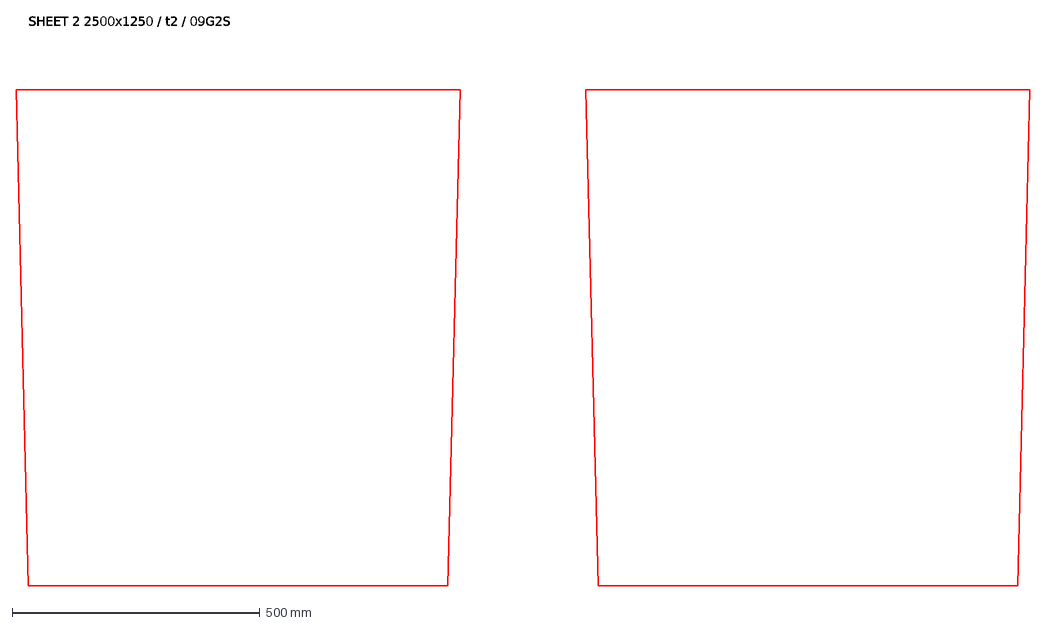
[picture p76: CAD file, 2026-10-06]
containers/deliverables/nest_walls_sheet_2_2500x1250.dxf
SHEET 2 2500x1250 / t2 / 09G2S
