hisp2k/parameters/grit-chambers/parametric/deliverables/grit_chamber/01_CAD/GRIT_PILOT_BASE_CASING_TEST.SLDPRT

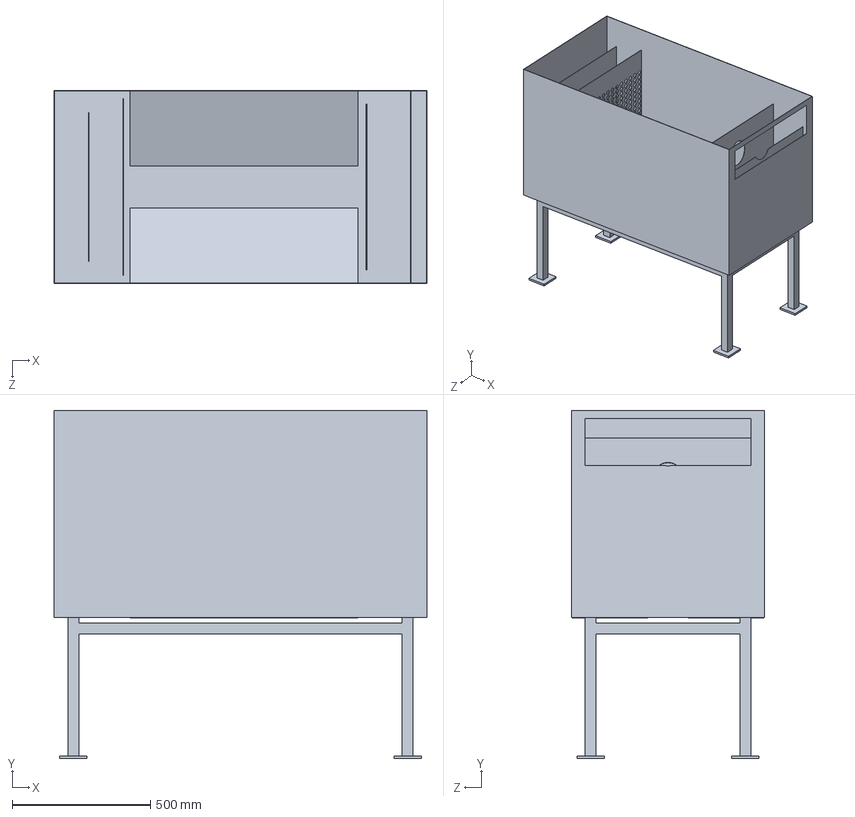
[picture p77: CAD file, 2026-10-06]
grit-chambers/parametric/deliverables/grit_chamber/01_CAD/GRIT_PILOT_BASE_CASING_TEST.SLDPRT
1350.0 x 1260.0 x 700.0 mm
