hisp2k/parameters/screens/original-GR-series/57.GR (Заказ №2410 - СМП) бом/57.GR (Заказ №2410 - СМП) бом/57/00.GR.04.01.00.04  Ребро.SLDPRT

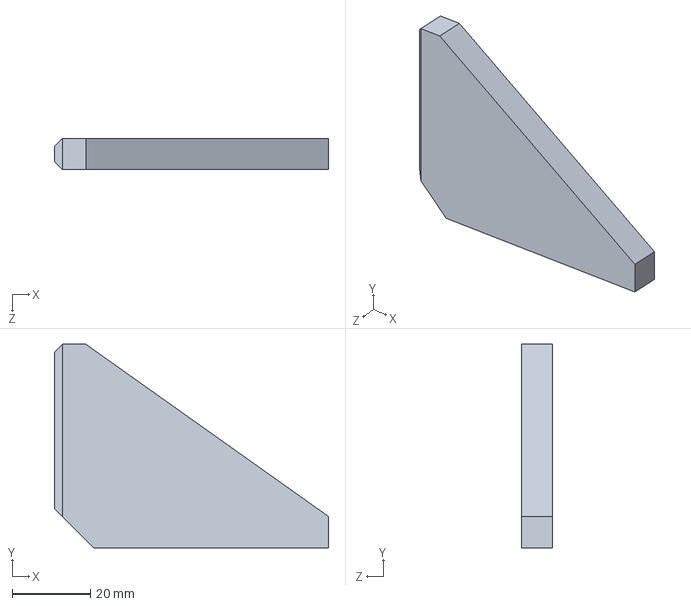
[picture p78: CAD file, 2026-10-06]
screens/original-GR-series/57.GR (Заказ №2410 - СМП) бом/57.GR (Заказ №2410 - СМП) бом/57/00.GR.04.01.00.04 Ребро.SLDPRT
70.0 x 52.0 x 8.00 mm
