hisp2k/parameters/containers/deliverables/0_22/nest_3_bottom_1500x1000.dxf

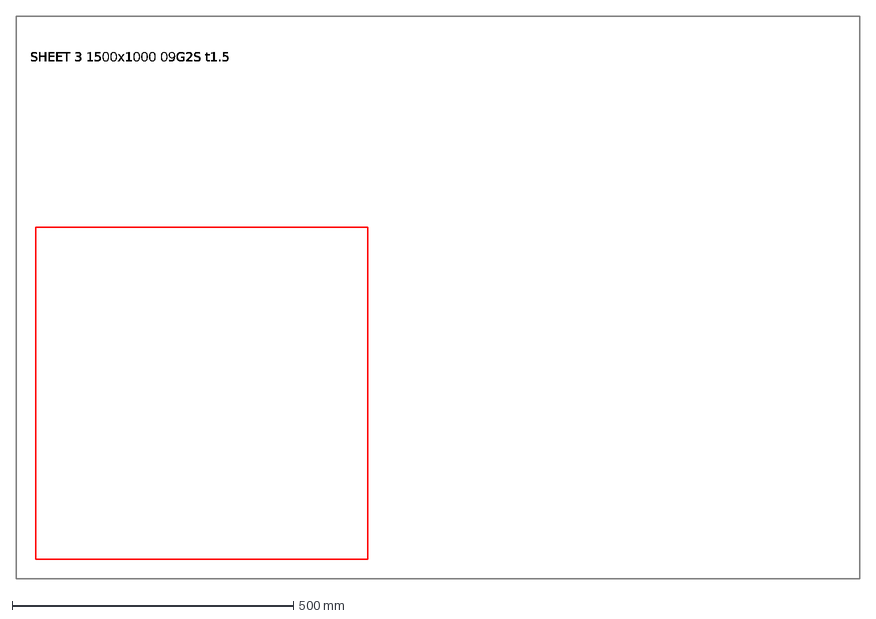
[picture p79: CAD file, 2026-10-06]
containers/deliverables/0_22/nest_3_bottom_1500x1000.dxf
SHEET 3 1500x1000 09G2S t1.5
