hisp2k/parameters/containers/deliverables/mount_plate_120x120x4.SLDPRT

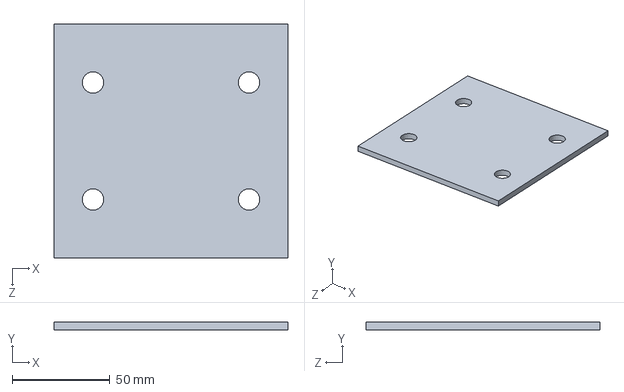
[picture p80: CAD file, 2026-10-06]
containers/deliverables/mount_plate_120x120x4.SLDPRT
120.0 x 4.00 x 120.0 mm
