hisp2k/parameters/screens/original-GR-series/57.GR (Заказ №2410 - СМП) бом/57.GR (Заказ №2410 - СМП) бом/57/00.GR.07.01.00.02  Втулка.SLDPRT

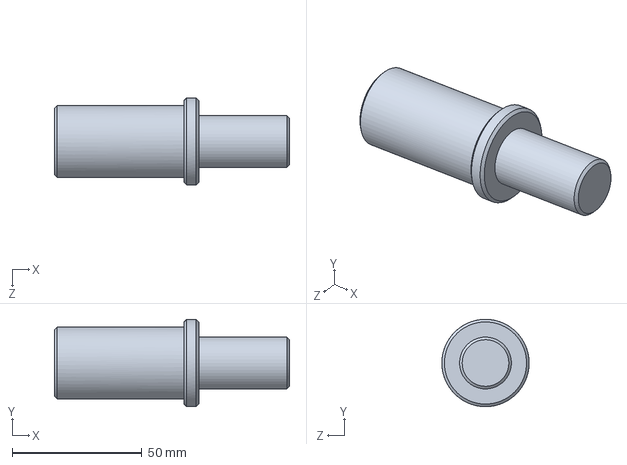
[picture p82: CAD file, 2026-10-06]
screens/original-GR-series/57.GR (Заказ №2410 - СМП) бом/57.GR (Заказ №2410 - СМП) бом/57/00.GR.07.01.00.02 Втулка.SLDPRT
90.7 x 33.7 x 33.7 mm
