hisp2k/parameters/containers/deliverables/0_22/02_left_right_t1p5.dxf

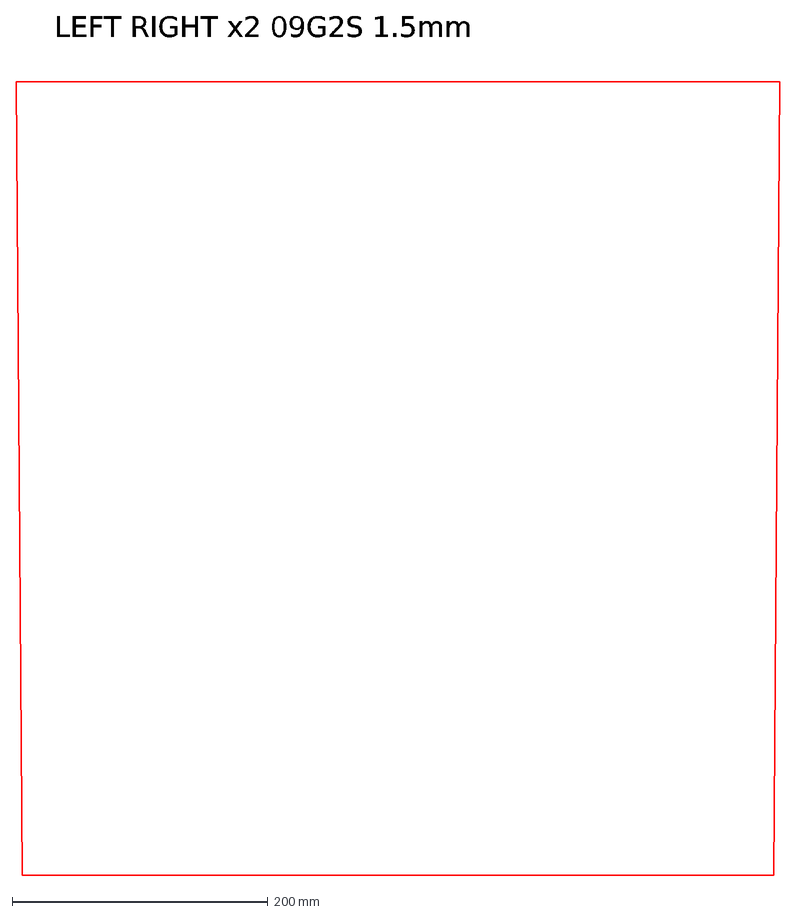
[picture p83: CAD file, 2026-10-06]
containers/deliverables/0_22/02_left_right_t1p5.dxf
LEFT RIGHT x2 09G2S 1.5mm
