hisp2k/parameters/grit-chambers/parametric/deliverables/grit_chamber/01_CAD/GRIT_PILOT_SHORT_WIDE_FRAME_20261003.SLDPRT

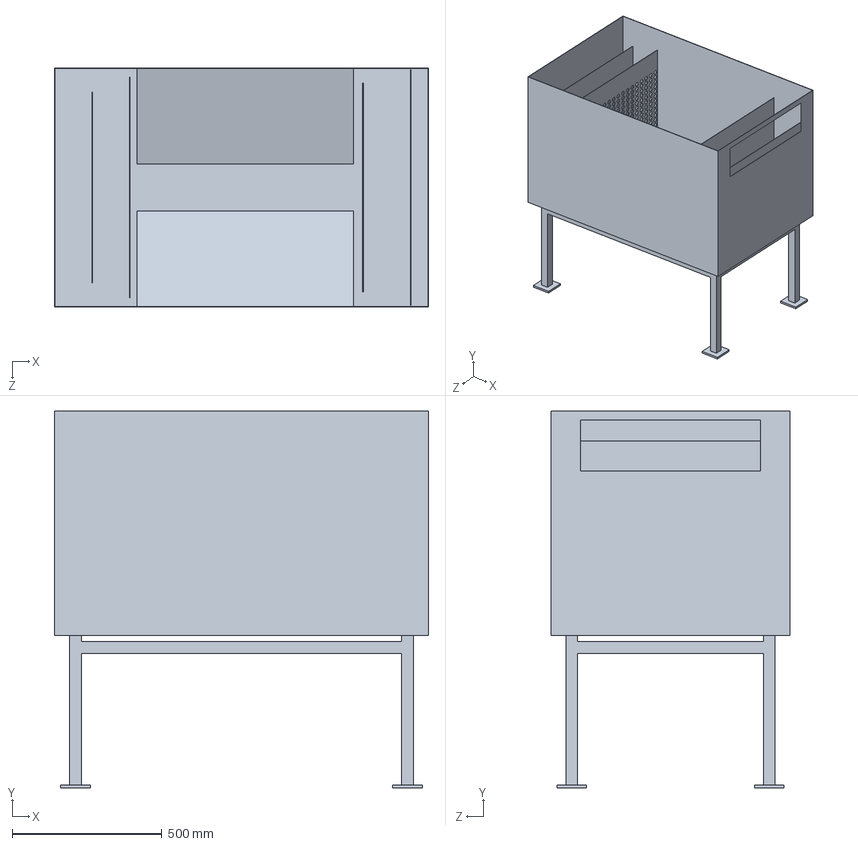
[picture p84: CAD file, 2026-10-06]
grit-chambers/parametric/deliverables/grit_chamber/01_CAD/GRIT_PILOT_SHORT_WIDE_FRAME_20261003.SLDPRT
1250.0 x 1260.0 x 800.0 mm
