hisp2k/parameters/screens/original-GR-series/57.GR (Заказ №2410 - СМП) бом/57.GR (Заказ №2410 - СМП) бом/57/00.GR.01.01.03.01  Пластина.SLDPRT

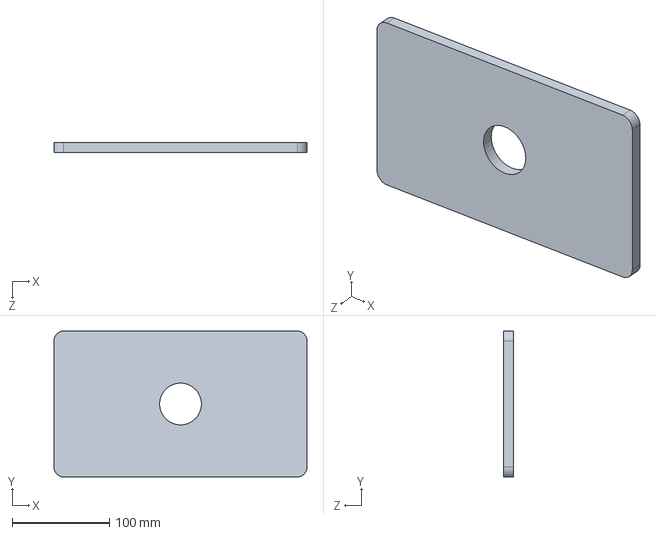
[picture p85: CAD file, 2026-10-06]
screens/original-GR-series/57.GR (Заказ №2410 - СМП) бом/57.GR (Заказ №2410 - СМП) бом/57/00.GR.01.01.03.01 Пластина.SLDPRT
260.0 x 150.0 x 10.0 mm
