hisp2k/parameters/containers/deliverables/0_22/01_front_back_t1p5.dxf

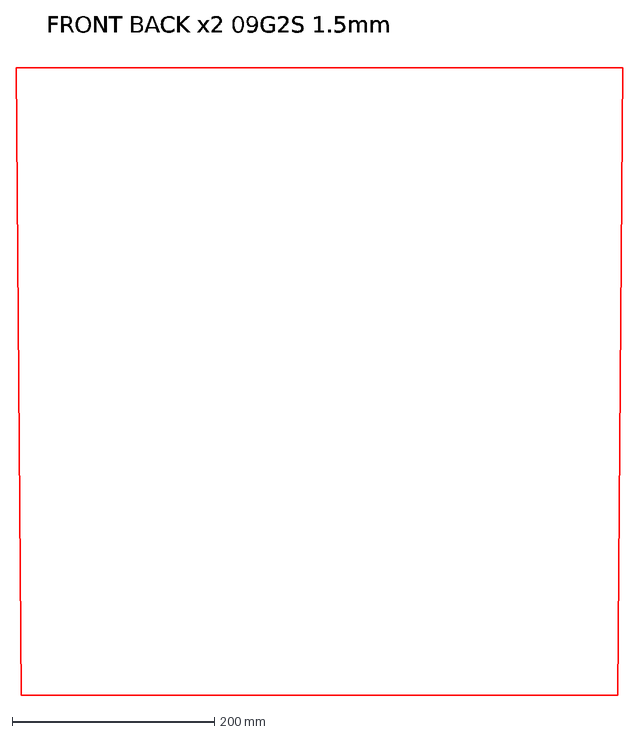
[picture p86: CAD file, 2026-10-06]
containers/deliverables/0_22/01_front_back_t1p5.dxf
FRONT BACK x2 09G2S 1.5mm
