hisp2k/parameters/containers/deliverables/cut_left_right_2mm.dxf

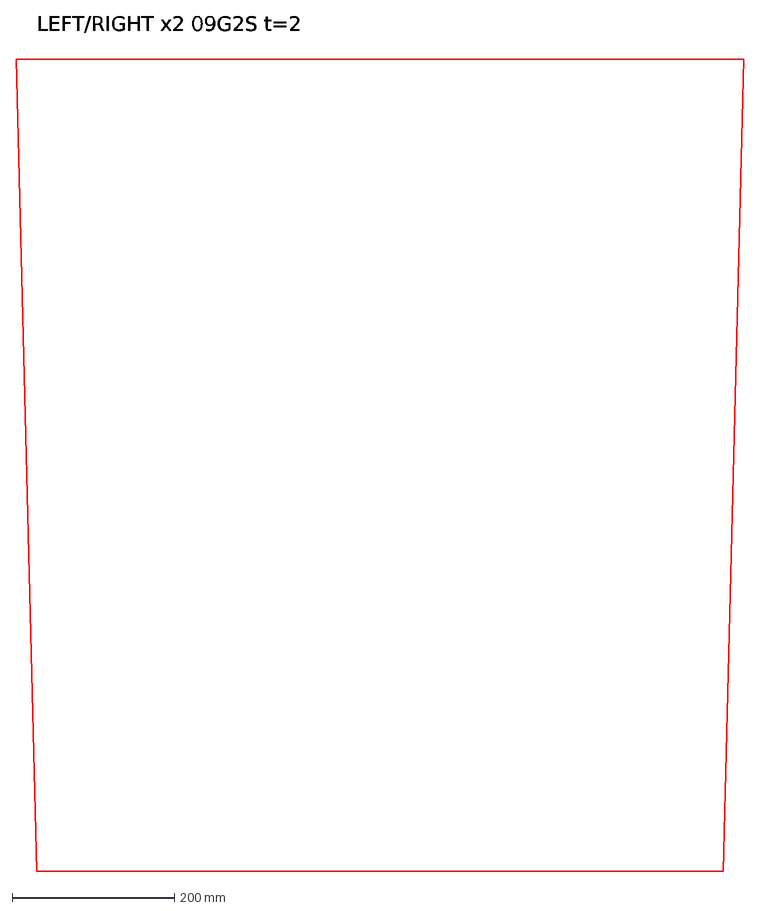
[picture p87: CAD file, 2026-10-06]
containers/deliverables/cut_left_right_2mm.dxf
LEFT/RIGHT x2 09G2S t=2
