hisp2k/parameters/containers/deliverables/0_22/mount_plate_100x100x4.SLDPRT

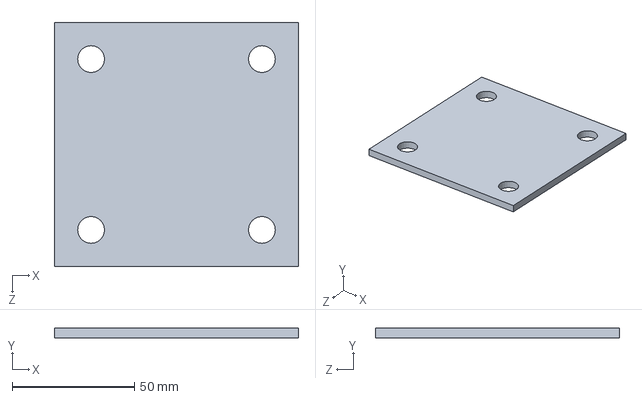
[picture p88: CAD file, 2026-10-06]
containers/deliverables/0_22/mount_plate_100x100x4.SLDPRT
100.0 x 4.00 x 100.0 mm
