hisp2k/parameters/containers/deliverables/nest_walls_sheet_1_2500x1250.dxf

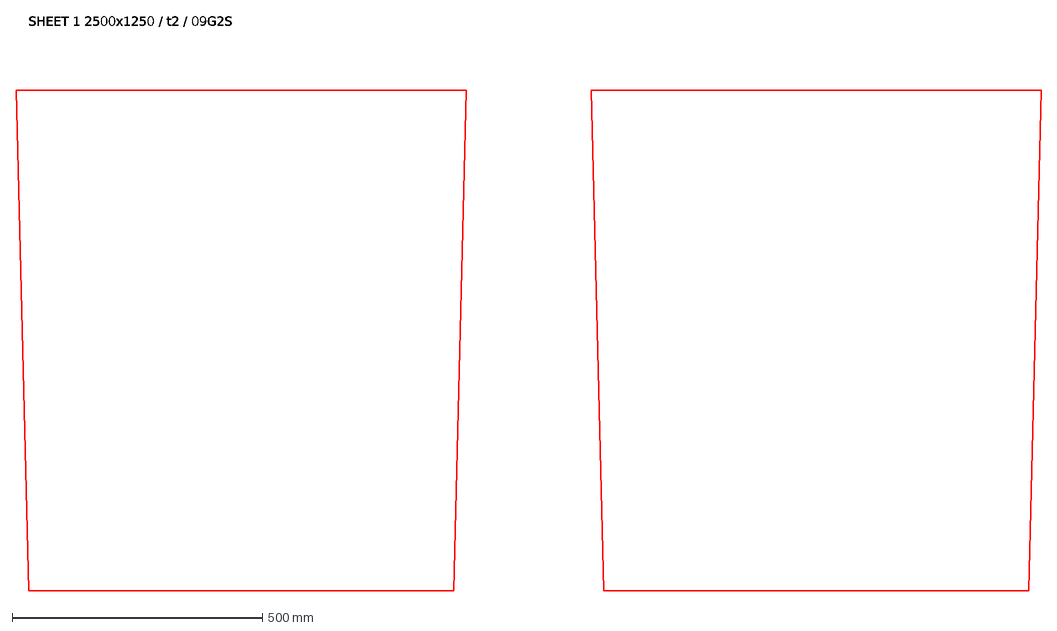
[picture p89: CAD file, 2026-10-06]
containers/deliverables/nest_walls_sheet_1_2500x1250.dxf
SHEET 1 2500x1250 / t2 / 09G2S
