hisp2k/parameters/screens/original-GR-series/57.GR (Заказ №2410 - СМП) бом/57.GR (Заказ №2410 - СМП) бом/57/Звено 4х21 А2 нерж..SLDPRT

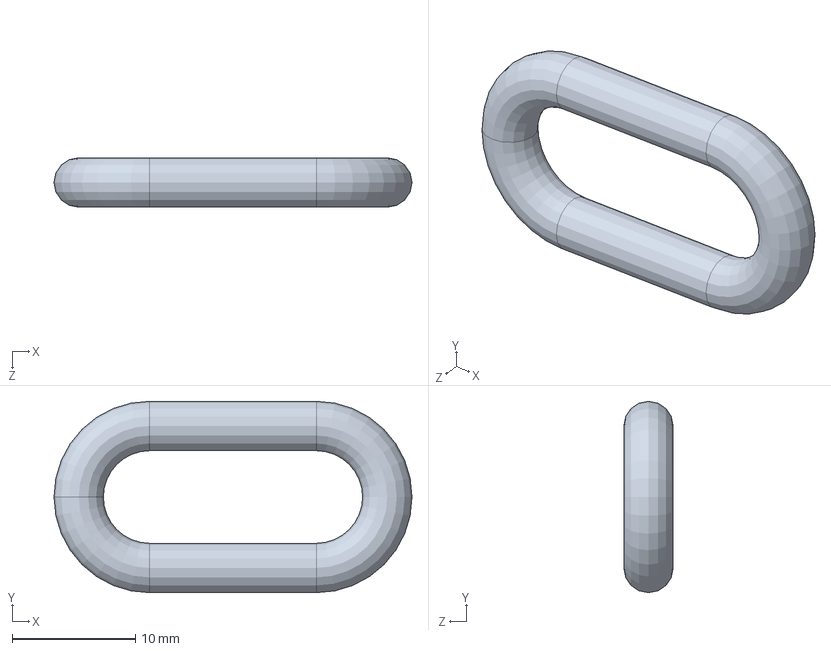
[picture p90: CAD file, 2026-10-06]
screens/original-GR-series/57.GR (Заказ №2410 - СМП) бом/57.GR (Заказ №2410 - СМП) бом/57/Звено 4х21 А2 нерж..SLDPRT
29.0 x 15.5 x 4.00 mm
