hisp2k/parameters/screens/original-GR-series/57.GR (Заказ №2410 - СМП) бом/57.GR (Заказ №2410 - СМП) бом/57/00.GR.07.01.00.07  Подложка 3.SLDPRT

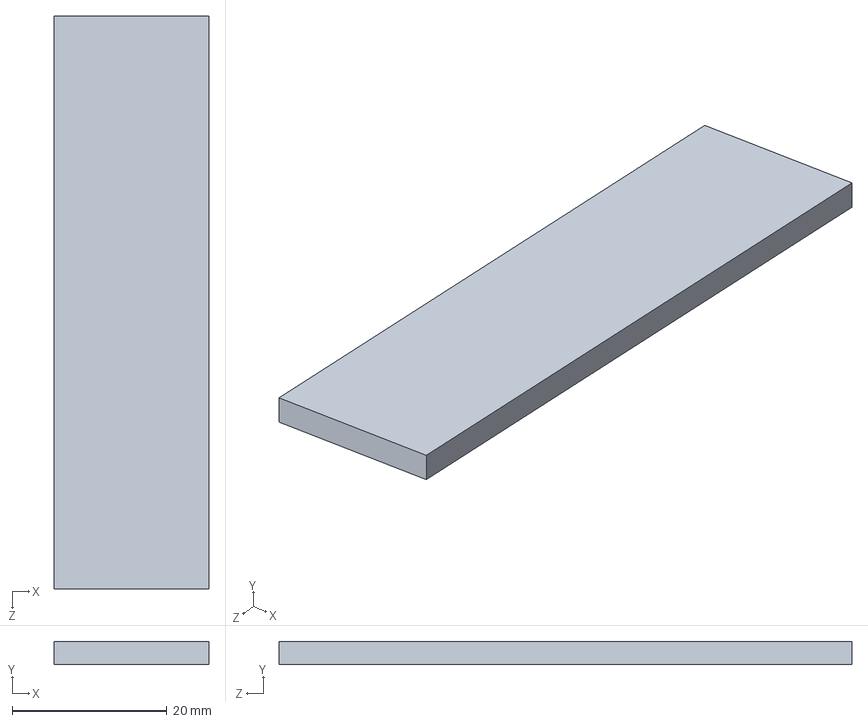
[picture p91: CAD file, 2026-10-06]
screens/original-GR-series/57.GR (Заказ №2410 - СМП) бом/57.GR (Заказ №2410 - СМП) бом/57/00.GR.07.01.00.07 Подложка 3.SLDPRT
20.0 x 3.00 x 74.0 mm
