hisp2k/parameters/screens/original-GR-series/57.GR (Заказ №2410 - СМП) бом/57.GR (Заказ №2410 - СМП) бом/57/00.GR.01.01.03.05  Заглушка.SLDPRT

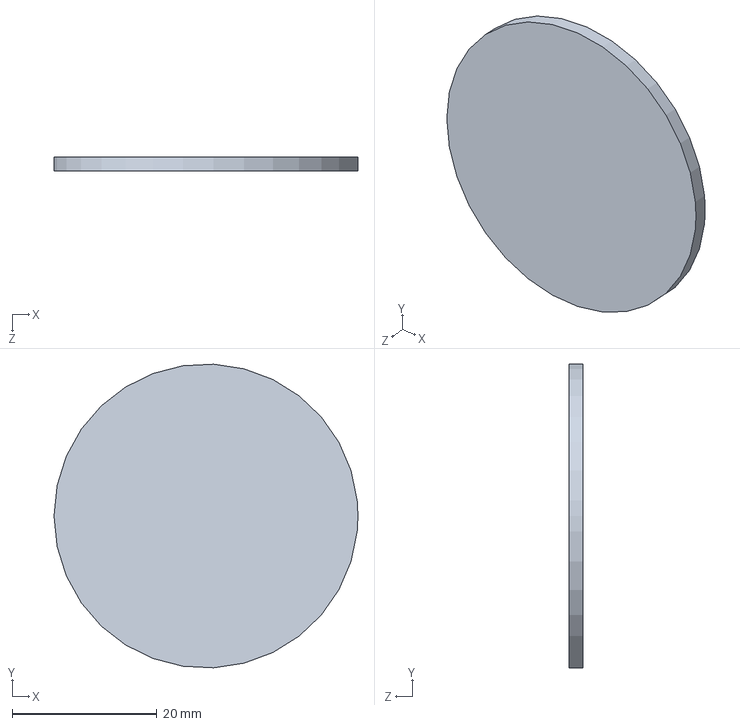
[picture p92: CAD file, 2026-10-06]
screens/original-GR-series/57.GR (Заказ №2410 - СМП) бом/57.GR (Заказ №2410 - СМП) бом/57/00.GR.01.01.03.05 Заглушка.SLDPRT
42.0 x 41.9 x 2.00 mm
