hisp2k/parameters/screens/original-GR-series/57.GR (Заказ №2410 - СМП) бом/57.GR (Заказ №2410 - СМП) бом/57/Гайка М12 DIN 6923 ОЦ.SLDPRT

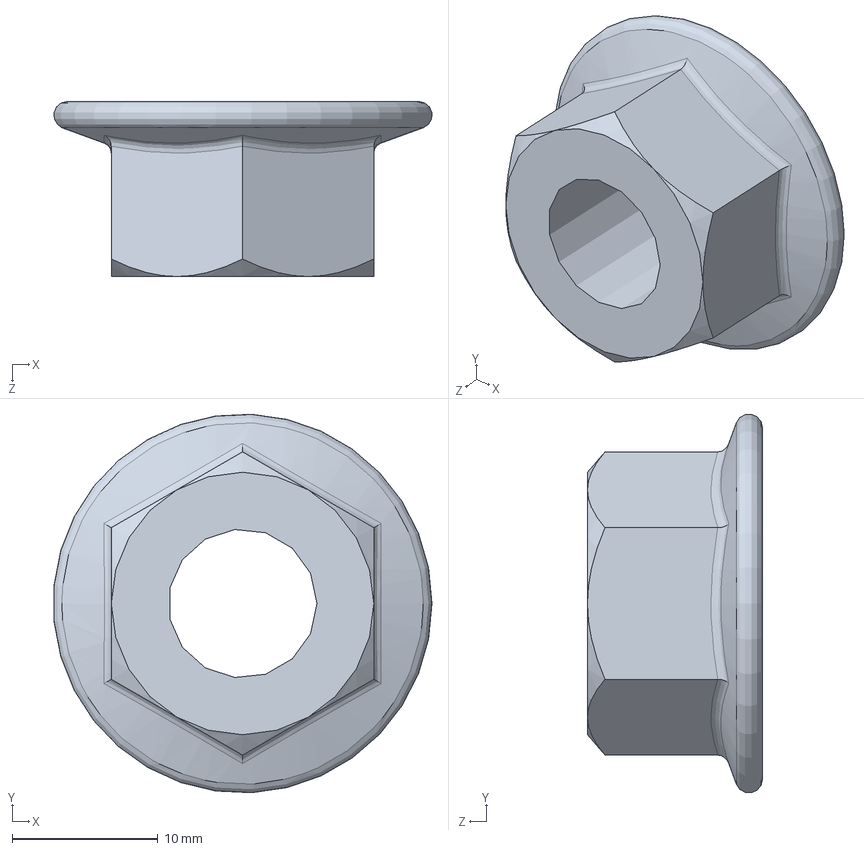
[picture p93: CAD file, 2026-10-06]
screens/original-GR-series/57.GR (Заказ №2410 - СМП) бом/57.GR (Заказ №2410 - СМП) бом/57/Гайка М12 DIN 6923 ОЦ.SLDPRT
25.9 x 25.9 x 12.0 mm
