hisp2k/parameters/grit-chambers/parametric/deliverables/grit_chamber/01_CAD/GRIT_DETAIL_SHORT_WIDE_20261003.SLDPRT

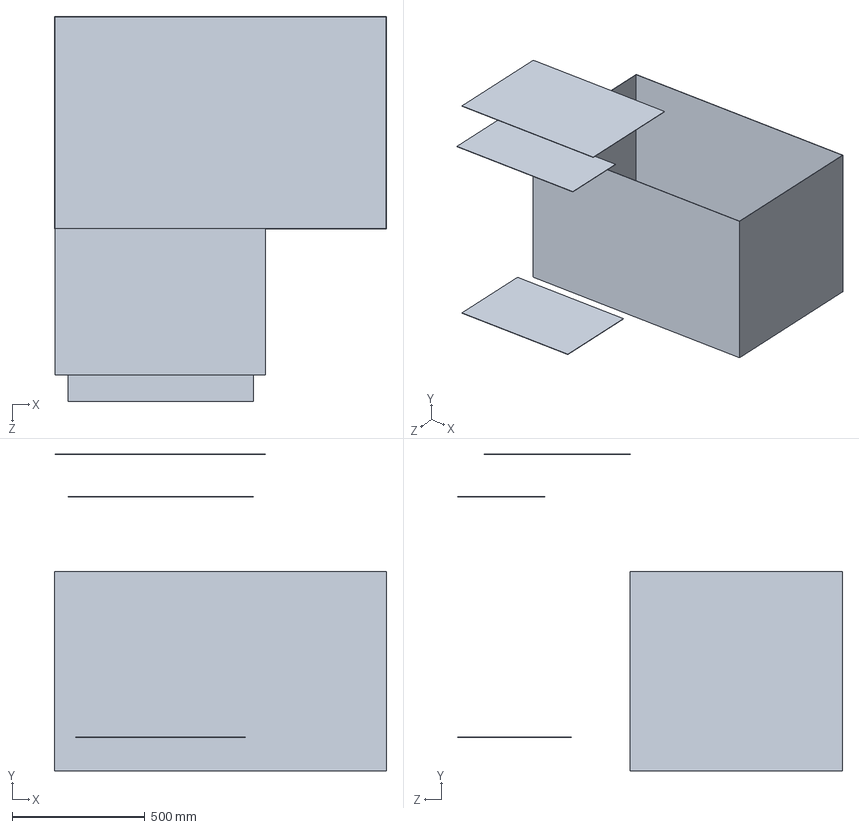
[picture p94: CAD file, 2026-10-06]
grit-chambers/parametric/deliverables/grit_chamber/01_CAD/GRIT_DETAIL_SHORT_WIDE_20261003.SLDPRT
1250.0 x 1192.0 x 1450.0 mm
