hisp2k/parameters/grit-chambers/parametric/deliverables/grit_chamber/01_CAD/GRIT_PILOT_SHORT_WIDE_CAD_20261003.SLDPRT

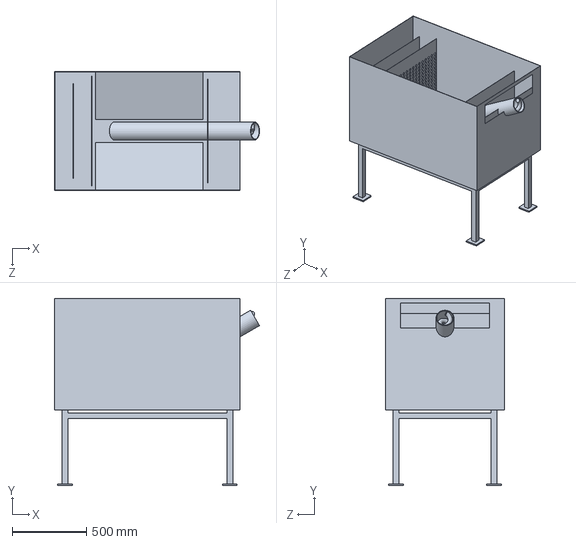
[picture p95: CAD file, 2026-10-06]
grit-chambers/parametric/deliverables/grit_chamber/01_CAD/GRIT_PILOT_SHORT_WIDE_CAD_20261003.SLDPRT
1379.8 x 1260.0 x 800.0 mm
