hisp2k/parameters/screens/original-GR-series/57.GR (Заказ №2410 - СМП) бом/57.GR (Заказ №2410 - СМП) бом/57/Винт М12х30 DIN 7984 А4.SLDPRT

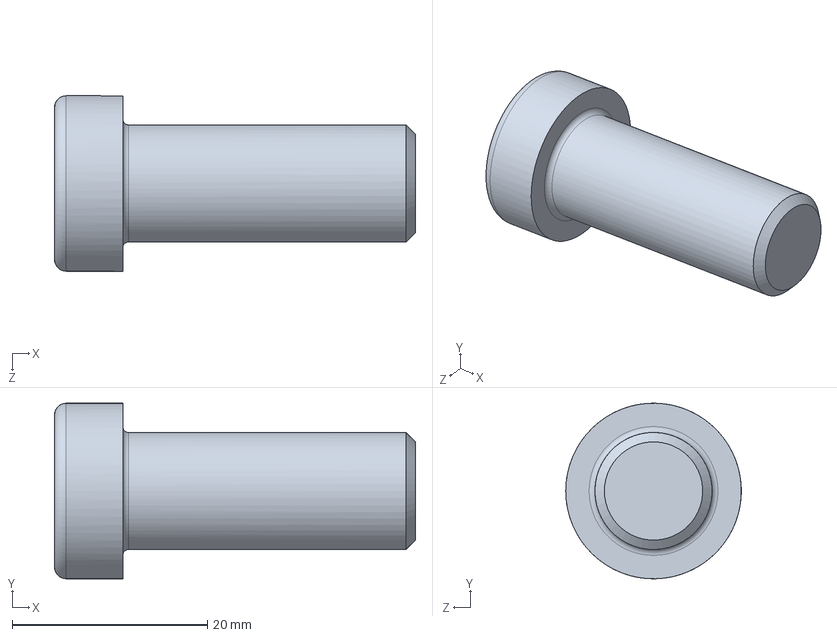
[picture p96: CAD file, 2026-10-06]
screens/original-GR-series/57.GR (Заказ №2410 - СМП) бом/57.GR (Заказ №2410 - СМП) бом/57/Винт М12х30 DIN 7984 А4.SLDPRT
37.0 x 18.0 x 18.0 mm
