hisp2k/parameters/grit-chambers/parametric/deliverables/grit_chamber/01_CAD/GRIT_PILOT_BASE_FRAME_TEST3.SLDPRT

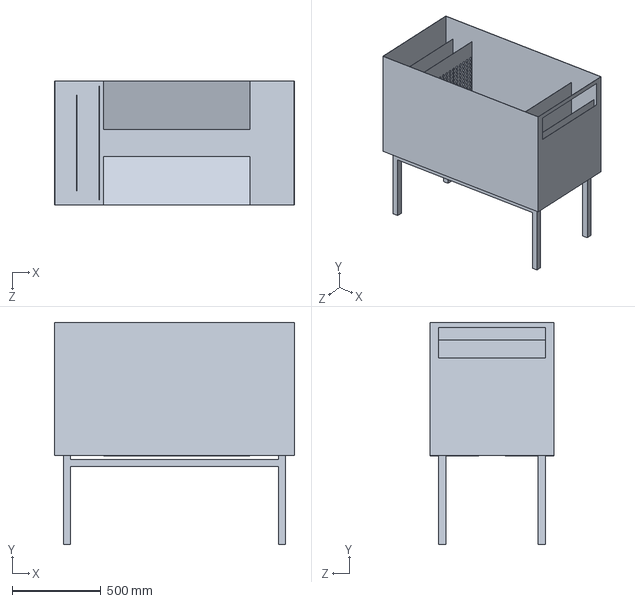
[picture p97: CAD file, 2026-10-06]
grit-chambers/parametric/deliverables/grit_chamber/01_CAD/GRIT_PILOT_BASE_FRAME_TEST3.SLDPRT
1350.0 x 1250.0 x 700.0 mm
