hisp2k/parameters/screens/original-GR-series/57.GR (Заказ №2410 - СМП) бом/57.GR (Заказ №2410 - СМП) бом/57/Шпонка 9х14х150.SLDPRT

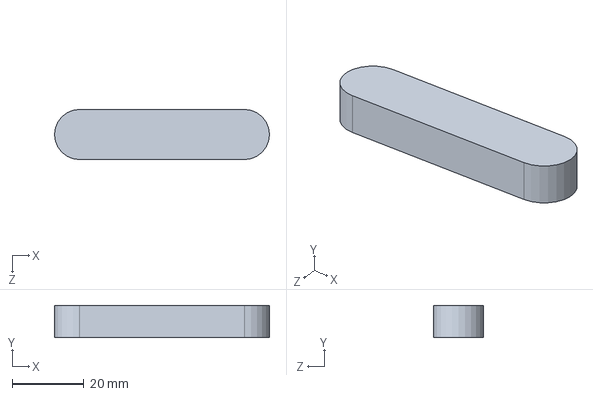
[picture p98: CAD file, 2026-10-06]
screens/original-GR-series/57.GR (Заказ №2410 - СМП) бом/57.GR (Заказ №2410 - СМП) бом/57/Шпонка 9х14х150.SLDPRT
60.0 x 9.00 x 14.0 mm
