hisp2k/parameters/screens/original-GR-series/57.GR (Заказ №2410 - СМП) бом/57.GR (Заказ №2410 - СМП) бом/57/57.GR.00.00.00.01  Крышка.SLDPRT

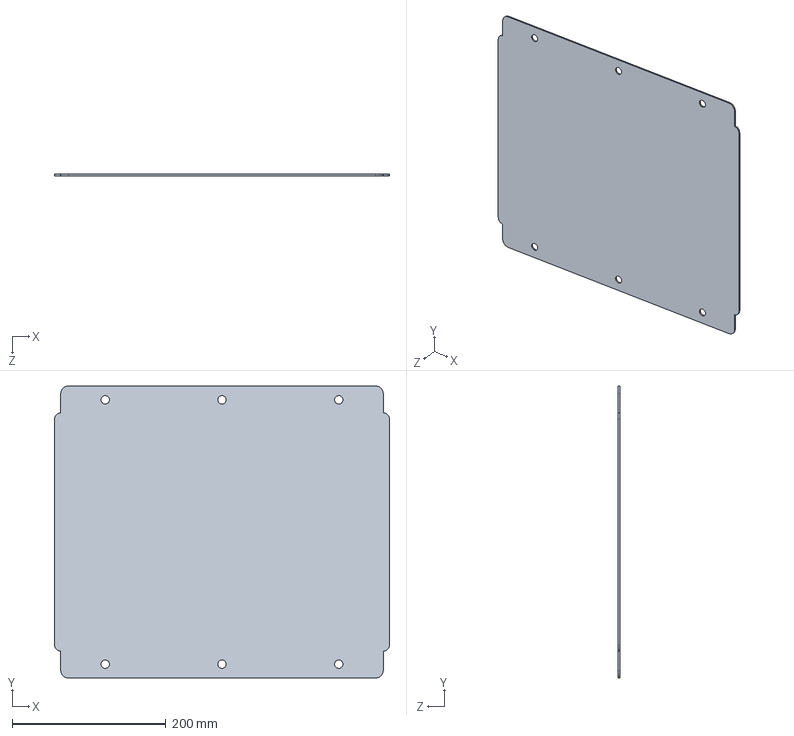
[picture p99: CAD file, 2026-10-06]
screens/original-GR-series/57.GR (Заказ №2410 - СМП) бом/57.GR (Заказ №2410 - СМП) бом/57/57.GR.00.00.00.01 Крышка.SLDPRT
436.0 x 380.0 x 2.00 mm
