hisp2k/parameters/screens/original-GR-series/57.GR (Заказ №2410 - СМП) бом/57.GR (Заказ №2410 - СМП) бом/57/Винт М16х155 DIN 7984 ОЦ.SLDPRT

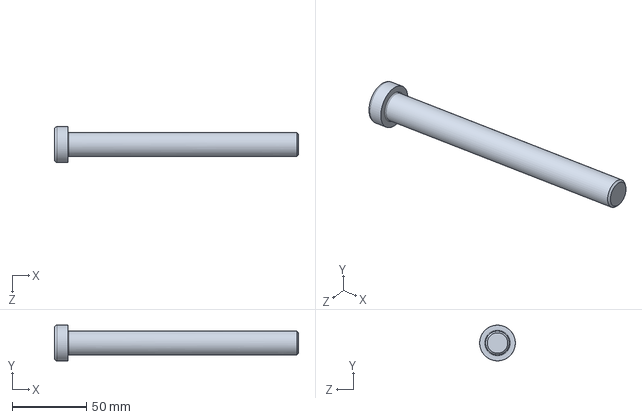
[picture p100: CAD file, 2026-10-06]
screens/original-GR-series/57.GR (Заказ №2410 - СМП) бом/57.GR (Заказ №2410 - СМП) бом/57/Винт М16х155 DIN 7984 ОЦ.SLDPRT
164.0 x 24.0 x 24.0 mm
