hisp2k/parameters/screens/original-GR-series/57.GR (Заказ №2410 - СМП) бом/57.GR (Заказ №2410 - СМП) бом/57/57.GR.07.01.00.04  Пластина.SLDPRT

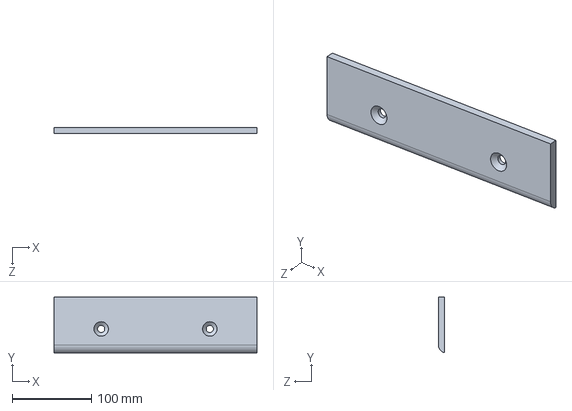
[picture p102: CAD file, 2026-10-06]
screens/original-GR-series/57.GR (Заказ №2410 - СМП) бом/57.GR (Заказ №2410 - СМП) бом/57/57.GR.07.01.00.04 Пластина.SLDPRT
256.0 x 70.0 x 8.00 mm
