hisp2k/parameters/screens/original-GR-series/57.GR (Заказ №2410 - СМП) бом/57.GR (Заказ №2410 - СМП) бом/57/57.GR.01.02.00.01-01  Труба.SLDPRT

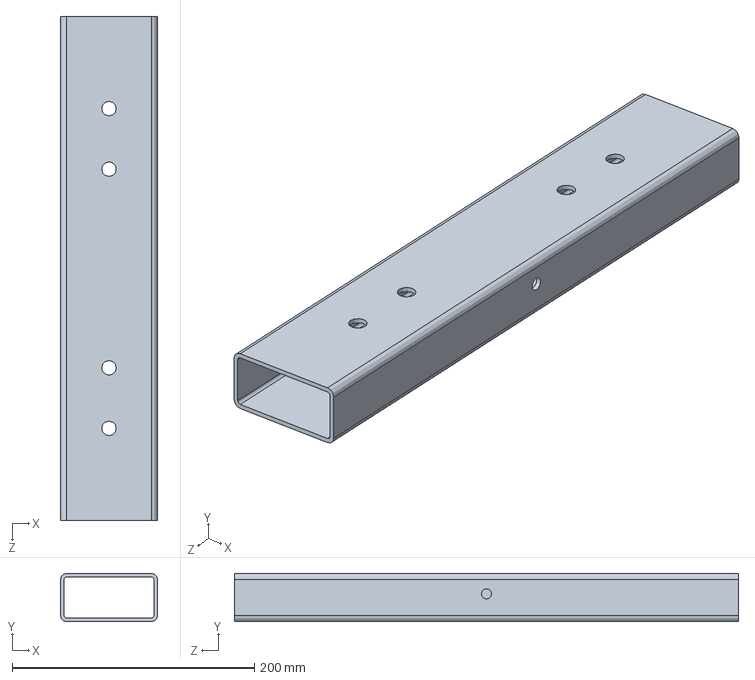
[picture p104: CAD file, 2026-10-06]
screens/original-GR-series/57.GR (Заказ №2410 - СМП) бом/57.GR (Заказ №2410 - СМП) бом/57/57.GR.01.02.00.01-01 Труба.SLDPRT
80.0 x 40.0 x 416.0 mm
