hisp2k/parameters/grit-chambers/parametric/deliverables/grit_chamber/01_CAD/GRIT_MASTER_V13_20261003.SLDPRT

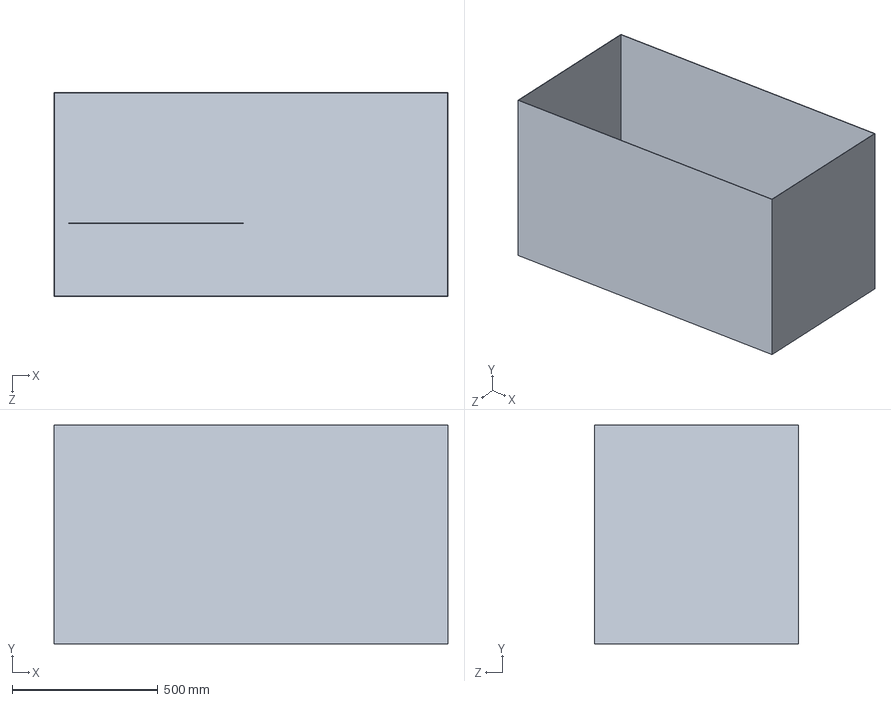
[picture p105: CAD file, 2026-10-06]
grit-chambers/parametric/deliverables/grit_chamber/01_CAD/GRIT_MASTER_V13_20261003.SLDPRT
1350.0 x 750.0 x 700.0 mm
