hisp2k/parameters/screens/original-GR-series/57.GR (Заказ №2410 - СМП) бом/57.GR (Заказ №2410 - СМП) бом/57/Шайба увеличенная М8 D30 A4.SLDPRT

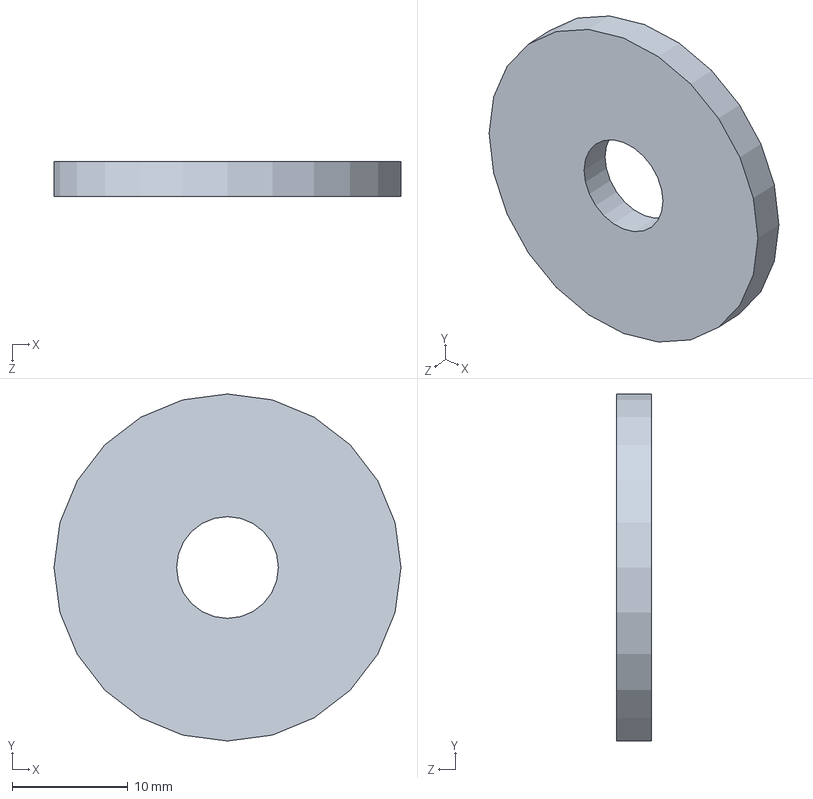
[picture p106: CAD file, 2026-10-06]
screens/original-GR-series/57.GR (Заказ №2410 - СМП) бом/57.GR (Заказ №2410 - СМП) бом/57/Шайба увеличенная М8 D30 A4.SLDPRT
30.0 x 30.0 x 3.00 mm
