hisp2k/parameters/screens/original-GR-series/57.GR (Заказ №2410 - СМП) бом/57.GR (Заказ №2410 - СМП) бом/57/Винт М6х16 DIN 7991 A4.SLDPRT

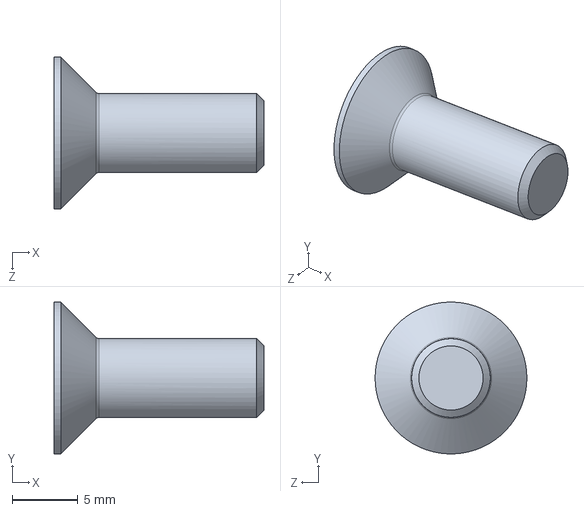
[picture p107: CAD file, 2026-10-06]
screens/original-GR-series/57.GR (Заказ №2410 - СМП) бом/57.GR (Заказ №2410 - СМП) бом/57/Винт М6х16 DIN 7991 A4.SLDPRT
16.0 x 11.6 x 11.6 mm
