hisp2k/parameters/grit-chambers/parametric/deliverables/grit_chamber/01_CAD/GRIT_DETAIL_NARROW_20261003.SLDPRT

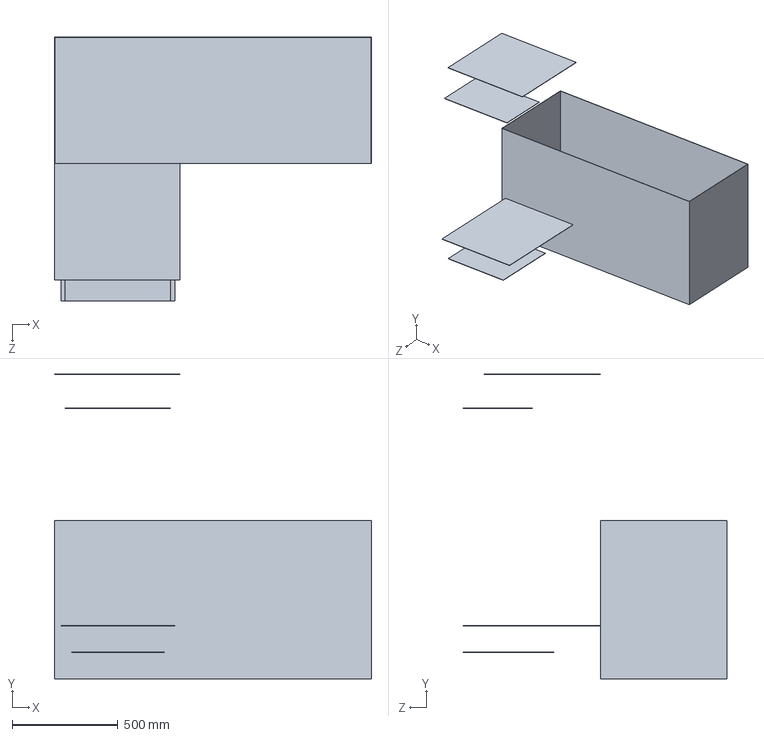
[picture p108: CAD file, 2026-10-06]
grit-chambers/parametric/deliverables/grit_chamber/01_CAD/GRIT_DETAIL_NARROW_20261003.SLDPRT
1500.0 x 1442.0 x 1250.0 mm
