hisp2k/parameters/screens/original-GR-series/57.GR (Заказ №2410 - СМП) бом/57.GR (Заказ №2410 - СМП) бом/57/Винт М8х30 DIN 7991 А4.SLDPRT

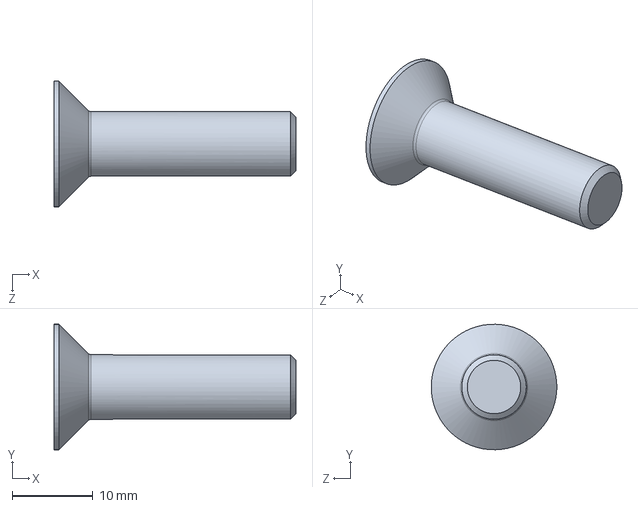
[picture p109: CAD file, 2026-10-06]
screens/original-GR-series/57.GR (Заказ №2410 - СМП) бом/57.GR (Заказ №2410 - СМП) бом/57/Винт М8х30 DIN 7991 А4.SLDPRT
30.0 x 15.6 x 15.6 mm
