hisp2k/parameters/screens/original-GR-series/57.GR (Заказ №2410 - СМП) бом/57.GR (Заказ №2410 - СМП) бом/57/00.GR.12.05.00.00-01  Палец цепи.SLDPRT

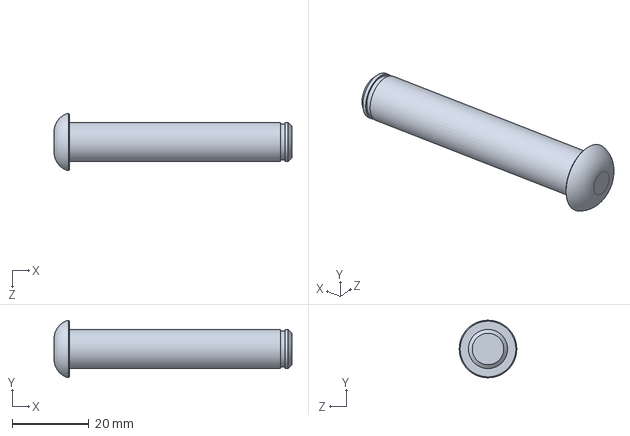
[picture p110: CAD file, 2026-10-06]
screens/original-GR-series/57.GR (Заказ №2410 - СМП) бом/57.GR (Заказ №2410 - СМП) бом/57/00.GR.12.05.00.00-01 Палец цепи.SLDPRT
62.0 x 15.0 x 15.0 mm
