hisp2k/parameters/screens/original-GR-series/57.GR (Заказ №2410 - СМП) бом/57.GR (Заказ №2410 - СМП) бом/57/Кольцо стопорное D80 DIN 472.SLDPRT

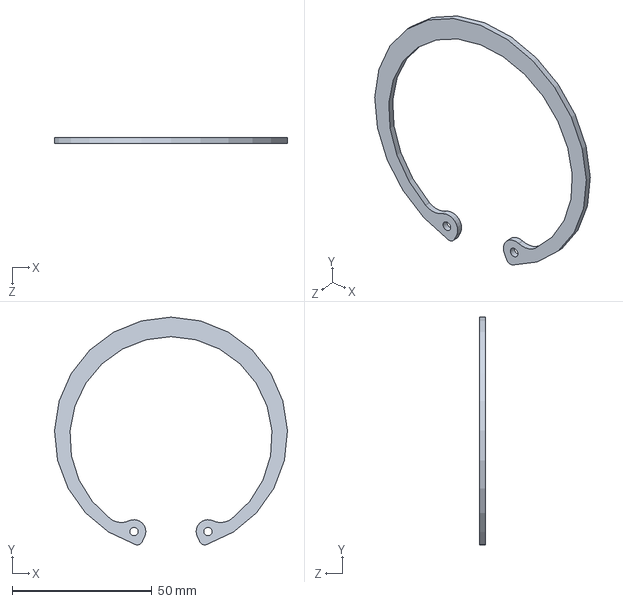
[picture p112: CAD file, 2026-10-06]
screens/original-GR-series/57.GR (Заказ №2410 - СМП) бом/57.GR (Заказ №2410 - СМП) бом/57/Кольцо стопорное D80 DIN 472.SLDPRT
83.5 x 81.6 x 2.00 mm
