hisp2k/parameters/screens/original-GR-series/57.GR (Заказ №2410 - СМП) бом/57.GR (Заказ №2410 - СМП) бом/57/00.GR.01.01.00.03-01  Палец натяжителя.SLDPRT

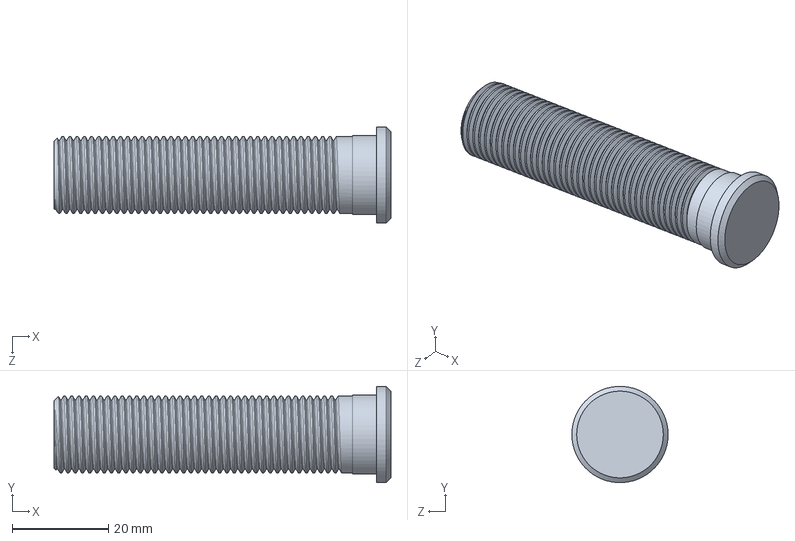
[picture p113: CAD file, 2026-10-06]
screens/original-GR-series/57.GR (Заказ №2410 - СМП) бом/57.GR (Заказ №2410 - СМП) бом/57/00.GR.01.01.00.03-01 Палец натяжителя.SLDPRT
70.0 x 20.0 x 20.0 mm
