hisp2k/parameters/screens/original-GR-series/57.GR (Заказ №2410 - СМП) бом/57.GR (Заказ №2410 - СМП) бом/57/00.GR.01.01.02.02  Заглушка.SLDPRT

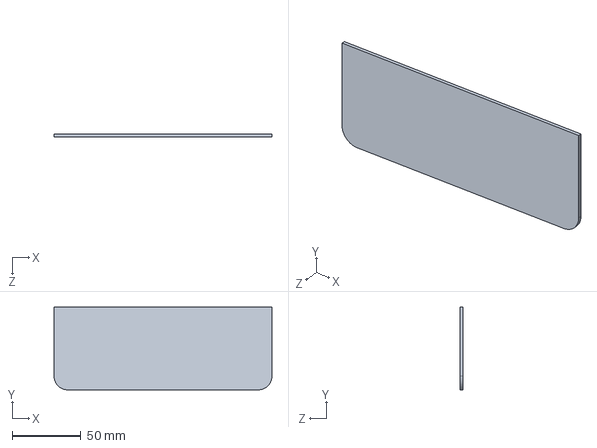
[picture p114: CAD file, 2026-10-06]
screens/original-GR-series/57.GR (Заказ №2410 - СМП) бом/57.GR (Заказ №2410 - СМП) бом/57/00.GR.01.01.02.02 Заглушка.SLDPRT
158.0 x 60.0 x 2.00 mm
