hisp2k/parameters/grit-chambers/parametric/deliverables/grit_chamber/01_CAD/GRIT_INLET_CUT_TEST.SLDPRT

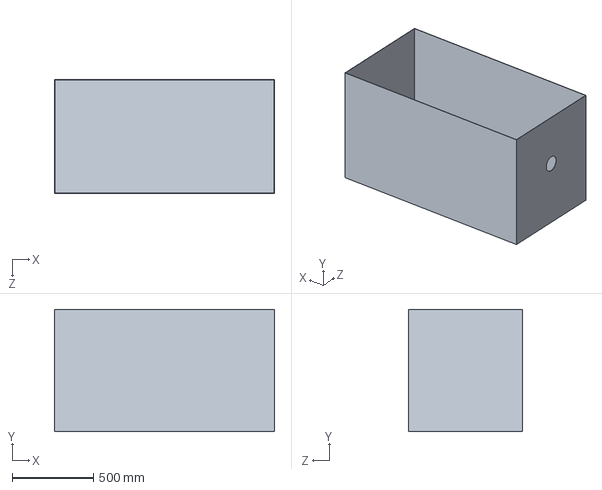
[picture p115: CAD file, 2026-10-06]
grit-chambers/parametric/deliverables/grit_chamber/01_CAD/GRIT_INLET_CUT_TEST.SLDPRT
1350.0 x 750.0 x 700.0 mm
