hisp2k/parameters/screens/original-GR-series/57.GR (Заказ №2410 - СМП) бом/57.GR (Заказ №2410 - СМП) бом/57/00.GR.10.04.00.00  Втулка.SLDPRT

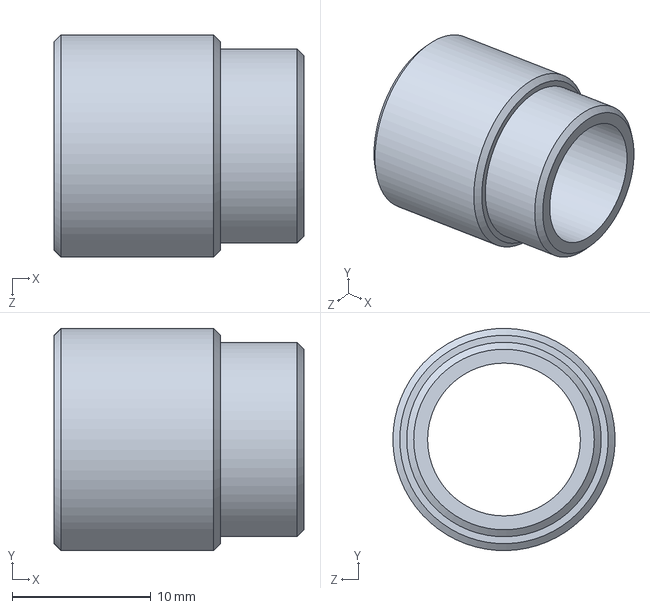
[picture p116: CAD file, 2026-10-06]
screens/original-GR-series/57.GR (Заказ №2410 - СМП) бом/57.GR (Заказ №2410 - СМП) бом/57/00.GR.10.04.00.00 Втулка.SLDPRT
18.0 x 16.0 x 16.0 mm
