hisp2k/parameters/screens/original-GR-series/57.GR (Заказ №2410 - СМП) бом/57.GR (Заказ №2410 - СМП) бом/57/Винт М12х60 DIN 7984 A4.SLDPRT

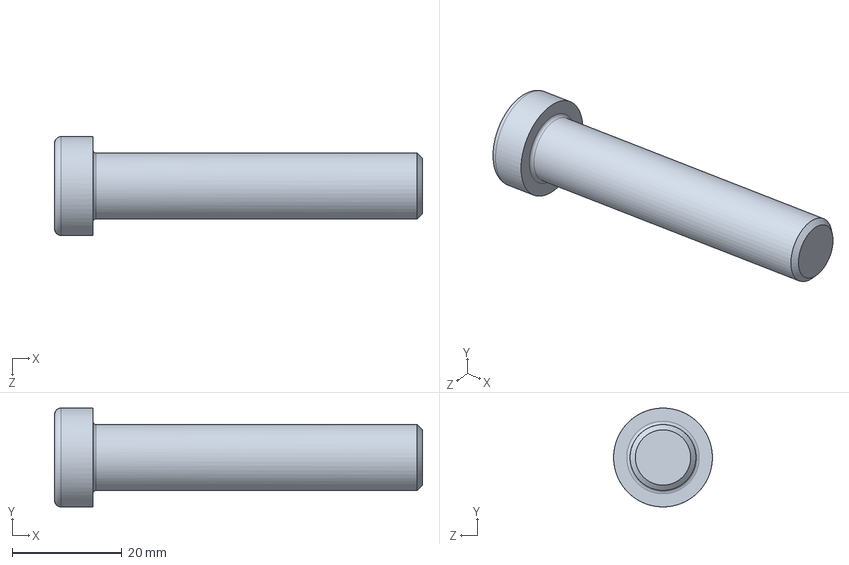
[picture p118: CAD file, 2026-10-06]
screens/original-GR-series/57.GR (Заказ №2410 - СМП) бом/57.GR (Заказ №2410 - СМП) бом/57/Винт М12х60 DIN 7984 A4.SLDPRT
67.0 x 18.0 x 18.0 mm
