hisp2k/parameters/screens/original-GR-series/57.GR (Заказ №2410 - СМП) бом/57.GR (Заказ №2410 - СМП) бом/57/00.GR.04.02.00.03  Фланец редуктора pcrv 090-130.SLDPRT

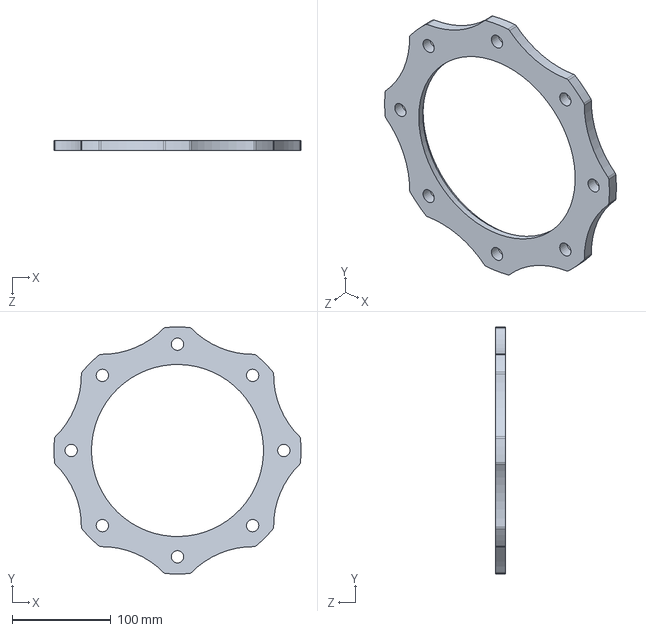
[picture p119: CAD file, 2026-10-06]
screens/original-GR-series/57.GR (Заказ №2410 - СМП) бом/57.GR (Заказ №2410 - СМП) бом/57/00.GR.04.02.00.03 Фланец редуктора pcrv 090-130.SLDPRT
249.9 x 249.9 x 10.0 mm
