hisp2k/parameters/grit-chambers/parametric/deliverables/grit_chamber/01_CAD/GRIT_PILOT_NARROW_FRAME_20261003.SLDPRT

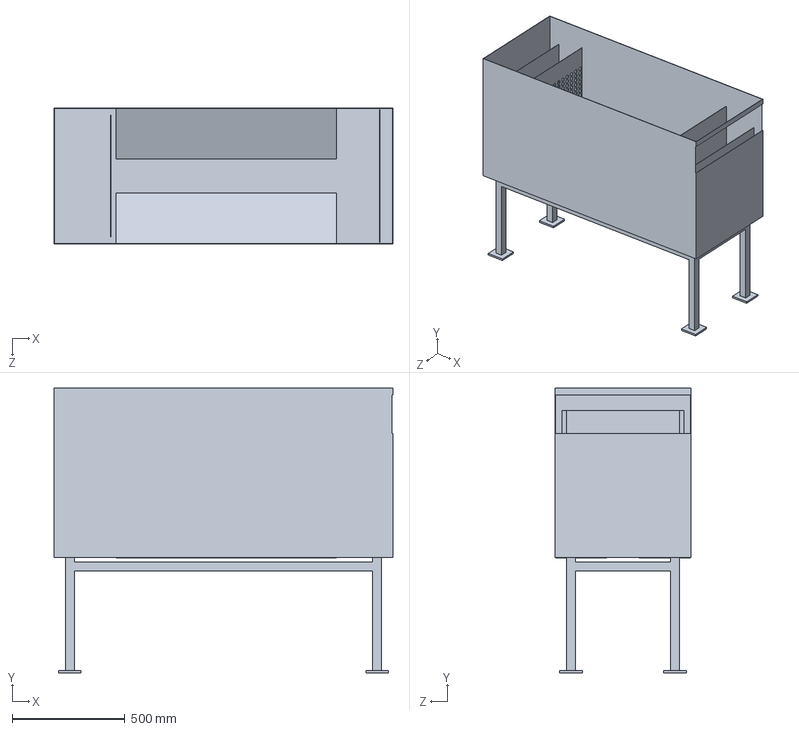
[picture p120: CAD file, 2026-10-06]
grit-chambers/parametric/deliverables/grit_chamber/01_CAD/GRIT_PILOT_NARROW_FRAME_20261003.SLDPRT
1500.0 x 1260.0 x 600.0 mm
