hisp2k/parameters/screens/original-GR-series/57.GR (Заказ №2410 - СМП) бом/57.GR (Заказ №2410 - СМП) бом/57/57.GR.01.00.00.01  Пол.SLDPRT

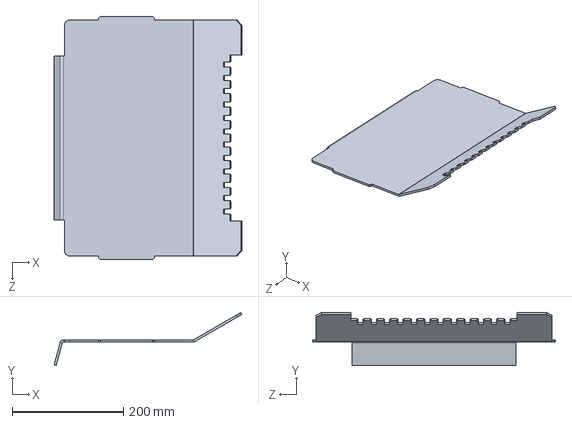
[picture p121: CAD file, 2026-10-06]
screens/original-GR-series/57.GR (Заказ №2410 - СМП) бом/57.GR (Заказ №2410 - СМП) бом/57/57.GR.01.00.00.01 Пол.SLDPRT
337.0 x 95.1 x 436.0 mm
