hisp2k/parameters/screens/original-GR-series/57.GR (Заказ №2410 - СМП) бом/57.GR (Заказ №2410 - СМП) бом/57/57.GR.01.01.01.01  Профиль верхний.SLDPRT

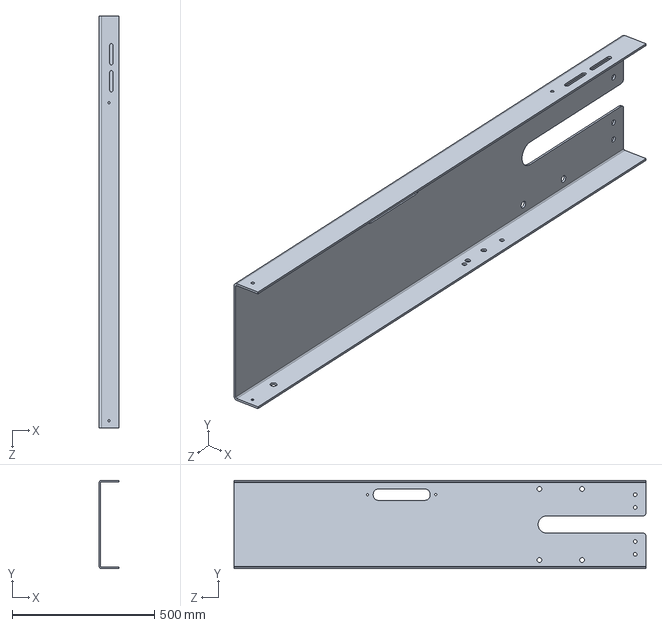
[picture p122: CAD file, 2026-10-06]
screens/original-GR-series/57.GR (Заказ №2410 - СМП) бом/57.GR (Заказ №2410 - СМП) бом/57/57.GR.01.01.01.01 Профиль верхний.SLDPRT
70.0 x 310.0 x 1450.0 mm
