hisp2k/parameters/screens/original-GR-series/57.GR (Заказ №2410 - СМП) бом/57.GR (Заказ №2410 - СМП) бом/57/00.GR.14.00.00.01  Втулка муфты большая.SLDPRT

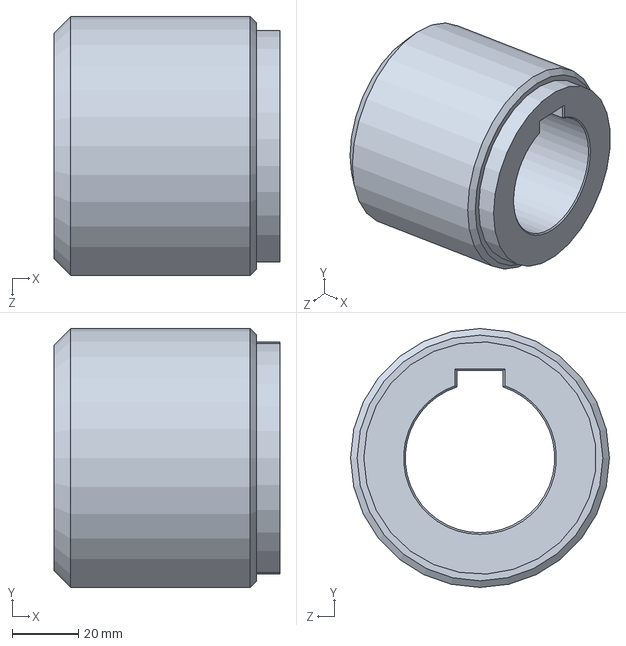
[picture p123: CAD file, 2026-10-06]
screens/original-GR-series/57.GR (Заказ №2410 - СМП) бом/57.GR (Заказ №2410 - СМП) бом/57/00.GR.14.00.00.01 Втулка муфты большая.SLDPRT
68.0 x 78.0 x 78.0 mm
