hisp2k/parameters/screens/original-GR-series/57.GR (Заказ №2410 - СМП) бом/57.GR (Заказ №2410 - СМП) бом/57/00.GR.13.00.00.02  Фланец муфты малой.SLDPRT

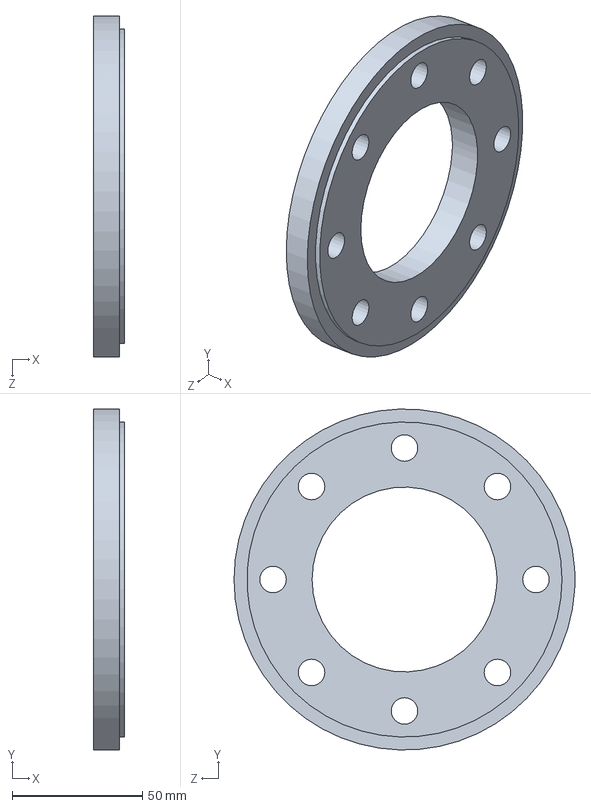
[picture p124: CAD file, 2026-10-06]
screens/original-GR-series/57.GR (Заказ №2410 - СМП) бом/57.GR (Заказ №2410 - СМП) бом/57/00.GR.13.00.00.02 Фланец муфты малой.SLDPRT
12.0 x 130.9 x 131.0 mm
