hisp2k/parameters/screens/original-GR-series/57.GR (Заказ №2410 - СМП) бом/57.GR (Заказ №2410 - СМП) бом/57/Звено 2 HP38.1F10.SLDPRT

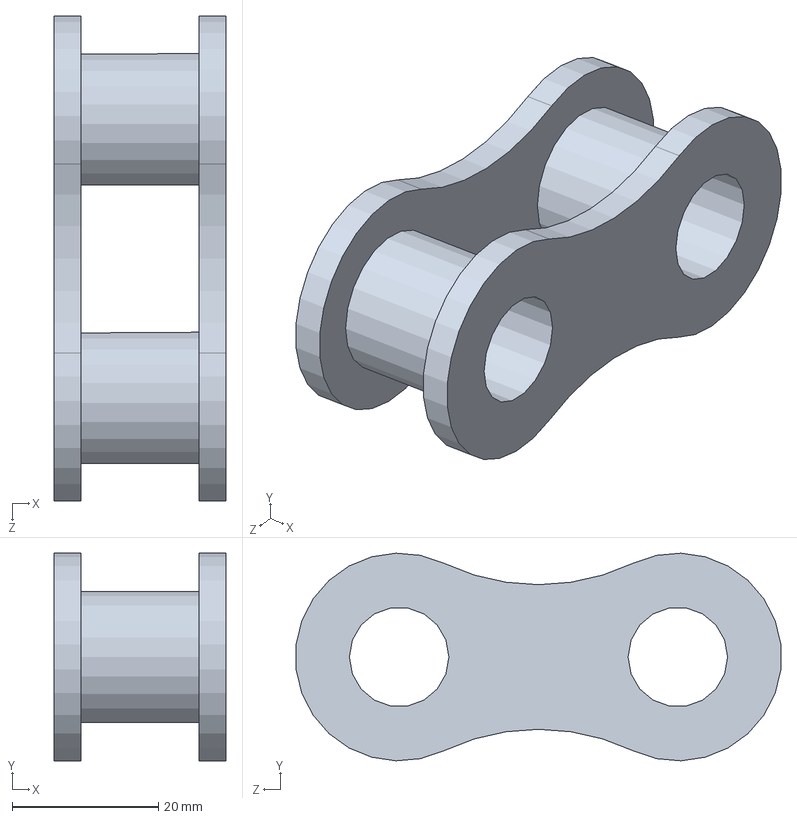
[picture p126: CAD file, 2026-10-06]
screens/original-GR-series/57.GR (Заказ №2410 - СМП) бом/57.GR (Заказ №2410 - СМП) бом/57/Звено 2 HP38.1F10.SLDPRT
23.5 x 28.4 x 66.3 mm
