hisp2k/parameters/screens/original-GR-series/57.GR (Заказ №2410 - СМП) бом/57.GR (Заказ №2410 - СМП) бом/57/00.GR.15.00.00.01  Основание под Крюк.SLDPRT

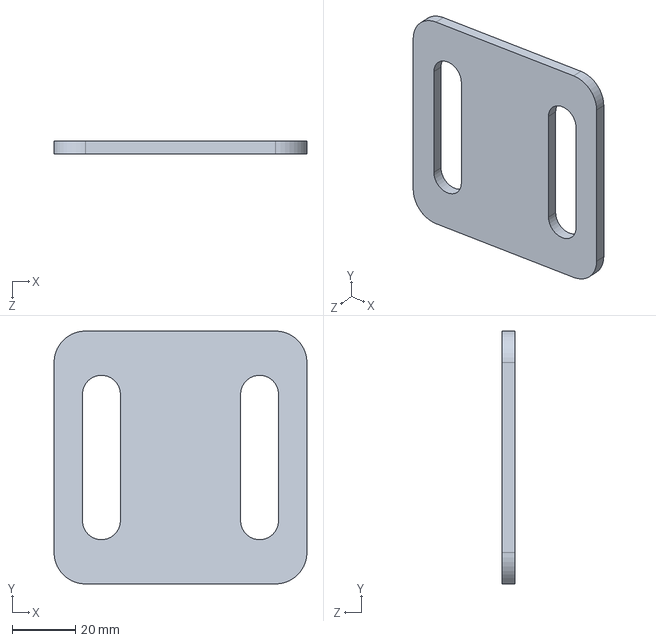
[picture p127: CAD file, 2026-10-06]
screens/original-GR-series/57.GR (Заказ №2410 - СМП) бом/57.GR (Заказ №2410 - СМП) бом/57/00.GR.15.00.00.01 Основание под Крюк.SLDPRT
80.0 x 80.0 x 4.00 mm
