hisp2k/parameters/grit-chambers/parametric/deliverables/grit_chamber/01_CAD/GRIT_PILOT_SHORT_WIDE_20261003.SLDPRT

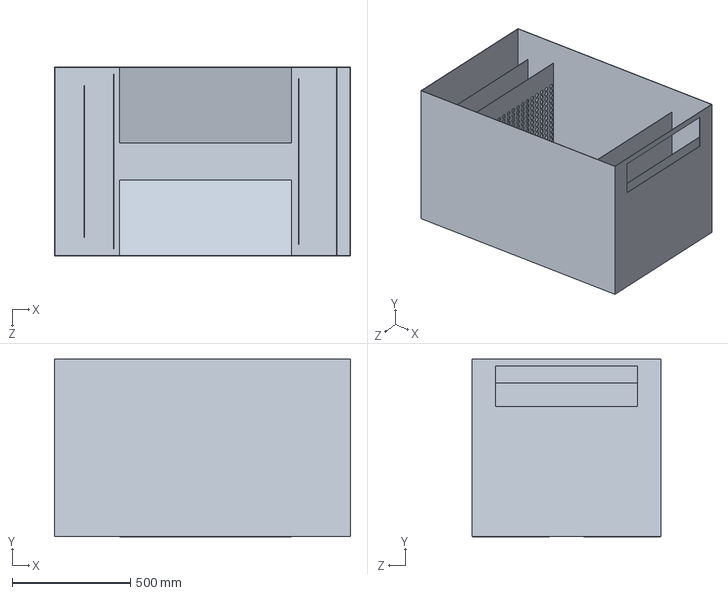
[picture p128: CAD file, 2026-10-06]
grit-chambers/parametric/deliverables/grit_chamber/01_CAD/GRIT_PILOT_SHORT_WIDE_20261003.SLDPRT
1250.0 x 751.0 x 800.0 mm
