hisp2k/parameters/screens/original-GR-series/57.GR (Заказ №2410 - СМП) бом/57.GR (Заказ №2410 - СМП) бом/57/Гайка М10 DIN 934 А4.SLDPRT

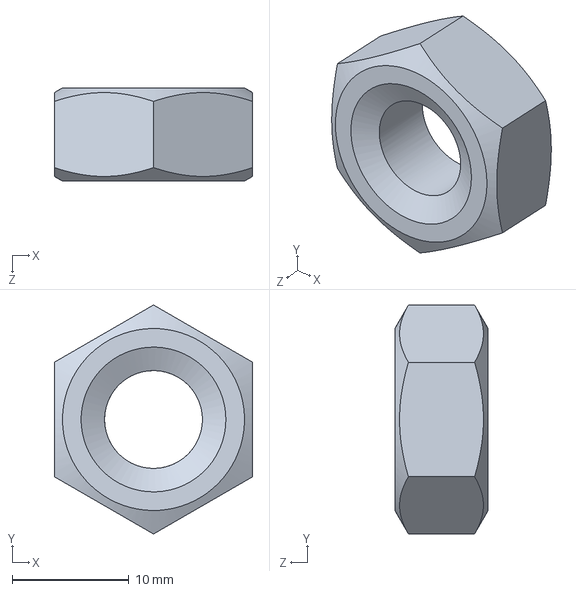
[picture p129: CAD file, 2026-10-06]
screens/original-GR-series/57.GR (Заказ №2410 - СМП) бом/57.GR (Заказ №2410 - СМП) бом/57/Гайка М10 DIN 934 А4.SLDPRT
17.0 x 19.6 x 8.00 mm
