hisp2k/parameters/screens/original-GR-series/57.GR (Заказ №2410 - СМП) бом/57.GR (Заказ №2410 - СМП) бом/57/57.GR.10.01.00.00  Уголок.SLDPRT

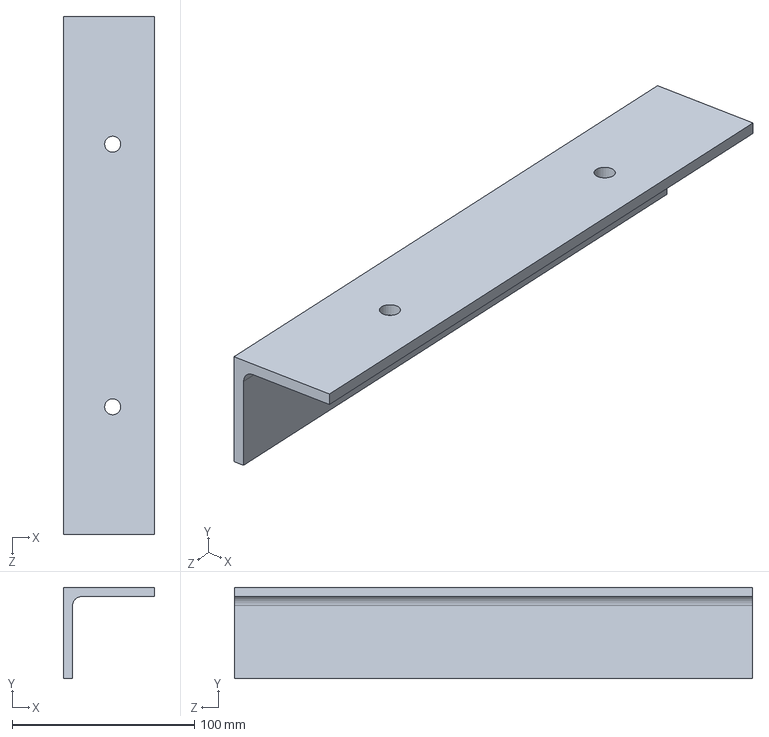
[picture p130: CAD file, 2026-10-06]
screens/original-GR-series/57.GR (Заказ №2410 - СМП) бом/57.GR (Заказ №2410 - СМП) бом/57/57.GR.10.01.00.00 Уголок.SLDPRT
50.0 x 50.0 x 284.0 mm
