hisp2k/parameters/screens/original-GR-series/57.GR (Заказ №2410 - СМП) бом/57.GR (Заказ №2410 - СМП) бом/57/Звезда HP38.1F10 z=16.SLDPRT

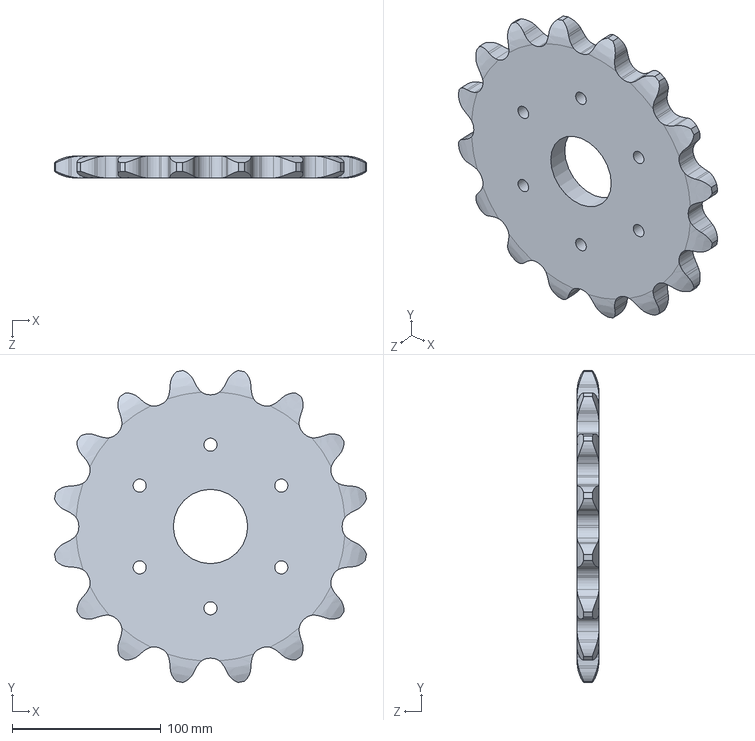
[picture p131: CAD file, 2026-10-06]
screens/original-GR-series/57.GR (Заказ №2410 - СМП) бом/57.GR (Заказ №2410 - СМП) бом/57/Звезда HP38.1F10 z=16.SLDPRT
209.8 x 209.8 x 14.8 mm
