hisp2k/parameters/screens/original-GR-series/57.GR (Заказ №2410 - СМП) бом/57.GR (Заказ №2410 - СМП) бом/57/57.GR.01.00.00.05  Щит.SLDPRT

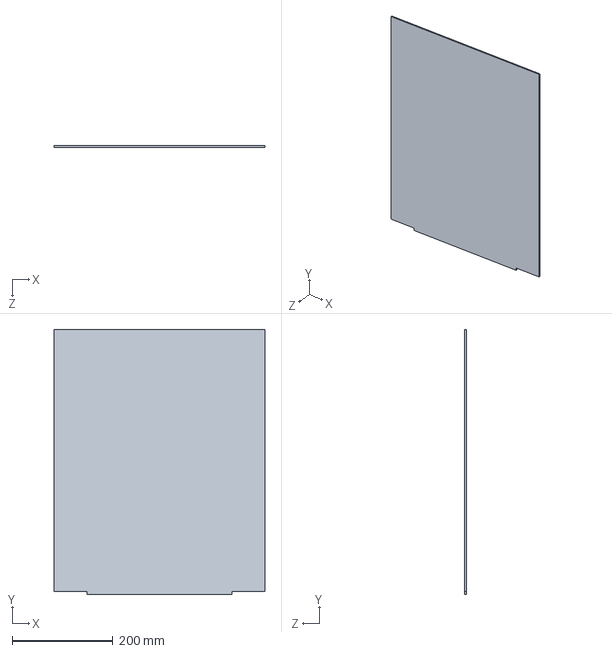
[picture p132: CAD file, 2026-10-06]
screens/original-GR-series/57.GR (Заказ №2410 - СМП) бом/57.GR (Заказ №2410 - СМП) бом/57/57.GR.01.00.00.05 Щит.SLDPRT
419.0 x 527.0 x 3.00 mm
