hisp2k/parameters/screens/original-GR-series/57.GR (Заказ №2410 - СМП) бом/57.GR (Заказ №2410 - СМП) бом/57/00.GR.07.01.00.06  Подложка 2.SLDPRT

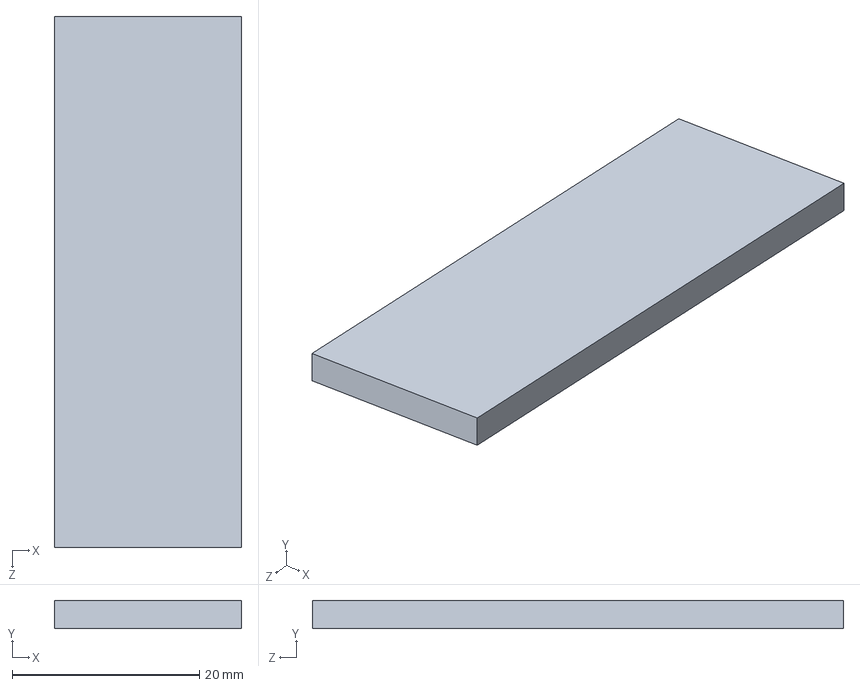
[picture p133: CAD file, 2026-10-06]
screens/original-GR-series/57.GR (Заказ №2410 - СМП) бом/57.GR (Заказ №2410 - СМП) бом/57/00.GR.07.01.00.06 Подложка 2.SLDPRT
20.0 x 3.00 x 56.8 mm
