hisp2k/parameters/screens/original-GR-series/57.GR (Заказ №2410 - СМП) бом/57.GR (Заказ №2410 - СМП) бом/57/57.GR.01.00.00.02  Уголок.SLDPRT

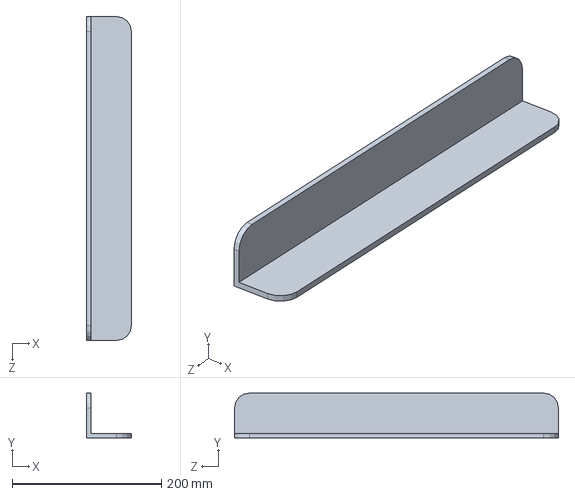
[picture p134: CAD file, 2026-10-06]
screens/original-GR-series/57.GR (Заказ №2410 - СМП) бом/57.GR (Заказ №2410 - СМП) бом/57/57.GR.01.00.00.02 Уголок.SLDPRT
60.0 x 60.0 x 434.0 mm
