hisp2k/parameters/containers/deliverables/0_22/bin_022m3.SLDASM

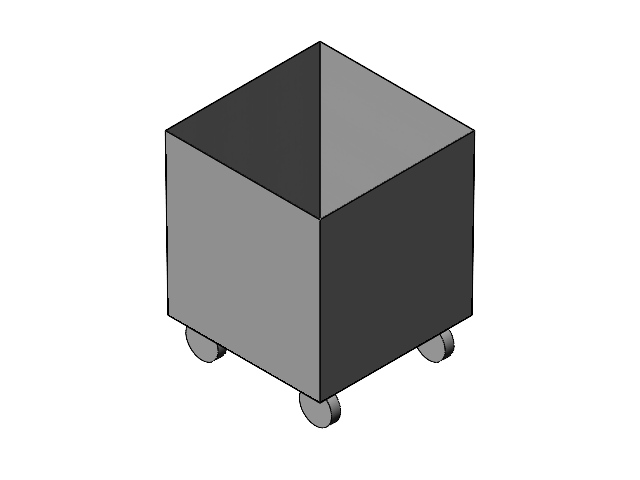
[picture p135: CAD file, 2026-10-06]
containers/deliverables/0_22/bin_022m3.SLDASM
bin_022_body
mount_plate_100x100x4 x 4
wheel_fixed_D125 x 2
wheel_swivel_D125 x 2
