hisp2k/parameters/screens/original-GR-series/57.GR (Заказ №2410 - СМП) бом/57.GR (Заказ №2410 - СМП) бом/57/00.GR.15.00.00.00 СБ  Кронштейн.SLDASM

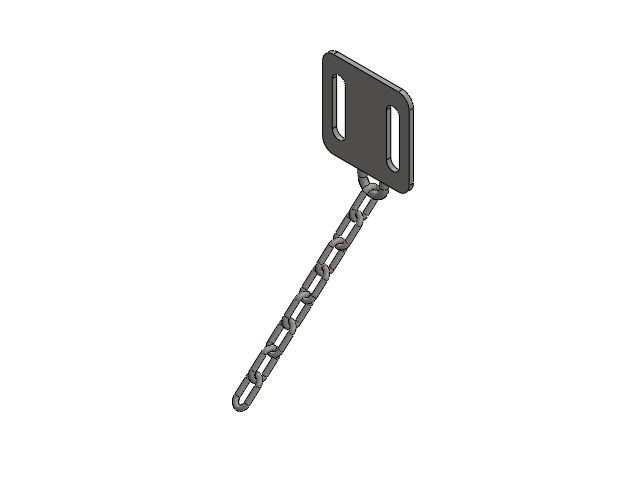
[picture p136: CAD file, 2026-10-06]
screens/original-GR-series/57.GR (Заказ №2410 - СМП) бом/57.GR (Заказ №2410 - СМП) бом/57/00.GR.15.00.00.00 СБ Кронштейн.SLDASM
00.GR.15.00.00.01 Основание под Крюк
00.GR.15.00.00.02 Крюк
Звено 4х21 А2 нерж. x 8
