hisp2k/parameters/screens/original-GR-series/57.GR (Заказ №2410 - СМП) бом/57.GR (Заказ №2410 - СМП) бом/57/57.GR.03.01.00.00 СБ  Вал.SLDASM

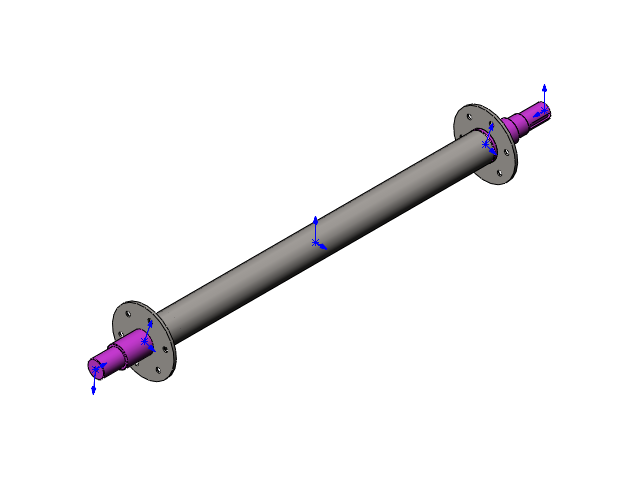
[picture p137: CAD file, 2026-10-06]
screens/original-GR-series/57.GR (Заказ №2410 - СМП) бом/57.GR (Заказ №2410 - СМП) бом/57/57.GR.03.01.00.00 СБ Вал.SLDASM
00.GR.03.00.00.02 Вал приводной
00.GR.03.00.00.03 Вал
58-59.GR.03.00.00.01 Труба
00.GR.03.00.00.04 Фланец под звезду x 2
