hisp2k/parameters/screens/original-GR-series/57.GR (Заказ №2410 - СМП) бом/57.GR (Заказ №2410 - СМП) бом/57/57.GR.07.01.00.00 СБ  Скребок.SLDASM

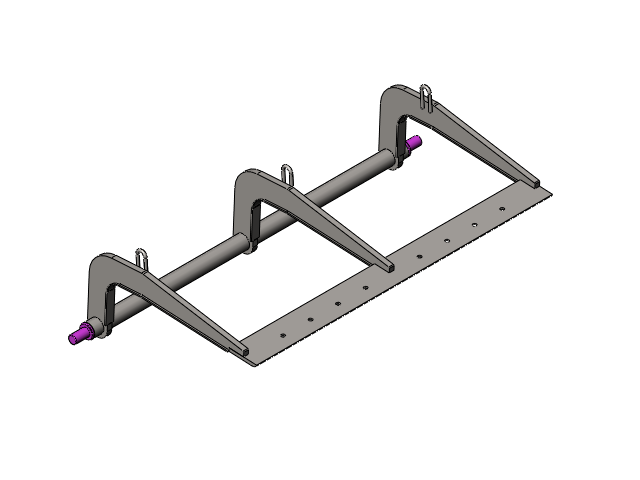
[picture p138: CAD file, 2026-10-06]
screens/original-GR-series/57.GR (Заказ №2410 - СМП) бом/57.GR (Заказ №2410 - СМП) бом/57/57.GR.07.01.00.00 СБ Скребок.SLDASM
58-59.GR.07.01.00.01 Труба
00.GR.07.01.00.02 Втулка x 2
00.GR.07.01.00.03 Ребро x 2
58-59.GR.07.01.00.04 Пластина
00.GR.07.01.00.05 Подложка 1 x 2
00.GR.07.01.00.06 Подложка 2 x 2
00.GR.07.01.00.07 Подложка 3 x 2
00.GR.07.01.00.08 Подложка гнутая x 2
00.GR.15.00.00.02 Крюк x 2
