hisp2k/parameters/screens/original-GR-series/57.GR (Заказ №2410 - СМП) бом/57.GR (Заказ №2410 - СМП) бом/57/00.GR.04.00.00.00 СБ  Опора редуктора в сборе.SLDASM

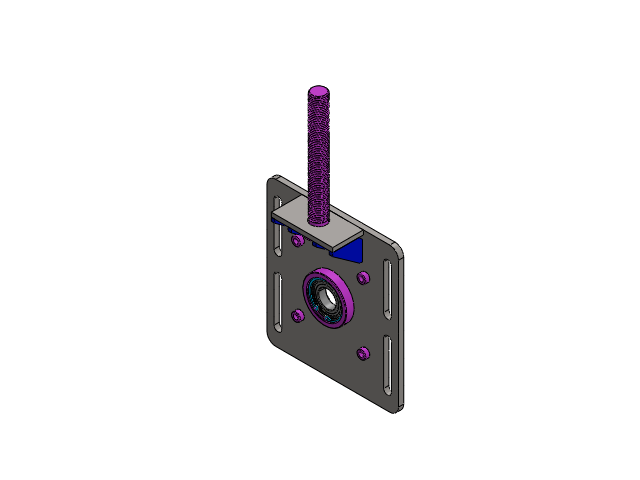
[picture p140: CAD file, 2026-10-06]
screens/original-GR-series/57.GR (Заказ №2410 - СМП) бом/57.GR (Заказ №2410 - СМП) бом/57/00.GR.04.00.00.00 СБ Опора редуктора в сборе.SLDASM
00.GR.04.01.00.01 Пластина
00.GR.04.01.00.02 Обойма
00.GR.04.01.00.03 Упор
00.GR.04.01.00.04 Ребро x 4
00.GR.04.01.00.05 Втулка x 4
SKF_208_2Z_17 x 13
SKF_208_2Z_31
SKF_208_2Z_33
Кольцо стопорное D80 DIN 472
00.GR.12.06.00.00 Шпилька (УПОРНАЯ РЕЗЬБА S34х5)
