hisp2k/parameters/screens/original-GR-series/57.GR (Заказ №2410 - СМП) бом/57.GR (Заказ №2410 - СМП) бом/57/57.GR.09.00.00.00 СБ  Смотровая в сборе.SLDASM

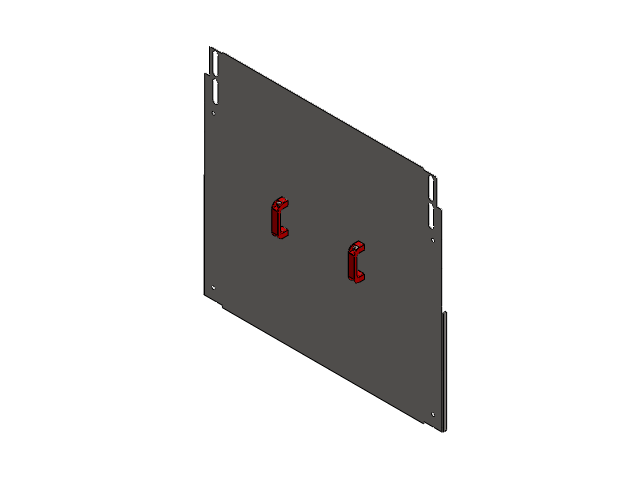
[picture p141: CAD file, 2026-10-06]
screens/original-GR-series/57.GR (Заказ №2410 - СМП) бом/57.GR (Заказ №2410 - СМП) бом/57/57.GR.09.00.00.00 СБ Смотровая в сборе.SLDASM
58-59.GR.09.00.00.01 Щит
Ручка скоба с втулками пластиковая x 2
Винт М8х27 DIN 7984 А4 x 4
Гайка М8 ГОСТ 5916-70 А4 x 4
