hisp2k/parameters/screens/original-GR-series/57.GR (Заказ №2410 - СМП) бом/57.GR (Заказ №2410 - СМП) бом/57/57.GR.03.00.00.00 СБ  Вал в сборе.SLDASM

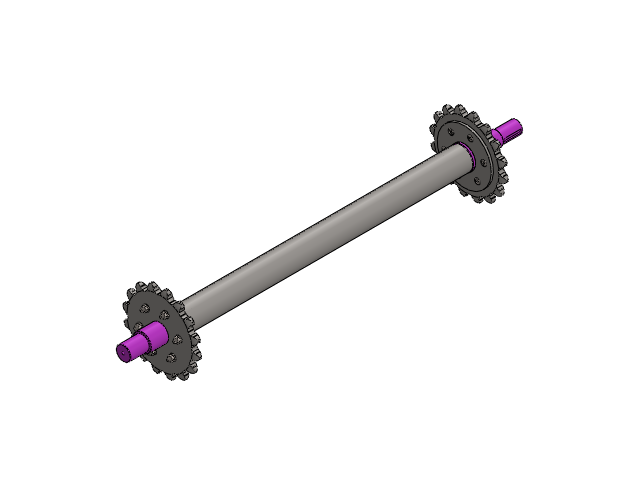
[picture p142: CAD file, 2026-10-06]
screens/original-GR-series/57.GR (Заказ №2410 - СМП) бом/57.GR (Заказ №2410 - СМП) бом/57/57.GR.03.00.00.00 СБ Вал в сборе.SLDASM
00.GR.03.00.00.02 Вал приводной
00.GR.03.00.00.03 Вал
58-59.GR.03.00.00.01 Труба
00.GR.03.00.00.04 Фланец под звезду x 2
Звезда HP38.1F10 z=16 x 2
Винт М8х35 DIN 7991 А4 x 12
Гайка М8 DIN 6923 A4 x 12
