hisp2k/parameters/screens/original-GR-series/57.GR (Заказ №2410 - СМП) бом/57.GR (Заказ №2410 - СМП) бом/57/00.GR.01.01.03.00 СБ  Основа опоры.SLDASM

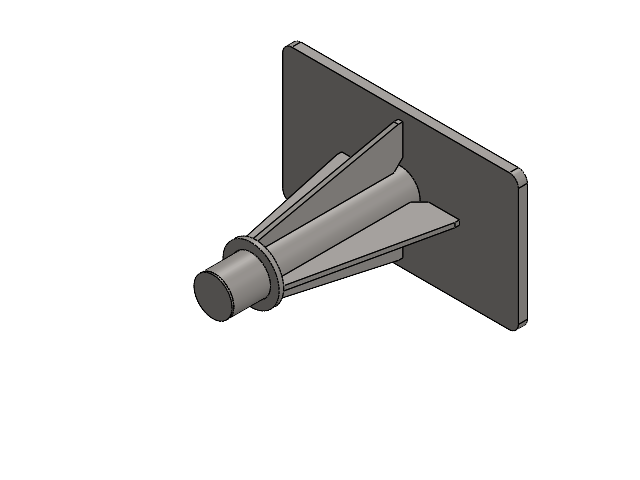
[picture p143: CAD file, 2026-10-06]
screens/original-GR-series/57.GR (Заказ №2410 - СМП) бом/57.GR (Заказ №2410 - СМП) бом/57/00.GR.01.01.03.00 СБ Основа опоры.SLDASM
00.GR.01.01.03.01 Пластина
00.GR.01.01.03.02 Труба опорная
00.GR.01.01.03.03 Косынка x 4
00.GR.01.01.03.04 Кольцо
00.GR.01.01.03.05 Заглушка
