hisp2k/parameters/screens/original-GR-series/57.GR (Заказ №2410 - СМП) бом/57.GR (Заказ №2410 - СМП) бом/57/57.GR.12.00.00.00 СБ  Труба натяжная.SLDASM

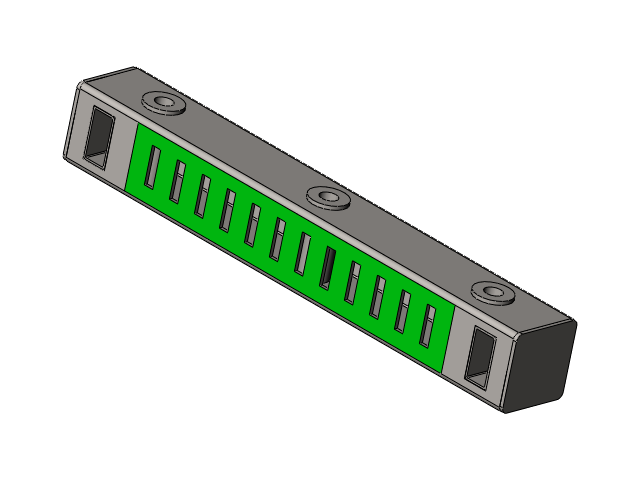
[picture p144: CAD file, 2026-10-06]
screens/original-GR-series/57.GR (Заказ №2410 - СМП) бом/57.GR (Заказ №2410 - СМП) бом/57/57.GR.12.00.00.00 СБ Труба натяжная.SLDASM
58-59.GR.12.00.00.01 Проф труба
00.GR.12.00.00.02 Втулка вварная x 3
00.GR.12.00.00.03 Труба плоскоовальная x 2
00.GR.12.00.00.04 Заглушка x 2
