hisp2k/parameters/screens/original-GR-series/57.GR (Заказ №2410 - СМП) бом/57.GR (Заказ №2410 - СМП) бом/57/00.GR.04.01.00.00 СБ  Опора редуктора.SLDASM

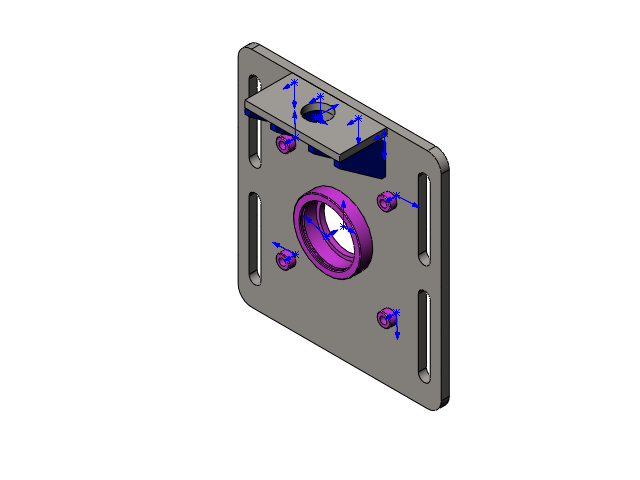
[picture p145: CAD file, 2026-10-06]
screens/original-GR-series/57.GR (Заказ №2410 - СМП) бом/57.GR (Заказ №2410 - СМП) бом/57/00.GR.04.01.00.00 СБ Опора редуктора.SLDASM
00.GR.04.01.00.01 'Пластина'
00.GR.04.01.00.02 'Обойма'
00.GR.04.01.00.03 'Упор'
00.GR.04.01.00.04 'Ребро' x 4
00.GR.04.01.00.05 'Втулка' x 4
