hisp2k/parameters/screens/original-GR-series/57.GR (Заказ №2410 - СМП) бом/57.GR (Заказ №2410 - СМП) бом/57/00.GR.08.00.00.00 СБ  Опора.SLDASM

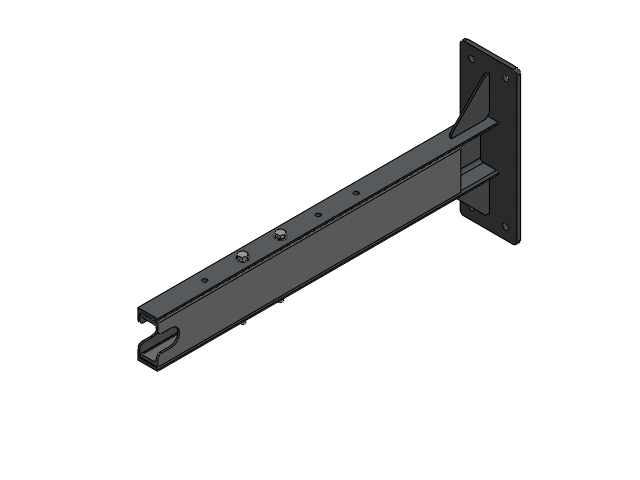
[picture p146: CAD file, 2026-10-06]
screens/original-GR-series/57.GR (Заказ №2410 - СМП) бом/57.GR (Заказ №2410 - СМП) бом/57/00.GR.08.00.00.00 СБ Опора.SLDASM
00.GR.08.01.00.01 Швеллер 12П
00.GR.08.01.00.02 Пятка
00.GR.08.01.00.03 Косынка x 2
00.GR.08.00.00.04 Швеллер 10П
Болт М12х150 DIN 933 ОЦ x 2
Шайба М12 DIN 125 ОЦ x 2
Гайка М12 DIN 6923 ОЦ x 2
