hisp2k/parameters/screens/original-GR-series/57.GR (Заказ №2410 - СМП) бом/57.GR (Заказ №2410 - СМП) бом/57/00.GR.13.00.00.00 СБ  Муфта малая.SLDASM

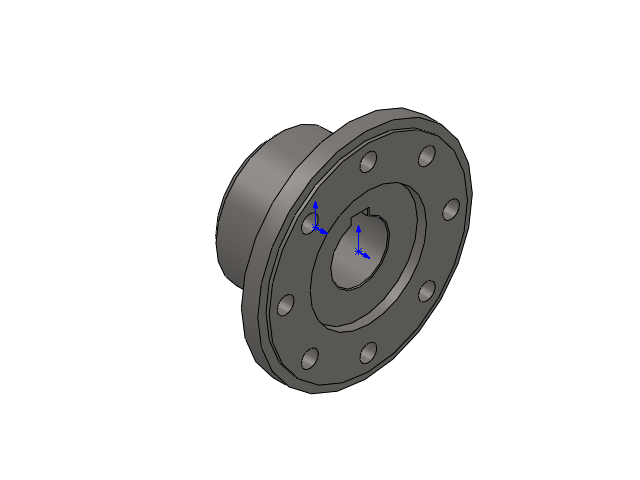
[picture p147: CAD file, 2026-10-06]
screens/original-GR-series/57.GR (Заказ №2410 - СМП) бом/57.GR (Заказ №2410 - СМП) бом/57/00.GR.13.00.00.00 СБ Муфта малая.SLDASM
00.GR.13.00.00.01 Втулка муфты малая
00.GR.13.00.00.02 Фланец муфты малой
