hisp2k/parameters/screens/original-GR-series/57.GR (Заказ №2410 - СМП) бом/57.GR (Заказ №2410 - СМП) бом/57/57.GR.01.01.00.00 СБ  Боковина.SLDASM

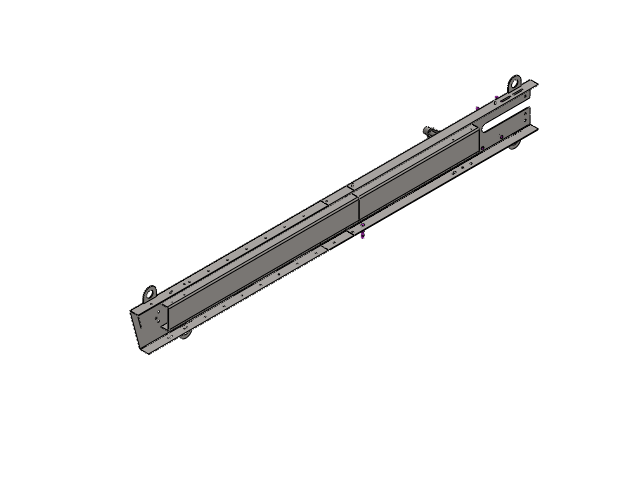
[picture p148: CAD file, 2026-10-06]
screens/original-GR-series/57.GR (Заказ №2410 - СМП) бом/57.GR (Заказ №2410 - СМП) бом/57/57.GR.01.01.00.00 СБ Боковина.SLDASM
59.GR.01.01.01.01 Профиль верхний
59.GR.01.01.01.02 Профиль нижний
59.GR.01.01.01.03 Профиль средний
59.GR.01.01.02.01 Профиль средний
59.GR.01.01.02.01-01 Профиль средний
00.GR.01.01.02.02 Заглушка
00.GR.01.01.03.01 Пластина
00.GR.01.01.03.02 Труба опорная
00.GR.01.01.03.03 Косынка x 4
00.GR.01.01.03.04 Кольцо
00.GR.01.01.03.05 Заглушка
00.GR.01.01.00.06 Ухо x 4
00.GR.01.01.00.03 Палец натяжителя x 4
00.GR.01.01.00.03-01 Палец натяжителя
Шпилька М8x20 DIN 975 А4 x 4
