hisp2k/parameters/screens/original-GR-series/57.GR (Заказ №2410 - СМП) бом/57.GR (Заказ №2410 - СМП) бом/57/00.GR.06.00.00.00 СБ  Натяжитель.SLDASM

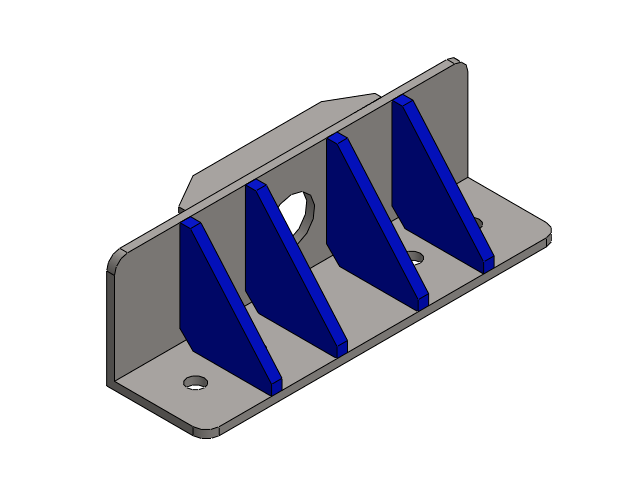
[picture p150: CAD file, 2026-10-06]
screens/original-GR-series/57.GR (Заказ №2410 - СМП) бом/57.GR (Заказ №2410 - СМП) бом/57/00.GR.06.00.00.00 СБ Натяжитель.SLDASM
00.GR.06.00.00.01 Уголок
00.GR.06.00.00.02 Ребро x 4
00.GR.06.00.00.03 Усиление
