hisp2k/parameters/screens/original-GR-series/57.GR (Заказ №2410 - СМП) бом/57.GR (Заказ №2410 - СМП) бом/57/57.GR.01.01.01.00-01 СБ  Профиль боковой.SLDASM

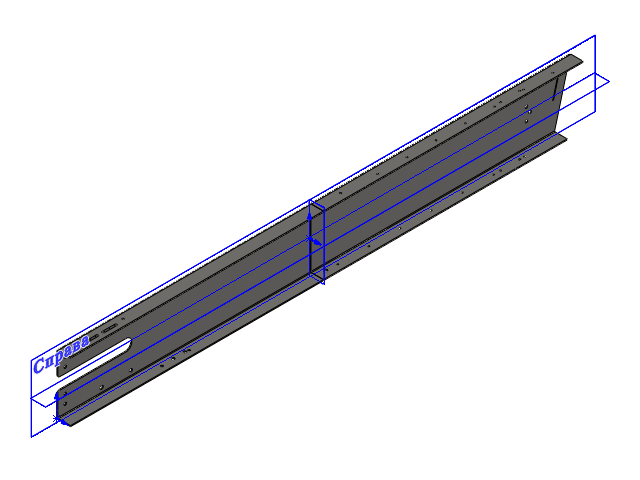
[picture p151: CAD file, 2026-10-06]
screens/original-GR-series/57.GR (Заказ №2410 - СМП) бом/57.GR (Заказ №2410 - СМП) бом/57/57.GR.01.01.01.00-01 СБ Профиль боковой.SLDASM
57.GR.01.01.01.01-01 Профиль верхний
57.GR.01.01.01.02-01 Профиль нижний
57.GR.01.01.01.03-01 Профиль средний
