hisp2k/parameters/screens/original-GR-series/57.GR (Заказ №2410 - СМП) бом/57.GR (Заказ №2410 - СМП) бом/57/57.GR.01.01.02.00 СБ  Профиль средний.SLDASM

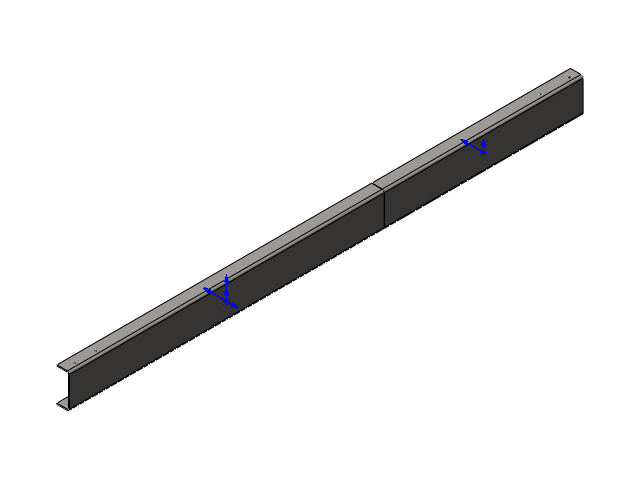
[picture p152: CAD file, 2026-10-06]
screens/original-GR-series/57.GR (Заказ №2410 - СМП) бом/57.GR (Заказ №2410 - СМП) бом/57/57.GR.01.01.02.00 СБ Профиль средний.SLDASM
59.GR.01.01.02.01 Профиль средний
59.GR.01.01.02.01-01 Профиль средний
