hisp2k/parameters/screens/original-GR-series/57.GR (Заказ №2410 - СМП) бом/57.GR (Заказ №2410 - СМП) бом/57/57.GR.10.00.00.00 СБ  Расческа.SLDASM

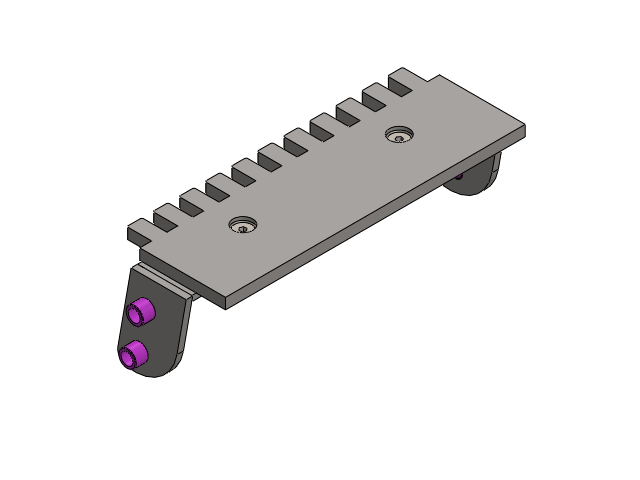
[picture p153: CAD file, 2026-10-06]
screens/original-GR-series/57.GR (Заказ №2410 - СМП) бом/57.GR (Заказ №2410 - СМП) бом/57/57.GR.10.00.00.00 СБ Расческа.SLDASM
58-59.GR.10.01.00.00 Уголок
00.GR.10.02.00.00 Торец x 2
58-59.GR.10.03.00.00 Расческа
00.GR.10.04.00.00 Втулка x 4
Винт М8х30 DIN 7991 А4 x 2
Гайка М8 DIN934 А4 x 2
Шайба гроверная М8 DIN127 А4 x 2
Шайба М8 DIN125 А4 x 2
