hisp2k/parameters/screens/original-GR-series/57.GR (Заказ №2410 - СМП) бом/57.GR (Заказ №2410 - СМП) бом/57/Подшипник UCF 308.SLDASM

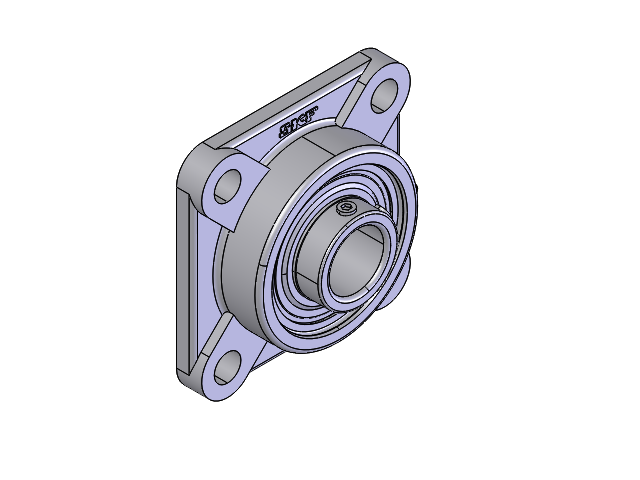
[picture p154: CAD file, 2026-10-06]
screens/original-GR-series/57.GR (Заказ №2410 - СМП) бом/57.GR (Заказ №2410 - СМП) бом/57/Подшипник UCF 308.SLDASM
SKF_UCF_308_3 x 8
SKF_UCF_308_12
SKF_UCF_308_14
SKF_UCF_308_16
