hisp2k/parameters/screens/original-GR-series/57.GR (Заказ №2410 - СМП) бом/57.GR (Заказ №2410 - СМП) бом/57/Подшипник UCP 204.SLDASM

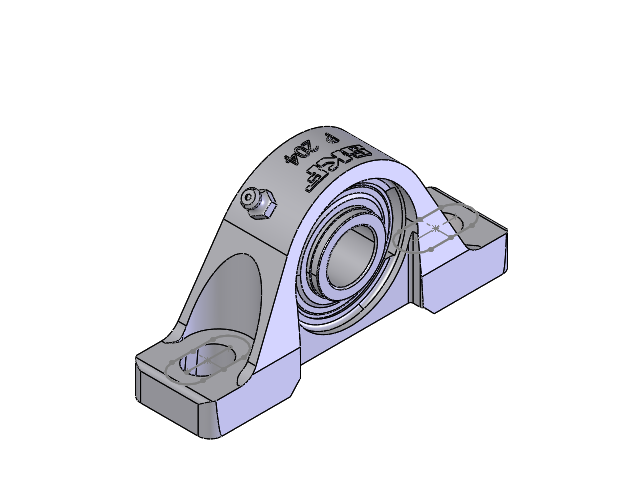
[picture p155: CAD file, 2026-10-06]
screens/original-GR-series/57.GR (Заказ №2410 - СМП) бом/57.GR (Заказ №2410 - СМП) бом/57/Подшипник UCP 204.SLDASM
SKF_UCP_204_3 x 8
SKF_UCP_204_12
SKF_UCP_204_14
SKF_UCP_204_16
