hisp2k/parameters/screens/original-GR-series/57.GR (Заказ №2410 - СМП) бом/57.GR (Заказ №2410 - СМП) бом/57/57.GR.01.02.00.00 СБ  Перегородка.SLDASM

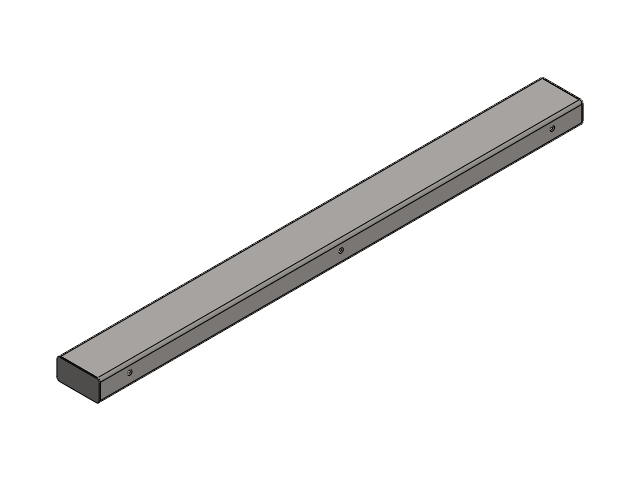
[picture p157: CAD file, 2026-10-06]
screens/original-GR-series/57.GR (Заказ №2410 - СМП) бом/57.GR (Заказ №2410 - СМП) бом/57/57.GR.01.02.00.00 СБ Перегородка.SLDASM
58-59.GR.01.02.00.01 Труба
00.GR.01.02.00.02 Заглушка x 2
