hisp2k/parameters/screens/original-GR-series/57.GR (Заказ №2410 - СМП) бом/57.GR (Заказ №2410 - СМП) бом/57/00.GR.04.02.00.00-130 СБ  Стакан.SLDASM

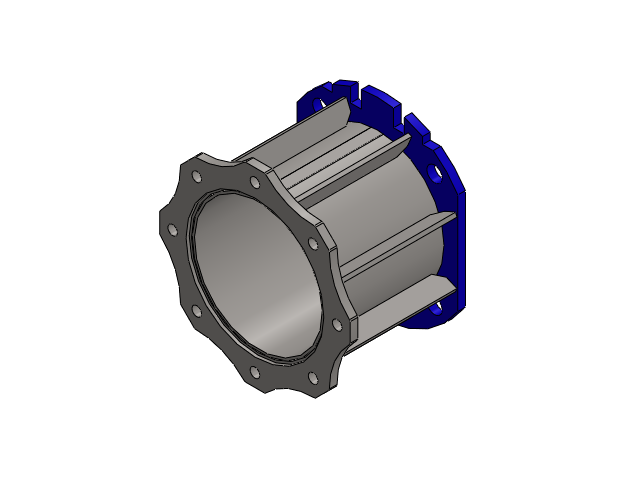
[picture p158: CAD file, 2026-10-06]
screens/original-GR-series/57.GR (Заказ №2410 - СМП) бом/57.GR (Заказ №2410 - СМП) бом/57/00.GR.04.02.00.00-130 СБ Стакан.SLDASM
00.GR.04.02.00.01 Фланец
00.GR.04.02.00.02-130 Косынка x 8
00.GR.04.02.00.03 Фланец редуктора pcrv 090-130
00.GR.04.02.00.04-130-01 Труба D168,3x3
00.GR.04.02.00.05-130 Вставка в трубу
