hisp2k/parameters/screens/original-GR-series/57.GR (Заказ №2410 - СМП) бом/57.GR (Заказ №2410 - СМП) бом/57/00.GR.05.00.00.00 СБ  Опора вала в сборе.SLDASM

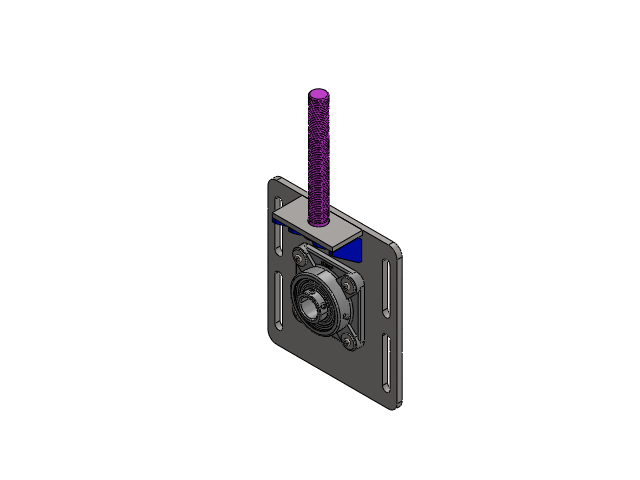
[picture p160: CAD file, 2026-10-06]
screens/original-GR-series/57.GR (Заказ №2410 - СМП) бом/57.GR (Заказ №2410 - СМП) бом/57/00.GR.05.00.00.00 СБ Опора вала в сборе.SLDASM
00.GR.05.01.00.01 Пластина
00.GR.05.01.00.02 Втулка x 4
00.GR.04.01.00.03 Упор
00.GR.04.01.00.04 Ребро x 4
SKF_UCF_308_3 x 8
SKF_UCF_308_12
SKF_UCF_308_14
SKF_UCF_308_16
Шайба увеличенная М8 D30 A4 x 4
Винт М8х20 DIN 7984 A4 x 4
00.GR.12.06.00.00 Шпилька (УПОРНАЯ РЕЗЬБА S34х5)
