hisp2k/parameters/screens/original-GR-series/57.GR (Заказ №2410 - СМП) бом/57.GR (Заказ №2410 - СМП) бом/57/Подшипник 208 2Z.SLDASM

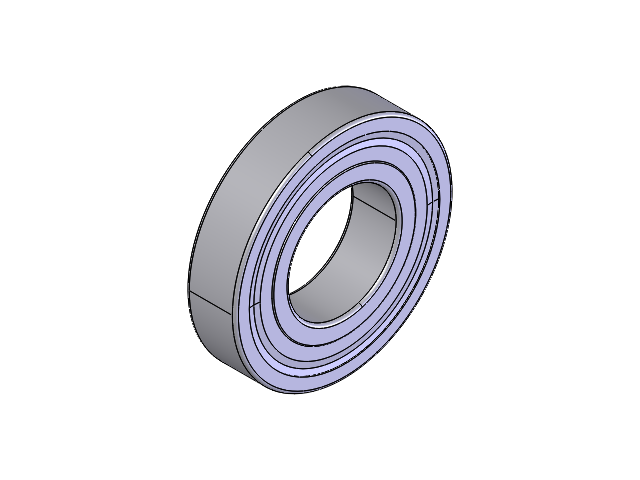
[picture p161: CAD file, 2026-10-06]
screens/original-GR-series/57.GR (Заказ №2410 - СМП) бом/57.GR (Заказ №2410 - СМП) бом/57/Подшипник 208 2Z.SLDASM
SKF_208_2Z_17 x 13
SKF_208_2Z_31
SKF_208_2Z_33
