hisp2k/parameters/screens/original-GR-series/57.GR (Заказ №2410 - СМП) бом/57.GR (Заказ №2410 - СМП) бом/57/00.GR.08.01.00.00 СБ  Основной швеллер.SLDASM

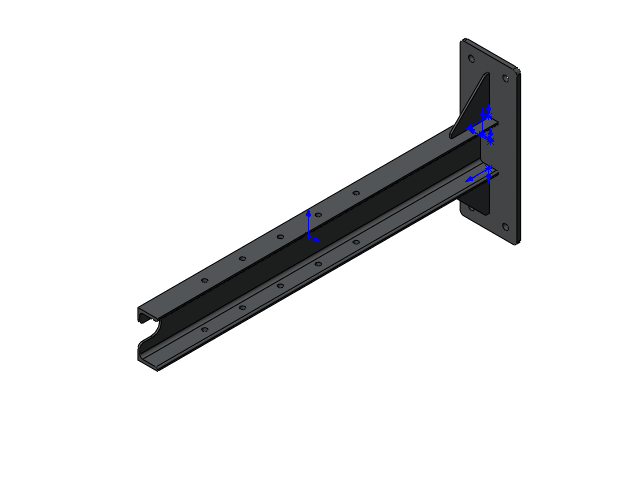
[picture p163: CAD file, 2026-10-06]
screens/original-GR-series/57.GR (Заказ №2410 - СМП) бом/57.GR (Заказ №2410 - СМП) бом/57/00.GR.08.01.00.00 СБ Основной швеллер.SLDASM
00.GR.08.01.00.01 'Швеллер 12П'
00.GR.08.01.00.02 'Пятка'
00.GR.08.01.00.03 'Косынка' x 2
