hisp2k/parameters/screens/original-GR-series/57.GR (Заказ №2410 - СМП) бом/57.GR (Заказ №2410 - СМП) бом/57/57.GR.01.03.00.00 СБ  Поперечина.SLDASM

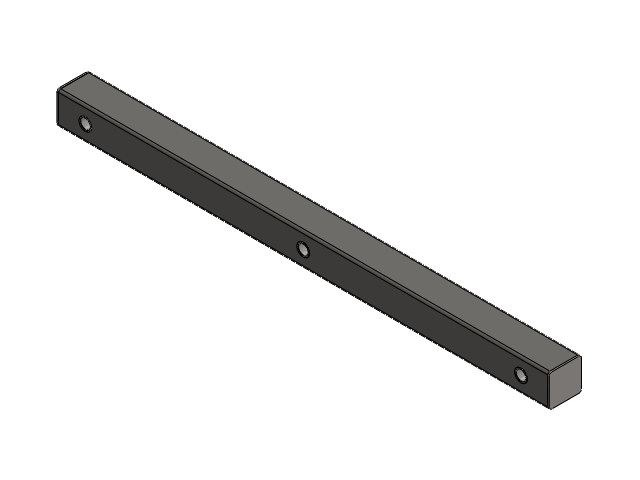
[picture p164: CAD file, 2026-10-06]
screens/original-GR-series/57.GR (Заказ №2410 - СМП) бом/57.GR (Заказ №2410 - СМП) бом/57/57.GR.01.03.00.00 СБ Поперечина.SLDASM
58-59.GR.12.00.00.01-01 СБ Проф труба
00.GR.12.00.00.04 Заглушка x 2
00.GR.12.00.00.02-01 СБ Втулка вварная x 3
