hisp2k/parameters/screens/original-GR-series/57.GR (Заказ №2410 - СМП) бом/57.GR (Заказ №2410 - СМП) бом/57/57.GR.11.00.00.00 СБ  Козырек.SLDASM

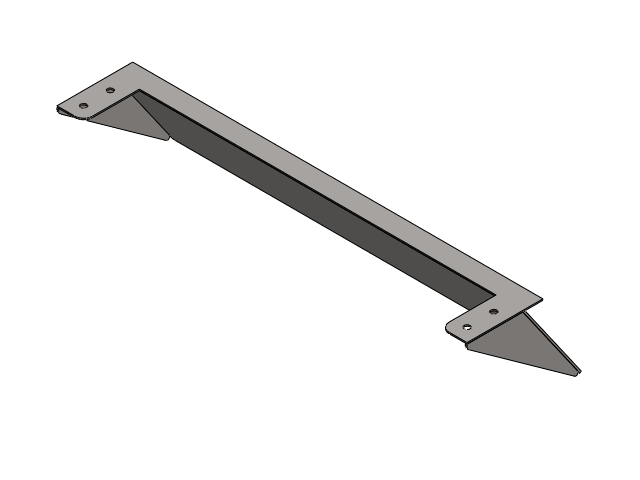
[picture p165: CAD file, 2026-10-06]
screens/original-GR-series/57.GR (Заказ №2410 - СМП) бом/57.GR (Заказ №2410 - СМП) бом/57/57.GR.11.00.00.00 СБ Козырек.SLDASM
58-59.GR.11.00.00.01 Панель
00.GR.11.00.00.02 Ребро x 2
58-59.GR.11.00.00.03 Лист
