hisp2k/parameters/screens/original-GR-series/57.GR (Заказ №2410 - СМП) бом/57.GR (Заказ №2410 - СМП) бом/57/57.GR.01.01.01.00 СБ  Профиль боковой.SLDASM

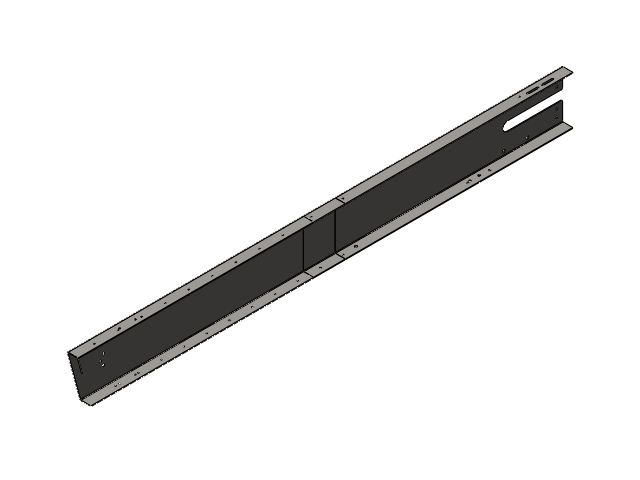
[picture p167: CAD file, 2026-10-06]
screens/original-GR-series/57.GR (Заказ №2410 - СМП) бом/57.GR (Заказ №2410 - СМП) бом/57/57.GR.01.01.01.00 СБ Профиль боковой.SLDASM
59.GR.01.01.01.01 Профиль верхний
59.GR.01.01.01.02 Профиль нижний
59.GR.01.01.01.03 Профиль средний
