hisp2k/parameters/screens/original-GR-series/57.GR (Заказ №2410 - СМП) бом/57.GR (Заказ №2410 - СМП) бом/57/.57.GR.00.00.00.00 СБ  Решетка грабельная.SLDASM

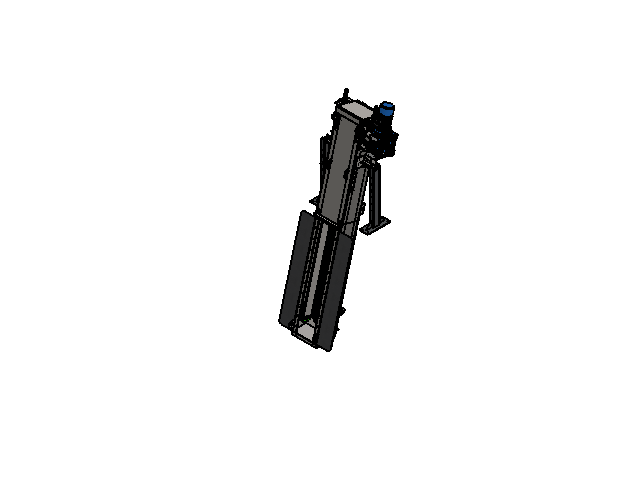
[picture p168: CAD file, 2026-10-06]
screens/original-GR-series/57.GR (Заказ №2410 - СМП) бом/57.GR (Заказ №2410 - СМП) бом/57/.57.GR.00.00.00.00 СБ Решетка грабельная.SLDASM
57.GR.01.01.01.01 Профиль верхний
57.GR.01.01.01.02 Профиль нижний
57.GR.01.01.01.03 Профиль средний
57.GR.01.01.02.01 Профиль средний x 2
57.GR.01.01.02.01-01 Профиль средний x 2
00.GR.01.01.02.02 Заглушка x 2
00.GR.01.01.03.01 Пластина x 2
00.GR.01.01.03.02 Труба опорная x 2
00.GR.01.01.03.03 Косынка x 8
00.GR.01.01.03.04 Кольцо x 2
00.GR.01.01.03.05 Заглушка x 2
00.GR.01.01.00.06 Ухо x 8
00.GR.01.01.00.03 Палец натяжителя x 8
00.GR.01.01.00.03-01 Палец натяжителя x 2
Шпилька М8x20 DIN 975 А4 x 8
57.GR.01.02.00.01 Труба
00.GR.01.02.00.02 Заглушка x 4
57.GR.01.02.00.01-01 Труба
57.GR.12.00.00.01-01 СБ Проф труба
00.GR.12.00.00.04 Заглушка x 4
00.GR.12.00.00.02-01 СБ Втулка вварная x 3
57.GR.01.00.00.01 Пол
57.GR.01.00.00.02 Уголок
57.GR.01.00.00.03 Уголок
57.GR.01.00.00.05 Щит
57.GR.01.00.00.06 Направляющая x 2
57.GR.01.00.00.07 Подложка
00.GR.01.00.00.09 Направляющая нижняя x 2
00.GR.01.00.00.10 Накладка x 4
Гайка М12 DIN 934 А4 x 6
Заглушка x 6
Винт М12х60 DIN 7984 A4 x 6
Шайба М12 DIN 125 А4 x 18
Винт М6х45 DIN 7991 А4 x 24
Винт М6х16 DIN 7991 A4 x 4
Гайка М6 DIN 934 А4 x 24
Винт М6х20 DIN 7984 А4 x 4
57.GR.11.00.00.04 Планка
00.GR.01.00.00.11 Подложка верхняя x 2
00.GR.01.00.00.12 Направляющая верхняя x 2
57.GR.01.00.00.07-01 Подложка
57.GR.01.01.01.01-01 Профиль верхний
57.GR.01.01.01.02-01 Профиль нижний
57.GR.01.01.01.03-01 Профиль средний
00.GR.03.00.00.02 Вал приводной
00.GR.03.00.00.03 Вал
57.GR.03.00.00.01 Труба
00.GR.03.00.00.04 Фланец под звезду x 2
Звезда HP38.1F10 z=16 x 2
Винт М8х35 DIN 7991 А4 x 12
Гайка М8 DIN 6923 A4 x 12
00.GR.04.01.00.01 Пластина
00.GR.04.01.00.02 Обойма
00.GR.04.01.00.03 Упор x 2
00.GR.04.01.00.04 Ребро x 8
00.GR.04.01.00.05 Втулка x 4
SKF_208_2Z_17 x 13
SKF_208_2Z_31
SKF_208_2Z_33
Кольцо стопорное D80 DIN 472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
