hisp2k/parameters/(list of files, cad)

Other CAD files:
grit-chambers/parametric/deliverables/grit_chamber/02_CFD/GRIT_CFD_BASE_PREP_20261004.SLDPRT
grit-chambers/parametric/deliverables/Песколовка/01_CAD/GRIT_MASTER_20261003.SLDPRT
screens/58-GR/Исходники/Downloads/58.GR.00.00.00.00 СБ Решетка грабельная (STEP 214 КТ)(2).STEP
screens/original-GR-series/57.GR (Заказ №2410 - СМП) бом/57.GR (Заказ №2410 - СМП) бом/5.GR-PR16-VM1900 1300x995.DWG
screens/original-GR-series/57.GR (Заказ №2410 - СМП) бом/57.GR (Заказ №2410 - СМП) бом/.57.GR.00.00.00.00 СБ Решетка грабельная (STEP 214 КТ).STEP
belt-conveyors/trough-LT500/deliverables/История_R10/Ленточный_транспортер/03_Модели_SolidWorks/ЛТ500_MASTER_исходная_геометрия_R01.SLDPRT
grit-chambers/parametric/deliverables/grit_chamber/01_CAD/GRIT_PILOT_NARROW_CAD_20261003.SLDPRT
belt-conveyors/flat-LT500/deliverables/Ленточный_транспортер/03_Модели_SolidWorks/ЛТ500_MASTER_исходная_геометрия_R01.SLDPRT
containers/deliverables/0_22/wheel_swivel_D125.SLDPRT
containers/deliverables/wheel_fixed_D160.SLDPRT
grit-chambers/parametric/deliverables/grit_chamber/01_CAD/GRIT_PILOT_BASE_CASING_TUBE_TEST.SLDPRT
grit-chambers/parametric/deliverables/grit_chamber/01_CAD/GRIT_PILOT_BASE_FRAME_20261003.SLDPRT
screens/original-GR-series/57.GR (Заказ №2410 - СМП) бом/57.GR (Заказ №2410 - СМП) бом/57/Винт M12х30 DIN 7984 А4.SLDPRT
grit-chambers/parametric/deliverables/grit_chamber/01_CAD/GRIT_PILOT_BASE_FRAME_TEST.SLDPRT
grit-chambers/parametric/deliverables/grit_chamber/01_CAD/GRIT_HELIX_TEST.SLDPRT
grit-chambers/parametric/deliverables/grit_chamber/01_CAD/GRIT_PILOT_BASE_CAD_20261003.SLDPRT
grit-chambers/parametric/deliverables/grit_chamber/01_CAD/GRIT_ORIENTATION_TEST.SLDPRT
containers/deliverables/0_22/bin_022_assembly.SLDDRW
containers/deliverables/0_22/bin_022_body.SLDDRW
containers/deliverables/0_22/bin_022_mount_plate.SLDDRW
containers/deliverables/bin_assembly.SLDDRW
grit-chambers/parametric/deliverables/grit_chamber/01_CAD/GRIT_DETAIL_BASE_V2_20261003.SLDPRT
grit-chambers/parametric/deliverables/grit_chamber/01_CAD/GRIT_DETAIL_BASE_V3_20261003.SLDPRT
grit-chambers/parametric/deliverables/grit_chamber/01_CAD/GRIT_DETAIL_BASE_V4_20261003.SLDPRT
grit-chambers/parametric/deliverables/grit_chamber/01_CAD/GRIT_DETAIL_BASE_V5_20261003.SLDPRT
grit-chambers/parametric/deliverables/grit_chamber/01_CAD/GRIT_DETAIL_BASE_V6_20261003.SLDPRT
grit-chambers/parametric/deliverables/grit_chamber/01_CAD/GRIT_DETAIL_NARROW_V2_20261003.SLDPRT
grit-chambers/parametric/deliverables/grit_chamber/01_CAD/GRIT_DETAIL_NARROW_V5_20261003.SLDPRT
grit-chambers/parametric/deliverables/grit_chamber/01_CAD/GRIT_DETAIL_SHORT_WIDE_V2_20261003.SLDPRT
grit-chambers/parametric/deliverables/grit_chamber/01_CAD/GRIT_DETAIL_SHORT_WIDE_V5_20261003.SLDPRT
grit-chambers/parametric/deliverables/grit_chamber/01_CAD/GRIT_MASTER_V10_20261003.SLDPRT
grit-chambers/parametric/deliverables/grit_chamber/01_CAD/GRIT_MASTER_V11_20261003.SLDPRT
grit-chambers/parametric/deliverables/grit_chamber/01_CAD/GRIT_MASTER_V12_20261003.SLDPRT
grit-chambers/parametric/deliverables/grit_chamber/01_CAD/GRIT_MASTER_V2_20261003.SLDPRT
grit-chambers/parametric/deliverables/grit_chamber/01_CAD/GRIT_MASTER_V3_20261003.SLDPRT
grit-chambers/parametric/deliverables/grit_chamber/01_CAD/GRIT_MASTER_V5_20261003.SLDPRT
grit-chambers/parametric/deliverables/grit_chamber/01_CAD/GRIT_MASTER_V6_20261003.SLDPRT
grit-chambers/parametric/deliverables/grit_chamber/01_CAD/GRIT_MASTER_V7_20261003.SLDPRT
grit-chambers/parametric/deliverables/grit_chamber/01_CAD/GRIT_MASTER_V8_20261003.SLDPRT
grit-chambers/parametric/deliverables/grit_chamber/01_CAD/GRIT_MASTER_V9_20261003.SLDPRT
grit-chambers/parametric/deliverables/grit_chamber/01_CAD/GRIT_PILOT_BASE_CASING_SCREW_TEST.SLDPRT
grit-chambers/parametric/deliverables/grit_chamber/01_CAD/GRIT_PILOT_BASE_SCREW_TEST.SLDPRT
screens/58-GR/Исходники/Downloads/58.GR.00.00.00.00 СБ Решетка грабельная (STEP 214 КТ)(2) (1).STEP
screens/original-GR-series/57.GR (Заказ №2410 - СМП) бом/57.GR (Заказ №2410 - СМП) бом/.57.GR.00.00.00.00 СБ Решетка грабельная.SLDDRW
screens/original-GR-series/57.GR (Заказ №2410 - СМП) бом/57.GR (Заказ №2410 - СМП) бом/57/00.GR.01.00.00.09 Направляющая нижняя.SLDPRT
screens/original-GR-series/57.GR (Заказ №2410 - СМП) бом/57.GR (Заказ №2410 - СМП) бом/57/00.GR.01.00.00.10 Накладка.SLDPRT
screens/original-GR-series/57.GR (Заказ №2410 - СМП) бом/57.GR (Заказ №2410 - СМП) бом/57/00.GR.01.00.00.11 Подложка верхняя.SLDPRT
screens/original-GR-series/57.GR (Заказ №2410 - СМП) бом/57.GR (Заказ №2410 - СМП) бом/57/00.GR.01.01.00.02 Заслонка.SLDPRT
screens/original-GR-series/57.GR (Заказ №2410 - СМП) бом/57.GR (Заказ №2410 - СМП) бом/57/00.GR.01.01.00.03 Палец натяжителя.SLDPRT
screens/original-GR-series/57.GR (Заказ №2410 - СМП) бом/57.GR (Заказ №2410 - СМП) бом/57/00.GR.01.01.00.06 Ухо.SLDPRT
screens/original-GR-series/57.GR (Заказ №2410 - СМП) бом/57.GR (Заказ №2410 - СМП) бом/57/00.GR.01.01.03.02 Труба опорная.SLDPRT
screens/original-GR-series/57.GR (Заказ №2410 - СМП) бом/57.GR (Заказ №2410 - СМП) бом/57/00.GR.01.01.03.03 Косынка.SLDPRT
screens/original-GR-series/57.GR (Заказ №2410 - СМП) бом/57.GR (Заказ №2410 - СМП) бом/57/00.GR.01.01.03.04 Кольцо.SLDPRT
screens/original-GR-series/57.GR (Заказ №2410 - СМП) бом/57.GR (Заказ №2410 - СМП) бом/57/00.GR.03.00.00.02 Вал приводной.SLDPRT
screens/original-GR-series/57.GR (Заказ №2410 - СМП) бом/57.GR (Заказ №2410 - СМП) бом/57/00.GR.03.00.00.03 Вал.SLDPRT
screens/original-GR-series/57.GR (Заказ №2410 - СМП) бом/57.GR (Заказ №2410 - СМП) бом/57/00.GR.03.00.00.04 Фланец под звезду.SLDPRT
screens/original-GR-series/57.GR (Заказ №2410 - СМП) бом/57.GR (Заказ №2410 - СМП) бом/57/00.GR.04.01.00.01 Пластина.SLDPRT
screens/original-GR-series/57.GR (Заказ №2410 - СМП) бом/57.GR (Заказ №2410 - СМП) бом/57/00.GR.04.01.00.03 Упор.SLDPRT
screens/original-GR-series/57.GR (Заказ №2410 - СМП) бом/57.GR (Заказ №2410 - СМП) бом/57/00.GR.04.01.00.05 Втулка.SLDPRT
screens/original-GR-series/57.GR (Заказ №2410 - СМП) бом/57.GR (Заказ №2410 - СМП) бом/57/00.GR.04.02.00.01 Фланец.SLDPRT
screens/original-GR-series/57.GR (Заказ №2410 - СМП) бом/57.GR (Заказ №2410 - СМП) бом/57/00.GR.04.02.00.02-130 Косынка.SLDPRT
screens/original-GR-series/57.GR (Заказ №2410 - СМП) бом/57.GR (Заказ №2410 - СМП) бом/57/00.GR.04.02.00.04-130-01 Труба D168,3x3.SLDPRT
screens/original-GR-series/57.GR (Заказ №2410 - СМП) бом/57.GR (Заказ №2410 - СМП) бом/57/00.GR.04.02.00.05-130 Вставка в трубу.SLDPRT
screens/original-GR-series/57.GR (Заказ №2410 - СМП) бом/57.GR (Заказ №2410 - СМП) бом/57/00.GR.05.01.00.01 Пластина.SLDPRT
screens/original-GR-series/57.GR (Заказ №2410 - СМП) бом/57.GR (Заказ №2410 - СМП) бом/57/00.GR.05.01.00.02 Втулка.SLDPRT
screens/original-GR-series/57.GR (Заказ №2410 - СМП) бом/57.GR (Заказ №2410 - СМП) бом/57/00.GR.06.00.00.01 Уголок.SLDPRT
screens/original-GR-series/57.GR (Заказ №2410 - СМП) бом/57.GR (Заказ №2410 - СМП) бом/57/00.GR.06.00.00.02 Ребро.SLDPRT
screens/original-GR-series/57.GR (Заказ №2410 - СМП) бом/57.GR (Заказ №2410 - СМП) бом/57/00.GR.06.00.00.03 Усиление.SLDPRT
screens/original-GR-series/57.GR (Заказ №2410 - СМП) бом/57.GR (Заказ №2410 - СМП) бом/57/00.GR.07.01.00.03 Ребро.SLDPRT
screens/original-GR-series/57.GR (Заказ №2410 - СМП) бом/57.GR (Заказ №2410 - СМП) бом/57/00.GR.07.01.00.05 Подложка 1.SLDPRT
screens/original-GR-series/57.GR (Заказ №2410 - СМП) бом/57.GR (Заказ №2410 - СМП) бом/57/00.GR.07.01.00.08 Подложка гнутая.SLDPRT
screens/original-GR-series/57.GR (Заказ №2410 - СМП) бом/57.GR (Заказ №2410 - СМП) бом/57/00.GR.08.00.00.04 Швеллер 10П.SLDPRT
screens/original-GR-series/57.GR (Заказ №2410 - СМП) бом/57.GR (Заказ №2410 - СМП) бом/57/00.GR.08.01.00.01 Швеллер 12П.SLDPRT
screens/original-GR-series/57.GR (Заказ №2410 - СМП) бом/57.GR (Заказ №2410 - СМП) бом/57/00.GR.08.01.00.02 Пятка.SLDPRT
screens/original-GR-series/57.GR (Заказ №2410 - СМП) бом/57.GR (Заказ №2410 - СМП) бом/57/00.GR.08.01.00.03 Косынка.SLDPRT
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
