hisp2k/parameters/grit-chambers/PT-SHT-10/development/last_rebuild_error.txt

Текучие среды не заданы. Пожалуйста, откройте вкладку 'Текучая среда' в диалоговом окне 'Общие настройки' и выберите текучие среды
