hisp2k/parameters/screens/58-GR/development/step_products_KT.csv

product_id | designation | step_name | is_assembly | direct_occurrences | all_occurrences_from_root | leaf_occurrences
619 | 00.GR.13.00.00.00 | 00.GR.13.00.00.00 СБ Муфта малая | True | 2 | 1 | 0
773 | 58.GR.01.00.00.06 | 58.GR.01.00.00.06 Направляющая | False | 0 | 1 | 1
2395 | 00.GR.04.01.00.01 | 00.GR.04.01.00.01 Пластина | False | 0 | 1 | 1
2490 |  | Ручка скоба с втулками пластиковая | False | 0 | 2 | 2
3330 | 00.GR.12.06.00.00 | 00.GR.12.06.00.00 Шпилька (УПОРНАЯ РЕЗЬБА S34х5) | False | 0 | 2 | 2
4116 |  | SKF_UCP_204_16 | False | 0 | 2 | 2
4350 |  | Винт М8х20 DIN 7984 A4 | False | 0 | 19 | 19
4517 | 58.GR.01.01.00.00 | 58.GR.01.01.00.00 СБ Боковина | True | 16 | 1 | 0
5268 |  | Шайба М8 DIN125 А4 | False | 0 | 14 | 14
6120 |  | Винт М6х20 DIN 7984 А4 | False | 0 | 4 | 4
7072 | 58.GR.01.01.01.02-01 | 58.GR.01.01.01.02-01 Профиль нижний | False | 0 | 1 | 1
7619 |  | Шайба увеличенная М8 D30 A4 | False | 0 | 4 | 4
7775 | 00.GR.07.01.00.06 | 00.GR.07.01.00.06 Подложка 2 | False | 0 | 3 | 3
7872 | 00.GR.10.02.00.00 | 00.GR.10.02.00.00 Торец | False | 0 | 2 | 2
8026 | 58.GR.01.00.00.07 | 58.GR.01.00.00.07 Подложка | False | 0 | 1 | 1
8732 | 00.GR.08.01.00.02 | 00.GR.08.01.00.02 Пятка | False | 0 | 2 | 2
9880 | 00.GR.01.00.00.09 | 00.GR.01.00.00.09 Направляющая нижняя | False | 0 | 1 | 1
10659 | 00.GR.12.02.00.00-130 | 00.GR.12.02.00.00-130 Вал редуктора | False | 0 | 1 | 1
12446 | 00.GR.04.02.00.03 | 00.GR.04.02.00.03 Фланец редуктора pcrv 090-130 | False | 0 | 1 | 1
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
107806 |  | Винт М12х30 DIN 7984 А4 | False | 0 | 12 | 12
108047 | 00.GR.06.00.00.01 | 00.GR.06.00.00.01 Уголок | False | 0 | 2 | 2
108207 | 00.GR.01.02.00.02 | 00.GR.01.02.00.02 Заглушка | False | 0 | 4 | 4
110618 |  | Гайка М10 DIN 934 А4 | False | 0 | 18 | 18
