hisp2k/parameters/screens/58-GR/development/step_products_TT.csv

product_id | designation | step_name | is_assembly | direct_occurrences | all_occurrences_from_root | leaf_occurrences
77 |  | SKF_208_2Z_17 | False | 0 | 13 | 13
3248 |  | Шпилька М8x20 DIN 975 А4 | False | 0 | 8 | 8
4822 |  | Винт М12х20 DIN 7984 А4_DIN 7984 - M12 x 20 --- 14.75C | False | 0 | 4 | 4
5635 | 00.GR.06.00.00.01 | 00.GR.06.00.00.01 Уголок | False | 0 | 2 | 2
8058 | 58.GR.00.00.00.04 | 58.GR.00.00.00.04 ТМКЩ | False | 0 | 2 | 2
12148 | 00.GR.04.02.00.00-130 | 00.GR.04.02.00.00-130 СБ Стакан | True | 12 | 1 | 0
17756 |  | Винт М8х30 DIN 7991 А4_DIN 7991 - M8 x 30 --- 21.8C | False | 0 | 6 | 6
18569 | 00.GR.12.06.00.00 | 00.GR.12.06.00.00 Шпилька (УПОРНАЯ РЕЗЬБА S34х5) | False | 0 | 2 | 2
20145 | 00.GR.15.00.00.01 | 00.GR.15.00.00.01 Основание под Крюк | False | 0 | 3 | 3
20958 | 00.GR.10.04.00.00 | 00.GR.10.04.00.00 Втулка | False | 0 | 4 | 4
27487 | 00.GR.10.02.00.00 | 00.GR.10.02.00.00 Торец | False | 0 | 2 | 2
28284 | 00.GR.04.01.00.04 | 00.GR.04.01.00.04 Ребро | False | 0 | 8 | 8
29899 |  | Гайка М10 DIN 934 А4_М10 | False | 0 | 18 | 18
33956 | 00.GR.06.00.00.00 | 00.GR.06.00.00.00 СБ Натяжитель | True | 6 | 2 | 0
38034 | 58.GR.01.00.00.07 | 58.GR.01.00.00.07 Подложка | False | 0 | 1 | 1
39629 | 00.GR.13.00.00.00 | 00.GR.13.00.00.00 СБ Муфта малая | True | 2 | 1 | 0
41270 | 58-59.GR.01.00.00.03 | 58-59.GR.01.00.00.03 Уголок | False | 0 | 1 | 1
42858 | 00.GR.13.00.00.01 | 00.GR.13.00.00.01 Втулка муфты малая | False | 0 | 1 | 1
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
385930 | 58-59.GR.12.00.00.00 | 58-59.GR.12.00.00.00 СБ Труба натяжная | True | 8 | 1 | 0
386745 | 00.GR.03.00.00.03 | 00.GR.03.00.00.03 Вал | False | 0 | 1 | 1
388390 |  | Шaйба М12 DIN 125 А4_Шайба М12 DIN 125 А2 | False | 0 | 12 | 12
