hisp2k/parameters/engineering/SolidWorksCodex/SCOPED_PARAMETRIC_EXPERIMENT.md

# Параметрический эксперимент на копии узла 09

Дата: 15.09.2026. Ветка: `claude/director-parametric-pilot`.
Это проверка CAD-параметризации, не обучение весов модели и не допуск к производству.

## Разрешение и границы

Пользователь явно разрешил изменения, сохранение, перестроение и закрытие документов
тестового комплекта. Прежнее задание «только исследование» для него отменено.
Первый `sw_document` подтвердил активный корень:
`C:\Users\adm\Desktop\25.SHT.G.00.00.00.00 СБ\25.SHT.G.00.00.00.00 СБ  Транспортер.SLDASM`.
Граница разрешения: `C:\Users\adm\Desktop\25.SHT.G.00.00.00.00 СБ`.

У корня остались внешние ссылки, поэтому он не перестраивался и не сохранялся.
Через штатный Pack and Go создан отдельный вариант нативной подсборки узла 09.
Вариант содержит три уникальных файла; рекурсивные ссылки проверены внутри него.
Исходные файлы не подменялись. Контроль 116 исходных CAD-файлов по SHA-256:
изменений нет. Другие открытые документы защищались проверками пути, наличия,
конфигурации, dirty-флага и хэша. Использовался существующий SOLIDWORKS PID 24564.

## Рабочая связь

Вход эксперимента `plate_thickness_mm=5` -> нативный линейный управляющий размер
`D1@Бобышка-Вытянуть1@EXP_26333854d6ac_25.SHT.G.09.00.00.02  Пластина.Part`
элемента `Extrusion` -> толщина пластины -> геометрия двух экземпляров в подсборке.
Конфигурация: `По умолчанию`. Формула опросного листа пока не предоставлена.

Итоговый каталог:
`C:\Users\adm\Desktop\25.SHT.G.00.00.00.00 СБ\Experiment_26333854d6ac`.

Сборка: `EXP_26333854d6ac_25.SHT.G.09.00.00.00 СБ  Перекладина съемная.SLDASM`.
Деталь: `EXP_26333854d6ac_25.SHT.G.09.00.00.02  Пластина.SLDPRT`.

| Проверка | До | После сохранения и повторной загрузки |
| --- | --- | --- |
| Управляющий размер | 4 мм | 5 мм |
| Твёрдые тела пластины | 1 | 1 |
| Объём пластины | 8.55623013704666e-6 м3 | 1.0695287671308324e-5 м3 |
| Изменение объёма | База | +25%, как ожидается для этой толщины |
| Примерный габарит в осях детали | 4 x 30 x 80 мм | 5 x 30 x 80 мм |
| Экземпляры пластины в подсборке | 2 | 2, оба с новой геометрией |
| Сопряжения | 6 | 6, нулевые коды ошибок/предупреждений |
| Ошибки и предупреждения элементов | 0 / 0 | 0 / 0 |

Пластина действительно выгружалась из памяти: после CloseDoc документ отсутствовал
в GetOpenDocumentByName, затем OpenDoc6 вернул errors=0/warnings=0. Размер 5 мм
прочитан заново. Подсборка сохранена, закрыта и открыта заново; результат повторён.
Проверены коды решателя элементов/сопряжений, но не коллизии, прочность, чертежи,
другие конфигурации и не весь транспортёр. Обозначения заготовки автоматически
не менялись: эксперимент не является подготовкой комплекта к изготовлению.

## Минимальное расширение коннектора

- `sw_test_pack_and_go`: явная активация источника без rebuild, Pack and Go в новый
  каталог, точное сопоставление путей, проверка кодов копирования, ссылок и исходников.
  Несохранённый источник не сохраняется; геометрия копии проверяется после загрузки.
- `sw_test_document`: `open`, `audit`, `rebuild_save`, `close`, `reopen` только внутри
  зарегистрированной папки и её полной допустимой цепочки зависимостей.
  Сохранение требует бэкапов, успешного rebuild и проверенного здоровья компонентов.
  Закрытие грязных или используемых другими документами файлов запрещено.
- Размер изменяет прежний `sw_set_feature_dimensions`, без произвольных COM-команд.
- `AlreadyOpen=128` не обходится разрешением любых предупреждений: уже загруженный
  документ активируется без нового OpenDoc6 и получает отдельный статус.
- `swDocNeedsRebuildWarning=2` при активации возвращается явно; затем требуется
  отдельный rebuild/save. Ошибки активации и настоящие ошибки загрузки блокируются.
- Объём считается существующим `VolumeOf` с `UseSystemUnits=true`, очисткой выбора
  внутри тестовой детали и проверкой конечного положительного значения.

Обычный запрет записи сборок сохраняется. Исключение включается локальным, не
публикуемым `TestScope.local.json` рядом с EXE: поле `test_root` должно точно совпасть
с явно разрешённой пользователем папкой. Сеть, PDM, переходы/junction и внешняя запись
не разрешены. Наличие локального файла настройки само по себе не заменяет разрешение.

## Воспроизведение

Запуск из репозитория с уже загруженным исходным узлом 09:

```powershell
$root='C:\Users\adm\Desktop\25.SHT.G.00.00.00.00 СБ'
.\RUN_SCOPED_PARAMETRIC_EXPERIMENT.ps1 -TestRoot $root `
 -SourceAssembly "$root\25.SHT.G.09.00.00.00 СБ  Перекладина съемная.SLDASM" `
 -SourcePart "$root\25.SHT.G.09.00.00.02  Пластина.SLDPRT" `
 -FeatureName 'Бобышка-Вытянуть1'
```

Сценарий каждый раз создаёт новый уникальный вариант, ожидает исходные 4 мм,
последовательно выполняет проверки и записывает полный отчёт в `Reports`.
Таймаут не вызывает автоматического повтора записи. Для явно проверенного продолжения
после уже успешного изменения есть `-ResumeAfterChangeReport`; повторной записи размера
нет, текущие 5 мм подтверждаются заново. Формула объёма в сценарии относится только
к выбранной пластине постоянной толщины, а не к произвольному размеру.

## Доказательства и передача

`SCOPED_EXPERIMENT_FULL_RUN.json`: непрерывный LIVE_PASS всего цикла 4 -> 5 мм.
`SCOPED_EXPERIMENT_FINAL.json`: повторная проверка того же варианта финальным EXE
после переиспользования расчёта объёма в СИ, с сохранением/выгрузкой/загрузкой.
`SCOPED_ORIGINAL_FILES_VERIFIED.json`: исходные файлы и их контрольные суммы.

OFFLINE_PASS: 276 core + 81 assembly/STDIO (88 с установленным Interop) +
74 write-safety + 26 scoped experiment. BUILD.cmd запускает все группы.

Финальный репозиторный EXE:
`A7BAA31F0CC3897D993E65D215B441F83A04CBF60C6F7ACE396CA6D08AD1EA6F`.
Установленный MCP EXE остаётся `B9570CC9...`; автоматически не переустанавливался.
Живые операции выполнены через проверяемые `--worker` команды EXE репозитория
с тем же валидатором и общим COM mutex. Для Claude запускать сценарий из репозитория.
Для появления новых имён в MCP нужны отдельное обновление установки и переподключение.

Первичный полный проверенный бэкап репозитория, истории Git и CAD:
`..\_backups\SolidWorksCodex\before-scoped-experiment-20260915-071249`.
Промежуточные варианты, отчёты остановок и все бэкапы сохранены, не удалены.
Перед commit/push создаётся отдельный полный проверенный бэкап.

API: [GetErrorCode2](https://help.solidworks.com/2021/English/api/sldworksapi/SolidWorks.Interop.sldworks~SolidWorks.Interop.sldworks.IFeature~GetErrorCode2.html),
[CloseDoc](https://help.solidworks.com/2024/English/api/sldworksapi/SOLIDWORKS.Interop.sldworks~SOLIDWORKS.Interop.sldworks.ISldWorks~CloseDoc.html),
[GetPackAndGo](https://help.solidworks.com/2024/English/api/sldworksapi/SOLIDWORKS.Interop.sldworks~SOLIDWORKS.Interop.sldworks.IModelDocExtension~GetPackAndGo.html).
