hisp2k/parameters/engineering/SolidWorksCodex/STAGE13_CROSSBAR_LENGTH_EXPERIMENT_RU.md

# Эксперимент: длина перекладины узла 09 и связанный чертёж

Дата: 16.09.2026. Ветка: `claude/director-parametric-pilot`.
Это проверка CAD-параметризации на копии, не обучение весов модели и не допуск к производству.

## Разрешение и границы

Пользователь ранее явно разрешил изменения, сохранение, перестроение, закрытие и
повторное открытие документов тестового комплекта. В этой сессии обнаружено и
исправлено расхождение: комплект на данной машине фактически лежит не по старому
пути `C:\Users\adm\Desktop\...`, а по адресу
`G:\Mine\Desktop\SolidWorksCodex-Git\25.SHT.G.00.00.00.00 СБ`.
`C:\Users\adm` на этой машине вообще не существует. Файл `TestScope.local.json`
(отсутствовал) пересоздан рядом с EXE с полем `test_root`, указывающим на верный путь.
Внешние файлы (за пределами теста комплекта) не изменялись.

Входной параметр эксперимента назван явно `crossbar_length_mm`, чтобы не путать его
с длиной опросного листа (поле D25) — это разные величины, и их равенство не
предполагается автоматически.

## Рабочая связь

Найден управляющий линейный размер:
`D1@Бобышка-Вытянуть1@25.SHT.G.09.00.00.01  Перекладина.Part` = 208 мм (оригинал,
элемент `Бобышка-Вытянуть1`, тип `Extrusion`). Обе пластины (`...02  Пластина`,
2 экземпляра через `ЗеркальныйКомпонент1`) закреплены сопряжениями относительно
торцов перекладины; отдельного размерного сопряжения "расстояние" в узле нет —
позиционирование идёт через геометрию/сопряжения, что подтверждено сборкой:
6 сопряжений (`MateCoincident` x6), 0 `Distance`/`Angle`.

Скопированный узел (Pack and Go): каталог
`G:\Mine\Desktop\SolidWorksCodex-Git\25.SHT.G.00.00.00.00 СБ\Experiment_ebc977a34242`.
Сборка: `EXP_ebc977a34242_25.SHT.G.09.00.00.00 СБ  Перекладина съемная.SLDASM`.
Деталь перекладины: `EXP_ebc977a34242_25.SHT.G.09.00.00.01  Перекладина.SLDPRT`.
Деталь пластины: `EXP_ebc977a34242_25.SHT.G.09.00.00.02  Пластина.SLDPRT`.
Pack and Go скопировал 3 файла (сборка + 2 детали); чертёж оригинала автоматически
скопирован не был (см. «Известное ограничение» ниже).

Изменение выполнено штатным `sw_set_feature_dimensions` на активной копии детали:
`D1@Бобышка-Вытянуть1@EXP_ebc977a34242_25.SHT.G.09.00.00.01  Перекладина.Part`
208 мм -> 228.8 мм (+10%, тестовое значение). SHA-256 детали до/после:
`06dd2d2576879484b9d8d1ee2971b45705f5af85239d0ffbd6c3f91a5b82c8f7` ->
`5b0a2d664f973bef9e27195d2e02e90d16372ccbf8ccd7b21493f74204bf28aa`.
Автоматический бэкап детали до изменения создан коннектором
(`..._BEFORE_FEATURE_CHANGE_20260916_041321_b64eeb62.SLDPRT`).

## До / После

| Проверка | До (208 мм) | После (228.8 мм, +10%) |
| --- | --- | --- |
| Управляющий размер перекладины | 208 мм | 228.8 мм |
| Габарит перекладины по оси (bounding box) | -104.0 .. +104.0 мм (208 мм) | -114.4 .. +114.4 мм (228.8 мм) |
| Объём перекладины | 6.25711843425603e-5 м3 | 6.882830277681634e-5 м3 (+10.0%, ожидаемо) |
| Позиция Пластина-1 (assembly XYZ, ось Z) | +0.1080 м | +0.1184 м |
| Позиция Пластина-2 (assembly XYZ, ось Z) | -0.1080 м | -0.1184 м |
| Смещение каждой пластины | база | +10.4 мм = ровно половина прироста длины (20.8 мм / 2) |
| Сопряжения | 6, 0 ошибок/предупреждений | 6, 0 ошибок/предупреждений |
| Здоровье сборки (feature/mate solver) | PASS, 0/0 | PASS, 0/0 |
| Экземпляры пластины с корректной геометрией | 2 | 2 |

Позиции получены через `IComponent2.Transform2.ArrayData[9..11]` (перевод компонента
в системе сборки, метры) — это исправленный в этой сессии канал данных (см. ниже).
Смещение пластин ровно на половину прироста длины подтверждает, что существующая
геометрическая зависимость «пластина закреплена у торца перекладины» была изначально
корректна: отдельно добавлять/чинить зависимость не потребовалось.

После `rebuild_save` сборка сохранена (`errors=0, warnings=0`), затем закрыта
(`CloseDoc`, подтверждена выгрузка из памяти через `GetOpenDocumentByName == null`)
и заново открыта с диска (`fresh_open: OPENED_CLEAN`, не переиспользование из памяти).
Повторный `audit` после чистой перезагрузки вернул те же значения длины и позиций,
что подтверждает: изменение реально сохранено на диск, а не удержано только в памяти
SOLIDWORKS.

## Чертёж

Оригинальный чертёж `Чертежи\Детали\25.SHT.G.09.00.00.01  Перекладина.SLDDRW`
существует (базовая проверка ранее: 1 лист, 2 вида, 4 отображаемых размера), но
Pack and Go с `IncludeDrawings=true` не скопировал его вместе со сборкой — по всем
признакам `IncludeDrawings` в SOLIDWORKS относится только к чертежу самого
пакуемого верхнеуровневого документа, а не к чертежам дочерних компонентов, даже
предварительно открытым. Ручная перелинковка ссылок оригинального чертежа на
копию признана избыточным риском для эксперимента такого масштаба.

Применён предусмотренный самим заданием запасной путь (п.6): на изменённой копии
детали перекладины штатным `sw_create_drawing` создан новый проверочный чертёж:
`EXP_ebc977a34242_25.SHT.G.09.00.00.01  Перекладина_DRAWING_20260916_041728_e5a2694c.SLDDRW`.
Это явно НЕ оригинальный производственный чертёж, а новый проверочный документ:
3 вида (`Create1stAngleViews2`), 5 отображаемых размеров, импортированных из модели
(`InsertModelAnnotations3`, только размеры, отмеченные «для чертежа»), верификация
`PASS`, исходная деталь не изменилась (SHA-256 до/после совпадают).

Экспорт в PDF (`sw_export_workspace_pdf`) выполнен и визуально проверен:
- новый габаритный размер 228.80 мм чётко виден на боковом виде;
- сечение (30x30, R6) и вид сверху отображены без наложений и обрывов выносных линий;
- посторонних артефактов нет.

Файл: `EXP_ebc977a34242_25.SHT.G.09.00.00.01  Перекладина_DRAWING_20260916_041728_e5a2694c_PDF_20260916_041845_1474627e.PDF`
(27 850 байт, валидный `%PDF-` заголовок).

## Исправление коннектора в этой сессии (критично для самой проверки)

При старте сессии `assembly_position_xyz_m` в `TestAudit` всегда возвращал `null` —
то есть до этой правки было ФИЗИЧЕСКИ НЕВОЗМОЖНО проверить требуемое условие задания
«проверить позицию ОБЕИХ пластин». Причина: `Transform2` — это COM-свойство
(property), а код вызывал его через `Call()` (метод `GetMethod`, для методов), что
всегда падало с `API_METHOD_MISSING`, молча проглатываемым обёрткой `Try()`.

- `src/TestExperiment.cs`, `TestAudit`: `Call(component, "IComponent2", "Transform2")`
  заменено на `Get(component, "IComponent2", "Transform2")` (свойство читается через
  `Get`, не через `Call`).
- Туда же добавлено поле `"issues"` в возвращаемый объект `TestAudit` — раньше список
  ошибок, накопленных `Try()`, вообще не попадал в ответ, и такие сбои были не видны
  снаружи. Теперь `issues: []` явно подтверждает отсутствие скрытых сбоев чтения.

Без этого исправления результаты позиций пластин в таблице выше не могли быть
получены никаким способом через существующий коннектор — это не эстетическая
правка, а необходимое условие выполнения задания.

Также в рамках этой же сессионной цепочки работ (до текущего перекомпилированного
шага) в коннектор уже были добавлены: необязательный `include_drawings` для
`sw_test_pack_and_go` (опробован в этом эксперименте — не решил проблему чертежа
дочернего компонента, см. выше, но работает по документированному назначению) и
обязательный `EditRebuild3` перед сохранением DRW в `sw_save_workspace_document`
(защита от сохранения чертежа с неактуальными видами/размерами).

Пересборка выполнена, офлайн-тесты пройдены: `276 + 81 + 74 + 26 = 457` проверок,
exit code 0 (`_claude_build_v4_report.txt`, `_claude_build_v4_exitcode.txt`).

## Что не проверялось

Коллизии тел, прочность, соответствие опросному листу (поле D25 — длина
транспортёра — сознательно не отождествлялась с длиной перекладины), другие
конфигурации, весь транспортёр целиком, простановка допусков/шероховатости/сварных
швов на новом чертеже, регенерация штампа/обозначения. Модель и чертёж не считаются
допущенными к производству.

## Изменённые файлы (репозиторий)

- `src/TestExperiment.cs` — исправление `Transform2` (Get вместо Call) + поле `issues`
  в `TestAudit`; ранее в этой сессионной цепочке — `include_drawings` для Pack and Go.
- `src/Protocol.cs`, `src/SolidWorksReader.cs` — обвязка `include_drawings` и
  обязательный rebuild чертежа перед сохранением (см. выше).
- `.gitignore` — исключены `25.SHT.G.00.00.00.00 СБ/` (перенесённый тестовый комплект)
  и `*.zip` (сторонний архив подготовки производства), случайно оказавшиеся в рабочей
  папке репозитория на устройстве.
- `STAGE13_CROSSBAR_LENGTH_EXPERIMENT_RU.md` — этот отчёт.

Файлы теста (SLDASM/SLDPRT/SLDDRW/PDF копии в `Experiment_ebc977a34242`) находятся вне
репозитория — в самом тестовом комплекте на устройстве, как и предыдущий эксперимент.

## Воспроизведение (последовательность вызовов коннектора)

```json
{"tool":"sw_test_document","arguments":{"test_root":"<root>","file_path":"<Experiment>\\...SLDASM","operation":"open"}}
{"tool":"sw_test_document","arguments":{"test_root":"<root>","file_path":"<Experiment>\\...SLDASM","operation":"audit"}}
{"tool":"sw_test_document","arguments":{"test_root":"<root>","file_path":"<Experiment>\\...01  Перекладина.SLDPRT","operation":"open"}}
{"tool":"sw_features","arguments":{"offset":0,"limit":25}}
{"tool":"sw_set_feature_dimensions","arguments":{"feature_name":"Бобышка-Вытянуть1","expected_feature_type":"Extrusion",
  "changes":[{"full_name":"D1@Бобышка-Вытянуть1@EXP_..._25.SHT.G.09.00.00.01  Перекладина.Part","expected_current_mm":208,"new_value_mm":228.8}]}}
{"tool":"sw_test_document","arguments":{"test_root":"<root>","file_path":"<Experiment>\\...SLDASM","operation":"rebuild_save"}}
{"tool":"sw_test_document","arguments":{"test_root":"<root>","file_path":"<Experiment>\\...01  Перекладина.SLDPRT","operation":"open"}}
{"tool":"sw_create_drawing","arguments":{"projection":"first_angle","dimensions":"model"}}
{"tool":"sw_export_workspace_pdf","arguments":{}}
{"tool":"sw_test_document","arguments":{"test_root":"<root>","file_path":"<Experiment>\\...SLDASM","operation":"close"}}
{"tool":"sw_test_document","arguments":{"test_root":"<root>","file_path":"<Experiment>\\...SLDASM","operation":"open"}}
```

Каждый шаг подан через файловый ClaudeBridge (`ClaudeBridge\request.json` ->
`CLAUDE_CALL.cmd` -> `ClaudeBridge\response.json`), `test_root` должен точно совпасть
со значением в `TestScope.local.json`.

API: [Transform2](https://help.solidworks.com/2024/English/api/sldworksapi/SOLIDWORKS.Interop.sldworks~SOLIDWORKS.Interop.sldworks.IComponent2~Transform2.html),
[IMathTransform::ArrayData](https://help.solidworks.com/2024/English/api/sldworksapi/SOLIDWORKS.Interop.sldworks~SOLIDWORKS.Interop.sldworks.IMathTransform~ArrayData.html),
[Create1stAngleViews2](https://help.solidworks.com/2024/English/api/sldworksapi/SOLIDWORKS.Interop.sldworks~SOLIDWORKS.Interop.sldworks.IDrawingDoc~Create1stAngleViews2.html).
