hisp2k/parameters/engineering/SolidWorksCodex/VALIDATION.md

# Валидация SolidWorksCodex 2.2.2

Дата сборки: 12 сентября 2026. Поставка предназначена для локального пилота на
Windows x64 и SOLIDWORKS 2026 SP03.2.

## Проверка Полученных Обновлений Claude, 16.09.2026

Проверен репозиторный EXE из коммита `503808f`, SHA-256
`4470C9A0E1A63623C50D8FB212853155CE6FEE1D6877F1DBA6297B997E295F20`.
Без пересборки и без CAD: `--self-test` 282 PASS;
TEST_ASSEMBLY_READ_REGRESSIONS.ps1 с официальным Interop 88 PASS;
TEST_WRITE_SAFETY_REGRESSIONS.ps1 78 PASS; TEST_SCOPED_EXPERIMENT.ps1 26 PASS.
Всего 474 автономные проверки. Это не полноценный аудит новой реализации.
Новые живые эксперименты этой сессией NOT_RUN. Результаты Claude по длине перекладины,
позициям пластин и чертежу: STAGE13_CROSSBAR_LENGTH_EXPERIMENT_RU.md; по переменной
crossbar_length_mm: TASK.md. Не смешивать его тестовый путь G:\Mine с локальным C:\Users\adm.
Предыдущие самостоятельные живые проверки Codex приведены ниже как история.

## Полный Эксперимент На Тестовом Узле, 15.09.2026

Актуально: SCOPED_PARAMETRIC_EXPERIMENT.md, SCOPED_EXPERIMENT_FULL_RUN.json,
SCOPED_EXPERIMENT_FINAL.json, SCOPED_ORIGINAL_FILES_VERIFIED.json.
OFFLINE_PASS: 276 core + 81/88 assembly/STDIO/Interop + 74 write-safety + 26 scoped.
LIVE_PASS: Pack and Go узла 09, деталь 4 -> 5 мм, один solid, +25% объёма,
rebuild/save, настоящая выгрузка/загрузка, размер сохранён, две пластины обновлены,
6 сопряжений без ошибок/предупреждений. Исходные 116 CAD-файлов неизменны.
NOT_RUN: коллизии/прочность, другие конфигурации, чертежи, rebuild корневого транспортёра.
Источник dirty не сохраняется при копировании. AlreadyOpen не выдаётся за свежую загрузку;
предупреждение активации NeedsRebuild возвращается явно и требует rebuild/save.
Финальный EXE использует VolumeOf с принудительными единицами СИ.

## Проверка Нативной Детали, 15.09.2026

Свежие результаты: NATIVE_PART_PILOT.md, NATIVE_PART_LIVE_RESULT.json,
NATIVE_PART_LIVE_RETURN.json. OFFLINE_PASS: 263 + 81/88 + 74.
LIVE_PASS: разрешённая рабочая копия Пластины узла 09, 4 → 5 → 4 мм;
1 тело, ожидаемый объём, два успешных rebuild/save, SHA-256 бэкапов совпадают.
Итог 4 мм. Повторное открытие файла, остальные конфигурации, изменение сборки,
производственные чертежи и связь с расчётной формулой этой проверкой не покрыты.
Исторические сценарии ниже не являются результатами текущей итерации.

## Офлайн-проверки

Живой диагностический отчёт SOLIDWORKS 2026 SP03.2 подтвердил: обычная
«Бобышка-Вытянуть» возвращается API как `feature_type=Extrusion`, а созданные
управляющие размеры могут возвращать `dimension_type_code=0` при корректных
`system_value_si`, `driving=true` и `read_only=false`. Версия 2.2.2 учитывает оба
факта только для известной схемы созданных коннектором линейных `AI_*`.

Прямой компилятор Roslyn собрал `SolidWorksLocal.exe` под .NET Framework 4.8,
x64, с синтаксисом C# 5. Portable-сборка того же исходного кода прошла:

```text
PASS: 210 offline protocol assertions. Live SOLIDWORKS COM is NOT tested by this command.
PASS: actual STDIO process, twenty-five tool schemas including prismatic-v6 corners and strict sheet contours, guarded feature inventory/edit schemas, fixed-local-disk/parameter-variant/grouped-parameter/drawing/PDF schemas,
network-path rejection, contour/turned/splined dispatch, child-worker error,
malformed request recovery, no extra stdout/BOM.
```

Проверено:

- initialize, уведомления, ping и `tools/list`;
- двадцать пять фиксированных имени инструментов и строгие схемы;
- схема чтения дерева элементов и защищённого изменения непосредственно
  принадлежащих выбранному элементу линейных управляющих размеров;
- двойной путь инвентаризации размеров: отображаемые размеры элемента и прямой
  `IFeature.Parameter` для созданных коннектором `AI_*`, скрытых SOLIDWORKS после
  сохранения/повторного открытия;
- разрешение переименованного `AI_Thickness` через сохранённый внутренний ключ Boss
  `D1`–`D16` с последующей обязательной сверкой фактического полного имени;
- чтение размеров SLDPRT и запрет изменения всех размеров, кроме созданных
  коннектором управляющих параметров `AI_*` на локальном фиксированном диске;
- обязательные точные `full_name` и `expected_current_mm`, одна автоматическая
  резервная копия и одна проверка для группы из 1–16 изменений;
- живой сценарий одной группы из 15 параметров: 140 × 90 × 8 мм, четыре отверстия
  Ø12, отступы X=18 и Y=16 мм, последующие проверка объёма, SLDDRW и PDF;
- отдельный параметрический вариант по имени исходного SLDPRT: проверка исходных
  значений, повторное нахождение `AI_*` в копии и совпадение SHA-256 исходной
  детали до и после операции;
- локальная Workspace, распознавание `DriveType.Fixed`, запрет UNC,
  сетевых/съёмных дисков и проверка переходов перед записью;
- безопасное открытие локальной SLDPRT/SLDDRW по точному пути;
- резервные копии рядом с существующим локальным файлом перед записью;
- схема создания SLDDRW с первой или третьей проекцией;
- отдельный аудит листов, связанных видов и отображаемых размеров SLDDRW;
- безопасная схема экспорта PDF без принимаемого от вызывающей стороны пути;
- проверка заголовка `%PDF-` и очистка незавершённого нового PDF при ошибке;
- запрет неизвестных методов, путей, лишних полей и произвольных COM-команд;
- обратная совместимость призматических Plan v1/v2/v3/v4;
- Plan v4: прямоугольные и круглые одноуровневые выступы;
- Plan v5: прямоугольные выступы с четырьмя одинаковыми фасками или
  аналитическими дугами скругления;
- Plan v6: выборочные фаски и скругления выпуклых вершин многоугольного
  наружного профиля, включая проверку отверстий по обработанной границе;
- Contour Plan v1: упорядоченные замкнутые наружные/внутренние контуры из
  истинных линий и дуг, отдельные отверстия и линейные массивы;
- точные площади профилей с фасками и скруглениями и их объёмы;
- аналитический объём основы, каждого выступа, каждого выреза и итогового тела;
- размещение элементов внутри основы и запрет их пересечений;
- расчёт габарита по Z с учётом максимального выступа;
- безопасные обозначение и наименование, ограничение материала `AISI 304`;
- токарные Plan v2/v3 и шлицевая контрольная геометрия;
- сравнение полного набора радиусов аналитических цилиндров с учётом круглых
  выступов, скруглённых углов, карманов и торцов пазов;
- Unicode и восстановление STDIO после плохого JSON.

Офлайн-проверки не запускают SOLIDWORKS и не подтверждают живое чтение и
изменение размеров через COM, изменение обычного элемента через COM, составные фасонные выступы Plan v5, фактическое
распознавание типа диска Windows, создание резервных копий, SLDDRW и PDF. Эти
пути обязаны подтвердить `CREATE_TEST_WORKSPACE_DRAWING.cmd`,
`CREATE_TEST_LOCAL_DISK_EDIT.cmd`, `CREATE_TEST_FEATURE_EDIT.cmd`,
`CREATE_TEST_SHEET_CONTOUR.cmd` и `CREATE_TEST_POLYGON_CORNERS.cmd` на целевом компьютере.

Первый живой запуск 0.9.0 был остановлен с `BOSS_FAILED`: SOLIDWORKS не принял
единый фасонный эскиз выступа. Начиная с 1.0.0 этот путь удалён. Фасонный выступ
собирается из простых прямоугольных, треугольных и круглых областей, каждая из
которых отдельно сливается с базовым телом; итоговая площадь и объём остаются
аналитически теми же и проверяются до сохранения.

## Уже подтверждённая совместимость

На SOLIDWORKS 2026 SP03.2 пользователем подтверждены подключение MCP, чтение
моделей и свойств, поиск `gost-part.prtdot`, сохранение новых деталей,
назначение `AISI 304`, свойства, отверстия, глухие карманы и сквозной прямой паз.
Plan v4 с прямоугольным и круглым выступами также подтверждён пользователем.
Также подтверждены изменение точной глубины элемента `Extrusion` с 6 до 9 мм и
единая операция изменения 15 параметров с резервной копией, перестроением,
проверкой объёма, созданием SLDDRW и экспортом PDF.
Эти пути сохранены в 2.2.2.

## Живая проверка 2.2.2

Исправление 2.2.2: `sw_features` группирует общий проверенный список размеров
из того же источника, что и `sw_parameters`. Контрольный тест повторно открывает
точный `file_path`, возвращённый созданием пластины.

Исправление 2.2.2: тестовая проверка SHA-256 открытого SLDPRT использует
`FileShare.ReadWrite | FileShare.Delete` и не конфликтует с блокировкой файла
процессом SOLIDWORKS.

Исправление 2.2.2: наличие установленного PDM-клиента само по себе больше не
блокирует обычную локальную папку. Путь блокируется как PDM только тогда, когда
PDM API действительно вернул имя хранилища.

Версия сохраняет безопасный режим Workspace и добавляет запись в существующие
SLDPRT/SLDDRW на проверенном локальном фиксированном диске. Сеть, съёмные диски
и пути через точки повторной обработки должны быть отклонены.

1. Распаковать архив и запустить `INSTALL.cmd`.
2. Запустить один SOLIDWORKS 2026 от того же пользователя.
3. Выполнить установленный `CHECK.cmd`.
4. Выполнить `CREATE_TEST_SHEET_CONTOUR.cmd` и `CREATE_TEST_POLYGON_CORNERS.cmd`.
5. При необходимости выполнить `CREATE_TEST_WORKSPACE_DRAWING.cmd`.
6. Первый успешный результат должен содержать:
   - `connector_version = 2.2.2`;
   - деталь `PLATE_120x80x6_4xD10_*.SLDPRT` находится в локальной Workspace;
   - проверка объёма детали имеет статус `PASS`;
   - тест явно открывает только что созданную SLDPRT из Workspace;
   - `sw_parameters` находит `AI_Length`, `AI_Width` и `AI_Thickness`;
   - `sw_create_parameter_variant` оставляет исходную деталь 120×80×6 мм
     неизменной, создаёт вариант 140×90×8 мм и возвращает
     `verification.status = PASS`;
   - повторное чтение подтверждает все три значения и габарит ≈ 140×90×8 мм;
   - чертёж `*_DRAWING_*.SLDDRW` находится в той же Workspace;
   - `projection = first_angle`;
   - `verification.status = PASS` и `referenced_model_view_count >= 1`;
   - в детали пятнадцать настоящих размеров помечены для чертежа;
   - `display_dimension_count >= 15` после переноса размеров в SLDDRW;
   - отдельный `sw_drawing` возвращает `verification.status = PASS`;
   - новый PDF находится в Workspace, имеет сигнатуру `%PDF-`, а исходный
     SLDDRW остаётся неизменным.

Контрольная геометрия сначала создаётся как пластина 120×80×6 мм с четырьмя
сквозными отверстиями Ø10 и отступами центров 15×15 мм. Затем создаётся отдельный
вариант 140×90×8 мм; положение отверстий остаётся заданным отступами. Чертёж содержит стандартные виды, длину,
ширину, толщину, четыре диаметра и восемь размеров положения отверстий.

6. Выполнить `CREATE_TEST_LOCAL_DISK_EDIT.cmd`.
7. Второй успешный результат должен содержать:
   - открытие тестовой SLDPRT вне Workspace через `sw_open_local_file`;
   - `storage_scope = LOCAL_FIXED_DISK` и `connector_write_allowed = true`;
   - изменение локальной копии с 120×80×6 до 135×85×7 мм;
   - отдельную резервную SLDPRT с SHA-256 исходного файла до изменения;
   - проверенное назначение свойств и `AISI 304` с ещё одной резервной копией;
   - новый SLDDRW и PDF рядом с локальной деталью, но вне Workspace;
   - неизменность SHA-256 детали при создании чертежа и чертежа при экспорте PDF;
   - итоговую строку `PASS: local fixed-disk open, backup, edit, properties, drawing and PDF passed; network paths remain blocked.`

8. Выполнить `CREATE_TEST_FEATURE_EDIT.cmd`.
9. Третий успешный результат должен подтвердить:
   - чтение дерева через `sw_features`;
   - точные `feature_name` и `feature_type = Extrusion`;
   - линейный управляющий размер `AI_Thickness`, непосредственно принадлежащий
     выбранному элементу;
   - резервную копию перед изменением;
   - изменение толщины с 6 до 9 мм;
   - успешное перестроение, неизменное число твёрдых тел, положительный объём,
     проверенное значение размера и сохранение;
   - итоговую строку `PASS: exact Extrusion feature identity, owned linear dimension, backup, rebuild, geometry and save passed.`

## Критерии сбоя

Сбой — ошибка коннектора, отсутствие файла, любой статус проверки кроме `PASS`,
не одно твёрдое тело, неверный набор цилиндров, неподтверждённый материал или
свойства. Ошибочный новый документ закрывается и удаляется. Перед разрешённым
изменением существующего локального файла создаётся проверенная резервная копия;
при ошибке изменения параметров коннектор пытается вернуть исходные значения в
памяти. При сбое нужен полный текст окна одного запуска.

В 2.2.2 `sw_set_parameter`, `sw_set_parameters` и `sw_create_parameter_variant`
по-прежнему работают только с `AI_*`. Отдельная команда
`sw_set_feature_dimensions` может менять обычные линейные управляющие размеры,
но только если они непосредственно принадлежат одному точно выбранному элементу
типа `Extrusion`, `Boss`, `Cut`, `HoleWzd`, `Chamfer` или `Fillet`. Она не параметризует STEP,
не меняет размеры эскизов и не создаёт новые элементы. Plan v5 обрабатывает только четыре
вертикальных угла прямоугольного выступа. Фаски верхних/нижних кромок,
произвольный выбор рёбер, вложенные и многоуровневые выступы, резьбы,
пересекающиеся операции и произвольные материалы пока не поддерживаются.
Производственное одобрение не выдаётся.
