hisp2k/parameters/engineering/screw-preflight/outputs/05_MINIMUM_MEASUREMENTS_FOR_SLUDGE_SAND.md

# Минимальные данные для расчёта шнека с осадком и песком

**Текущее состояние:** осадок с добавкой песка; для песка сообщена влажность 60 %, но способ расчёта процента неизвестен. Доля песка в смеси отсутствует. Эти значения остаются `UNKNOWN` для расчётной модели. Программа может принимать ТЗ, проверять единицы и полноту данных; подбор геометрии, привода и выпуск конструкции пока не разрешены.

## 1. Что получить первым

| Приоритет | Данные | Практический способ получения | Зачем нужны |
|---|---|---|---|
| 1 | Требуемая подача смеси, минимум/номинал/максимум, в кг/ч или м³/ч | ТЗ, расходомер, учёт массы за известное время | Задаёт размерность задачи |
| 1 | Влажная плотность **готовой смеси** и её диапазон | Взвесить пробу известного объёма; взять несколько проб при разных режимах | Перевод массовой подачи в объёмную; плотность одного осадка для смеси недостаточна |
| 1 | Доля песка в готовой смеси и база доли | По дозировке песка и осадка за одинаковый интервал; если учёта нет — согласовать лабораторный метод разделения пробы | Определяет состав и диапазон возможного износа; не заменяется влажностью песка |
| 1 | Влажность песка с указанием базы процента | Записать массу влажной пробы и массу после высушивания; указать метод и условия | Позволяет однозначно трактовать сообщённые 60 % |
| 1 | Длина и перепад высот между загрузкой и выгрузкой | Обмер площадки и схема расположения оборудования | Определяет требуемое исполнение и расчётные нагрузки |
| 1 | Режим подачи и остановки | Схема оборудования до шнека; ответ, возможен ли заполненный вход и пуск с материалом внутри | Разделяет транспортёр и питатель, задаёт пусковой случай |
| 2 | Крупность песка и иных твёрдых включений | Отбор представительных проб; ситовый анализ по принятой лабораторной методике | Проверка зазоров, забивания и износа |
| 2 | Содержание сухого вещества в готовой смеси и диапазон температуры | Лабораторный анализ проб | Проверка изменения состояния смеси и применимости модели |
| 2 | Налипание, осаждение песка, наличие свободной воды | Наблюдение за пробой и пробный прогон в характерных режимах | Выбор корпуса, винта, дренажа и очистки |

Для каждого результата сохранить дату, точку отбора, режим работы, единицы, метод, количество проб и ответственного. Одно измерение без диапазона не описывает изменение смеси в эксплуатации.

## 2. Определение влажности песка

При лабораторном определении массовой влажности грунта по [ASTM D2216-19](https://store.astm.org/d2216-19.html) используют отношение массы воды к сухой массе твёрдых частиц:

`w_dry = (m_wet − m_dry) / m_dry`.

Если поставщик имел в виду долю воды во влажной массе, расчёт другой:

`x_wet = (m_wet − m_dry) / m_wet`.

Для сообщённых 60 % эти определения дают разные соотношения. Пока не известны метод и база, программа показывает исходное сообщение «60 %» в отчёте, но не использует число как расчётное свойство. Метод сушки нужно выбирать с учётом состава пробы; для смеси осадка и песка лаборатория должна отдельно подтвердить применимость выбранного метода.

## 3. Работа без этих данных

Можно завершать структуру входов, контроль единиц, профили среды, трассировку, генератор проверок и тесты обработки `UNKNOWN`. Можно подготовить CAD-модель как независимый шаблон. Численные коэффициенты для осадка с песком, допустимые геометрии, мощность и привод остаются в статусе проекта до измерений, FBD, независимого референсного расчёта и инженерной валидации.

**Текущий программный результат:** `UNKNOWN` с перечнем недостающих данных. Это ожидаемое поведение, а не ошибка программы.
