hisp2k/parameters/screw-conveyors/25-SHT-G/development/selected_spec_test.csv

Позиция | Раздел | Обозначение | Количество | Примечание | Источник
1 | Крепёж и стандартные изделия | Стопорное кольцо D65 ГОСТ 13942-86 | 2 |  | 25.SHT.G.00.00.00.00 СБ, исходная спецификация
2 | Крепёж и стандартные изделия | Стопорное кольцо D100 ГОСТ 13943-86 | 2 |  | 25.SHT.G.00.00.00.00 СБ, исходная спецификация
3 | Крепёж и стандартные изделия | Стопорное кольцо D120 ГОСТ 13943-86 | 2 |  | 25.SHT.G.00.00.00.00 СБ, исходная спецификация
4 | Привод | Мотор-редуктор UD-FA87-88.01 (PAM60) М1 3Кв | 1 |  | 25.SHT.G.00.00.00.00 СБ, исходная спецификация
5 | Уплотнения | Манжета 2 -75х100-5 ГОСТ 8752-79 | 2 |  | 25.SHT.G.00.00.00.00 СБ, исходная спецификация
6 | Крепёж и стандартные изделия | Шпонка 18х11х110 ГОСТ 23360-78 | 1 |  | 25.SHT.G.00.00.00.00 СБ, исходная спецификация
7 | Крепёж и стандартные изделия | Шпонка 16х10х40 ГОСТ 23360-78 | 1 |  | 25.SHT.G.00.00.00.00 СБ, исходная спецификация
8 | Крепёж и стандартные изделия | Шпонка 14х9х40 ГОСТ 23360-78 | 1 |  | 25.SHT.G.00.00.00.00 СБ, исходная спецификация
9 | Крепёж и стандартные изделия | Шайба М16 DIN 125 ОЦ | 33 |  | 25.SHT.G.00.00.00.00 СБ, исходная спецификация
10 | Крепёж и стандартные изделия | M16x50 | 20 |  | 25.SHT.G.00.00.00.00 СБ, исходная спецификация
11 | Крепёж и стандартные изделия | Шайба М16 DIN 127 А2 | 34 |  | 25.SHT.G.00.00.00.00 СБ, исходная спецификация
12 | Крепёж и стандартные изделия | M16x45 | 7 |  | 25.SHT.G.00.00.00.00 СБ, исходная спецификация
13 | Крепёж и стандартные изделия | DIN 7984 - M16 x 40 --- 34C | 6 |  | 25.SHT.G.00.00.00.00 СБ, исходная спецификация
14 | Крепёж и стандартные изделия | Болт М8 DIN 931 A2 | 16 |  | 25.SHT.G.00.00.00.00 СБ, исходная спецификация
15 | Крепёж и стандартные изделия | Шайба М8 DIN125 А2 | 32 |  | 25.SHT.G.00.00.00.00 СБ, исходная спецификация
16 | Крепёж и стандартные изделия | DIN 7991 - M6 x 20 --- 13.7C | 36 |  | 25.SHT.G.00.00.00.00 СБ, исходная спецификация
17 | Муфты | Муфта BM 42-55 B-B Red (Сталь 45) | 1 |  | 25.SHT.G.00.00.00.00 СБ, исходная спецификация
18 | Крепёж и стандартные изделия | Болт М16x35 DIN 933 ОЦ | 1 |  | 25.SHT.G.00.00.00.00 СБ, исходная спецификация
19 | Крепёж и стандартные изделия | Болт М8 DIN 931 A2 | 16 |  | 25.SHT.G.00.00.00.00 СБ, исходная спецификация
20 | Крепёж и стандартные изделия | Шайба М8 DIN 127 А2 | 16 |  | 25.SHT.G.00.00.00.00 СБ, исходная спецификация
21 | Крепёж и стандартные изделия | Hexagon Flange Nut DIN 6923 - M8 - C | 32 |  | 25.SHT.G.00.00.00.00 СБ, исходная спецификация
22 | Крепёж и стандартные изделия | Hexagon Flange Nut DIN 6923 - M16 - C | 27 |  | 25.SHT.G.00.00.00.00 СБ, исходная спецификация
