hisp2k/parameters/engineering/SolidWorksCodex/CHANGELOG.md

# Changelog

## 2026-09-15 - Scoped Native Assembly Experiment

- Add explicit opt-in Pack and Go and guarded test document lifecycle/audit tools.
- Enforce registered local folder, recursive dependency scope and unrelated-document protection.
- Back up before rebuild/save; reject unresolved/unhealthy components and unsafe close/reopen.
- Distinguish loaded document activation, rebuild warnings and proven disk reload.
- Reuse verified SI volume calculation; exclude MaterialFolder from mate counting.
- Add reproducible sequential experiment and raw full-run/final verification evidence.
- OFFLINE_PASS: 276 + 81/88 + 74 + 26. LIVE_PASS: 4 -> 5 mm, one body, volume +25%,
  two updated plate instances, six clean mates and persisted dimension after true reopen.
- Preserve 116 original CAD files and all backups. Installed MCP remains unchanged.

## 2026-09-15 - Native Dimension Pilot

- Decode IDimension.GetType with swDimensionParamType_e, not the display enum.
- Reject angular/integer/unknown parameter types without AI-name heuristics.
- Expose supported Extrusion edits in MCP JSON Schema and descriptions.
- Correct API doubles; add enum, native-dimension and real STDIO schema regressions.
- OFFLINE_PASS: 263 core, 81 assembly/STDIO (88 with installed Interop), 74 write-safety.
- LIVE_PASS: existing native plate thickness 4 -> 5 -> 4 mm, rebuild/save and backups.
- Confirm one solid body, expected volume changes and unchanged other CAD files.
- Update installed EXE after verified backup; chat MCP transport needs reconnection.
- Add NATIVE_PART_PILOT.md and two raw live evidence JSON reports; no assembly writes.

## 2026-09-15 - Connector Write-Safety Audit

- Reject unknown dirty/read-only state before modifying existing documents.
- Retain verified document/configuration through edits, save and rollback.
- Back up every explicit save and stop after failed property rebuild.
- Verify feature ownership and linear units; reject angular AI_* dimensions.
- Resolve hidden variant parameters through shared inventory; hash-verify copies.
- Budget mutex waiting separately; extend feature edit and assembly open limits.
- BUILD.cmd runs assembly-read and write-safety regressions.
- PASS: 262 Framework, 262 portable, 82 assembly/STDIO/Interop, 47 write-safety.
- Live smoke: status/document/equations only. No live write validation.
