hisp2k/parameters/engineering/SolidWorksCodex/RELEASE_NOTES_2.0_RU.txt

SOLIDWORKS CODEX 2.0.0 — ЛОКАЛЬНЫЙ ПИЛОТ

Подтверждено на SOLIDWORKS 2026 SP03.2:
- подключение Codex через MCP;
- чтение детали, свойств, материала, массы, габаритов и дерева элементов;
- создание параметрических пластин, фланцев, призматических и токарных деталей;
- карманы, пазы, выступы, фаски, скругления и отверстия в поддерживаемых планах;
- назначение AISI 304 и заполнение безопасных свойств;
- изменение Extrusion с резервной копией, перестроением и сохранением;
- одно групповое изменение 15 параметров AI_*;
- проверка итоговых габаритов и объёма;
- создание SLDDRW, аудит видов/размеров и экспорт PDF;
- изменение только файлов на локальном фиксированном диске.

Ограничения безопасности:
- запись в UNC, подключённые сетевые диски, PDM и сборки запрещена;
- произвольные макросы, команды оболочки и COM-вызовы запрещены;
- существующий изменяемый файл получает уникальную проверенную резервную копию;
- созданные модели и чертежи не считаются допущенными к изготовлению;
- перед производством обязательна проверка конструктора.

Главная проверка после установки:
CREATE_TEST_GROUPED_PARAMETERS.cmd

Ожидаемая последняя строка:
PASS: 15 grouped parameters, one backup, rebuild, exact volume, drawing and PDF passed.
