hisp2k/parameters/engineering/SolidWorksCodex/RELEASE_NOTES_2.2.2_RU.txt

SOLIDWORKS CODEX 2.2.2 — ЛОКАЛЬНЫЙ ПИЛОТ

НОВОЕ В 2.2.2
- исправлен живой сбой EXTRUSION_FAILED для Plan v6 и листовых контуров:
  дуги теперь создаются по двум концам и вычисленной точке на нужной дуге;
- направление и длина дуги больше не зависят от неоднозначного COM-флага
  CreateArc Direction, который мог построить дополнительную дугу вместо короткой;
- добавлены автономные проверки расчёта средней точки для дуг по и против часовой
  стрелки;
- контурный живой тест теперь сериализует каждую координату как явный Double;
- объединены защищённая версия 2.1.0 и изменения из архива Claude;
- Prismatic Plan v6: выборочные фаски и истинные скругления на выпуклых
  вершинах многоугольного наружного профиля;
- исправлена реализация Claude: скругления теперь участвуют и в базовой, и в
  финальной B-rep проверке, а отверстия проверяются по уже обработанной границе;
- добавлен живой тест CREATE_TEST_POLYGON_CORNERS.cmd;
- добавлен необязательный ClaudeBridge 1.1 без активного создающего запроса и
  без BOM в response.json;
- новый MCP-инструмент sw_create_sheet_from_contours;
- создание плоской детали постоянной толщины по замкнутому контуру из настоящих
  отрезков и дуг, а не из приближённого многоугольника;
- внутренние замкнутые вырезы произвольного контура;
- отдельные отверстия и линейные массивы отверстий;
- проверка замкнутости, связности, самопересечений, наложений, площади, объёма,
  числа тел и цилиндрических поверхностей до сохранения;
- явный отказ для труб, уголков, швеллеров, гибов, резьб и зенковок: такие детали
  нельзя подменять плоской пластиной;
- протокол PROMPT_PDF_TO_SOLIDWORKS_RU.txt для построения по PDF без догадок.

Подтверждено на SOLIDWORKS 2026 SP03.2:
- подключение Codex через MCP;
- чтение детали, свойств, материала, массы, габаритов и дерева элементов;
- создание параметрических пластин, фланцев, призматических и токарных деталей;
- карманы, пазы, выступы, фаски, скругления и отверстия в поддерживаемых планах;
- назначение AISI 304 и заполнение безопасных свойств;
- изменение Extrusion с резервной копией, перестроением и сохранением;
- одно групповое изменение 15 параметров AI_*;
- проверка итоговых габаритов и объёма;
- создание SLDDRW, аудит видов/размеров и экспорт PDF;
- изменение только файлов на локальном фиксированном диске.

Ограничения безопасности:
- запись в UNC, подключённые сетевые диски, PDM и сборки запрещена;
- произвольные макросы, команды оболочки и COM-вызовы запрещены;
- существующий изменяемый файл получает уникальную проверенную резервную копию;
- созданные модели и чертежи не считаются допущенными к изготовлению;
- перед производством обязательна проверка конструктора.

Главные новые проверки после установки:
CREATE_TEST_SHEET_CONTOUR.cmd
CREATE_TEST_POLYGON_CORNERS.cmd

Обе проверки должны закончиться зелёной строкой PASS.
