hisp2k/parameters/engineering/SolidWorksCodex/RELEASE_NOTES_2.3.0_RU.md

# SolidWorksCodex 2.3.0 — заметки о выпуске

## Контекст

Проанализирован производственный комплект чертежей (ZIP, PDF). Классификация
выявила, что наиболее часто повторяющийся класс детали, не поддерживаемый
коннектором на момент анализа, — профильная деталь (равнополочный уголок
постоянного сечения с осевыми отверстиями на полках). По формуле приоритета
(число покрываемых деталей × производственная полезность ÷ сложность и риск)
выбрано ровно одно минимальное универсальное расширение: построитель
равнополочного уголка с отверстиями.

## Что добавлено

- `src/ProfilePartPlan.cs` — схема плана v1: `cross_section` (`equal_angle`:
  `leg_a_mm`, `leg_b_mm`, `thickness_mm`), `length_mm`, `hole_groups[]` (грань
  `leg_a`/`leg_b`, явный список позиций или линейный массив, диаметр, отступ
  от кромки), `material`, `properties`. Строгая проверка входных данных: точные
  ключи, диапазоны длины/полки/толщины, зазор отверстий, лимиты количества.
- `sw_create_profile_part_from_plan` (`src/SolidWorksReader.cs`): создаёт новую
  уникально named SLDPRT деталь, не трогая открытые документы пользователя.
- Проверка ожидаемого объёма (аналитически по сечению и длине) до и после
  вырезов; проверка количества тел (ровно одно) после каждого выреза; проверка
  количества и диаметров цилиндрических граней через уже проверенный
  `VerifyPrismaticCylinders`.
- `manufacturing_approved` всегда `false`; сохранение запрещается при любом
  расхождении геометрии.

## Технические находки при живом тестировании

1. **`swEndCondThroughAll` нестабилен на очень длинных тонких профилях.**
   На детали 4000×50×50×4 мм (соотношение длины к сечению 80:1) сквозной
   вырез через всё тело может расколоть единое тело на два из-за нестабильности
   трассировки луча на такой геометрии. Исправление: вырез `swEndCondBlind` с
   глубиной, равной проверенной толщине полки, вместо `ThroughAll`.
2. **Направление глухого выреза не всегда очевидно.** Знак нормали эскизной
   плоскости зависит от того, по какую сторону опорной плоскости лежит тело.
   Добавлен один повторный вызов с противоположным направлением (`Dir=false`)
   перед тем, как считать вырез неудачным.
3. **Экстремальное соотношение длины к сечению (≥80:1) остаётся
   неподтверждённым ограничением.** Контрольный план (200 мм, 40×40×3 мм)
   и диагностический план с параметрами реального отверстия, но длиной
   500 мм (50×50×4 мм, Ø9 мм, отступ 32 мм) — оба построены успешно и прошли
   все проверки. Тот же самый план на реальной длине 4000 мм завершается
   `CUT_FAILED` на первом же отверстии, и в ходе попытки сам процесс
   SOLIDWORKS 2026 аварийно завершился (потребовался перезапуск). Ни один
   реальный документ пользователя при этом не пострадал — коннектор никогда
   не сохраняет и не изменяет существующие открытые детали. Причина сбоя пока
   не установлена окончательно (не только сбой самого API-вызова, но и
   нестабильность самого SOLIDWORKS на такой геометрии) и **не должна
   угадываться** — нужен дальнейший анализ (иная стратегия выреза, разбиение
   операции, проверка настроек точности документа) прежде чем снова пытаться
   строить эту деталь автоматически.

## Инцидент: потеря несохранённого кода

В одной из предыдущих рабочих сессий вся реализация этой возможности в
`src/SolidWorksReader.cs` была случайно стёрта до коммита (вероятно, точечный
`git checkout --`/`git restore` по одному файлу). Код не был потерян из
истории git — его там никогда не было, потому что коммит не был сделан сразу
после написания. Обнаружено по пропаже `sw_create_profile_part_from_plan` из
`sw_status.write_tools_available` и подтверждено через `git status`/`git diff
--stat HEAD`. Код полностью восстановлен по проверенным соседним методам с
сохранением точных формул привязки осей и исправления направления выреза;
контрольный живой тест после восстановления прошёл полностью. Вывод на
будущее: коммитить каждое существенное изменение сразу после успешной
автономной сборки, не дожидаясь завершения всей функции целиком.

## Статус

- Офлайн-тесты: 225/225 PASS.
- MCP STDIO smoke-test: PASS.
- Живой тест (контрольный план): PASS.
- Живой тест (реальный план 05.SHT.TR.11.00.00.05): FAIL — открытый, задокументированный
  пробел, не заявляется как работающий.
- `manufacturing_approved`: всегда `false`. Обязательна проверка конструктора.
