hisp2k/parameters/screw-conveyors/25-SHT-G/original-sources/assembly/SHT-PV2-L3000 изм 1.pdf

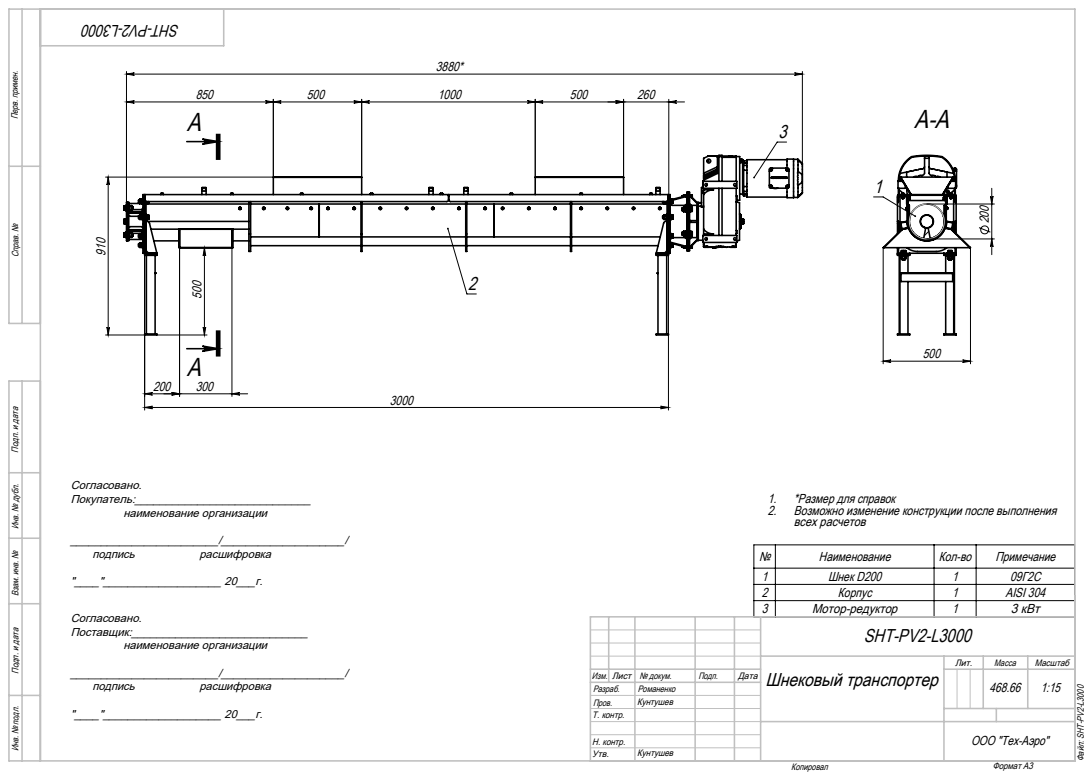
[picture p169: page 1]
наименование организации; Формат A3

Инв. № подл. Подп. и дата Взам. инв. № Инв. № дубл. Подп. и дата Перв. примен. Справ. №

1. *Размер для справок
2. Возможно изменение конструкции после выполнения
всех расчетов

№ | Наименование | Кол-во | Примечание
1 | Шнек D200 | 1 | 09Г2С
2 | Корпус | 1 | AISI 304
3 | Мотор-редуктор | 1 | 3 кВт

SHT-PV2-L3000

Шнековый транспортер | Лит. | Масса | Масштаб

Изм. Лист | | № докум. | Подп. | Дата | | | | | 468.66 | 1:15
Разраб. | | Романенко
Пров. | | Кунтушев
Т. контр.

Файл: SHT-PV2-L3000 Версия 3

ООО "Тех-Аэро"

Н. контр.
Утв. | Кунтушев
