hisp2k/parameters/screw-conveyors/25-SHT-G/original-sources/assembly/Чертежи/25.SHT.G.02.00.00.00 СБ  Шнек с осями.pdf

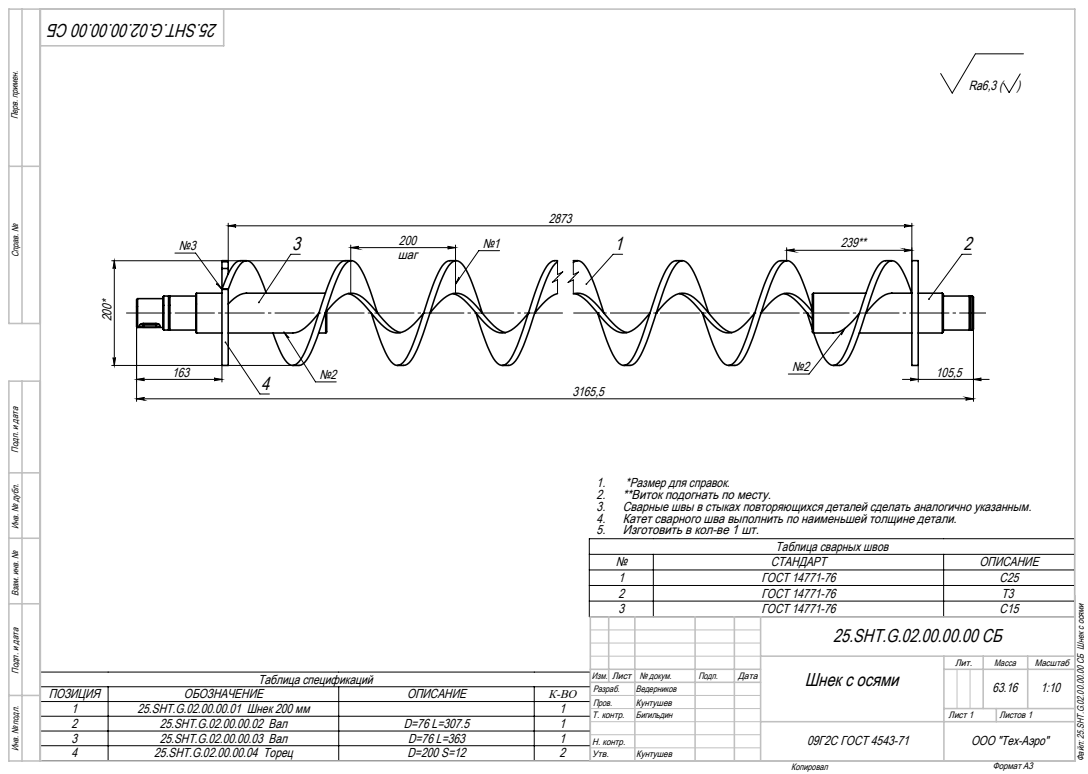
[picture p170: page 1]
Таблица спецификаций; Формат A3

Инв. № подл. Подп. и дата Взам. инв. № Инв. № дубл. Подп. и дата Перв. примен. Справ. №

1. *Размер для справок.
2. **Виток подогнать по месту. 3. Сварные швы в стыках повторяющихся деталей сделать аналогично указанным.
4. Катет сварного шва выполнить по наименьшей толщине детали.
5. Изготовить в кол-ве 1 шт.

Таблица сварных швов

№ | СТАНДАРТ | ОПИСАНИЕ
1 | ГОСТ 14771-76 | С25
2 | ГОСТ 14771-76 | Т3
3 | ГОСТ 14771-76 | С15

Файл: 25.SHT.G.02.00.00.00 СБ Шнек с осями Версия 3

25.SHT.G.02.00.00.00 СБ

Шнек с осями | Лит. | Масса | Масштаб

Изм. Лист | | № докум. | Подп. | Дата | | | | | 63.16 | 1:10
Разраб. | | Ведерников
Пров. | | Кунтушев
Т. контр. | Бигильдин | | | | Лист 1 | Листов 1

ПОЗИЦИЯ | ОБОЗНАЧЕНИЕ | ОПИСАНИЕ | К-ВО
1 | 25.SHT.G.02.00.00.01 Шнек 200 мм | | 1
2 | 25.SHT.G.02.00.00.02 Вал | D=76 L=307.5 | 1
3 | 25.SHT.G.02.00.00.03 Вал | D=76 L=363 | 1
4 | 25.SHT.G.02.00.00.04 Торец | D=200 S=12 | 2

09Г2С ГОСТ 4543-71 | ООО "Тех-Аэро"

Н. контр.
Утв. | Кунтушев
