hisp2k/parameters/screw-conveyors/25-SHT-G/original-sources/assembly/Чертежи/Заглушка.pdf

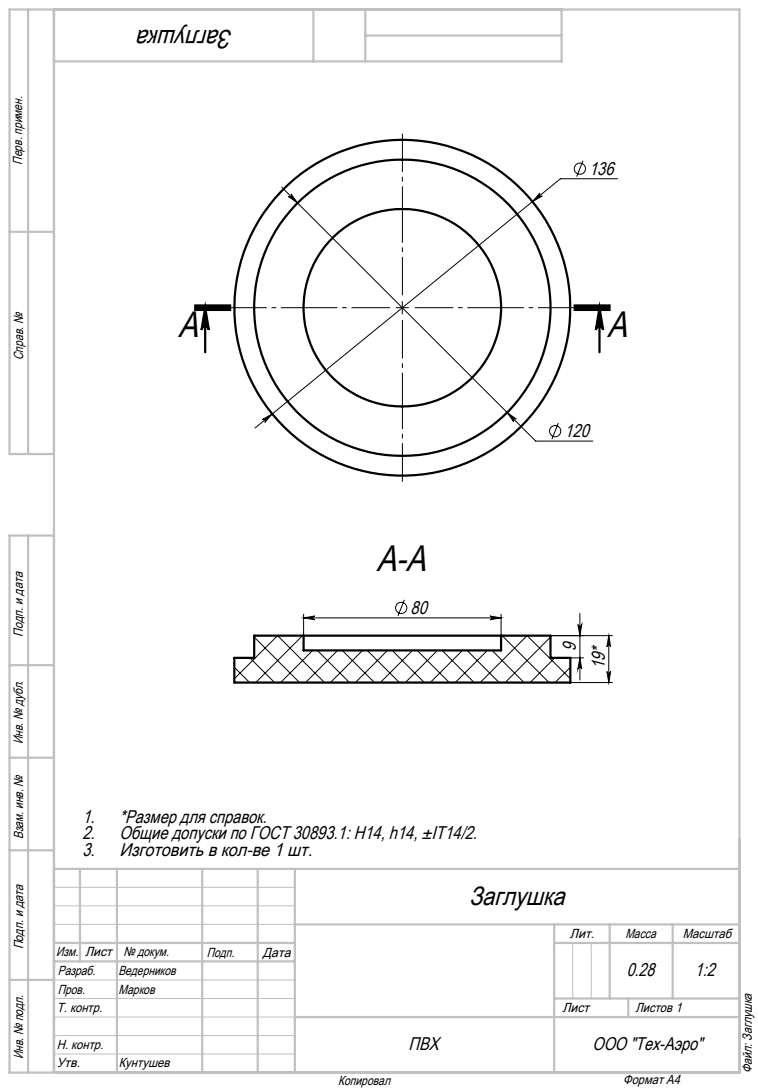
[picture p171: page 1]
Формат A4

Инв. № подл. Подп. и дата Взам. инв. № Инв. № дубл. Подп. и дата Перв. примен. Справ. №

1. *Размер для справок.
2. Общие допуски по ГОСТ 30893.1: Н14, h14, ±IT14/2. 3. Изготовить в кол-ве 1 шт.

Заглушка

Лит. | Масса | Масштаб

Изм. Лист | № докум. | Подп. | Дата | | | | | 0.28 | 1:2
Разраб. | Ведерников
Пров. | Марков
Т. контр. | | | | Лист | Листов 1

Файл: Заглушка Версия 3

ПВХ | ООО "Тех-Аэро"

Н. контр.
Утв. | Кунтушев
