hisp2k/parameters/screw-conveyors/25-SHT-G/original-sources/assembly/Чертежи/Вальцовка/25.SHT.G.00.00.00.00/25.SHT.G.00.00.00.02  Футеровка.pdf

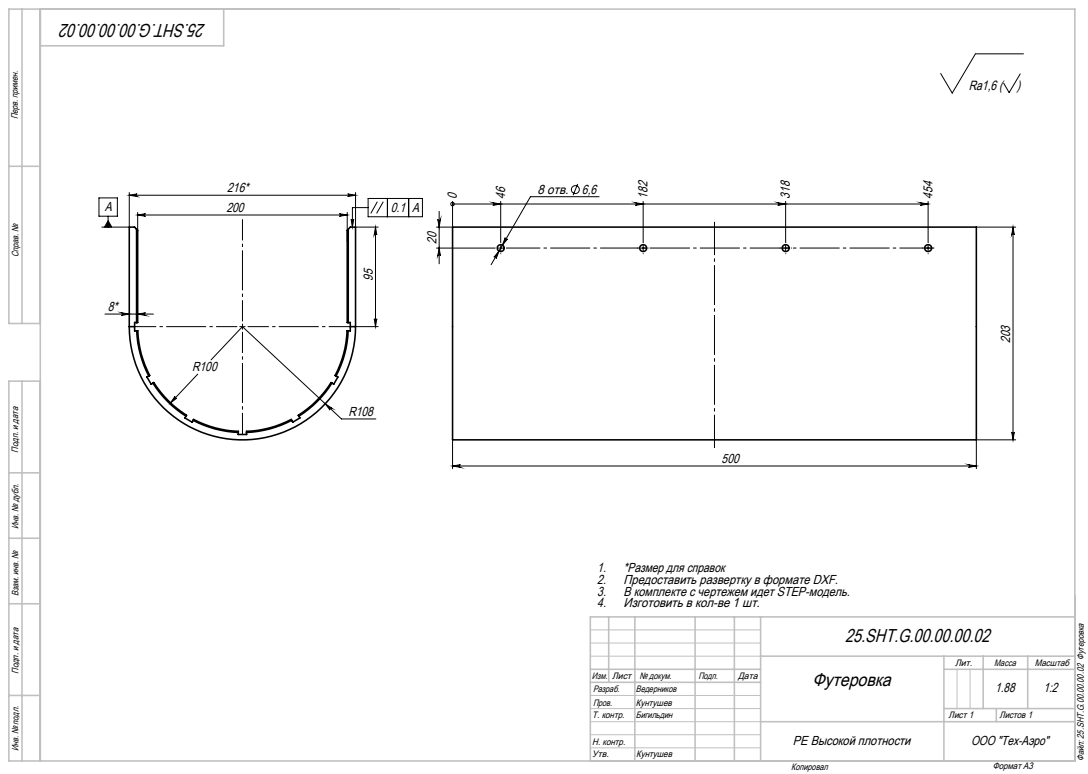
[picture p173: page 1]
8 отв. 6,6; Формат A3

Инв. № подл. Подп. и дата Взам. инв. № Инв. № дубл. Подп. и дата Перв. примен. Справ. №

1. *Размер для справок
2. Предоставить развертку в формате DXF. 3. В комплекте с чертежем идет STEP-модель.
4. Изготовить в кол-ве 1 шт.

25.SHT.G.00.00.00.02

Файл: 25.SHT.G.00.00.00.02 Футеровка Версия 3

Футеровка | Лит. | Масса | Масштаб

Изм. Лист | | № докум. | Подп. | Дата | | | | | 1.88 | 1:2
Разраб. | | Ведерников
Пров. | | Кунтушев
Т. контр. | Бигильдин | | | | Лист 1 | Листов 1

PE Высокой плотности | ООО "Тех-Аэро"

Н. контр.
Утв. | Кунтушев
