hisp2k/parameters/screw-conveyors/25-SHT-G/original-sources/assembly/Чертежи/Вальцовка/25.SHT.G.00.00.00.00/25.SHT.G.01.00.00.01  Желоб выгрузки.pdf

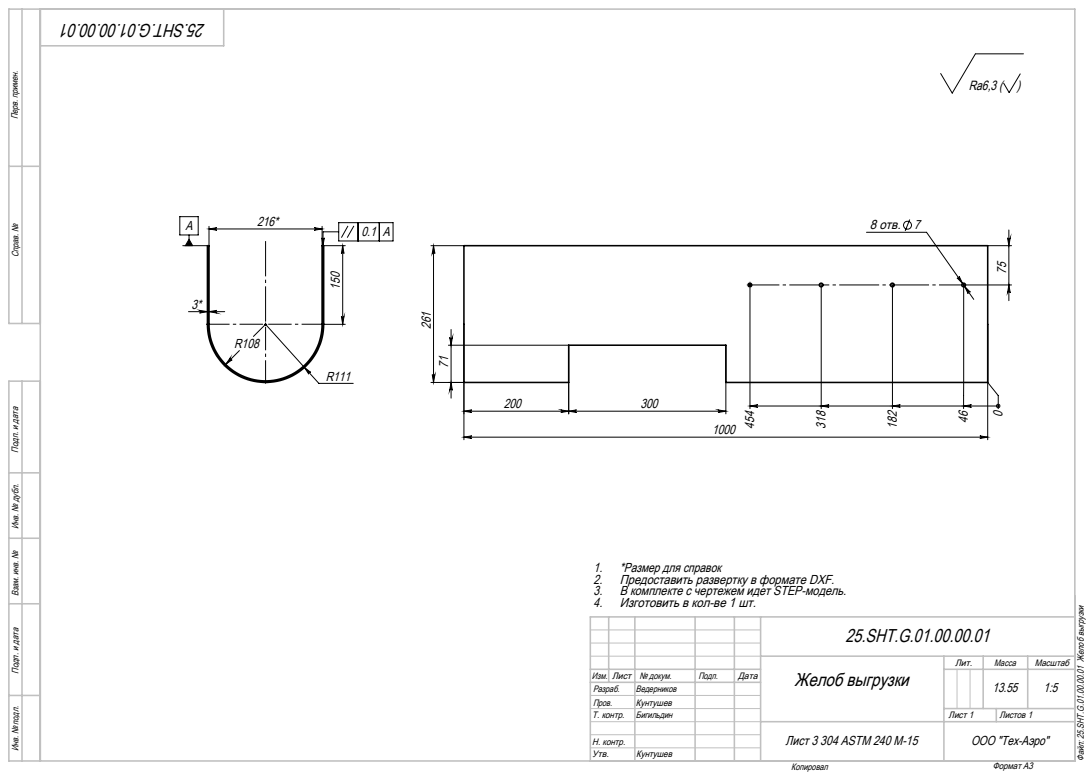
[picture p174: page 1]
8 отв. 7; Формат A3

Инв. № подл. Подп. и дата Взам. инв. № Инв. № дубл. Подп. и дата Перв. примен. Справ. №

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

Файл: 25.SHT.G.01.00.00.01 Желоб выгрузки Версия 3

25.SHT.G.01.00.00.01

Желоб выгрузки | Лит. | Масса | Масштаб

Изм. Лист | | № докум. | Подп. | Дата | | | | | 13.55 | 1:5
Разраб. | | Ведерников
Пров. | | Кунтушев
Т. контр. | Бигильдин | | | | Лист 1 | Листов 1

Лист 3 304 ASTM 240 M-15 | ООО "Тех-Аэро"

Н. контр.
Утв. | Кунтушев
