hisp2k/parameters/screw-conveyors/25-SHT-G/original-sources/assembly/Чертежи/Вальцовка/25.SHT.G.00.00.00.00/25.SHT.G.01.00.00.02, 25.SHT.G.01.00.00.03  Желоб.pdf

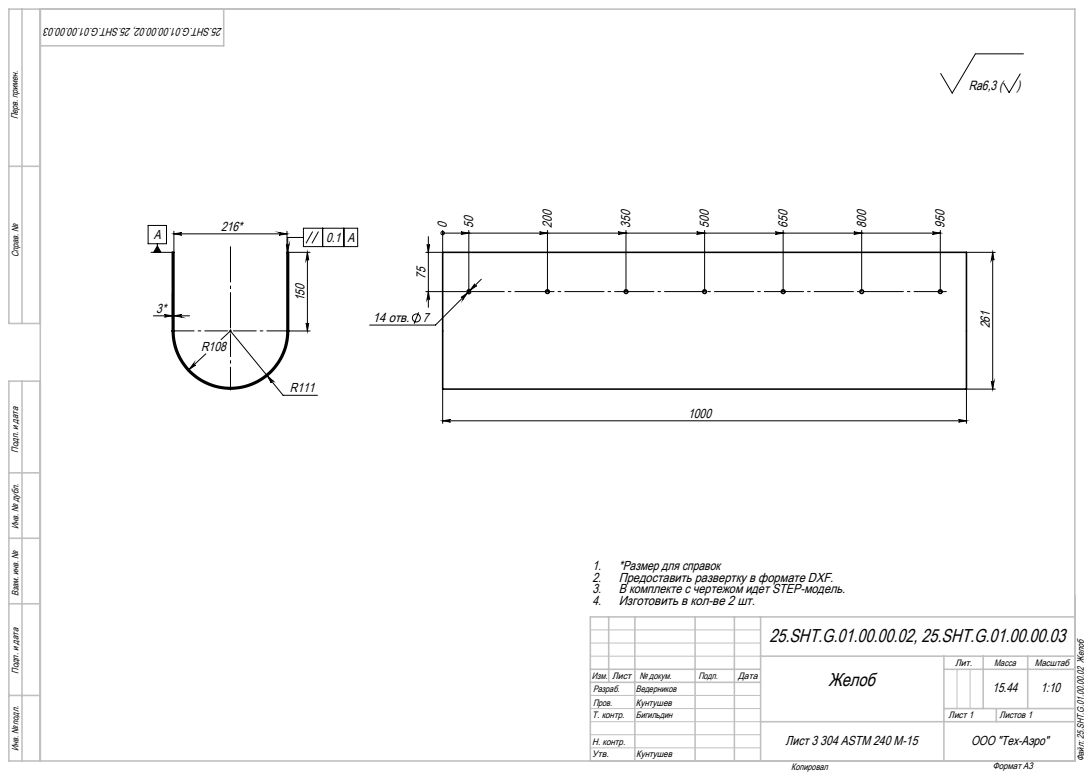
[picture p175: page 1]
14 отв. 7; Формат A3

Инв. № подл. Подп. и дата Взам. инв. № Инв. № дубл. Подп. и дата Перв. примен. Справ. №

1. *Размер для справок
2. Предоставить развертку в формате DXF. 3. В комплекте с чертежом идет STEP-модель.
4. Изготовить в кол-ве 2 шт.

25.SHT.G.01.00.00.02, 25.SHT.G.01.00.00.03

Файл: 25.SHT.G.01.00.00.02 Желоб Версия 3

Желоб | Лит. | Масса | Масштаб

Изм. Лист | | № докум. | Подп. | Дата | | | | | 15.44 | 1:10
Разраб. | | Ведерников
Пров. | | Кунтушев
Т. контр. | Бигильдин | | | | Лист 1 | Листов 1

Лист 3 304 ASTM 240 M-15 | ООО "Тех-Аэро"

Н. контр.
Утв. | Кунтушев
