hisp2k/parameters/screw-conveyors/25-SHT-G/original-sources/assembly/Чертежи/Гибка/25.SHT.G.00.00.00.00 Гибка/25.SHT.G.06.01.00.01  Пластина крышки.pdf

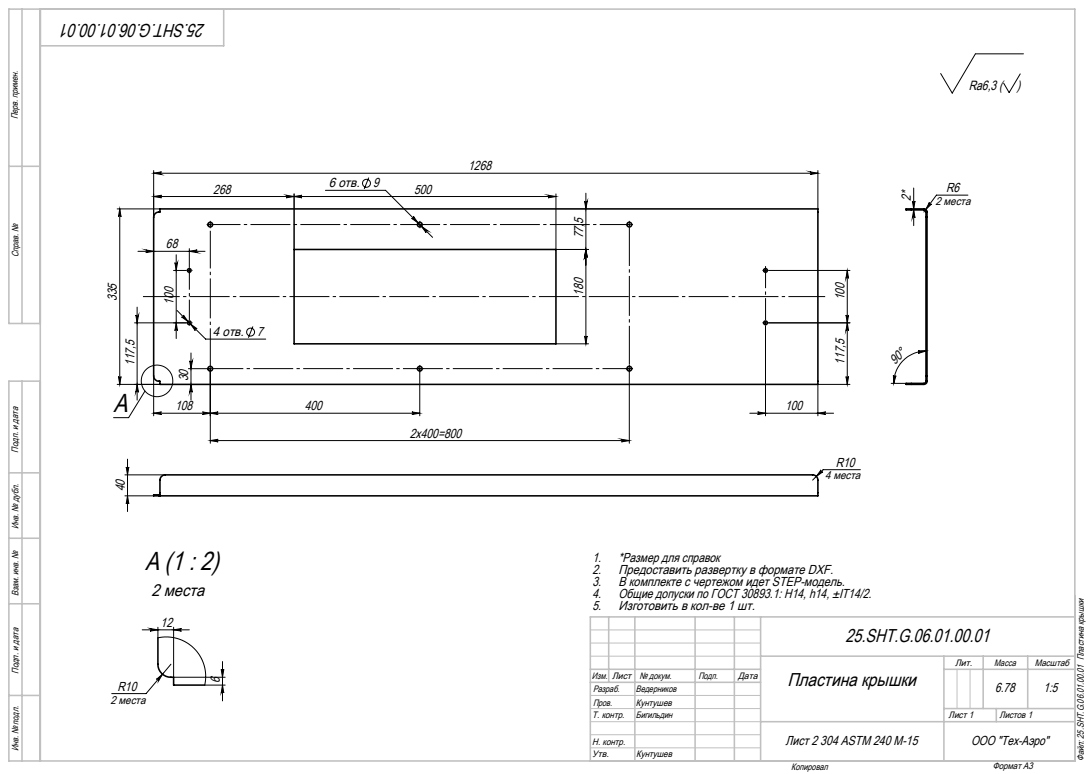
[picture p176: page 1]
6 отв. 9; 4 отв. 7; 2 места; 4 места; Формат A3

Инв. № подл. Подп. и дата Взам. инв. № Инв. № дубл. Подп. и дата Перв. примен. Справ. №

1. *Размер для справок
2. Предоставить развертку в формате DXF. 3. В комплекте с чертежом идет STEP-модель.
4. Общие допуски по ГОСТ 30893.1: Н14, h14, ±IT14/2.
5. Изготовить в кол-ве 1 шт.

Файл: 25.SHT.G.06.01.00.01 Пластина крышки Версия 3

25.SHT.G.06.01.00.01

Пластина крышки | Лит. | Масса | Масштаб

Изм. Лист | | № докум. | Подп. | Дата | | | | | 6.78 | 1:5
Разраб. | | Ведерников
Пров. | | Кунтушев
Т. контр. | Бигильдин | | | | Лист 1 | Листов 1

Лист 2 304 ASTM 240 M-15 | ООО "Тех-Аэро"

Н. контр.
Утв. | Кунтушев
