hisp2k/parameters/screw-conveyors/25-SHT-G/original-sources/assembly/Чертежи/Детали/25.SHT.G.00.00.00.00  Фланцы.pdf

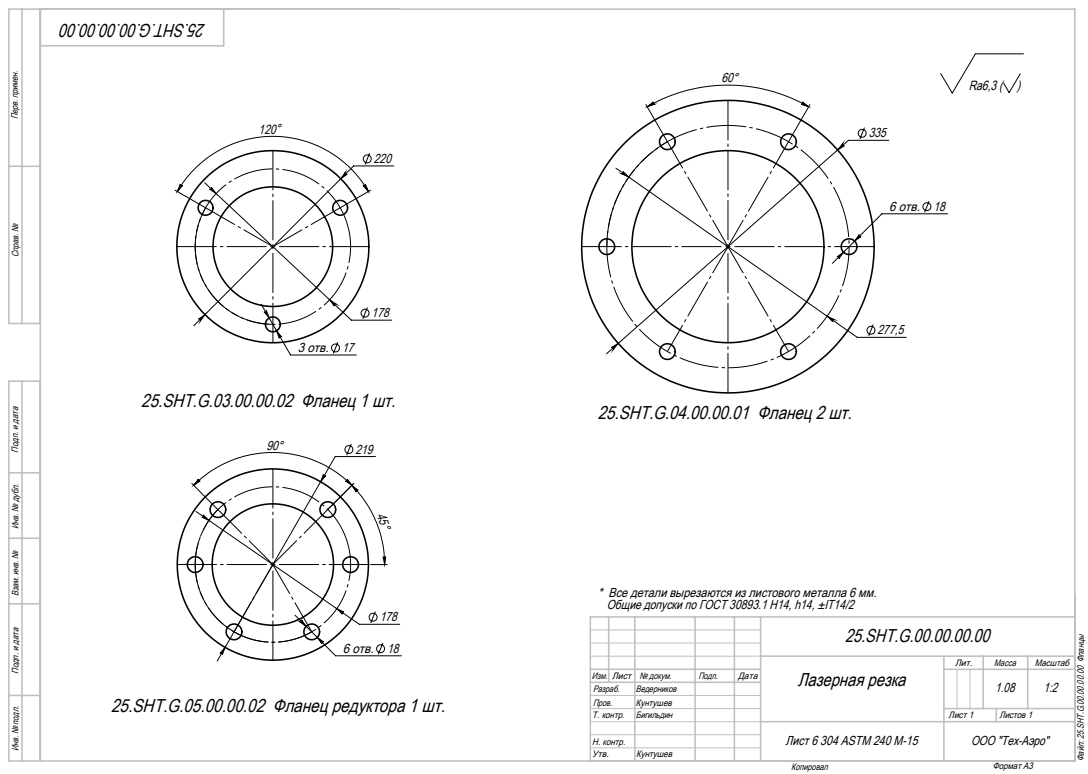
[picture p177: page 1]
3 отв. 17; 6 отв. 18; 25.SHT.G.03.00.00.02 Фланец 1 шт.; 25.SHT.G.04.00.00.01 Фланец 2 шт.; Формат A3

Инв. № подл. Подп. и дата Взам. инв. № Инв. № дубл. Подп. и дата Перв. примен. Справ. №

* Все детали вырезаются из листового металла 6 мм.
Общие допуски по ГОСТ 30893.1 Н14, h14, ±IT14/2

25.SHT.G.00.00.00.00

Файл: 25.SHT.G.00.00.00.00 Фланцы Версия 3

Лазерная резка | Лит. | Масса | Масштаб

Изм. Лист | | № докум. | Подп. | Дата | | | | | 1.08 | 1:2
Разраб. | | Ведерников
Пров. | | Кунтушев
Т. контр. | Бигильдин | | | | Лист 1 | Листов 1

25.SHT.G.05.00.00.02 Фланец редуктора 1 шт.

Лист 6 304 ASTM 240 M-15 | ООО "Тех-Аэро"

Н. контр.
Утв. | Кунтушев
