hisp2k/parameters/screw-conveyors/25-SHT-G/original-sources/assembly/Чертежи/Детали/25.SHT.G.00.00.00.03  Резиновая прокладка к фланцам.pdf

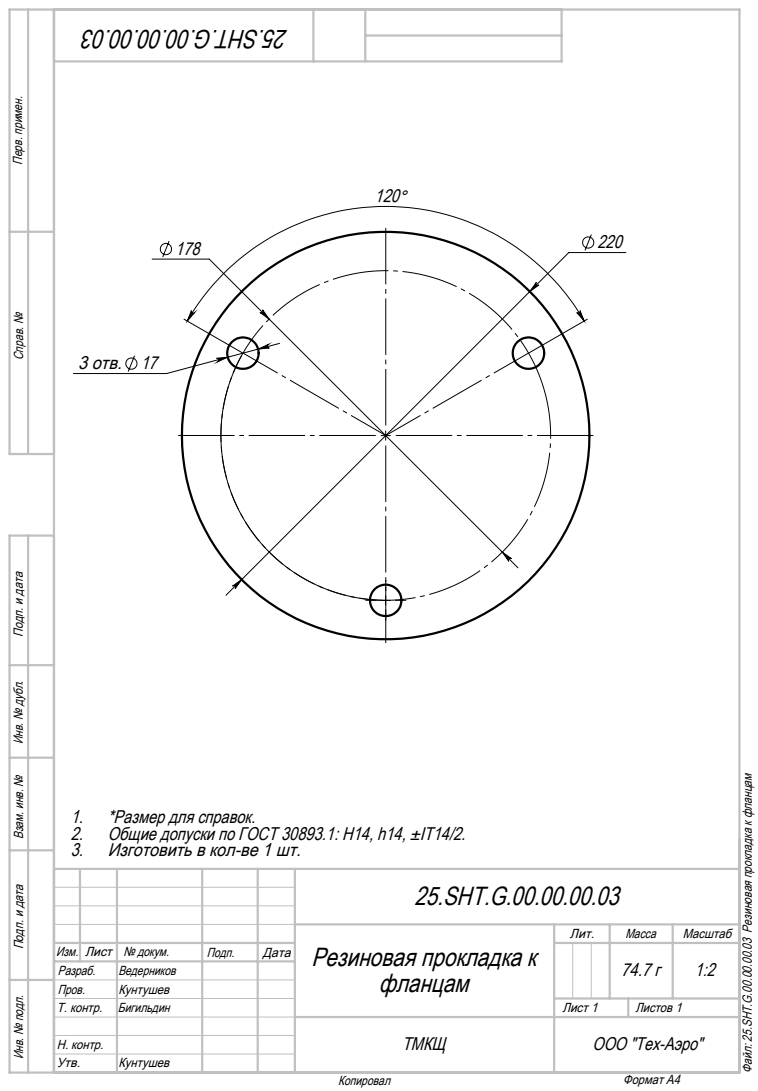
[picture p178: page 1]
3 отв. 17; Формат A4

Инв. № подл. Подп. и дата Взам. инв. № Инв. № дубл. Подп. и дата Перв. примен. Справ. №

Файл: 25.SHT.G.00.00.00.03 Резиновая прокладка к фланцам Версия 3

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

25.SHT.G.00.00.00.03

Резиновая прокладка к фланцам | Лит. | Масса | Масштаб

Изм. Лист | | № докум. | Подп. | Дата | | | | | 74.7 г | 1:2
Разраб. | | Ведерников
Пров. | Кунтушев
Т. контр. | Бигильдин | | | | Лист 1 | Листов 1

ТМКЩ | ООО "Тех-Аэро"

Н. контр.
Утв. | Кунтушев
