hisp2k/parameters/screw-conveyors/25-SHT-G/original-sources/assembly/Чертежи/Детали/25.SHT.G.00.00.00.04  Резина проставка под крышкой.pdf

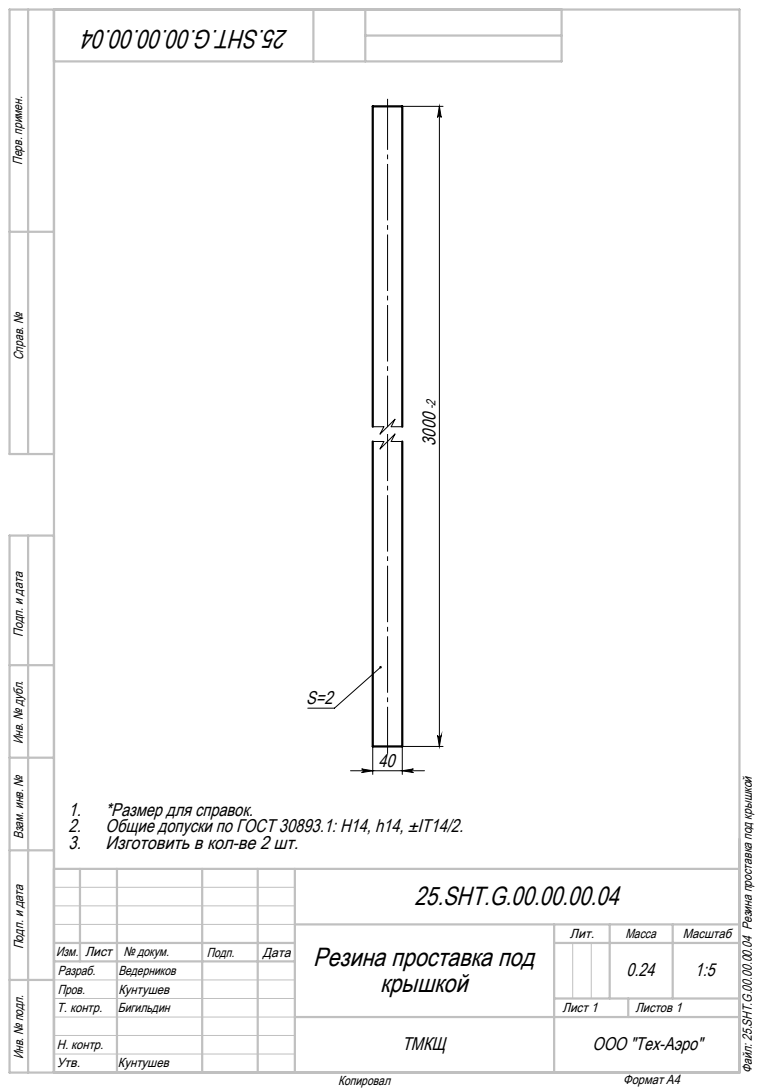
[picture p179: page 1]
Формат A4

Инв. № подл. Подп. и дата Взам. инв. № Инв. № дубл. Подп. и дата Перв. примен. Справ. №

Файл: 25.SHT.G.00.00.00.04 Резина проставка под крышкой Версия 3

1. *Размер для справок.
2. Общие допуски по ГОСТ 30893.1: Н14, h14, ±IT14/2. 3. Изготовить в кол-ве 2 шт.

25.SHT.G.00.00.00.04

Резина проставка под крышкой | Лит. | Масса | Масштаб

Изм. Лист | | № докум. | Подп. | Дата | | | | | 0.24 | 1:5
Разраб. | | Ведерников
Пров. | Кунтушев
Т. контр. | Бигильдин | | | | Лист 1 | Листов 1

ТМКЩ | ООО "Тех-Аэро"

Н. контр.
Утв. | Кунтушев
