hisp2k/parameters/screw-conveyors/25-SHT-G/original-sources/assembly/Чертежи/Детали/25.SHT.G.00.00.00.05  Фланец наружний.pdf

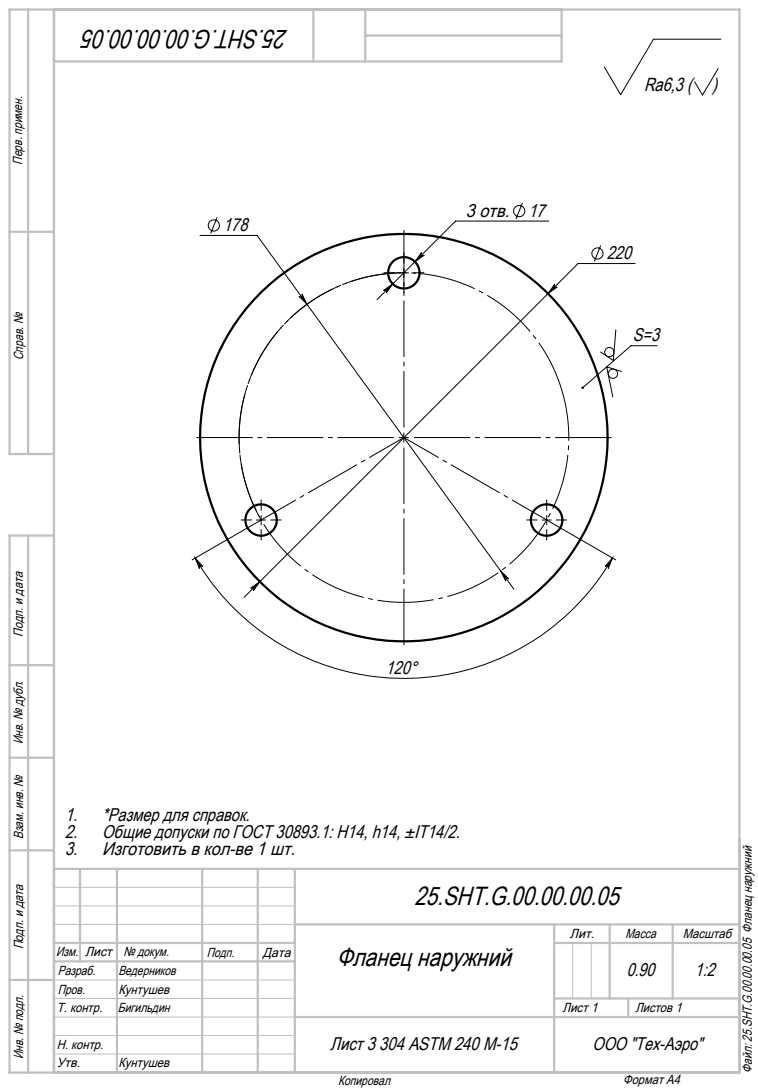
[picture p180: page 1]
3 отв. 17; Формат A4

Инв. № подл. Подп. и дата Взам. инв. № Инв. № дубл. Подп. и дата Перв. примен. Справ. №

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

Файл: 25.SHT.G.00.00.00.05 Фланец наружний Версия 3

25.SHT.G.00.00.00.05

Фланец наружний | Лит. | Масса | Масштаб

Изм. Лист | | № докум. | Подп. | Дата | | | | | 0.90 | 1:2
Разраб. | | Ведерников
Пров. | Кунтушев
Т. контр. | Бигильдин | | | | Лист 1 | Листов 1

Лист 3 304 ASTM 240 M-15 | ООО "Тех-Аэро"

Н. контр.
Утв. | Кунтушев
