hisp2k/parameters/screw-conveyors/25-SHT-G/original-sources/assembly/Чертежи/Детали/25.SHT.G.01.00.00.04  Уголок.pdf

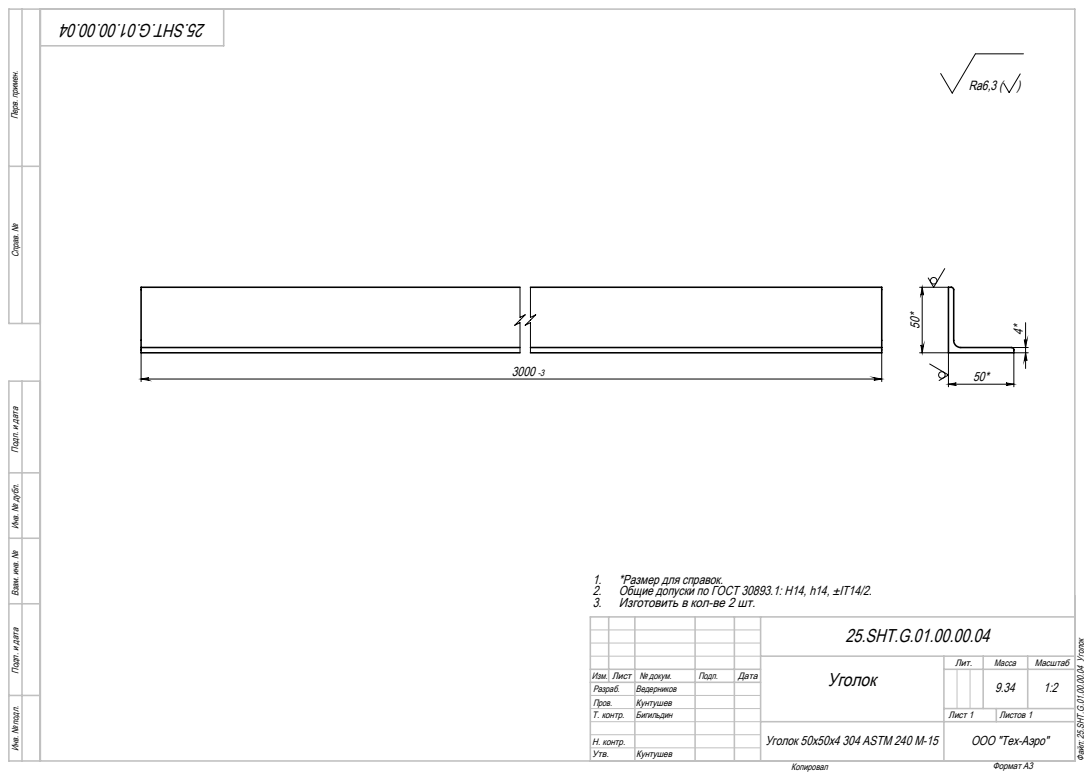
[picture p181: page 1]
Формат A3

Инв. № подл. Подп. и дата Взам. инв. № Инв. № дубл. Подп. и дата Перв. примен. Справ. №

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

25.SHT.G.01.00.00.04

Файл: 25.SHT.G.01.00.00.04 Уголок Версия 3

Уголок | Лит. | Масса | Масштаб

Изм. Лист | | № докум. | Подп. | Дата | | | | | 9.34 | 1:2
Разраб. | | Ведерников
Пров. | | Кунтушев
Т. контр. | Бигильдин | | | | Лист 1 | Листов 1

Уголок 50х50х4 304 ASTM 240 M-15 | ООО "Тех-Аэро"

Н. контр.
Утв. | Кунтушев
