hisp2k/parameters/screw-conveyors/25-SHT-G/original-sources/assembly/Чертежи/Детали/25.SHT.G.01.00.00.10  Труба.pdf

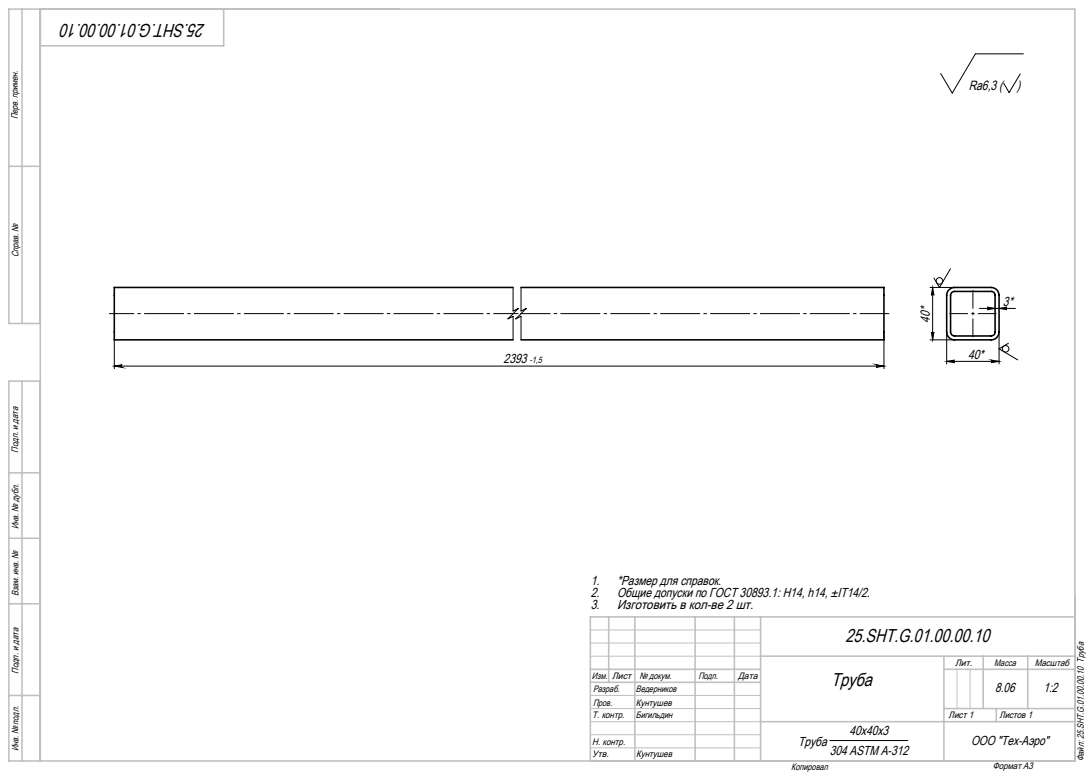
[picture p182: page 1]
1. *Размер для справок.; Формат A3

Инв. № подл. Подп. и дата Взам. инв. № Инв. № дубл. Подп. и дата Перв. примен. Справ. №

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

25.SHT.G.01.00.00.10

Файл: 25.SHT.G.01.00.00.10 Труба Версия 3

Труба | Лит. | Масса | Масштаб

Изм. Лист | | № докум. | Подп. | Дата | | | | | 8.06 | 1:2
Разраб. | | Ведерников
Пров. | | Кунтушев
Т. контр. | Бигильдин | | | | Лист 1 | Листов 1

40х40х3 Труба 304 ASTM A-312 | ООО "Тех-Аэро"

Н. контр.
Утв. | Кунтушев
