hisp2k/parameters/screw-conveyors/25-SHT-G/original-sources/assembly/Чертежи/Детали/25.SHT.G.02.00.00.04  Торец.pdf

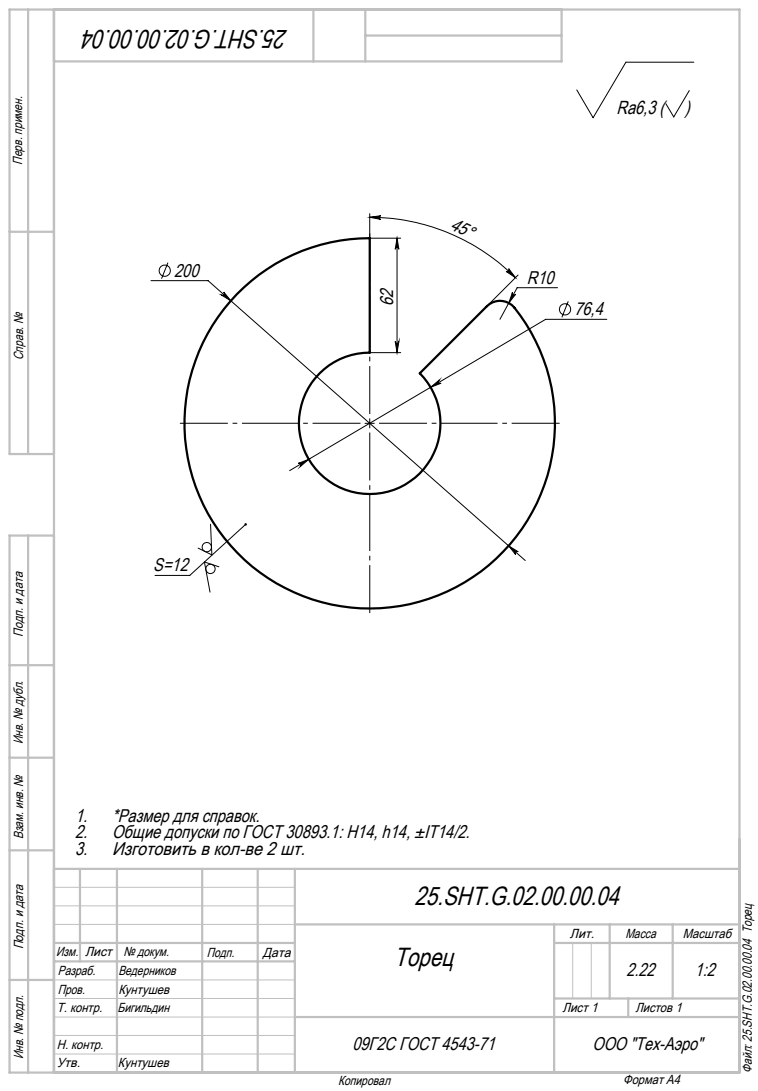
[picture p183: page 1]
Формат A4

Инв. № подл. Подп. и дата Взам. инв. № Инв. № дубл. Подп. и дата Перв. примен. Справ. №

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

25.SHT.G.02.00.00.04

Файл: 25.SHT.G.02.00.00.04 Торец Версия 3

Торец | Лит. | Масса | Масштаб

Изм. Лист | | № докум. | Подп. | Дата | | | | | 2.22 | 1:2
Разраб. | | Ведерников
Пров. | Кунтушев
Т. контр. | Бигильдин | | | | Лист 1 | Листов 1

09Г2С ГОСТ 4543-71 | ООО "Тех-Аэро"

Н. контр.
Утв. | Кунтушев
