hisp2k/parameters/screw-conveyors/25-SHT-G/original-sources/assembly/Чертежи/Детали/25.SHT.G.03.00.00.04  Косынка.pdf

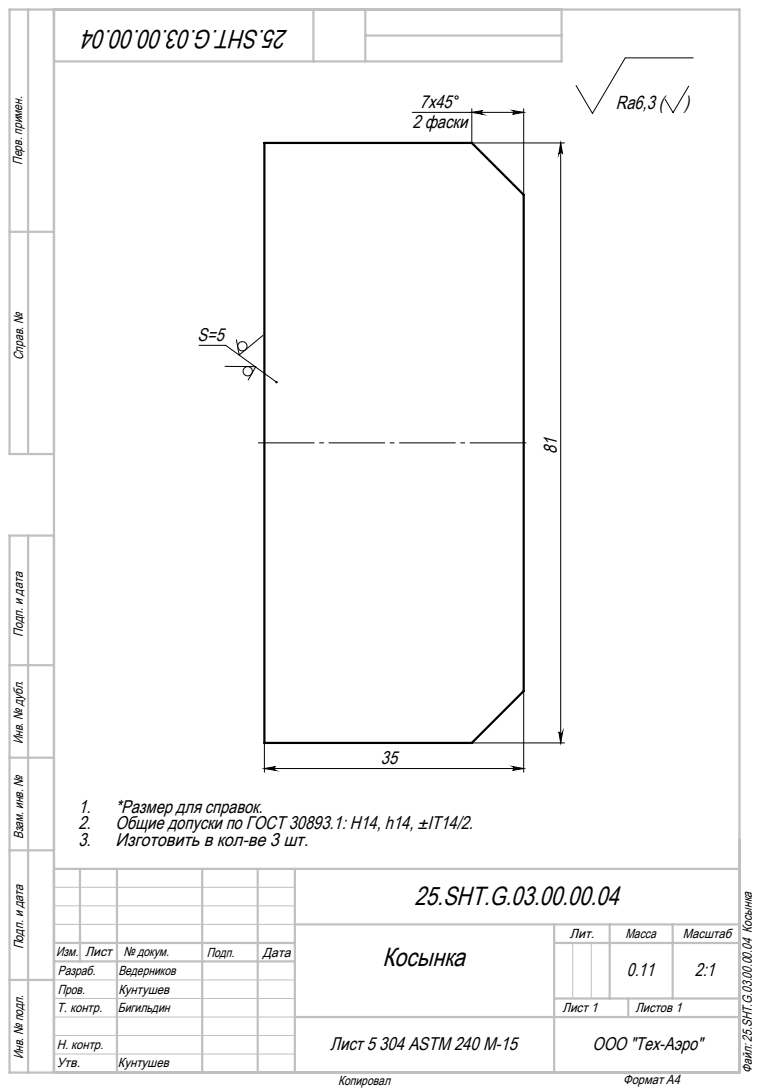
[picture p184: page 1]
2 фаски; Формат A4

Инв. № подл. Подп. и дата Взам. инв. № Инв. № дубл. Подп. и дата Перв. примен. Справ. №

1. *Размер для справок.
2. Общие допуски по ГОСТ 30893.1: Н14, h14, ±IT14/2. 3. Изготовить в кол-ве 3 шт.

25.SHT.G.03.00.00.04

Файл: 25.SHT.G.03.00.00.04 Косынка Версия 3

Косынка | Лит. | Масса | Масштаб

Изм. Лист | | № докум. | Подп. | Дата | | | | | 0.11 | 2:1
Разраб. | | Ведерников
Пров. | Кунтушев
Т. контр. | Бигильдин | | | | Лист 1 | Листов 1

Лист 5 304 ASTM 240 M-15 | ООО "Тех-Аэро"

Н. контр.
Утв. | Кунтушев
