hisp2k/parameters/screw-conveyors/25-SHT-G/original-sources/assembly/Чертежи/Детали/25.SHT.G.04.00.00.02  Труба фланца.pdf

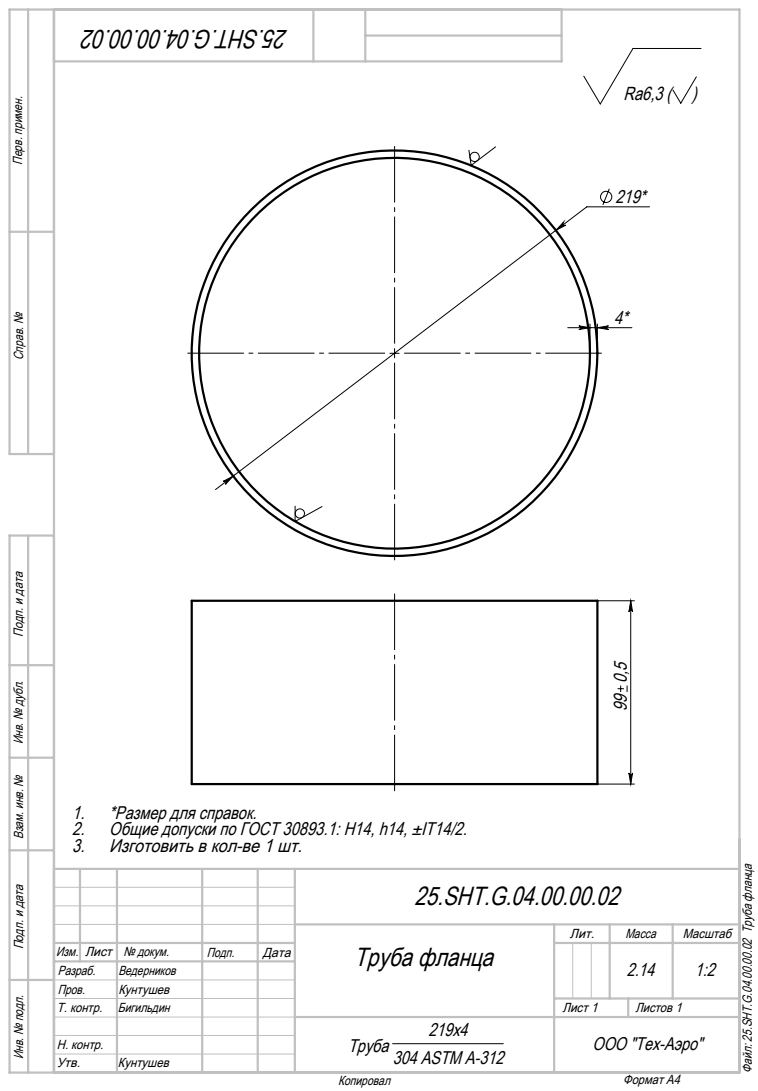
[picture p185: page 1]
Формат A4

Инв. № подл. Подп. и дата Взам. инв. № Инв. № дубл. Подп. и дата Перв. примен. Справ. №

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

Файл: 25.SHT.G.04.00.00.02 Труба фланца Версия 3

25.SHT.G.04.00.00.02

Труба фланца | Лит. | Масса | Масштаб

Изм. Лист | | № докум. | Подп. | Дата | | | | | 2.14 | 1:2
Разраб. | | Ведерников
Пров. | Кунтушев
Т. контр. | Бигильдин | | | | Лист 1 | Листов 1

219х4 Труба 304 ASTM A-312 | ООО "Тех-Аэро"

Н. контр.
Утв. | Кунтушев
