hisp2k/parameters/screw-conveyors/25-SHT-G/original-sources/assembly/Чертежи/Детали/25.SHT.G.09.00.00.01  Перекладина.pdf

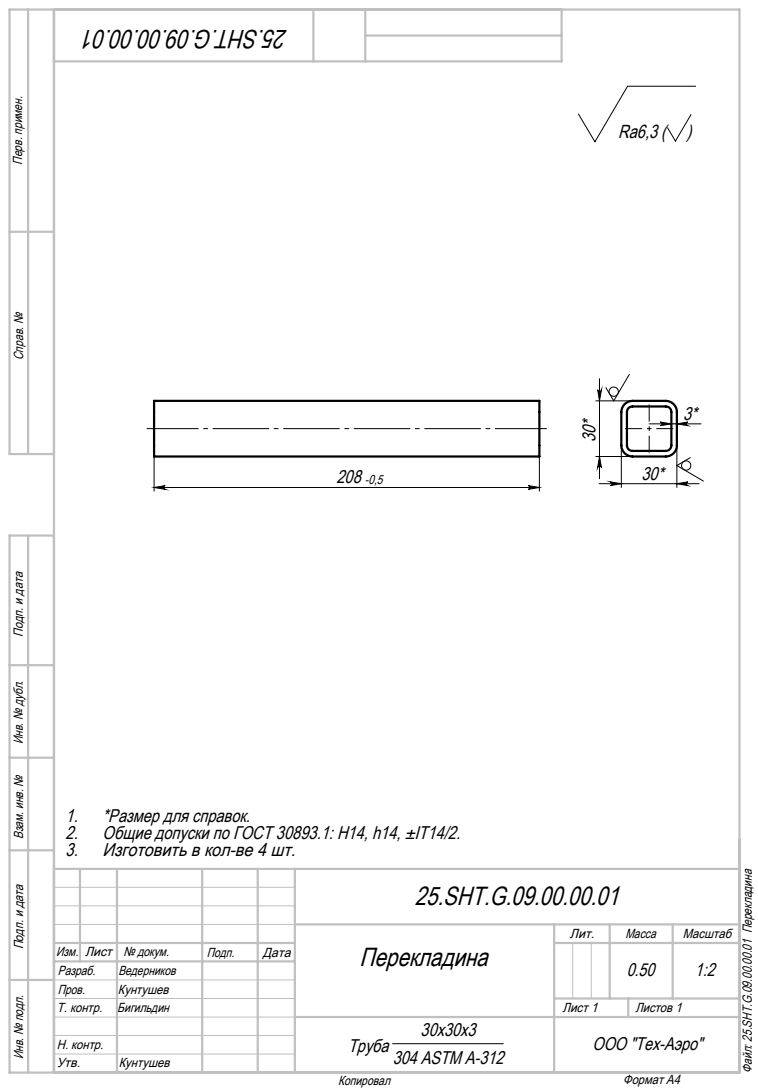
[picture p187: page 1]
1. *Размер для справок.; Формат A4

Инв. № подл. Подп. и дата Взам. инв. № Инв. № дубл. Подп. и дата Перв. примен. Справ. №

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

Файл: 25.SHT.G.09.00.00.01 Перекладина Версия 3

25.SHT.G.09.00.00.01

Перекладина | Лит. | Масса | Масштаб

Изм. Лист | | № докум. | Подп. | Дата | | | | | 0.50 | 1:2
Разраб. | | Ведерников
Пров. | Кунтушев
Т. контр. | Бигильдин | | | | Лист 1 | Листов 1

30х30х3 Труба 304 ASTM A-312 | ООО "Тех-Аэро"

Н. контр.
Утв. | Кунтушев
