hisp2k/parameters/screw-conveyors/25-SHT-G/original-sources/assembly/Чертежи/Детали/25.SHT.G.09.00.00.02  Пластина.pdf

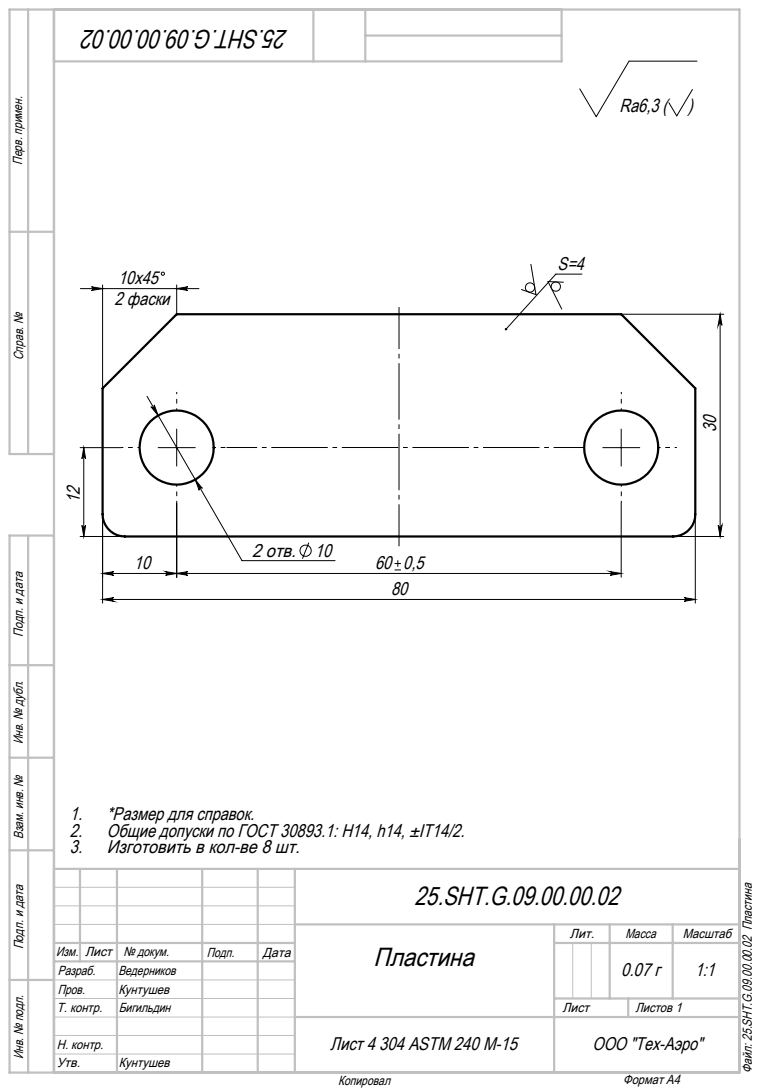
[picture p188: page 1]
2 отв. 10; 2 фаски; Формат A4

Инв. № подл. Подп. и дата Взам. инв. № Инв. № дубл. Подп. и дата Перв. примен. Справ. №

1. *Размер для справок.
2. Общие допуски по ГОСТ 30893.1: Н14, h14, ±IT14/2. 3. Изготовить в кол-ве 8 шт.

25.SHT.G.09.00.00.02

Файл: 25.SHT.G.09.00.00.02 Пластина Версия 3

Пластина | Лит. | Масса | Масштаб

Изм. Лист | | № докум. | Подп. | Дата | | | | | 0.07 г | 1:1
Разраб. | | Ведерников
Пров. | Кунтушев
Т. контр. | Бигильдин | | | | Лист | Листов 1

Лист 4 304 ASTM 240 M-15 | ООО "Тех-Аэро"

Н. контр.
Утв. | Кунтушев
