hisp2k/parameters/screw-conveyors/25-SHT-G/original-sources/assembly/Чертежи/Детали/Лазерная резка 10 мм..pdf

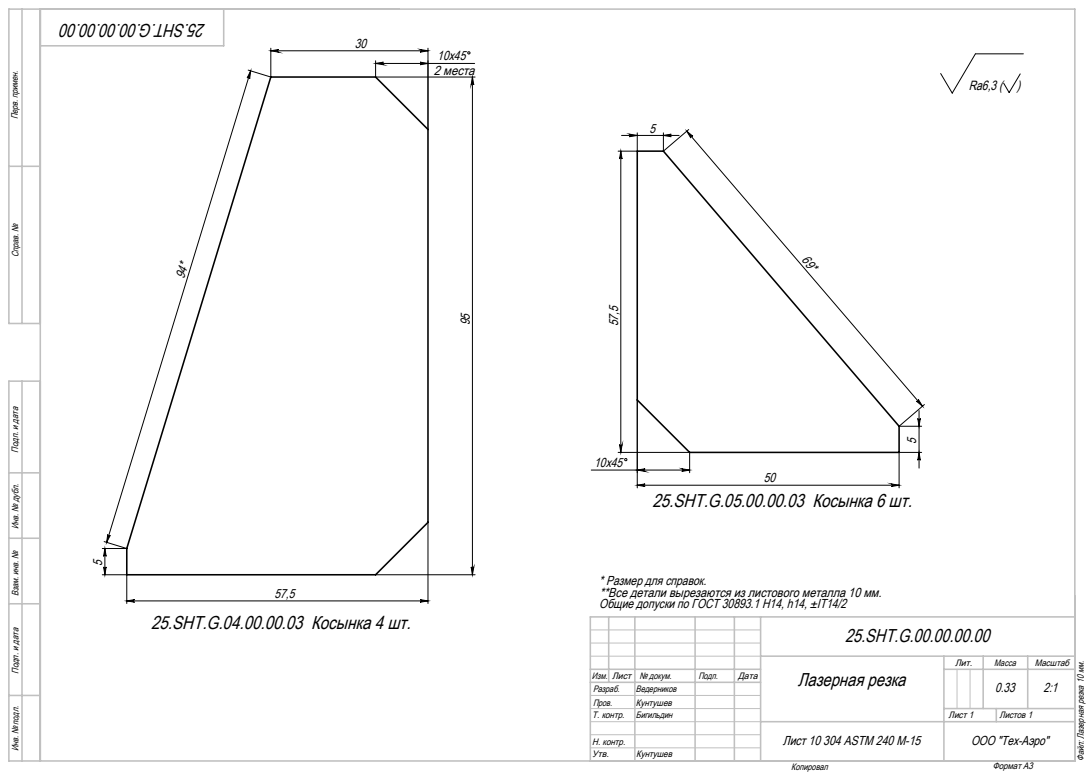
[picture p189: page 1]
2 места; Формат A3

Инв. № подл. Подп. и дата Взам. инв. № Инв. № дубл. Подп. и дата Перв. примен. Справ. №

25.SHT.G.05.00.00.03 Косынка 6 шт.

* Размер для справок.
**Все детали вырезаются из листового металла 10 мм.
Общие допуски по ГОСТ 30893.1 Н14, h14, ±IT14/2

25.SHT.G.04.00.00.03 Косынка 4 шт.

25.SHT.G.00.00.00.00

Лазерная резка | Лит. | Масса | Масштаб

Файл: Лазерная резка 10 мм. Версия 3

Изм. Лист | | № докум. | Подп. | Дата | | | | | 0.33 | 2:1
Разраб. | | Ведерников
Пров. | | Кунтушев
Т. контр. | Бигильдин | | | | Лист 1 | Листов 1

Лист 10 304 ASTM 240 M-15 | ООО "Тех-Аэро"

Н. контр.
Утв. | Кунтушев
