hisp2k/parameters/screw-conveyors/25-SHT-G/original-sources/assembly/Чертежи/Детали/Лазерная резка 3 мм..pdf

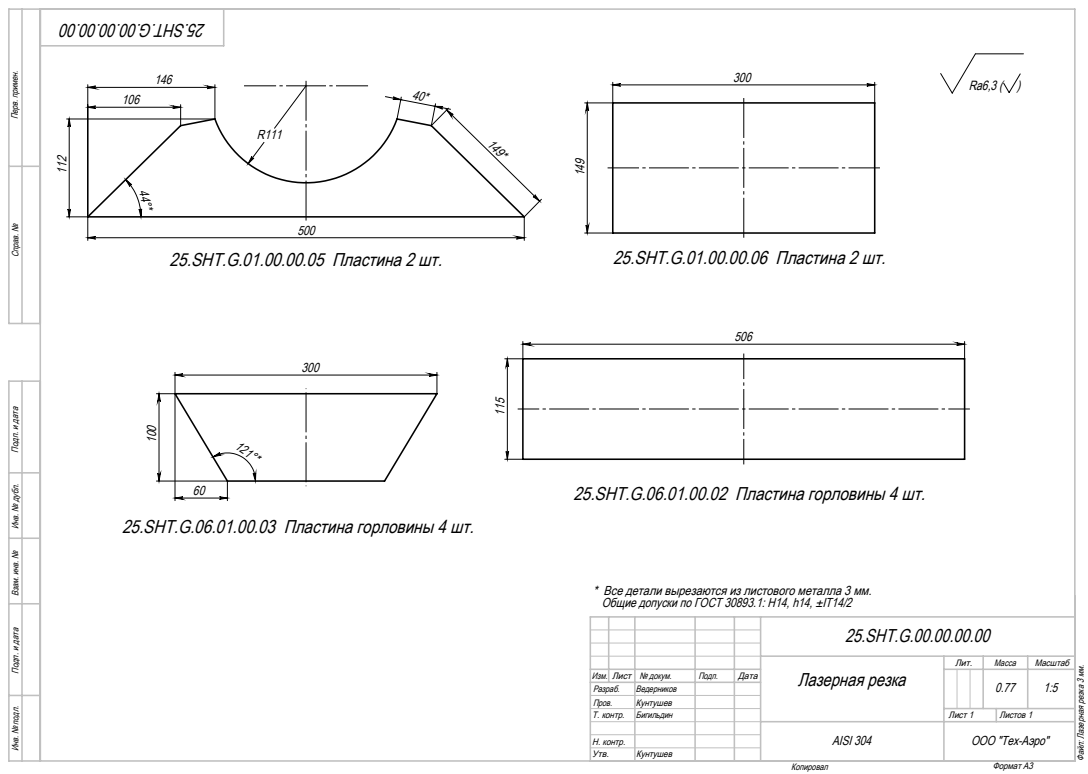
[picture p190: page 1]
25.SHT.G.01.00.00.05 Пластина 2 шт.; 25.SHT.G.01.00.00.06 Пластина 2 шт.; Формат A3

Инв. № подл. Подп. и дата Взам. инв. № Инв. № дубл. Подп. и дата Перв. примен. Справ. №

25.SHT.G.06.01.00.03 Пластина горловины 4 шт.

25.SHT.G.06.01.00.02 Пластина горловины 4 шт.

* Все детали вырезаются из листового металла 3 мм.
Общие допуски по ГОСТ 30893.1: Н14, h14, ±IT14/2

25.SHT.G.00.00.00.00

Лазерная резка | Лит. | Масса | Масштаб

Файл: Лазерная резка 3 мм. Версия 3

Изм. Лист | | № докум. | Подп. | Дата | | | | | 0.77 | 1:5
Разраб. | | Ведерников
Пров. | | Кунтушев
Т. контр. | Бигильдин | | | | Лист 1 | Листов 1

AISI 304 | ООО "Тех-Аэро"

Н. контр.
Утв. | Кунтушев
