hisp2k/parameters/screw-conveyors/25-SHT-G/original-sources/assembly/Чертежи/Детали/Лазерная резка 6 мм. 2.pdf

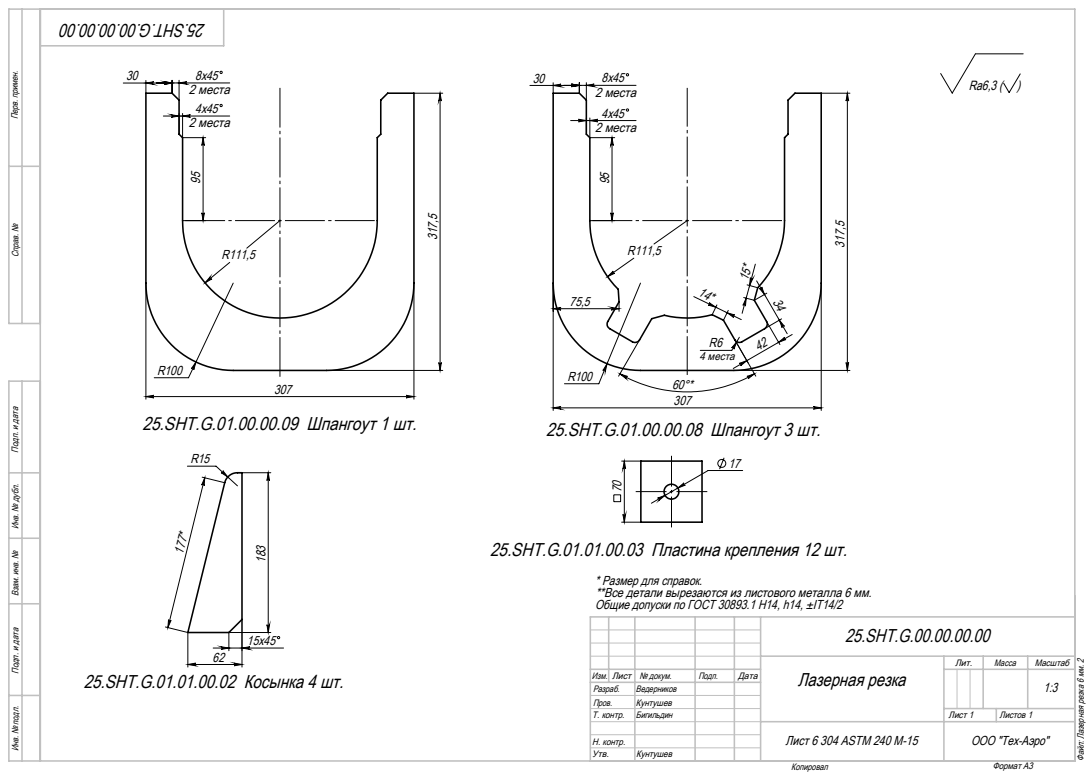
[picture p191: page 1]
2 места; 2 места 95; 25.SHT.G.01.00.00.09 Шпангоут 1 шт.; 25.SHT.G.01.00.00.08 Шпангоут 3 шт.; 4 места; Формат A3

Инв. № подл. Подп. и дата Взам. инв. № Инв. № дубл. Подп. и дата Перв. примен. Справ. №

25.SHT.G.01.01.00.03 Пластина крепления 12 шт.

* Размер для справок.
**Все детали вырезаются из листового металла 6 мм.
Общие допуски по ГОСТ 30893.1 Н14, h14, ±IT14/2

25.SHT.G.00.00.00.00

Лазерная резка | Лит. | Масса | Масштаб

Файл: Лазерная резка 6 мм. 2 Версия 3

25.SHT.G.01.01.00.02 Косынка 4 шт.

Изм. Лист | | № докум. | Подп. | Дата | | | | | 1:3
Разраб. | | Ведерников
Пров. | | Кунтушев
Т. контр. | Бигильдин | | | | Лист 1 | Листов 1

Лист 6 304 ASTM 240 M-15 | ООО "Тех-Аэро"

Н. контр.
Утв. | Кунтушев
