hisp2k/parameters/screw-conveyors/25-SHT-G/original-sources/assembly/Чертежи/Детали/Лазерная резка 6 мм. лист1.PDF

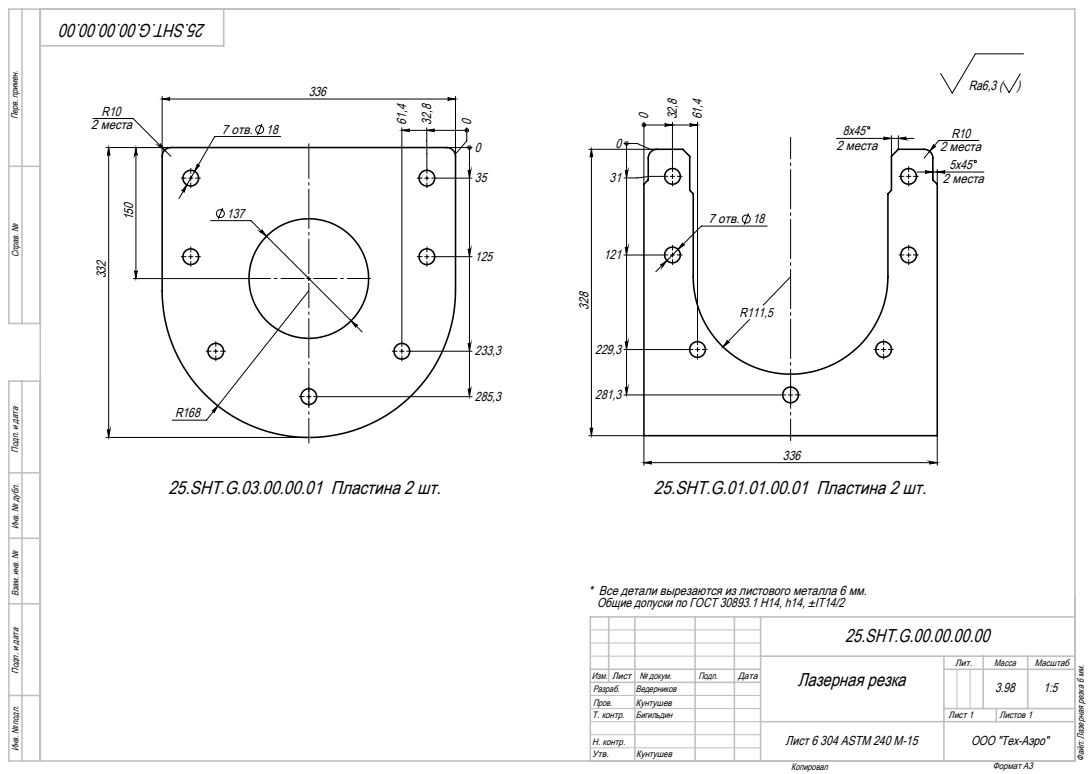
[picture p192: page 1]
7 отв. 18; 2 места; 25.SHT.G.03.00.00.01 Пластина 2 шт.; 25.SHT.G.01.01.00.01 Пластина 2 шт.; Формат A3

Инв. № подл. Подп. и дата Взам. инв. № Инв. № дубл. Подп. и дата Перв. примен. Справ. №

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

25.SHT.G.00.00.00.00

Лазерная резка | Лит. | Масса | Масштаб

Файл: Лазерная резка 6 мм. Версия 3

Изм. Лист | | № докум. | Подп. | Дата | | | | | 3.98 | 1:5
Разраб. | | Ведерников
Пров. | | Кунтушев
Т. контр. | Бигильдин | | | | Лист 1 | Листов 1

Лист 6 304 ASTM 240 M-15 | ООО "Тех-Аэро"

Н. контр.
Утв. | Кунтушев
