hisp2k/parameters/screw-conveyors/25-SHT-G/original-sources/source-order/25.SHT.G.00.00.00.00 СБ/Детали/25.SHT.G.00.00.00.09  Резиновая проставка отсеков.pdf

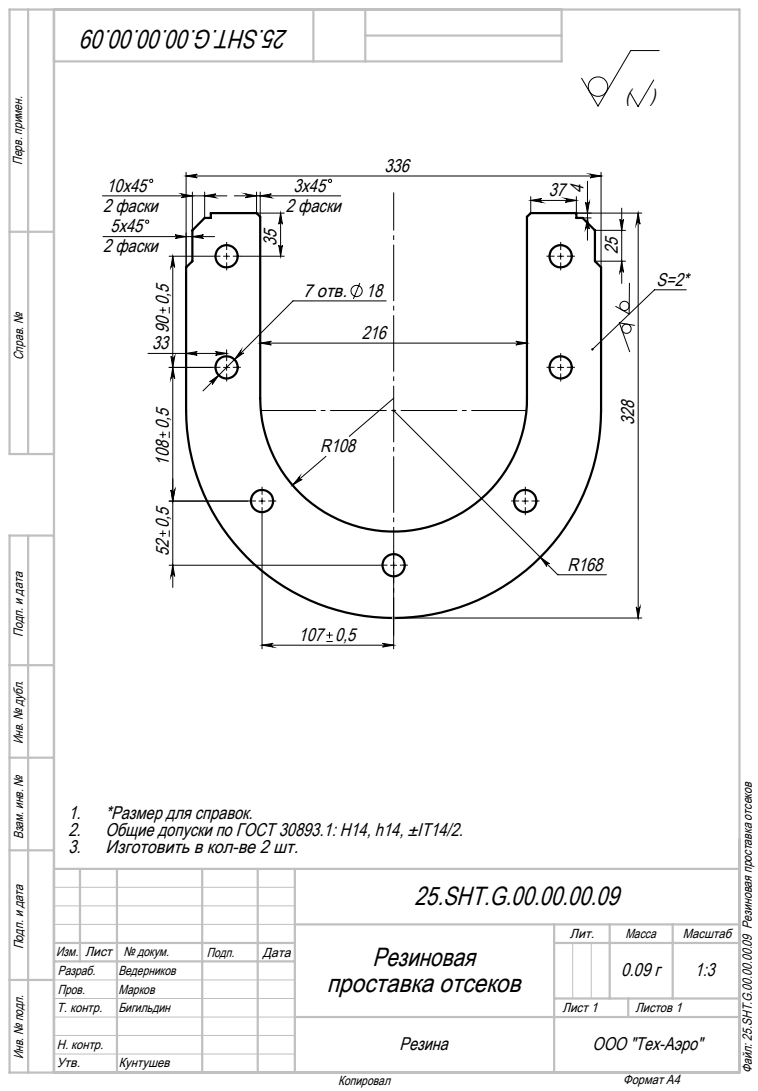
[picture p193: page 1]
2 фаски; 7 отв. 18; Формат A4

Инв. № подл. Подп. и дата Взам. инв. № Инв. № дубл. Подп. и дата Перв. примен. Справ. №

Файл: 25.SHT.G.00.00.00.09 Резиновая проставка отсеков Версия 3

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

25.SHT.G.00.00.00.09

Резиновая проставка отсеков | Лит. | Масса | Масштаб

Изм. Лист | | № докум. | Подп. | Дата | | | | | 0.09 г | 1:3
Разраб. | | Ведерников
Пров. | Марков
Т. контр. | Бигильдин | | | | Лист 1 | Листов 1

Резина | ООО "Тех-Аэро"

Н. контр.
Утв. | Кунтушев
