hisp2k/parameters/screw-conveyors/25-SHT-G/original-sources/source-order/25.SHT.G.00.00.00.00 СБ/Сборки/25.SHT.G.00.00.00.00 СБ  Транспортер.pdf

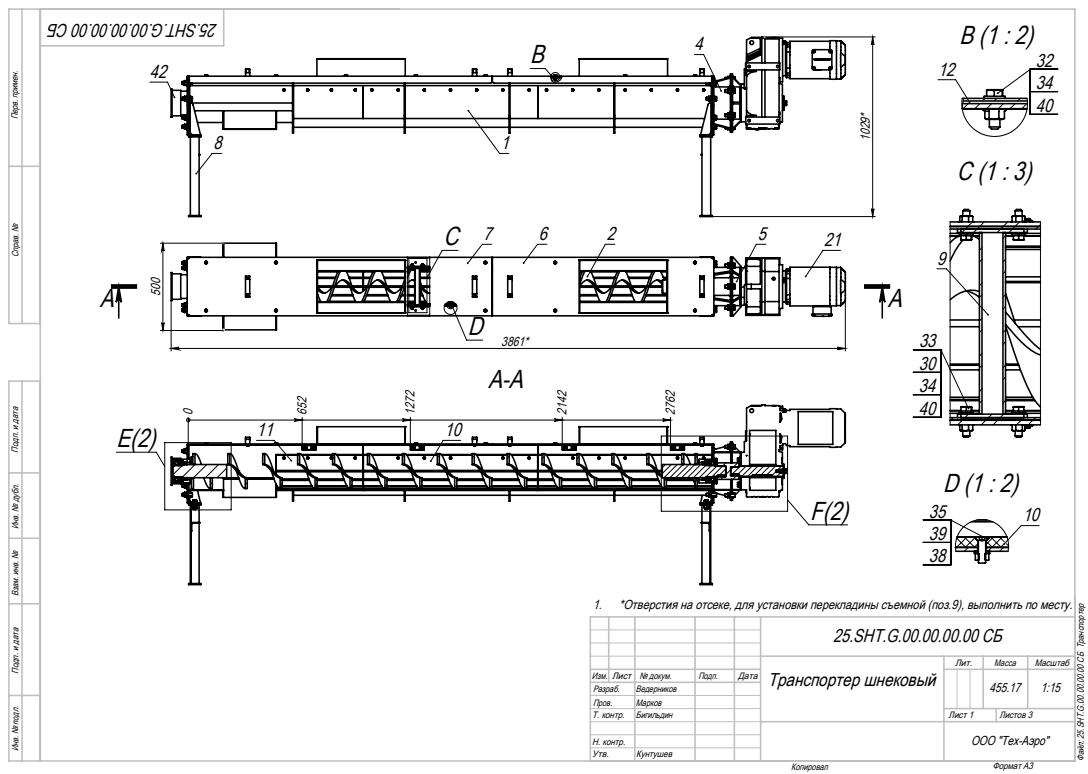
[picture p194: page 1]
Формат A3

Инв. № подл. Подп. и дата Взам. инв. № Инв. № дубл. Подп. и дата Перв. примен. Справ. №

1. *Отверстия на отсеке, для установки перекладины съемной (поз.9), выполнить по месту.

Файл: 25.SHT.G.00.00.00.00 СБ Транспортер Версия 3

25.SHT.G.00.00.00.00 СБ

Транспортер шнековый | Лит. | Масса | Масштаб

Изм. Лист | | № докум. | Подп. | Дата | | | | | 455.17 | 1:15
Разраб. | | Ведерников
Пров. | | Марков
Т. контр. | Бигильдин | | | | Лист 1 | Листов 3

ООО "Тех-Аэро"

Н. контр.
Утв. | Кунтушев

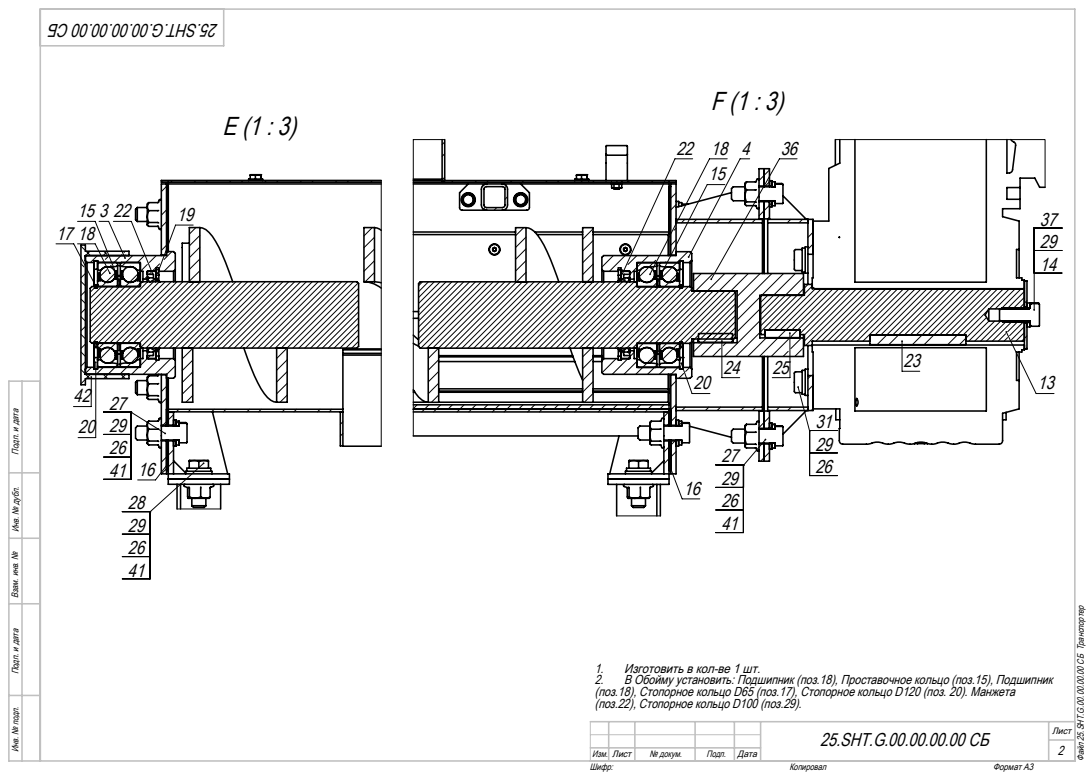
[picture p195: page 2]
Копировал; Формат A3; Шифр:; Версия 3

Инв. № подл. Подп. и дата Взам. инв. № Инв. № дубл. Подп. и дата

Файл 25.SHT.G.00.00.00.00 СБ Транспортер

1. Изготовить в кол-ве 1 шт.
2. В Обойму установить: Подшипник (поз.18), Проставочное кольцо (поз.15), Подшипник (поз.18), Стопорное кольцо D65 (поз.17), Стопорное кольцо D120 (поз. 20). Манжета
(поз.22), Стопорное кольцо D100 (поз.29).

25.SHT.G.00.00.00.00 СБ | Лист2

Изм. Лист | № докум. | Подп. | Дата

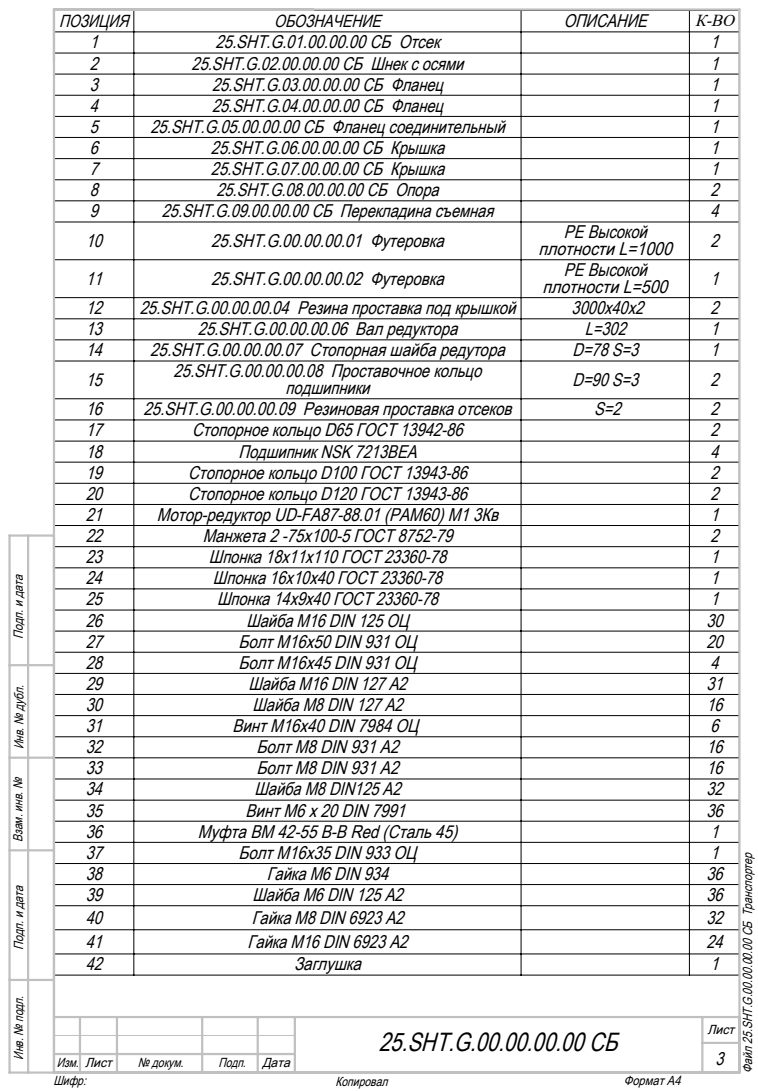
[picture p196: page 3]
25.SHT.G.01.00.00.00 СБ Отсек; 25.SHT.G.02.00.00.00 СБ Шнек с осями; 25.SHT.G.03.00.00.00 СБ Фланец; 25.SHT.G.04.00.00.00 СБ Фланец; 25.SHT.G.05.00.00.00 СБ Фланец соединительный; 25.SHT.G.06.00.00.00 СБ Крышка; 25.SHT.G.07.00.00.00 СБ Крышка; 25.SHT.G.08.00.00.00 СБ Опора; 25.SHT.G.09.00.00.00 СБ Перекладина съемная; 25.SHT.G.00.00.00.01 Футеровка; PE Высокой; плотности L=1000; 25.SHT.G.00.00.00.02 Футеровка; плотности L=500; 25.SHT.G.00.00.00.04 Резина проставка под крышкой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

Инв. № подл. Подп. и дата Взам. инв. № Инв. № дубл. Подп. и дата

Файл 25.SHT.G.00.00.00.00 СБ Транспортер
