hisp2k/parameters/screw-conveyors/25-SHT-G/original-sources/source-order/25.SHT.G.00.00.00.00 СБ/Сборки/25.SHT.G.01.00.00.00 СБ  Отсек (сварка).PDF

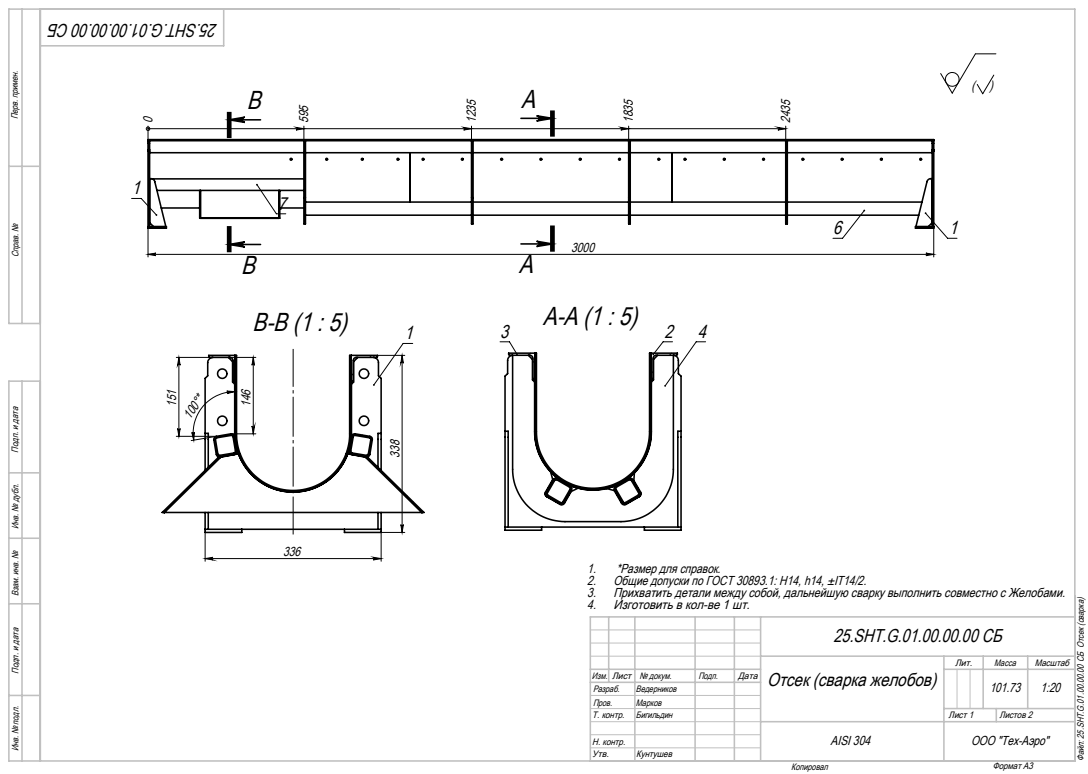
[picture p197: page 1]
Формат A3

Инв. № подл. Подп. и дата Взам. инв. № Инв. № дубл. Подп. и дата Перв. примен. Справ. №

1. *Размер для справок.
2. Общие допуски по ГОСТ 30893.1: Н14, h14, ±IT14/2. 3. Прихватить детали между собой, дальнейшую сварку выполнить совместно с Желобами.
4. Изготовить в кол-ве 1 шт.

Файл: 25.SHT.G.01.00.00.00 СБ Отсек (сварка) Версия 3

25.SHT.G.01.00.00.00 СБ

Отсек (сварка желобов) | Лит. | Масса | Масштаб

Изм. Лист | | № докум. | Подп. | Дата | | | | | 101.73 | 1:20
Разраб. | | Ведерников
Пров. | | Марков
Т. контр. | Бигильдин | | | | Лист 1 | Листов 2

AISI 304 | ООО "Тех-Аэро"

Н. контр.
Утв. | Кунтушев

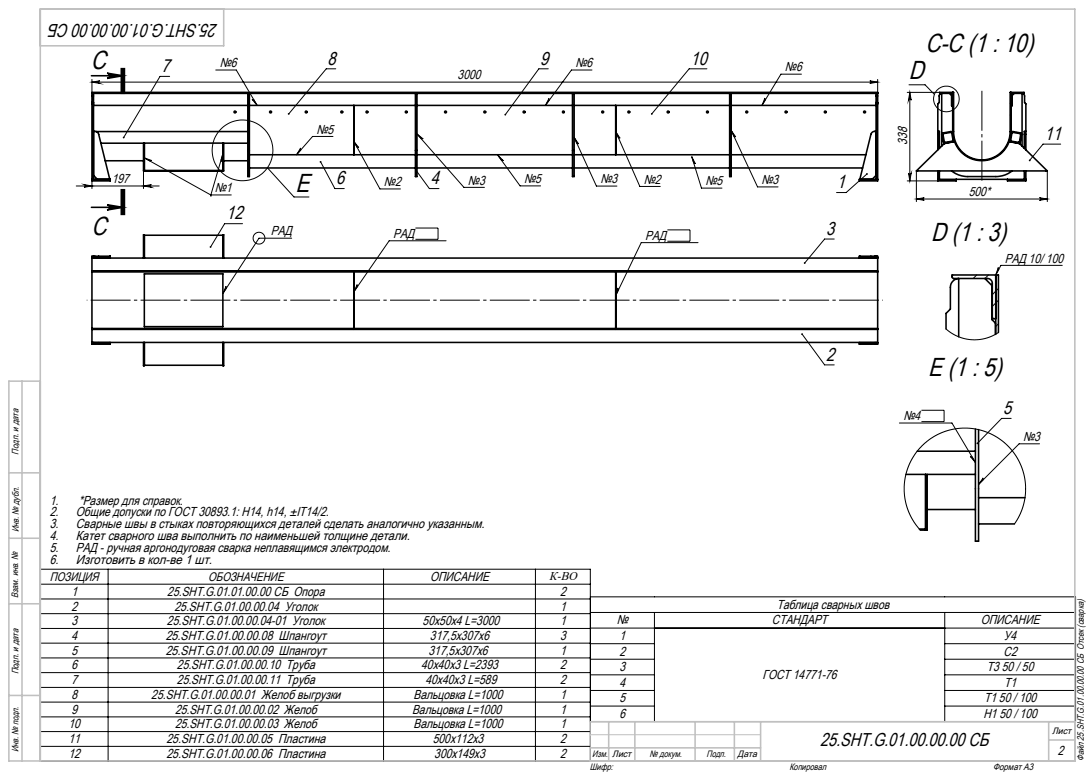
[picture p198: page 2]
РАД; РАД РАД; РАД 10/ 100; Копировал; Формат A3; Шифр:; Версия 3

Инв. № подл. Подп. и дата Взам. инв. № Инв. № дубл. Подп. и дата

1. *Размер для справок.
2. Общие допуски по ГОСТ 30893.1: Н14, h14, ±IT14/2. 3. Сварные швы в стыках повторяющихся деталей сделать аналогично указанным.
4. Катет сварного шва выполнить по наименьшей толщине детали.
5. РАД - ручная аргонодуговая сварка неплавящимся электродом. 6. Изготовить в кол-ве 1 шт.

ПОЗИЦИЯ | ОБОЗНАЧЕНИЕ | ОПИСАНИЕ | К-ВО
1 | 25.SHT.G.01.01.00.00 СБ Опора | | 2
2 | 25.SHT.G.01.00.00.04 Уголок | | 1 | Таблица сварных швов
3 | 25.SHT.G.01.00.00.04-01 Уголок | 50х50х4 L=3000 | 1 | № | СТАНДАРТ | ОПИСАНИЕ
4 | 25.SHT.G.01.00.00.08 Шпангоут | 317,5х307х6 | 3 | 1 | ГОСТ 14771-76 | У4
5 | 25.SHT.G.01.00.00.09 Шпангоут | 317,5х307х6 | 1 | 2 | | С2
6 | 25.SHT.G.01.00.00.10 Труба | 40х40х3 L=2393 | 2 | 3 | | Т3 50 / 50
7 | 25.SHT.G.01.00.00.11 Труба | 40х40х3 L=589 | 2
8 | 25.SHT.G.01.00.00.01 Желоб выгрузки | Вальцовка L=1000 | 1
9 | 25.SHT.G.01.00.00.02 Желоб | Вальцовка L=1000 | 1
10 | 25.SHT.G.01.00.00.03 Желоб | Вальцовка L=1000 | 1
11 | 25.SHT.G.01.00.00.05 Пластина | 500х112х3 | 2
12 | 25.SHT.G.01.00.00.06 Пластина | 300х149х3 | 2 | Изм. Лист | | № докум. | Подп. | Дата

Файл 25.SHT.G.01.00.00.00 СБ Отсек (сварка)

4 | | Т1
5 | | Т1 50 / 100
6 | | Н1 50 / 100

25.SHT.G.01.00.00.00 СБ | Лист
