hisp2k/parameters/screw-conveyors/25-SHT-G/original-sources/source-order/25.SHT.G.00.00.00.00 СБ/Сборки/25.SHT.G.01.00.00.00 СБ  Отсек.pdf

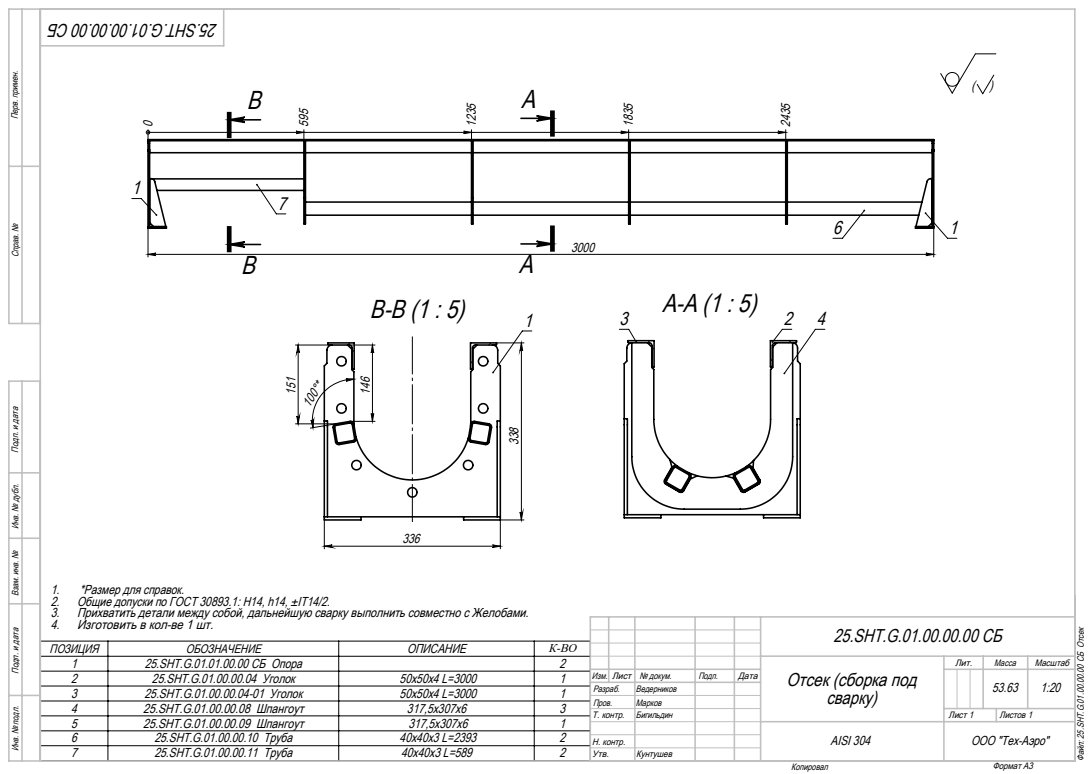
[picture p199: page 1]
Формат A3

Инв. № подл. Подп. и дата Взам. инв. № Инв. № дубл. Подп. и дата Перв. примен. Справ. №

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

25.SHT.G.01.00.00.00 СБ

Файл: 25.SHT.G.01.00.00.00 СБ Отсек Версия 3

ПОЗИЦИЯ | ОБОЗНАЧЕНИЕ | ОПИСАНИЕ | К-ВО
1 | 25.SHT.G.01.01.00.00 СБ Опора | | 2 | | | | | | Отсек (сборка под сварку) | Лит. | Масса | Масштаб
2 | 25.SHT.G.01.00.00.04 Уголок | 50х50х4 L=3000 | 1 | Изм. Лист | | № докум. | Подп. | Дата | | | | | 53.63 | 1:20
3 | 25.SHT.G.01.00.00.04-01 Уголок | 50х50х4 L=3000 | 1
4 | 25.SHT.G.01.00.00.08 Шпангоут | 317,5х307х6 | 3
5 | 25.SHT.G.01.00.00.09 Шпангоут | 317,5х307х6 | 1
6 | 25.SHT.G.01.00.00.10 Труба | 40х40х3 L=2393 | 2
7 | 25.SHT.G.01.00.00.11 Труба | 40х40х3 L=589 | 2

Разраб. | | Ведерников
Пров. | | Марков
Т. контр. | Бигильдин | | | | Лист 1 | Листов 1

AISI 304 | ООО "Тех-Аэро"

Н. контр.
Утв. | Кунтушев
