hisp2k/parameters/screw-conveyors/25-SHT-G/original-sources/source-order/25.SHT.G.00.00.00.00 СБ/Сборки/25.SHT.G.01.01.00.00 СБ  Опора.pdf

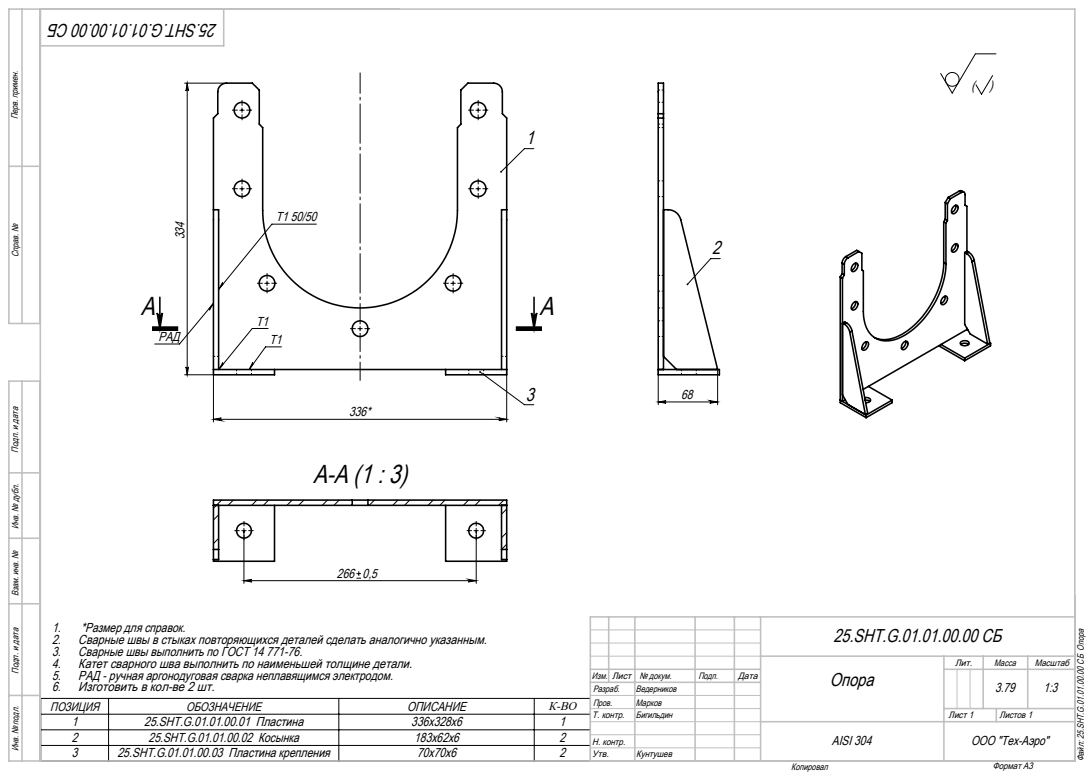
[picture p200: page 1]
Формат A3

Инв. № подл. Подп. и дата Взам. инв. № Инв. № дубл. Подп. и дата Перв. примен. Справ. №

1. *Размер для справок.
2. Сварные швы в стыках повторяющихся деталей сделать аналогично указанным. 3. Сварные швы выполнить по ГОСТ 14 771-76.
4. Катет сварного шва выполнить по наименьшей толщине детали.
5. РАД - ручная аргонодуговая сварка неплавящимся электродом. 6. Изготовить в кол-ве 2 шт.

25.SHT.G.01.01.00.00 СБ

Файл: 25.SHT.G.01.01.00.00 СБ Опора Версия 3

Опора | Лит. | Масса | Масштаб

Изм. Лист | | № докум. | Подп. | Дата | | | | | 3.79 | 1:3
Разраб. | | Ведерников
Пров. | | Марков
Т. контр. | Бигильдин | | | | Лист 1 | Листов 1

ПОЗИЦИЯ | ОБОЗНАЧЕНИЕ | ОПИСАНИЕ | К-ВО
1 | 25.SHT.G.01.01.00.01 Пластина | 336x328x6 | 1
2 | 25.SHT.G.01.01.00.02 Косынка | 183x62x6 | 2
3 | 25.SHT.G.01.01.00.03 Пластина крепления | 70x70x6 | 2

AISI 304 | ООО "Тех-Аэро"

Н. контр.
Утв. | Кунтушев
