hisp2k/parameters/screw-conveyors/25-SHT-G/original-sources/source-order/25.SHT.G.00.00.00.00 СБ/Сборки/25.SHT.G.03.00.00.00 СБ  Фланец.pdf

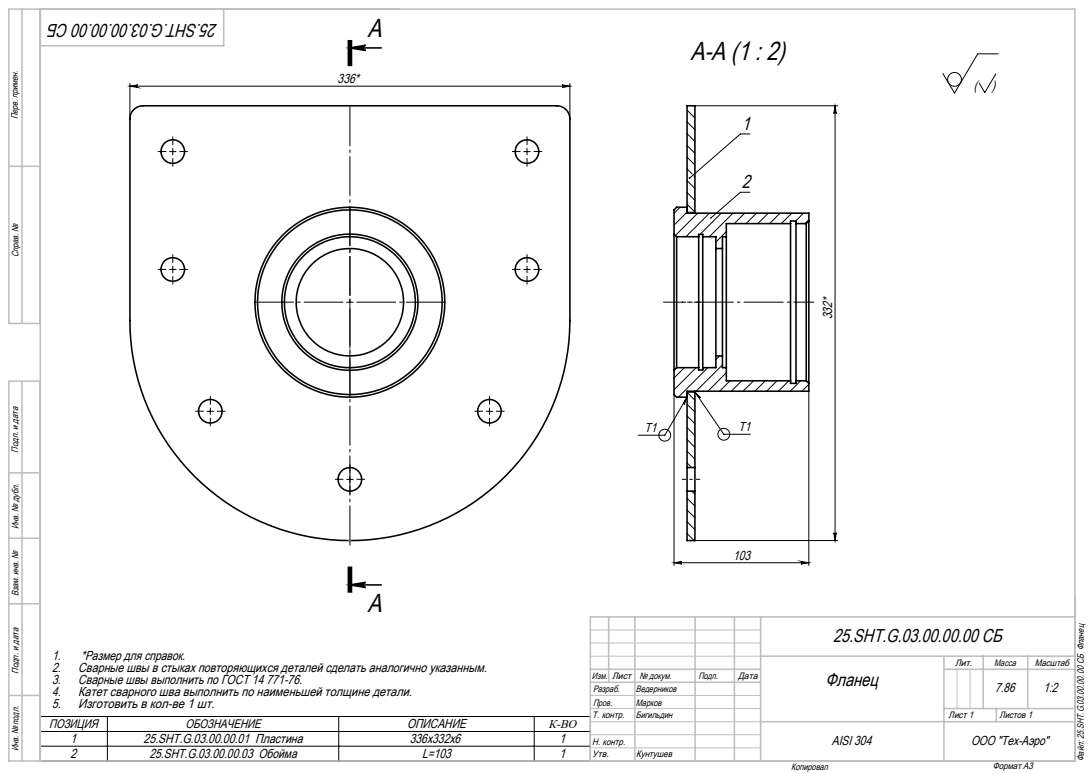
[picture p201: page 1]
Формат A3

Инв. № подл. Подп. и дата Взам. инв. № Инв. № дубл. Подп. и дата Перв. примен. Справ. №

25.SHT.G.03.00.00.00 СБ

Файл: 25.SHT.G.03.00.00.00 СБ Фланец Версия 3

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

Фланец | Лит. | Масса | Масштаб

Изм. Лист | | № докум. | Подп. | Дата | | | | | 7.86 | 1:2
Разраб. | | Ведерников
Пров. | | Марков
Т. контр. | Бигильдин | | | | Лист 1 | Листов 1

ПОЗИЦИЯ | ОБОЗНАЧЕНИЕ | ОПИСАНИЕ | К-ВО
1 | 25.SHT.G.03.00.00.01 Пластина | 336х332х6 | 1
2 | 25.SHT.G.03.00.00.03 Обойма | L=103 | 1 | Утв. | Кунтушев

AISI 304 | ООО "Тех-Аэро"

Н. контр.
