hisp2k/parameters/screw-conveyors/25-SHT-G/original-sources/source-order/25.SHT.G.00.00.00.00 СБ/Сборки/25.SHT.G.04.00.00.00 СБ  Фланец изм.1.pdf

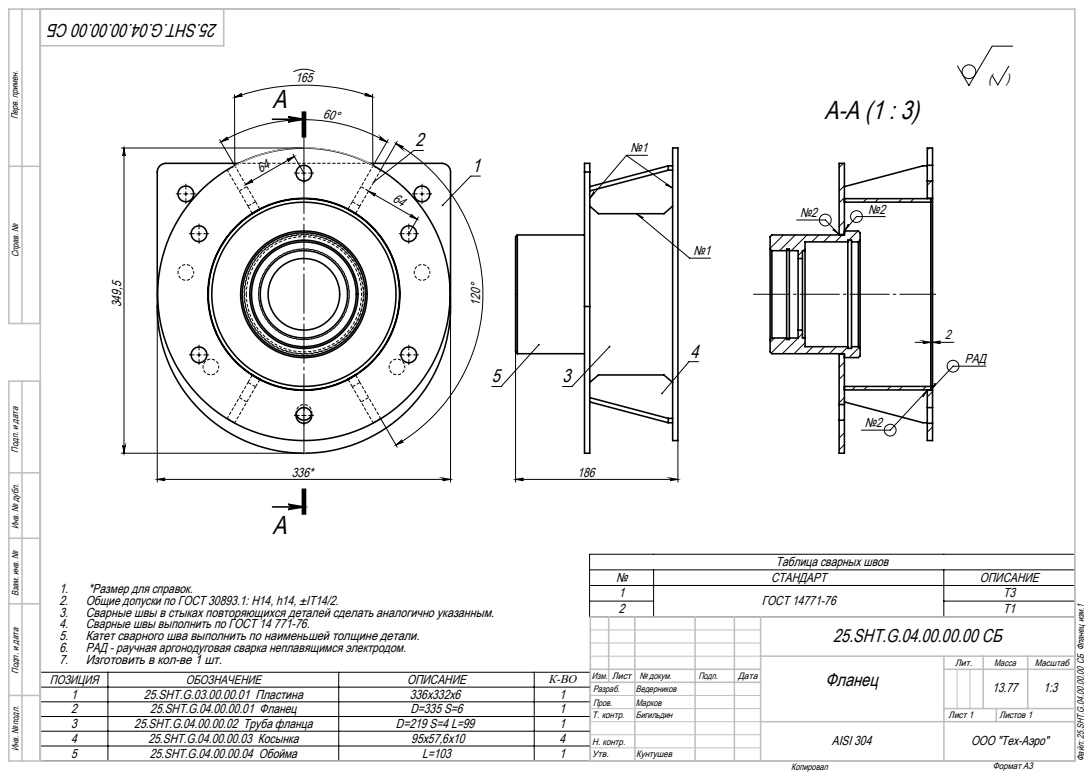
[picture p202: page 1]
Формат A3

Инв. № подл. Подп. и дата Взам. инв. № Инв. № дубл. Подп. и дата Перв. примен. Справ. №

Таблица сварных швов

№ | СТАНДАРТ | ОПИСАНИЕ
1 | ГОСТ 14771-76 | Т3
2 | | Т1

1. *Размер для справок.
2. Общие допуски по ГОСТ 30893.1: Н14, h14, ±IT14/2. 3. Сварные швы в стыках повторяющихся деталей сделать аналогично указанным.
4. Сварные швы выполнить по ГОСТ 14 771-76.
5. Катет сварного шва выполнить по наименьшей толщине детали.
6. РАД - раучная аргонодуговая сварка неплавящимся электродом.
7. Изготовить в кол-ве 1 шт.

Файл: 25.SHT.G.04.00.00.00 СБ Фланец изм.1 Версия 3

25.SHT.G.04.00.00.00 СБ

Фланец | Лит. | Масса | Масштаб

ПОЗИЦИЯ | ОБОЗНАЧЕНИЕ | ОПИСАНИЕ | К-ВО
1 | 25.SHT.G.03.00.00.01 Пластина | 336х332х6 | 1
2 | 25.SHT.G.04.00.00.01 Фланец | D=335 S=6 | 1
3 | 25.SHT.G.04.00.00.02 Труба фланца | D=219 S=4 L=99 | 1
4 | 25.SHT.G.04.00.00.03 Косынка | 95х57,6х10 | 4
5 | 25.SHT.G.04.00.00.04 Обойма | L=103 | 1 | Утв. | Кунтушев

Изм. Лист | | № докум. | Подп. | Дата | | | | | 13.77 | 1:3
Разраб. | | Ведерников
Пров. | | Марков
Т. контр. | Бигильдин | | | | Лист 1 | Листов 1

AISI 304 | ООО "Тех-Аэро"

Н. контр.
