hisp2k/parameters/screw-conveyors/25-SHT-G/original-sources/source-order/25.SHT.G.00.00.00.00 СБ/Сборки/25.SHT.G.05.00.00.00 СБ  Фланец соединительный.pdf

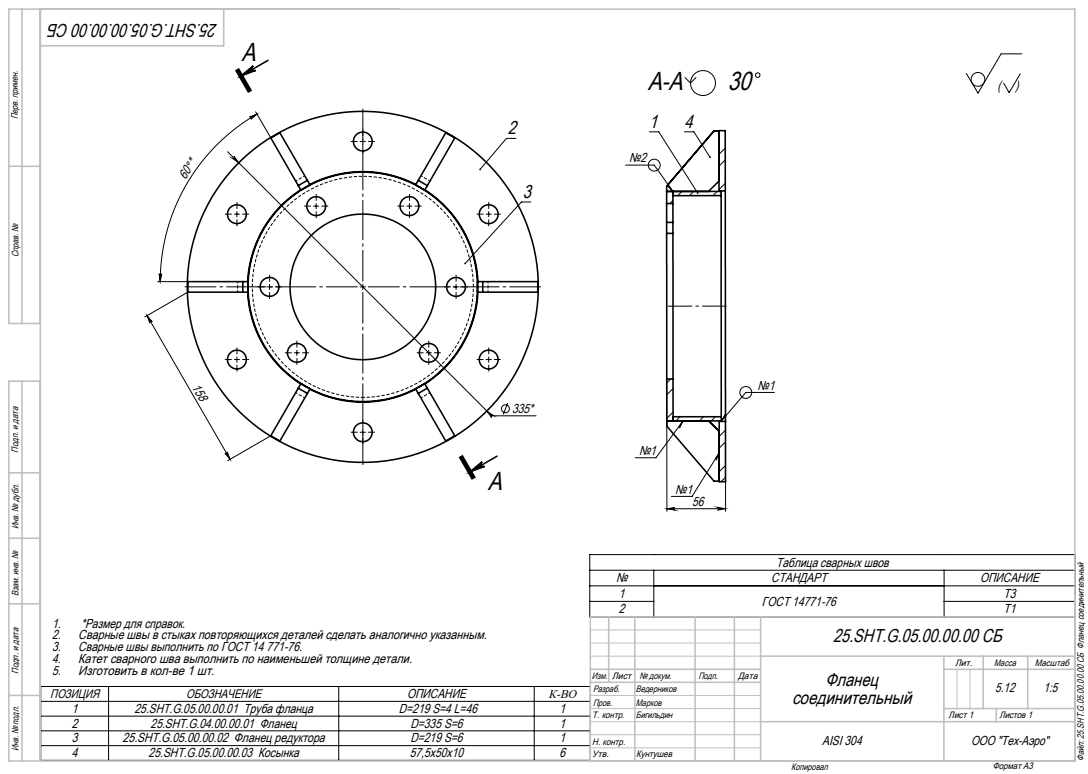
[picture p203: page 1]
Формат A3

Инв. № подл. Подп. и дата Взам. инв. № Инв. № дубл. Подп. и дата Перв. примен. Справ. №

Таблица сварных швов

Файл: 25.SHT.G.05.00.00.00 СБ Фланец соединительный Версия 3

№ | СТАНДАРТ | ОПИСАНИЕ
1 | ГОСТ 14771-76 | Т3
2 | | Т1

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

25.SHT.G.05.00.00.00 СБ

Фланец соединительный | Лит. | Масса | Масштаб

Изм. Лист | | № докум. | Подп. | Дата | | | | | 5.12 | 1:5
Разраб. | | Ведерников
Пров. | | Марков
Т. контр. | Бигильдин | | | | Лист 1 | Листов 1

ПОЗИЦИЯ | ОБОЗНАЧЕНИЕ | ОПИСАНИЕ | К-ВО
1 | 25.SHT.G.05.00.00.01 Труба фланца | D=219 S=4 L=46 | 1
2 | 25.SHT.G.04.00.00.01 Фланец | D=335 S=6 | 1
3 | 25.SHT.G.05.00.00.02 Фланец редуктора | D=219 S=6 | 1
4 | 25.SHT.G.05.00.00.03 Косынка | 57,5х50х10 | 6

AISI 304 | ООО "Тех-Аэро"

Н. контр.
Утв. | Кунтушев
