hisp2k/parameters/screw-conveyors/25-SHT-G/original-sources/source-order/25.SHT.G.00.00.00.00 СБ/Сборки/25.SHT.G.06.00.00.00 СБ  Крышка.pdf

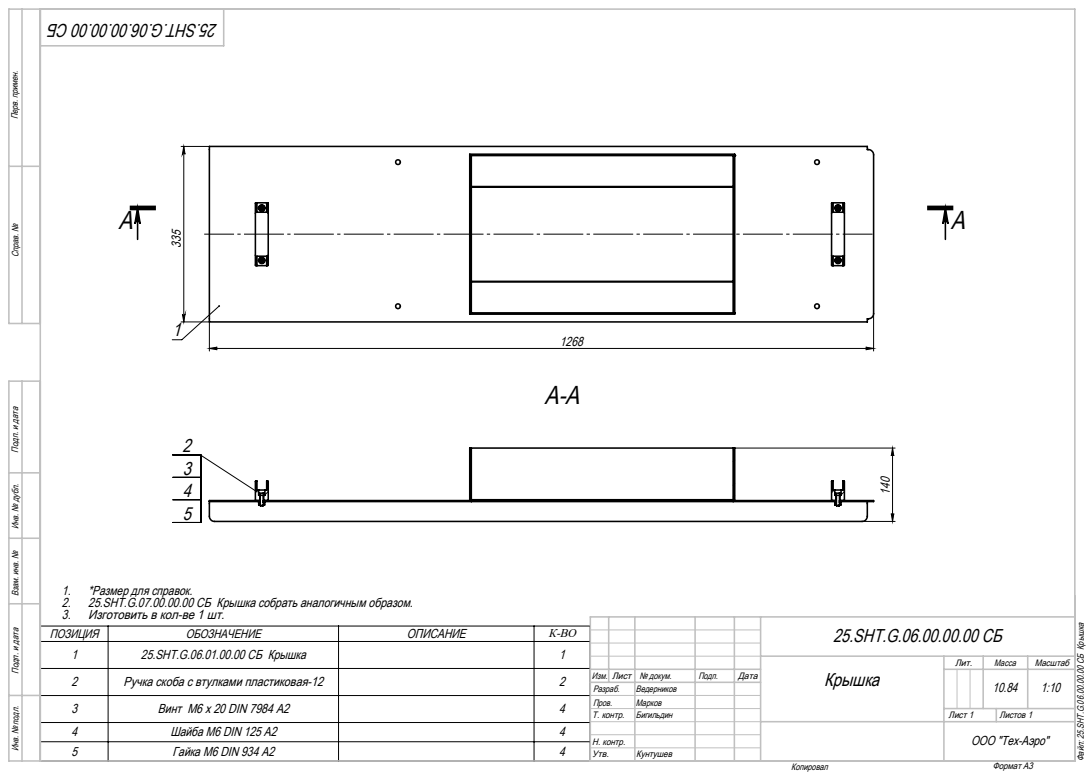
[picture p204: page 1]
Формат A3

Инв. № подл. Подп. и дата Взам. инв. № Инв. № дубл. Подп. и дата Перв. примен. Справ. №

1. *Размер для справок.
2. 25.SHT.G.07.00.00.00 СБ Крышка собрать аналогичным образом.
3. Изготовить в кол-ве 1 шт.

Файл: 25.SHT.G.06.00.00.00 СБ Крышка Версия 3

ПОЗИЦИЯ | ОБОЗНАЧЕНИЕ | ОПИСАНИЕ | К-ВО
1 | 25.SHT.G.06.01.00.00 СБ Крышка | | 1
2 | Ручка скоба с втулками пластиковая-12 | | 2 | Изм. Лист | | № докум. | Подп. | Дата | | 10.84 | 1:10
3 | Винт M6 x 20 DIN 7984 А2 | | 4 | Пров. | Марков
4 | Шайба М6 DIN 125 А2 | | 4 | | | | | | ООО "Тех-Аэро"
5 | Гайка М6 DIN 934 А2 | | 4

25.SHT.G.06.00.00.00 СБ

Крышка | Лит. | Масса | Масштаб

Разраб. | | Ведерников

Т. контр. | Бигильдин | | | | Лист 1 | Листов 1

Н. контр.
Утв. | Кунтушев
