hisp2k/parameters/screw-conveyors/25-SHT-G/original-sources/source-order/25.SHT.G.00.00.00.00 СБ/Сборки/25.SHT.G.06.01.00.00 СБ  Крышка.pdf

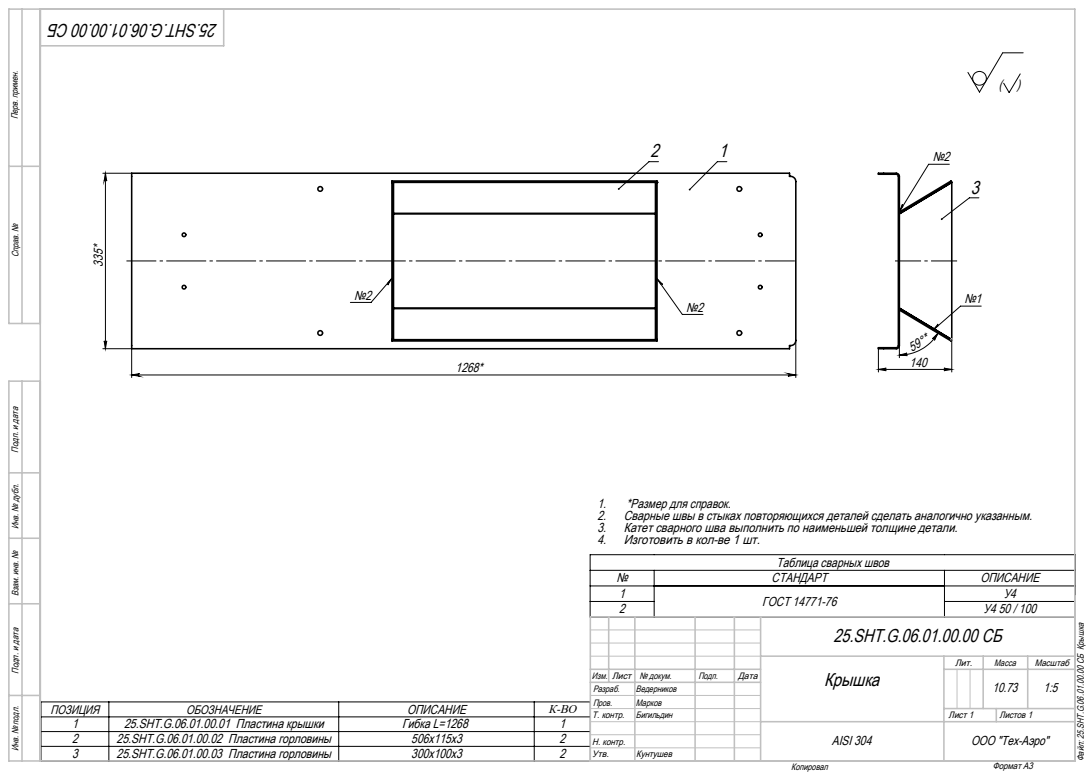
[picture p205: page 1]
Формат A3

Инв. № подл. Подп. и дата Взам. инв. № Инв. № дубл. Подп. и дата Перв. примен. Справ. №

1. *Размер для справок.
2. Сварные швы в стыках повторяющихся деталей сделать аналогично указанным. 3. Катет сварного шва выполнить по наименьшей толщине детали.
4. Изготовить в кол-ве 1 шт.

Таблица сварных швов

№ | СТАНДАРТ | ОПИСАНИЕ
1 | ГОСТ 14771-76 | У4
2 | | У4 50 / 100

Файл: 25.SHT.G.06.01.00.00 СБ Крышка Версия 3

25.SHT.G.06.01.00.00 СБ

Крышка | Лит. | Масса | Масштаб

Изм. Лист | | № докум. | Подп. | Дата | | | | | 10.73 | 1:5
Разраб. | | Ведерников
Пров. | | Марков
Т. контр. | Бигильдин | | | | Лист 1 | Листов 1

ПОЗИЦИЯ | ОБОЗНАЧЕНИЕ | ОПИСАНИЕ | К-ВО
1 | 25.SHT.G.06.01.00.01 Пластина крышки | Гибка L=1268 | 1
2 | 25.SHT.G.06.01.00.02 Пластина горловины | 506x115x3 | 2
3 | 25.SHT.G.06.01.00.03 Пластина горловины | 300x100x3 | 2 | Утв. | Кунтушев

AISI 304 | ООО "Тех-Аэро"

Н. контр.
