hisp2k/parameters/screw-conveyors/25-SHT-G/original-sources/source-order/25.SHT.G.00.00.00.00 СБ/Сборки/25.SHT.G.08.00.00.00 СБ  Опора.pdf

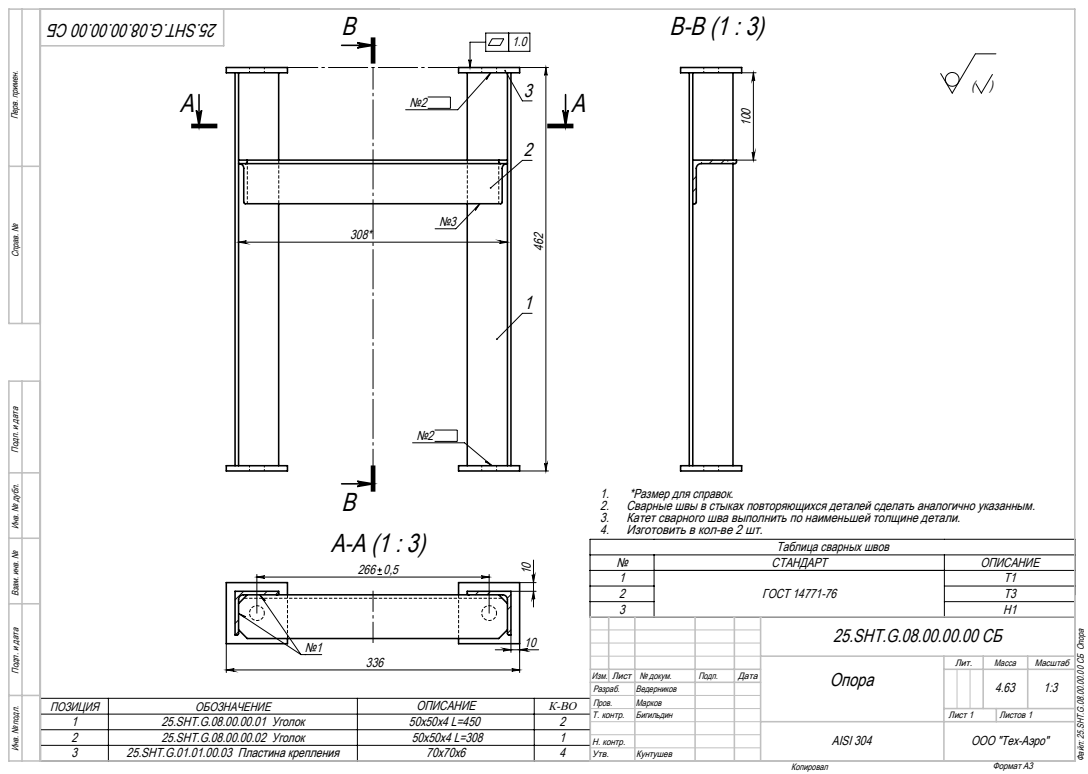
[picture p207: page 1]
Формат A3

Инв. № подл. Подп. и дата Взам. инв. № Инв. № дубл. Подп. и дата Перв. примен. Справ. №

1. *Размер для справок.
2. Сварные швы в стыках повторяющихся деталей сделать аналогично указанным. 3. Катет сварного шва выполнить по наименьшей толщине детали.
4. Изготовить в кол-ве 2 шт.

Таблица сварных швов

№ | СТАНДАРТ | ОПИСАНИЕ
1 | ГОСТ 14771-76 | Т1
2 | | Т3
3 | | Н1

25.SHT.G.08.00.00.00 СБ

Файл: 25.SHT.G.08.00.00.00 СБ Опора Версия 3

Опора | Лит. | Масса | Масштаб

Изм. Лист | | № докум. | Подп. | Дата | | | | | 4.63 | 1:3
Разраб. | | Ведерников
Пров. | | Марков
Т. контр. | Бигильдин | | | | Лист 1 | Листов 1

ПОЗИЦИЯ | ОБОЗНАЧЕНИЕ | ОПИСАНИЕ | К-ВО
1 | 25.SHT.G.08.00.00.01 Уголок | 50х50х4 L=450 | 2
2 | 25.SHT.G.08.00.00.02 Уголок | 50x50x4 L=308 | 1
3 | 25.SHT.G.01.01.00.03 Пластина крепления | 70x70x6 | 4

AISI 304 | ООО "Тех-Аэро"

Н. контр.
Утв. | Кунтушев
