hisp2k/parameters/screw-conveyors/25-SHT-G/original-sources/source-order/25.SHT.G.00.00.00.00 СБ/Сборки/25.SHT.G.09.00.00.00 СБ  Перекладина съемная.pdf

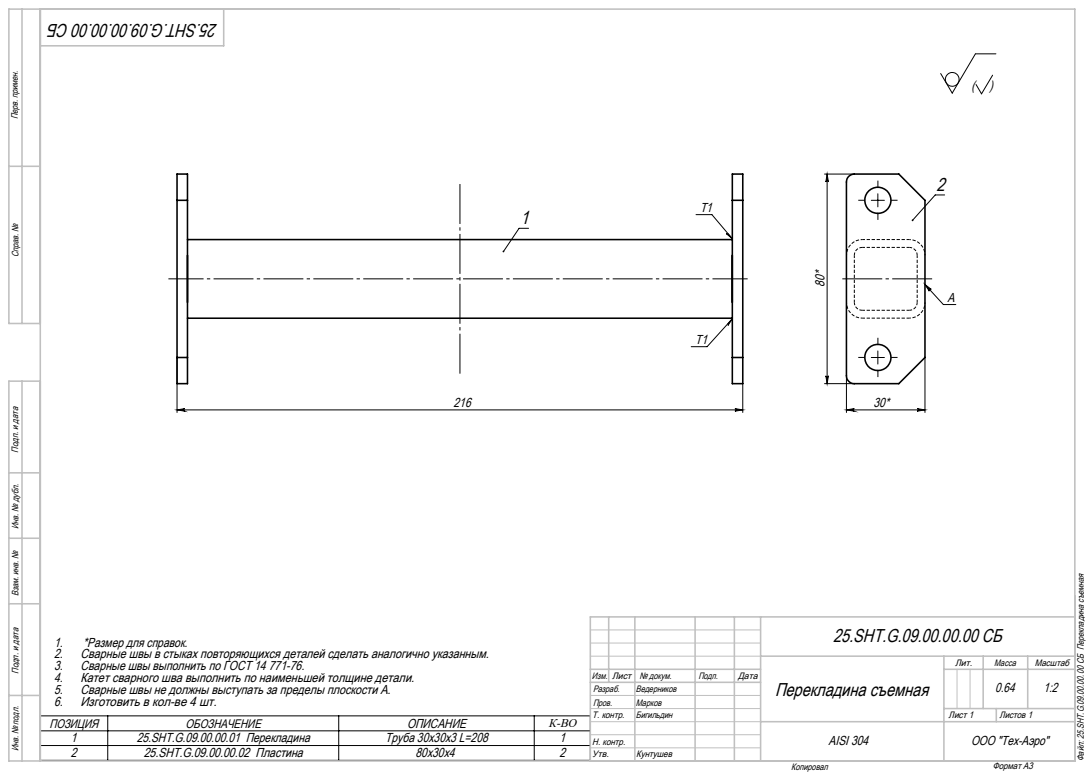
[picture p208: page 1]
Формат A3

Инв. № подл. Подп. и дата Взам. инв. № Инв. № дубл. Подп. и дата Перв. примен. Справ. №

Файл: 25.SHT.G.09.00.00.00 СБ Перекладина съемная Версия 3

25.SHT.G.09.00.00.00 СБ

1. *Размер для справок.
2. Сварные швы в стыках повторяющихся деталей сделать аналогично указанным. 3. Сварные швы выполнить по ГОСТ 14 771-76.
4. Катет сварного шва выполнить по наименьшей толщине детали.
5. Сварные швы не должны выступать за пределы плоскости А. 6. Изготовить в кол-ве 4 шт.

Перекладина съемная | Лит. | Масса | Масштаб

Изм. Лист | | № докум. | Подп. | Дата | | | | | 0.64 | 1:2
Разраб. | | Ведерников
Пров. | | Марков
Т. контр. | Бигильдин | | | | Лист 1 | Листов 1

ПОЗИЦИЯ | ОБОЗНАЧЕНИЕ | ОПИСАНИЕ | К-ВО
1 | 25.SHT.G.09.00.00.01 Перекладина | Труба 30х30х3 L=208 | 1
2 | 25.SHT.G.09.00.00.02 Пластина | 80х30х4 | 2

AISI 304 | ООО "Тех-Аэро"

Н. контр.
Утв. | Кунтушев
