hisp2k/parameters/(commit log)

2026-10-06 Import catalog-and-import-records (1/16)
    Preserve original files and revision history from the verified 2026-10-06 import.
    [files.csv]
2026-10-06 Import engineering-tools-and-calculators (2/16)
    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
    [cost_master_transporters_v4.xlsx, inventory.csv, questionnaire_sample_belt_v3.xlsx, questionnaire_template_transporters_v3.xlsx]
2026-10-06 Import belt-conveyors (3/16)
    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
    [ЛТ500_MASTER_исходная_геометрия_R01.SLDPRT, ЛТ500_Желобчатая_роликоопора_R10.SLDPRT, ЛТ500_Крепление_седел_и_стык_R07.SLDPRT, ЛТ500_Наклонные_седла_узел_стыка_R05.SLDPRT, ЛТ500_Плоский_ролик_фиксация_и_защита_R11.SLDPRT, ЛТ500_Поперечная_опора_прототип_R04.SLDPRT, ЛТ500_Продольные_балки_модуля_прототип_R03.SLDPRT, ЛТ500_Расчёт_желобчатой_ленты_R10.xlsx]
2026-10-06 Import containers (4/16)
    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
    [01_front_back_t1p5.dxf, 02_left_right_t1p5.dxf, 03_bottom_t1p5.dxf, 04_wheel_mount_t4.dxf, bin_022_assembly.SLDDRW, bin_022_body.SLDDRW, bin_022_body.SLDPRT, bin_022_mount_plate.SLDDRW]
2026-10-06 Import verified parametric product models, tools and revision history
    Preserve 5613 original files, with SHA-256 provenance and eight large archives in verified 16 MiB parts.
    [.57.GR.00.00.00.00 СБ Решетка грабельная (STEP 214 КТ).STEP, .57.GR.00.00.00.00 СБ Решетка грабельная.SLDASM, .57.GR.00.00.00.00 СБ Решетка грабельная.SLDDRW, 00.GR.01.00.00.09 Направляющая нижняя.SLDPRT, 00.GR.01.00.00.10 Накладка.SLDPRT, 00.GR.01.00.00.11 Подложка верхняя.SLDPRT, 00.GR.01.00.00.12 Направляющая верхняя.SLDPRT, 00.GR.01.01.00.02 Заслонка.SLDPRT]
